syntroniks/zoneflow/firmware/zoneflow-fw/README.md

# ZoneFlow firmware (ESP-IDF)

Standalone firmware for the ZoneFlow irrigation controller, system spec
section 4.1. Target: ESP32-S3-WROOM-1-N16R8 (16 MB flash, 8 MB octal PSRAM),
ESP-IDF v5.5.6.

> **Status: written for the rev A board, never run on hardware.** No board
> exists yet. What has been checked is listed under "What is verified" below.
> The pin numbers are those of the rev A design (`hardware/pinmap.yaml`); the
> limits and timings that only a board can give are provisional.

Design and interfaces: [`docs/design/firmware-architecture.md`](../../docs/design/firmware-architecture.md).
Network security: [`docs/design/firmware-security.md`](../../docs/design/firmware-security.md).
REST API: [`docs/firmware/api.md`](../../docs/firmware/api.md) and
[`docs/firmware/openapi.json`](../../docs/firmware/openapi.json).
The display: [`docs/design/display-ui.md`](../../docs/design/display-ui.md).

## Build the firmware

Install ESP-IDF v5.5.6 ([Espressif guide](https://docs.espressif.com/projects/esp-idf/en/v5.5.6/esp32s3/get-started/)), then:

```sh
. ~/esp/esp-idf-v5.5.6/export.sh   # wherever you installed it
cd firmware/zoneflow-fw
idf.py set-target esp32s3          # first time only
idf.py build
idf.py -p /dev/ttyACM0 flash monitor
```

`sdkconfig` is generated from `sdkconfig.defaults` and is not committed.
Board options (keep-alive period, heartbeat timeout, control period) are in
`idf.py menuconfig` under "ZoneFlow board". The first build downloads three
components from the ESP-IDF component registry into `managed_components/`
(not committed): `lvgl/lvgl` 9.6.0, `espressif/mdns` 1.14.1 and
`joltwallet/littlefs` 1.22.3.

There is one build, for the rev A board, display included. Its pin numbers
come from `hardware/pinmap.yaml`: every build (firmware, host tests,
simulator) runs `tools/gen_board_header.py`, which checks the map and writes
`zf_board/pinmap_generated.hpp` into the build directory. The firmware build
uses ESP-IDF's Python, which has PyYAML; the host builds use
`uv run --script` (or a `python3` with PyYAML). The hand-written
`components/zf_board/include/zf_board/zoneflow_rev_a.hpp` names the signals
and checks the pin rules at compile time.

## Release builds

Releases are built by `.github/workflows/release.yml` from a `vX.Y.Z` tag. The firmware's
version is the tag without the `v`: the workflow writes it to `version.txt` here (ignored by Git)
before `idf.py build`, and ESP-IDF stores it in the application description. Without
`version.txt`, ESP-IDF uses `git describe`. To try the packaging on your own build, see
[`tools/zfrelease`](../../tools/zfrelease/README.md) and
[Releases and updating](../../docs/firmware/releases.md).

## Run the display on a desktop

```sh
firmware/zoneflow-fw/sim/run.sh                      # window, needs SDL2
firmware/zoneflow-fw/sim/run.sh --screenshots out/   # headless, a PNG of every screen
```

The simulator runs the firmware's display code on the real controller core
with fake hardware. Keys and details: [`sim/README.md`](sim/README.md).

Web UI files placed in `www/` (with an `index.html`) are packed into
`build/www.bin` and flashed to the `www` partition; see
[`docs/firmware/web-ui-contract.md`](../../docs/firmware/web-ui-contract.md).
The web UI lives in [`web/`](web/README.md); build it into `www/` with
Node 22.18 or newer before `idf.py build`:

```sh
cd firmware/zoneflow-fw/web && npm ci && npm run build
```

Without Node (no `www/index.html`) the firmware still builds and the device
serves its built-in page.

## Run the host tests

No ESP-IDF needed. Needs CMake 3.24 or newer, a C++20 compiler and network
access on the first run (GoogleTest 1.17.0 and cJSON 1.7.19 are fetched; a
system GoogleTest is used if found). Besides `zf_core`, the suite builds the
pure-logic files of `zf_net`, `zf_web` and `zf_ota` and checks the route
table against `docs/firmware/openapi.json`.

```sh
firmware/zoneflow-fw/test/host/run.sh
```

The script builds with AddressSanitizer and UndefinedBehaviorSanitizer and
runs every test through CTest. Extra arguments go to `ctest`. The suites
cover the core and the display logic (`ui_*_test.cpp`); the display tests
need no LVGL.

## Run the system soak simulation

`test/soak/` runs the controller core, output stage, persistence, history,
REST API and MQTT command path for simulated weeks against the simulated
rev A board and a model of the world (faults, restarts, clock trouble,
users), and checks safety and schedule invariants on every simulated tick.
A second rig runs the ESPHome supervisor glue. Deterministic from a seed.

```sh
firmware/zoneflow-fw/test/soak/run.sh --ci          # the subset CI runs, ASan and UBSan
firmware/zoneflow-fw/test/soak/run_long.sh          # the long run, about two hours on 16 cores
firmware/zoneflow-fw/test/soak/run.sh --mode chaos --seed 17 --days 30 --shrink
```

[`test/soak/README.md`](test/soak/README.md) lists the world model, the
invariants and the run sizes; firmware architecture section 22 what the
runs found.

## Format

```sh
cd firmware/zoneflow-fw
git ls-files '*.cpp' '*.hpp' | xargs uvx --from clang-format==23.1.4 clang-format -i
```

CI checks formatting with the same clang-format version.

## Layout

| Path | Contents |
|---|---|
| `components/zf_core/` | Pure C++ logic, no ESP-IDF headers: zone driver, scheduler, time zones, config, events, diagnostics, controller. Builds for the device and for host tests. |
| `components/zf_board/` | Board header. The only place GPIO numbers and board constants appear. |
| `components/zf_platform/` | ESP-IDF code behind the core interfaces: GPIO outputs, OE keep-alive timer interrupt, persist writer task, zero-cross input, sensors (GPIO, PCNT, ADC), NVS, I2C, PCF8563 RTC, SNTP, panic/brownout/restart hooks, event logger. |
| `components/zf_net/` | WiFi station with backoff, BLE (Security 2) and SoftAP provisioning, hostname, mDNS, captive DNS, re-provision and factory reset. |
| `components/zf_web/` | HTTP(S) server, REST API under `/api/v1`, Server-Sent Events stream, admin authentication, static files from LittleFS, built-in fallback and setup pages. |
| `components/zf_ota/` | Firmware upload and HTTPS pull, web UI image upload, post-boot self-test and rollback. |
| `components/zf_display/` | The local interface. `src/ui`: display logic, no LVGL, host-tested. `src/view`: LVGL drawing. `src/port`: ST7789 over SPI, backlight, encoder, buttons, the UI task. |
| `components/zf_mqtt/` | MQTT client (esp-mqtt), topic tree, commands, Home Assistant discovery. Logic in `mqtt_logic.cpp` (host-tested). |
| `sim/` | Desktop simulator of the display and the screenshot generator. `sim/web/` is the browser demo: the same code as WebAssembly. |
| `main/app_main.cpp` | Wires everything together and starts the tasks. |
| `test/host/` | GoogleTest suites and fakes for the core and the display logic. |
| `test/soak/` | System soak simulation of both firmwares on the simulated board (`zf_soak`). |
| `test/vectors/` | Schedule cases shared by the C++ scheduler test and the web UI's preview. |
| `web/` | Browser UI (Preact, TypeScript), mock controller and its tests. |
| `test/broker/` | Optional broker test: the MQTT logic and the core against a local Mosquitto (`run.sh`; not in CI). |
| `partitions.csv` | 16 MB layout: NVS, two 4 MB OTA slots, 7.75 MB LittleFS `www` for web and display assets, 128 KB core dump. |

## What is verified

- Host tests: `test/host/run.sh`, all suites pass under ASan and UBSan.
- System soak simulation: `test/soak/run.sh --ci` in CI. What the long run
  covered and found is in firmware architecture section 22. It is a
  simulation on a model of the board, not a bench check.
- Display simulator: `sim/run.sh --screenshots <dir>` draws all 75 scenes.
  The pictures in `docs/design/display-ui/` are its output.
- `idf.py build` with ESP-IDF v5.5.6 for esp32s3 completes with no warnings
  in ZoneFlow code.
  Image sizes are in the firmware architecture document.
- Web UI (`web/`): unit tests (vitest) and Playwright end-to-end tests on a
  phone, a 320 px and a desktop viewport, all against the mock controller in
  `web/mock/`, not against firmware. The schedule preview and the C++
  scheduler agree on the shared vectors in `test/vectors/`. The firmware's
  GET answers (`web_openapi_schema_test.cpp`) and the mock's
  (`web/tests/unit/mock-contract.test.ts`) are both checked against the
  response schemas in `docs/firmware/openapi.json`.
- Broker test: `test/broker/run.sh` builds Mosquitto 2.1.2 and runs the
  MQTT logic with the real core against it; all checks pass. It does not
  run the ESP-IDF MQTT glue. See
  [`docs/firmware/mqtt.md`](../../docs/firmware/mqtt.md#what-has-been-tested).
- Nothing has run on an ESP32-S3. Pin assignments, the output-enable
  timing, the current-sense scaling and the PCF8563 driver are untested
  against hardware. So are WiFi, provisioning with a phone, mDNS, the HTTP
  server, HTTPS, the event stream, OTA and the MQTT client: only their logic is unit-tested,
  the ESP-IDF glue is compiled but has never executed. The same holds for
  every part of the display that touches hardware: panel, backlight,
  encoder, buttons, PSRAM.
