syntroniks/zoneflow/docs/design/index.md

# Design documents

This section is the engineering record: requirements, analysis, reviews and
decisions, written for people who build, review or change ZoneFlow. The
user manual (Getting started, the user guide, the hardware reference,
troubleshooting) is written from these documents for people who install and
use the controller. Where the two disagree, the design document is right and
the manual has a bug.

Design documents are the source of truth for the project. If your work needs
one to change, change it in the same pull request. See
[contributing](../contributing.md). Each document records its own history,
so earlier decisions it describes as replaced are kept on purpose.

- [System specification](system-spec.md): hardware, firmware, enclosure, documentation, licences and verification limits.
- [Prior-art survey](prior-art.md): existing open irrigation controllers, their circuits, known field failures, and what ZoneFlow takes from them.
- [Firmware architecture](firmware-architecture.md): standalone firmware modules, threading, safety design, interfaces for later modules, scheduler and missed-start policy, open questions for hardware.
- [Display interface](display-ui.md): the local interface on the 320x240 panel: controls, screen map, every screen as drawn by the desktop simulator, visual language, wording, what is verified and what is still weak.
- [Hardware toolchain](hardware-toolchain.md): how a board goes from text to a KiCad 10 project and fabrication files with no GUI, what was checked, and the known limits.
- [Hardware design](hardware-design.md): the rev A circuit, block by block, with part numbers, calculations, the net list, the risk register and the bring-up plan. A paper design. Nothing in it is measured.
- [Mechanical design](mechanical.md): the board outline, every mechanically fixed part position, the component height limits and the antenna rule, for the PCB layout engineer. Explains `hardware/mechanical.yaml`. A paper design. Nothing has been printed.
- [Hardware review A1](hardware-review-a1.md): the independent review of the rev A circuit before schematic capture. Findings by severity, the verdict on each departure from the specification, the keep-alive contract with the firmware, what was verified from data sheets and what was not.
- [Hardware review A2](hardware-review-a2.md): the second review, of the fail-safe circuits only. A single-fault table rebuilt from the netlist by fault injection, tolerance corners of both keep-alive detectors, the regulator over-voltage protection, and the output stage after the change of triac.
- [Hardware answers A2](hardware-answers-a2.md): the hardware answers to the nine questions the firmware raised on the self-test of review A2, the decision on a shorted 3.3 V regulator with the detector it added, and the list of what the firmware must change.
- [Fail-safe reduction study](failsafe-reduction-study.md): a paper study of the owner's proposal to tie the expander's reset to the processor's reset and rely on the chip's watchdogs. What each reset of the ESP32-S3 does to the pins, what a watchdog part would have to do, four variants with their parts, cost and uncovered faults, a simulation of the recommended one, and where the study is weak. It changes nothing.
- [Fail-safe reduction review](failsafe-reduction-review.md): an independent review of that study. Each claim checked against the makers' documents, a fault injection on the reduced variants V1 and V2, what V1 gives up in an installer's terms with the cheapest part that puts each thing back, the specification sentences V1 breaks, and a finding on the reset supervisor U12 that concerns the board as it is. It changes nothing.
- [Hardware layout](hardware-layout.md): the rev A board: stack-up, floor plan, what is routed by hand and why, the current calculations, the layout rules of the fail-safe analysis, what the autorouter did, and what its author thinks is weak.
- [Hardware layout review](hardware-layout-review.md): the independent review of the rev A layout. Findings by severity, what was fixed, the placement files against the assembler's library, what was verified and how, and the checklist a person must go through before an order.
- [Review records](reviews/index.md): the records of the reviews a person made with the pre-order review walkthrough. None has been made yet.
- [Firmware security](firmware-security.md): the network surface of the standalone firmware: provisioning, the REST API and its sessions, updates, MQTT, what a review of it found and which risks remain.
- [Web UI contract](../firmware/web-ui-contract.md): what the standalone firmware's web interface may rely on from the REST API and event stream.
- [Repository audit](repository-audit.md): a fresh reading of the whole repository on 2026-11-12: where it disagreed with itself, what was corrected, what is left, and which checks no workflow runs.

The independent design review before fabrication is tracked in
[issue #11](https://github.com/syntroniks/zoneflow/issues/11). The reviews of
the circuit and of the layout are written. What is open is the part a person
does: the [pre-order review walkthrough](../hardware/review/index.md).

New design documents go in `docs/design/`. Add each one to the `nav` section
of `mkdocs.yml` and to this list.
