syntroniks/zoneflow/docs/design/hardware-design.md

# ZoneFlow hardware design, revision A

Status: **paper design, 2026-11-12, after
[hardware review A1](hardware-review-a1.md), the decisions taken on its
findings, [hardware review A2](hardware-review-a2.md) of the fail-safe
circuits, the [answers to the firmware's questions](hardware-answers-a2.md)
on section 19, and the owner's decision to debounce the push contacts in
firmware (section 28)**. No board exists. Nothing in
this document has been measured. Every number is a datasheet figure, a calculation from
datasheet figures, or a simulation result, and the text says which. Section 20
lists what only a bench can confirm. Section 22 lists what I could not confirm
at all.

This document is the circuit design that schematic capture translates. I
wrote it against [system specification](system-spec.md) v0.3. It departs from
that version in the places listed in section 2, and the pull request that adds
this document raises the specification to v0.5 with those changes. Three files hold the same design as data:

- **`hardware/netlist.yaml`**: every component, its value, package, LCSC number and the net on every pin. It is the source. The component tables in this document are written from it.
- **`hardware/pinmap.yaml`**: every ESP32-S3 GPIO, I2C address and expander bit. Firmware generates its board header from it.
- **`hardware/bom-preliminary.csv`**: one line per part number with stock, price and source, checked on 2026-11-10.

`tools/designsync/designsync.py` keeps the four in step. `make -C hardware
design-check` fails if a table here, the BOM or the pin map disagrees with the
netlist, and CI runs it on every change to them. `make -C hardware
design-sync` rewrites the tables, which sit between `designsync` comment
lines. Do not edit a table by hand.

Simulation netlists are in `hardware/sim/`, with a README that states what each
run showed.

Section 24 lists what changed after review A1 and where I did something
other than what the reviewer proposed. Section 25 lists what review A2
changed. Section 26 lists what the answers to the firmware's questions
changed: one part of the circuit and most of section 19. Section 27 lists
the five part numbers that the BOM consolidation replaced. Section 28 lists
the five parts that left when the debounce of the encoder switch and the two
buttons moved into firmware.

## 1. The design in brief

| Block | Choice | Main reason |
|---|---|---|
| Logic supply | A fuse in each transformer leg, 1500 W TVS, half-wave rectifier, 470 uF, LM5164 100 V buck to 5.3 V with its own 0.5 A fuse and a clamp on its output, Schottky OR with USB, LDL1117 to 3.3 V | The TVS clamps at 77.4 V. A 100 V regulator survives that with no further argument. A 5 V bus makes USB and 24 VAC equal sources and gives the LDO room to reject ripple. The fuse and the clamp keep a failed regulator from putting 45 V on the logic. |
| Output switch | T810-600B-TR 8 A three-quadrant triac in DPAK, fired by a MOC3023 opto-triac from its own T2 | The triacs JLCPCB stocks with real surge ratings are three-quadrant parts. Positive-only gate drive from logic cannot fire them on the negative half-cycle. The 8 A part carries the short-circuit current of a 75 VA transformer until the PTC trips. Section 6 has the analysis. |
| Output control | TCA9539 I2C expander sinks the opto LEDs | The TFT took six GPIOs. Nine valve pins no longer fit. The expander is held in reset by the fail-safe circuit, so no valve bit survives a crash. |
| Fail-safe | Two independent detectors on the keep-alive pin. One, a diode pump with a comparator, switches the LED supply and the expander reset. The other, a diode pump straight into a transistor gate, holds the relay. | Gate drive needs an edge at least every 20 ms. It is gone 0.21 to 0.83 s after the edges stop, and with it the valve current. The relay transistor alone lets go within 1.45 s. No single component fault leaves a valve on after the edges stop. Sections 7 and 8, with the corners of review A2. |
| Over-current | Window comparator on the shunt amplifier, NAND latch, same switch as the fail-safe | Removes drive about 70 us after a short begins and releases K1 at once. The triac and the PTC are rated to carry the short until one of them or the relay interrupts it. |
| Over-voltage on the logic rail | A voltage detector on `3V3` that holds the set input of the over-current latch low above 4.0 V | A shorted 3.3 V regulator puts 5 V on the processor, and nothing can be said about a processor there. The detector removes drive without it. It does not protect the processor. Section 9.5. |
| Valve common | Relay in the COM feed. Its coil current passes through two transistors: one follows an expander bit, the other its own keep-alive detector. | A shorted triac or TVS otherwise leaves a valve on with no way to stop it. This is an addition to the specification. |
| Current measurement | 0.1 ohm shunt, two difference amplifiers biased at 0.8 V, sampled by ADC1 | True RMS in firmware. No precision rectifier, which would add millivolts of error to a 5 mV signal. |
| Display | HS20HS072RX 2.0 inch 240x320 IPS panel on a 12-way FPC connector, plugged in at final assembly | The only bare ST7789 panels with stock and a drawing that I found at LCSC. |
| RTC | PCF8563T with a 32.768 kHz crystal, CR2032 in a holder | JLCPCB stocks no supercapacitor. The coin cell lasts longer than its own shelf life. |

## 2. Where this design departs from the specification

The specification stays the source of truth. This pull request changes it for
each item below, and the reasons are in the sections named.

1. **Gate drive goes through opto-triacs, not straight from logic.** Specification 3.1 says gate drive comes from ESP32 GPIO through the fail-safe gate. The triac still sits in the OpenSprinkler topology, with one AC leg as ground and a shared shunt. Only the gate coupling changes. Section 6.2.
2. **Valve outputs are on an I2C expander.** Specification 3.1 says the module has enough GPIO without an expander. With the SPI display, two I2C buses, five control inputs and the fail-safe signals, 25 usable pins are not enough for nine direct outputs. Section 12.2.
3. **A relay in the valve common.** Not in the specification. It gives hardware a way to remove power from every valve when an output device has failed short. I propose a new safety rule 6. Section 7.
4. **A fuse in each transformer leg.** The specification said "fuse on AC input" and did not say which leg. The first draft put one fuse in the ground leg, because only that fuse sits in the fault loops that run through a USB cable. The review showed the loops that a ground-leg fuse leaves open, and the specification now asks for both. Section 5.3.
5. **No rectifier in the current-sense front end.** Specification 3.1 asks for a rectifying, averaging front end. This design amplifies the AC waveform around a 0.8 V bias and lets firmware compute RMS. Section 10.
6. **5 V bus with an LDO.** Specification 3.1 says "buck converter, 3.3 V rail". The buck makes 5.3 V and an LDO makes 3.3 V. Section 4.6.
7. **The relay has its own keep-alive detector.** Safety rule 3 described one output-enable. The review found single faults that hold it on. Rule 3 now asks for two independent detectors, one for gate drive and one for the relay. Sections 7.3 and 8.5.

## 3. Conventions

### 3.1 Supply rails and ground

| Net | What it is |
|---|---|
| `AC_L_IN` | 24 VAC terminal 1, before fuse F4. |
| `AC_L` | Terminal 1 after F4. Feeds the rectifier, the zero-cross detector and, through relay K1, the valve common. |
| `AC_N` | 24 VAC terminal 2. Connects to `GND` through fuse F1. |
| `GND` | Circuit ground. One transformer leg, the USB ground and the sensor ground are all this net. |
| `COM` | Valve common terminals. `AC_L` after relay K1. |
| `VIN_DC` | Rectified, unregulated supply. 26 to 31 V at 24 VAC, 44 V at 32 VAC with no load. |
| `VIN_U1` | `VIN_DC` behind fuse F5: the input pin of U1 with C2 and C3. |
| `V_BUCK` | Buck output, 5.28 V nominal. Present only with 24 VAC. Also feeds the coil of K1 and the sensor supply. |
| `V5` | 5 V bus after the OR diodes. About 4.95 V from 24 VAC, 4.1 to 4.9 V from USB. |
| `3V3` | Logic rail, 3.3 V, 3 % over temperature. |
| `V_DRV` | 3.3 V supply of the opto LEDs. On only while the fail-safe circuit allows drive. |
| `ISNS` | Common T1 node of all triacs. The shunt R37 connects it to `GND`. |

### 3.2 Reference designators

Components that exist once use numbers below 100. The three resistor arrays
are RN1 to RN3. Output channel components
use three digits. The first digit is the channel and the last two are the same
in every channel.

| Channel | Terminal | Designators |
|---|---|---|
| 1 to 8 | Z1 to Z8 | 101 to 105, 201 to 205, and so on to 801 to 805 |
| 9 | MV | 901 to 905 |

So R301 is the opto LED resistor of zone 3 and Q901 is the master valve triac.

Two single resistors do not fit the rule, because the resistor numbers below
100 ran out. R13 was free since review A1 removed the relay hold network. It
is in use again as the upper leg of the over-voltage divider of section 9.5.
The lower leg is R100. No channel uses a number that ends in 00.

### 3.3 Operating envelope I designed to

| Item | Value | Source |
|---|---|---|
| Ambient outside the enclosure | -20 to +50 °C, indoor or garage, non-condensing | Specification section 1, from v0.5 |
| Air inside the enclosure | up to 70 °C | 50 °C plus the rise the mechanical design estimates. Revision 1 of the contract said 16 K at 3 W with vents, and 70 °C was set from that. Revision 2 says 14 K at 3.5 W (mechanical design, section 11), which leaves about 6 K in hand. The first draft assumed 10 K. Bench test in section 20. |
| Supply | 21.6 to 26.4 VAC at load, up to 32 VAC unloaded, 50 or 60 Hz | Specification section 1 |
| Load | 0.5 A rms per output, 1.5 A rms inrush for 100 ms, two zones plus master | Specification section 1 |
| Smallest load | 50 mA rms pump-start relay coil | Brief |
| Transformer | Class 2, 20 to 75 VA. Short-circuit current at the terminals 7 to 21 A rms. | Section 6.6 calculates it. The output PTC is rated for 40 A. |

## 4. 24 VAC input and logic supply

### 4.1 Circuit

Each transformer leg has a fuse. Terminal 2, `AC_N`, goes through F1 to `GND`.
Terminal 1, `AC_L_IN`, goes through F4 to `AC_L`. `AC_L` feeds three things: the TVS D1 to
`GND`, the half-wave rectifier D2, and the valve common through relay K1.
D2 charges the bulk capacitor C1 through R1. Fuse F5 takes `VIN_DC` to the
input of the LM5164 buck U1, which makes `V_BUCK`, 5.28 V. D25 clamps
`V_BUCK` if U1 fails; section 4.8 has F5 and D25. Schottky D3 passes
`V_BUCK` to the 5 V bus.

<!-- designsync:begin table block="A power" -->

| Ref | Part | Package | LCSC | Connections | Note |
|---|---|---|---|---|---|
| J1 | Header 2-way 3.81 mm pluggable, right angle | THT | C441182 | `AC_L_IN` to `AC_N` | 24 VAC input |
| F1 | Fuse 3 A time-lag in SMD holder | SMD 9.7x5 mm | C206913 | `AC_N` to `GND` | Fuse in the leg that becomes circuit ground |
| F4 | Fuse 3 A time-lag in SMD holder | SMD 9.7x5 mm | C206913 | `AC_L_IN` to `AC_L` | Fuse in the other leg |
| D1 | TVS 48 V bidirectional 1500 W | SMC | C151287 | `AC_L` to `GND` | Input surge clamp |
| D2 | Rectifier 1 A 1000 V | SMA | C95872 | A `AC_L`, K `VRECT` | Half-wave rectifier |
| R1 | 3R 5% 1 W, surge series | 2512 | C2936639 | `VRECT` to `VIN_DC` | Limits charging and surge current. Pulse rating in section 4.4 |
| C1 | 470 uF 63 V aluminium electrolytic | THT 12.5x20 mm | C2940725 | + `VIN_DC`, - `GND` | Bulk capacitor. Through-hole, on the bottom side, lying down |
| F5 | Fuse 0.5 A very fast-acting, 125 V | 2410 | C142836 | `VIN_DC` to `VIN_U1` | Opens when D25 clamps a failed U1. Section 4.8 |
| C2 | 2.2 uF 100 V X7R | 1210 | C55151 | `VIN_U1` to `GND` | At U1 pins |
| C3 | 2.2 uF 100 V X7R | 1210 | C55151 | `VIN_U1` to `GND` | At U1 pins |
| U1 | LM5164DDAR 100 V 1 A synchronous buck | SO-8 PowerPAD | C477928 | 1 GND `GND`, 2 VIN `VIN_U1`, 3 EN/UVLO `UVLO`, 4 RON `RON`, 5 FB `FB`, 6 PGOOD `PGOOD`, 7 BST `BST`, 8 SW `SW`, EP `GND` |  |
| C4 | 2.2 nF 50 V X7R | 0603 | C1604 | `BST` to `SW` | Bootstrap, value fixed by the datasheet |
| L1 | 47 uH, Isat 2.0 A, 0.2R | 6x6x4.5 mm | C5151734 | `SW` to `V_BUCK` |  |
| C5 | 22 uF 25 V X5R | 1206 | C12891 | `V_BUCK` to `GND` |  |
| C6 | 22 uF 25 V X5R | 1206 | C12891 | `V_BUCK` to `GND` |  |
| R2 | 47k 1% | 0603 | C25819 | `RON` to `GND` | On-time, 281 kHz |
| R3 | 330k 1% | 0603 | C23137 | `V_BUCK` to `FB_MID` | Feedback top, with R4 = 340k |
| R4 | 10k 1% | 0603 | C25804 | `FB_MID` to `FB` |  |
| R5 | 100k 1% | 0603 | C25803 | `FB` to `GND` | Feedback bottom |
| R6 | 200k 1% | 0603 | C25811 | `SW` to `RIP` | Ripple injection RA |
| C7 | 3.3 nF 50 V X7R | 0603 | C1613 | `RIP` to `V_BUCK` | Ripple injection CA |
| C8 | 100 pF 50 V C0G | 0603 | C14858 | `RIP` to `FB` | Ripple injection CB |
| R7 | 1M 1% | 0603 | C22935 | `VIN_DC` to `UVLO` | UVLO on 9.0 V, off 8.4 V |
| R8 | 200k 1% | 0603 | C25811 | `UVLO` to `GND` |  |
| R9 | 300k 1% | 0603 | C23024 | `VIN_DC` to `VIN_MON` | Supply monitor divider, 1/31 |
| R10 | 10k 1% | 0603 | C25804 | `VIN_MON` to `GND` |  |
| C9 | 100 nF 50 V X7R | 0603 | C14663 | `VIN_MON` to `GND` |  |
| D3 | SS34 Schottky 3 A 40 V | SMA | C8678 | A `V_BUCK`, K `V5` | OR-ing, buck side |
| D25 | TVS 6 V unidirectional 600 W | SMB | C83270 | A `GND`, K `V_BUCK` | Over-voltage clamp on the buck output. Section 4.8 |

<!-- designsync:end -->

### 4.2 Rail budget

Currents on `3V3`. "Typical" is WiFi connected and idle, two zones and the
master valve on, backlight on. "Peak" is every consumer at its limit together.

| Consumer | Typical mA | Peak mA | Basis |
|---|---|---|---|
| ESP32-S3 module | 100 | 340 | Datasheet v2.2 tables 5-7 and 5-9. Peak is 802.11b transmit at 21 dBm. Typical is my estimate between modem-sleep (33 to 108 mA) and receive (88 to 91 mA). |
| TFT logic | 10 | 15 | Assumption. The panel datasheet says "TBD". |
| Opto LEDs, three on | 38 | 45 | Section 6.4 |
| Indicator, status and fault LEDs | 9 | 10 | 1.6 mA per zone LED, 2 mA status |
| Expander, logic, op-amp, pull-ups | 5 | 8 | Datasheet supply currents plus switch pull-ups |
| Qwiic connector | 0 | 80 | Budget. PTC F2 holds 0.125 A at 20 °C and 0.08 A at 60 °C, and has up to 6 ohm, so 80 mA is what the connector is good for. Section 16.2. |
| **Total `3V3`** | **162** | **498** | |

Currents on `V5` and `V_BUCK`.

| Consumer | Typical mA | Peak mA | Basis |
|---|---|---|---|
| LDO input, equal to the `3V3` load | 162 | 498 | |
| Backlight | 58 | 74 | Section 15.2 |
| Comparator U6, sensor pull-ups | 2 | 3 | |
| **Total `V5`** | **222** | **575** | |
| Relay K1 coil, from `V_BUCK` | 42 | 42 | 5.28 V across 125 ohm |
| Sensor supply terminal, from `V_BUCK` | 20 | 158 | Highest limit of U11, section 13.5 |
| **Total `V_BUCK`** | **284** | **775** | U1 is rated 1 A |

Power drawn from `VIN_DC`, with the buck efficiency taken as 85 %. That figure
is an assumption. I did not read an efficiency curve for a 5 V output.

- **Typical**: 5.28 V x 0.284 A / 0.85 = 1.76 W. The simulations use 1.75 W.
- **Peak**: 5.28 V x 0.775 A / 0.85 = 4.8 W. The simulations use 5.0 W.

### 4.3 Fuses F1 and F4

F1 and F4 are the same part, one in each transformer leg. Every current the
board draws passes through both. Section 5.3 says why one is not enough.

Each is a Littelfuse 0154003.DRT: a 154-series holder supplied with a 3 A
time-lag fuse of the 454 series fitted. The 452 series is the same fuse
without the silver-plated caps and is the replacement part. The user can
replace it without soldering. The 452/454 datasheet gives 125 V, 50 A
interrupting rating, 0.034 ohm and a melting I²t of 20.16 A²s. Opening times
are 1 to 60 s at 200 %, 0.2 to 3 s at 300 % and 20 to 100 ms at 800 %.

| Check | Calculation | Result |
|---|---|---|
| Steady load | 1.5 A valves and 0.35 A rectifier current, added as rms | 1.54 A, 51 % of rating |
| Valve inrush | 2.5 A for 100 ms gives 0.63 A²s | 3 % of melting I²t |
| Plug-in at the 32 VAC peak | 45.3 V / (3.0 + 2.1 ohm) = 8.9 A, decaying with 2.4 ms | 0.09 A²s, under 1 % |
| Zone short, one half-cycle at 21 A rms, the 75 VA figure of section 6.6 | 21² x 10 ms | 4.4 A²s, 22 % of melting I²t |
| Voltage lost in both fuses at 1.54 A | 2 x 0.034 ohm x 1.54 A | 0.10 V |

Two fuses in series do not coordinate: on a fault that passes through both,
either may open, and the user has to check both. Both holders are on the top
side next to J1.

The zone-short row is why the fuses are time-lag. A very fast 3 A fuse of the 451
series has a melting I²t of 0.459 A²s. It would open on every shorted valve
wire before the electronic cut-off of section 9 had finished, and a shorted wire
would become a service call.

### 4.4 Surge clamp D1 and rectifier D2

D1 is a Littelfuse SMCJ48CA. Its stand-off voltage of 48 V is above the 45.3 V
peak of 32 VAC, so it does not conduct in normal use. Breakdown is 53.3 to
58.9 V. It clamps at 77.4 V at its rated 19.4 A, 10/1000 us pulse. A 43 V part,
as OpenSprinkler uses, would sit past its stand-off voltage at 32 VAC.

D2 is an M7, 1 A and 1000 V. The worst reverse voltage is the clamp voltage on
the negative half-cycle plus `VIN_DC`, about 77 + 60 = 137 V. The simulation
gives a peak forward current of 1.5 A at the peak load. The surge rating is
30 A.

R1 is 3 ohm. It does two jobs. It limits the plug-in current into C1, and it
limits how far a surge can pump C1 up. With D1 clamping at 77.4 V for a full
rated 10/1000 us pulse, C1 charges from 45 V toward the clamp voltage through
R1 with a time constant of 3.2 ohm x 470 uF = 1.5 ms. The pulse has a decay
constant of 1.44 ms. That gives a rise of about 14 V, to 59 V. C1 is rated
63 V and U1 100 V. The simulation puts the loss in R1 at 0.09 W typical and
0.85 W at low line with every consumer at its limit. R1 is rated 1 W up to
70 °C.

**R1 is a pulse-rated part.** The first draft used a general-purpose
thick-film resistor with no pulse curve, and review A1 objected. R1 is now a
Yageo SR2512JK-073RL: 3 ohm, 5 %, 1 W, 2512, from Yageo's surge series, LCSC
C2936639, 3972 in stock at JLCPCB on 2026-11-10. The review found no stocked
anti-surge part; this one is.

The pulse it has to take is the charging of an empty C1 when the board is
plugged in at the peak of 32 VAC, 45.3 V:

| | 40 VA transformer | 75 VA transformer |
|---|---|---|
| Transformer series resistance, assumed | 2.1 ohm | 1.0 ohm |
| Peak current, 45.3 V / (3 ohm + transformer) | 8.9 A | 11.3 A |
| Peak power in R1, I² x 3 ohm | 237 W | 385 W |
| Energy in R1, 0.5 x 470 uF x 45.3² x 3 / (3 + transformer) | 0.28 J | 0.36 J |
| Rectangular pulse of the same peak and energy | 1.2 ms | 0.94 ms |
| Yageo limit for a single pulse of that length, 2512, 5 % | about 700 W | about 750 W |
| Margin in power | 3.0 | 1.9 |

The limit is read from figure 7-2 of the Yageo SR data sheet, V.14 of
2025-02-14, which covers the 5, 10 and 20 % tolerance parts: about 750 W at
1 ms falling to about 200 W at 10 ms for size 2512. The figures are read off
a log-log graph and are good to perhaps 15 %. The 1 % parts of the same
series follow figure 7-1 and take only about 200 W at 1 ms, so the tolerance
letter matters: **SR2512JK, not SR2512FK.** The 5 % tolerance costs nothing
here. R1 only limits current.

A real power-up is milder than the table. The sine wave falls away from its
peak during the 2 ms the pulse lasts, and the calculation ignores the leakage
inductance of the transformer. A surge clamped by D1 at 77.4 V puts about
(77.4 - 45) / 3 = 11 A through R1 for 1.4 ms, the same size of pulse. A Vishay
MELF (MMB0207, 3.3 ohm) was the other candidate; its data sheet allows about
70 W for a single 1 ms pulse below 10 ohm, which is not enough.

### 4.5 Bulk capacitor C1

The rectifier is half-wave, so C1 supplies the load for most of a 20 ms cycle
at 50 Hz. `hardware/sim/supply.cir` models the transformer as a source with
2.1 ohm in series, which is my assumption for a 40 VA unit.

| Supply | Load | `VIN_DC` valley to peak | Capacitor ripple |
|---|---|---|---|
| 24 VAC, 50 Hz | 1.75 W | 28.7 to 30.9 V | 0.16 A rms |
| 24 VAC, 60 Hz | 1.75 W | 28.9 to 30.7 V | 0.16 A rms |
| 21.6 VAC, 50 Hz | 1.75 W | 25.0 to 27.4 V | 0.17 A rms |
| 21.6 VAC, 50 Hz | 5.0 W | 17.3 to 25.0 V | 0.48 A rms |
| 16 VAC, 50 Hz | 1.75 W | 15.8 to 19.3 V | 0.23 A rms |
| 16 VAC, 50 Hz | 3.0 W | 11.5 to 18.1 V | 0.40 A rms |
| 18 VAC, 50 Hz | 5.0 W | 8.1 to 19.2 V | 0.66 A rms |
| 32 VAC, 50 Hz | 0.05 W | 44.3 V | under 0.01 A rms |

U1 regulates down to its under-voltage lockout, which R7 and R8 set to 9.0 V
rising and 8.4 V falling. So the logic supply holds through a sag to 16 VAC at
the typical load and at 3 W. That is the brownout margin for a small
transformer during valve inrush. Only the last-but-one row fails: an 18 VAC sag
with every consumer at its limit. With no input at all, C1 holds the typical
load from 29 V down to 9 V for 0.5 x 470 uF x (29² - 9²) / 1.75 W = 100 ms,
five cycles.

C1 is a Rubycon 63ZLJ470M12.5X20: 470 uF, 63 V, a through-hole can of
12.5 x 20 mm, LCSC C2940725, 3180 in stock at JLCPCB on 2026-11-10. Its
steady voltage is at most 44.3 V, 70 % of rating.

**Why the part changed.** The first draft used a surface-mount Lelon VZH can,
16.5 mm tall. The enclosure allows 9 mm above the board and 17 mm below it,
and revision 2 of the mechanical contract allows no surface-mount part on
the bottom side, because one capacitor would need a second assembly side
(mechanical design, section 6). So C1 is a through-hole part on the bottom,
lying on its side. The contract named the Rubycon PX part that the BOM
carried as the alternative. I read the three data sheets before switching:

| | Lelon VZH471M1JTR-1616, first draft | Rubycon 63PX470MEFC12.5X20, named by the contract | Rubycon 63ZLJ470M12.5X20, fitted |
|---|---|---|---|
| Case | Surface-mount, 16 x 16.5 mm | Through-hole, 12.5 x 20 mm, 5.0 mm lead pitch, 0.6 mm leads | The same case, pitch and leads |
| Largest size | 17.0 mm tall | 13.0 mm diameter, 21.5 mm long | 13.0 mm diameter, 22.0 mm long |
| Endurance at 105 °C, rated voltage and rated ripple | 5000 h | 2000 h | 10,000 h |
| Rated ripple at 105 °C | 900 mA at 100 kHz | 700 mA at 120 Hz | 2400 mA at 100 kHz, 1320 mA at 120 Hz |
| The same at 50 and 60 Hz | 540 mA, multiplier 0.6 | 560 mA, multiplier 0.8 | Not given. About 1.05 A if the PX multiplier of 0.8 holds for it |
| Dissipation factor at 120 Hz | not read | 0.10 | 0.09 |
| The 0.48 A of the peak corner against the rating | 89 % | 86 % | 36 % of the 120 Hz figure |
| Stock at JLCPCB on 2026-11-10 | 968 | 14,076 | 3180 |
| Price at 100 pieces | 0.59 USD | 0.27 USD | 0.25 USD |

All three cover the 0.16 A typical and 0.48 A peak ripple. The PX part has
about the margin of the Lelon part and less than half its endurance, so I
did not take it.
The ZLJ part is from the same maker in the same case. Its sheet gives ripple
multipliers from 120 Hz upward only, 0.55 at 120 Hz for 330 to 680 uF, and
nothing for 50 or 60 Hz. The 1.05 A in the table borrows the PX sheet's
ratio and is an estimate. Even against half that figure the peak corner is
inside the rating.

**Life.** C1 has voltage and ripple on it for as long as the controller is
plugged in. The usual rule is that an aluminium electrolytic capacitor lasts
twice as long for every 10 K below its rated temperature. That is general
practice, not a Rubycon formula that I read, and it ignores the extra life
that comes from running below the rated ripple.

| Air around C1 | Factor on the 105 °C endurance | PX, 2000 h | Lelon VZH, 5000 h | ZLJ, 10,000 h |
|---|---|---|---|---|
| 70 °C, the design limit of section 3.3 | 2^3.5 = 11 | 2.6 years | 6.5 years | 13 years |
| 55 °C | 2^5 = 32 | 7.3 years | 18 years | 37 years |
| 40 °C, a 25 °C room | 2^6.5 = 91 | 21 years | 52 years | about 100 years |

The figures are continuous operation at that temperature. Past about 15
years other wear takes over and the arithmetic stops meaning anything. The
point is the first row: a controller in a hot garage would wear out a
2000 h part in a few summers.

**Second sources.** The PX part, C88758, fits the same holes. Fit it only
knowing its life. AISHI ERS1JM471K20OT, C106675, is listed with 10,000 h in
a 13 x 20 mm case and had 85,615 in stock; LCSC has no data sheet link for
it and I did not read one.

**Placement and fitting.** The mechanical contract fixes C1 on the bottom
side: can centred at (21, 30), axis along x, leads towards +x and bent
through 90 degrees into pads at (36.0, 27.5) and (36.0, 32.5). It is soldered
by hand after the surface-mount parts, in the same step as K1 and the
terminal headers, and JLCPCB does not machine-fit it. Two ribs in the
enclosure base carry its weight once the board is in. The contract was drawn
for the PX can, 21.5 mm long at most. The ZLJ can may be 22.0 mm, and zone
B_C1 has 0.75 mm beyond the can at the far end, so it fits; the enclosure
owner should take the 0.5 mm into `hardware/mechanical.yaml`. Bend the leads
no closer than 2 mm to the seal. That figure is common practice. I did not
read Rubycon's handling notes.

### 4.6 Buck converter U1

**Why 5 V and an LDO.** Three reasons.

- **USB**: USB arrives at 5 V. With a 5 V bus the two sources OR through one Schottky each, and one regulator makes `3V3` whichever is present. A direct 3.3 V buck needs a second regulator for USB and an ideal-diode multiplexer at 3.3 V.
- **Ripple**: the LDL1117 rejects 87 dB at 120 Hz and 65 dB at 100 kHz. The buck's 281 kHz ripple and the 50 Hz ripple on `VIN_DC` stay out of the ADC and the radio supply.
- **Other loads**: the backlight, relay, comparators and sensor supply need more than 3.3 V.

The cost is heat. The LDO drops 1.65 V, which is 0.27 W at the typical load.
Section 20 lists it as a thermal risk.

**Why the LM5164.** The specification asks for at least 60 V. D1 can let 77.4 V
through. The LM5164 has an absolute maximum of 100 V on VIN and is in stock at
JLCPCB. It is synchronous, so there is no catch diode. The 60 V and 65 V parts
I looked at, LMR16010 and LMR51610, would rely on C1 absorbing the surge.

Design values, using the equations of datasheet SNVSAU4D.

| Item | Equation | Value |
|---|---|---|
| Output voltage | 1.2 V x (1 + (R3 + R4) / R5) | 1.2 x (1 + 340k / 100k) = 5.28 V |
| Tolerance | Reference 1.181 to 1.218 V, 1 % resistors | 5.16 to 5.40 V |
| Switching frequency, eq. 1 | VOUT x 2500 / RRON(kohm) | 5.28 x 2500 / 47 = 281 kHz |
| On-time at 45 V, eq. 11 | RRON / (VIN x 2.5) | 47 / 112.5 = 0.42 us. Minimum allowed is 50 ns. |
| Inductor ripple at 34 V, eq. 18 | VOUT / (FSW x L) x (1 - VOUT / VIN) | 5.28 / (281k x 47u) x 0.845 = 0.34 A |
| Peak inductor current, eq. 19 | IOUT + ripple / 2 | 0.82 + 0.17 = 0.99 A. Current limit is 1.25 A minimum. |
| Output capacitor, eq. 21 | ripple / (8 x FSW x 0.5 % of VOUT) | 5.7 uF minimum. Fitted 2 x 22 uF, 25 V. |
| Ripple capacitor CA, eq. 24 | 10 / (FSW x (RFB1 parallel RFB2)) | 10 / (281k x 77.3k) = 460 pF minimum. Fitted 3.3 nF. |
| Ripple resistor RA, eq. 25 | tON x (VIN - VOUT) / (20 mV x CA) | At 34 V: 0.553 us x 28.7 V / (20 mV x 3.3 nF) = 240k maximum. Fitted 200k. |
| Ripple at FB | tON x (VIN - VOUT) / (RA x CA) | 24 mV at 34 V, 16 mV at 12 V, 13 mV at 10 V. The datasheet asks for 12 mV at minimum input. |
| Coupling capacitor CB, eq. 26 | settling time / (3 x RFB1) | 100 pF gives 100 us |
| UVLO, eq. 13 and 14 | 1.5 V and 1.4 V x (1 + R7 / R8) | On at 9.0 V, off at 8.4 V |

L1 is a Bourns SRN6045TA-470M, 47 uH, 0.2 ohm, saturation 2.0 A. The datasheet
asks for a saturation current above the current limit, which is 1.75 A at most.
C4 is 2.2 nF as the datasheet requires. A larger value damages the part.

**Light load.** Below about 0.17 A the converter enters diode emulation and
skips pulses. With all outputs off and the backlight off the load is near
0.1 A, so it will spend much of its life in that mode. The type 3 ripple network
keeps it stable there by design. Output ripple in that mode is a bench item.

### 4.7 LDO U3

The LDL1117S33R takes 2.6 to 18 V in and drops 0.6 V at most at 1.2 A. From
USB, `V5` can fall to 4.1 V, which still leaves 0.8 V of headroom. Output
accuracy is 3 % over temperature, so `3V3` is 3.20 to 3.40 V. The module needs
3.0 to 3.6 V. The panel's recommended maximum is 3.3 V and its absolute maximum
is 4.6 V, so the top 0.1 V of the LDO range is above the panel recommendation.
I accept that and list it in section 22.

If U3 fails with its input joined to its output, `3V3` goes to `V5`. The
processor and the panel are then outside their ratings and nothing protects
them. Section 9.5 has the detector that keeps the valves off in that fault.

### 4.8 Over-voltage on `V_BUCK`: clamp D25 and fuse F5

Added by [review A2](hardware-review-a2.md), section 6, on the owner's
decision that a failed regulator must fail safe and must not destroy the
board silently.

**The fault.** The high-side switch inside U1 fails short, or stays on.
`VIN_DC`, 26 to 45 V, then reaches `V_BUCK` through L1. With nothing to stop
it, `hardware/sim/buck_overvoltage.cir` puts `V_BUCK` past 7 V after 11 to
14 us and at 43 to 65 V after the first ring of L1 with C5 and C6. Every
5 V and 3.3 V part is then beyond its rating, the processor included, and
the fail-safe analysis of section 8.5 has nothing to stand on.

**The protection.** Two parts.

- **D25**, a Littelfuse SMBJ6.0A, from `V_BUCK` to `GND`, cathode to
  `V_BUCK`. It stands off 6.0 V, breaks down between 6.67 and 7.37 V and
  clamps at 10.3 V at its rated 58.3 A.
- **F5**, a Littelfuse 0451.500MRL, 0.5 A very fast-acting, in series with
  the input of U1. It sits between `VIN_DC` and a new net, `VIN_U1`, which
  holds U1 pin 2 and the input capacitors C2 and C3.

When the switch shorts, D25 holds `V_BUCK` and the charge of C1 flows
through F5, the failed switch, L1 and D25. F5 opens. `V_BUCK` then falls to
zero and stays there.

**Why not a crowbar that opens the input fuses.** Every path from the
transformer to `V_BUCK` runs through D2 and R1, 3 ohm. With `V_BUCK` held
near zero the rectifier delivers half-wave pulses of 3.6 to 7.8 A peak,
1.6 to 3.7 A rms, for a 20 to 75 VA transformer (the "follow current" lines
of the simulation). F1 and F4 are 3 A time-lag fuses: at 1.6 to 3.7 A they
open after minutes or not at all. What would open is R1, at 9 to 42 W in a
1 W part, and D2. That is the board destroying itself in an uncontrolled
way. So the element that opens has to sit behind C1, where the capacitor
can deliver the current that the transformer cannot, and it has to be much
smaller than 3 A.

**Sizing F5.**

| Check | Calculation | Result |
|---|---|---|
| Normal load | 1.76 W typical at 29 V; 5.0 W at the 17.3 V valley of low line | 0.06 A typical, 0.29 A at the worst steady corner: 58 % of rating. Littelfuse asks for 75 % at most. |
| Voltage lost | 0.42 ohm x 0.29 A | 0.12 V on a 17 V input |
| Voltage rating | `VIN_DC` reaches 44.3 V, 59 V in a surge | 125 V |
| Fault current it must interrupt | (44.3 V - 6.67 V) over the resistance in the loop: C1 0.033 ohm at most (Rubycon ZLJ sheet, 100 kHz, 20 °C), F5 0.42 ohm, L1 0.2 ohm, D25 0.03 ohm, and a switch that has become 0.02 ohm | 53.5 A by this sum. The simulation gives 49 to 52 A with L1 saturated, because the fuse has opened before the current has fully risen. At a `VIN_DC` of 30 V it gives 25 to 30 A. The part interrupts 50 A at 125 V and 300 A at 32 V DC. |
| Melting | Nominal melting I²t 0.0824 A²s. C1 delivers I² x R x C / 2 into this loop: 0.18 A²s from 30 V, 0.47 A²s from 44.3 V, 0.04 A²s from 17 V | The charge of C1 alone opens it from about 22 V up. Below that the rectifier has to finish the job, see below. |

The fuse's own resistance does two jobs in that table. It is most of the
resistance in the loop, and it is what keeps the fault current near what the
fuse can interrupt. In the one worst case, the highest input with a welded
switch and a saturated inductor, the current reaches the 50 A that the data
sheet gives for 125 V, to within 3 %. The fuse then has to break it at 44 V.
Its rating at 32 V DC is 300 A, and the sheet has no figure in between. I
take the part as able to do it and cannot show that from the sheet. It is
the first thing risk 21 tests. **Do not fit a larger rating.** A 1 A part of
the same series has 0.153 ohm and seven times the melting I²t, and the
current would reach 86 A.

C1 matters here. The through-hole Rubycon part that replaced the Lelon part
has less than half its series resistance, 0.033 against 0.082 ohm, and that
raised the worst peak from 46 to 49 A. With a C1 three times better than
its limit, 0.010 ohm, the simulation gives 51 A.

**What the simulation shows.** `hardware/sim/buck_overvoltage.cir`, 36 cases
with a 20 VA transformer, 12 more up to 75 VA and 6 with other values for
C1: `VIN_DC` at 17, 30 and 44.3 V, the failed switch at 0.02, 0.725 and
5 ohm, L1 at 47 uH and saturated at 5 uH, F5 opening at its nominal melting
I²t and at three times that.

| | Range over the cases |
|---|---|
| Highest `V_BUCK`, D25 at its highest clamp | 7.5 to 9.8 V, 9.9 V with C1 at 0.010 ohm |
| Highest `V_BUCK`, D25 at its lowest clamp | 7.1 to 8.2 V |
| Peak current in F5 and D25 | 2.2 to 51.5 A. D25 is rated for 58.3 A. |
| F5 open after, welded switch, `VIN_DC` 30 V or more | 0.04 to 0.2 ms at nominal I²t; up to 18 ms at three times that on 30 V |
| F5 open after, every other case | 0.15 to 200 ms |
| Energy in D25 until F5 opens | 0.016 to 0.69 J. In the cases that end within 10 ms, where the pulse curve of the SMBJ data sheet applies (Fig. 2, 600 W at 1 ms), the curve allows 4.4 to 11 times what D25 takes. |
| Energy in R1 | 0.02 to 1.4 J |

The slow cases are a switch that has become several ohms, and a low
`VIN_DC`. The model opens the fuse on I²t alone, which is right for
milliseconds and optimistic for longer. The bound that does not rest on the
model: the follow current is 320 to 730 % of F5's rating, and the data
sheet gives 5 s at most at 200 %. For those seconds D25 takes 5.5 to 15 W
and R1 9 to 42 W. D25 is rated 5 W steady; if it overheats it fails short,
which is the normal failure of a TVS, the current rises and F5 opens. R1
may not survive the slow cases. `V_BUCK` stays under the clamp voltage in
all of them.

**What every other part sees while D25 clamps.**

| Part | Sees | Rating | Result |
|---|---|---|---|
| U3, and so `3V3` and everything on it | `V5` up to 9.5 V | 20 V absolute, 18 V operating | `3V3` stays regulated. The processor, the expander, U7, Q3 and `V_DRV` work as normal. |
| U6 | 9.5 V | 36 V | Normal |
| Coil of K1 | 9.8 V | 8.5 V continuous at 23 °C (170 %) | 0.77 W in the coil for at most seconds. No damage expected. |
| Read-back divider to GPIO7 | 9.8 V on R93 | (9.8 - 3.6) V / 110 kohm = 56 uA at most towards the pin's clamp | Harmless |
| Sensor pull-ups | 9.5 V on R74, R77, R80 | 0.3 mA each into the BAT54S clamps | Harmless |
| Backlight | (9.5 - 3.0) V / 33 ohm = 197 mA | 80 mA rated | For milliseconds in the fast cases. May age the LEDs in a slow one. |
| **U11** | 9.8 V on its input | **7 V absolute maximum** | The one part beyond its rating: 7.5 to 9.8 V for 0.04 ms to 0.2 s, seconds in the slow cases. It may be damaged. It switches the sensor terminal and nothing else. |

So the fail-safe circuits stay inside their ratings throughout, and section
8.5 applies unchanged: the fault is one fault, and both detectors are
healthy. While D25 clamps, the processor runs and the keep-alive is under
its control. When F5 has opened, `V_BUCK` is zero. The coil of K1 has no
supply and no valve can be on, whatever the keep-alive does, with or
without USB power.

**A feedback fault.** R3 or R4 open leaves U1 with no feedback and it runs
at full duty, but its current limit still works: 1.75 A at most. D25 then
takes 7.4 V x 1.75 A = 13 W and fails short within seconds. F5 does not
open, because the input current is under 0.5 A. U1 limits into the short.
The board is dead with `V_BUCK` at zero. That is fail-safe and it is
visible, and it costs D25.

**How the fault shows.** On 24 VAC alone the board is dark. With USB
attached, firmware sees mains on `AC_ZC` and a normal `VIN_MON`, and the
relay read-back on GPIO7 reads low at rest, which it does only when
`V_BUCK` is missing. Firmware rule 15 reports that combination as a
regulator fault. Repair is U1, F5 and, after a slow case, D25 and R1.

**What is not covered.**

- **D25 failing open before F5 has opened.** A TVS driven far past its
  rating can lose a bond wire. Here the fuse limits the energy to a
  fraction of the pulse rating, so I do not expect it. Bench item, risk 21.
- **U11 pushing its input voltage onto GPIO45.** If U11 is damaged in a way
  that joins its input to its enable pin, up to 9.8 V reaches a processor
  pin through no resistance. A 10 kohm resistor in `SENS_PWR_EN` would
  bound that current to 0.6 mA. Review A2 recommends it and did not apply
  it; it is one more part and one more net.
- **The same fault in U3.** If the LDO shorts input to output, `3V3` goes
  to 4.95 V. That is a different fault. Section 9.5 has it: the valves are
  held off by hardware and the processor is not protected.

## 5. USB-C and power OR-ing

### 5.1 Circuit

J5 is a 16-pin USB 2.0 Type-C receptacle. R15 and R16, 5.1 kohm from CC1 and
CC2 to `GND`, mark the board as a device so that a Type-C source turns VBUS on.
U2 clamps D+, D- and VBUS. D+ and D- reach GPIO20 and GPIO19 through R97 and
R98, 0 ohm, with footprints C52 and C53 to ground on the module side, not
fitted. Review A1 quotes Espressif's hardware design guidelines for this:
reserve a series resistor, 22 or 33 ohm to start with, and an unpopulated
capacitor on each line, close to the module. Place all four within a few
millimetres of the module pins. The values are for EMC work on the built
board.

<!-- designsync:begin table block="C USB and 3V3" -->

| Ref | Part | Package | LCSC | Connections | Note |
|---|---|---|---|---|---|
| J5 | USB-C receptacle 16-pin, USB 2.0 | SMD | C165948 | VBUS (A4 A9 B4 B9) `VBUS`, GND (A1 A12 B1 B12) `GND`, CC1 (A5) `CC1`, CC2 (B5) `CC2`, D+ (A6 B6) `USB_DP`, D- (A7 B7) `USB_DM`, SBU1 SBU2 NC, shell `USB_SHLD` |  |
| R15 | 5.1k 1% | 0603 | C23186 | `CC1` to `GND` |  |
| R16 | 5.1k 1% | 0603 | C23186 | `CC2` to `GND` |  |
| U2 | USBLC6-2SC6 ESD array | SOT-23-6 | C7519 | 1 I/O1 `USB_DM`, 2 GND `GND`, 3 I/O2 `USB_DP`, 4 I/O2 `USB_DP`, 5 VBUS `VBUS`, 6 I/O1 `USB_DM` | Place at J5 |
| R97 | 0R | 0603 | C21189 | `USB_DP` to `USB_DP_MCU` | Series footprint |
| R98 | 0R | 0603 | C21189 | `USB_DM` to `USB_DM_MCU` | Series footprint |
| C52 | Not fitted | 0603 | none | `USB_DP_MCU` to `GND` | Footprint only (not fitted) |
| C53 | Not fitted | 0603 | none | `USB_DM_MCU` to `GND` | Footprint only (not fitted) |
| C13 | 100 nF 50 V X7R | 0603 | C14663 | `VBUS` to `GND` |  |
| D4 | SS34 Schottky 3 A 40 V | SMA | C8678 | A `VBUS`, K `V5` | OR-ing, USB side |
| C10 | 4.7 uF 25 V X5R | 0805 | C1779 | `V5` to `GND` |  |
| U3 | LDL1117S33R 3.3 V 1.2 A LDO | SOT-223 | C435835 | 1 GND `GND`, 2 VOUT `3V3`, 3 VIN `V5`, tab `3V3` |  |
| C11 | 10 uF 25 V X5R | 0805 | C15850 | `3V3` to `GND` |  |
| C12 | 100 nF 50 V X7R | 0603 | C14663 | `3V3` to `GND` |  |
| R17 | 0R | 0603 | C21189 | `USB_SHLD` to `GND` |  |

<!-- designsync:end -->

### 5.2 How the two sources combine

`V5` has two feeds, each through an SS34 Schottky: D3 from `V_BUCK` and D4 from
`VBUS`. The higher one supplies the board. Neither can feed the other, because
each diode is reverse-biased by the bus.

| Situation | `V_BUCK` | `VBUS` | `V5` | What works |
|---|---|---|---|---|
| 24 VAC only | 5.28 V | 0 | about 4.95 V | Everything |
| USB only | 0 | 4.4 to 5.25 V | 4.1 to 4.9 V | Logic, display, radio. No valve power, no sensor supply. |
| Both | 5.28 V | 4.4 to 5.25 V | about 4.95 V | Everything. The buck carries the load unless VBUS is above 5.3 V. |

The buck runs at 5.28 V so that `V5` is about 5.0 V after D3. The SS34 is
specified at 0.55 V maximum at 3 A. At 0.3 A I expect 0.3 to 0.35 V, read from
the typical curve.

Reverse leakage of an SS34 is 0.5 mA at 25 °C and rated voltage. With 24 VAC
present and a USB host attached, up to that much leaks from `V5` back into
VBUS. A host does not notice 0.5 mA. With no host attached, VBUS floats up to a
few volts through the leakage. That is harmless. Do not treat VBUS as a "USB
present" signal for that reason.

`V5` carries 4.7 uF, C10, plus the 100 nF decouplers on it. I recall a USB 2.0
limit of 10 uF of bypass capacitance at attach and did not re-read it. The buck
output capacitors are behind D3 and do not charge from USB.

USB alone powers the logic, as the specification requires. On USB the relay
cannot close and the sensor supply is off, because the coil of K1 and U11 are
both fed from `V_BUCK`. The read-back of the relay detector on GPIO7 reads
low for the same reason, section 7.4.

### 5.3 The ground question

`GND` is one leg of the transformer. A USB cable connects `GND` to the
computer's ground, and a desktop computer's ground is protective earth. So
plugging in USB earths one leg of the 24 VAC secondary.

**Safe.**

- **Floating secondary**: a Class 2 sprinkler transformer whose secondary has no connection to earth. Nearly all plug-in and DIN-rail sprinkler transformers are built this way. USB earths the `AC_N` leg and nothing flows.
- **Battery laptop or USB isolator**: no earth path at all.

**Safe only while nothing on the board fails.**

- **Earthed on the `AC_N` side**: if the installation earths the leg wired to terminal 2, USB earths the same leg again. Nothing flows through the cable while the board is healthy. The USB ground is then a second path from board `GND` to that leg, in parallel with F1.

**Not safe.**

- **Secondary earthed on the other leg**: if the leg wired to terminal 1 is earthed and a USB cable from an earthed computer is plugged in, the transformer is short-circuited through the USB cable. The loop is transformer, earth, computer, USB ground wire, board `GND`, F1, terminal 2, transformer.
- **Two controllers on one transformer with the legs swapped**: controller A has leg 1 as ground, controller B has leg 2. Anything that joins their grounds completes a short across the transformer. That includes one computer on both USB ports, a shared sensor cable or a Qwiic cable. It also applies to a ZoneFlow sharing a transformer with any other half-wave-rectified device.
- **A valve wire or COM faulted to earth, with USB attached**: COM is the other transformer leg. Wet outdoor splices do leak to earth. With an earthed computer attached, that leak is a path across the transformer.

**Why there are two fuses.** No single fuse position is in every loop. The
table follows review A1, section 6, with the second fuse now fitted.

| Fault | Loop | F1, ground leg | F4, other leg |
|---|---|---|---|
| Valve wire shorted to COM | Leg 1, F4, K1, COM, short, PTC, triac, shunt, `GND`, F1, leg 2 | In the loop | In the loop |
| D1 shorted | Leg 1, F4, D1, `GND`, F1, leg 2 | In the loop | In the loop |
| C1 shorted | Leg 1, F4, D2, R1, C1, `GND`, F1, leg 2 | In the loop, but see below | In the loop, but see below |
| Leg 1 earthed, earthed computer on USB | Leg 1, earth, computer, USB ground, `GND`, F1, leg 2 | In the loop | Not in the loop |
| Two devices on one transformer with legs swapped, grounds joined | Leg 1, other device's ground, joined ground, `GND`, F1, leg 2 | In the loop | Not in the loop |
| COM or a valve wire leaking to earth, earthed computer on USB | Leg 1, F4, K1, COM, earth, computer, USB ground, `GND`, F1, leg 2 | In the loop | In the loop |
| Leg 2 earthed, earthed computer on USB, and a board fault from the first two rows | As those rows as far as `GND`, then F1 in parallel with USB ground, computer, earth, leg 2 | Bypassed | In the loop |
| A second device on the transformer with the same leg as ground, grounds joined, and a board fault | The same, with the other device's ground in place of earth | Bypassed | In the loop |

**A shorted C1 does not open a fuse.** Review A2 simulated the current the
rectifier delivers into a short behind R1 (`hardware/sim/buck_overvoltage.cir`,
the follow-current lines): 1.6 to 3.7 A rms for a 20 to 75 VA transformer,
because R1 is 3 ohm and the rectifier conducts on one half-cycle only. That
is 54 to 122 % of F1 and F4, which open after minutes at those currents or
not at all. R1 takes 9 to 42 W and burns open. The board is dead and no
valve runs, so the fault is safe, but it is R1 and not a fuse that ends it.
A short in C2, C3 or U1 is different since that review: those are behind
F5, section 4.8.

The first draft had F1 only, for the fourth and fifth rows: those loops do
not touch terminal 1, so a fuse there does not see them. The last two rows
are what F1 alone leaves open. A board fault then has two ways back to leg 2,
and when F1 opens all of the current takes the USB cable or the joined
ground, with nothing but the transformer to limit it. F4 is in those loops.
With both fitted, every loop that passes through the board's own circuit
between the two terminals goes through at least one fuse.

What neither fuse covers is a connection made outside the board between the
two transformer legs, for example the leg-1 wire touching a sensor ground
wire while leg 2 is earthed and a computer is attached. That current enters
at one connector and leaves at another through the ground copper, and no
position on the board is in series with it.

**How well a fuse protects a USB cable.** F1 and F4 are 3 A time-lag fuses.
Section 6.6 puts the short-circuit current of a 20 VA transformer at about
7 A rms and of a 75 VA one at about 21 A. At 8 A, 270 % of rating, the fuse
datasheet bounds the opening time between 0.2 s and 60 s. A USB cable's
ground conductor is thin. I estimate that 8 A heats 28 AWG copper at about
50 K per second with no cooling. So **the fuses protect the board traces and
limit the damage, but they do not make the unsafe cases safe for the cable or
the computer.** A fast fuse would clear sooner and would also open on every
shorted valve wire. I chose the time-lag fuse and the warning.

**What the documentation must say.** These warnings belong in the wiring page
and the safety page.

1. Use a transformer whose 24 V output is not connected to earth on either side. If you are not sure, measure for continuity between each output terminal and the earth pin with the transformer unplugged. If either terminal is earthed, never connect a mains-powered computer by USB while the 24 VAC plug is in, whichever way round the plug is wired.
2. Never connect a computer by USB while the controller shares its transformer with another device, unless you have checked that both devices have the same leg on the same terminal.
3. For firmware work on an installed controller, prefer a laptop on battery, or unplug the 24 VAC plug block J1 first. The board runs from USB alone.
4. Sensor grounds and the Qwiic ground are the same net as transformer terminal 2. Do not join them to any other equipment that has its own connection to the transformer.

## 6. Output stage

Nine identical channels: Z1 to Z8 and MV. The table shows channel 1. For
channel n replace the first digit of each designator with n, and the net
suffix `Z1` with `Z2` to `Z8` or `MV`.

### 6.1 Circuit

The valve sits between a `COM` terminal and its output terminal `OUT_Z1`. From
the terminal the current goes through PTC F101 to the triac's T2, through the
triac to `ISNS`, and through the shunt R37 to `GND`.

The gate is fired from T2. The opto-triac U101 connects T2 to the gate through
R103. When the expander pulls `ZD_Z1_N` low and `V_DRV` is on, the opto LED
conducts, the opto-triac conducts, and gate current flows from T2 until the
main triac turns on and collapses the voltage across itself.

<!-- designsync:begin table block="Z output channels" channel="1" -->

| Ref | Part | Package | LCSC | Connections | Note |
|---|---|---|---|---|---|
| F101 | PTC 1.1 A hold, 60 V, 40 A maximum | 2920 | C3020148 | `OUT_Z1` to `T2_Z1` | Fault limiter |
| D101 | TVS 48 V bidirectional 600 W | SMB | C151264 | `OUT_Z1` to `ISNS` | Across the triac, at the terminal |
| Q101 | T810-600B-TR triac 8 A 600 V, 3-quadrant | DPAK | C155588 | 1 T1 `ISNS`, 2 T2 (tab) `T2_Z1`, 3 G `G_Z1` |  |
| R105 | 47R 1% 150 V | 0805 | C17714 | `T2_Z1` to `SNB_Z1` | Snubber |
| C101 | 10 nF 100 V X7R | 0805 | C18741 | `SNB_Z1` to `ISNS` | Snubber, returned to the shunt so that a shorted capacitor shows as current |
| U101 | MOC3023SR2M random-phase opto-triac | SMD-6 | C40701 | 1 anode `OLA_Z1`, 2 cathode `ZD_Z1_N`, 3 NC NC, 4 MT `G_Z1`, 5 do not connect NC, 6 MT `OGT_Z1` |  |
| R101 | 150R 1% | 0603 | C22808 | `V_DRV` to `OLA_Z1` | Opto LED current |
| R103 | 100R 1% 150 V | 0805 | C17408 | `T2_Z1` to `OGT_Z1` | Gate series |
| R104 | 1k 1% | 0603 | C21190 | `G_Z1` to `ISNS` | Gate to T1 |
| R102 | 680R 1% | 0603 | C23228 | `V_DRV` to `LEDA_Z1` | Indicator current |
| D102 | LED yellow-green | 0603 | C125094 | A `LEDA_Z1`, K `ZD_Z1_N` | Output indicator |

<!-- designsync:end -->

### 6.2 Quadrant analysis and why the gate is opto-coupled

T1 of every triac is at `ISNS`, within 0.3 V of `GND`. Both logic rails are at
or above T1. Logic can therefore only push current into a gate, never pull it
out. Positive gate current fires a triac in quadrant I when T2 is positive and
in quadrant IV when T2 is negative.

Quadrant IV is the problem. Three-quadrant triacs do not trigger in it at all.
Four-quadrant parts do, with their highest trigger current and their lowest
immunity. On 2026-11-10 the JLCPCB parts library held these candidates:

| Part | Maker | Rating | Quadrants | Stock |
|---|---|---|---|---|
| T810-600B-TR | ST | 8 A, 80 A surge | I, II, III | 3384 |
| T410-600B-TR | ST | 4 A, 30 A surge | I, II, III | 1320 |
| BTA204S-600D | WeEn | 4 A, 25 A surge | I, II, III | 1620 |
| ACST410-8BTR | ST | 4 A, 32 A surge at 60 Hz | I, II, III | 1334 |
| Z0103MN, Z0109NN | ST | 1 A, 8 A surge | all four | 3385, 932 |
| BT136S-600D | WeEn | 4 A, 25 A surge | all four | 40 |
| BT136S-600E | Minos | 4 A | not checked | 10232 |

The Z01 parts have the 8 A surge rating of a MAC97, which the specification
rules out. The genuine BT136S is not stocked in useful quantity. The Minos part
is a second-source copy whose datasheet I did not evaluate. Every well-rated
part that is in stock is three-quadrant. So a direct logic-driven gate, as the
specification describes, cannot be built from stocked parts with good ratings.

I looked at three ways to give a three-quadrant triac the gate current it
needs.

- **Negative gate supply.** A charge pump makes a rail below ground and each gate sinks into it. Every channel then needs a two-transistor level shifter, because a 0 to 3.3 V logic signal cannot switch a transistor whose emitter is at -3 V.
- **Logic supply referenced the other way.** ST recommends tying the triac's T1 to the logic supply's positive rail so the controller sinks gate current. Here that makes sensor ground and USB ground a different net from both transformer legs. A sensor ground wire touching COM would then put 24 VAC across the 3.3 V rail. I rejected it for that reason.
- **Gate current taken from T2 through an opto-triac.** Gate current then has the polarity of T2: quadrant I on one half-cycle, quadrant III on the other. These are the two quadrants in which every triac triggers most easily. This is the standard solid-state-relay circuit.

I chose the third. It has three more advantages. No logic pin touches the power
stage, so a surge that kills a triac does not also reach the expander. Gate
power comes from the load circuit, not from `3V3`. And the main triac's gate
drive stops by itself once the triac is on.

It costs nine opto-triacs, 2 to 3 USD per 8-zone board. It also means the triac needs a few volts across it before it fires
each half-cycle. Section 6.4 puts numbers on that.

### 6.3 Triac Q101: T810-600B-TR

Figures from the ST datasheet for the BTA08, BTB08, T810, T835 and T850,
DocID7472 rev 12, read as LCSC's copy for C155588.

| Parameter | Value |
|---|---|
| On-state current | 8 A rms at 110 °C case |
| Surge, one cycle, junction at 25 °C before it | 80 A at 50 Hz, 84 A at 60 Hz |
| I²t, 10 ms | 36 A²s |
| Gate trigger current, quadrants I, II, III | 10 mA maximum at 25 °C |
| Gate trigger voltage | 1.2 V maximum |
| Holding current | 15 mA maximum |
| Latching current | 25 mA maximum in I and III, 30 mA in II |
| dV/dt, gate open, 125 °C | 40 V/us minimum at 67 % of 600 V |
| Commutation (dI/dt)c, 125 °C | 5.4 A/ms minimum at 0.1 V/us re-applied, 2.8 A/ms at 10 V/us |
| On-state model, 125 °C maximum | 0.85 V + 0.05 ohm |
| Thermal resistance to ambient, DPAK | 70 K/W with 1 cm² of copper under the tab |

Figure 8 of the datasheet gives the change with temperature. At -20 °C the
trigger current is about 1.8 times its 25 °C value, and holding and latching
current about 1.45 times.

**Why not the 4 A part of the first draft.** The first draft used the
T410-600B-TR from the same maker. Its gate, holding and latching figures are
the same as the T810's, so nothing in section 6.4 changes. What differs is
the silicon area:

| | T410-600B-TR, first draft | T810-600B-TR, now |
|---|---|---|
| Surge, one cycle | 30 A | 80 A |
| I²t, 10 ms | 5.1 A²s | 36 A²s |
| (dI/dt)c at 0.1 V/us, 125 °C | 2.7 A/ms | 5.4 A/ms |
| On-state model | 0.89 V + 0.12 ohm | 0.85 V + 0.05 ohm |
| LCSC, stock at JLCPCB on 2026-11-10 | C2970064, 1320 | C155588, 3384 |
| Price at 100 pieces | 0.43 USD | 0.46 USD |

Review A1 showed that the T410 was not certain to stop conducting at the
first current zero of a dead short, and that it would then survive only one
or two cycles. Section 6.6 shows that the T810 carries the short until the
PTC ends it, whether it stops or not. Nine of them add about 0.25 USD to a
board at the 100-piece price. The T810-800B-TR, C2935379, is the same part at 800 V and fits if the
600 V one runs out.

**Other options I looked at for finding M1.**

- **A snubberless 8 A part, T835-600B-TR.** Same footprint and surge rating. Its gate needs 35 mA and it latches at 50 mA, so the firing delay of section 6.4 triples and a small pump-start coil no longer latches. Its commutation figure, 4.5 A/ms with no snubber, is no better for a resistive short than the T810's 5.4 A/ms. Rejected.
- **A faster or smaller series element.** A fast fuse clears in milliseconds, and then every shorted wire costs a fuse. A PTC with a lower hold current trips sooner, but a 0.75 A part holds only about 0.44 A at 70 °C, below the load. A series resistor large enough to keep a 75 VA short inside the T410's commutation limit is about 3.5 ohm, which costs 0.9 W per running valve. Rejected.
- **Keep the T410 and rely on K1.** K1 would then have to break up to 31 A peak on every dead short, against a contact rated to switch 5 A, with the triac past its two-cycle surge figure if the relay is slow. Rejected.

The WeEn BTA204S-600D fits the same footprint and has a 5 mA gate and 6 mA
holding current, with 25 A surge and 3.1 A²s. It is the part to fit at Q901
if the master output must hold a relay coil under 100 mA, section 6.4. It
does not meet the short-circuit calculation of section 6.6.

All three parts have the same pin order: pin 1 T1, pin 2 and tab T2, pin 3
gate. The ST order is from the package drawings of DocID7699 (T410) and
DocID7472 (T810), which show the DPAK with A1 on the left lead, A2 on the tab
and G on the right lead. ST names the main terminals A1 and A2 where this
document says T1 and T2. The WeEn order is from table 2 of its data sheet.

### 6.4 Drive margins

**Opto LED current.** U101 is an onsemi MOC3023, a random-phase opto-triac.
Its datasheet guarantees triggering at 5 mA of LED current at 25 °C, and
figure 4 puts the requirement at 1.12 times that at -20 °C. The LED forward
voltage is 1.15 V typical and 1.5 V maximum at 10 mA. The TCA9539 guarantees
8 mA of sink current at 0.5 V and 10 mA at 0.7 V, which I treat as a worst
output resistance of 70 ohm.

| Case | `V_DRV` | LED drop | Expander pin | LED current | Requirement |
|---|---|---|---|---|---|
| Worst, -20 °C | 3.19 V | 1.56 V | 70 ohm, 0.57 V | 7.1 mA | 5.6 mA |
| Worst, 25 °C | 3.19 V | 1.50 V | 70 ohm, 0.57 V | 7.5 mA | 5.0 mA |
| Typical | 3.30 V | 1.18 V | about 0.28 V | 12.3 mA | |
| Highest | 3.40 V | 1.00 V | about 0.15 V | 15.0 mA | 60 mA absolute maximum |

Each row solves (`V_DRV` - LED drop - pin voltage) / 150 ohm, with the 1.2 to
1.9 mA of the indicator LED branch added to the pin current. The typical and
highest pin voltages are my estimates. The datasheet gives no typical value.
The worst-case margin is 1.27. That corner needs the LDO at its low limit, the
LED at its maximum drop, the expander at its guaranteed minimum drive and
-20 °C together.

The highest pin current is 15.0 + 1.9 = 16.9 mA. The TCA9539 recommends at
most 18 mA per pin at 85 °C junction, and 100 mA per 8-bit port. Port 0 carries
Z1 to Z4 and MV, which is 85 mA with all five on. Port 1 carries Z5 to Z8,
68 mA. Both limits hold even if firmware turns everything on.

**Firing voltage.** The triac fires each half-cycle when T2 has risen far
enough to push the trigger current through the opto-triac, R103 and the gate.

| Case | Opto-triac | Gate | R103 and R104 | Firing voltage | Angle |
|---|---|---|---|---|---|
| Worst, -20 °C, 21.6 VAC | 3.0 V | 1.5 V | (18 + 1.5 mA) x 100 ohm | 6.5 V | 12° |
| Typical, 24 VAC | 1.2 V | 0.8 V | (5 + 0.8 mA) x 100 ohm | 2.6 V | 4° |

The 3.0 V is the opto-triac's maximum on-state voltage, specified at 100 mA.
The 1.5 V gate voltage at -20 °C is my estimate from the 1.3 V limit at 25 °C.
R104 takes the gate voltage divided by 1 kohm. Losing the first 12° of each
half-cycle lowers the power in the valve by 0.2 %. With an inductive
load the triac re-fires at the current zero, when the line voltage is already
tens of volts, so the delay is shorter still.

R103 also limits the opto-triac's current if it turns on at the line peak:
45 V / 100 ohm = 0.45 A. The MOC3023 allows 1 A peak.

**Small loads.** At -20 °C the triac needs 36 mA to latch and drops out below
22 mA. A valve drawing 150 mA rms peaks at 212 mA, so the triac is out of
conduction for about 10° after each current zero and 6° before it. A 50 mA rms
relay coil peaks at 71 mA, and those angles become 30° and 18°. In those
intervals the triac conducts only while gate current flows, at a few volts of
drop. I expect a 50 mA coil to hold, with some loss of rms current. I cannot
show it from the datasheet. If the master output must drive a coil under
100 mA, fit a BTA204S-600D at Q901. It latches at 9 mA at -20 °C.

### 6.5 dV/dt, commutation and the snubber

**Commutation.** The rate of fall of current at turn-off is the peak current
times 2 pi f. At 60 Hz that is 0.27 A/ms for 0.5 A rms, and 0.80 A/ms if the
output turns off during a 1.5 A rms inrush. The T810 guarantees 2.8 A/ms at a
re-applied dV/dt of 10 V/us. The margin is 3.5 without relying
on the snubber.

**Re-applied dV/dt.** When the triac stops, the valve's inductance and the
snubber capacitor ring. I estimate a solenoid at 0.13 to 0.25 H from typical
catalogue currents of 0.4 A inrush and 0.25 A holding at 24 V, 60 Hz, with
35 ohm of winding resistance. Those are assumed values, not measurements. With
C101 = 10 nF the ring frequency is 1 / (2 pi sqrt(0.13 x 10 nF)) = 4.4 kHz and
the fastest slope is 34 V x 27.7 krad/s = 0.94 V/us.

**Static dV/dt.** The T810 withstands 40 V/us to 400 V. Nothing on this board
can step more than the 77 V of the TVS clamp. A surge edge faster than 40 V/us
could still turn a triac on. It would conduct for at most one half-cycle and
then stop, because the gate is not driven. I assume a valve does not open in
10 ms. The onsemi MOC3023 withstands 1000 V/us; that figure belongs to this
maker's part.

**Snubber values.** R105 = 47 ohm and C101 = 10 nF are the values that every
published design in the prior-art survey uses. With the triac off, the snubber
passes 24 V x 2 pi x 60 Hz x 10 nF = 90 uA through the valve. It returns to
`ISNS`, like the TVS. The first draft returned it to `GND`. Review A1 pointed
out that a shorted C101 then feeds its valve through R105, about 0.3 A into a
35 ohm coil, by a path the shunt cannot see. Through `ISNS` that current is
measured, and the check for current with every output off finds it. The
snubber current of nine healthy channels is 0.8 mA, which is 0.5 mV at
`ISENSE_HI` and below what the measurement resolves. R105 dissipates
about C x V² x 2f = 1.4 mW in normal use and 4 W with C101 shorted, so it
will not last long in that fault; K1 is what removes the valve current.
C101 is rated 100 V.

### 6.6 Surge, short circuit and the fault limiter

**Inrush.** 1.5 A rms for 100 ms is inside the 8 A continuous rating.

**Dead short on a valve wire.** The specification says a shorted valve or
wire must not destroy the output. Three things act on a short, at different
speeds, and the output has to survive whichever of them ends it.

| What acts | When | What it needs |
|---|---|---|
| The comparator of section 9 removes gate drive | 70 us after the current passes 4.0 to 5.4 A | The triac must then stop at a current zero |
| K1 opens | Within 10 ms of the trip, section 7.2 | The contact must break the fault current |
| PTC F101 trips | Tens of milliseconds to about one second | Nothing. It is passive. |

**The fault current.** Inputs: 27.5 V rms open circuit, 38.9 V peak. A
transformer with 12 % regulation has an output impedance of about
0.12 x 24² / VA = 69 / VA ohm, which I treat as resistance. That is my
estimate, not a transformer data sheet. The board adds at least 0.31 ohm:
0.065 ohm of PTC at its lowest, 0.1 ohm of shunt, 0.05 ohm of triac, 0.068 ohm
for the two fuses and 0.03 ohm for the relay contact and copper. The triac
also drops 0.85 V.

| Transformer | Its impedance | Short at the terminals | Short behind 30 m of 18 AWG pair, 1.26 ohm |
|---|---|---|---|
| 20 VA | 3.45 ohm | 10.1 A peak, 7.2 A rms | 7.6 A peak, 5.4 A rms |
| 40 VA | 1.73 ohm | 18.7 A peak, 13.2 A rms | 11.5 A peak, 8.2 A rms |
| 75 VA | 0.92 ohm | 30.9 A peak, 21.9 A rms | 15.3 A peak, 10.8 A rms |

Peak current is (38.9 - 0.85) V over the sum of the resistances.

**Does the triac stop at the first current zero?** Only if the current falls
through zero slowly enough. A sine of peak Ip falls through zero at
2 pi f Ip. The T810 guarantees 5.4 A/ms at 125 °C when the voltage comes back
slowly, which it does across a short: the transformer's own sine rises at
0.015 V/us.

| Transformer | Fall at the zero, terminals, 50 and 60 Hz | Behind the cable, 50 and 60 Hz | Guaranteed at 125 °C |
|---|---|---|---|
| 20 VA | 3.2 and 3.8 A/ms | 2.4 and 2.9 A/ms | 5.4 A/ms |
| 40 VA | 5.9 and 7.0 A/ms | 3.6 and 4.3 A/ms | 5.4 A/ms |
| 75 VA | 9.7 and 11.6 A/ms | 4.8 and 5.8 A/ms | 5.4 A/ms |

Figure 11 of the data sheet shows the limit rising as the junction cools,
typically 1.6 times at 100 °C and 2.6 times at 75 °C. So the triac certainly
stops on a 20 VA transformer and on a 40 VA one behind a cable. On a 75 VA
transformer shorted at the terminals it is likely to conduct on, because the
half-cycle of fault current itself heats the junction. **I do not rely on
the triac stopping.**

**Does the triac survive if it does not stop, and K1 does not break the
current either?** Then the PTC ends the fault. Its data sheet gives one
point, a trip within 0.5 s at 8 A. I scale the time with the inverse square
of the current, which assumes the PTC heats with no loss during the trip.
That is an estimate and a bench item. Figure 6 of the triac data sheet gives
the surge the T810 survives against the number of cycles, read off the graph:
80 A for one cycle, 67 A for two, 60 A for three, 52 A for five, 47 A for
ten, 33 A for thirty and 27 A for a hundred.

| Transformer, short at the terminals | Fault current | PTC trips after about | Triac limit for that time | Margin in current |
|---|---|---|---|---|
| 20 VA | 10.1 A peak | 0.6 s, 37 cycles at 60 Hz | 31 A peak | 3.1 |
| 40 VA | 18.7 A peak | 0.18 s, 11 cycles | 46 A peak | 2.5 |
| 75 VA | 30.9 A peak | 0.07 s, 4 cycles | 55 A peak | 1.8 |

**By calculation the T810 carries a dead short on a transformer of 20 to
75 VA until the PTC trips, with no help from the comparator, the triac's own
turn-off or the relay.** Two things weaken the claim and both are in the
bench list. Figure 6 is for a junction that starts at 25 °C, and a triac
that was running a valve starts at 70 to 100 °C. And the PTC trip times
above 8 A are scaled, not specified. A short behind a cable is milder in
every row.

What the PTC-only case costs is a fuse. The 3 A time-lag fuses melt at
20 A²s. A 75 VA short that lasts 0.07 s is 21.9² x 0.07 = 34 A²s, and a 40 VA
one that lasts 0.18 s is 31 A²s. When the triac or K1 ends the fault within
two half-cycles, the worst figure is 21.9² x 0.02 = 9.6 A²s and the fuses
hold.

**K1 and the fault.** K1 releases at once on an over-current trip (section
7.2). If the triac has not stopped, its contact breaks up to 31 A peak at up
to 39 V. The contact is rated to switch 5 A. One such break may weld or
erode it. The firmware weld check of section 7.4 finds a welded contact
before the next run, and the surge clamp D23 on `COM` takes the inductive
kick. **K1's behaviour when it breaks a fault current is a bench item.** The
calculation above does not depend on it.

**The series element.** The specification allows a PTC, a fuse or a resistor.

| Element | In a dead short | In normal use | After the fault |
|---|---|---|---|
| Fuse, 1 A fast | Clears in milliseconds. I did not size one. | No loss | Someone must replace it. Every shorted wire is a service call. |
| Resistor, 2.2 ohm | Limits the peak. Carries the fault until something else acts, at tens of watts. | 0.55 W at 0.5 A, all the time | Nothing to reset, if it survived |
| PTC, 1.1 A hold | Trips in 0.07 to 0.6 s, by the estimate above | 0.02 to 0.1 W | Resets when power is removed |

F101 is a BHFUSE BSMD2920-100-60V, LCSC C3020148, 23,608 in stock at JLCPCB
on 2026-11-10. From its data sheet: 60 V, 1.10 A hold and 2.20 A trip at
25 °C, **40 A maximum fault current**, 0.5 s to trip at 8 A, 0.065 ohm at
its lowest and 0.41 ohm at most one hour after a trip. The first draft used
the Littelfuse 2920L110/60, which has the same hold and trip currents and a
maximum fault current of 20 A. A 75 VA transformer exceeds that, as the
review pointed out, so the part changed. The Littelfuse part fits the same
pads.

The hold current falls with temperature: 0.83 A at 50 °C, 0.73 A at 60 °C and
0.64 A at 70 °C, still above the 0.5 A load. At 70 °C the trip current is
about 1.3 A, below the 1.5 A inrush. The inrush lasts 100 ms and a PTC just
above its trip current takes seconds, so I do not expect a trip. That is a
bench item.

**TVS D101.** A Littelfuse SMBJ48CA from the output terminal to `ISNS`. Its
48 V stand-off is above the 45.3 V peak that appears across an off triac at
32 VAC. It clamps at 77.4 V, far below the triac's 600 V. It returns to `ISNS`
and not to `GND` so that a TVS that has failed short puts the valve current
through the shunt, where firmware can see current with every output off. A TVS
normally fails short, and a shorted TVS energises its valve. Section 7 is the
answer to that.

### 6.7 Dissipation and junction temperature

Two zones and the master valve on, 0.5 A rms each, T810 maximum on-state
model at 125 °C.

- **Per triac**: 0.85 V x 0.45 A average + 0.05 ohm x (0.5 A)² = 0.40 W.
- **Rise**: 0.40 W x 70 K/W = 28 K with 1 cm² of copper on the tab, the only figure the data sheet gives for the DPAK.
- **Junction**: 70 °C air + 28 K + 5 K allowed for neighbours = 103 °C. The limit is 125 °C.

Each tab is its own net, `T2_Zn`. The layout must give every triac its own
copper island of 2 cm² or more, on both sides with vias if the top side lacks
room. That is twice the area the calculation assumes. The
other heat sources while watering are the shunt at 0.23 W, three PTCs at up to
0.10 W each, the LDO at 0.27 W, the relay coil at 0.22 W, the backlight at 0.3 W
and the module. The total is about 3.5 W in a closed box. The mechanical
design estimates the rise with vents: 16 K at 3 W in revision 1 of the
contract, from which the 70 °C air temperature of section 3.3 was set, and
14 K at 3.5 W in revision 2. The R8 module is rated to 65 °C
and to 85 °C only with PSRAM error correction enabled, so firmware must enable
it: section 19.1, rule 7. See section 20.

### 6.8 Zero-cross switching

I recommend random turn-on, with no zero-cross hardware and no firmware timing.

- **Inrush**: for an inductive load, closing at the voltage zero gives the largest flux offset, not the smallest current. A solenoid's inrush comes from its open air gap and lasts until the plunger seats, whenever it is switched.
- **Stress**: the worst step at random turn-on is 45 V into more than 0.1 H. The current rises at under 0.5 A/ms. The triac allows 50 A/us.
- **Zero-cross optos**: a MOC304x-type driver refuses to fire above its inhibit voltage. An inductive load needs re-firing at the current zero, when the line voltage is near its peak. The random-phase MOC3023 has no such limit.

Turn-off is always at a current zero, because that is how a triac stops.
Firmware does use `AC_ZC`, but for mains-frequency detection and for timing the
current measurement, not for switching.

### 6.9 Output LED

D102 is in parallel with the opto LED branch, between `V_DRV` and the same
expander pin. It lights only when the expander bit is low and the fail-safe
circuit has `V_DRV` on. That is the real drive state, not the commanded state.
It does not prove that the triac conducts. The current measurement does that.

## 7. Valve common relay

### 7.1 Why it is here

Removing LED drive stops a healthy output. It does nothing for these three
failures, each of which leaves one valve energised:

- **Triac shorted T2 to T1.** The usual way a triac dies after a surge or an overload. The prior-art survey lists it as the most common field failure.
- **TVS D101 shorted.** The usual way a TVS dies after a surge beyond its rating.
- **Opto-triac output shorted.** The main triac then fires every half-cycle.

A stuck-on sprinkler valve floods something. The specification's rule 1 says
every output is off when the controller is in reset or crashed. With a shorted
output device that is not true, and no firmware can make it true.

K1 is in the feed from `AC_L` to the `COM` terminals. With K1 open no valve
has power, whatever the output devices are doing.

Since review A1 the relay has a second job. Its coil current passes through a
transistor that has its own keep-alive detector, separate from the one that
gates the LED drive. If a fault holds the gate-drive detector on, the relay
still opens when the keep-alive stops. Section 8.5 has the combined fault
analysis.

### 7.2 Circuit

<!-- designsync:begin table block="B valve common relay" -->

| Ref | Part | Package | LCSC | Connections | Note |
|---|---|---|---|---|---|
| K1 | G5NB-1A-E DC5 relay SPST-NO 5 A, 5 V 125R coil | THT 20.4x7 mm | C48746 | coil+ `V_BUCK`, coil- `RLY_A`, contact 1 `AC_L`, contact 2 `COM` |  |
| D5 | 1N4148W | SOD-123 | C81598 | A `RLY_A`, K `V_BUCK` | Coil flyback |
| Q1 | AO3400A N-MOSFET 30 V | SOT-23 | C20917 | G `RLY_G1`, S `RLY_B`, D `RLY_A` | On when the expander bit RLY_ON is high. Off within 0.1 ms when DRV_EN resets the expander |
| R11 | 1k 1% | 0603 | C21190 | `RLY_ON` to `RLY_G1` |  |
| R12 | 100k 1% | 0603 | C25803 | `RLY_G1` to `GND` |  |
| Q2 | AO3400A N-MOSFET 30 V | SOT-23 | C20917 | G `RLY_G2`, S `GND`, D `RLY_B` | On while the relay detector sees keep-alive edges |
| R89 | 1k 1% | 0603 | C21190 | `KA` to `KB_N0` | Series resistor of the relay detector pump |
| C51 | 4.7 uF 25 V X5R | 0805 | C1779 | `KB_N0` to `KB_N1` | Pump capacitor. The gate of Q2 has no other path from the pin |
| D22 | BAT54S dual Schottky, series | SOT-23 | C7420333 | 1 A `GND`, 2 K `RLY_G2`, 3 common `KB_N1` | Its own package, not shared with D7 |
| R14 | 100k 1% | 0603 | C25803 | `RLY_G2` to `GND` | Bleed, with R90. Sets the relay hold-up |
| R90 | 100k 1% | 0603 | C25803 | `RLY_G2` to `GND` | Second bleed: one open resistor doubles the hold-up and no more |
| C50 | 10 uF 25 V X5R | 0805 | C15850 | `RLY_G2` to `GND` | Reservoir |
| R93 | 10k 1% | 0603 | C25804 | `V_BUCK` to `RLY_B` | Pulls the node between Q1 and Q2 up, so that firmware can see Q2 off |
| R94 | 100k 1% | 0603 | C25803 | `RLY_B` to `RLY_B_RB` | Read-back divider to GPIO7 |
| R95 | 150k 1% | 0603 | C22807 | `RLY_B_RB` to `GND` | 3.05 V at the pin when Q2 is off |
| D23 | TVS 48 V bidirectional 600 W | SMB | C151264 | `COM` to `GND` | Clamps the valve common while K1 is open and when it opens under load |
| JP1 | Solder jumper, open | PCB | none | `AC_L` to `COM` | Bridge only if K1 is not fitted |
| J2 | Header 7-way 3.81 mm pluggable, right angle | THT | C441187 | 1 `COM`, 2 `COM`, 3 `OUT_MV`, 4 `OUT_Z1`, 5 `OUT_Z2`, 6 `OUT_Z3`, 7 `OUT_Z4` | Valves A |
| J3 | Header 4-way 3.81 mm pluggable, right angle | THT | C441184 | 1 `OUT_Z5`, 2 `OUT_Z6`, 3 `OUT_Z7`, 4 `OUT_Z8` | Valves B (8-zone build only) |

<!-- designsync:end -->

The coil is between `V_BUCK` and two MOSFETs in series, Q1 above Q2.

- **Q1** conducts when the expander bit `RLY_ON` is high. The expander works only while `DRV_EN` is high, so Q1 needs firmware to ask for the relay and the gate-drive detector of section 8 to agree. When `DRV_EN` falls the expander resets, the pin floats and R12 discharges Q1's gate in 0.1 ms.
- **Q2** conducts while the relay detector of section 7.3 sees edges on the keep-alive pin. Nothing else can turn it on: its gate connects to a capacitor, two diodes and two resistors, and to no supply rail, logic output or GPIO.

K1 closes only when both conduct.

**Release is fast, on purpose.** The first draft had a network that was meant
to hold Q2 on for 30 to 50 ms after `DRV_EN` fell, so that the triacs would
stop before the contacts opened. Review A1 showed that it did nothing,
because Q1 let go first. The decision on finding M3 was to keep the fast
release and remove the hold parts, D21 and R13. The R13 of today is another
part, in section 9.5. So:

| Event | What K1 does |
|---|---|
| Over-current trip | `DRV_EN` falls within 70 us, Q1 turns off 0.1 ms later, the contacts part within the 10 ms release time. K1 may break fault current. Section 6.6. |
| Keep-alive stops, both detectors healthy | The gate-drive detector removes LED drive after 0.21 to 0.83 s and releases Q1. The relay detector releases Q2 after 0.10 to 1.45 s. Whichever is first opens K1. If the relay detector is first, K1 breaks the valve current, at most 1.5 A, inside its rating. |
| Keep-alive stops, gate-drive detector stuck on | Q2 opens K1 within 1.45 s, or 2.19 s if the pin stopped high. The triacs are still driven, and it does not matter. |
| Keep-alive stops, relay detector stuck on | `DRV_EN` falls within 0.83 s, or 1.25 s if the pin stopped high, and Q1 opens K1. |
| Firmware ends a run | Firmware turns the outputs off, waits 40 ms and clears `RLY_ON`. The contacts break no current. |

K1 is an Omron G5NB-1A-E with a 5 V coil of 125 ohm, 40 mA. From the English
Omron data sheet: the high-capacity contact is rated 5 A at 250 VAC and 3 A at
30 VDC, resistive, with 5 A maximum switching current. Operate and release
times are 10 ms maximum each. The must-operate voltage is 75 % of rated,
3.75 V, at a coil temperature of 23 °C. LCSC's copy of the sheet gives the
must-release voltage as 10 % of rated or more, 0.5 V, and the coil resistance
tolerance as 10 %.

**Pull-in margin.** Copper gains 0.39 % per kelvin, so a coil at 85 °C needs
3.75 V x 1.24 = 4.65 V. The coil is now fed from `V_BUCK`, as review finding
m4 recommended, not from `V5` behind the OR diode. The lowest `V_BUCK` is
5.16 V. Q1 and Q2 drop under 10 mV between them at 42 mA. The margin at the
hot corner is 5.15 / 4.65 = 1.11. From `V5` it was 1.03. The relay has
nothing to switch on USB power, so it loses nothing by having no supply
there.

**Surge clamp on COM.** D23, an SMBJ48CA from `COM` to `GND`, is new. While
K1 is open, which is most of the time, the `COM` terminals and the longest
wire of the installation were clamped only by the 750 VAC withstand of the
open contact. D23 clamps them at 77.4 V like every other field terminal. It
also takes the inductive kick when K1 opens with valve current flowing. A
valve at 0.5 A with 0.25 H stores 0.5 x 0.25 x 0.71² = 63 mJ at the current
peak; the TVS is rated 600 W for 1 ms, which is 0.6 J. With K1 closed D23 is
in parallel with D1 across the supply and does nothing.

**D5** returns the coil current to `V_BUCK` when Q1 or Q2 turns off.

**Why K1 is still a through-hole part.** The specification allows
through-hole parts only where no surface-mount one exists. I searched the
JLCPCB assembly library on 2026-11-10 for a surface-mount relay. What it
stocks are signal relays: Omron G6K (1 A) and G6S-2F (2 A), Panasonic TQ2SA,
TX2SA and AGQ (2 A), Hongfa HFD3 and HFD4 (2 A). Their contacts are rated to
carry 1 to 2 A and to switch 0.3 to 0.5 A at 125 VAC. This design needs 1.5 A
continuous and 2.5 A of inrush, must break 1.5 A of inductive current when
the keep-alive stops, and must carry tens of amps for the cycles a dead short
lasts. None of the stocked surface-mount relays meets that, and I found no
surface-mount power relay in stock. K1 stays through-hole, with the terminal
blocks.

JP1 is an open solder jumper across the contacts. If the project decides
against the relay, leave out K1, Q1, Q2, D5, D22, D23, R11, R12, R14, R89,
R90, R93 to R95, C50 and C51, and bridge JP1. The fault analysis of section
8.5 then no longer holds.

### 7.3 The relay keep-alive detector

R89, C51, D22, C50, R14 and R90 make a second diode pump on the keep-alive
pin. It is the same kind of circuit as the pump of section 8, and it ends at
a transistor gate where that one ends at a comparator.

Each rising edge of `KA` pushes charge through C51 and the upper diode of D22
into C50. Each falling edge refills C51 through the lower diode. R14 and R90
in parallel, 50 kohm, drain C50 all the time. While the pin toggles, the gate
of Q2 sits near 3.3 V less two Schottky drops. When it stops, at either
level, C51 passes no more charge and the gate decays with 50 kohm x 10 uF =
0.5 s until Q2 turns off.

The gate has no DC path from anything. That is the point of the circuit. A
pin stuck high, a logic output stuck high or a supply rail at the wrong
voltage cannot hold Q2 on.

**Values, and where they differ from the review's proposal.** Review A1,
section 3.4, proposed 1 kohm, 1 uF, a BAT54S, a 1 uF reservoir and two
1 Mohm bleed resistors, and said the proposal needed review. Its own
simulation showed the hold-up falling from 0.71 s at 27 °C to 0.36 s at
60 °C. The cause is leakage. At 2.7 V, 500 kohm draws 5 uA, and at the
turn-off threshold 1.3 uA. The Schottky model in that simulation leaks about
3 uA at 60 °C, back through the upper diode into C51. So when warm, the diode
discharges the reservoir as fast as the resistors do, and the timing depends
on a leakage that the diode's data sheet does not limit above 25 °C.

I kept the topology and changed three values: R14 and R90 are 100 kohm each,
C50 is 10 uF and C51 is 4.7 uF. The bleed current is ten times larger, 54 uA
at 2.7 V and 13 uA at the lowest threshold, so the same leakage moves the
timing by about 7 % instead of 50 %. C51 had to grow with it, because the
pump has to supply the bleed current: its output resistance is 1 / (f x C51),
2.1 kohm at the firmware's 100 Hz and 8.5 kohm at the slowest allowed rate.
Both capacitors are values that the gate-drive detector already uses, so the
change adds no BOM line.

**Timing.** From `hardware/sim/relay_detector.cir`. The AO3400A's gate
threshold is 0.65 to 1.45 V at 25 °C. Above the highest threshold every part
conducts, and below the lowest none does. K1 holds on a few milliamps, so it
may release anywhere between those two moments. I shifted both thresholds by
-3 mV/K for other temperatures. That figure is my assumption; the data sheet
gives none.

| Case | Gate while toggling | On after the first edge | Earliest release | Certainly released |
|---|---|---|---|---|
| Nominal parts, 100 Hz, -20 °C | 2.54 V | 40 ms | 0.23 s | 0.58 s |
| Nominal parts, 100 Hz, 27 °C | 2.69 V | 30 ms | 0.31 s | 0.70 s |
| Nominal parts, 100 Hz, 70 °C | 2.81 V | 22 ms | 0.32 s | 0.65 s |
| Small capacitors, 3.2 V rail, 25 Hz, -20 °C | 2.09 V | 82 ms | 0.12 s | |
| Small capacitors, 3.2 V rail, 100 Hz, -20 °C | 2.42 V | | 0.15 s | |
| Large capacitors, 3.4 V rail, 27 °C | | | | 0.80 s |
| The same, pin stops high | | | | 1.21 s |
| Large capacitors, 27 °C diodes read at the 70 °C threshold | | | | 0.93 s |
| The same, pin stops high | | | | 1.41 s |
| R14 or R90 open, nominal parts, 27 °C | | | | 1.45 s |
| R14 or R90 open, the worst case above | | | | 1.91 s, 2.86 s if the pin stops high |

"Small capacitors" is C50 at 7.0 uF and C51 at 3.3 uF, "large" is 11 uF and
5.2 uF: tolerance, temperature and DC bias taken together. Those ranges are
my allowance for a generic X5R part, not read from a curve. The row with
27 °C diodes and the 70 °C threshold is not a state any real part is in. It
is the upper limit that does not depend on the leakage model, because at
27 °C the model leaks 0.2 uA against 10 uA or more of bleed current.

**So the relay detector releases Q2 between 0.12 and 0.95 s after the last
edge, and within 1.4 s if the pin stops high.** With one bleed resistor open
the limits are 1.9 s and 2.9 s. The pin-high case is longer because C51 then
discharges through the diode into the reservoir as well.

**Review A2 widened this window.** Its corner runs, review section 4, take
the threshold drift between -1.5 and -4.5 mV/K where the table above takes
-3 mV/K, `3V3` from 3.0 to 3.6 V, diodes at both ends of their data and a
pin of 16 to 70 ohm. With the firmware's 5 ms edges Q2 lets go between 0.10
and 1.45 s after the last edge, and within 2.19 s if the pin stops high. The
long end is a Q2 with a 0.65 V threshold at 70 °C. Section 19.4 and the
limits of section 19.7 use these figures. Which end a real part sits at is a
bench item, risk 28.

The window is wide, a factor of eight. Most of it is the transistor's
threshold spread, which a comparator would remove. I kept the bare
transistor, because every part added between the pin and the gate is another
part that can stick. The gate-drive detector is the one with the comparator
and the tighter window, 0.45 to 0.9 s here and 0.21 to 0.83 s over the
corners of review A2. Nothing requires the relay to open
after the triacs stop: if it opens first it breaks at most 1.5 A, inside the
contact rating, into the clamp D23. The earliest release, 0.12 s, is six
times the 20 ms the keep-alive contract allows between edges.

**Gate drive margin.** At the worst corner, -20 °C, a 3.2 V rail, the
smallest capacitors and the slowest allowed keep-alive of one edge per 20 ms,
the gate sits at 2.09 V. The highest threshold there is 1.59 V. The margin is
0.50 V. At the firmware's own 100 Hz it is 0.83 V. Review A2 took a harsher
corner: a threshold of 1.66 V at -20 °C, diodes at their highest forward
voltage, a pin of 70 ohm and the pull-down R33 at 2.2 kohm. There the margin
is 0.22 V with edges 20 ms apart and 0.55 V at the firmware's 5 ms, and
0.08 and 0.38 V with `3V3` at 3.0 V. It also found that a keep-alive with
one phase of 1 ms does not hold Q2 at that corner, because R89 and the pin
charge C51 with a time constant of about 3 ms. Section 19.4 now forbids a
phase shorter than 2.5 ms. The AO3400A data sheet
(AOS, rev 3) guarantees 48 mohm at a gate voltage of 2.5 V and gives a
transconductance of 33 S at 5.7 A. Its on-resistance is not specified below
2.5 V. A transistor with 33 S that is 0.5 V above its threshold passes amps,
and the coil needs 0.042 A, so I expect millivolts of drop, and I cannot
quote a guaranteed figure. The level-1 model in the simulation is not
evidence for it. Measuring the drain voltage of Q2 at -20 °C is in the
bench list.

**Single faults inside the detector**, from the same simulation:

| Fault | Effect | Safe? |
|---|---|---|
| R89 open, C51 open, D22 either diode open, D22 lower diode short, C50 short, R14 or R90 short | Gate stays below 0.3 V. K1 never closes. | Yes. Found at the first run: no relay, no valve current. |
| R89 short | No change in timing, 0.74 s. The pin's own resistance limits the edge current. | Yes |
| R14 or R90 open | Release takes twice as long: 1.45 s typical, 1.9 s at worst, 2.9 s if the pin stops high. | Yes, slower. The timing test of section 7.4 finds it. |
| D22 upper diode short | Gate swings to 0.85 V at most. K1 does not pull in reliably. Off within 0.07 s of the last edge. | Yes |
| C50 open | Gate follows the pin through C51. Coil current swings between 0 and 40 mA at 100 Hz and K1 may chatter. Off within 10 ms if the pin stops low and 0.36 s if it stops high. | Yes |
| **C51 short** | Normal while the pin toggles. **If the pin stops high, Q2 stays on.** | No, alone. The gate-drive detector still releases Q1. The pin-high step of the self-test finds it. |
| **Q2 shorted drain to source, or gate to drain** | Q2 conducts whatever the detector does. | No, alone. The gate-drive detector still releases Q1. The read-back finds it before the next run. |

### 7.4 Read-back, self-test and weld check

GPIO7 reads the node between Q1 and Q2, `RLY_B`, through the divider R94 and
R95. R93 pulls that node up to `V_BUCK`.

| State | `RLY_B` | At GPIO7 |
|---|---|---|
| Q2 off | 5.08 V through R93 | 3.05 V, high. 2.94 to 3.15 V over the tolerance of `V_BUCK`. |
| Q2 on | 0 V | 0 V, low |
| Q2 shorted gate to drain | Its own threshold, 0.65 to 1.6 V | 0.4 to 0.95 V. Low as a logic level for most parts. GPIO7 is ADC1 channel 6, and a reading between 0.3 and 1.5 V is this fault. |
| No 24 VAC, USB only | 0 V, because `V_BUCK` is off | 0 V |

The read-back connects only to the drain of Q2, through 100 kohm. Driving
GPIO7 by mistake cannot turn Q2 on or energise the coil. It must never be
connected to the gate: a pin on the gate would be a DC path that the detector
exists to avoid.

**What the read-backs make testable.** GPIO42 reads `V_DRV`, the LED supply
behind Q3, section 8.6.
With both, firmware can prove before every run that both detectors are off
when the keep-alive is stopped, and after every run how long each takes to
let go. A fault that sticks one detector on is then found at the next run,
while the other detector is still good. The full sequence is in section
19.7.

**Weld check.** A welded K1 contact and a shorted Q1 look the same: `COM` is
live although `RLY_ON` is low. Neither defeats the gate-drive detector, but
either removes the back-up that this section exists for. Firmware finds both
before every run, after the detector tests:

1. Keep-alive running, `RLY_ON` low, every valve bit off. K1 should be open.
2. Turn on the output that is about to run, with `RLY_ON` still low, for one measurement window of 100 ms.
3. Measure the current over that window. With K1 open it must be under the idle threshold of section 19.2.
4. If current flows, the contact is welded or Q1 is shorted. Turn the output off, stop the keep-alive, raise a fault and refuse to run until a person has acknowledged it.

A valve given 100 ms of current may click and does not pass water. The check needs a connected
valve on that output; on an output with nothing connected it proves nothing,
which is why it uses the output that is about to run. After an over-current
trip, where K1 may have broken a fault current, firmware runs the check on
the next run like any other.

### 7.5 What firmware does with it in normal use

1. Close K1 at least 20 ms before the first output turns on, and open it at least 40 ms after the last one turns off. The contacts then never make or break current.
2. With K1 closed and every output off, measure the current. More than the idle threshold means a shorted triac, TVS, opto-triac or snubber capacitor. Open K1, raise a fault and do not close it again until a person has acknowledged the fault.
3. With K1 open the current must read zero. That is a free check of the amplifier offset.

## 8. Fail-safe gate

### 8.1 Circuit

<!-- designsync:begin table block="F keep-alive detector" -->

| Ref | Part | Package | LCSC | Connections | Note |
|---|---|---|---|---|---|
| R33 | 2.2k 1% | 0603 | C4190 | `KA` to `GND` | Pull-down. Low enough that a net behind a 10 kohm pull-up cannot run the detectors through a bridge |
| R29 | 220R 1% | 0603 | C22962 | `KA` to `KA_N0` |  |
| C22 | 4.7 uF 25 V X5R | 0805 | C1779 | `KA_N0` to `KA_N1` | Pump capacitor |
| D7 | BAT54S dual Schottky, series | SOT-23 | C7420333 | 1 A `GND`, 2 K `KA_N2`, 3 common `KA_N1` |  |
| C23 | 10 uF 25 V X5R | 0805 | C15850 | `KA_N2` to `GND` | Reservoir |
| R30 | 110k 1% | 0603 | C25805 | `KA_N2` to `GND` | Bleed, with R91. Sets the hold-up time |
| R91 | 110k 1% | 0603 | C25805 | `KA_N2` to `GND` | Second bleed: one open resistor doubles the hold-up and no more |
| R31 | 100k 1% | 0603 | C25803 | `KA_N2` to `KA_INP` |  |
| R32 | 510k 1% | 0603 | C23192 | `KA_INP` to `KA_OK` | Hysteresis |
| C24 | 10 nF 50 V X7R | 0603 | C57112 | `KA_INP` to `GND` |  |
| R34 | 15k 1% | 0603 | C22809 | `3V3` to `KA_REF` |  |
| R35 | 10k 1% | 0603 | C25804 | `KA_REF` to `GND` |  |
| R36 | 10k 1% | 0603 | C25804 | `3V3` to `KA_OK` | Pull-up |

<!-- designsync:end -->

<!-- designsync:begin table block="E expander and drive enable" -->

| Ref | Part | Package | LCSC | Connections | Note |
|---|---|---|---|---|---|
| U5 | TCA9539PWR 16-bit I2C expander with reset | TSSOP-24 | C131972 | 1 INT `EXP_INT_N`, 2 A1 `GND`, 3 RESET `DRV_EN`, 4 P00 `ZD_Z1_N`, 5 P01 `ZD_Z2_N`, 6 P02 `ZD_Z3_N`, 7 P03 `ZD_Z4_N`, 8 P04 `ZD_MV_N`, 9 P05 `RLY_ON`, 10 P06 `P06`, 11 P07 `P07`, 12 GND `GND`, 13 P10 `ZD_Z5_N`, 14 P11 `ZD_Z6_N`, 15 P12 `ZD_Z7_N`, 16 P13 `ZD_Z8_N`, 17 P14 `VARIANT_N`, 18 P15 `SENS_FLT_N`, 19 P16 `P16`, 20 P17 `P17`, 21 A0 `GND`, 22 SCL `I2C0_SCL`, 23 SDA `I2C0_SDA`, 24 VCC `3V3` | Address 0x74 |
| C18 | 100 nF 50 V X7R | 0603 | C14663 | `3V3` to `GND` | At U5 |
| RN1 | 100k x4 5% resistor array | 0603x4 | C1996 | 1 `ZD_Z1_N`, 8 `V_DRV`, 2 `ZD_Z2_N`, 7 `V_DRV`, 3 `ZD_Z3_N`, 6 `V_DRV`, 4 `ZD_Z4_N`, 5 `V_DRV` | Holds the valve pins at the LED supply while the expander is in reset |
| RN2 | 100k x4 5% resistor array | 0603x4 | C1996 | 1 `ZD_Z5_N`, 8 `V_DRV`, 2 `ZD_Z6_N`, 7 `V_DRV`, 3 `ZD_Z7_N`, 6 `V_DRV`, 4 `ZD_Z8_N`, 5 `V_DRV` | As RN1. Fitted on both builds, so that P10 to P13 never float |
| RN3 | 100k x4 5% resistor array | 0603x4 | C1996 | 1 `P06`, 8 `GND`, 2 `P07`, 7 `GND`, 3 `P16`, 6 `GND`, 4 `P17`, 5 `GND` | Spare pins held low |
| R96 | 100k 1% | 0603 | C25803 | `ZD_MV_N` to `V_DRV` | As RN1, for the master valve pin |
| R27 | 10k 1% | 0603 | C25804 | `3V3` to `VARIANT_N` |  |
| R28 | 1k 1% | 0603 | C21190 | `VARIANT_N` to `GND` | Variant strap (8-zone build only) |
| U6 | LM2901DR quad comparator | SOIC-14 | C7932 | 1 1OUT `KA_OK`, 2 2OUT `OC_TRIP_N`, 3 VCC `V5`, 4 2IN- `OC_CMP`, 5 2IN+ `VH`, 6 1IN- `KA_REF`, 7 1IN+ `KA_INP`, 8 3IN- `VL`, 9 3IN+ `OC_CMP`, 10 4IN- `VL`, 11 4IN+ `ZC_DIV`, 12 GND `GND`, 13 4OUT `AC_ZC`, 14 3OUT `OC_TRIP_N` |  |
| C19 | 100 nF 50 V X7R | 0603 | C14663 | `V5` to `GND` | At U6 |
| U7 | 74HC132D quad NAND, Schmitt-trigger inputs | SOIC-14 | C5601 | 1 1A `OC_TRIP_N`, 2 1B `FAULT_N`, 3 1Y `FAULT`, 4 2A `KA_OK`, 5 2B `FAULT`, 6 2Y `FAULT_N`, 7 GND `GND`, 8 3Y `DRV_EN_N`, 9 3A `KA_OK`, 10 3B `FAULT_N`, 11 4Y `DRV_EN`, 12 4A `DRV_EN_N`, 13 4B `DRV_EN_N`, 14 VCC `3V3` |  |
| C20 | 100 nF 50 V X7R | 0603 | C14663 | `3V3` to `GND` | At U7 |
| Q3 | AO3401A P-MOSFET 30 V | SOT-23 | C15127 | G `DRV_EN_N`, S `3V3`, D `V_DRV` | Switches the opto LED supply |
| R25 | 100k 1% | 0603 | C25803 | `3V3` to `DRV_EN_N` | Keeps Q3 off while 3V3 ramps |
| R26 | 10k 1% | 0603 | C25804 | `V_DRV` to `GND` | Bleed |
| C21 | 100 nF 50 V X7R | 0603 | C14663 | `V_DRV` to `GND` |  |
| R92 | 4.7k 1% | 0603 | C23162 | `V_DRV` to `V_DRV_RB` | Read-back of the LED supply to GPIO42. Taken behind Q3, so that a shorted Q3 shows |

<!-- designsync:end -->

### 8.2 How it works

Firmware toggles `KA`, GPIO17. Each rising edge pushes charge through C22 and
D7 into the reservoir C23. R30 and R91 in parallel, 55 kohm, drain C23 all the time. They are two resistors so that one of them failing open doubles the hold-up and does not remove the bleed. Comparator U6A compares
the reservoir voltage with a reference and drives `KA_OK` high when the
reservoir is charged.

`KA_OK` goes to U7, a 74HC132. It is the 74HC00 of the first draft with
Schmitt-trigger inputs, in the same pinout: two of its inputs rise through
10 kohm pull-ups from open-collector comparators, more slowly than the
74HC00 data sheet allows. Two gates form the over-current latch of
section 9. The third makes `DRV_EN_N` = NAND(`KA_OK`, `FAULT_N`). The fourth
inverts it to `DRV_EN`. So drive is enabled when the keep-alive is running and
the latch is clear.

`DRV_EN` does three things, and any one of them alone turns the valves off.

| Path | Mechanism | Effect when `DRV_EN` is low |
|---|---|---|
| LED supply | `DRV_EN_N` high turns off Q3 | `V_DRV` falls. No opto LED can conduct, whatever the expander pins do. |
| Expander reset | `DRV_EN` is the TCA9539 RESET pin | Every expander pin becomes an input. The stored output bits are lost, so nothing comes back on when drive returns. Resistors hold every pin at a defined level meanwhile. |
| Relay, first transistor | The reset expander releases `RLY_ON`, the gate of Q1 | K1 opens within its 10 ms release time. |

All three hang on one signal. The relay's second transistor, Q2, does not:
it has the detector of section 7.3. Section 8.5 shows why that matters.

No ESP32 pin other than `KA` and the I2C bus can influence a valve. Turning one
on takes a running keep-alive and two valid I2C writes to address 0x74.

**Defined levels on the expander pins.** While the TCA9539 is in reset, which
is whenever no valve runs, every pin is an input. Review finding m10: the
data sheet specifies the supply current only for inputs at a rail. RN1, RN2
and R96 pull the nine valve pins up to `V_DRV`, 100 kohm each. They go to
`V_DRV` and not to `3V3` so that an off opto LED never sees a reverse
voltage: its limit is 3 V. With `V_DRV` off, R26 holds the pins at ground.
RN3 pulls the four spare pins down. `RLY_ON` already had R12, and the two
inputs their pull-ups. RN2 is fitted on the 4-zone build as well, where P10
to P13 have nothing else on them.

### 8.3 Thresholds

The reference is 3.3 V x R35 / (R34 + R35) = 1.32 V. R31 and R32 add
hysteresis. The reservoir voltage `KA_N2` at which U6A switches is:

- **Turning on**, output low at 0.15 V: (1.32 - 0.15 x 100 / 610) x 610 / 510 = 1.55 V.
- **Turning off**, output high at 3.3 V through R36: (1.32 - 3.3 x 100 / 620) x 620 / 520 = 0.94 V.

U6 is an LM2901 on `V5`. Its input bias current, up to 500 nA, flows out of the
inputs. Through R31 in parallel with R32 that is a 42 mV error. C24 keeps the
comparator input below the reference while `3V3` ramps up, so `KA_OK` cannot
pulse at power-on. The simulation includes the ramp and the bias current.

### 8.4 Timing, from `hardware/sim/keepalive.cir` and `keepalive_faults.cir`

| Keep-alive signal | Result |
|---|---|
| 10 Hz square wave | Enabled 104 ms after the first edge. Disabled 0.59 s after the last. |
| 20 Hz | Enabled after 53 ms. Disabled after 0.65 s. |
| 100 Hz, the firmware's 5 ms toggle | Enabled after 14 ms. Disabled after 0.73 s. |
| 1 kHz | Enabled after 8 ms. Disabled after 0.74 s. |
| 100 Hz, then stuck high instead of low | Disabled after 1.09 s |
| 100 Hz, C23 30 % low | Disabled after 0.51 s |
| 1 kHz, C23 20 % high | Disabled after 0.88 s |
| 2 Hz for 2.4 s | Never enabled. Reservoir peaks at 1.41 V against the 1.55 V threshold. |
| One rising edge, then stuck high | Never enabled. Reservoir peaks at 1.00 V. |
| Stuck high from power-up | Never enabled |
| Stuck low from power-up | Never enabled |

The hold-up is longer when the pin stops high, because C22 then stays in
circuit and discharges with C23.

Review A1 added `hardware/sim/keepalive_faults.cir`. It runs more toggle
rates, tolerance and temperature corners, and every single component fault.
The fault results are in section 8.5. The rest:

| Question | Result |
|---|---|
| Slowest rate that enables | 1 Hz never did. 2 Hz does not with nominal parts but does with C23 30 % low, C22 20 % high and -15 mV of comparator offset. 3 Hz and faster always did. |
| Fastest rate that enables | No limit found. 50 kHz enables after 9 ms and 1 MHz after 28 ms. |
| Duty cycle | 2 % and 98 % at 100 Hz both enable, after about 0.1 s. |
| Hold-up, pin stops low, -20 to 60 °C with tolerances | 0.46 to 0.78 s |
| Hold-up, pin stops high, longest | 1.17 s |
| Hold-up at 85 °C | 0.43 s with nominal parts, 0.30 s at the short corner. Schottky leakage adds to the bleed. The leakage model is generic. |
| Hold-up with R30 or R91 open | 1.74 s at 27 °C, 1.35 s at 60 °C |
| Time to enable at 100 Hz | 14 ms nominal, 41 ms at the slow corner |
| Time to enable at 25 Hz | 43 ms nominal, 0.16 s at the slow corner |
| Time to enable at 10 Hz | 0.10 s nominal, 0.50 s at the slow corner, where the reservoir clears the threshold by 11 % only |
| `3V3` ramps over 0.1 s or 1 s | `KA_OK` stays low with the pin low. With the pin tied to the rail it follows the rail to 0.95 V and falls again, below the voltage at which U7 or the expander work. |

All figures are for the bleed of two 110 kohm resistors, 55 kohm, that
replaced the single 56 kohm of the first draft. They moved by 2 % or less.
Both tables are from the two files as merged, with the pull-down R33 at
10 kohm. With 2.2 kohm most figures move by about 1 %; `hardware/sim/README.md`
has the comparison.

**Review A2, corner runs.** `hardware/sim/failsafe/` runs both detectors
together over tolerance, -20 to 70 °C, `3V3` from 3.0 to 3.6 V and five
keep-alive waveforms: review section 4. For this detector, with the
firmware's 5 ms edges:

| Question | Result over every corner |
|---|---|
| `V_DRV` on after the first edge | 13 to 22 ms |
| Gate drive removed after the last edge, pin low or high-impedance | 0.21 to 0.83 s |
| The same, pin stops high | 1.25 s at most |
| Reservoir while toggling, any waveform | 1.82 V at least, against 0.94 V to release |
| A steady level, one edge, one pulse | Never enables. One edge charges the reservoir to 1.64 V at most, at a corner where the turn-on threshold is about 1.7 V. |
| Slow toggling | 1 Hz enables in 2 of 24 corners, 2 Hz in 9, 3 Hz in 12, 5 Hz in 13. The row "slowest rate that enables" above is too firm in both directions. |

The short corner is C23 at 7 uF, C22 at 3.3 uF, the bleed 1 % low, `3V3` at 3.2 V
and +15 mV of comparator offset. The slow corner is C23 at 12 uF, C22 at
3.3 uF, a high level of 2.9 V on the pin, +15 mV of offset and -20 °C.

**Specification for firmware.**

- **Accepted**: an edge at least every 20 ms, and no phase shorter than 2.5 ms. The firmware's 5 ms is the design point. 10 Hz works with nominal parts and has too little margin at the slow corner to rely on. The lower limit on a phase is for the relay detector, section 7.3.
- **No upper limit**: the detector is a rectifier, not a window. A square wave at 50 kHz or 1 MHz enables drive as well as 100 Hz does. An earlier version of this section gave 5 kHz as a limit. That was an estimate and it was wrong.
- **Hold-up**: drive is removed 0.21 to 0.83 s after the last edge if the pin stops low, and at most 1.25 s if it stops high. These are the corners of review A2. The first version of this line had 0.45 to 0.9 s and 1.2 s.
- **Not accepted**: a steady level, high or low. Slow toggling is not reliably rejected. From 1 Hz up the result depends on part tolerances. Treat only a steady level as guaranteed off.
- **Source**: code that decides every edge from evidence that the control loop is running. Never an output that a peripheral generates by itself: LEDC, RMT, MCPWM or a timer with a pin output keep toggling when the firmware hangs, and the circuit cannot tell the difference. Section 19.4 has the contract agreed with the firmware.

The firmware team asked about the flash sector-erase time, during which both
cores stall. Espressif does not name the flash part. The module data sheet
v1.8 says only that the flash runs at 80 MHz and does not support
auto-suspend. The Winbond W25Q128JV, one 16 MB part of the kind fitted, gives
45 ms typical and 400 ms maximum for a 4 kB sector erase, and 150 ms typical
and 2 s maximum for a 64 kB block erase. Section 19.4 says what that means for
the firmware's heartbeat timeout.
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
