syntroniks/zoneflow/docs/design/hardware-layout.md

# ZoneFlow revision A: PCB layout

!!! warning "No board has been made"
    This layout exists as files. Nothing in it has been fabricated, soldered,
    powered or measured. Where this page says a rule "holds" or a check
    "passes", a program compared numbers in a file, and section 1 names the
    program. Section 13 lists what I think is weak, and section 14 what a
    person must look at before anyone orders a board.

!!! note "Changed by the layout review"
    The [independent review](hardware-layout-review.md) changed this board
    and routed it again. This page describes the board after the review.
    The reviewer rewrote sections 1, 2, 6, 7.14 to 7.16, 8, 10, 12 and 15 and
    corrected numbers elsewhere. Sections 13 and 14 are the author's lists as
    written before the review; a note on each item says what became of it.

The board is `hardware/zoneflow-a/`. It is generated from text: the placement,
every hand-routed track and every zone are written by
`design/layout.py` into `design/board.toml`, and
[the toolchain](hardware-toolchain.md) builds the KiCad board from that. Run
`make` in the board directory to rebuild everything on this page.

Coordinates on this page are those of the
[mechanical contract](mechanical.md), `hardware/mechanical.yaml`: origin at the
bottom-left corner of the board seen from the component side, x along the
terminal edge, y up towards the antenna. Lengths are in millimetres.

Top side render

Top copper and silkscreen:
[front](../hardware/zoneflow-a/zoneflow-a-front.svg),
[back](../hardware/zoneflow-a/zoneflow-a-back.svg),
[In1.Cu](../hardware/zoneflow-a/zoneflow-a-In1.Cu.svg),
[In2.Cu](../hardware/zoneflow-a/zoneflow-a-In2.Cu.svg),
[all layers as a PDF](../hardware/zoneflow-a/zoneflow-a-board.pdf),
[bottom render](../hardware/zoneflow-a/zoneflow-a-bottom.png),
[interactive BOM](../hardware/zoneflow-a/zoneflow-a-ibom.html).

## 1. What was checked, and the result

`make` runs these in order and stops at the first that fails.

| Check | Program | Result |
|---|---|---|
| Schematic against the design netlist, pin for pin | `hwflow sch` | 348 components and 198 nets match pin for pin; the fitted parts of both builds match |
| Electrical rules of the schematic | `kicad-cli sch erc` | No error, no warning |
| Design rules of the board, with the zones filled again, errors and warnings | `kicad-cli pcb drc` | No error, no warning |
| Board against schematic: every footprint, every pad's net | `kicad-cli pcb drc --schematic-parity` | No difference |
| Connections not routed | the same DRC run | None |
| Mechanical contract, revision 3 | `hwflow mech` | Agrees: outline, 4 holes, 26 placed parts, height zones for 289 parts, keep-outs, bottom side, edge, soldering access |
| Layout rules of the fail-safe analysis | `hwflow.layoutrules` | Hold: 276 keep-away distances, one spacing, one angle, one pad ban |
| Placement files against JLCPCB's library footprints, on demand | `make cpl-check` | 307 and 262 placements, none misfits |

Two settings shape the DRC result, and a reviewer should know them:

- **One check is switched off: `lib_footprint_mismatch`.** The builder takes
  59 strokes off footprint silkscreen outlines where they lay over
  a neighbour's pad (section 11). KiCad then reports each such footprint as
  different from its library copy. Nothing else in a footprint can differ: the
  board is built from the libraries on every run. This is the only check
  switched off, and no single violation is excluded.
- **Four rules are added** in `design/rules.kicad_dru`: no track of another
  net within 1 mm of a keep-alive track; the pads of the high-impedance nodes
  keep the usual pad clearance while their tracks keep 0.6 mm; the two pads
  of the solder jumper JP1 may be 0.3 mm apart, which is how a jumper is
  made; and the fab limits of `hardware/rules/jlcpcb.kicad_dru`, with no
  hole under 0.3 mm among them.
- **A clearance that KiCad's footprint for U1 carried is removed.** It was
  0.2 mm and outranked the 0.4 mm of the net class. The builder prints the
  footprint when it does that.

DRC is run on the board as `pcbbuild finish` leaves it: the stored autorouter
session, then three changes that section 10 describes (tracks widened to their
class width, four pieces of autorouted copper taken out, seventeen connections
closed by a second, small router and by hand). The autorouter's own numbers
are there too.

The reports of this build are in `hardware/zoneflow-a/output/reports/`:
`drc.rpt`, `erc.rpt`, `layout-rules.md`, `routing.md`, `placement-check.md`.

## 2. Stack-up and what the fab must be told

Four copper layers, 1.6 mm, JLCPCB's standard FR-4 build with 1 oz outer and
0.5 oz inner copper. **No special option is needed.** The fab limits used as
DRC minimums are in `hardware/rules/jlcpcb.toml`, with the page they were read
from.

| Layer | Use |
|---|---|
| F.Cu | Every part except C1 and K1. Signals. The 24 VAC entry. Ground pour in what is left |
| In1.Cu | Ground, one plane. No track is on it, and the build fails if one is |
| In2.Cu | 3.3 V, one plane over the logic area. The autorouter may not use the layer, and the build fails if an autorouted track is on it. Eleven patched connections pass under an obstacle there, 114 mm in all (section 10). Under the triacs: the shunt return plane. A copy of the valve fan-out. The nine opto-output lines, by hand |
| B.Cu | The valve fan-out. Nine heat islands under the triacs. The valve-common run. The pairs and buses of section 7. The USB supply. Autorouted signals. Ground pour in what is left. C1 and K1 |

An earlier state of this layout had the valve fan-out on In2.Cu only and
needed 1 oz inner copper to survive a shorted output with the over-current
latch failed. That is gone: the fan-out is on B.Cu now (section 7.3), and the
calculation in section 6 holds with the default stack-up.

The smallest hole is 0.3 mm. KiCad's stock module footprint has twelve
0.2 mm vias in its ground pad; `design/footprints.py` drills them 0.3 mm in
0.7 mm lands, because JLCPCB charges for a smaller hole
([review](hardware-layout-review.md), finding L9). DRC fails on any hole
under 0.3 mm. The narrowest track is 0.10 mm, for 0.4 mm of `ZD_Z5_N` where
the autorouter left a pin; three more pieces of 0.2 mm each are 0.12, 0.15
and 0.19 mm wide (section 10). The rules file records 0.10 mm as the fab's
limit.

## 3. Floor plan

| Region | What is there | Why there |
|---|---|---|
| y 0 to 7.5 | USB-C, the four terminal headers, Qwiic | Fixed by the contract |
| y 7.6 to 8.9 | Nothing but the terminal labels | Kept free of pads so that every terminal has its name behind it |
| x 8 to 34, y 7.5 to 18 | The two fuse holders | Fixed. Nothing else is allowed in the fuse well |
| x 9 to 33, y 18 to 40 | Surge clamp, rectifier, surge resistor, fuse F5, buck converter, clamp D25 | Between the fuses and the pads of C1 |
| x 33 to 39, y 9 to 39 | Valve-common TVS, shunt, input monitor divider | Beside the first triac column, between the fuse in the return leg and the shunt plane |
| x 39 to 103, y 9 to 40 | Nine output columns, 7.1 mm apart | Above the output terminals. Each column, from the terminal up: TVS and snubber, PTC, triac, gate resistors |
| x 103 to 113, y 5 to 57 | Qwiic ESD and PTC, sensor TVS and series resistors, the flow input clamp | The field side of the sensor inputs stays at the board edge |
| y 39.3 to 44.7 | The LED row, with the two resistors of each LED | Fixed. Only parts under 1 mm are allowed under the light pipes |
| x 21 to 107, y 45 to 57 | Nine opto-triacs, each above its LED | The contract's LED pitch, 9.5 mm, is also the smallest pitch the opto-triac body allows |
| x 1 to 21, y 45 to 57 | 5 V OR-ing diodes, 3.3 V regulator | Next to the buck output and the USB supply |
| x 28 to 42, y 57 to 68 | Current-sense amplifier and the ADC series resistors | Between the two buttons, away from the buck |
| x 55 to 79, y 57 to 67 | Sensor supply switch and its protection | |
| x 1 to 57, y 68 to 110, under the display | Expander, fail-safe gate, relay driver and keep-alive detector B, display support, reset and boot buttons | All under 5 mm. Half of this area is empty and carries the board name |
| x 58 to 79, y 68 to 77 | Real-time clock | Next to the positive contact of the cell holder |
| x 79 to 113, y 57 to 74 | Coin cell holder | The only place that is not under the display carrier and takes a 32 x 16 mm part |
| x 93 to 113, y 74 to 90 | Keep-alive detector A, the comparators, the ADC filter capacitors | Under the module. The keep-alive enters at the corner next to module pin 10 |
| x 79 to 93, y 102 to 109 | Module support: 3.3 V decoupling, reset network, supervisor, encoder switch pull-up | The only free ground beside the module |
| Bottom, x 1 to 9, y 17 to 38 | K1 | See section 4 |
| Bottom, x 10 to 37, y 23 to 37 | C1 | Fixed |

The triac columns and the opto-triacs are on different pitches, 7.1 and
9.5 mm. A column cannot be 9.5 mm wide: nine of them would not fit between the
C1 pads and the right edge. An opto-triac cannot be on 7.1 mm: its body is up
to 8.89 mm long. So each gate line and opto-output line steps sideways between
its column and its opto-triac, by up to 17 mm, in the strip under the LED row.

## 4. Changes to the mechanical contract

The layout changed four things, and the contract is at revision 3 with them.
The enclosure was rebuilt against revision 3 and its interference check
passes: 59 of 59 pairs of solids are clear of each other.

| Part | Revision 2 | Revision 3 | Why |
|---|---|---|---|
| K1 | Suggested at (50, 22), bottom side | (4.8, 27.85), bottom side, long axis along y | At (50, 22) its four pins come up between the output triacs, where the top side has no room for them |
| C1 | Can 21.5 long | Rubycon 63ZLJ470M12.5X20, can 22.0 long at most. Pads unchanged | The hardware design changed the part (section 4.5) |
| BT1 | (95.0, 64.0) | (95.0, 65.3), positive contact at the left | 1.3 mm up, to clear the opto-triac row |
| J6 | y = 1.625 | y = 2.63 | Its two mounting lands were 0.7 mm beyond the board edge |

## 5. Net classes

`design/circuit.py` assigns nets to classes by voltage domain;
`design/board.toml` gives each class its numbers.

| Class | Nets | Track | Clearance | Via |
|---|---|---|---|---|
| AC24 | 24 VAC in, both legs; the valve common; the nine outputs; the nine triac tabs; the rectifier output | 1.0 | 0.5 | 1.0 / 0.5 |
| AC24S | Gates, opto outputs, snubber mid-points: at 24 VAC potential, milliamps | 0.3 | 0.5 | 0.6 / 0.3 |
| Shunt | `ISNS`, the common return of the triacs, within 3 V of ground | 1.0 | 0.25 | 1.0 / 0.5 |
| HVDC | Rectified input before and behind F5 (up to 45 V), buck switch and bootstrap nodes | 0.5 | 0.4 | 0.8 / 0.4 |
| Field | Sensor terminals, sensor supply output | 0.4 | 0.5 | 0.8 / 0.4 |
| Power | Supply rails, relay coil | 0.4 | 0.2 | 0.8 / 0.4 |
| USB | D+ and D- | 0.25 | 0.2 | 0.6 / 0.3 |
| HiZ | The nodes where a leak holds a keep-alive detector on: `KA_N1`, `KA_N2`, `KA_INP`, `RLY_G2`, `KB_N1` | 0.25 | 0.6 | 0.6 / 0.3 |
| Default | Everything else | 0.2 | 0.2 | 0.6 / 0.3 |

The 0.5 mm around the 24 VAC and field nets is a design choice, not a number
from a standard. The supply is a Class 2 transformer, 45 V peak at most, and
the surge parts clamp at 77 V. I did not look up a creepage table.

## 6. Current and the width of the tracks that carry it

**Steady current.** The formula is the IPC-2221 chart fit as it is usually
quoted, I = k x dT^0.44 x A^0.725, with I in amperes, dT the rise in kelvin, A
the cross-section in square mils, k = 0.048 for an outer layer and 0.024 for an
inner one. I did not re-read the standard; the formula is from memory and is
conservative for a board with planes. 1 oz copper is 35 um, 1.378 mil.

| Track | Where | Cross-section | Current for 10 K | At the working current |
|---|---|---|---|---|
| 2.0 mm, outer | 24 VAC entry, valve common, return to the fuse | 108.5 mil² | 3.95 A | 3 A, the fuse rating: 5.3 K. 1.5 A, two zones and the master valve: 1.1 K |
| 1.0 mm, outer | Rectifier feed, `VIN_DC` | 54.3 mil² | 2.39 A | Below 0.5 A average |
| 1.2 mm, outer | Fan-out vias to the PTC | 65.1 mil² | 2.73 A | 0.5 A: 0.2 K |
| 0.9 mm, outer | One valve output on B.Cu, without its copy on In2.Cu | 48.8 mil² | 2.22 A | 0.5 A, one valve: 0.3 K. 1.1 A, the PTC hold current: 2.0 K |

Working: 2.0 mm is 78.74 mil, times 1.378 is 108.5 mil²; 108.5^0.725 = 29.9;
0.048 x 10^0.44 x 29.9 = 0.048 x 2.754 x 29.9 = 3.95 A. For another current
the rise is 10 x (I / I10)^(1 / 0.44).

**A short circuit.** The hardware design, section 6.6, gives the energy the
output path must pass: 9.6 A²s when the triac or the relay ends the fault
within two half-cycles, and up to 34 A²s if neither does and the PTC has to.
The rise of a conductor with no time to lose heat is
dT = I²t x rho / (A² x c), with rho = 1.72e-8 ohm m and c = 3.45e6 J/(m³ K)
for copper.

| Conductor | Cross-section | 9.6 A²s | 34 A²s |
|---|---|---|---|
| 2.0 mm outer track | 0.070 mm² | 10 K | 35 K |
| 1.2 mm outer link, vias to PTC and TVS to PTC | 0.042 mm² | 27 K | 96 K |
| 0.9 mm fan-out lane on B.Cu, 35 um, alone | 0.0315 mm² | 48 K | 171 K |
| The same with its copy on In2.Cu, 17.5 um | 0.0473 mm² | 21 K | 76 K |
| Four output vias, 0.3 mm drill, 18 um plating | 4 x 0.0180 mm² | 9 K | 33 K |
| Two such vias, as the layout had before its review | 2 x 0.0180 mm² | 37 K | 131 K |
| Three A1 vias, one 0.3 mm and two 0.4 mm drill, 18 um | 0.065 mm² | 11 K | 40 K |

Working for the lane with its copy: 0.9 mm x (0.035 + 0.0175) mm = 4.725e-8 m²;
34 x 1.72e-8 / ((4.725e-8)² x 3.45e6) = 5.85e-7 / 7.70e-9 = 76 K.
A via barrel is pi x (hole + plating) x plating: pi x 0.318 x 0.018 =
0.0180 mm² for a 0.3 mm hole. The 18 um is the "Average Hole Plating
Thickness" of JLCPCB's capabilities page, read 2026-11-11. It is an average
and not a promised minimum.

What this says:

- **The worst case no longer depends on the inner copper.** A short with the
  over-current latch failed takes a fan-out lane from 70 °C to about 146 °C
  with both layers carrying, and to about 241 °C if the copy on In2.Cu carried
  nothing. Both are for a fraction of a second and below soldering
  temperature. The copy is margin, not a requirement.
- **The vias are no longer the weakest part of the path.** The layout had
  two 0.3 mm vias per output, and with 18 um of plating they heated by 131 K
  in the worst case. The review made them four, in a row 0.8 mm apart at the
  end of the lane, and added a third via at each A1 lead. The lane is the
  hottest piece again.
- Two conductors in parallel share a current by their cross-sections only if
  they are equally long. The lane and its copy are the same shape, joined at
  the terminal pin and at the two vias.

**The supply rails.** The review routed these by hand on the outer layers
(section 7.14). The currents are the peak column of the rail budget, hardware
design section 4.2.

| Path | Copper | Peak current | Rise | Drop |
|---|---|---|---|---|
| `V_BUCK`, clamp D25 to the OR-ing diode D3: the whole board except the relay coil | F.Cu, 9.1 mm at 0.8 mm and 6.5 mm at 0.55 mm | 0.73 A | 1.8 K in the narrow piece | 11 milliohm, 8 mV |
| `V5`, D3 to the regulator U3: the whole 3.3 V load | F.Cu, 6.8 mm at 0.8 mm and 9.9 mm at 0.7 mm | 0.50 A | 0.5 K | 11 milliohm, 6 mV |
| `VBUS`, USB connector to the OR-ing diode D4 | B.Cu, 42 mm at 0.7 mm, two vias at each end | 0.58 A if the board runs from USB alone with every consumer at its limit; 0.22 A typical | 0.7 K at the peak | 30 milliohm, 17 mV |
| `V_BUCK` to the sensor supply switch U11 | B.Cu, 61 mm at 0.5 mm | 0.16 A, the highest limit of U11 | 0.2 K | 68 milliohm, 11 mV |

Working for the narrow piece of the first row: 0.55 mm is 21.65 mil, times
1.378 is 29.8 mil²; 29.8^0.725 = 11.7; 0.048 x 2.754 x 11.7 = 1.55 A for
10 K; at 0.733 A, 10 x (0.733 / 1.55)^(1 / 0.44) = 1.8 K. The 0.55 mm is
where `V_BUCK` and `V5` pass side by side through the 2.1 mm between the
anode pad of D4 and the pins of U3.

## 7. What is routed by hand

Everything in this section is written out in `design/layout.py` as tracks,
vias and zones, laid before the autorouter runs and locked. These nets are
taken out of the autorouter's netlist (`[route] exclude`), so it can neither
add to them nor move them. They are 104 of the 198 nets.

### 7.1 24 VAC entry

| From | To | Layer | Width |
|---|---|---|---|
| J1 pin 1 | F4 | F.Cu | 2.0 |
| J1 pin 2 | F1 | F.Cu | 2.0 |
| F4 (`AC_L`) | Surge clamp D1 | F.Cu | 2.0 |
| F4 | Rectifier D2 | F.Cu | 1.0 |
| D1 | Relay contact, K1 pin 13 | F.Cu | 2.0 |
| K1 pin 14 (`COM`) | J2 pins 1 and 2 | B.Cu, under the fuse well | 2.0 |
| J2 pin 2 | Valve-common TVS D23 | F.Cu | 1.5 |
| F1 (ground side) | D23 and the shunt R37 | F.Cu | 2.0 |

The stubs to the solder jumper JP1 are 0.5 mm wide, because its two pads are
0.3 mm apart and a wider track would come closer to the other net than the
pads are. JP1 is bridged only on a board built without K1.

### 7.2 One output column

Nine identical columns, written once as a group. From the terminal upward:

- **Output net.** From the four vias at the end of the fan-out lane (7.3),
  0.3 mm drill in a row 0.8 mm apart, a 1.2 mm track on F.Cu into the lower
  PTC pad. A second 1.2 mm link joins the TVS and the
  PTC.
- **T2.** A 5 mm wide link from the upper PTC pad to the triac tab. Two vias,
  0.5 mm drill, beside the PTC pad and four, 0.3 mm drill, in the tab land
  take it to the island on B.Cu. **The four vias are in the land and are not
  plugged**; some solder will run into them. A 0.3 mm track on F.Cu, in the
  gap between this PTC and the next, takes T2 down to the snubber resistor.
- **Island.** One zone per triac on B.Cu, 6.6 x 23.1 mm, 1.52 cm². With the
  tab land, the PTC land and the link on F.Cu, 0.52 cm², each tab has
  2.04 cm². The hardware design, section 6.7, asks for 2 cm² or more. The
  islands were 2.0 cm² on the bottom alone before the fan-out moved to B.Cu
  and took the strip below them.
- **A1.** Three vias beside the A1 lead, one 0.3 mm and two 0.4 mm drill,
  into the shunt plane on In2.Cu. A 0.6 mm track to the gate resistor.
- **Gate.** 0.3 mm, from the gate lead under the two resistors to its via.

### 7.3 Valve fan-out

The nine output pins are within 32 mm of each other; the nine columns span
64 mm. Each output therefore runs sideways by 6 to 31 mm before it reaches
its column.

- On **B.Cu**, between the terminal row and the heat islands: 0.9 mm tracks,
  0.5 mm apart, the full 24 VAC clearance. An output enters on the lowest free
  lane and steps up one lane whenever an earlier output has turned up to its
  column, so no two cross. `layout.py` computes the lanes and checks that no
  two centre lines come closer than 1.4 mm; DRC checks the result again.
- The **same tracks again on In2.Cu**. The through-hole terminal pin and the
  four vias under the column join the two.
- Five lanes carry eight of the nine. The last output, zone 8, starts on a
  sixth lane level with the terminal pins, for the 5 mm right of its own pin
  where no other pin is, and steps up before the next terminal block begins.
  `layout.py` fails if that lane is used anywhere else.

### 7.4 Shunt return

`ISNS` is a plane on In2.Cu under all nine triacs, 68.7 x 21.5 mm. The valve
current goes from each A1 lead down three vias, through the plane, and up two
vias, 0.5 mm drill, at the shunt R37. A plane this wide does not depend on
its copper weight. A separate strip on F.Cu, 1.0 mm, joins the ground-side
pads of every TVS and snubber capacitor and reaches R37 by a 0.5 mm track; it
carries surge and snubber current only. The `ISNS` test pad is at the far end
of that strip.

### 7.5 Kelvin sense of the shunt

The hardware design, section 10.2, wants the amplifier to sense R37 at its
pads, with a ground sense that is its own trace and not the plane.

- Each sense track starts at its own via at the left end of a pad of R37.
- Both run on B.Cu, 0.6 mm apart: left under C1, up at x = 18.4 and 19.0, right
  at y = 58 to the amplifier. About 105 mm each. They take this way round
  because the direct way crosses the gate lines.
- A rule area keeps the ground pour on B.Cu away from both tracks along their
  whole length, and one on F.Cu does the same at the amplifier.
- The ground sense via at the amplifier end passes through the ground plane on
  In1.Cu. A rule area there keeps the plane off it. So the ground sense meets
  ground at one place only, the via at the shunt pad.
- R40 and R44, the two resistors on the ground sense, get no plane via.
- **The pair passes under the buck converter**: on B.Cu, between the board
  and the can of C1, with the pins of U1 and the switch node 1.6 mm above on
  F.Cu and the ground plane between them. It is a pair into a difference
  amplifier, and I did not estimate what couples into it. The review did:
  about 0.2 mV at the switching frequency before two filters
  ([review](hardware-layout-review.md), section 8).
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
