syntroniks/zoneflow/docs/design/hardware-toolchain.md

# Hardware toolchain

Status: **proven on a 40-part test board, 2026-11-10**, and used for the
schematic and the layout of the revision A board (sections 12 and 13). That
board had 346 components when it was captured, 348 after hardware review A2,
353 after the hardware answers A2, and has 348 since the debounce of its
push contacts moved into firmware.
Nothing here has been built as hardware. Every result below names the command
that produced it.

This document describes how ZoneFlow hardware goes from text to a KiCad 10
project and fabrication files with no GUI, and how to design the real board
with it. The test board is in `hardware/toolchain-test/`. It is not the
ZoneFlow design and its part choices must not be reused.

## 1. Summary

- **Source of truth.** Two text files per board. `design/circuit.py` holds the
  circuit as Python. `design/board.toml` holds the outline, placement, net
  classes, pours and pre-routed tracks. On the revision A board a program,
  `design/layout.py`, writes `board.toml` (section 13.1).
- **Generator.** `tools/hwflow`, a Python package in this repository. Its one
  third-party runtime dependency is PyYAML, to read the design netlist. It
  writes `.kicad_sch` files directly.
- **Everything after that is KiCad.** `kicad-cli` extracts the netlist, runs
  ERC and DRC, fills zones and exports the outputs. KiCad's `pcbnew` Python
  module builds the board. Freerouting 2.5.0 routes it.
- **One command.** `make` in the board directory. It stops with a non-zero
  exit code on any ERC or DRC error or warning.
- **Result on the test board.** ERC 0 violations. DRC 0 violations, 0
  unconnected items, 0 schematic parity issues. Freerouting routed 43 of 43
  connections in 11.5 s.
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
