syntroniks/zoneflow/docs/assets/enclosure/render-board.png

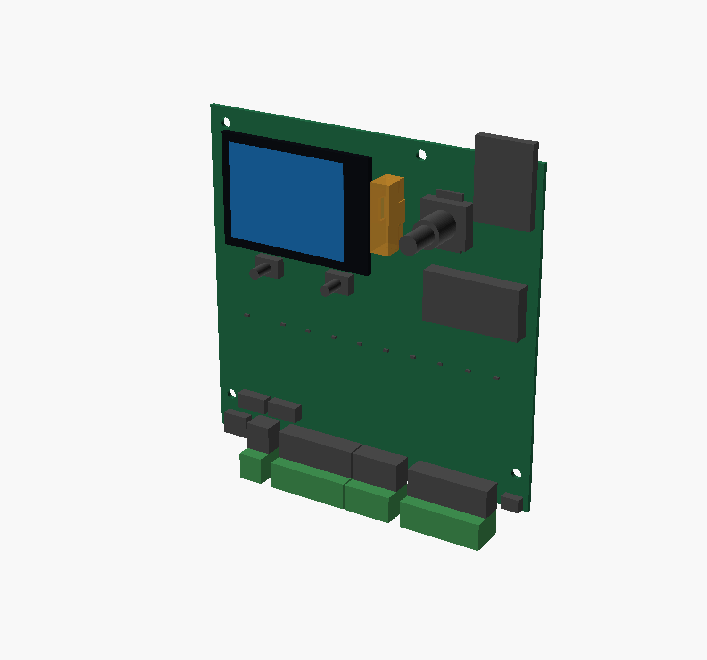
docs/assets/enclosure/render-board.png
