syntroniks/zoneflow/docs/assets/enclosure/render-rear-top.png

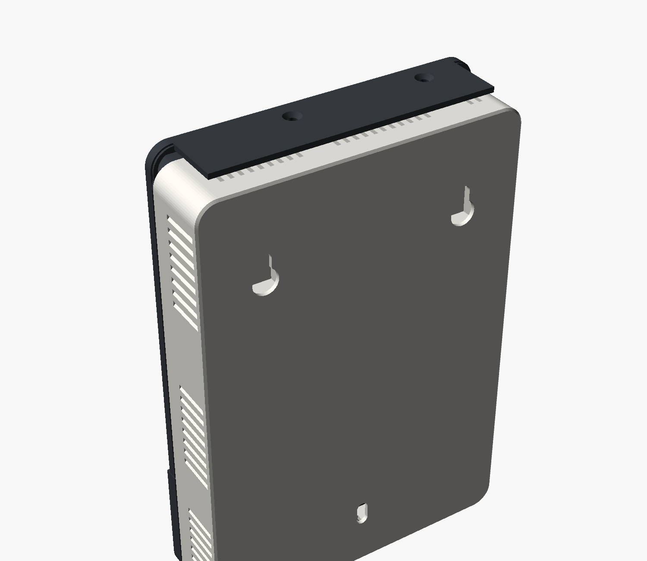
docs/assets/enclosure/render-rear-top.png
