syntroniks/zoneflow/docs/assets/enclosure/render-section-side.png

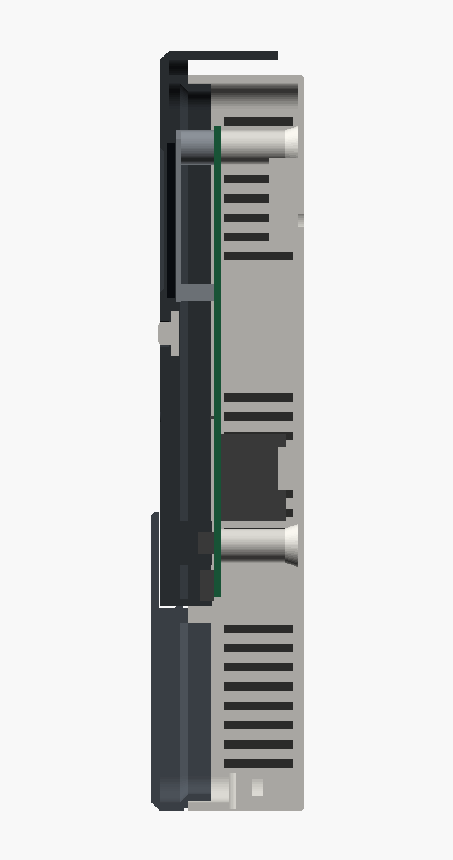
docs/assets/enclosure/render-section-side.png
