syntroniks/zoneflow/docs/assets/enclosure/render-three-quarter.png

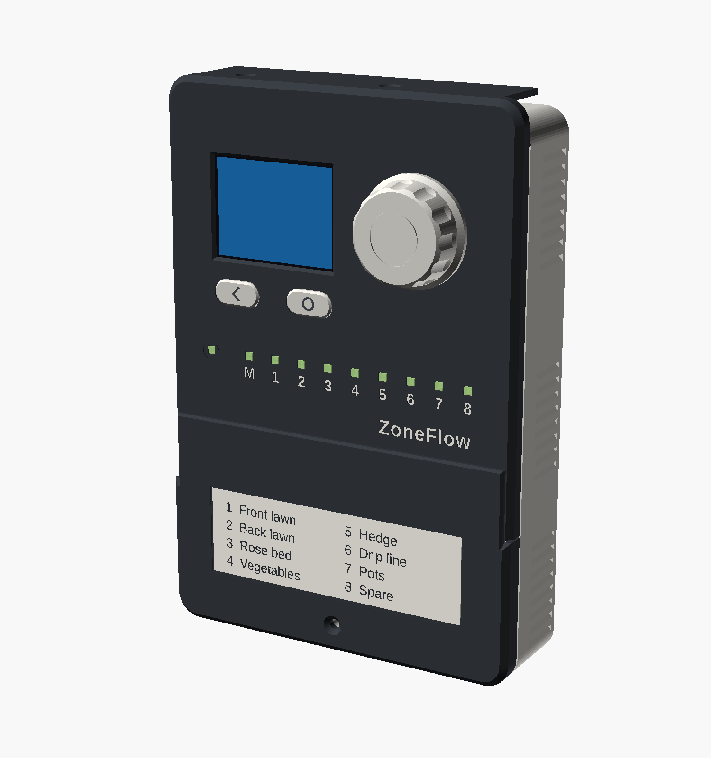
docs/assets/enclosure/render-three-quarter.png
