syntroniks/zoneflow/docs/design/display-ui/about.png

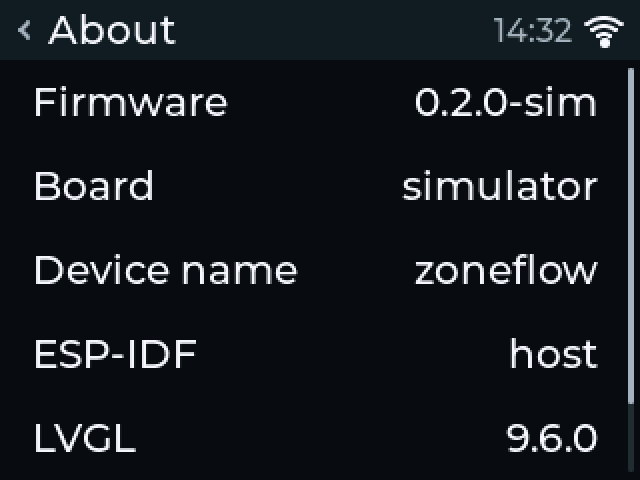
docs/design/display-ui/about.png
