syntroniks/zoneflow/docs/design/display-ui/faults-none.png

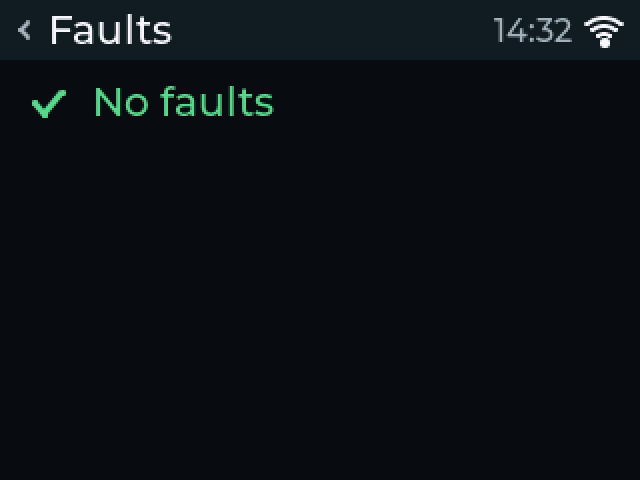
docs/design/display-ui/faults-none.png
