syntroniks/zoneflow/docs/design/display-ui/home-stopped-toast.png

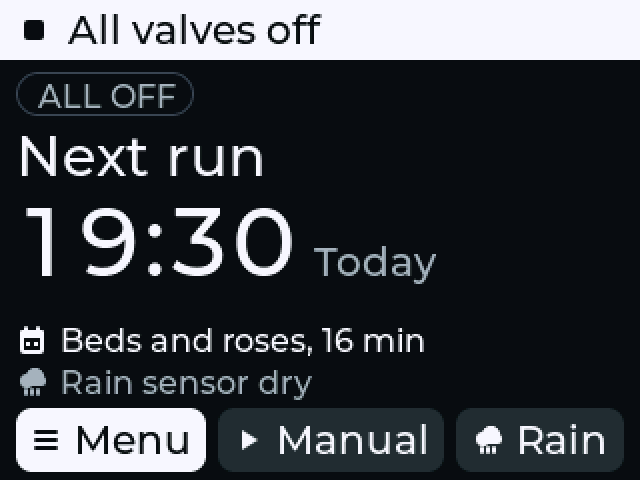
docs/design/display-ui/home-stopped-toast.png
