syntroniks/zoneflow/docs/design/display-ui/menu-end.png

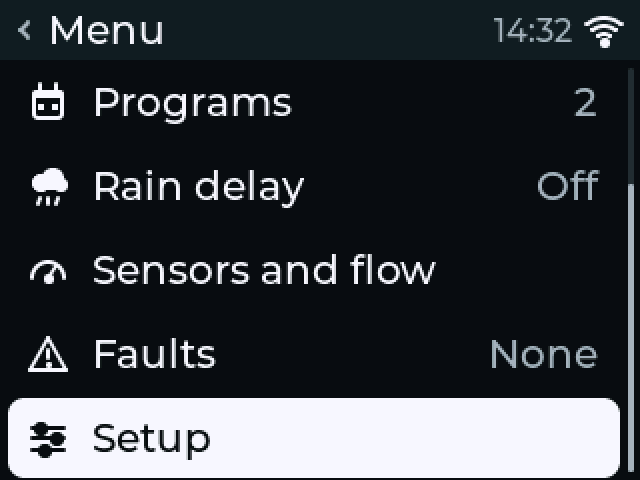
docs/design/display-ui/menu-end.png
