syntroniks/zoneflow/docs/design/display-ui/menu.png

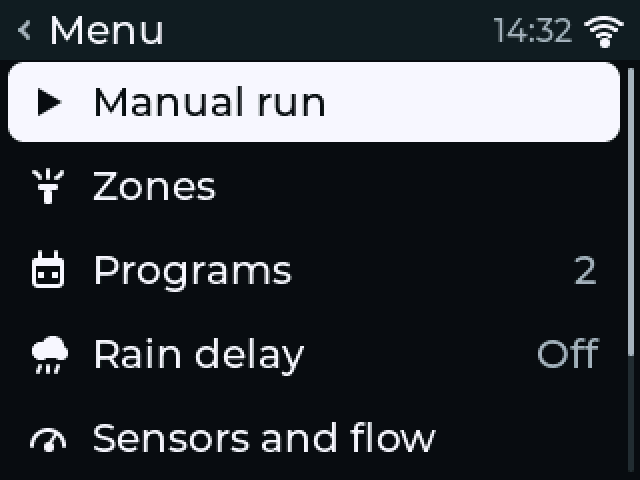
docs/design/display-ui/menu.png
