syntroniks/zoneflow/docs/design/display-ui/network-not-set-up.png

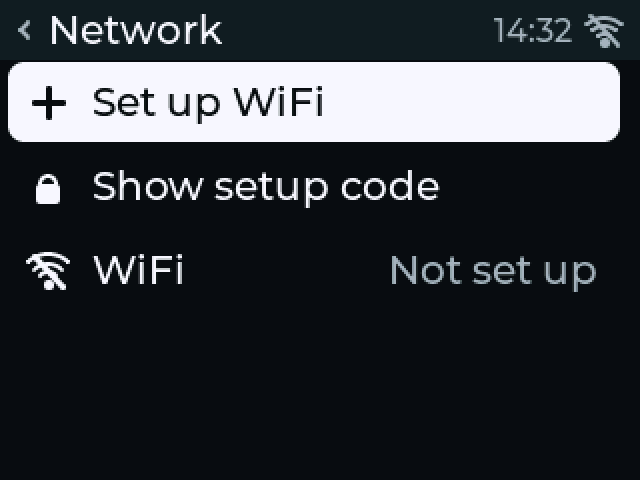
docs/design/display-ui/network-not-set-up.png
