syntroniks/zoneflow/docs/design/display-ui/picker-brightness.png

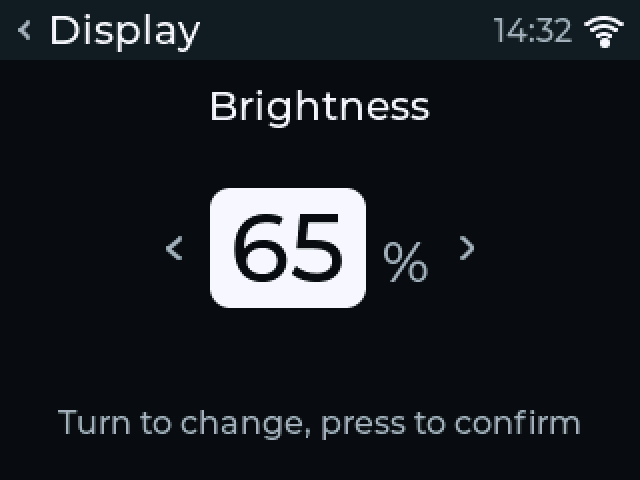
docs/design/display-ui/picker-brightness.png
