syntroniks/zoneflow/docs/design/display-ui/picker-date.png

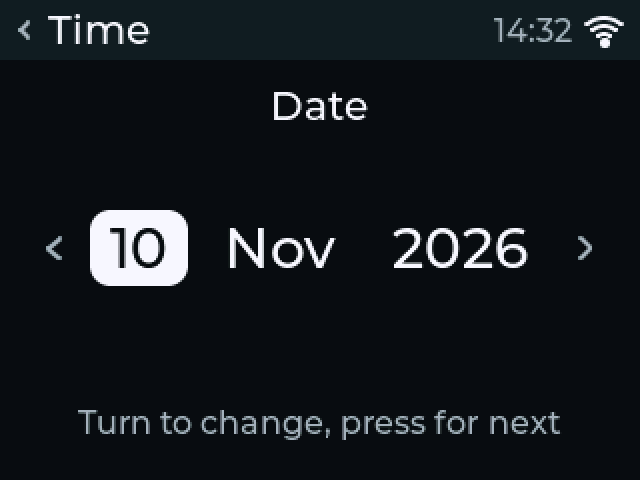
docs/design/display-ui/picker-date.png
