syntroniks/zoneflow/docs/design/display-ui/program-edit-days.png

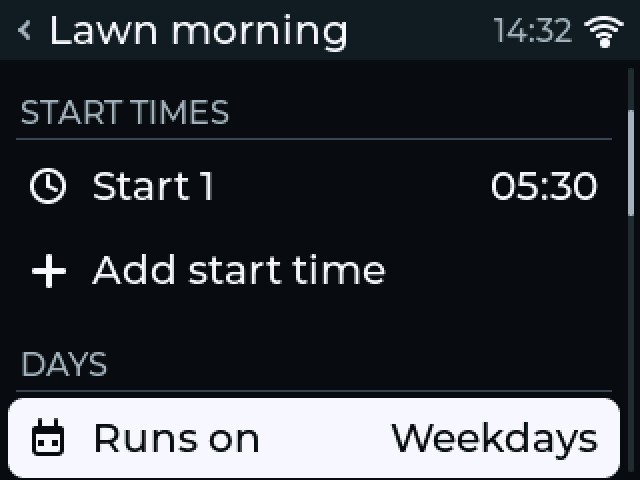
docs/design/display-ui/program-edit-days.png
