syntroniks/zoneflow/docs/design/display-ui/program-edit-options.png

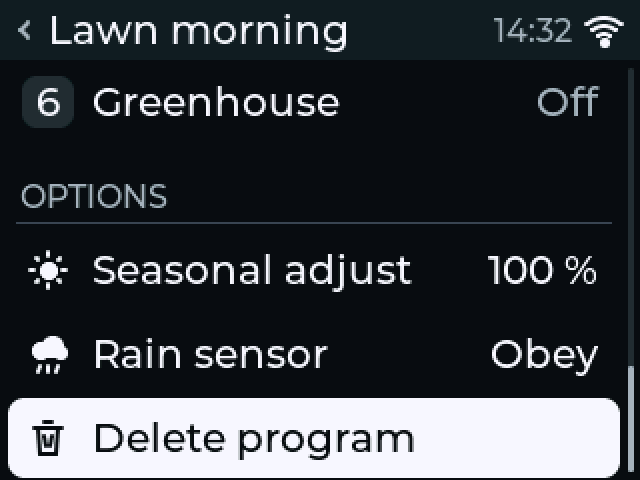
docs/design/display-ui/program-edit-options.png
