syntroniks/zoneflow/docs/design/display-ui/programs-saved.png

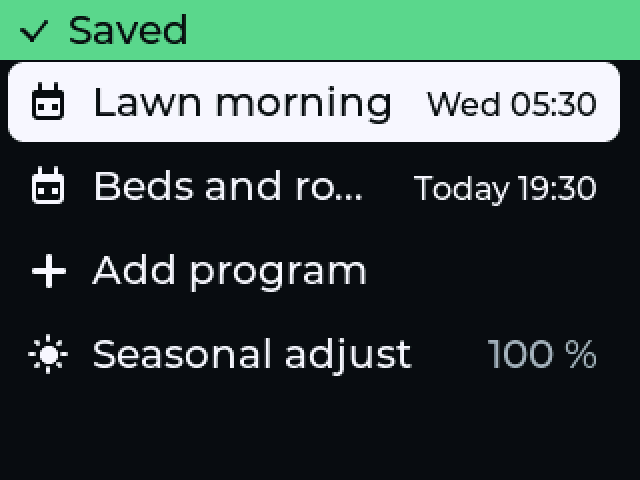
docs/design/display-ui/programs-saved.png
