syntroniks/zoneflow/docs/design/display-ui/sensors-end.png

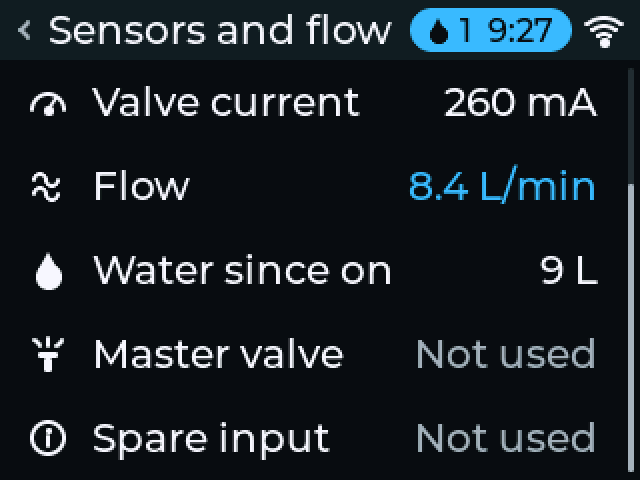
docs/design/display-ui/sensors-end.png
