syntroniks/zoneflow/docs/design/display-ui/zone-detail-running.png

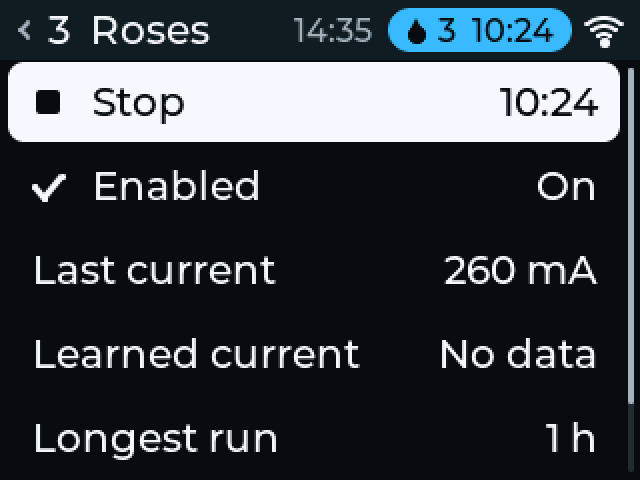
docs/design/display-ui/zone-detail-running.png
