syntroniks/zoneflow/docs/design/display-ui/zones-fault.png

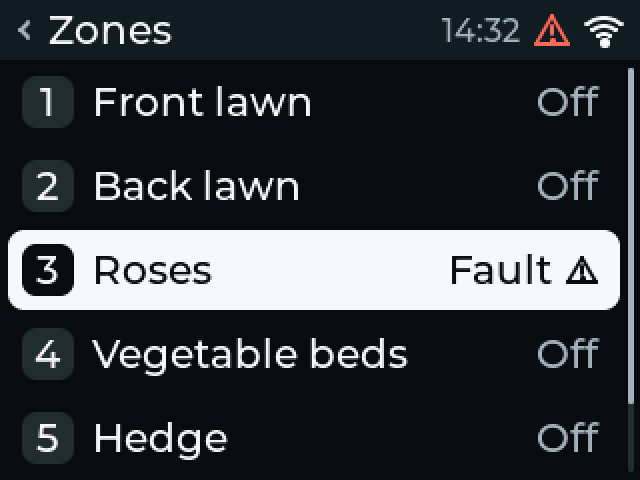
docs/design/display-ui/zones-fault.png
