syntroniks/zoneflow/docs/design/hardware-layout-review/in2.png

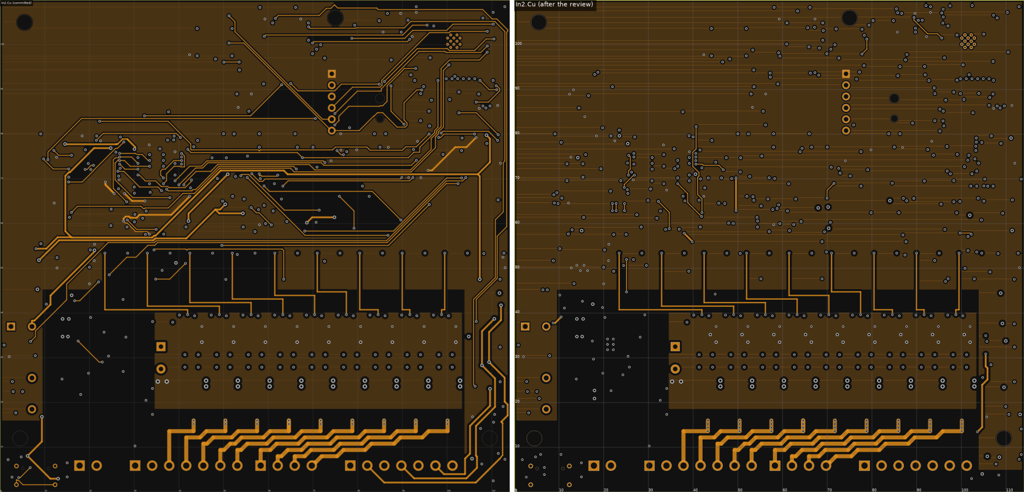
docs/design/hardware-layout-review/in2.png
