syntroniks/zoneflow/docs/design/hardware-layout-review/outvias.png

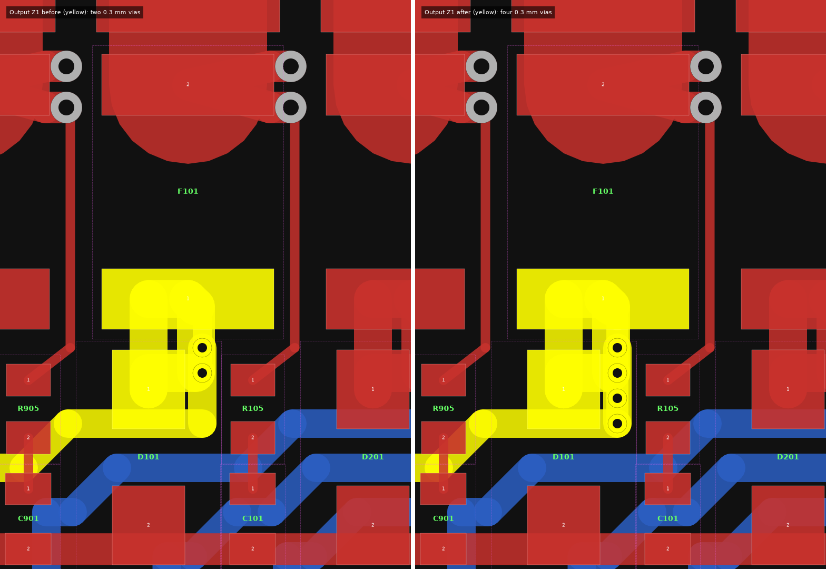
docs/design/hardware-layout-review/outvias.png
