syntroniks/zoneflow/docs/design/hardware-layout-review/placement.png

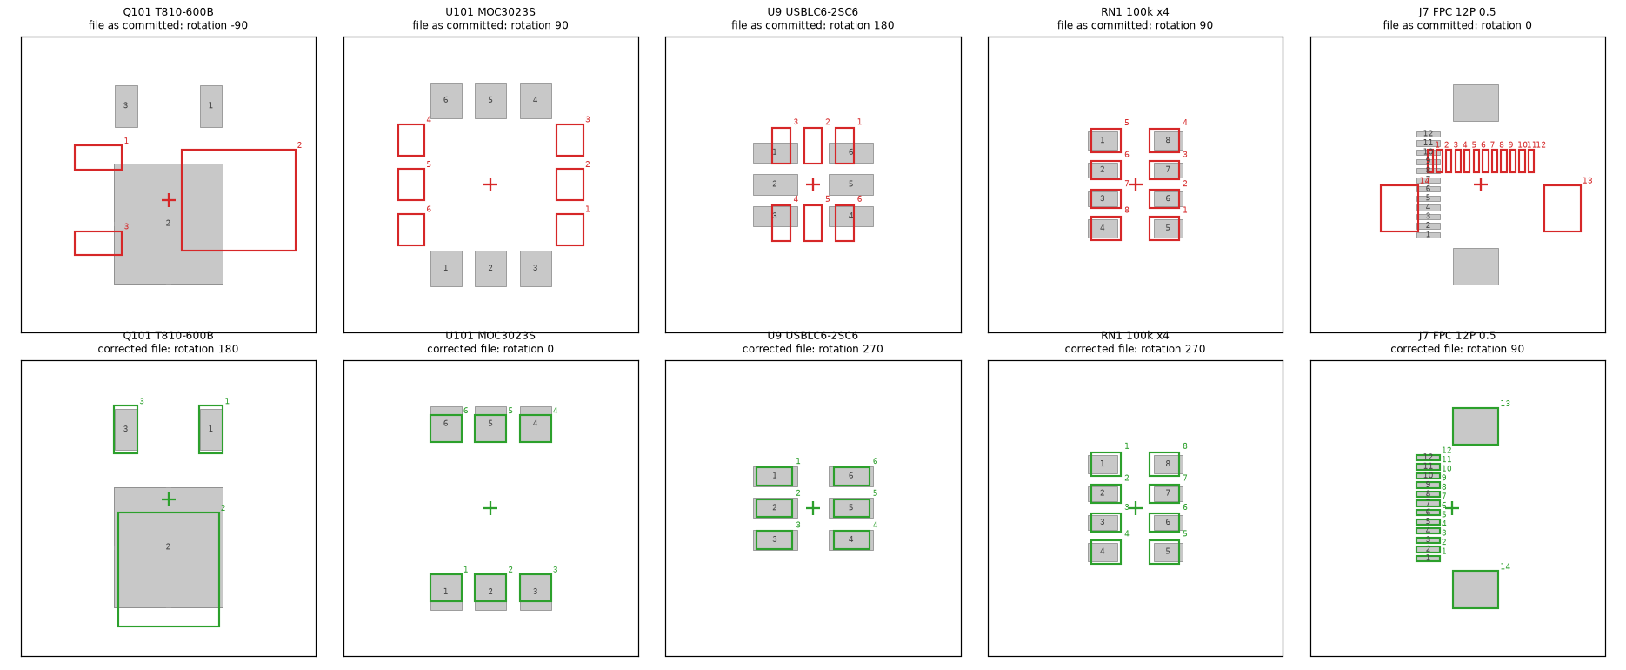
docs/design/hardware-layout-review/placement.png
