syntroniks/zoneflow/docs/design/hardware-layout-review/screw-after.png

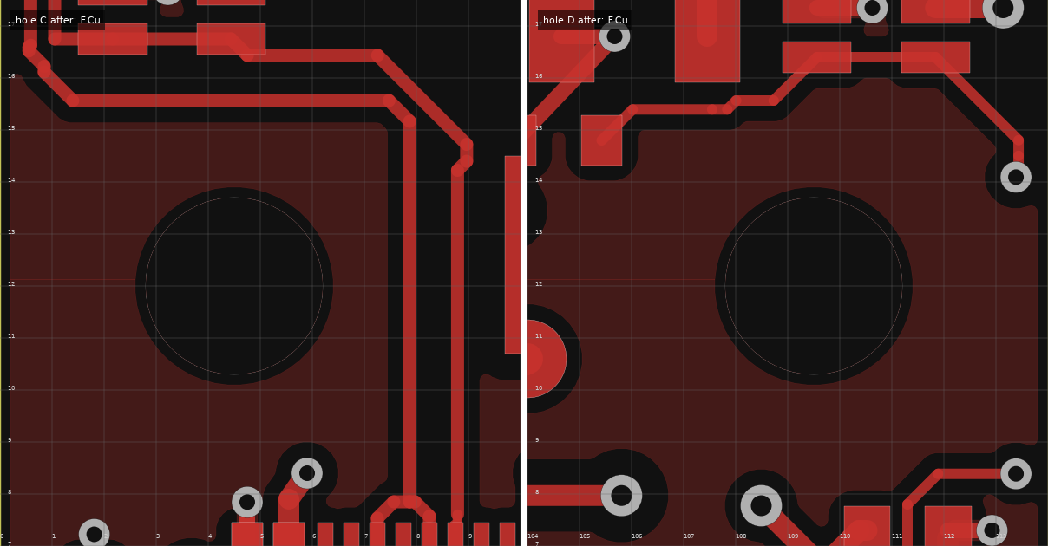
docs/design/hardware-layout-review/screw-after.png
