syntroniks/zoneflow/docs/design/hardware-layout-review/screw-before.png

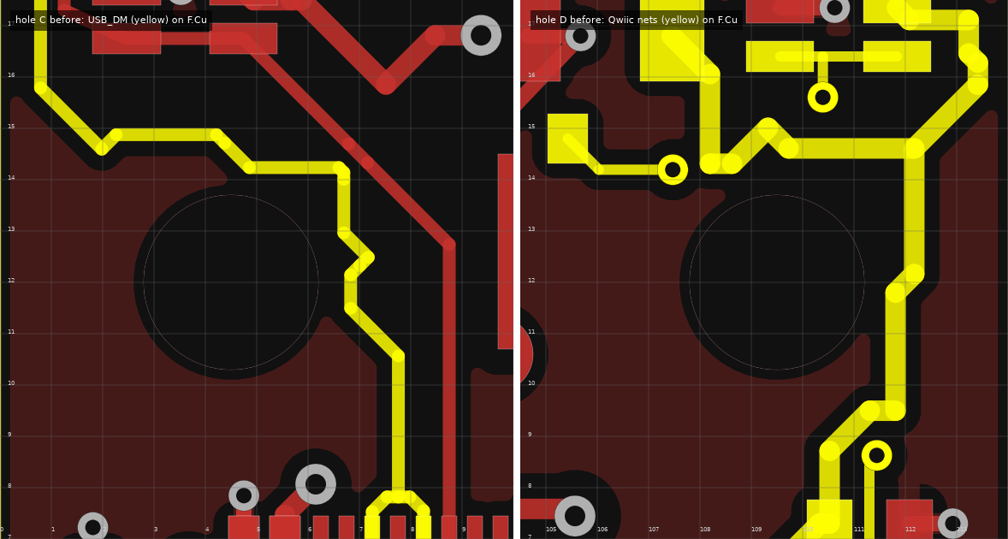
docs/design/hardware-layout-review/screw-before.png
