syntroniks/zoneflow/docs/design/hardware-layout-review/silk-after.png

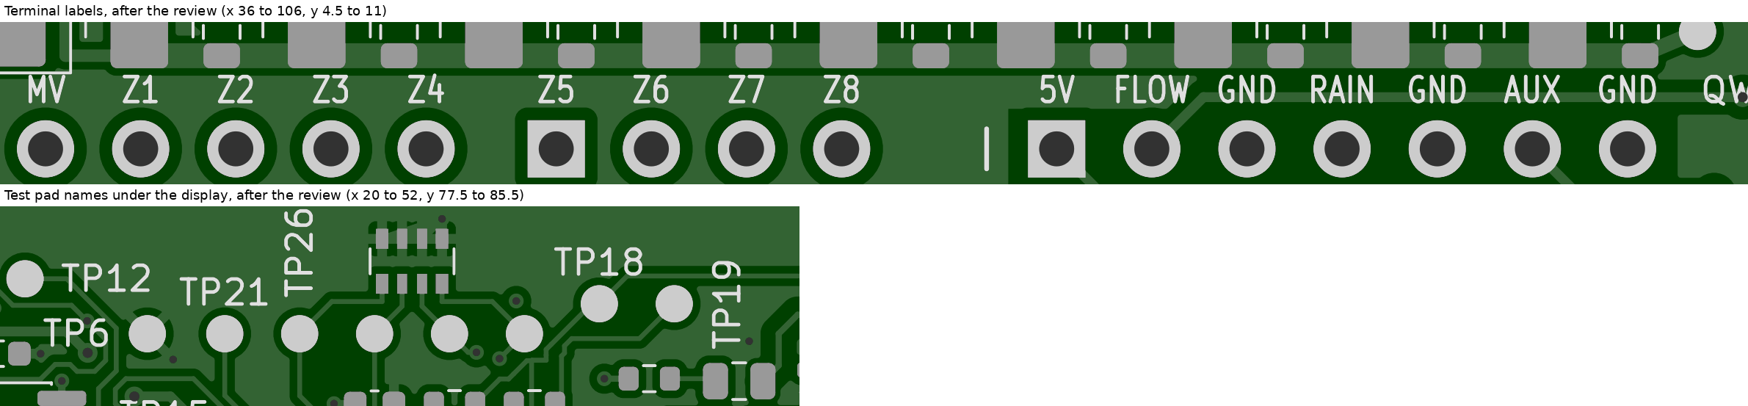
docs/design/hardware-layout-review/silk-after.png
