syntroniks/zoneflow/docs/design/hardware-layout-review/silk-back.png

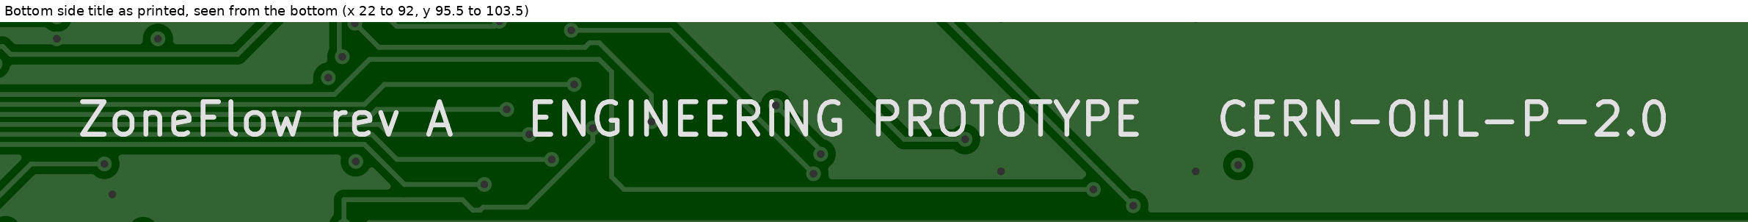
docs/design/hardware-layout-review/silk-back.png
