syntroniks/zoneflow/docs/design/hardware-layout-review/u1.png

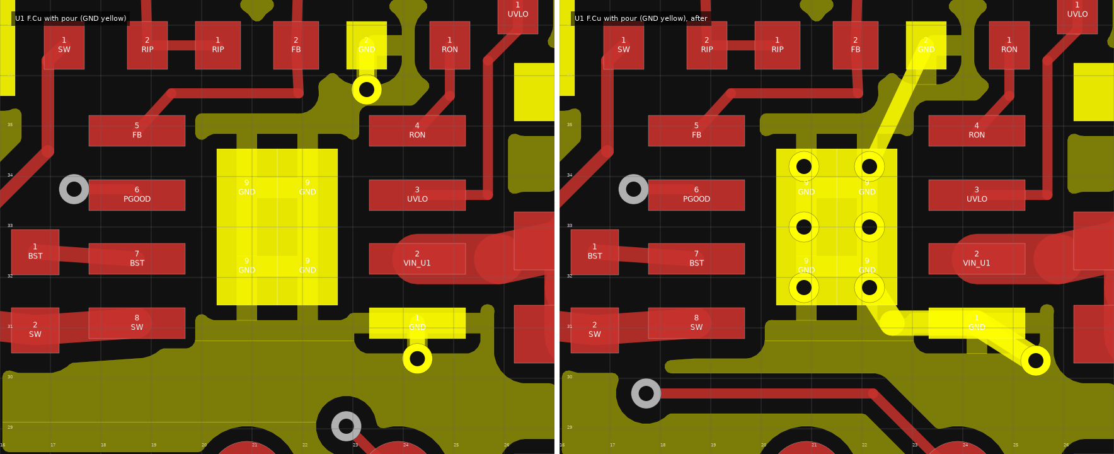
docs/design/hardware-layout-review/u1.png
