syntroniks/zoneflow/docs/design/hardware-layout-review/v5.png

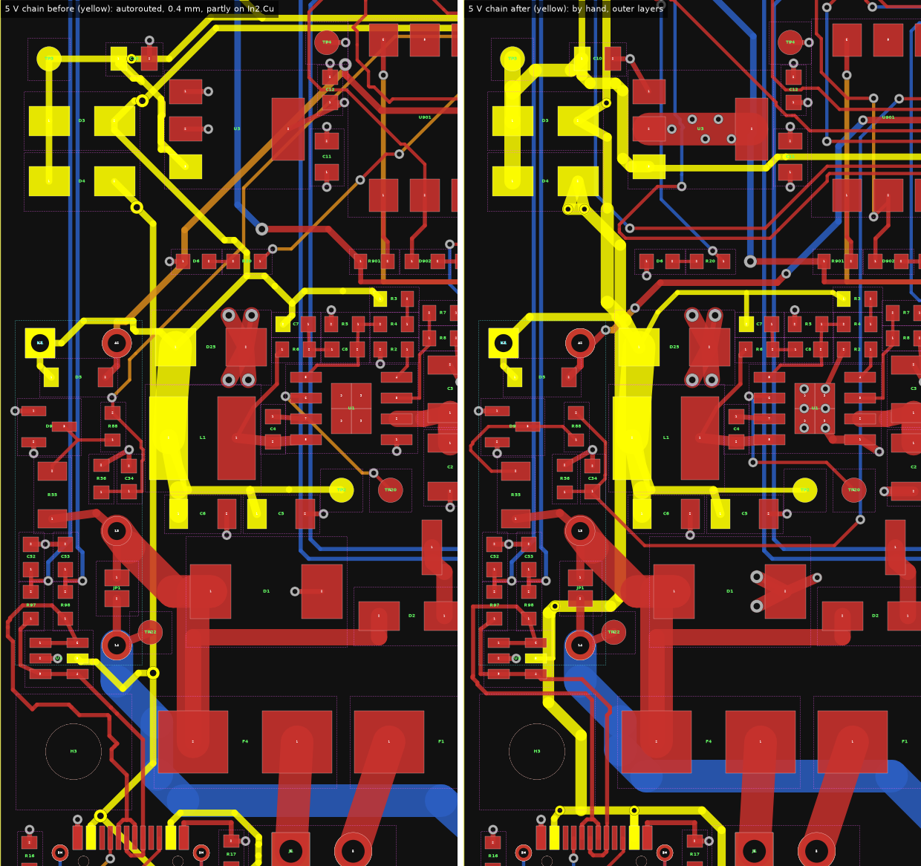
docs/design/hardware-layout-review/v5.png
