syntroniks/zoneflow/docs/design/hardware-layout-review/vinmon.png

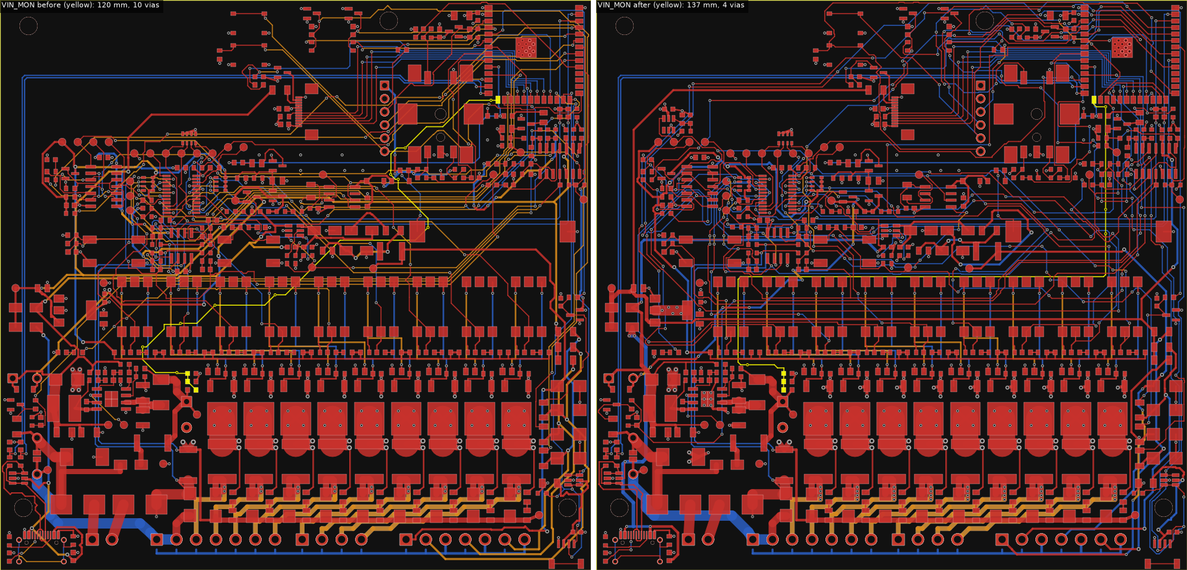
docs/design/hardware-layout-review/vinmon.png
