syntroniks/zoneflow/docs/design/hardware-layout/debounce-btn-back-after.png

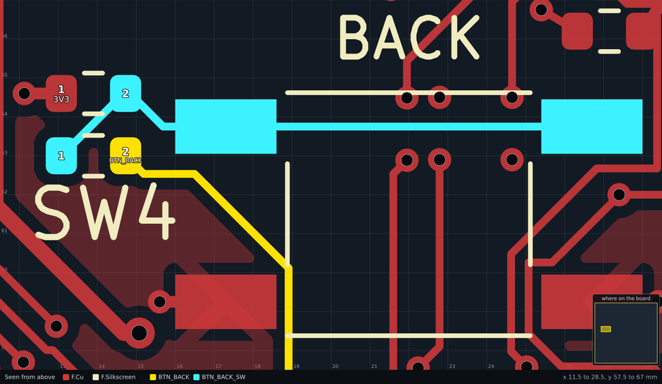
docs/design/hardware-layout/debounce-btn-back-after.png
