syntroniks/zoneflow/docs/design/hardware-layout/debounce-btn-home-after.png

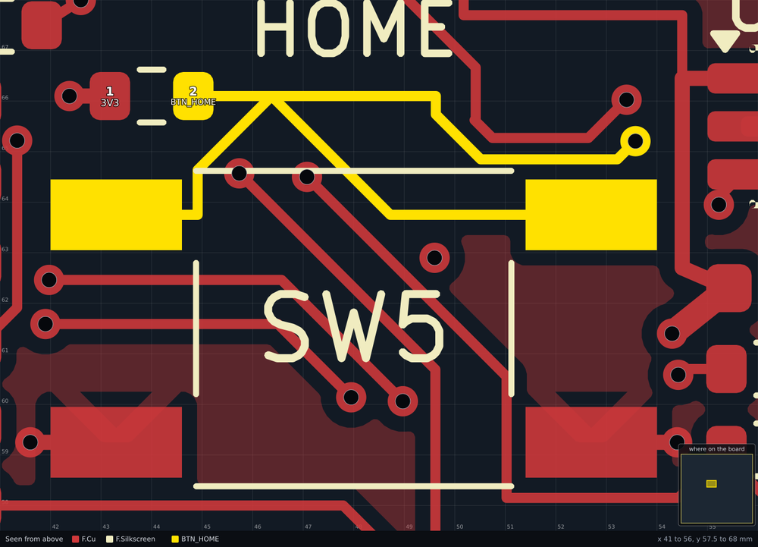
docs/design/hardware-layout/debounce-btn-home-after.png
