syntroniks/zoneflow/docs/design/hardware-layout/debounce-enc-sw-after.png

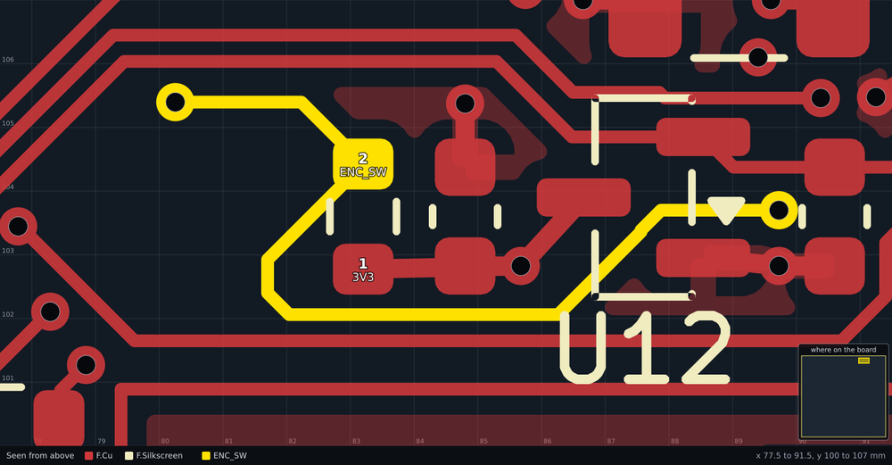
docs/design/hardware-layout/debounce-enc-sw-after.png
