syntroniks/zoneflow/docs/design/hardware-layout/debounce-enc-sw-before.png

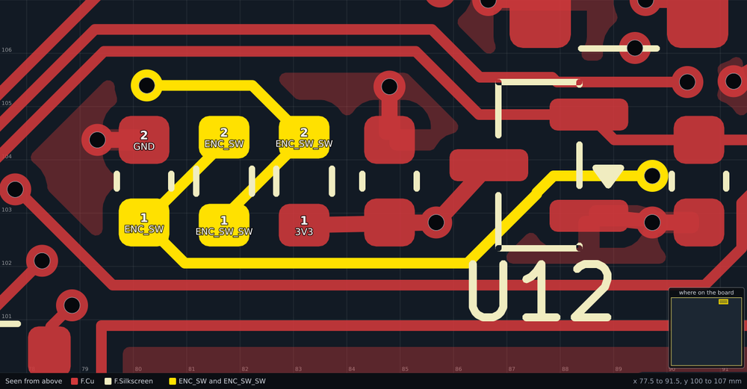
docs/design/hardware-layout/debounce-enc-sw-before.png
