syntroniks/zoneflow/docs/design/hardware-layout/debounce-schematic-after.png

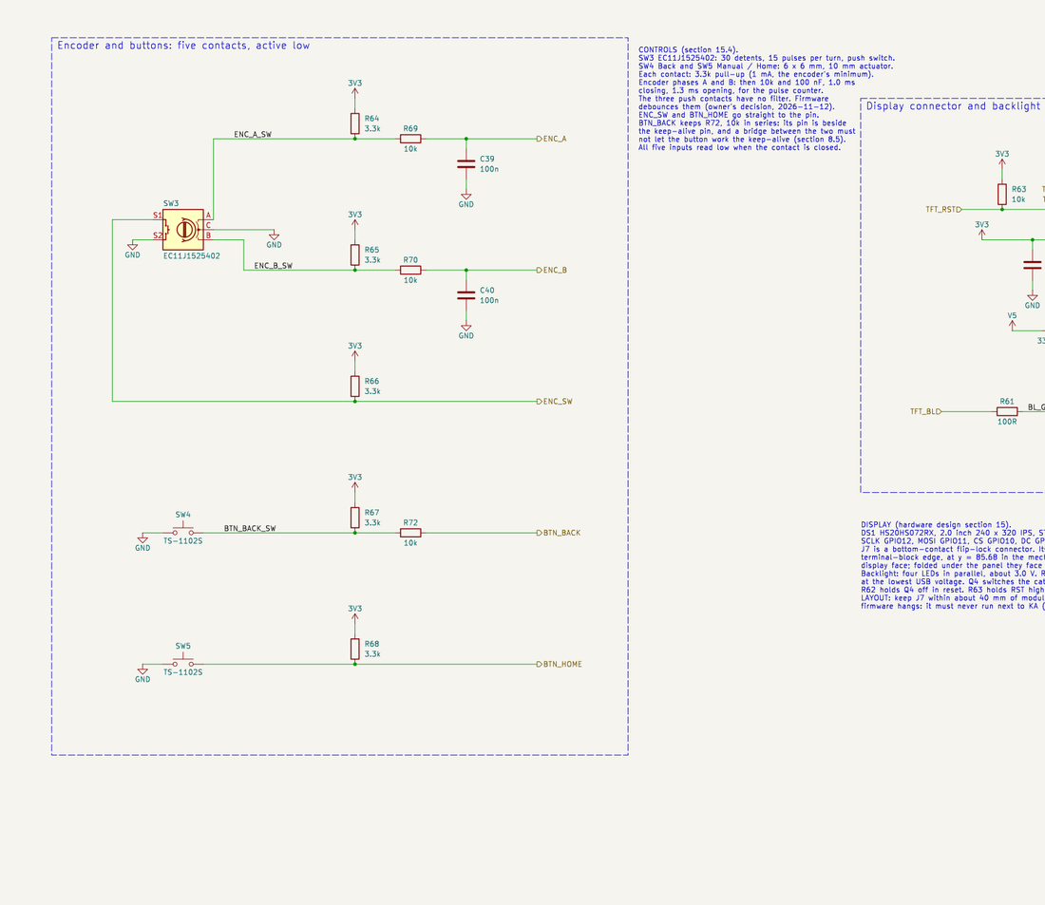
docs/design/hardware-layout/debounce-schematic-after.png
