syntroniks/zoneflow/docs/design/hardware-layout/debounce-schematic-before.png

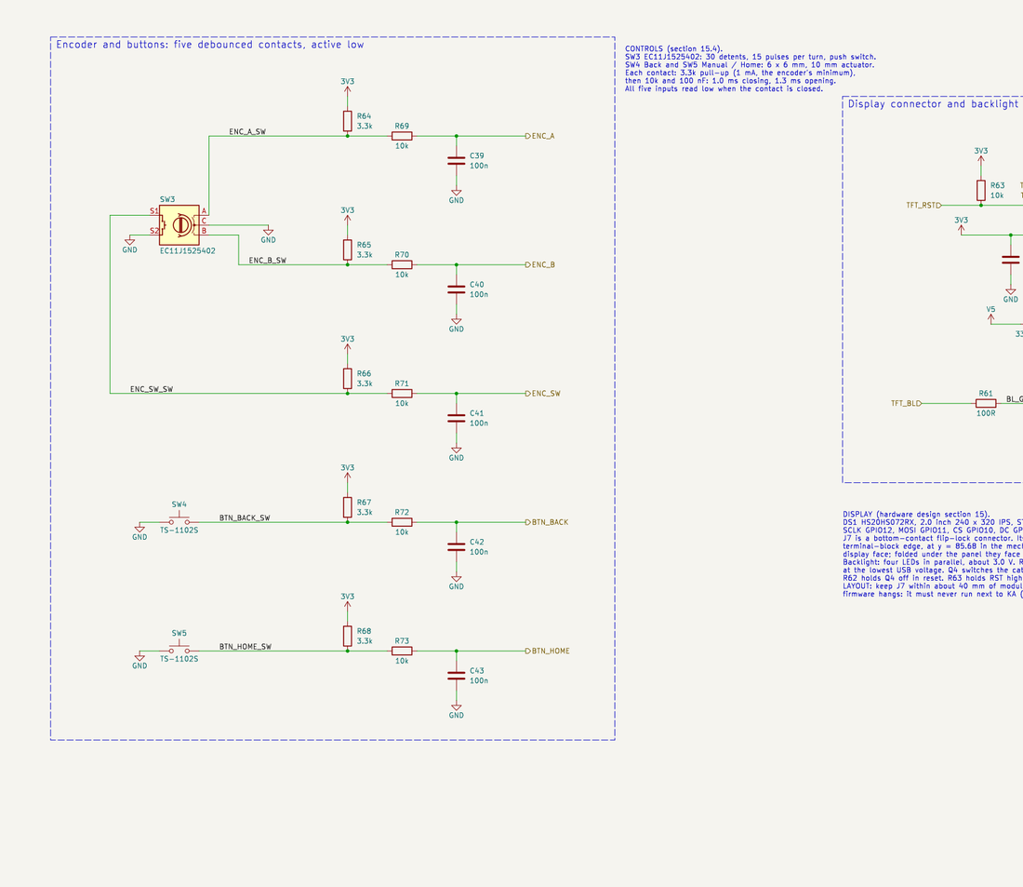
docs/design/hardware-layout/debounce-schematic-before.png
