syntroniks/zoneflow/docs/design/hardware-toolchain/board-bottom.png

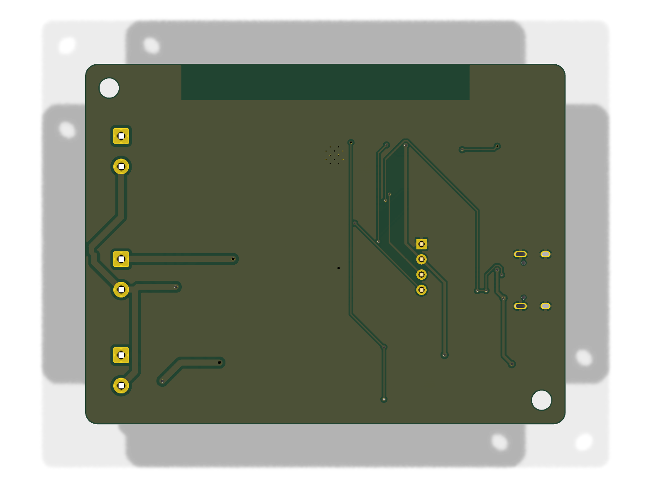
docs/design/hardware-toolchain/board-bottom.png
