syntroniks/zoneflow/docs/design/hardware-toolchain/board-top.png

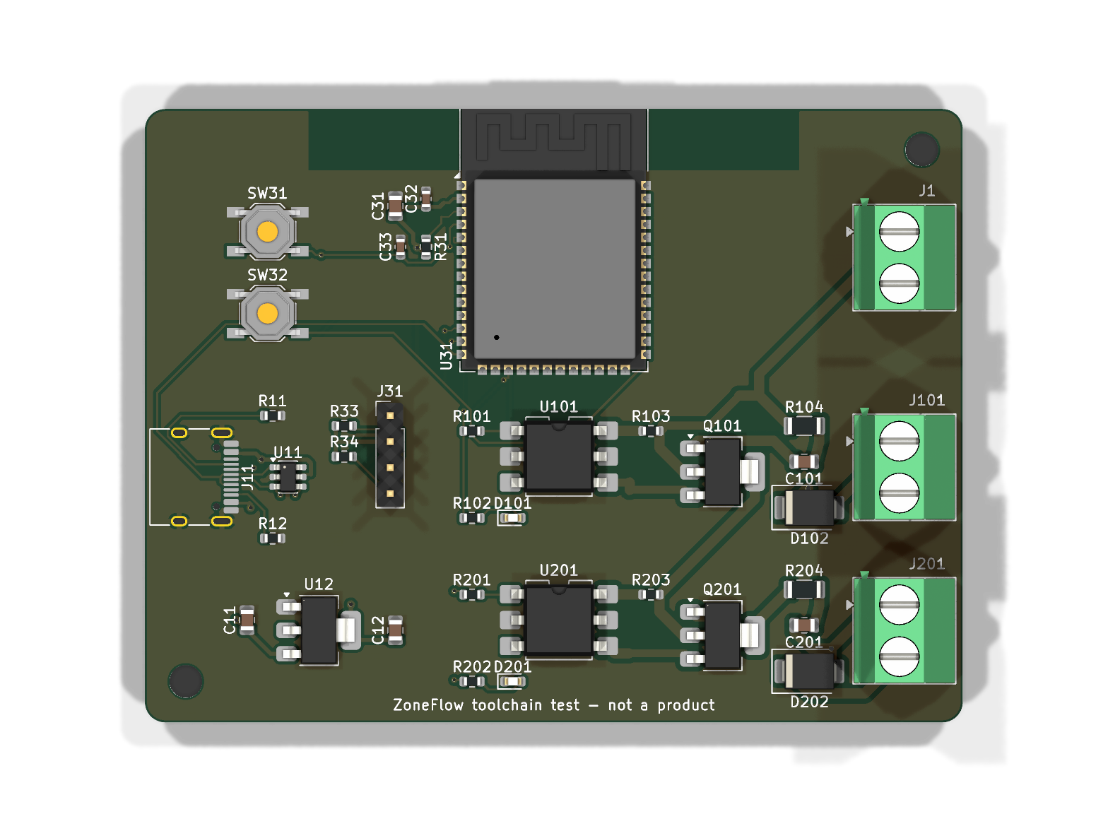
docs/design/hardware-toolchain/board-top.png
