syntroniks/zoneflow/docs/firmware/img/webui/dark-desktop-about.png

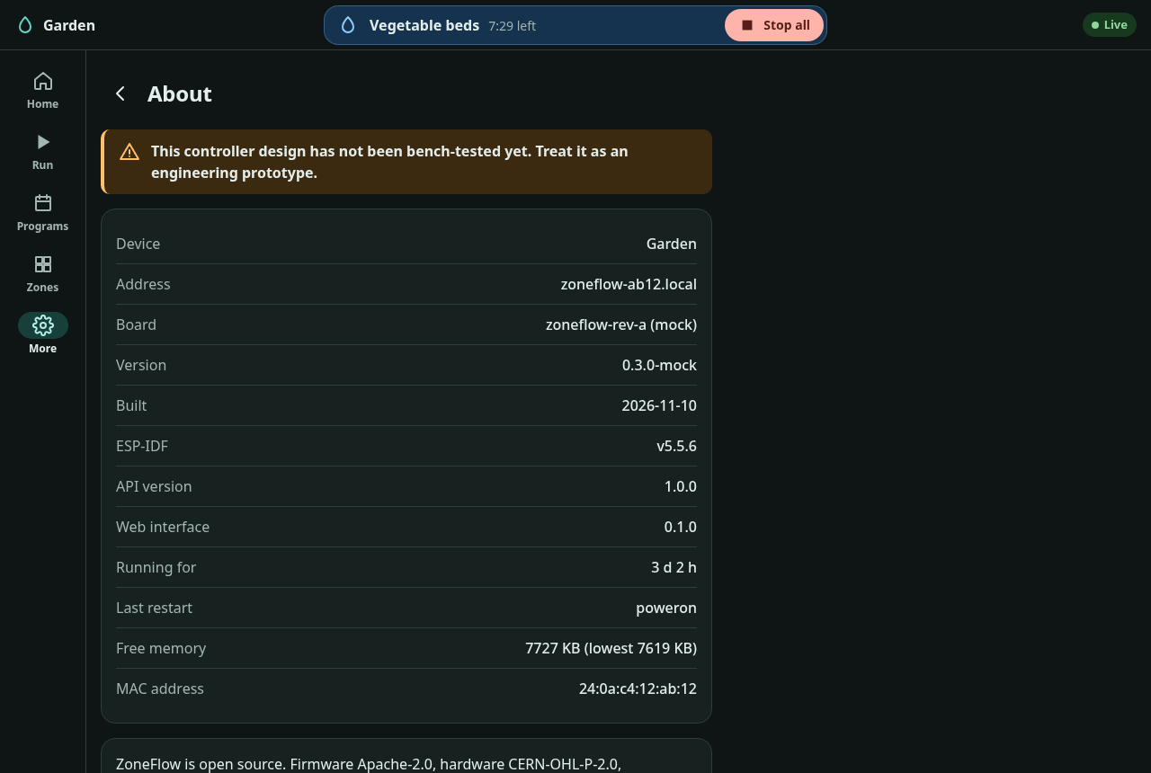
docs/firmware/img/webui/dark-desktop-about.png
