syntroniks/zoneflow/docs/firmware/img/webui/dark-desktop-confirm-reset.png

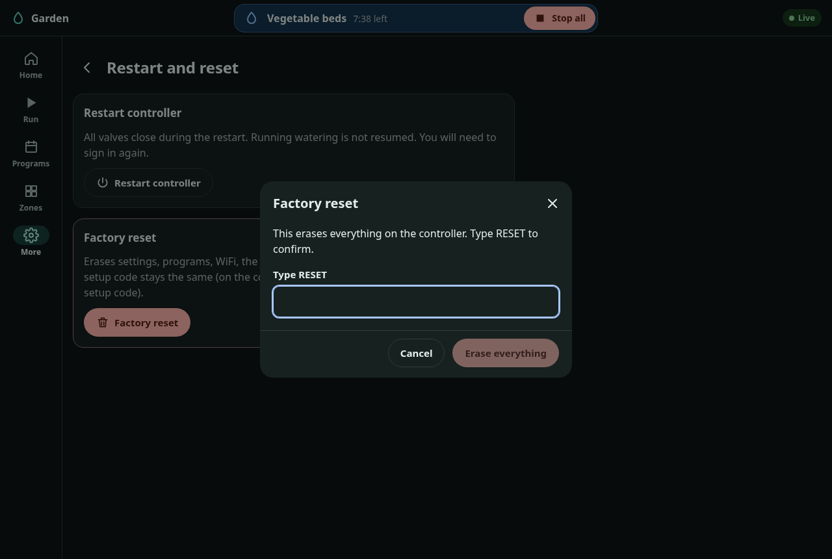
docs/firmware/img/webui/dark-desktop-confirm-reset.png
