syntroniks/zoneflow/docs/firmware/img/webui/dark-desktop-connection-lost.png

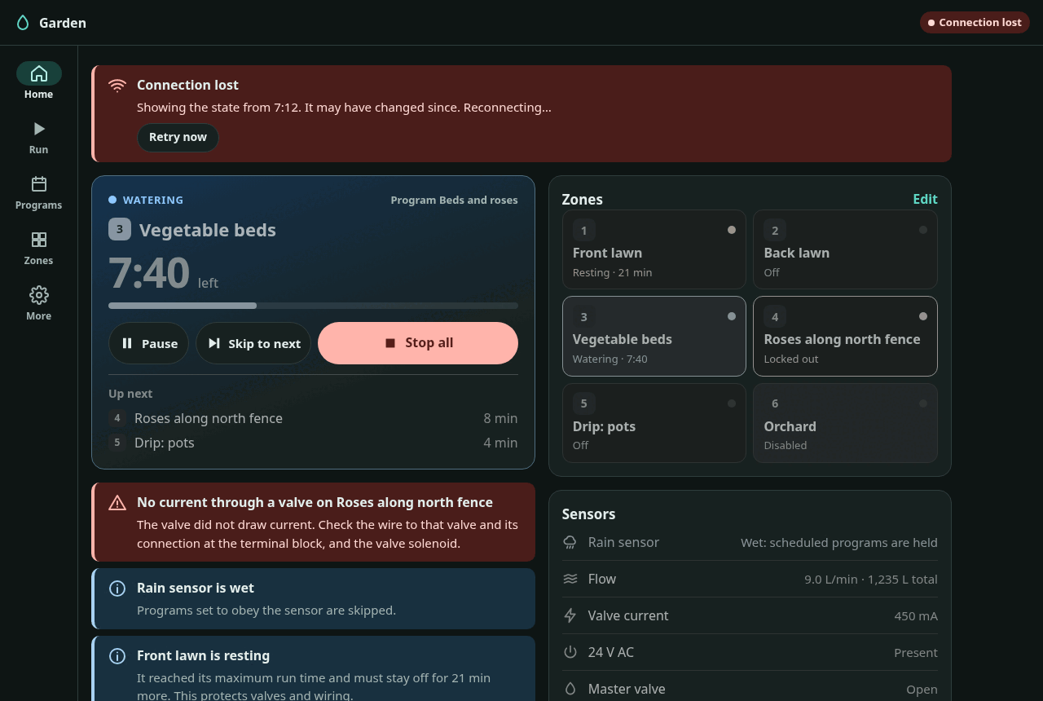
docs/firmware/img/webui/dark-desktop-connection-lost.png
