syntroniks/zoneflow/docs/firmware/img/webui/dark-desktop-home-faults.png

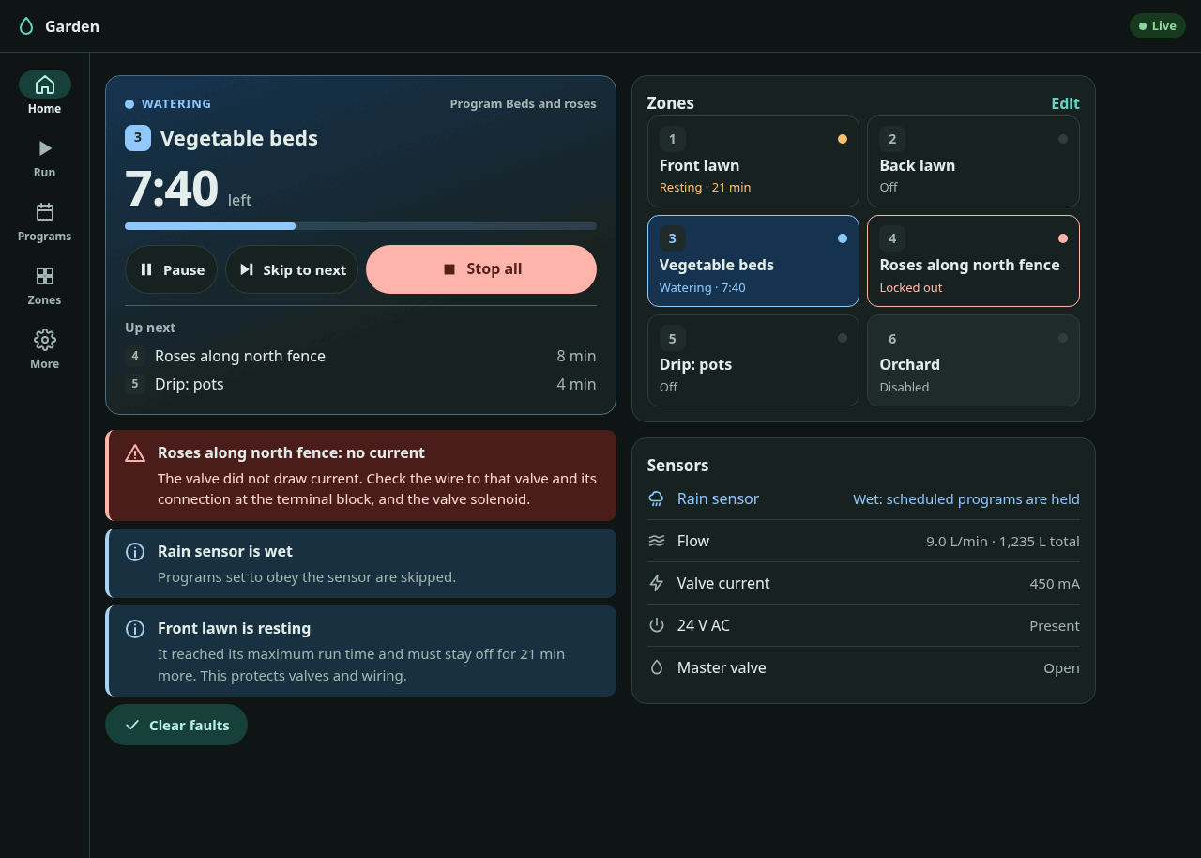
docs/firmware/img/webui/dark-desktop-home-faults.png
