syntroniks/zoneflow/docs/firmware/img/webui/dark-desktop-home-idle.png

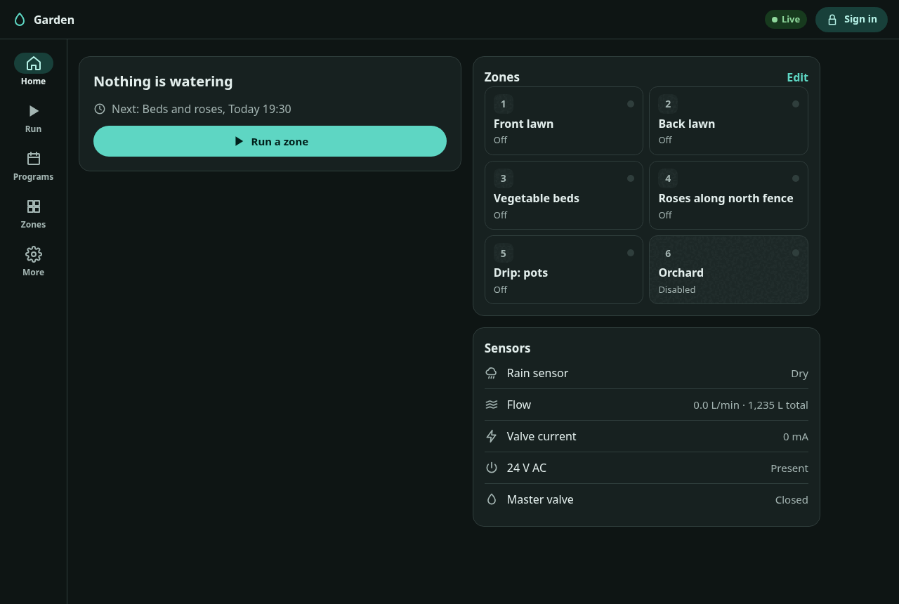
docs/firmware/img/webui/dark-desktop-home-idle.png
