syntroniks/zoneflow/docs/firmware/img/webui/dark-desktop-home-running.png

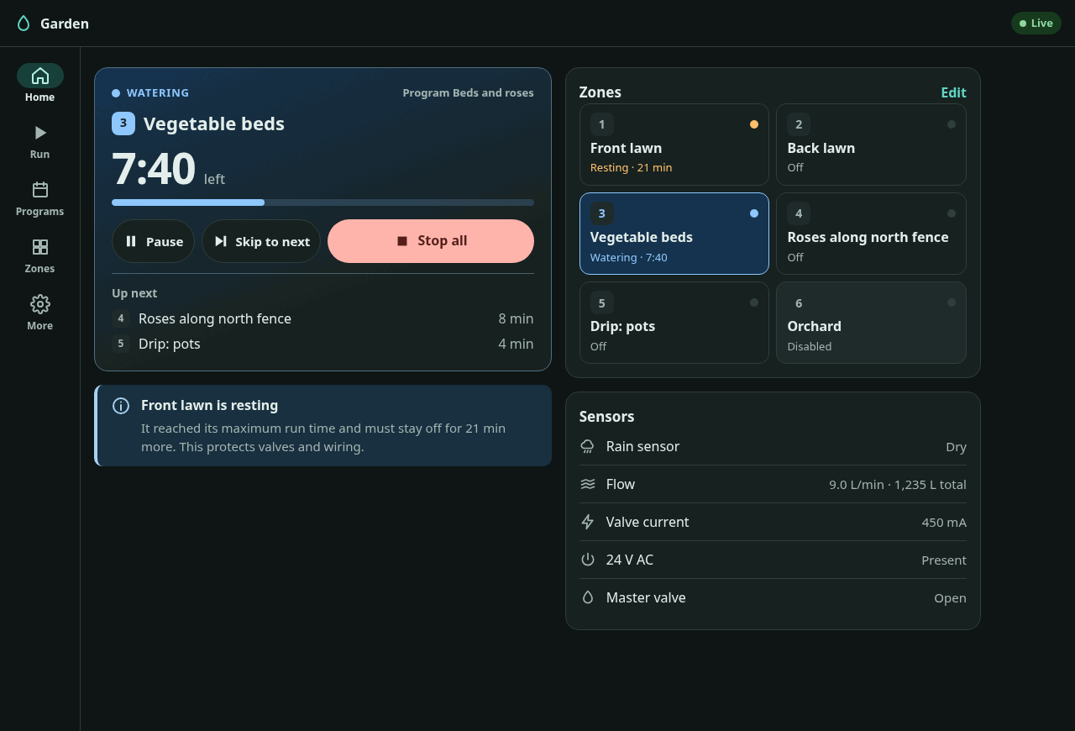
docs/firmware/img/webui/dark-desktop-home-running.png
