syntroniks/zoneflow/docs/firmware/img/webui/dark-desktop-more.png

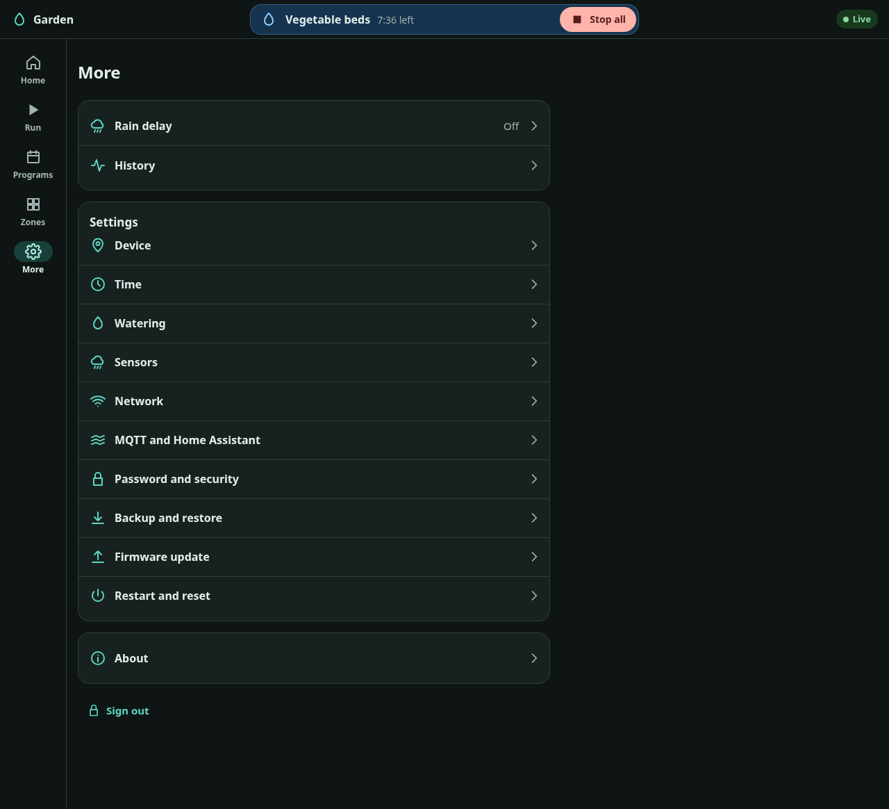
docs/firmware/img/webui/dark-desktop-more.png
