syntroniks/zoneflow/docs/firmware/img/webui/dark-desktop-program-edit.png

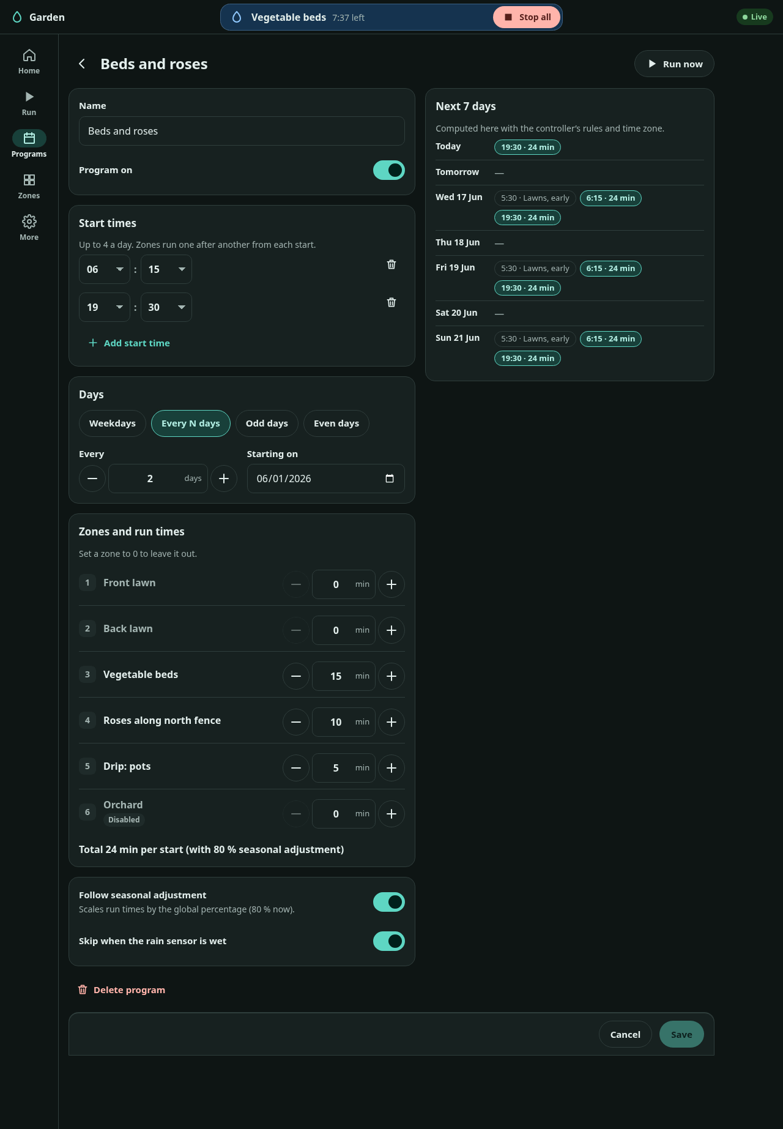
docs/firmware/img/webui/dark-desktop-program-edit.png
