syntroniks/zoneflow/docs/firmware/img/webui/dark-desktop-programs.png

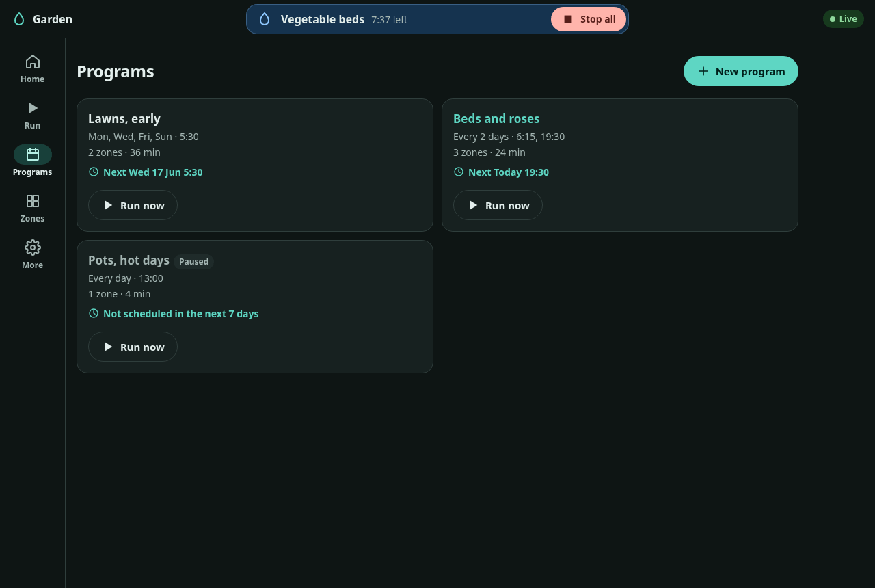
docs/firmware/img/webui/dark-desktop-programs.png
