syntroniks/zoneflow/docs/firmware/img/webui/dark-desktop-quick-run.png

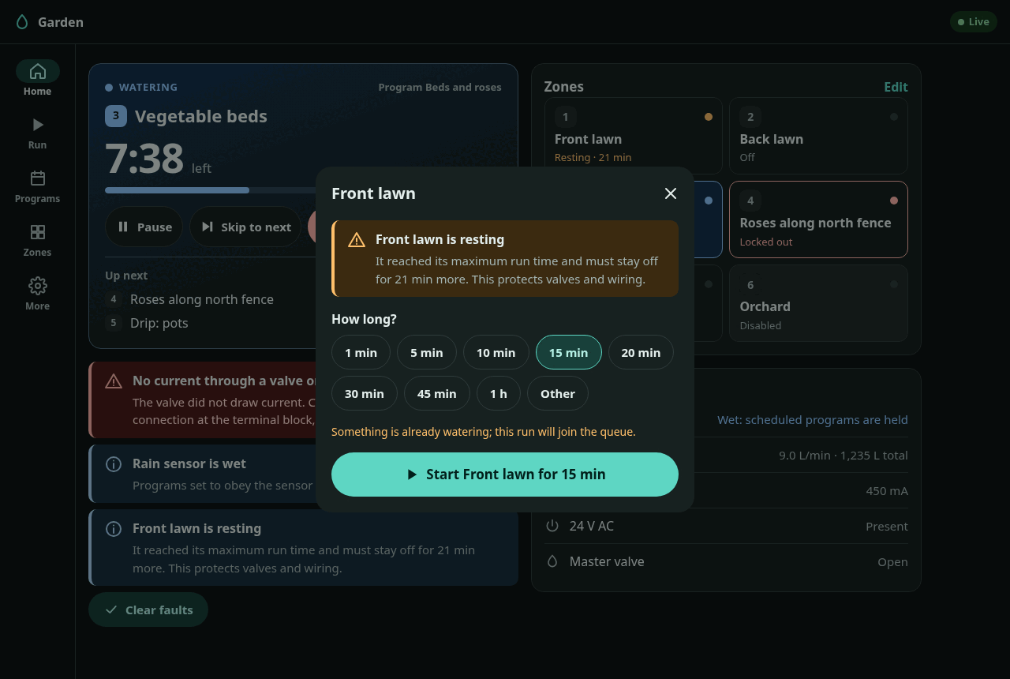
docs/firmware/img/webui/dark-desktop-quick-run.png
