syntroniks/zoneflow/docs/firmware/img/webui/dark-desktop-rain-delay.png

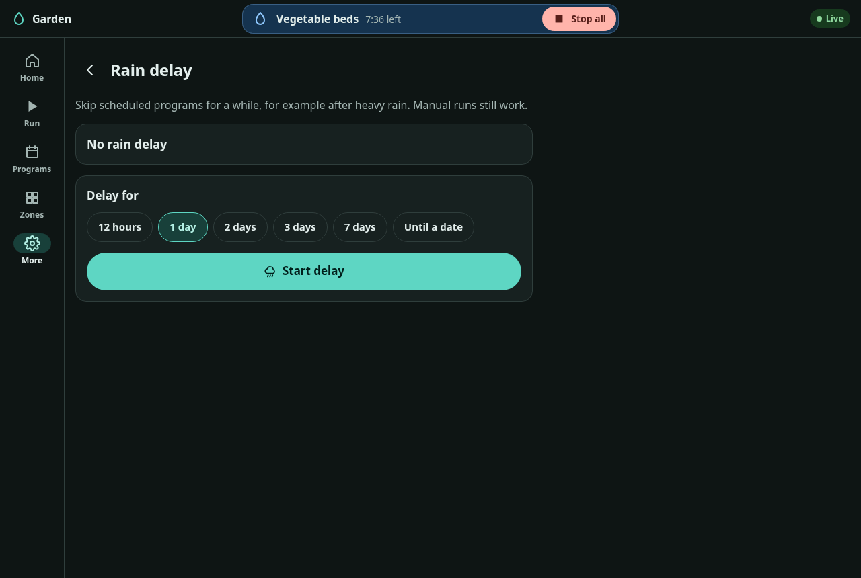
docs/firmware/img/webui/dark-desktop-rain-delay.png
