syntroniks/zoneflow/docs/firmware/img/webui/dark-desktop-run.png

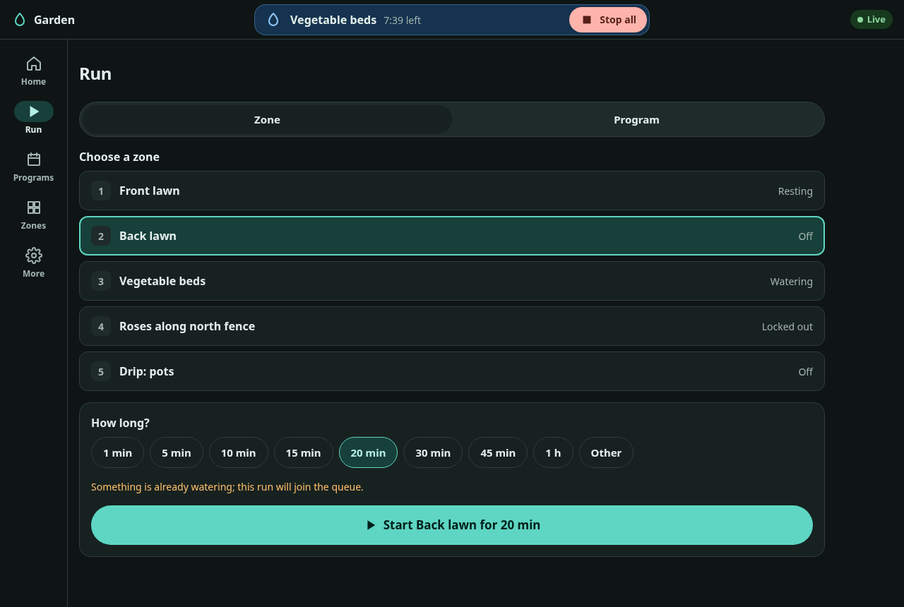
docs/firmware/img/webui/dark-desktop-run.png
