syntroniks/zoneflow/docs/firmware/img/webui/dark-desktop-settings-backup.png

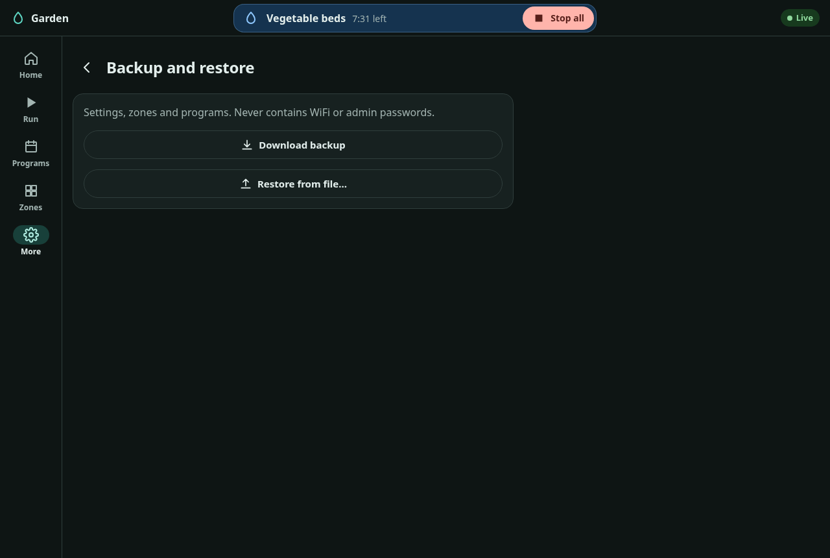
docs/firmware/img/webui/dark-desktop-settings-backup.png
