syntroniks/zoneflow/docs/firmware/img/webui/dark-desktop-settings-device.png

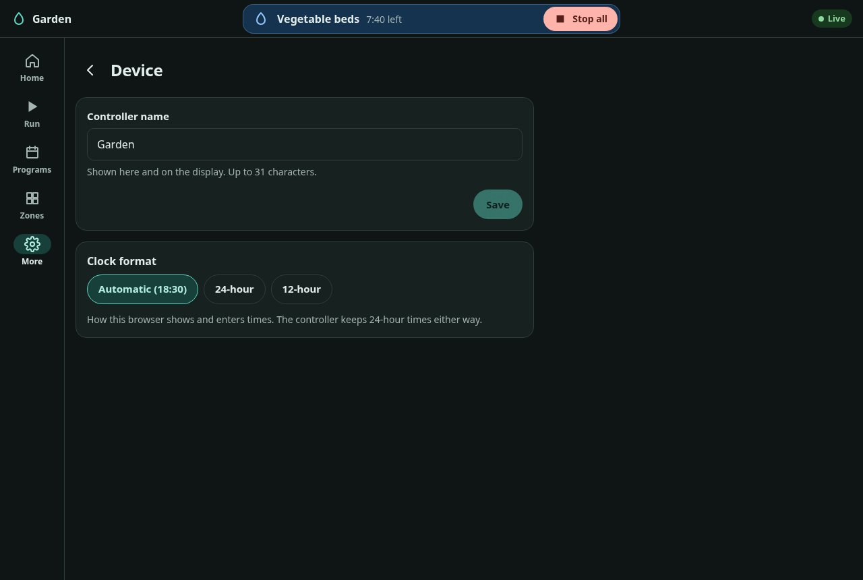
docs/firmware/img/webui/dark-desktop-settings-device.png
