syntroniks/zoneflow/docs/firmware/img/webui/dark-desktop-settings-firmware.png

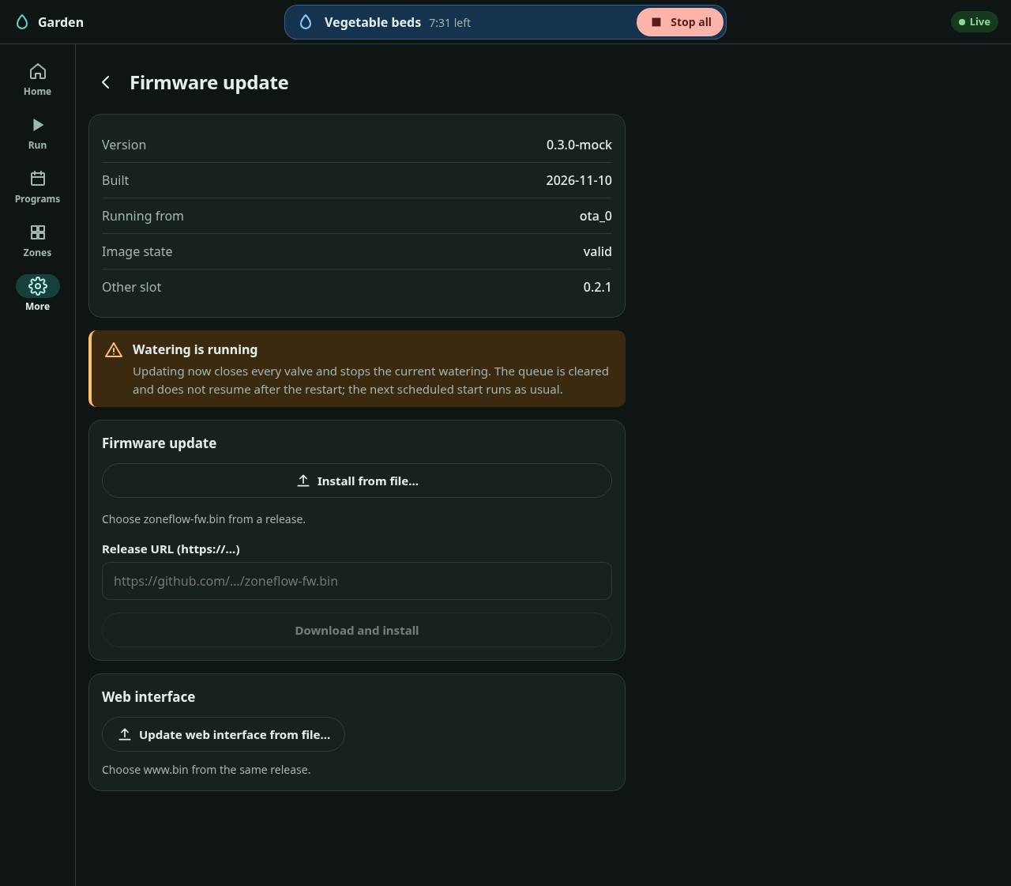
docs/firmware/img/webui/dark-desktop-settings-firmware.png
