syntroniks/zoneflow/docs/firmware/img/webui/dark-desktop-settings-mqtt.png

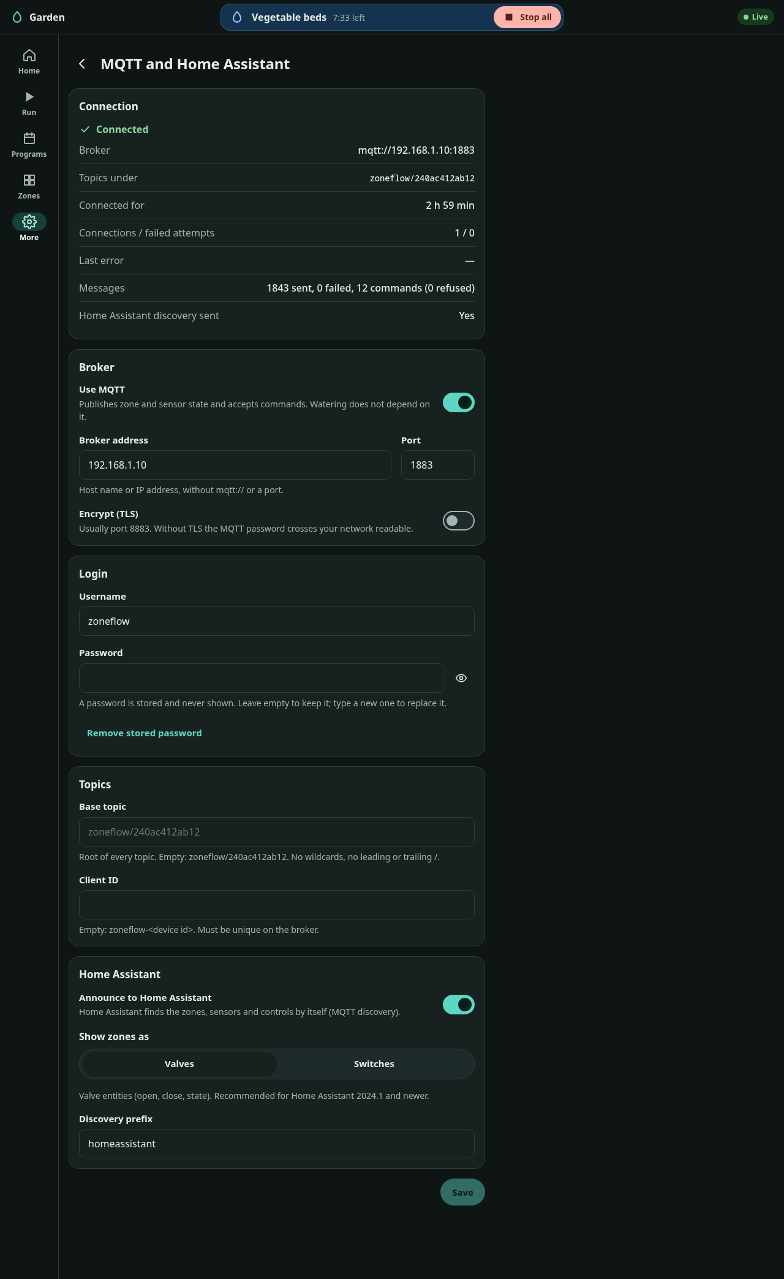
docs/firmware/img/webui/dark-desktop-settings-mqtt.png
