syntroniks/zoneflow/docs/firmware/img/webui/dark-desktop-settings-network.png

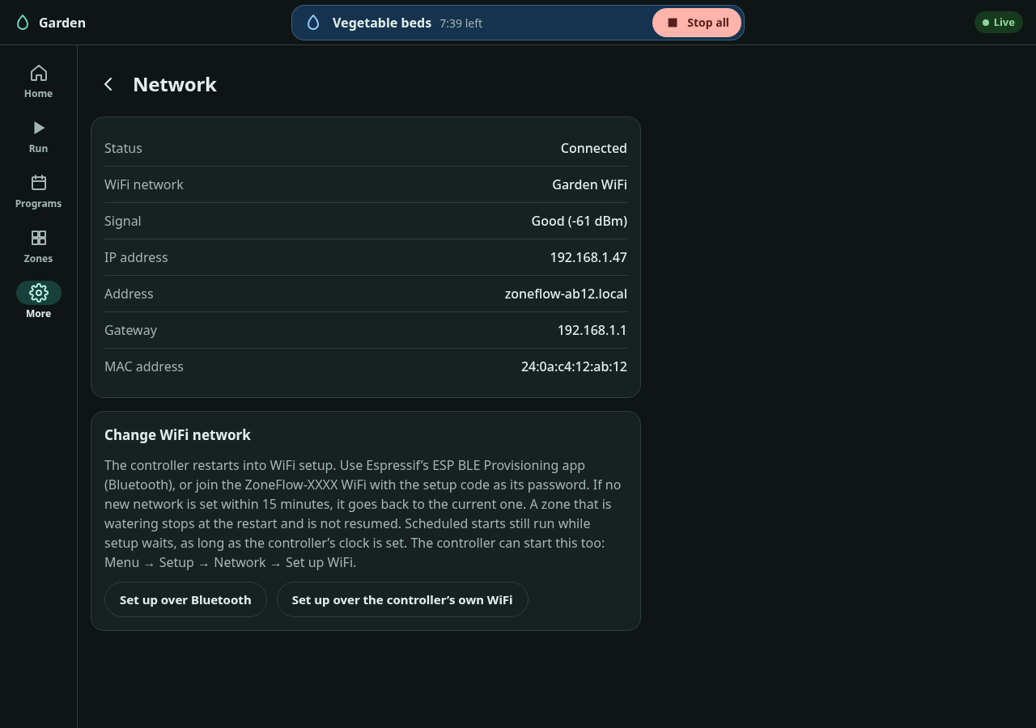
docs/firmware/img/webui/dark-desktop-settings-network.png
