syntroniks/zoneflow/docs/firmware/img/webui/dark-desktop-settings-security.png

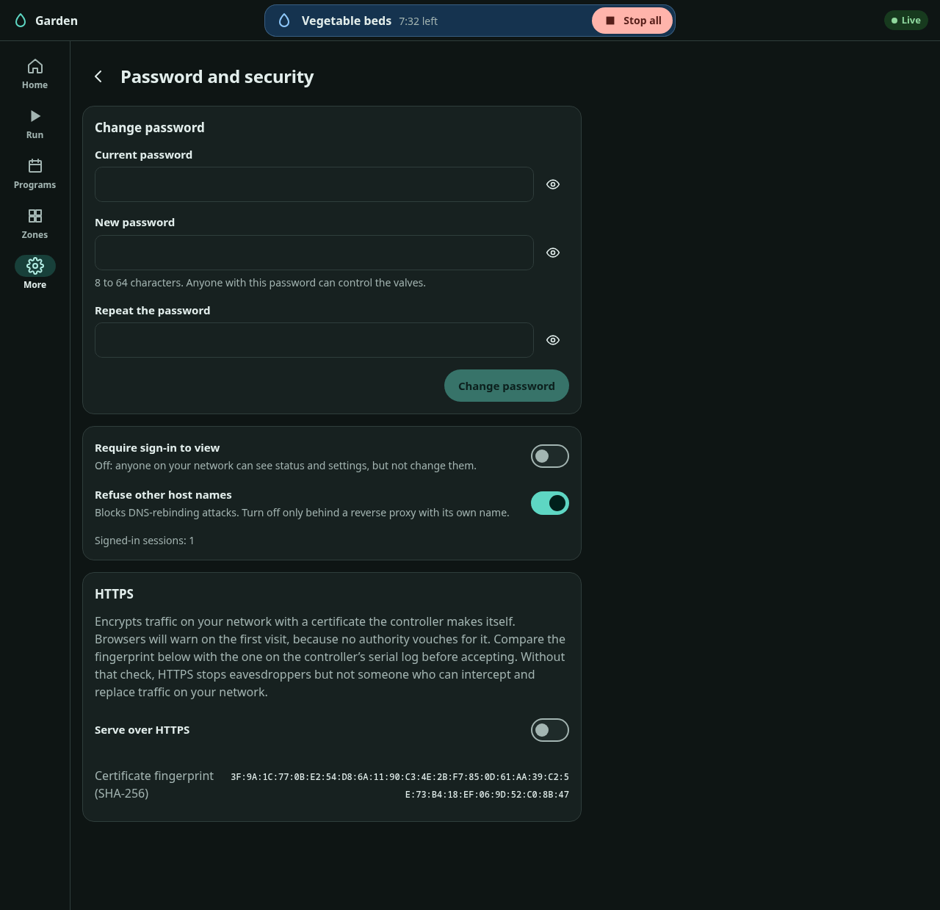
docs/firmware/img/webui/dark-desktop-settings-security.png
