syntroniks/zoneflow/docs/firmware/img/webui/dark-desktop-settings-sensors.png

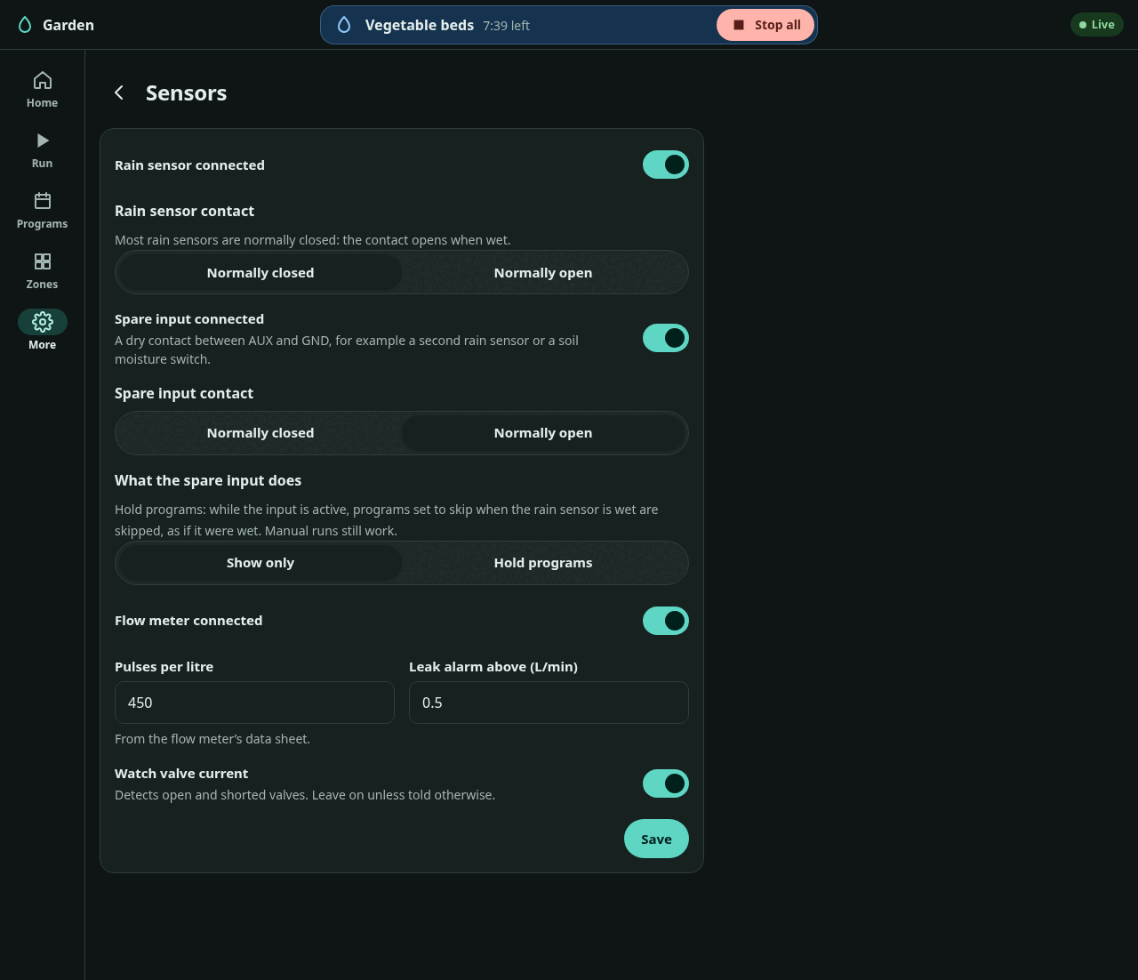
docs/firmware/img/webui/dark-desktop-settings-sensors.png
