syntroniks/zoneflow/docs/firmware/img/webui/dark-desktop-settings-time.png

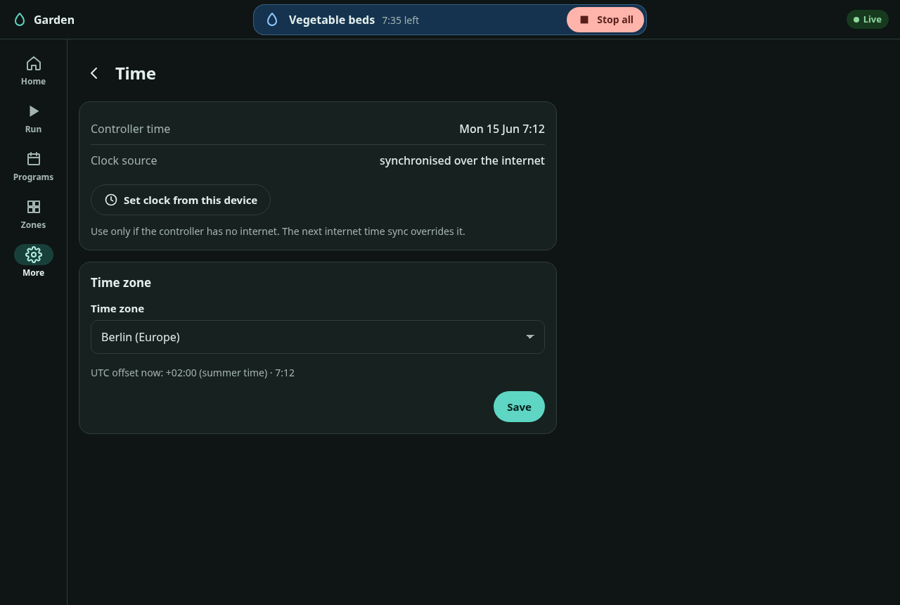
docs/firmware/img/webui/dark-desktop-settings-time.png
