syntroniks/zoneflow/docs/firmware/img/webui/dark-desktop-settings-watering.png

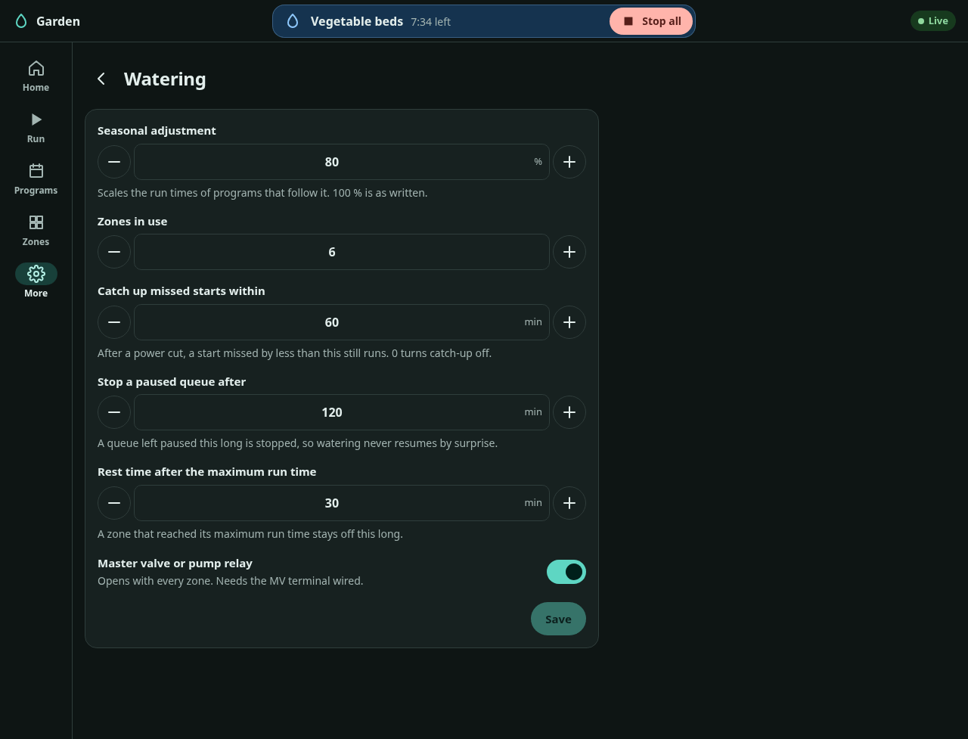
docs/firmware/img/webui/dark-desktop-settings-watering.png
