syntroniks/zoneflow/docs/firmware/img/webui/dark-desktop-zone-detail.png

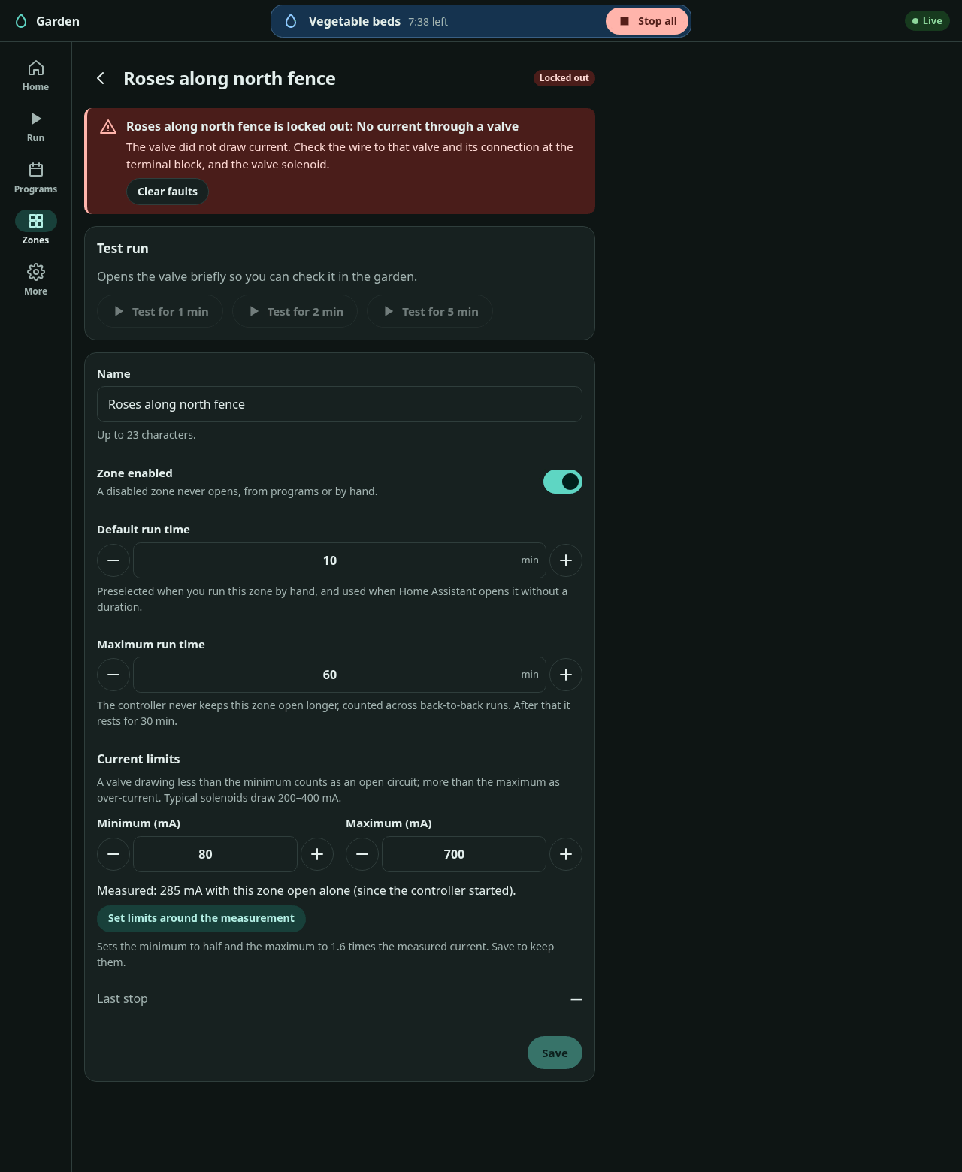
docs/firmware/img/webui/dark-desktop-zone-detail.png
