syntroniks/zoneflow/docs/firmware/img/webui/dark-desktop-zones.png

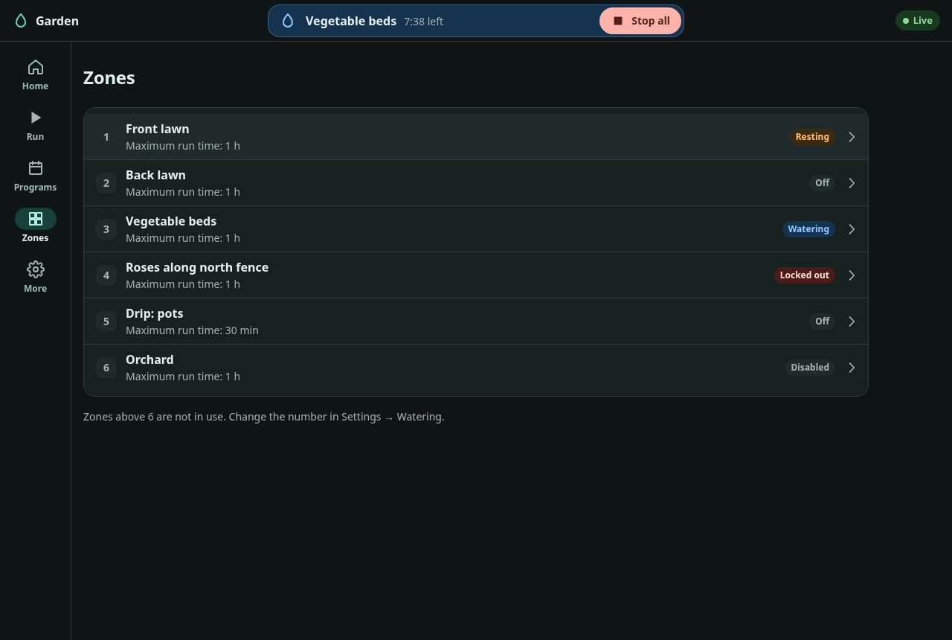
docs/firmware/img/webui/dark-desktop-zones.png
