syntroniks/zoneflow/docs/firmware/img/webui/dark-phone-about.png

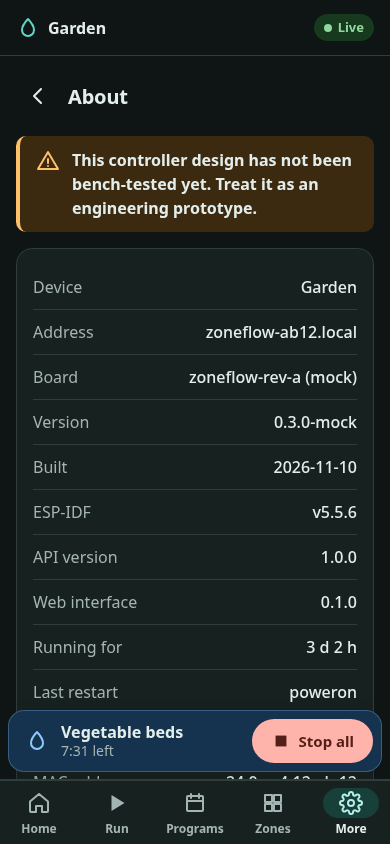
docs/firmware/img/webui/dark-phone-about.png
