syntroniks/zoneflow/docs/firmware/img/webui/dark-phone-confirm-reset.png

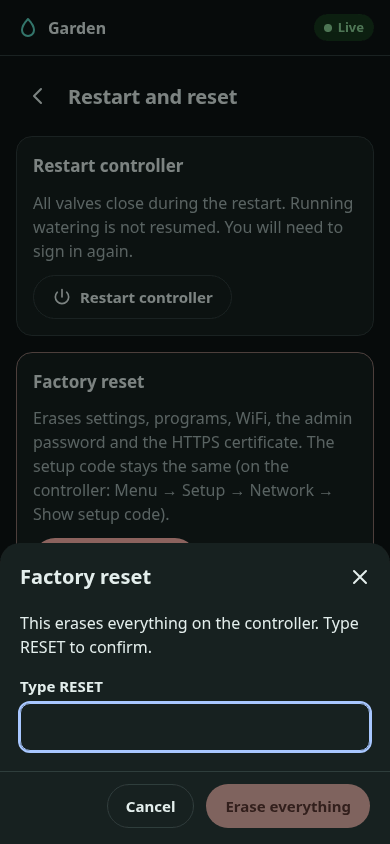
docs/firmware/img/webui/dark-phone-confirm-reset.png
