syntroniks/zoneflow/docs/firmware/img/webui/dark-phone-connection-lost.png

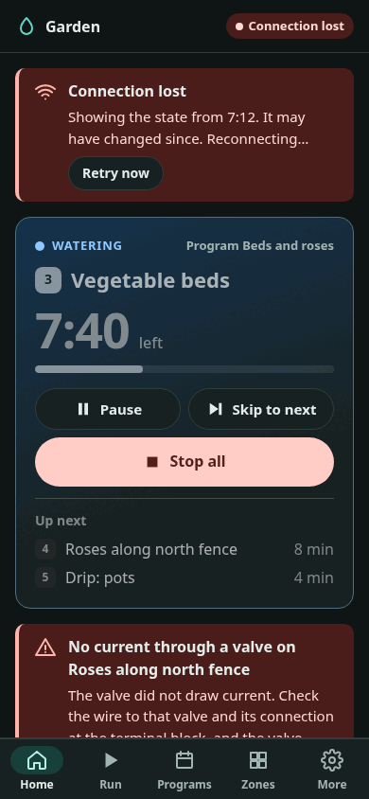
docs/firmware/img/webui/dark-phone-connection-lost.png
