syntroniks/zoneflow/docs/firmware/img/webui/dark-phone-home-faults.png

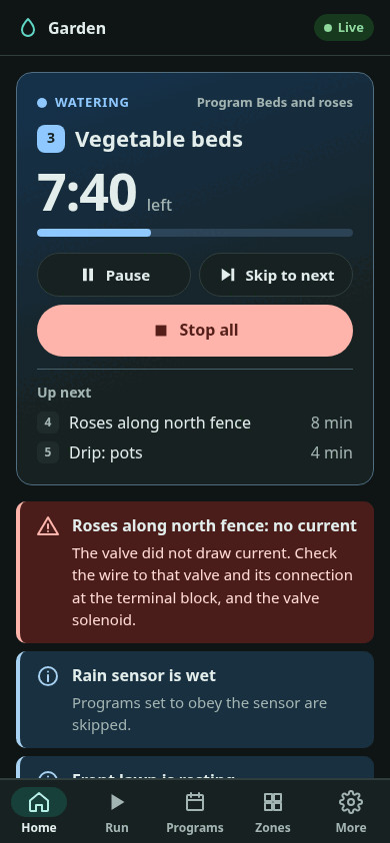
docs/firmware/img/webui/dark-phone-home-faults.png
