syntroniks/zoneflow/docs/firmware/img/webui/dark-phone-home-idle.png

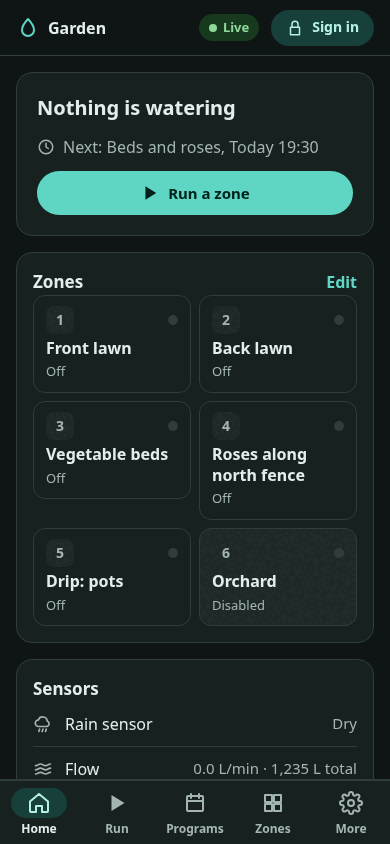
docs/firmware/img/webui/dark-phone-home-idle.png
