syntroniks/zoneflow/docs/firmware/img/webui/dark-phone-home-running.png

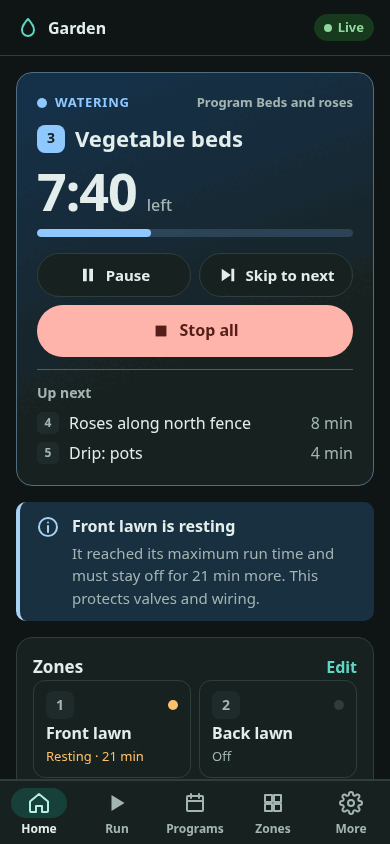
docs/firmware/img/webui/dark-phone-home-running.png
