syntroniks/zoneflow/docs/firmware/img/webui/dark-phone-more.png

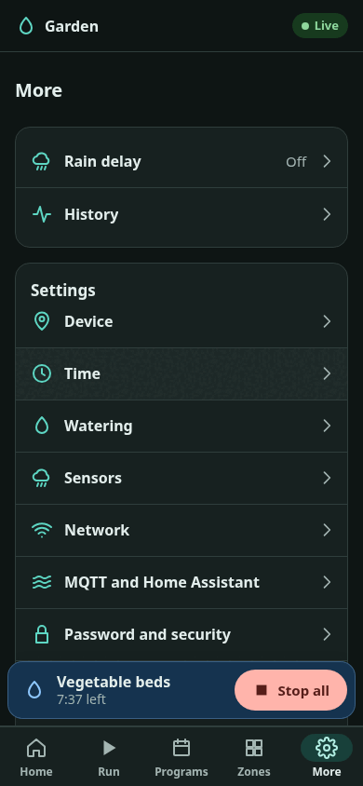
docs/firmware/img/webui/dark-phone-more.png
