syntroniks/zoneflow/docs/firmware/img/webui/dark-phone-program-edit.png

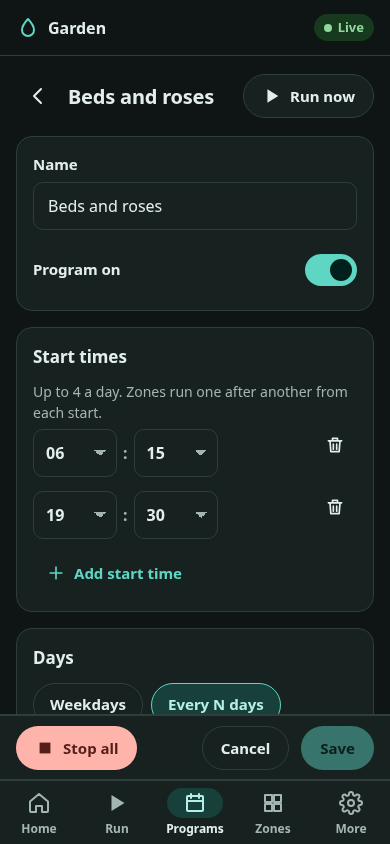
docs/firmware/img/webui/dark-phone-program-edit.png
