syntroniks/zoneflow/docs/firmware/img/webui/dark-phone-programs.png

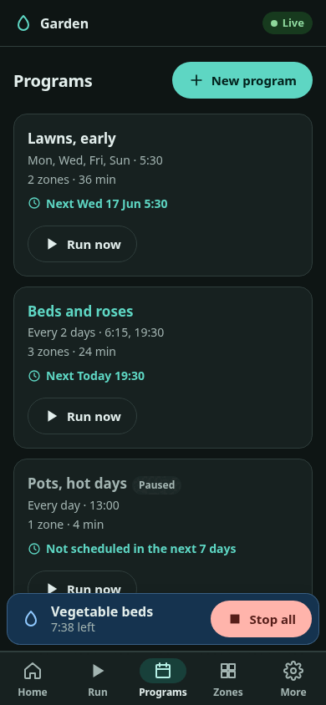
docs/firmware/img/webui/dark-phone-programs.png
