syntroniks/zoneflow/docs/firmware/img/webui/dark-phone-quick-run.png

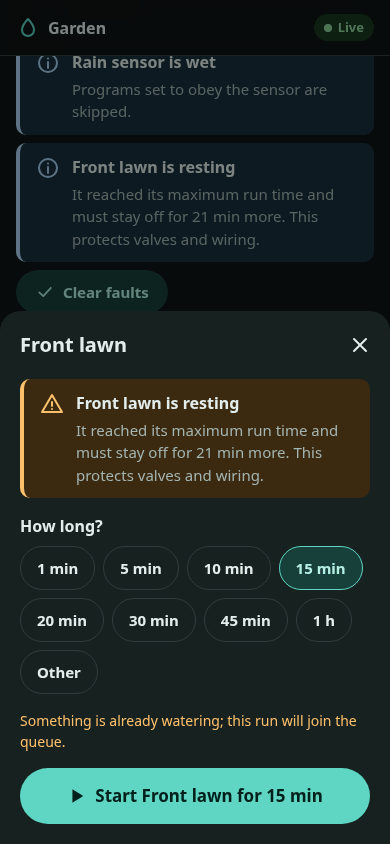
docs/firmware/img/webui/dark-phone-quick-run.png
