syntroniks/zoneflow/docs/firmware/img/webui/dark-phone-rain-delay.png

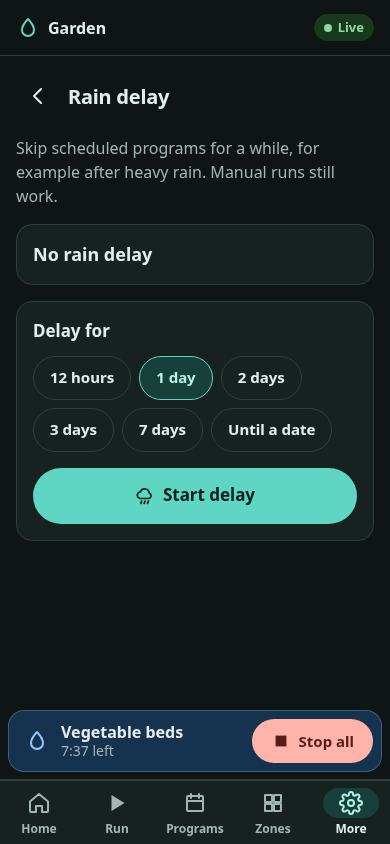
docs/firmware/img/webui/dark-phone-rain-delay.png
