syntroniks/zoneflow/docs/firmware/img/webui/dark-phone-run.png

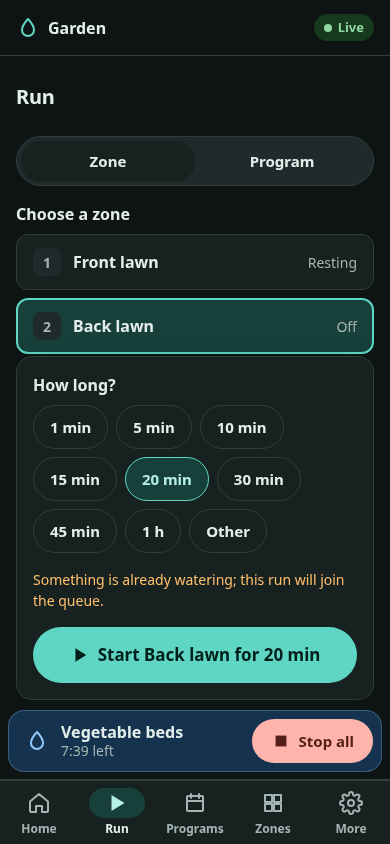
docs/firmware/img/webui/dark-phone-run.png
