syntroniks/zoneflow/docs/firmware/img/webui/dark-phone-settings-backup.png

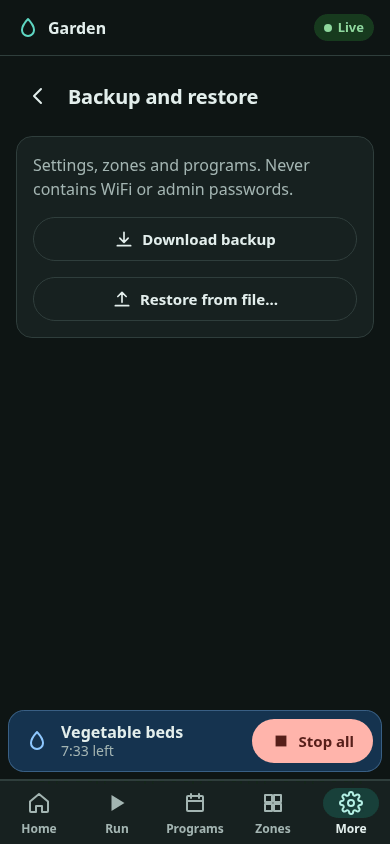
docs/firmware/img/webui/dark-phone-settings-backup.png
