syntroniks/zoneflow/docs/firmware/img/webui/dark-phone-settings-device.png

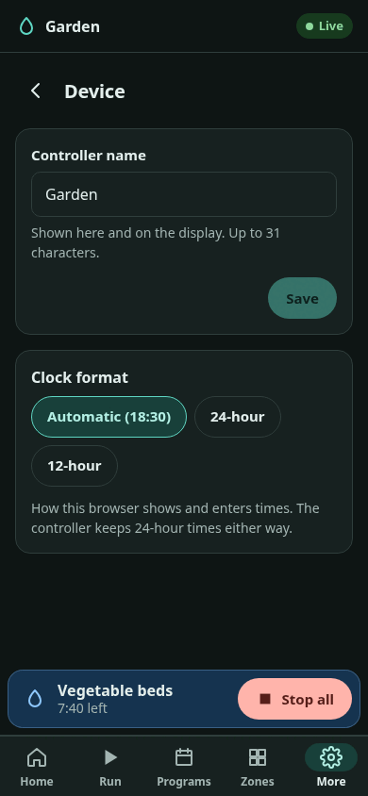
docs/firmware/img/webui/dark-phone-settings-device.png
