syntroniks/zoneflow/docs/firmware/img/webui/dark-phone-settings-firmware.png

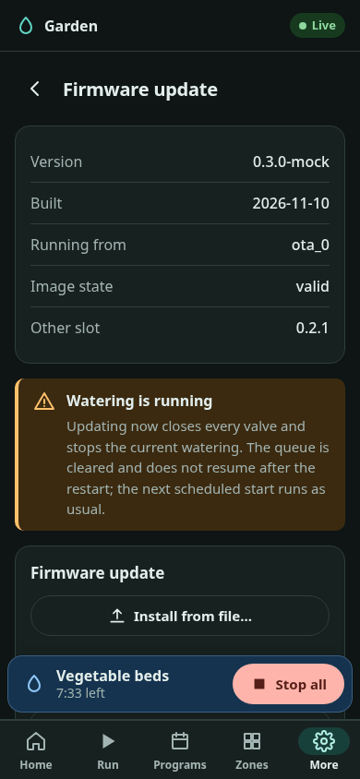
docs/firmware/img/webui/dark-phone-settings-firmware.png
