syntroniks/zoneflow/docs/firmware/img/webui/dark-phone-settings-mqtt.png

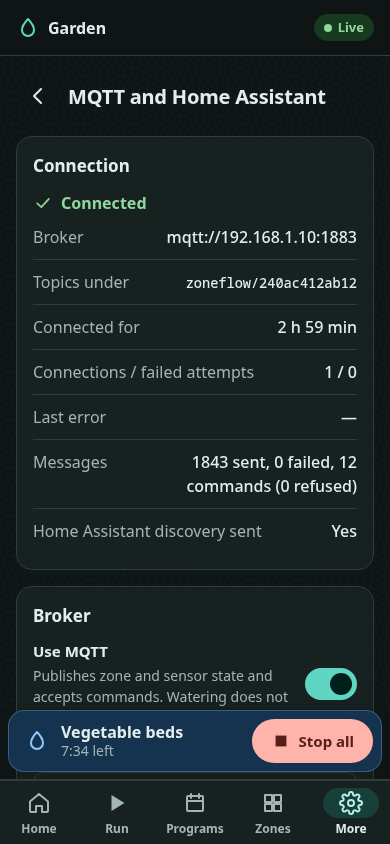
docs/firmware/img/webui/dark-phone-settings-mqtt.png
