syntroniks/zoneflow/docs/firmware/img/webui/dark-phone-settings-network.png

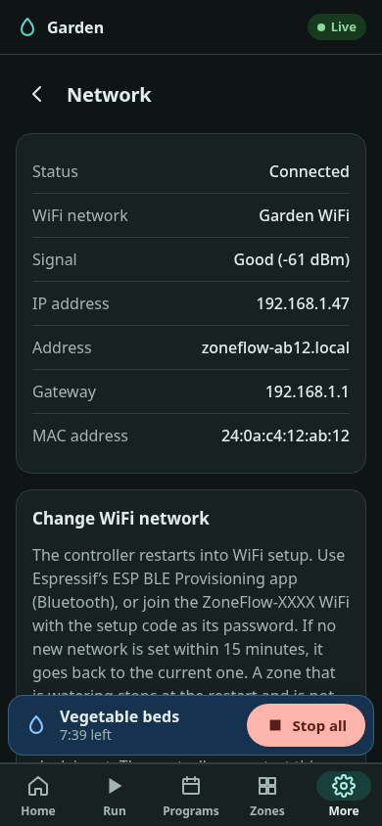
docs/firmware/img/webui/dark-phone-settings-network.png
