syntroniks/zoneflow/docs/firmware/img/webui/dark-phone-settings-security.png

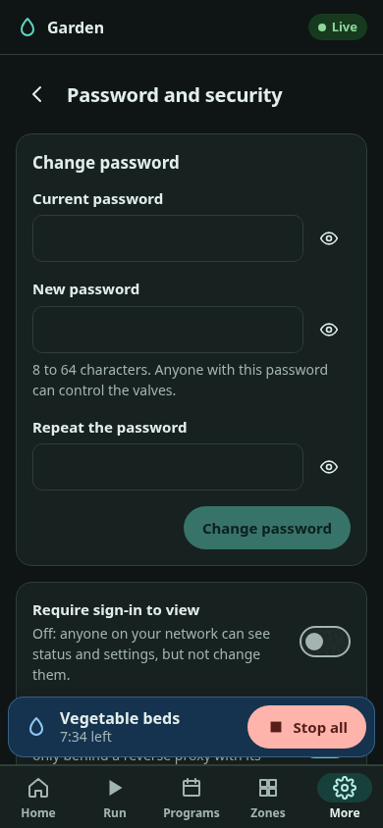
docs/firmware/img/webui/dark-phone-settings-security.png
