syntroniks/zoneflow/docs/firmware/img/webui/dark-phone-settings-sensors.png

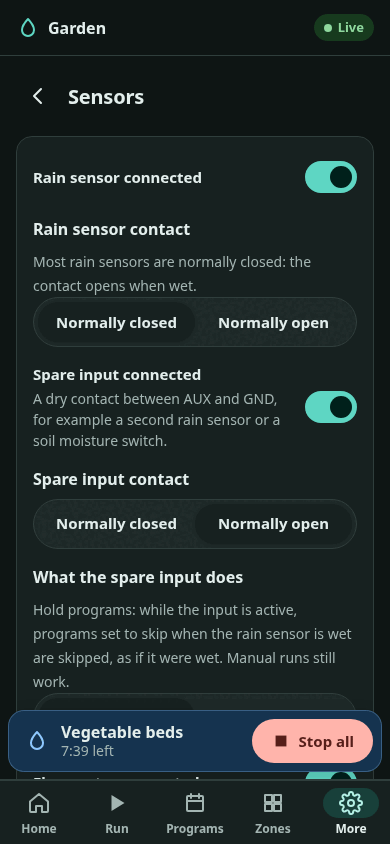
docs/firmware/img/webui/dark-phone-settings-sensors.png
