syntroniks/zoneflow/docs/firmware/img/webui/dark-phone-settings-system.png

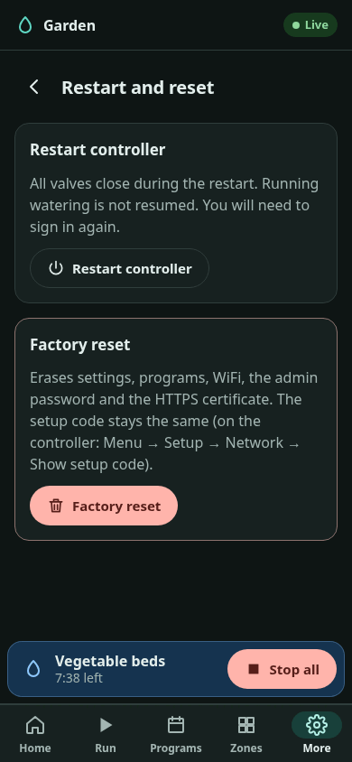
docs/firmware/img/webui/dark-phone-settings-system.png
