syntroniks/zoneflow/docs/firmware/img/webui/dark-phone-settings-time.png

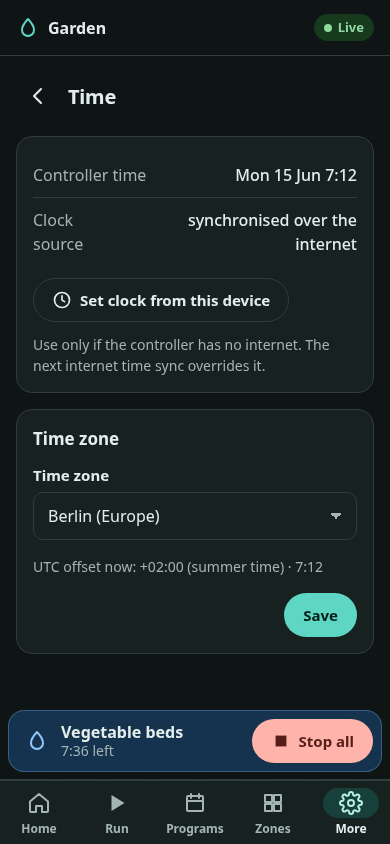
docs/firmware/img/webui/dark-phone-settings-time.png
