syntroniks/zoneflow/docs/firmware/img/webui/dark-phone-settings-watering.png

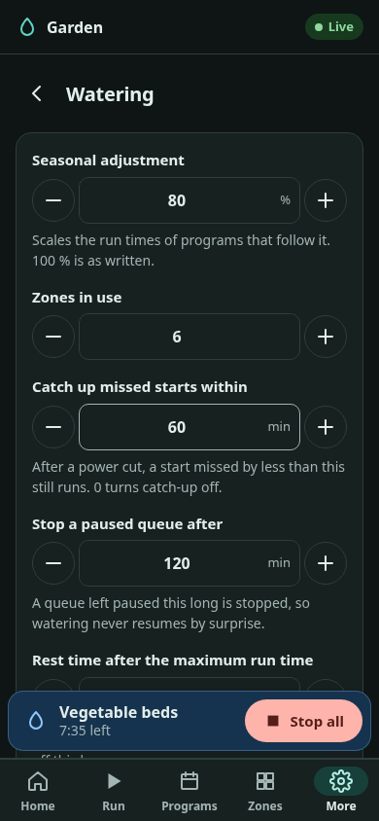
docs/firmware/img/webui/dark-phone-settings-watering.png
