syntroniks/zoneflow/docs/firmware/img/webui/dark-phone-zone-detail.png

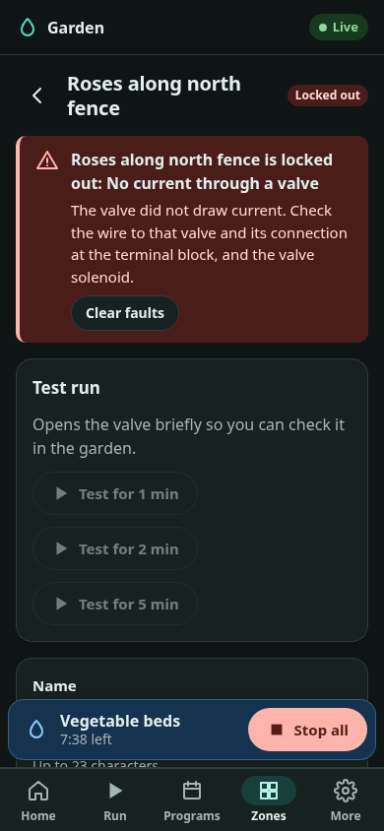
docs/firmware/img/webui/dark-phone-zone-detail.png
