syntroniks/zoneflow/docs/firmware/img/webui/dark-phone-zones.png

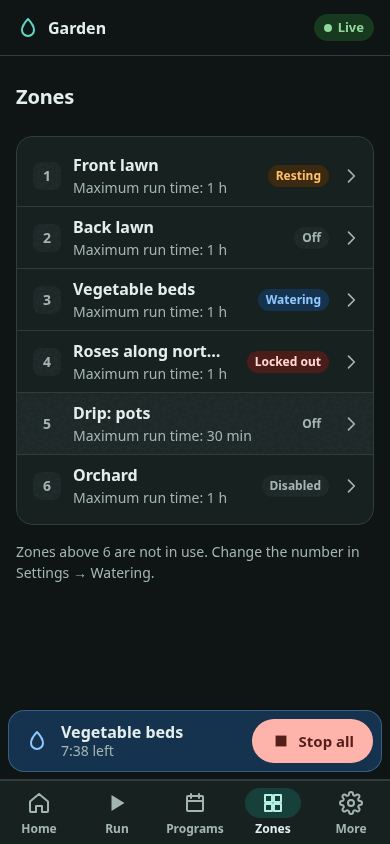
docs/firmware/img/webui/dark-phone-zones.png
