syntroniks/zoneflow/docs/firmware/img/webui/light-desktop-about.png

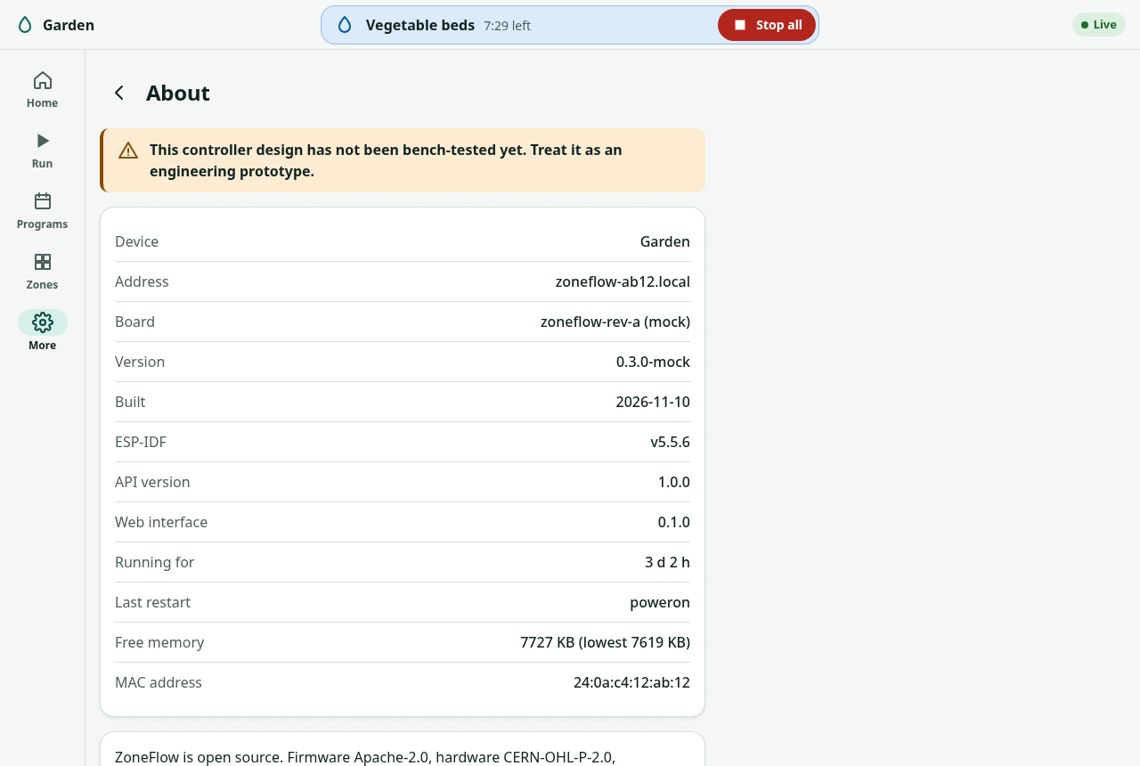
docs/firmware/img/webui/light-desktop-about.png
