syntroniks/zoneflow/docs/firmware/img/webui/light-desktop-confirm-reset.png

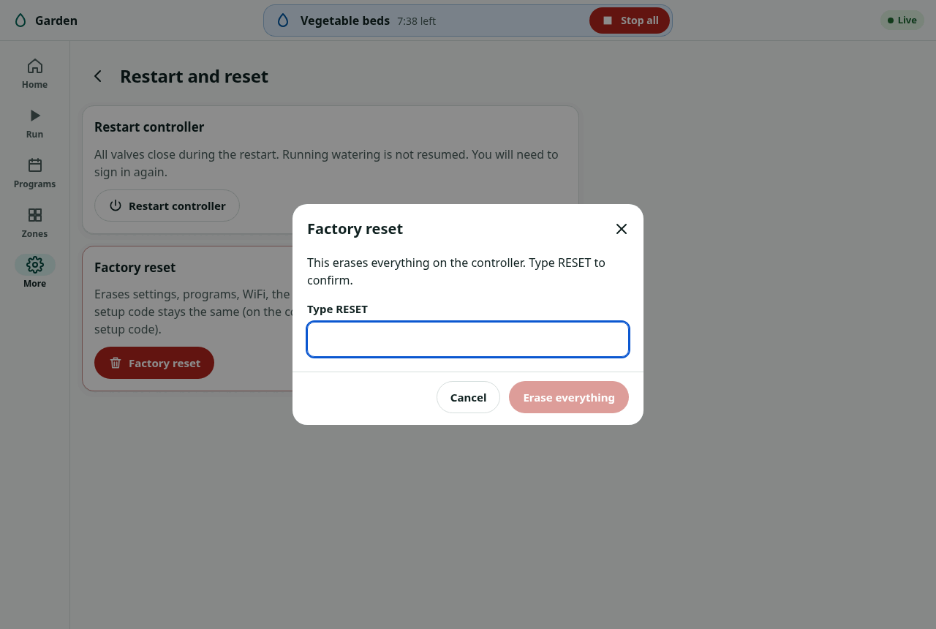
docs/firmware/img/webui/light-desktop-confirm-reset.png
