syntroniks/zoneflow/docs/firmware/img/webui/light-desktop-connection-lost.png

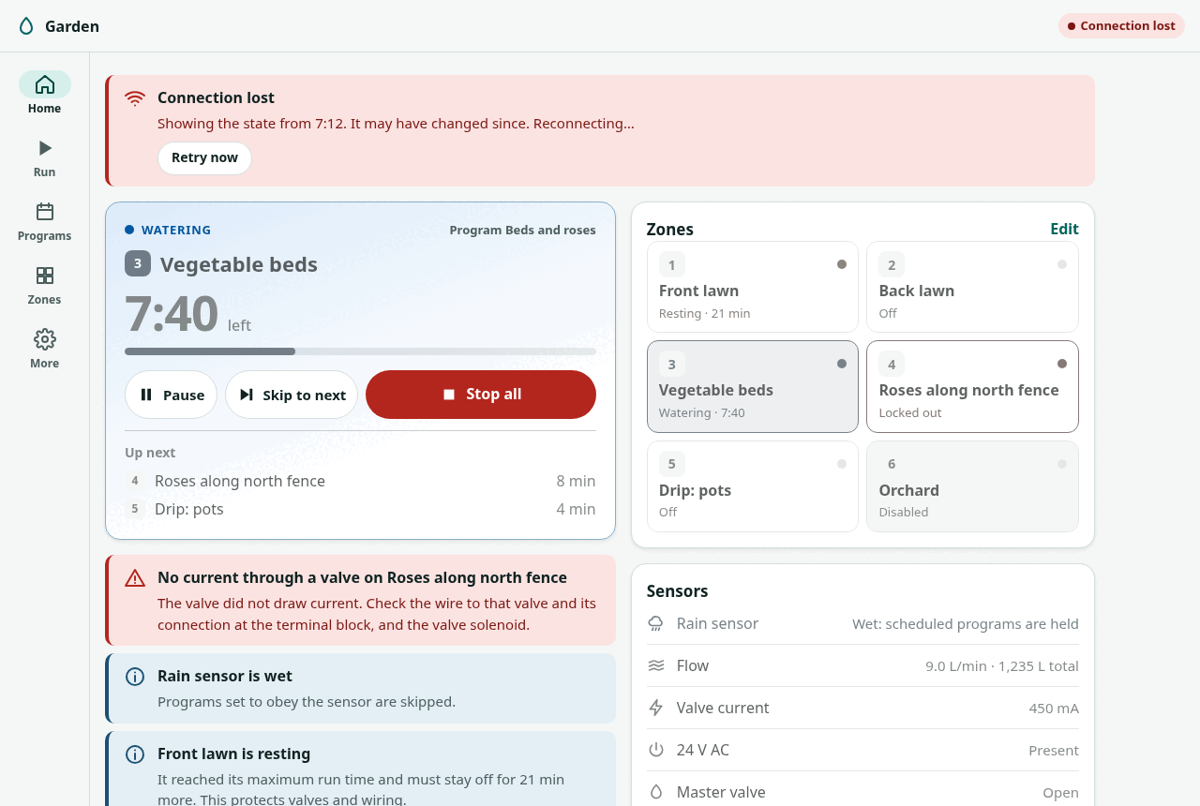
docs/firmware/img/webui/light-desktop-connection-lost.png
