syntroniks/zoneflow/docs/firmware/img/webui/light-desktop-home-faults.png

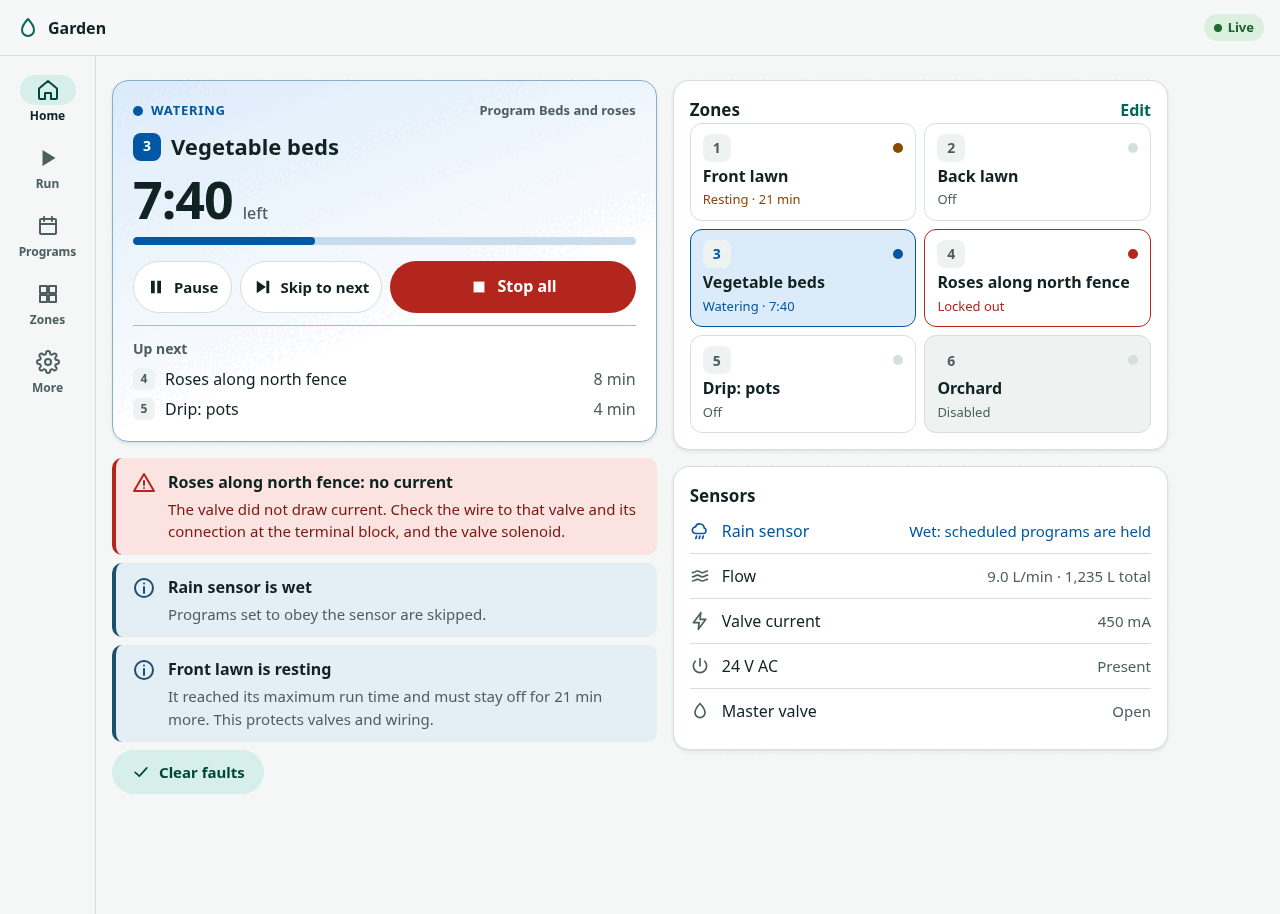
docs/firmware/img/webui/light-desktop-home-faults.png
