syntroniks/zoneflow/docs/firmware/img/webui/light-desktop-home-idle.png

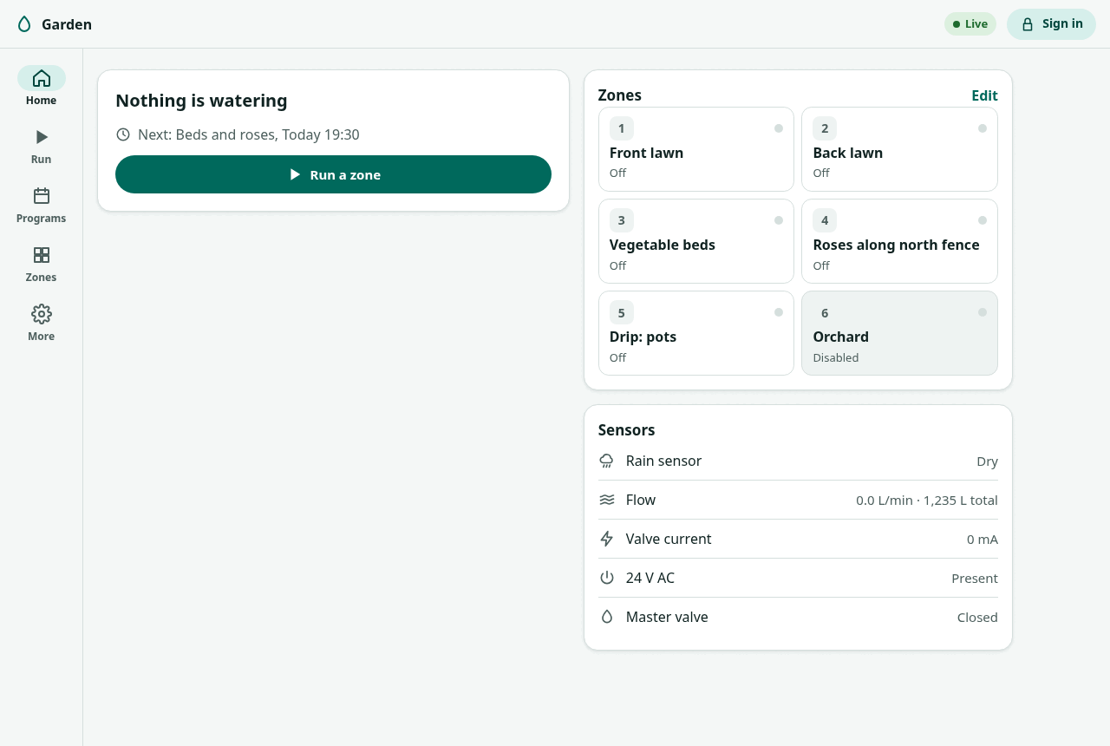
docs/firmware/img/webui/light-desktop-home-idle.png
