syntroniks/zoneflow/docs/firmware/img/webui/light-desktop-home-running.png

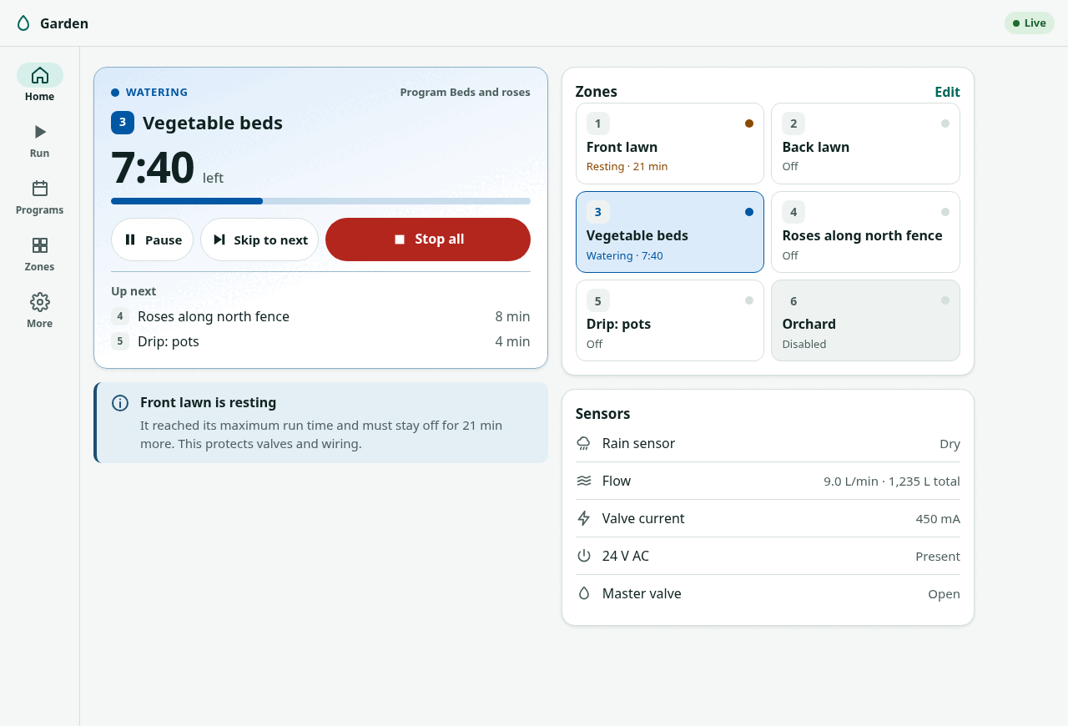
docs/firmware/img/webui/light-desktop-home-running.png
