syntroniks/zoneflow/docs/firmware/img/webui/light-desktop-more.png

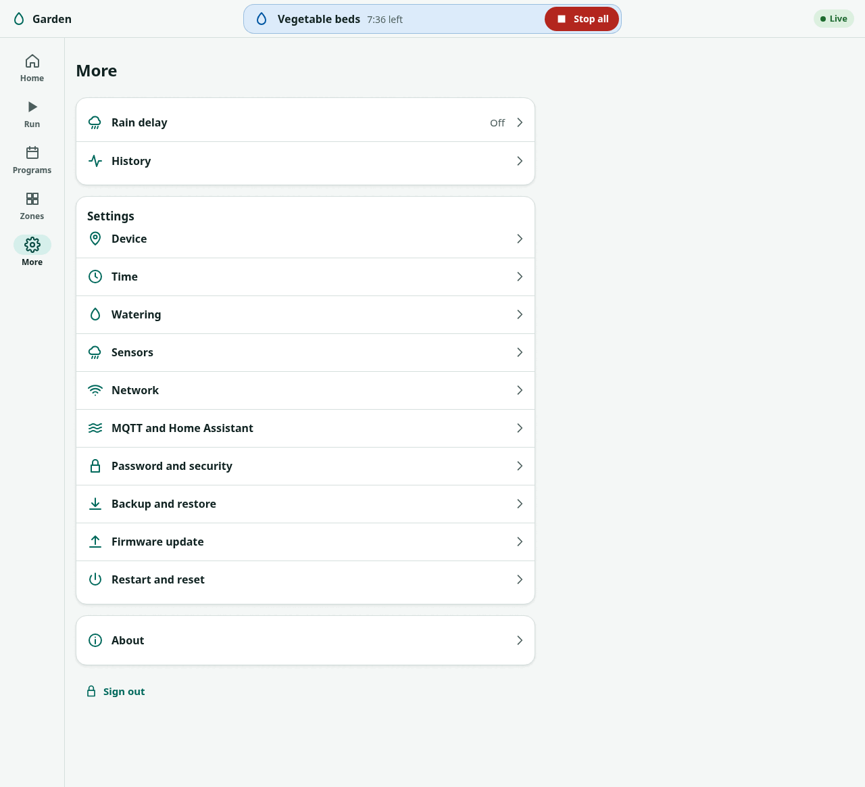
docs/firmware/img/webui/light-desktop-more.png
