syntroniks/zoneflow/docs/firmware/img/webui/light-desktop-programs.png

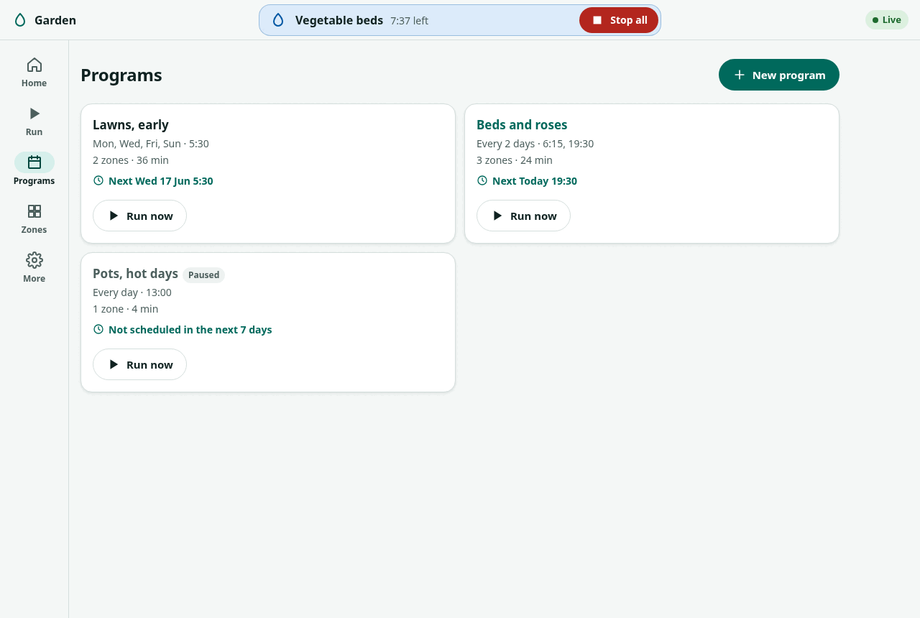
docs/firmware/img/webui/light-desktop-programs.png
