syntroniks/zoneflow/docs/firmware/img/webui/light-desktop-quick-run.png

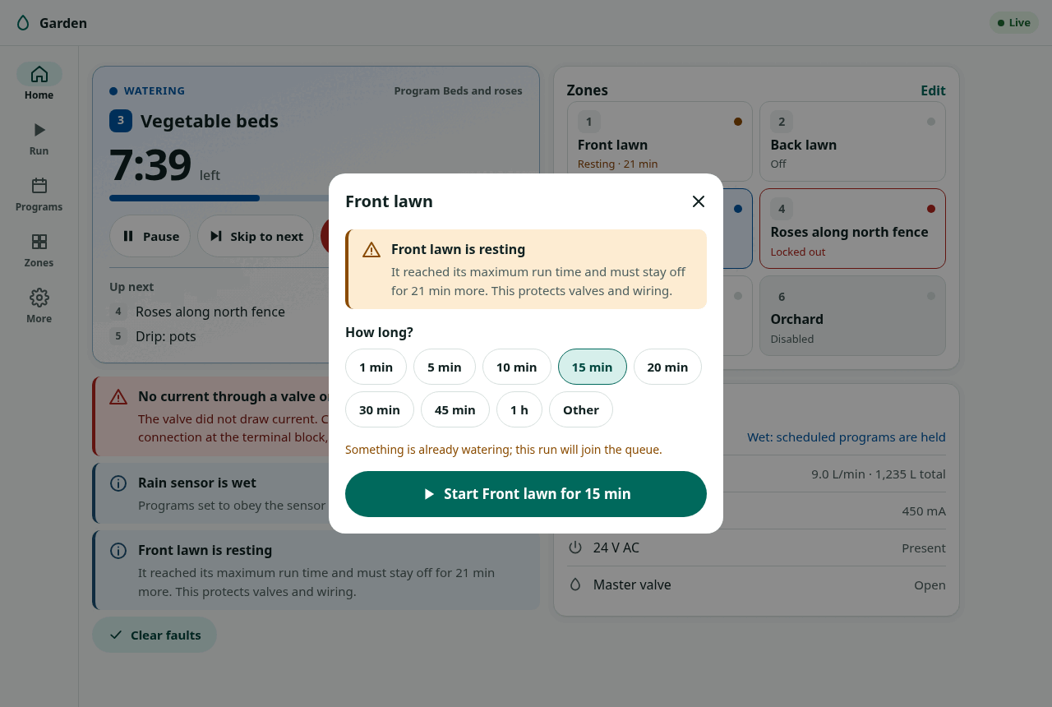
docs/firmware/img/webui/light-desktop-quick-run.png
