syntroniks/zoneflow/docs/firmware/img/webui/light-desktop-rain-delay.png

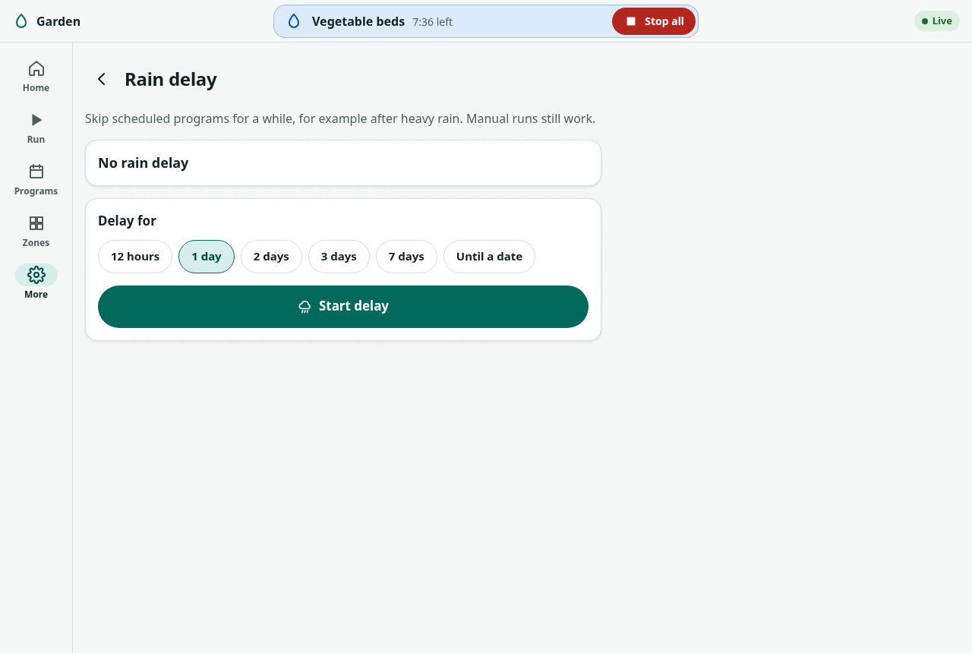
docs/firmware/img/webui/light-desktop-rain-delay.png
