syntroniks/zoneflow/docs/firmware/img/webui/light-desktop-run.png

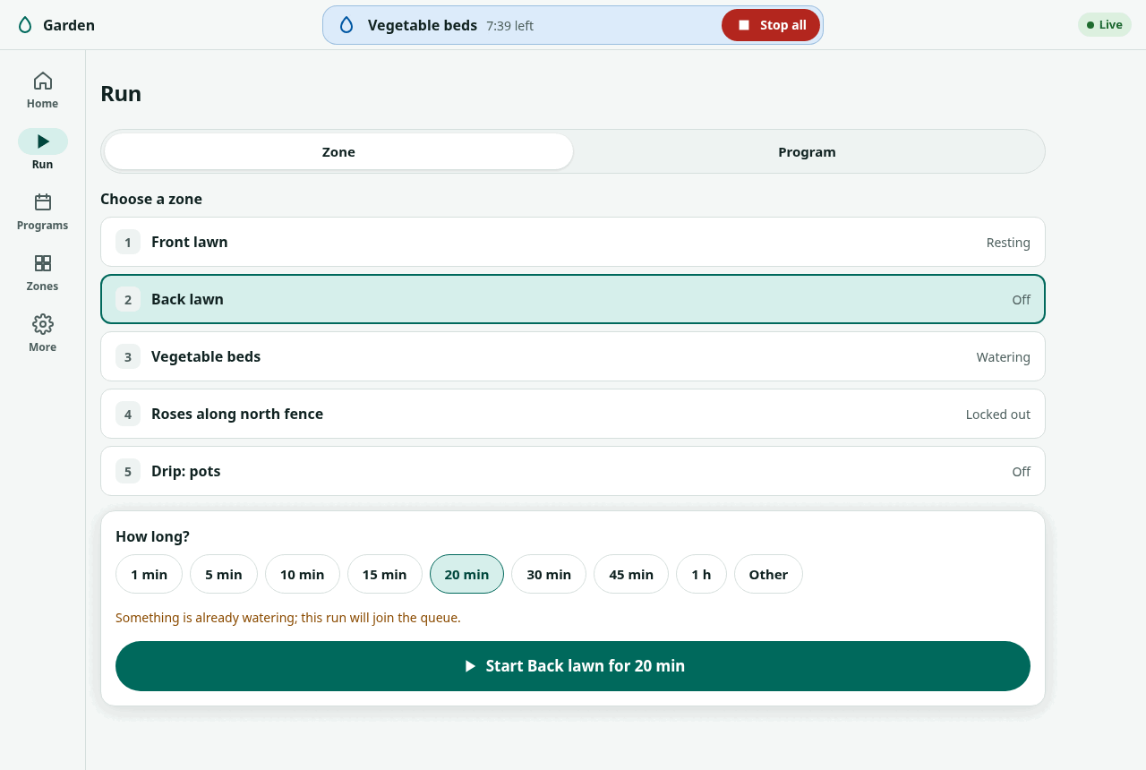
docs/firmware/img/webui/light-desktop-run.png
