syntroniks/zoneflow/docs/firmware/img/webui/light-desktop-settings-backup.png

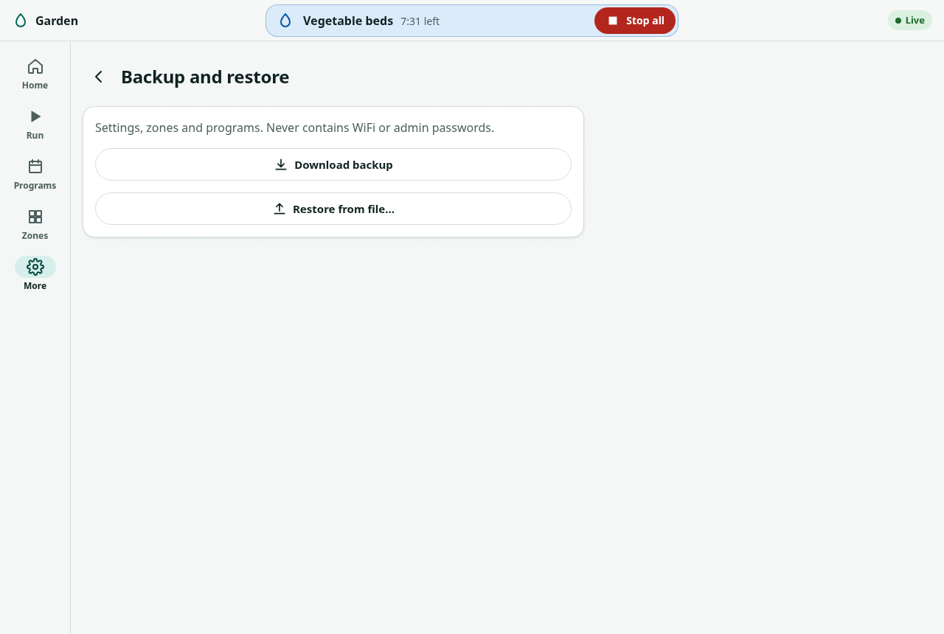
docs/firmware/img/webui/light-desktop-settings-backup.png
