syntroniks/zoneflow/docs/firmware/img/webui/light-desktop-settings-device.png

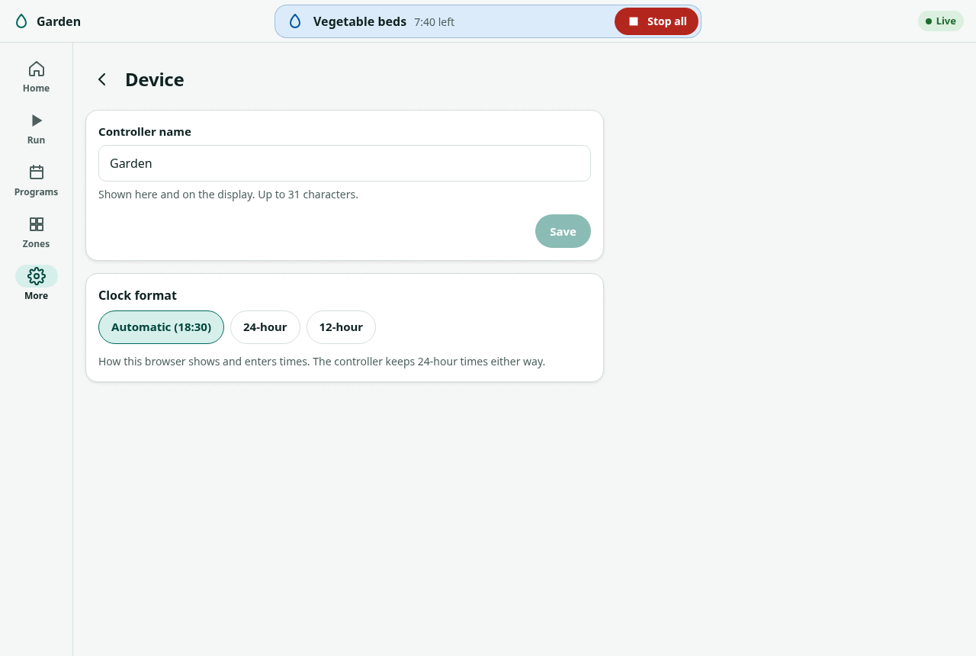
docs/firmware/img/webui/light-desktop-settings-device.png
