syntroniks/zoneflow/docs/firmware/img/webui/light-desktop-settings-firmware.png

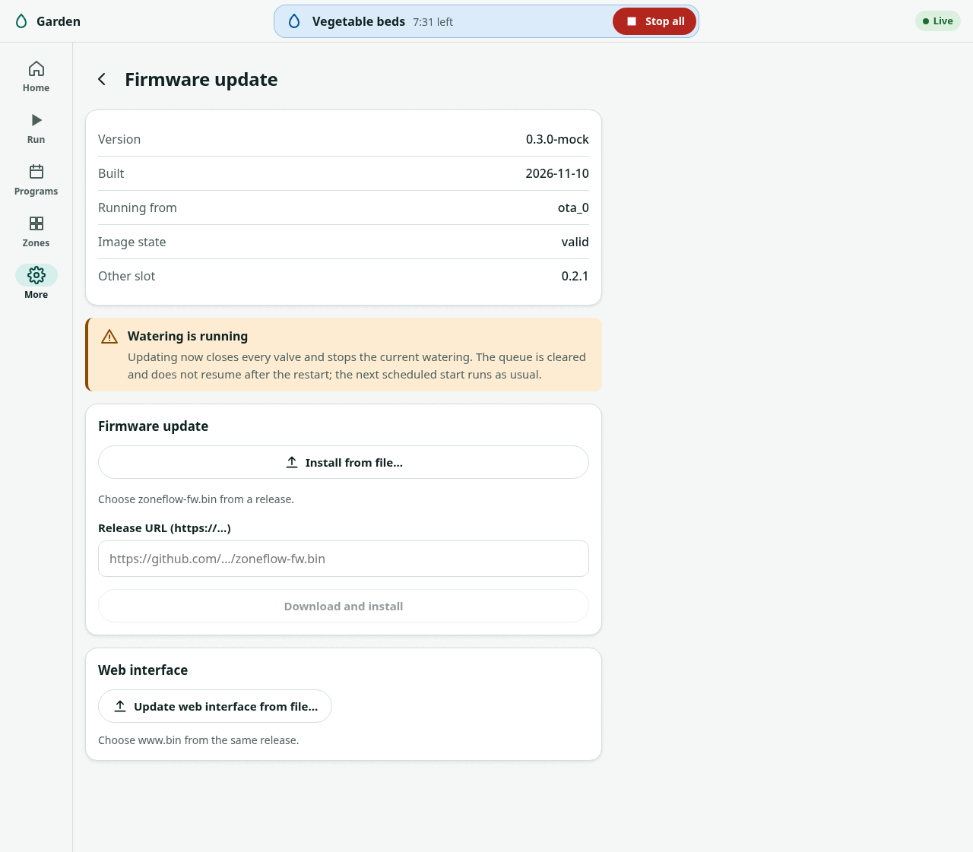
docs/firmware/img/webui/light-desktop-settings-firmware.png
