syntroniks/zoneflow/docs/firmware/img/webui/light-desktop-settings-mqtt.png

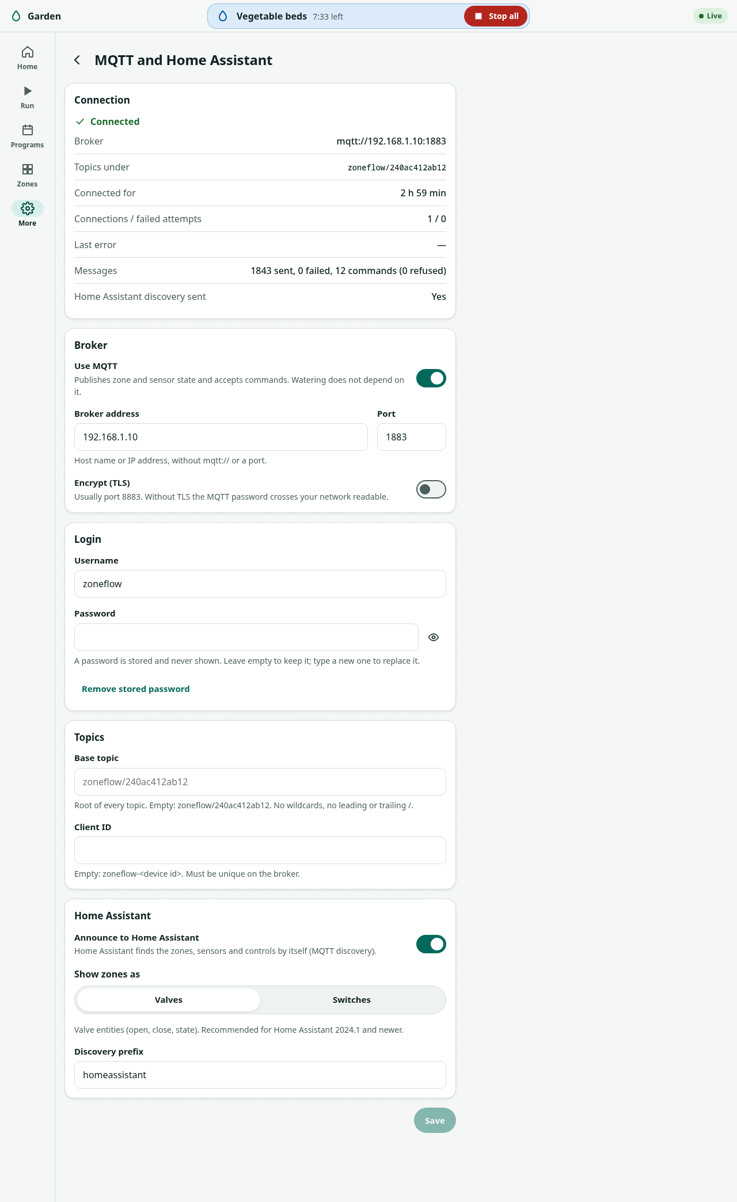
docs/firmware/img/webui/light-desktop-settings-mqtt.png
