syntroniks/zoneflow/docs/firmware/img/webui/light-desktop-settings-network.png

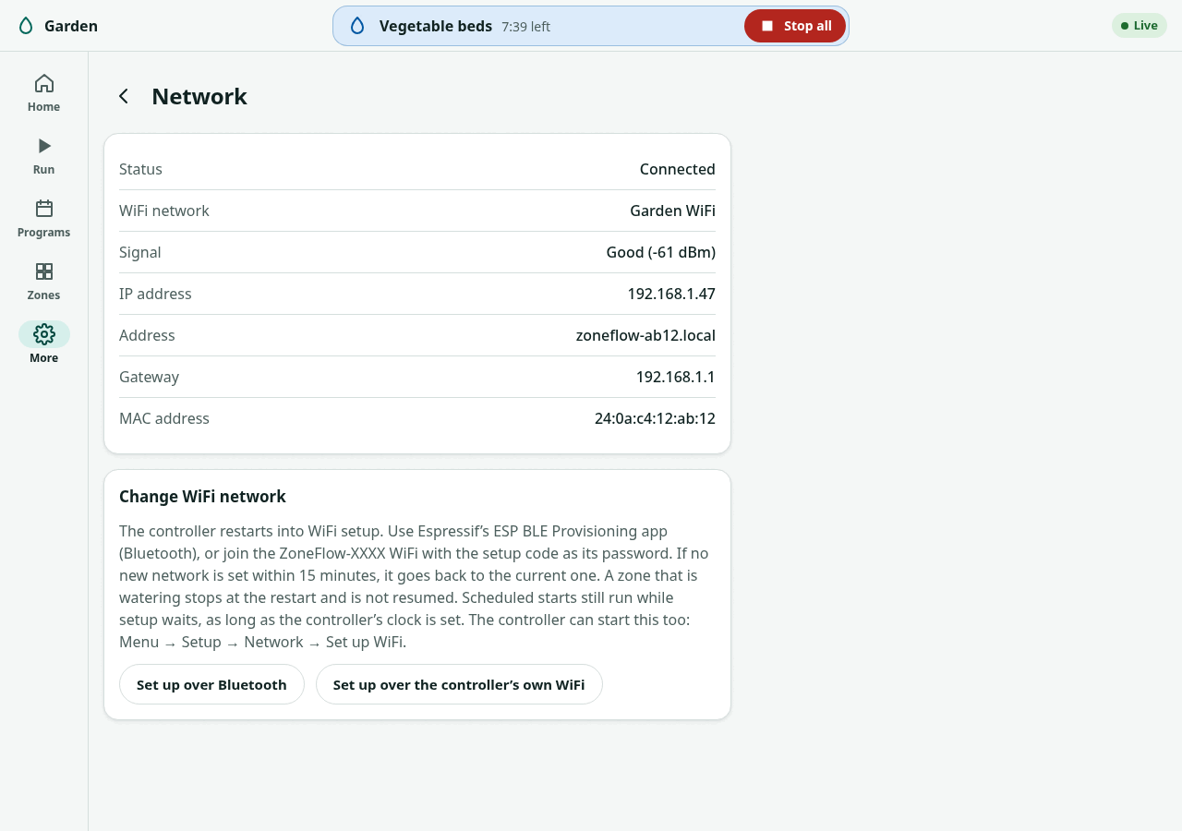
docs/firmware/img/webui/light-desktop-settings-network.png
