syntroniks/zoneflow/docs/firmware/img/webui/light-desktop-settings-security.png

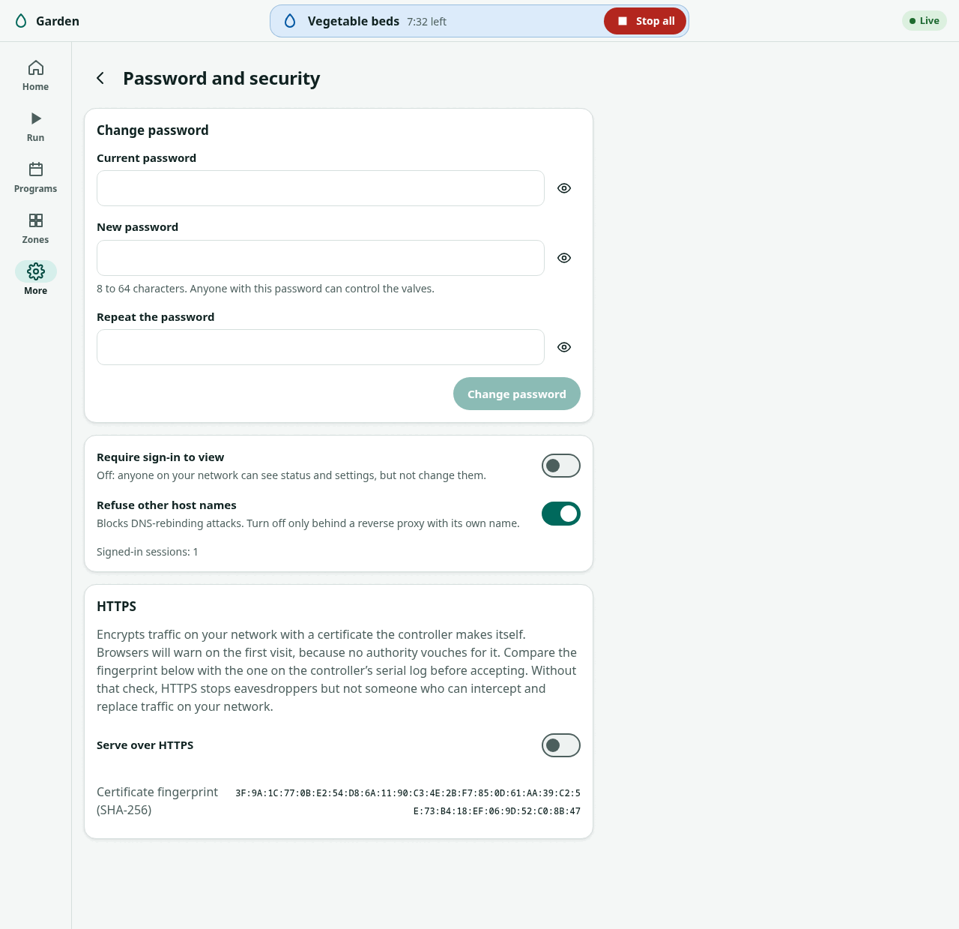
docs/firmware/img/webui/light-desktop-settings-security.png
