syntroniks/zoneflow/docs/firmware/img/webui/light-desktop-settings-sensors.png

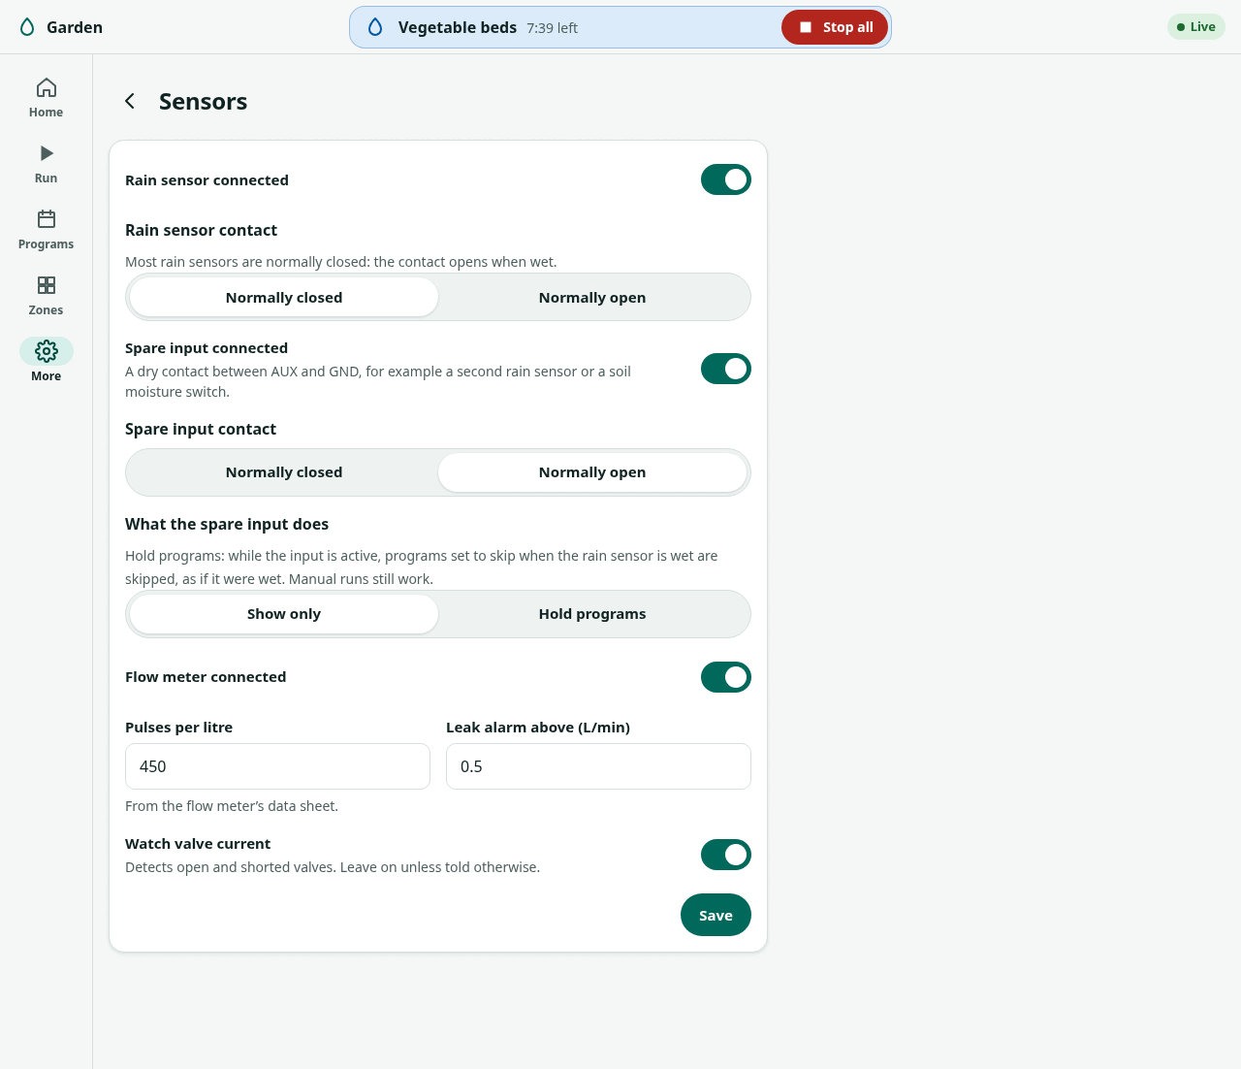
docs/firmware/img/webui/light-desktop-settings-sensors.png
