syntroniks/zoneflow/docs/firmware/img/webui/light-desktop-settings-system.png

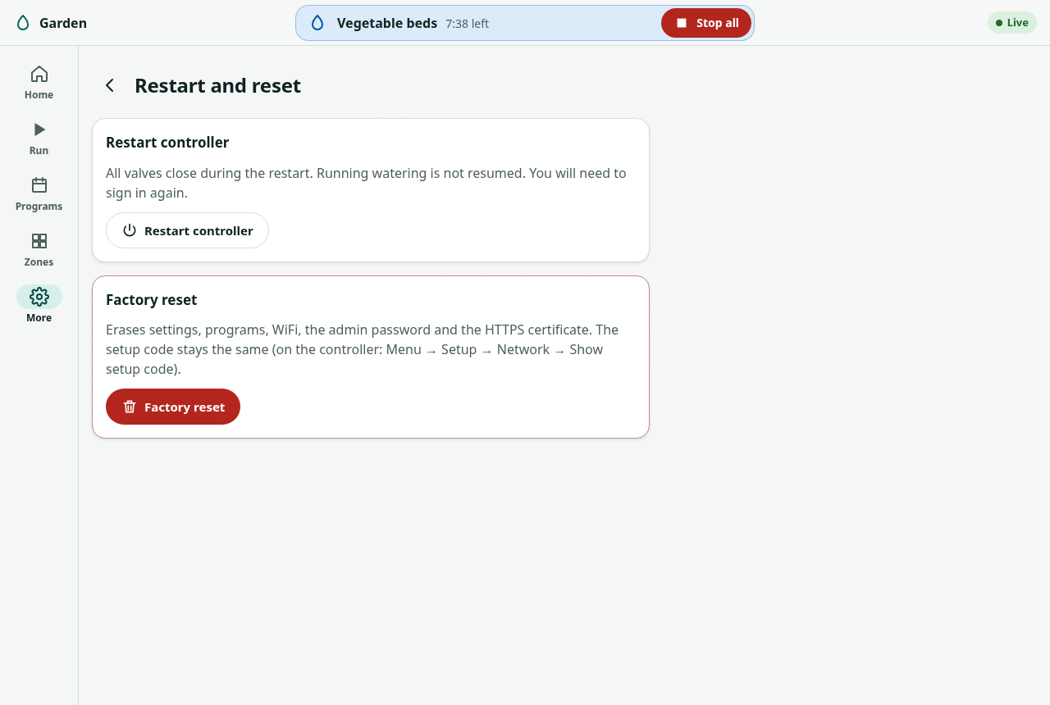
docs/firmware/img/webui/light-desktop-settings-system.png
