syntroniks/zoneflow/docs/firmware/img/webui/light-desktop-settings-time.png

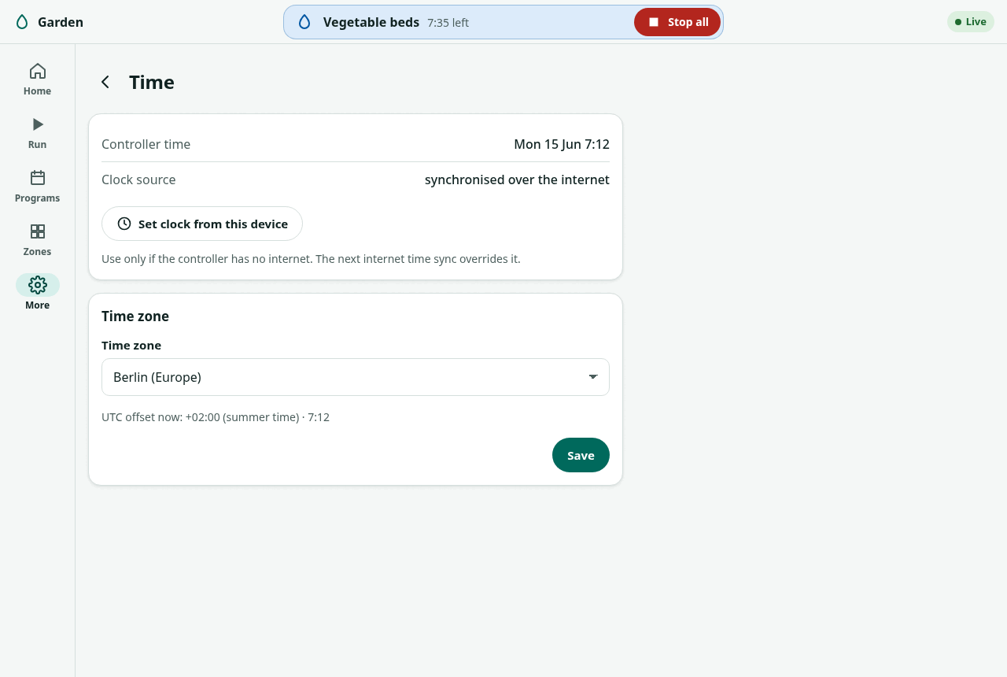
docs/firmware/img/webui/light-desktop-settings-time.png
