syntroniks/zoneflow/docs/firmware/img/webui/light-desktop-settings-watering.png

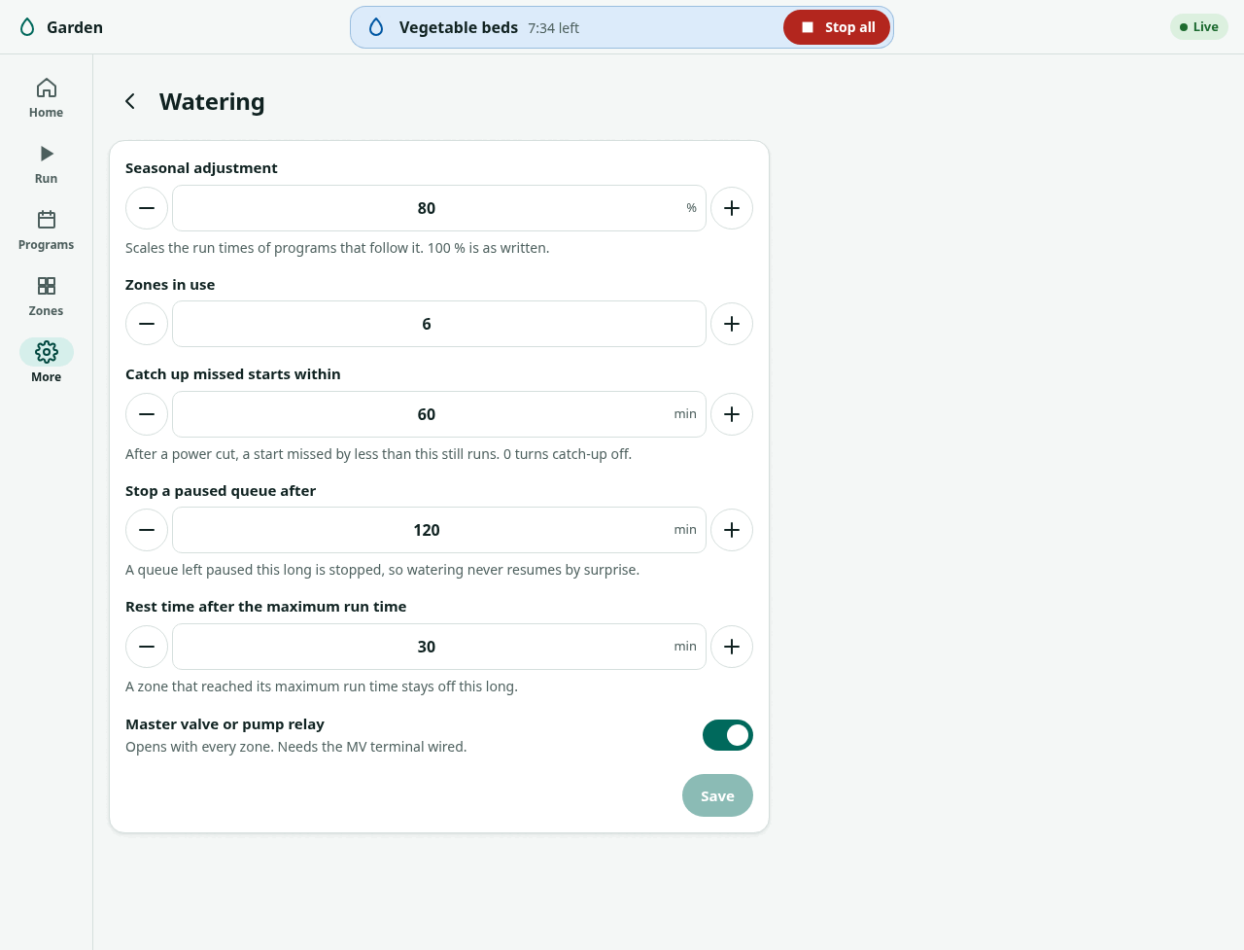
docs/firmware/img/webui/light-desktop-settings-watering.png
