syntroniks/zoneflow/docs/firmware/img/webui/light-desktop-zone-detail.png

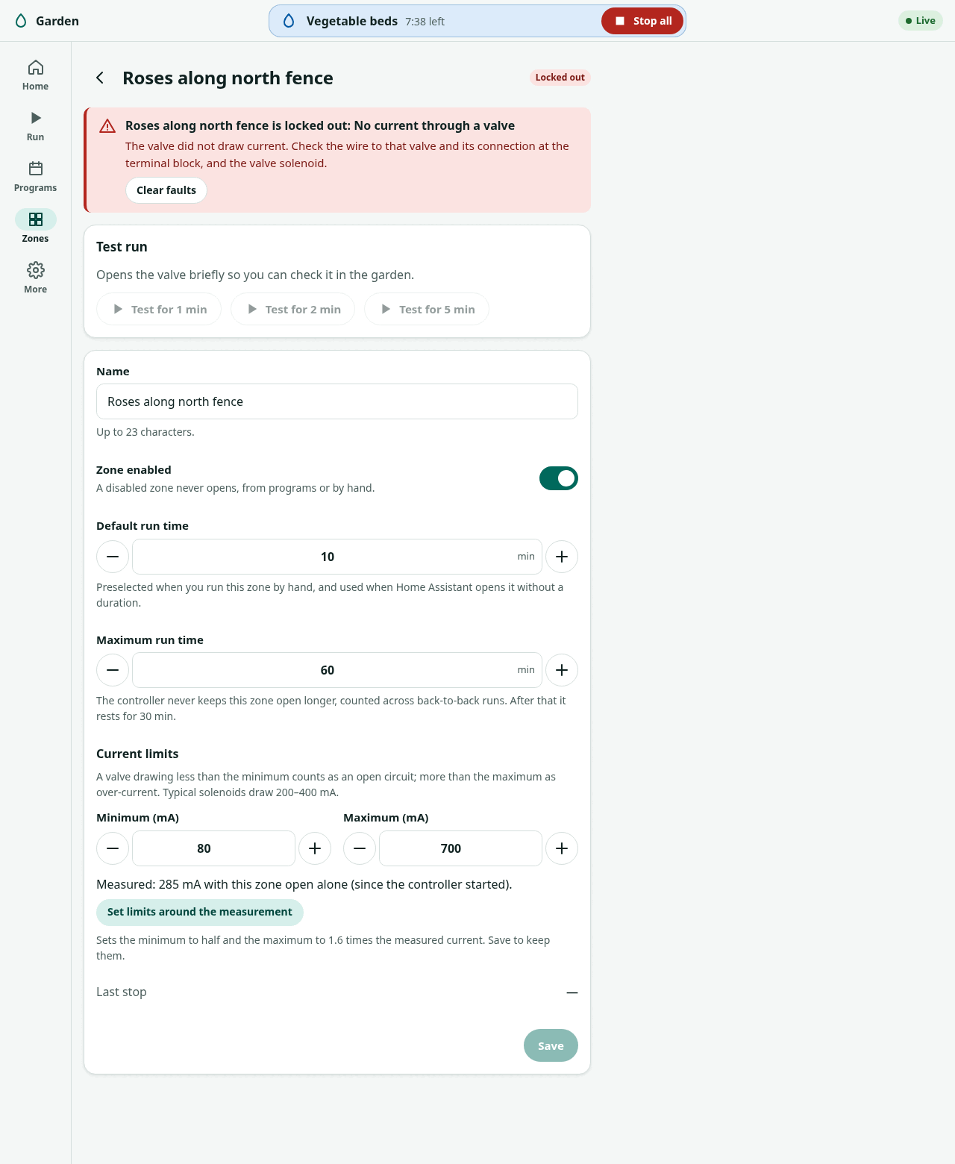
docs/firmware/img/webui/light-desktop-zone-detail.png
