syntroniks/zoneflow/docs/firmware/img/webui/light-desktop-zones.png

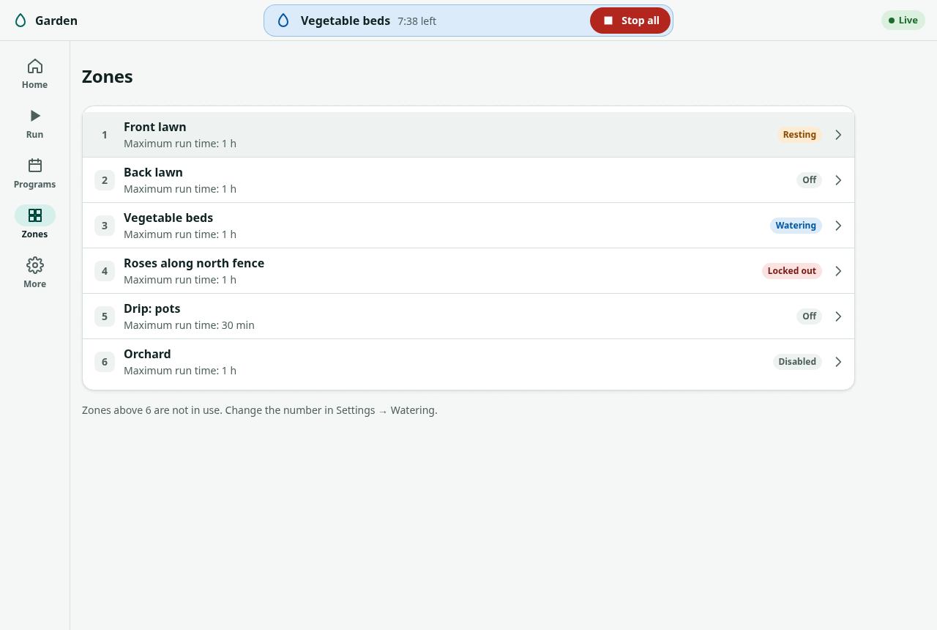
docs/firmware/img/webui/light-desktop-zones.png
