syntroniks/zoneflow/docs/firmware/img/webui/light-phone-about.png

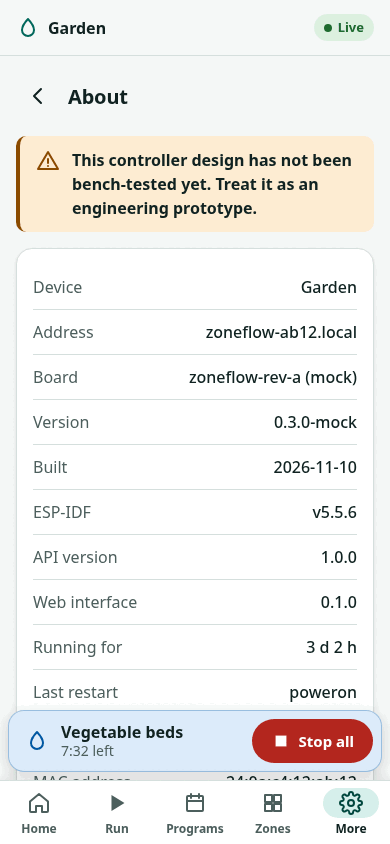
docs/firmware/img/webui/light-phone-about.png
