syntroniks/zoneflow/docs/firmware/img/webui/light-phone-connection-lost.png

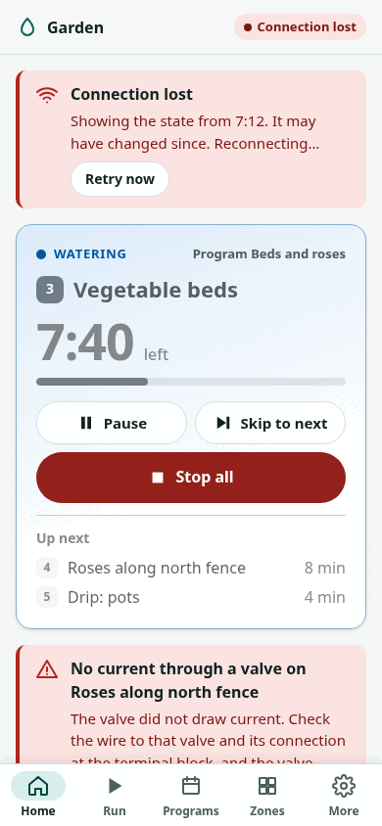
docs/firmware/img/webui/light-phone-connection-lost.png
