syntroniks/zoneflow/docs/firmware/img/webui/light-phone-home-faults.png

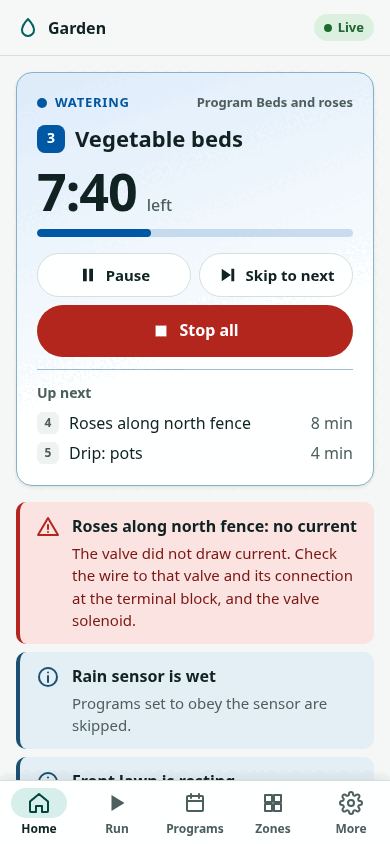
docs/firmware/img/webui/light-phone-home-faults.png
