syntroniks/zoneflow/docs/firmware/img/webui/light-phone-home-idle.png

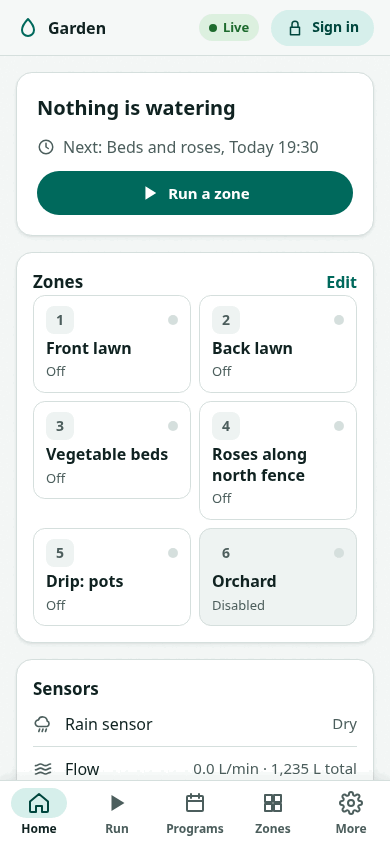
docs/firmware/img/webui/light-phone-home-idle.png
