syntroniks/zoneflow/docs/firmware/img/webui/light-phone-home-running.png

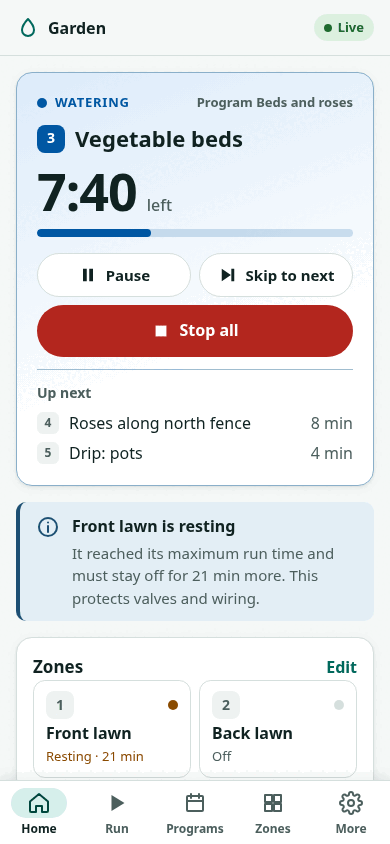
docs/firmware/img/webui/light-phone-home-running.png
