syntroniks/zoneflow/docs/firmware/img/webui/light-phone-more.png

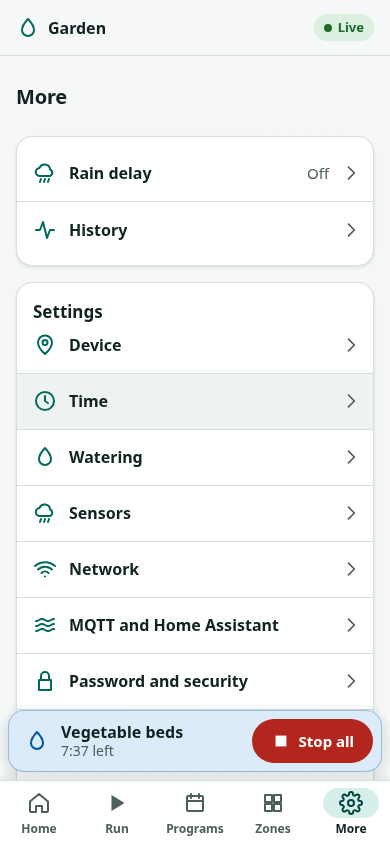
docs/firmware/img/webui/light-phone-more.png
