syntroniks/zoneflow/docs/firmware/img/webui/light-phone-program-edit.png

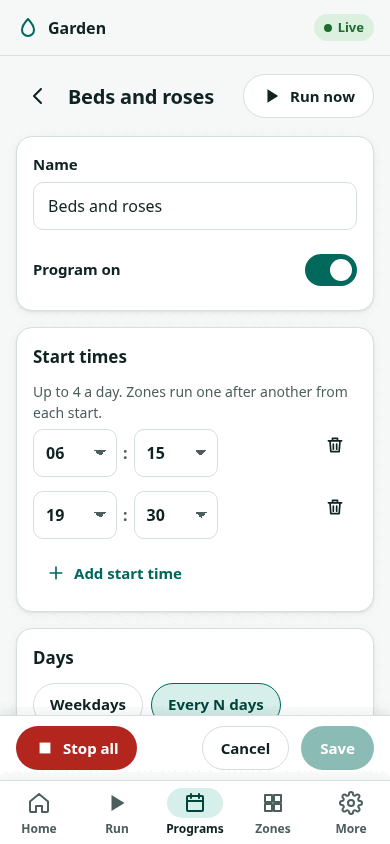
docs/firmware/img/webui/light-phone-program-edit.png
