syntroniks/zoneflow/docs/firmware/img/webui/light-phone-programs.png

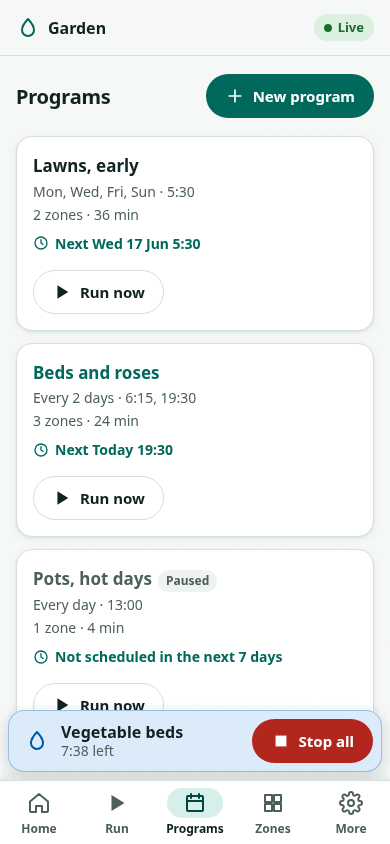
docs/firmware/img/webui/light-phone-programs.png
