syntroniks/zoneflow/docs/firmware/img/webui/light-phone-quick-run.png

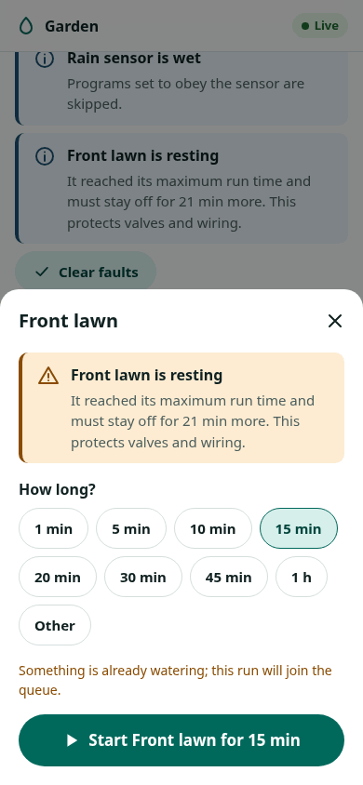
docs/firmware/img/webui/light-phone-quick-run.png
