syntroniks/zoneflow/docs/firmware/img/webui/light-phone-rain-delay.png

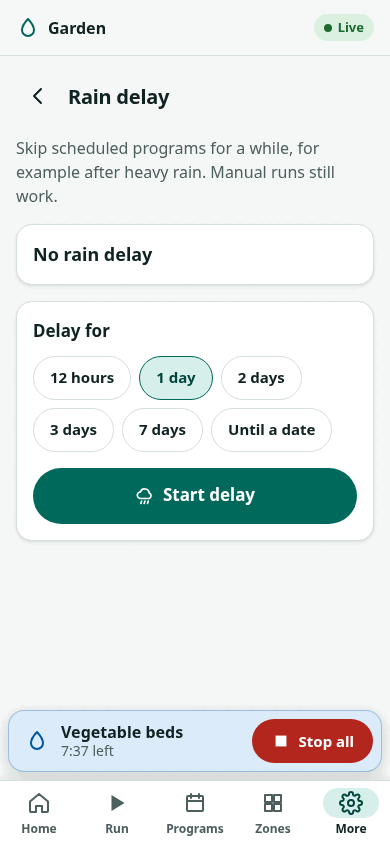
docs/firmware/img/webui/light-phone-rain-delay.png
