syntroniks/zoneflow/docs/firmware/img/webui/light-phone-run.png

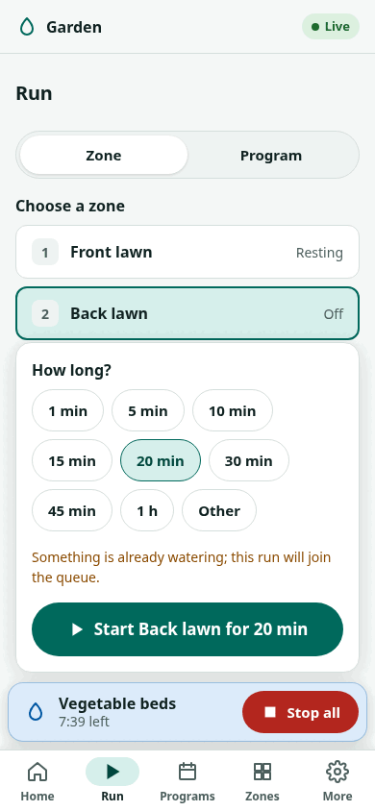
docs/firmware/img/webui/light-phone-run.png
