syntroniks/zoneflow/docs/firmware/img/webui/light-phone-settings-device.png

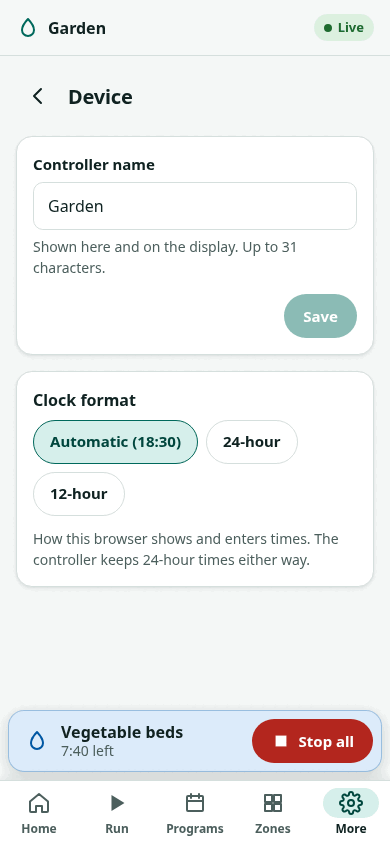
docs/firmware/img/webui/light-phone-settings-device.png
