syntroniks/zoneflow/docs/firmware/img/webui/light-phone-settings-firmware.png

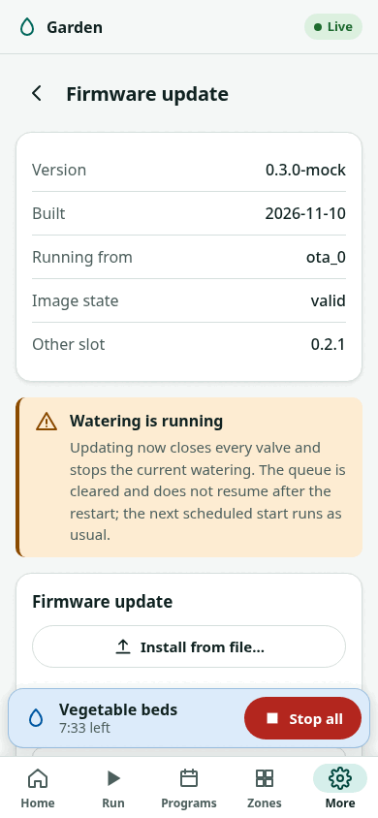
docs/firmware/img/webui/light-phone-settings-firmware.png
