syntroniks/zoneflow/docs/firmware/img/webui/light-phone-settings-mqtt.png

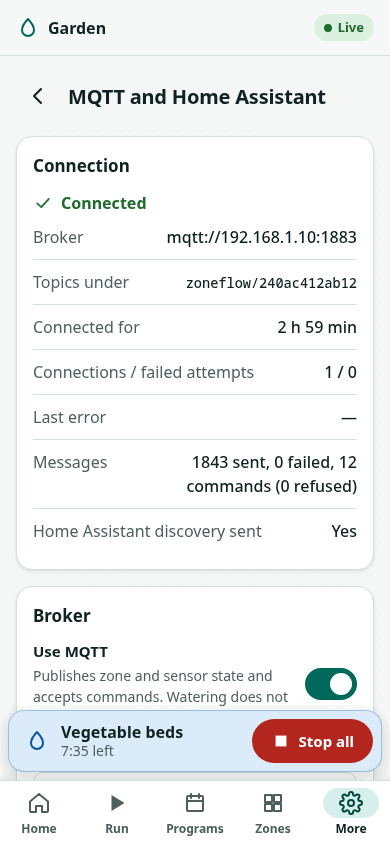
docs/firmware/img/webui/light-phone-settings-mqtt.png
