syntroniks/zoneflow/docs/firmware/img/webui/light-phone-settings-network.png

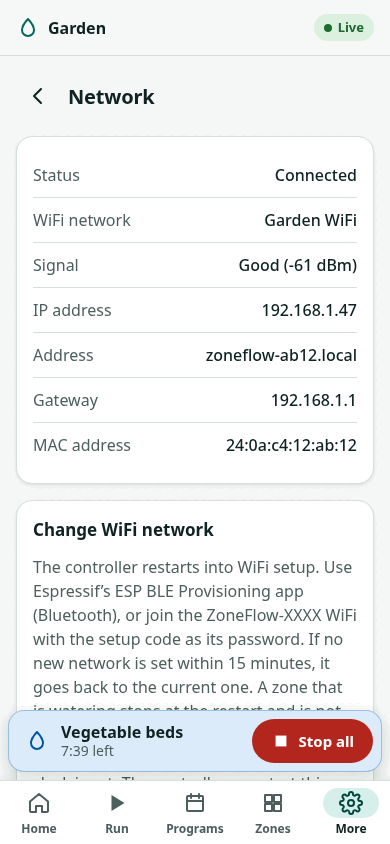
docs/firmware/img/webui/light-phone-settings-network.png
