syntroniks/zoneflow/docs/firmware/img/webui/light-phone-settings-security.png

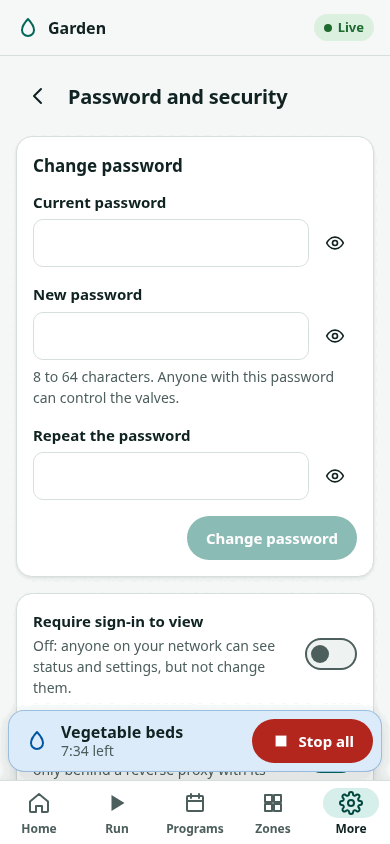
docs/firmware/img/webui/light-phone-settings-security.png
