syntroniks/zoneflow/docs/firmware/img/webui/light-phone-settings-sensors.png

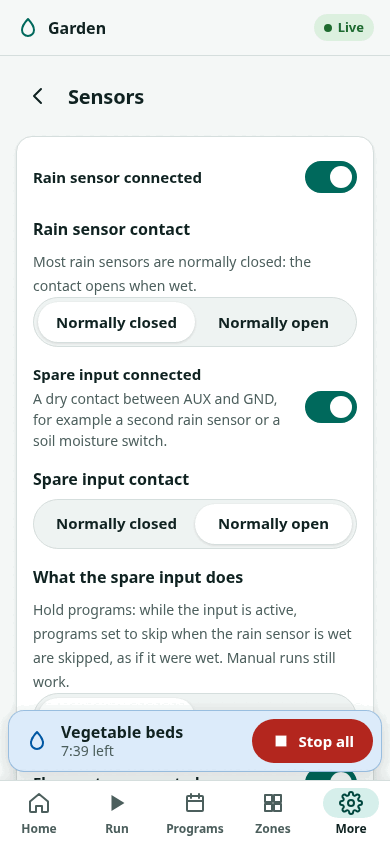
docs/firmware/img/webui/light-phone-settings-sensors.png
