syntroniks/zoneflow/docs/firmware/img/webui/light-phone-settings-system.png

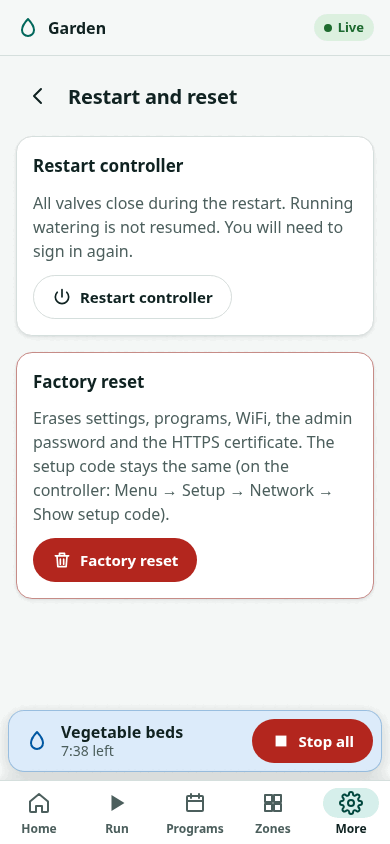
docs/firmware/img/webui/light-phone-settings-system.png
