syntroniks/zoneflow/docs/firmware/img/webui/light-phone-settings-time.png

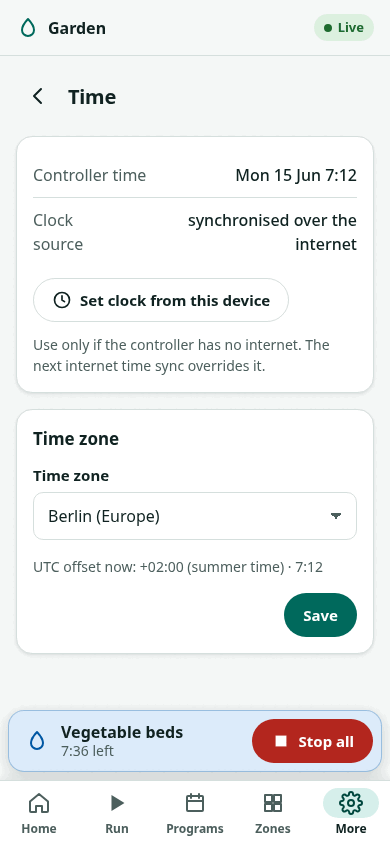
docs/firmware/img/webui/light-phone-settings-time.png
