syntroniks/zoneflow/docs/firmware/img/webui/light-phone-settings-watering.png

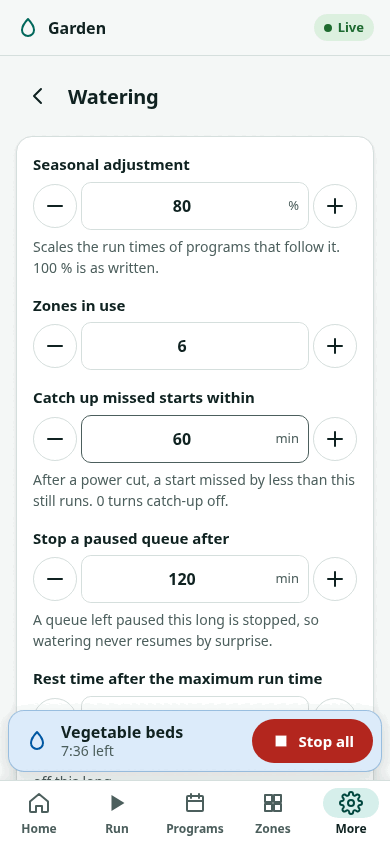
docs/firmware/img/webui/light-phone-settings-watering.png
