syntroniks/zoneflow/docs/firmware/img/webui/light-phone-zones.png

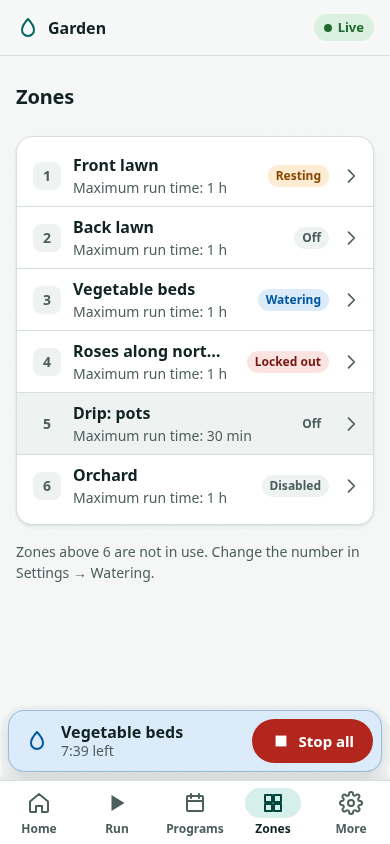
docs/firmware/img/webui/light-phone-zones.png
