syntroniks/zoneflow/hardware/zoneflow-a/output/zoneflow-a-bottom.png

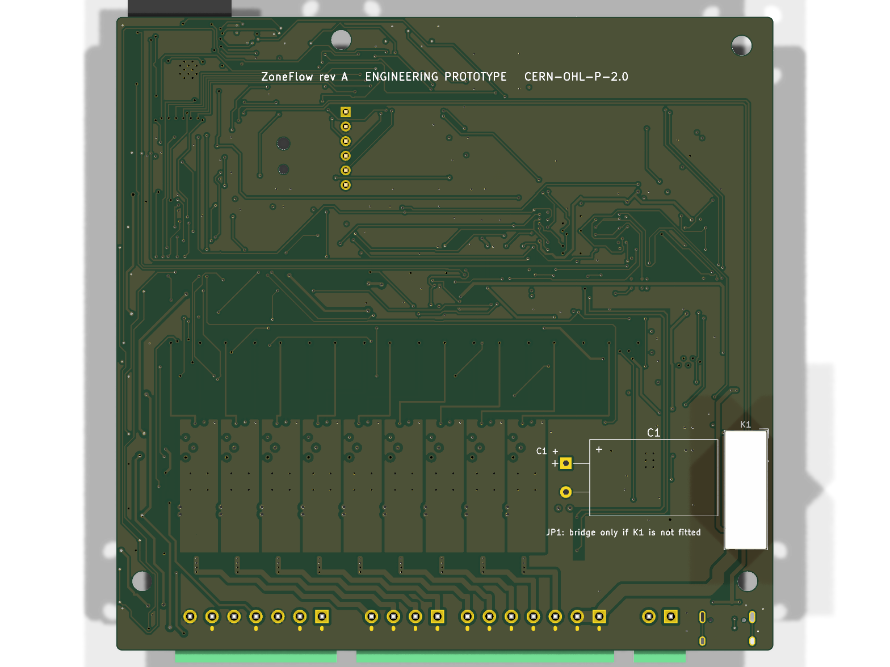
hardware/zoneflow-a/output/zoneflow-a-bottom.png
