syntroniks/zoneflow/hardware/zoneflow-a/output/zoneflow-a-top.png

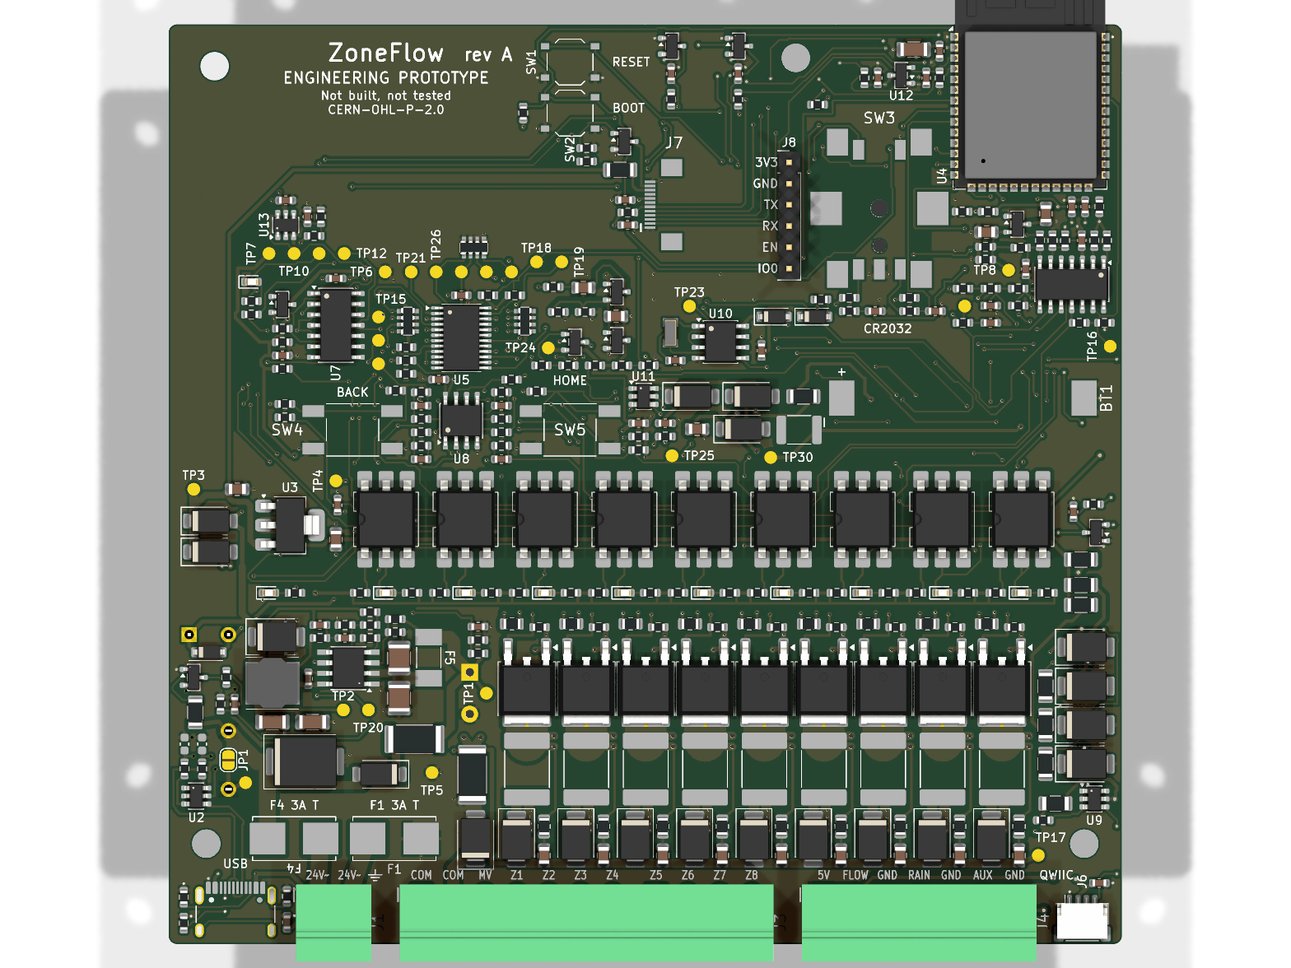
hardware/zoneflow-a/output/zoneflow-a-top.png
