syntroniks/zoneflow/docs/hardware/ordering.md

# Ordering boards

!!! danger "Do not order boards yet"
    The fabrication files exist and pass their checks, and the layout has had
    an [independent review](../design/hardware-layout-review.md). Nobody has
    yet gone through the checklist that review leaves for a person, and the
    design has never been built. A board ordered after the checklist is a
    first prototype: it may not work, and it may be unsafe to connect.

    **The [pre-order review walkthrough](review/index.md) leads you through
    that checklist one step at a time**, with a picture of each place on the
    board, and writes a report at the end.

## What is still missing

| Missing | Why it matters | Tracked in |
|---|---|---|
| The pre-order checklist | The circuit was reviewed twice (reviews A1 and A2) and the layout once, all from files. The layout review ends with [seven things a person must look at](../design/hardware-layout-review.md#17-human-pre-order-checklist) on JLCPCB's order pages, on a 1:1 print and on the screen. The [review walkthrough](review/index.md) turns them, and what else the review could not verify, into 47 steps with pictures. | [Issue #11](https://github.com/syntroniks/zoneflow/issues/11) |
| A prototype and bench tests | Revision A is an engineering prototype until it has been bench-tested. Thermal, short-circuit, surge and fail-safe behaviour are unmeasured. See [status](../status.md#what-only-a-prototype-can-answer). | [Progress log, issue #1](https://github.com/syntroniks/zoneflow/issues/1) |
| An answer on hand-soldered parts | The relay K1 and the bulk capacitor C1 are through-hole parts on the bottom side. Whether JLCPCB will solder them, or the builder does, has not been asked. | [Mechanical design section 12](../design/mechanical.md) |
| A look at the assembler's placement preview | `make cpl-check` compares every placement with the footprint JLCPCB's library holds for the part, and all fit. That proves the files agree with the library. Nobody has seen JLCPCB's own preview of an order. | [Layout review, section 5](../design/hardware-layout-review.md#5-the-placement-file-against-jlcpcbs-library) |
| A quote | Nobody has uploaded these files to a fab. The options below are read from JLCPCB's published limits. | |

## The files

All are in `hardware/zoneflow-a/output/` in the repository, generated by
`make` and committed. See the [PCB layout](layout.md) page for pictures, and
the [cost estimate](cost.md), which is from JLCPCB's published prices and its
online board quote of 2026-11-11 and is not a quote for assembly.

| For | File | 8-zone | 4-zone |
|---|---|---|---|
| The bare board | Gerber and drill files | `gerbers/` | the same board |
| Assembly, parts list | JLCPCB BOM | [`zoneflow-a-bom-jlcpcb.csv`](zoneflow-a/zoneflow-a-bom-jlcpcb.csv) | [`zoneflow-a-bom-jlcpcb-4-zone.csv`](zoneflow-a/zoneflow-a-bom-jlcpcb-4-zone.csv) |
| Assembly, positions | JLCPCB placement file | [`zoneflow-a-cpl-jlcpcb.csv`](zoneflow-a/zoneflow-a-cpl-jlcpcb.csv) | [`zoneflow-a-cpl-jlcpcb-4-zone.csv`](zoneflow-a/zoneflow-a-cpl-jlcpcb-4-zone.csv) |
| Checking the assembler's preview | Where pin 1 of each polarised part is | [`zoneflow-a-pin1.csv`](zoneflow-a/zoneflow-a-pin1.csv) | the same |
| Hand assembly and inspection | Assembly drawings | [top](zoneflow-a/zoneflow-a-assembly-top.pdf), [bottom](zoneflow-a/zoneflow-a-assembly-bottom.pdf) | the same |

## Board options

These are what the layout was drawn for. They are JLCPCB's standard options;
none costs extra according to the limits in `hardware/rules/jlcpcb.toml`,
which were read from JLCPCB's capabilities page and its help article on
extra charges on 2026-11-10 and 2026-11-11.

| Option | Value | Why |
|---|---|---|
| Layers | 4 | |
| Size | 114 x 110 mm | |
| Thickness | 1.6 mm | The mechanical contract |
| Outer copper | 1 oz (35 um) | The valve paths are calculated for it |
| Inner copper | 0.5 oz, the default | Nothing depends on thicker inner copper |
| Smallest hole | 0.3 mm | JLCPCB charges for a smaller hole and then also selects a costlier material and test. The design rules fail on a hole under 0.3 mm |
| Smallest track and gap | 0.10 mm and 0.2 mm | One piece of track 0.4 mm long is 0.10 mm wide, where the autorouter left a pin; three more of 0.2 mm each are 0.12 to 0.19 mm. Everything else is 0.2 mm or wider. The limit in the rules file is 0.10 mm |
| Smallest text | 1.0 mm high, 0.15 mm line | |
| Surface finish | ENIG, recommended by the layout review | The display connector J7 has 0.3 mm lands at 0.5 mm pitch, the USB-C receptacle 0.3 mm lands and the module forty castellations. JLCPCB's quote page gave the same board price for ENIG and HASL on 2026-11-11 |
| Via covering | Tented | The vias in the triac tab lands are in pads and stay open; see the [layout document](../design/hardware-layout.md#72-one-output-column) |

## Assembly

1. Top side only. Every surface-mount part is on the top.
2. The placement files already leave out what the assembler does not place:
   the terminal headers J1 to J4 (through-hole), the bulk capacitor C1 and the
   relay K1 (through-hole, bottom side), and the debug pads J8, which carry no
   part. The BOM still lists C1, K1, J1 to J4 and the display DS1: take those
   lines out in JLCPCB's BOM step.
3. Fit by hand, or ask the assembler: C1 and K1 from the bottom side,
   soldered from the top; J1 to J4 from the top.
4. Run `make cpl-check` in the board directory; it must end with "0 do not
   fit". Then compare the assembler's placement preview with
   `zoneflow-a-pin1.csv` for every polarised part before you confirm. Nobody
   has checked the placement files against a real order. For the six BAT54S
   (D7, D9, D15, D16, D17, D22) go by the pads: JLCPCB's library symbol for
   this part number names the pins as a common-anode pair, which the maker's
   data sheet does not draw; the footprint numbers the pads as every SOT-23
   does ([cost page](cost.md#fewer-extended-part-types)).
5. The board has no fiducial marks and the module overhangs the top edge:
   ask for process edges with fiducials on the two 110 mm sides.
6. Check any part the assembler proposes to substitute against the
   [BOM](bom.md). The display panel has no confirmed second source.
7. The display panel DS1 plugs into J7 at final assembly, and the CR2032 cell
   goes into its holder.

## Stock

Stock was checked again on 2026-11-11 for the [cost estimate](cost.md#components).
No line was short of 100 eight-zone boards. The thinnest were the triac
(3,384 for 900 needed), the 48 V TVS diode (5,782 for 1,402) and the display
panel (413 for 100). Check stock again before you order.
