syntroniks/zoneflow/hardware/bom-preliminary.csv

refs | qty_8zone | qty_4zone | value | package | manufacturer | mpn | lcsc | jlcpcb_library | jlcpcb_stock | usd_each_at_10 | usd_each_at_100 | usd_each_at_1000 | source_url | datasheet_url | datasheet | date_checked | note
J1 | 1 | 1 | Header 2-way 3.81 mm pluggable, right angle | THT | Cixi Kefa Elec | KF2EDGR-3.81-2P | C441182 | extended | 45747 | 0.0537 | 0.0436 | 0.03 | https://www.lcsc.com/product-detail/pluggable-system-terminal-block_cixi-kefa-elec-kf2edgr-3-81-2p_C441182.html | https://www.lcsc.com/datasheet/lcsc_datasheet_2303311930_Cixi-Kefa-Elec-KF2EDGR-3-81-2P_C441182.pdf | listing only | 2026-11-10 | Mates with plug KF2EDGK-3.81-2P
F1 F4 | 2 | 2 | Fuse 3 A time-lag in SMD holder | SMD 9.7x5 mm | Littelfuse | 0154003.DRT | C206913 | extended | 2514 | 1.5283 | 1.1879 | 1.111 | https://www.lcsc.com/product-detail/disposable-fuses_littelfuse-0154003-drt_C206913.html | https://www.lcsc.com/datasheet/lcsc_datasheet_2401301225_Littelfuse-0154003-DRT_C206913.pdf | read | 2026-11-10 | Replacement fuse 0452003.MRL (C99550)
D1 | 1 | 1 | TVS 48 V bidirectional 1500 W | SMC | Littelfuse | SMCJ48CA | C151287 | extended | 4645 | 0.2481 | 0.1974 | 0.1485 | https://www.lcsc.com/product-detail/esd-and-surge-protection-tvs-esd_littelfuse-smcj48ca_C151287.html | https://www.lcsc.com/datasheet/lcsc_datasheet_2304140030_Littelfuse-SMCJ48CA_C151287.pdf | read | 2026-11-10
D2 | 1 | 1 | Rectifier 1 A 1000 V | SMA | MDD(Microdiode Semiconductor) | M7 | C95872 | basic | 5405522 | 0.0103 | 0.0103 | 0.0085 | https://www.lcsc.com/product-detail/diodes-general-purpose_mdd-microdiode-semiconductor-m7_C95872.html | https://www.lcsc.com/datasheet/lcsc_datasheet_2407101107_MDD-Microdiode-Semiconductor-M7_C95872.pdf | read | 2026-11-10
R1 | 1 | 1 | 3R 5% 1 W, surge series | 2512 | YAGEO | SR2512JK-073RL | C2936639 | extended | 3972 | 0.1926 | 0.1504 | 0.1097 | https://www.lcsc.com/product-detail/chip-resistor-surface-mount_yageo-sr2512jk-073rl_C2936639.html | https://www.lcsc.com/datasheet/C2936639.pdf | read | 2026-11-10 | Yageo SR series data sheet V.14, figure 7-2: about 750 W for 1 ms and 200 W for 10 ms single pulse in 2512 at 5 % tolerance. The 1 % SR2512FK parts follow figure 7-1 and take about 200 W at 1 ms, which is not enough
C1 | 1 | 1 | 470 uF 63 V aluminium electrolytic | THT 12.5x20 mm | Rubycon | 63ZLJ470M12.5X20 | C2940725 | extended | 3180 | 0.3453 | 0.2537 | 0.2177 | https://www.lcsc.com/product-detail/aluminum-electrolytic-capacitors-leaded_rubycon-63zlj470m12-5x20_C2940725.html | https://www.lcsc.com/datasheet/C2940725.pdf | read | 2026-11-10 | Through-hole, soldered by hand from the bottom side, lying down; not machine-fitted. Rubycon ZLJ sheet: 10000 h at 105 C, 2400 mA at 100 kHz, 1320 mA at 120 Hz. Same holes: Rubycon 63PX470MEFC12.5X20 (C88758, 2000 h, read) and AISHI ERS1JM471K20OT (C106675, listing only)
F5 | 1 | 1 | Fuse 0.5 A very fast-acting, 125 V | 2410 | Littelfuse | 0451.500MRL | C142836 | extended | 11512 | 0.2339 | 0.1908 | 0.1321 | https://www.lcsc.com/product-detail/disposable-fuses_littelfuse-0451-500mrl_C142836.html | https://www.lcsc.com/datasheet/lcsc_datasheet_1810280911_Littelfuse-0451-500MRL_C142836.pdf | read | 2026-11-10 | Littelfuse 451/453 series: 0.42 ohm cold, nominal melting I2t 0.0824 A2s, interrupting 50 A at 125 V and 300 A at 32 V DC. Soldered: it opens only when U1 has failed. Do not fit a larger rating: the 0.42 ohm also limits the fault current to the interrupting rating
C2 C3 | 2 | 2 | 2.2 uF 100 V X7R | 1210 | Samsung Electro-Mechanics | CL32B225KCJSNNE | C55151 | extended | 22064 | 0.2062 | 0.1658 | 0.1575 | https://www.lcsc.com/product-detail/multilayer-ceramic-capacitors-mlcc-smd-smt_samsung-electro-mechanics-cl32b225kcjsnne_C55151.html | https://www.lcsc.com/datasheet/lcsc_datasheet_2304140030_Samsung-Electro-Mechanics-CL32B225KCJSNNE_C55151.pdf | listing only | 2026-11-10
U1 | 1 | 1 | LM5164DDAR 100 V 1 A synchronous buck | SO-8 PowerPAD | Texas Instruments | LM5164DDAR | C477928 | extended | 1840 | 2.1697 | 1.6739 | 1.5119 | https://www.lcsc.com/product-detail/dc-dc-converters_texas-instruments-lm5164ddar_C477928.html | https://www.ti.com/lit/ds/symlink/lm5164.pdf | read | 2026-11-10
C4 | 1 | 1 | 2.2 nF 50 V X7R | 0603 | FH (Guangdong Fenghua Advanced Tech) | 0603B222K500NT | C1604 | basic | 543476 | 0.0109 | 0.0109 | 0.0086 | https://www.lcsc.com/product-detail/multilayer-ceramic-capacitors-mlcc-smd-smt_fh-guangdong-fenghua-advanced-tech-0603b222k500nt_C1604.html | https://www.lcsc.com/datasheet/lcsc_datasheet_2304140030_FH--Guangdong-Fenghua-Advanced-Tech-0603B222K500NT_C1604.pdf | read | 2026-11-11 | Fenghua general MLCC specification (the LCSC sheet for this number): X7R, +/-10 % (K), 50 V, -55 to 125 C, insulation resistance 10 Gohm minimum up to 25 nF. Replaces Samsung CL10B222KB8NNNC (C16033, extended) since the BOM consolidation; same value, dielectric, tolerance, voltage and package
L1 | 1 | 1 | 47 uH, Isat 2.0 A, 0.2R | 6x6x4.5 mm | BOURNS | SRN6045TA-470M | C5151734 | extended | 4123 | 0.3608 | 0.2859 | 0.2047 | https://www.lcsc.com/product-detail/power-inductors_bourns-srn6045ta-470m_C5151734.html | https://wmsc.lcsc.com/wmsc/upload/file/pdf/v2/lcsc/2208251800_BOURNS-SRN6045TA-470M_C5151734.pdf | read | 2026-11-10
C5 C6 C14 | 3 | 3 | 22 uF 25 V X5R | 1206 | Samsung Electro-Mechanics | CL31A226KAHNNNE | C12891 | basic | 1976907 | 0.1028 | 0.1028 | 0.0724 | https://www.lcsc.com/product-detail/multilayer-ceramic-capacitors-mlcc-smd-smt_samsung-electro-mechanics-cl31a226kahnnne_C12891.html | https://www.lcsc.com/datasheet/lcsc_datasheet_2304140030_Samsung-Electro-Mechanics-CL31A226KAHNNNE_C12891.pdf | listing only | 2026-11-10
R2 | 1 | 1 | 47k 1% | 0603 | UNI-ROYAL(Uniroyal Elec) | 0603WAF4702T5E | C25819 | basic | 3006958 | 0.0016 | 0.0016 | 0.0012 | https://www.lcsc.com/product-detail/chip-resistor-surface-mount_uni-royal-uniroyal-elec-0603waf4702t5e_C25819.html | https://www.lcsc.com/datasheet/lcsc_datasheet_2206010045_UNI-ROYAL-Uniroyal-Elec-0603WAF4702T5E_C25819.pdf | listing only | 2026-11-10
R3 | 1 | 1 | 330k 1% | 0603 | UNI-ROYAL(Uniroyal Elec) | 0603WAF3303T5E | C23137 | basic | 678476 | 0.0016 | 0.0016 | 0.0012 | https://www.lcsc.com/product-detail/chip-resistor-surface-mount_uni-royal-uniroyal-elec-0603waf3303t5e_C23137.html | https://www.lcsc.com/datasheet/lcsc_datasheet_2206010116_UNI-ROYAL-Uniroyal-Elec-0603WAF3303T5E_C23137.pdf | listing only | 2026-11-10
R4 R10 R18 R19 R26 R27 R35 R36 R39 R41 R52 R53 R56 R58 R63 R69 R70 R72 R85 R87 R88 R93 | 22 | 22 | 10k 1% | 0603 | UNI-ROYAL(Uniroyal Elec) | 0603WAF1002T5E | C25804 | basic | 45615451 | 0.0022 | 0.0022 | 0.0018 | https://www.lcsc.com/product-detail/chip-resistor-surface-mount_uni-royal-uniroyal-elec-0603waf1002t5e_C25804.html | https://www.lcsc.com/datasheet/lcsc_datasheet_2206010045_UNI-ROYAL-Uniroyal-Elec-0603WAF1002T5E_C25804.pdf | listing only | 2026-11-10
R5 R12 R14 R25 R31 R62 R86 R90 R94 R96 | 10 | 10 | 100k 1% | 0603 | UNI-ROYAL(Uniroyal Elec) | 0603WAF1003T5E | C25803 | basic | 15636901 | 0.0029 | 0.0029 | 0.0023 | https://www.lcsc.com/product-detail/chip-resistor-surface-mount_uni-royal-uniroyal-elec-0603waf1003t5e_C25803.html | https://www.lcsc.com/datasheet/lcsc_datasheet_2206010045_UNI-ROYAL-Uniroyal-Elec-0603WAF1003T5E_C25803.pdf | listing only | 2026-11-10
R30 R91 R100 | 3 | 3 | 110k 1% | 0603 | UNI-ROYAL(Uniroyal Elec) | 0603WAF1103T5E | C25805 | extended (preferred) | 180061 | 0.0028 | 0.0028 | 0.0021 | https://www.lcsc.com/product-detail/chip-resistor-surface-mount_uni-royal-uniroyal-elec-0603waf1103t5e_C25805.html | https://www.lcsc.com/datasheet/C25805.pdf | listing only | 2026-11-10
R95 | 1 | 1 | 150k 1% | 0603 | UNI-ROYAL(Uniroyal Elec) | 0603WAF1503T5E | C22807 | basic | 701846 | 0.0017 | 0.0017 | 0.0013 | https://www.lcsc.com/product-detail/chip-resistor-surface-mount_uni-royal-uniroyal-elec-0603waf1503t5e_C22807.html | https://www.lcsc.com/datasheet/C22807.pdf | listing only | 2026-11-10
RN1 RN2 RN3 | 3 | 3 | 100k x4 5% resistor array | 0603x4 | UNI-ROYAL(Uniroyal Elec) | 4D03WGJ0104T5E | C1996 | extended | 7320 | 0.0103 | 0.0103 | 0.0083 | https://www.lcsc.com/product-detail/resistor-networks-arrays_uni-royal-uniroyal-elec-4d03wgj0104t5e_C1996.html | https://www.lcsc.com/datasheet/C1996.pdf | read | 2026-11-10 | Four isolated resistors, convex 4D03. Pin pairs 1-8, 2-7, 3-6, 4-5 assumed from the usual numbering; the data sheet shows the circuit as a picture. Confirm at capture
R6 R8 R83 | 3 | 3 | 200k 1% | 0603 | UNI-ROYAL(Uniroyal Elec) | 0603WAF2003T5E | C25811 | basic | 1820047 | 0.0021 | 0.0021 | 0.0016 | https://www.lcsc.com/product-detail/chip-resistor-surface-mount_uni-royal-uniroyal-elec-0603waf2003t5e_C25811.html | https://www.lcsc.com/datasheet/lcsc_datasheet_2206010045_UNI-ROYAL-Uniroyal-Elec-0603WAF2003T5E_C25811.pdf | listing only | 2026-11-10
C7 | 1 | 1 | 3.3 nF 50 V X7R | 0603 | Samsung Electro-Mechanics | CL10B332KB8NNNC | C1613 | basic | 364454 | 0.0088 | 0.0088 | 0.0063 | https://www.lcsc.com/product-detail/multilayer-ceramic-capacitors-mlcc-smd-smt_samsung-electro-mechanics-cl10b332kb8nnnc_C1613.html | https://www.lcsc.com/datasheet/lcsc_datasheet_2304140030_Samsung-Electro-Mechanics-CL10B332KB8NNNC_C1613.pdf | listing only | 2026-11-10
C8 | 1 | 1 | 100 pF 50 V C0G | 0603 | Samsung Electro-Mechanics | CL10C101JB8NNNC | C14858 | basic | 3768735 | 0.0082 | 0.0082 | 0.0062 | https://www.lcsc.com/product-detail/multilayer-ceramic-capacitors-mlcc-smd-smt_samsung-electro-mechanics-cl10c101jb8nnnc_C14858.html | https://www.lcsc.com/datasheet/lcsc_datasheet_2304140030_Samsung-Electro-Mechanics-CL10C101JB8NNNC_C14858.pdf | listing only | 2026-11-10
R7 R13 R57 | 3 | 3 | 1M 1% | 0603 | UNI-ROYAL(Uniroyal Elec) | 0603WAF1004T5E | C22935 | basic | 4167811 | 0.0018 | 0.0018 | 0.0014 | https://www.lcsc.com/product-detail/chip-resistor-surface-mount_uni-royal-uniroyal-elec-0603waf1004t5e_C22935.html | https://www.lcsc.com/datasheet/lcsc_datasheet_2206010130_UNI-ROYAL-Uniroyal-Elec-0603WAF1004T5E_C22935.pdf | listing only | 2026-11-10
R9 | 1 | 1 | 300k 1% | 0603 | UNI-ROYAL(Uniroyal Elec) | 0603WAF3003T5E | C23024 | basic | 454953 | 0.0038 | 0.0038 | 0.0029 | https://www.lcsc.com/product-detail/chip-resistor-surface-mount_uni-royal-uniroyal-elec-0603waf3003t5e_C23024.html | https://www.lcsc.com/datasheet/lcsc_datasheet_2206010116_UNI-ROYAL-Uniroyal-Elec-0603WAF3003T5E_C23024.pdf | listing only | 2026-11-10
C9 C12 C13 C15 C17 C18 C19 C20 C21 C25 C30 C31 C35 C38 C39 C40 C54 C56 | 18 | 18 | 100 nF 50 V X7R | 0603 | YAGEO | CC0603KRX7R9BB104 | C14663 | basic | 36615031 | 0.0069 | 0.0069 | 0.0053 | https://www.lcsc.com/product-detail/multilayer-ceramic-capacitors-mlcc-smd-smt_yageo-cc0603krx7r9bb104_C14663.html | https://www.lcsc.com/datasheet/lcsc_datasheet_2211101700_YAGEO-CC0603KRX7R9BB104_C14663.pdf | listing only | 2026-11-10
D3 D4 D24 | 3 | 3 | SS34 Schottky 3 A 40 V | SMA | MDD(Microdiode Semiconductor) | SS34 | C8678 | basic | 2925039 | 0.0351 | 0.0351 | 0.0251 | https://www.lcsc.com/product-detail/schottky-diodes_mdd-microdiode-semiconductor-ss34_C8678.html | https://www.lcsc.com/datasheet/lcsc_datasheet_2407101107_MDD-Microdiode-Semiconductor-SS34_C8678.pdf | read | 2026-11-10
D25 | 1 | 1 | TVS 6 V unidirectional 600 W | SMB | Littelfuse | SMBJ6.0A | C83270 | extended | 6788 | 0.1867 | 0.1458 | 0.11 | https://www.lcsc.com/product-detail/esd-and-surge-protection-tvs-esd_littelfuse-smbj6-0a_C83270.html | https://www.lcsc.com/datasheet/lcsc_datasheet_2304140030_Littelfuse-SMBJ6-0A_C83270.pdf | read | 2026-11-10 | Littelfuse SMBJ series, same sheet as SMBJ48CA: VBR 6.67 to 7.37 V at 10 mA, VC 10.3 V at 58.3 A, 800 uA at 6.0 V. Unidirectional: cathode to V_BUCK. Not the CA type
K1 | 1 | 1 | G5NB-1A-E DC5 relay SPST-NO 5 A, 5 V 125R coil | THT 20.4x7 mm | Omron Electronics | G5NB-1A-E-DC5V | C48746 | extended | 140114 | 0.4746 | 0.3682 | 0.3437 | https://www.lcsc.com/product-detail/power-relays_omron-electronics-g5nb-1a-e-dc5v_C48746.html | https://www.lcsc.com/datasheet/C48746.pdf | read | 2026-11-10
D5 D10 D11 | 3 | 3 | 1N4148W | SOD-123 | ST(Semtech) | 1N4148W | C81598 | basic | 3473878 | 0.0124 | 0.0124 | 0.0097 | https://www.lcsc.com/product-detail/switching-diodes_st-semtech-1n4148w_C81598.html | https://www.lcsc.com/datasheet/lcsc_datasheet_1811061725_ST-Semtech-1N4148W_C81598.pdf | listing only | 2026-11-10
Q1 Q2 Q4 | 3 | 3 | AO3400A N-MOSFET 30 V | SOT-23 | Alpha & Omega Semicon | AO3400A | C20917 | basic | 994501 | 0.0889 | 0.0717 | 0.0555 | https://www.lcsc.com/product-detail/mosfets_alpha-omega-semicon-ao3400a_C20917.html | https://www.lcsc.com/datasheet/lcsc_datasheet_1811081213_Alpha---Omega-Semicon-AO3400A_C20917.pdf | listing only | 2026-11-10
R11 R28 R46 R47 R48 R54 R59 R76 R79 R82 R89 R104 R204 R304 R404 R504 R604 R704 R804 R904 | 20 | 15 | 1k 1% | 0603 | UNI-ROYAL(Uniroyal Elec) | 0603WAF1001T5E | C21190 | basic | 25468001 | 0.0017 | 0.0017 | 0.0014 | https://www.lcsc.com/product-detail/chip-resistor-surface-mount_uni-royal-uniroyal-elec-0603waf1001t5e_C21190.html | https://www.lcsc.com/datasheet/lcsc_datasheet_2206010130_UNI-ROYAL-Uniroyal-Elec-0603WAF1001T5E_C21190.pdf | listing only | 2026-11-10
C16 C32 C37 C47 C49 | 5 | 5 | 1 uF 50 V X5R | 0603 | Samsung Electro-Mechanics | CL10A105KB8NNNC | C15849 | basic | 12468778 | 0.0111 | 0.0111 | 0.0086 | https://www.lcsc.com/product-detail/multilayer-ceramic-capacitors-mlcc-smd-smt_samsung-electro-mechanics-cl10a105kb8nnnc_C15849.html | https://www.lcsc.com/datasheet/lcsc_datasheet_2304140030_Samsung-Electro-Mechanics-CL10A105KB8NNNC_C15849.pdf | listing only | 2026-11-10
J2 J4 | 2 | 2 | Header 7-way 3.81 mm pluggable, right angle | THT | Cixi Kefa Elec | KF2EDGR-3.81-7P | C441187 | extended | 1806 | 0.1762 | 0.1393 | 0.1015 | https://www.lcsc.com/product-detail/pluggable-system-terminal-block_cixi-kefa-elec-kf2edgr-3-81-7p_C441187.html | https://www.lcsc.com/datasheet/lcsc_datasheet_2303311930_Cixi-Kefa-Elec-KF2EDGR-3-81-7P_C441187.pdf | listing only | 2026-11-10 | Mates with plug KF2EDGK-3.81-7P
J3 | 1 | 0 | Header 4-way 3.81 mm pluggable, right angle | THT | Cixi Kefa Elec | KF2EDGR-3.81-4P | C441184 | extended | 25390 | 0.1044 | 0.0843 | 0.0642 | https://www.lcsc.com/product-detail/pluggable-system-terminal-block_cixi-kefa-elec-kf2edgr-3-81-4p_C441184.html | https://www.lcsc.com/datasheet/lcsc_datasheet_2303311930_Cixi-Kefa-Elec-KF2EDGR-3-81-4P_C441184.pdf | listing only | 2026-11-10 | Mates with plug KF2EDGK-3.81-4P
J5 | 1 | 1 | USB-C receptacle 16-pin, USB 2.0 | SMD | Korean Hroparts Elec | TYPE-C-31-M-12 | C165948 | extended | 290822 | 0.1869 | 0.1476 | 0.1041 | https://www.lcsc.com/product-detail/usb-connectors_korean-hroparts-elec-type-c-31-m-12_C165948.html | https://www.lcsc.com/datasheet/lcsc_datasheet_2205251630_Korean-Hroparts-Elec-TYPE-C-31-M-12_C165948.pdf | listing only | 2026-11-10
R15 R16 | 2 | 2 | 5.1k 1% | 0603 | UNI-ROYAL(Uniroyal Elec) | 0603WAF5101T5E | C23186 | basic | 19986131 | 0.0015 | 0.0015 | 0.0012 | https://www.lcsc.com/product-detail/chip-resistor-surface-mount_uni-royal-uniroyal-elec-0603waf5101t5e_C23186.html | https://www.lcsc.com/datasheet/lcsc_datasheet_2206010116_UNI-ROYAL-Uniroyal-Elec-0603WAF5101T5E_C23186.pdf | listing only | 2026-11-10
U2 U9 | 2 | 2 | USBLC6-2SC6 ESD array | SOT-23-6 | STMicroelectronics | USBLC6-2SC6 | C7519 | extended | 29590 | 0.1624 | 0.1242 | 0.0889 | https://www.lcsc.com/product-detail/esd-and-surge-protection-tvs-esd_stmicroelectronics-usblc6-2sc6_C7519.html | https://www.lcsc.com/datasheet/lcsc_datasheet_2410121836_STMicroelectronics-USBLC6-2SC6_C7519.pdf | read | 2026-11-10
C10 C22 C51 | 3 | 3 | 4.7 uF 25 V X5R | 0805 | Samsung Electro-Mechanics | CL21A475KAQNNNE | C1779 | basic | 1878798 | 0.0342 | 0.0342 | 0.0226 | https://www.lcsc.com/product-detail/multilayer-ceramic-capacitors-mlcc-smd-smt_samsung-electro-mechanics-cl21a475kaqnnne_C1779.html | https://www.lcsc.com/datasheet/lcsc_datasheet_2304140030_Samsung-Electro-Mechanics-CL21A475KAQNNNE_C1779.pdf | listing only | 2026-11-10
U3 | 1 | 1 | LDL1117S33R 3.3 V 1.2 A LDO | SOT-223 | STMicroelectronics | LDL1117S33R | C435835 | extended | 60538 | 0.3862 | 0.2848 | 0.2635 | https://www.lcsc.com/product-detail/voltage-regulators-linear-low-drop-out-ldo-regulators_stmicroelectronics-ldl1117s33r_C435835.html | https://www.lcsc.com/datasheet/lcsc_datasheet_1912111437_STMicroelectronics-LDL1117S33R_C435835.pdf | read | 2026-11-10
C11 C23 C50 | 3 | 3 | 10 uF 25 V X5R | 0805 | Samsung Electro-Mechanics | CL21A106KAYNNNE | C15850 | basic | 8517620 | 0.0315 | 0.0315 | 0.0202 | https://www.lcsc.com/product-detail/multilayer-ceramic-capacitors-mlcc-smd-smt_samsung-electro-mechanics-cl21a106kaynnne_C15850.html | https://www.lcsc.com/datasheet/lcsc_datasheet_2304140030_Samsung-Electro-Mechanics-CL21A106KAYNNNE_C15850.pdf | listing only | 2026-11-10
R17 R97 R98 R99 | 4 | 4 | 0R | 0603 | UNI-ROYAL(Uniroyal Elec) | 0603WAF0000T5E | C21189 | basic | 18499775 | 0.0022 | 0.0022 | 0.0017 | https://www.lcsc.com/product-detail/chip-resistor-surface-mount_uni-royal-uniroyal-elec-0603waf0000t5e_C21189.html | https://www.lcsc.com/datasheet/lcsc_datasheet_2411221126_UNI-ROYAL-Uniroyal-Elec-0603WAF0000T5E_C21189.pdf | listing only | 2026-11-10
U4 | 1 | 1 | ESP32-S3-WROOM-1-N16R8 | module 18x25.5 mm | Espressif Systems | ESP32-S3-WROOM-1-N16R8 | C2913202 | extended | 24221 | 4.6993 | 3.7486 | 3.5883 | https://www.lcsc.com/product-detail/wifi-modules_espressif-systems-esp32-s3-wroom-1-n16r8_C2913202.html | https://www.espressif.com/sites/default/files/documentation/esp32-s3-wroom-1_wroom-1u_datasheet_en.pdf | read | 2026-11-10
SW1 SW2 | 2 | 2 | Tactile switch 5.1x5.1 mm, 1.5 mm high | SMD | XKB Connection | TS-1187A-B-A-B | C318884 | basic | 851117 | 0.0215 | 0.0215 | 0.0147 | https://www.lcsc.com/product-detail/tactile-switches_xkb-connection-ts-1187a-b-a-b_C318884.html | https://www.lcsc.com/datasheet/lcsc_datasheet_2304140030_XKB-Connection-TS-1187A-B-A-B_C318884.pdf | listing only | 2026-11-10
R20 R102 R202 R302 R402 R502 R602 R702 R802 R902 | 10 | 6 | 680R 1% | 0603 | UNI-ROYAL(Uniroyal Elec) | 0603WAF6800T5E | C23228 | basic | 1617802 | 0.0021 | 0.0021 | 0.0017 | https://www.lcsc.com/product-detail/chip-resistor-surface-mount_uni-royal-uniroyal-elec-0603waf6800t5e_C23228.html | https://www.lcsc.com/datasheet/lcsc_datasheet_2206010100_UNI-ROYAL-Uniroyal-Elec-0603WAF6800T5E_C23228.pdf | listing only | 2026-11-10
D6 D102 D202 D302 D402 D502 D602 D702 D802 D902 | 10 | 6 | LED yellow-green | 0603 | Lite-On | LTST-C190KGKT | C125094 | extended | 492779 | 0.0194 | 0.0194 | 0.0127 | https://www.lcsc.com/product-detail/led-indication-discrete_lite-on-ltst-c190kgkt_C125094.html | https://www.lcsc.com/datasheet/lcsc_datasheet_1810231512_Lite-On-LTST-C190KGKT_C125094.pdf | listing only | 2026-11-10
R21 R22 R33 | 3 | 3 | 2.2k 1% | 0603 | UNI-ROYAL(Uniroyal Elec) | 0603WAF2201T5E | C4190 | basic | 4893831 | 0.0018 | 0.0018 | 0.0014 | https://www.lcsc.com/product-detail/chip-resistor-surface-mount_uni-royal-uniroyal-elec-0603waf2201t5e_C4190.html | https://www.lcsc.com/datasheet/lcsc_datasheet_2206010230_UNI-ROYAL-Uniroyal-Elec-0603WAF2201T5E_C4190.pdf | listing only | 2026-11-10
J6 | 1 | 1 | JST SH 4-way 1.0 mm, side entry | SMD | JST | SM04B-SRSS-TB(LF)(SN) | C160404 | extended | 79730 | 0.2147 | 0.1737 | 0.1359 | https://www.lcsc.com/product-detail/wire-to-board-connector_jst-sm04b-srss-tb-lf-sn_C160404.html | https://www.lcsc.com/datasheet/lcsc_datasheet_2304140030_JST-SM04B-SRSS-TB-LF-SN_C160404.pdf | listing only | 2026-11-10
F2 | 1 | 1 | PTC 0.125 A hold, 30 V | 1206 | Littelfuse | 1206L012WR | C151160 | extended | 19543 | 0.0526 | 0.041 | 0.0352 | https://www.lcsc.com/product-detail/resettable-fuses_littelfuse-1206l012wr_C151160.html | https://www.lcsc.com/datasheet/lcsc_datasheet_2304140030_Littelfuse-1206L012WR_C151160.pdf | listing only | 2026-11-10
R23 R24 R92 | 3 | 3 | 4.7k 1% | 0603 | UNI-ROYAL(Uniroyal Elec) | 0603WAF4701T5E | C23162 | basic | 15300024 | 0.0028 | 0.0028 | 0.0022 | https://www.lcsc.com/product-detail/chip-resistor-surface-mount_uni-royal-uniroyal-elec-0603waf4701t5e_C23162.html | https://www.lcsc.com/datasheet/lcsc_datasheet_2206010116_UNI-ROYAL-Uniroyal-Elec-0603WAF4701T5E_C23162.pdf | listing only | 2026-11-10
U5 | 1 | 1 | TCA9539PWR 16-bit I2C expander with reset | TSSOP-24 | Texas Instruments | TCA9539PWR | C131972 | extended | 4931 | 1.0243 | 0.7953 | 0.7167 | https://www.lcsc.com/product-detail/i-o-expanders_texas-instruments-tca9539pwr_C131972.html | https://www.lcsc.com/datasheet/lcsc_datasheet_2304140030_Texas-Instruments-TCA9539PWR_C131972.pdf | read | 2026-11-10 | Second source NXP PCA9539PW (C129516), datasheet not read
U6 | 1 | 1 | LM2901DR quad comparator | SOIC-14 | Texas Instruments | LM2901DR | C7932 | extended | 63434 | 0.1982 | 0.1522 | 0.112 | https://www.lcsc.com/product-detail/comparators_texas-instruments-lm2901dr_C7932.html | https://www.lcsc.com/datasheet/lcsc_datasheet_2304140030_Texas-Instruments-LM2901DR_C7932.pdf | read | 2026-11-10
U12 | 1 | 1 | TLV803EA30DBZR supervisor 3.0 V, open drain, 200 ms | SOT-23 | Texas Instruments | TLV803EA30DBZR | C5218924 | extended | 7160 | 0.3158 | 0.2373 | 0.2209 | https://jlcpcb.com/partdetail/C5218924 | https://www.lcsc.com/datasheet/C5218924.pdf | read | 2026-11-10 | TI SNVSB81 family sheet (LCSC copy ZHCSJX8J): threshold 3.0 V +/-2 % falling, 1.2 % hysteresis, pin 1 GND, 2 RESET, 3 VDD
U13 | 1 | 1 | TPS3701DDCR window voltage detector, 0.4 V thresholds, open-drain outputs | SOT-23-6 thin | Texas Instruments | TPS3701DDCR | C132788 | extended | 24964 | 0.5297 | 0.3907 | 0.3286 | https://www.lcsc.com/product-detail/comparators_texas-instruments-tps3701ddcr_C132788.html | https://www.ti.com/lit/ds/symlink/tps3701.pdf | read | 2026-11-10 | TI SBVS240C: INB threshold 400 mV +/-0.75 %, hysteresis 5.2 mV, input current 25 nA at most, pin 1 OUTA, 2 GND, 3 INA, 4 INB, 5 VDD, 6 OUTB; package DDC, JLCPCB lists it as SOT-23-Thin-6
U7 | 1 | 1 | 74HC132D quad NAND, Schmitt-trigger inputs | SOIC-14 | Nexperia | 74HC132D,653 | C5601 | extended | 19757 | 0.2623 | 0.2047 | 0.1491 | https://www.lcsc.com/product-detail/logic-gates_nexperia-74hc132d-653_C5601.html | https://www.lcsc.com/datasheet/C5601.pdf | read | 2026-11-10 | Same pinout as the 74HC00D it replaces. Schmitt inputs for the slow edges from the open-collector comparators
Q3 | 1 | 1 | AO3401A P-MOSFET 30 V | SOT-23 | Alpha & Omega Semicon | AO3401A | C15127 | basic | 1641204 | 0.0828 | 0.0655 | 0.0495 | https://www.lcsc.com/product-detail/mosfets_alpha-omega-semicon-ao3401a_C15127.html | https://www.lcsc.com/datasheet/lcsc_datasheet_2412061733_Alpha---Omega-Semicon-AO3401A_C15127.pdf | read | 2026-11-10
R29 | 1 | 1 | 220R 1% | 0603 | UNI-ROYAL(Uniroyal Elec) | 0603WAF2200T5E | C22962 | basic | 2698744 | 0.0019 | 0.0019 | 0.0015 | https://www.lcsc.com/product-detail/chip-resistor-surface-mount_uni-royal-uniroyal-elec-0603waf2200t5e_C22962.html | https://www.lcsc.com/datasheet/lcsc_datasheet_2206010130_UNI-ROYAL-Uniroyal-Elec-0603WAF2200T5E_C22962.pdf | listing only | 2026-11-10
D7 D9 D15 D16 D17 D22 | 6 | 6 | BAT54S dual Schottky, series | SOT-23 | hongjiacheng | BAT54S | C7420333 | extended (preferred) | 514643 | 0.0129 | 0.0129 | 0.0103 | https://www.lcsc.com/product-detail/schottky-diodes_hongjiacheng-bat54s_C7420333.html | https://wmsc.lcsc.com/wmsc/upload/file/pdf/v2/lcsc/2310171613_hongjiacheng-BAT54S_C7420333.pdf | read | 2026-11-11 | Hongjiacheng BAT54 to BAT54S sheet rev 2.0: VF 240, 320, 400 and 500 mV maximum at 0.1, 1, 10 and 30 mA, IR 2 uA maximum at 25 V, 10 pF, 5 ns, pin 1 anode, 2 cathode, 3 common: equal to the Nexperia BAT54S,215 (C47546, extended) that it replaces. Differences: 1.0 V at 100 mA against 0.8 V, junction 125 C against 150 C. Preferred extended at JLCPCB: no feeder fee on Economic assembly while that flag stands
R32 | 1 | 1 | 510k 1% | 0603 | UNI-ROYAL(Uniroyal Elec) | 0603WAF5103T5E | C23192 | basic | 803448 | 0.002 | 0.002 | 0.0016 | https://www.lcsc.com/product-detail/chip-resistor-surface-mount_uni-royal-uniroyal-elec-0603waf5103t5e_C23192.html | https://www.lcsc.com/datasheet/lcsc_datasheet_2206010116_UNI-ROYAL-Uniroyal-Elec-0603WAF5103T5E_C23192.pdf | listing only | 2026-11-10
C24 C34 C55 | 3 | 3 | 10 nF 50 V X7R | 0603 | FH (Guangdong Fenghua Advanced Tech) | 0603B103K500NT | C57112 | basic | 5459902 | 0.0103 | 0.0103 | 0.008 | https://www.lcsc.com/product-detail/multilayer-ceramic-capacitors-mlcc-smd-smt_fh-guangdong-fenghua-advanced-tech-0603b103k500nt_C57112.html | https://www.lcsc.com/datasheet/lcsc_datasheet_2304140030_FH--Guangdong-Fenghua-Advanced-Tech-0603B103K500NT_C57112.pdf | read | 2026-11-11 | Fenghua general MLCC specification: X7R, +/-10 %, 50 V, -55 to 125 C, insulation resistance 10 Gohm minimum. Replaces Samsung CL10B103KB8NNNC (C1589, extended); same value, dielectric, tolerance, voltage and package
R34 | 1 | 1 | 15k 1% | 0603 | UNI-ROYAL(Uniroyal Elec) | 0603WAF1502T5E | C22809 | basic | 3289534 | 0.0029 | 0.0029 | 0.0022 | https://www.lcsc.com/product-detail/chip-resistor-surface-mount_uni-royal-uniroyal-elec-0603waf1502t5e_C22809.html | https://www.lcsc.com/datasheet/lcsc_datasheet_2206010130_UNI-ROYAL-Uniroyal-Elec-0603WAF1502T5E_C22809.pdf | listing only | 2026-11-10
R37 | 1 | 1 | 0.1R 1% 2 W metal strip | 2512 | TA-I Tech | RLP25FEER100 | C160587 | extended | 67549 | 0.057 | 0.0462 | 0.0367 | https://www.lcsc.com/product-detail/current-sense-resistors-shunt-resistors_ta-i-tech-rlp25feer100_C160587.html | https://www.lcsc.com/datasheet/lcsc_datasheet_2304140030_TA-I-Tech-RLP25FEER100_C160587.pdf | read | 2026-11-10
U8 | 1 | 1 | MCP6002T-I/SN dual op-amp | SOIC-8 | Microchip Tech | MCP6002T-I/SN | C7377 | extended (preferred) | 74114 | 0.3088 | 0.2417 | 0.1797 | https://www.lcsc.com/product-detail/operational-amplifier_microchip-tech-mcp6002t-i-sn_C7377.html | https://www.lcsc.com/datasheet/lcsc_datasheet_2304140030_Microchip-Tech-MCP6002T-I-SN_C7377.pdf | read | 2026-11-10
R38 R40 R42 R44 | 4 | 4 | 7.5k 1% | 0603 | UNI-ROYAL(Uniroyal Elec) | 0603WAF7501T5E | C23234 | basic | 932718 | 0.0018 | 0.0018 | 0.0014 | https://www.lcsc.com/product-detail/chip-resistor-surface-mount_uni-royal-uniroyal-elec-0603waf7501t5e_C23234.html | https://www.lcsc.com/datasheet/lcsc_datasheet_2206010100_UNI-ROYAL-Uniroyal-Elec-0603WAF7501T5E_C23234.pdf | listing only | 2026-11-10
C26 C27 | 2 | 2 | 1 nF 50 V X7R | 0603 | Samsung Electro-Mechanics | CL10B102KB8NNNC | C1588 | basic | 5711807 | 0.0082 | 0.0082 | 0.0066 | https://www.lcsc.com/product-detail/multilayer-ceramic-capacitors-mlcc-smd-smt_samsung-electro-mechanics-cl10b102kb8nnnc_C1588.html | https://www.lcsc.com/datasheet/lcsc_datasheet_2304140030_Samsung-Electro-Mechanics-CL10B102KB8NNNC_C1588.pdf | listing only | 2026-11-10
R43 R45 | 2 | 2 | 49.9k 1% | 0603 | UNI-ROYAL(Uniroyal Elec) | 0603WAF4992T5E | C23184 | basic | 1404510 | 0.0029 | 0.0029 | 0.0021 | https://www.lcsc.com/product-detail/chip-resistor-surface-mount_uni-royal-uniroyal-elec-0603waf4992t5e_C23184.html | https://www.lcsc.com/datasheet/lcsc_datasheet_2206010116_UNI-ROYAL-Uniroyal-Elec-0603WAF4992T5E_C23184.pdf | listing only | 2026-11-10
C28 C29 | 2 | 2 | 330 pF 50 V C0G | 0603 | Samsung Electro-Mechanics | CL10C331JB8NNNC | C1664 | basic | 627149 | 0.018 | 0.018 | 0.0143 | https://www.lcsc.com/product-detail/multilayer-ceramic-capacitors-mlcc-smd-smt_samsung-electro-mechanics-cl10c331jb8nnnc_C1664.html | https://www.lcsc.com/datasheet/lcsc_datasheet_2304140030_Samsung-Electro-Mechanics-CL10C331JB8NNNC_C1664.pdf | listing only | 2026-11-11 | Replaces 220 pF C0G CL10C221JB8NNNC (C27675, extended): same maker, series, dielectric, tolerance and voltage, one E6 step up. No basic 220 pF C0G exists in 0603. The corner of the high-gain amplifier moves from 14.5 to 9.7 kHz, ahead of the 1.6 kHz filter at the ADC pin: design section 10.3
R49 R50 | 2 | 2 | 330R 1% | 0603 | UNI-ROYAL(Uniroyal Elec) | 0603WAF3300T5E | C23138 | basic | 2621043 | 0.002 | 0.002 | 0.0016 | https://www.lcsc.com/product-detail/chip-resistor-surface-mount_uni-royal-uniroyal-elec-0603waf3300t5e_C23138.html | https://www.lcsc.com/datasheet/lcsc_datasheet_2206010116_UNI-ROYAL-Uniroyal-Elec-0603WAF3300T5E_C23138.pdf | listing only | 2026-11-10
R51 R61 | 2 | 2 | 100R 1% | 0603 | UNI-ROYAL(Uniroyal Elec) | 0603WAF1000T5E | C22775 | basic | 8870134 | 0.0021 | 0.0021 | 0.0017 | https://www.lcsc.com/product-detail/chip-resistor-surface-mount_uni-royal-uniroyal-elec-0603waf1000t5e_C22775.html | https://www.lcsc.com/datasheet/lcsc_datasheet_2411221126_UNI-ROYAL-Uniroyal-Elec-0603WAF1000T5E_C22775.pdf | listing only | 2026-11-10
C33 | 1 | 1 | 4.7 nF 50 V X7R | 0603 | FH (Guangdong Fenghua Advanced Tech) | 0603B472K500NT | C53987 | basic | 818247 | 0.0052 | 0.0052 | 0.004 | https://www.lcsc.com/product-detail/multilayer-ceramic-capacitors-mlcc-smd-smt_fh-guangdong-fenghua-advanced-tech-0603b472k500nt_C53987.html | https://www.lcsc.com/datasheet/lcsc_datasheet_2304140030_FH--Guangdong-Fenghua-Advanced-Tech-0603B472K500NT_C53987.pdf | read | 2026-11-11 | Fenghua general MLCC specification: X7R, +/-10 %, 50 V, -55 to 125 C, insulation resistance 10 Gohm minimum. Replaces Samsung CL10B472KB8NNNC (C1621, extended); same value, dielectric, tolerance, voltage and package
D8 | 1 | 1 | LED red | 0603 | Hubei KENTO Elec | KT-0603R | C2286 | basic | 6273513 | 0.0077 | 0.0077 | 0.0059 | https://www.lcsc.com/product-detail/led-indication-discrete_hubei-kento-elec-kt-0603r_C2286.html | https://www.lcsc.com/datasheet/lcsc_datasheet_1810231112_Hubei-KENTO-Elec-KT-0603R_C2286.pdf | listing only | 2026-11-10
R55 | 1 | 1 | 100k 1% 200 V 0.25 W | 1206 | UNI-ROYAL(Uniroyal Elec) | 1206W4F1003T5E | C17900 | basic | 1048989 | 0.0096 | 0.0096 | 0.0076 | https://www.lcsc.com/product-detail/chip-resistor-surface-mount_uni-royal-uniroyal-elec-1206w4f1003t5e_C17900.html | https://www.lcsc.com/datasheet/lcsc_datasheet_2206010145_UNI-ROYAL-Uniroyal-Elec-1206W4F1003T5E_C17900.pdf | listing only | 2026-11-10
U10 | 1 | 1 | PCF8563T/5 real-time clock | SO-8 | NXP Semicon | PCF8563T/5,518 | C7440 | extended (preferred) | 26275 | 0.504 | 0.3698 | 0.3387 | https://www.lcsc.com/product-detail/real-time-clocks_nxp-semicon-pcf8563t-5-518_C7440.html | https://www.nxp.com/docs/en/data-sheet/PCF8563.pdf | read | 2026-11-10
Y1 | 1 | 1 | Crystal 32.768 kHz, 12.5 pF, 20 ppm | 3215 | Seiko Epson | Q13FC13500004 | C32346 | basic | 403890 | 0.1677 | 0.1314 | 0.0979 | https://www.lcsc.com/product-detail/crystals_seiko-epson-q13fc13500004_C32346.html | https://www.lcsc.com/datasheet/lcsc_datasheet_2404180925_Seiko-Epson-Q13FC13500004_C32346.pdf | listing only | 2026-11-10
C36 | 1 | 1 | 18 pF 50 V C0G | 0603 | Samsung Electro-Mechanics | CL10C180JB8NNNC | C1647 | basic | 398033 | 0.0137 | 0.0137 | 0.0114 | https://www.lcsc.com/product-detail/multilayer-ceramic-capacitors-mlcc-smd-smt_samsung-electro-mechanics-cl10c180jb8nnnc_C1647.html | https://www.lcsc.com/datasheet/lcsc_datasheet_2304140030_Samsung-Electro-Mechanics-CL10C180JB8NNNC_C1647.pdf | listing only | 2026-11-10
BT1 | 1 | 1 | CR2032 holder | SMD | Q&J | CR2032-BS-6-1 | C70377 | extended | 54362 | 0.1419 | 0.1336 | 0.111 | https://www.lcsc.com/product-detail/button-and-strip-battery-connector_q-j-cr2032-bs-6-1_C70377.html | https://www.lcsc.com/datasheet/lcsc_datasheet_1811061923_Q-J-CR2032-BS-6-1_C70377.pdf | listing only | 2026-11-10 | Cell fitted at final assembly
cell | 1 | 1 | CR2032 lithium coin cell, 3 V | 20 x 3.2 mm | any | CR2032 (IEC 60086-2) |  | not fitted by JLCPCB |  |  |  |  |  |  | none | 2026-11-10 | Not machine-fitted. The JLCPCB parts search on 2026-11-10 lists holders and contacts under CR2032 and no cell, so this line has no LCSC number and no price. Buy locally and fit by hand at final assembly. No cell data sheet was read; the battery-life figure in section 14 uses a nominal 220 mAh
J7 | 1 | 1 | FPC connector 12-way 0.5 mm, bottom contact, flip lock, 2.0 mm high | SMD | XUNPU | FPC-05F-12PH20 | C2856799 | extended | 51374 | 0.1131 | 0.0909 | 0.0712 | https://www.lcsc.com/product-detail/ffc-fpc-flat-flexible-connector-assemblies_xunpu-fpc-05f-12ph20_C2856799.html | https://wmsc.lcsc.com/wmsc/upload/file/pdf/v2/lcsc/2109221030_XUNPU-FPC-05F-12PH20_C2856799.pdf | read | 2026-11-10 | Contact side to be confirmed against a panel sample
DS1 | 1 | 1 | HS20HS072RX 2.0 inch 240x320 IPS TFT, ST7789, 12-way FPC | panel | HS | HS20HS072RX | C5329582 | extended | 460 | 3.0467 | 2.4086 | 2.1926 | https://www.lcsc.com/product-detail/lcd-screen_hs-hs20hs072rx_C5329582.html | https://wmsc.lcsc.com/wmsc/upload/file/pdf/v2/lcsc/2212150930_HS-HS20HS072RX_C5329582.pdf | read | 2026-11-10 | Plugged in at final assembly
R60 | 1 | 1 | 33R 1% 0.25 W | 1206 | UNI-ROYAL(Uniroyal Elec) | 1206W4F330JT5E | C18005 | extended | 176914 | 0.0059 | 0.0059 | 0.0048 | https://www.lcsc.com/product-detail/chip-resistor-surface-mount_uni-royal-uniroyal-elec-1206w4f330jt5e_C18005.html | https://www.lcsc.com/datasheet/lcsc_datasheet_2206010145_UNI-ROYAL-Uniroyal-Elec-1206W4F330JT5E_C18005.pdf | listing only | 2026-11-10
SW3 | 1 | 1 | EC11J1525402 encoder, 30 detents, 15 pulses, push switch | SMD | ALPSALPINE | EC11J1525402 | C209762 | extended | 1486 | 2.5984 | 1.8015 | 1.669 | https://www.lcsc.com/product-detail/rotary-encoders_alpsalpine-ec11j1525402_C209762.html | https://www.lcsc.com/datasheet/lcsc_datasheet_1809041627_ALPSALPINE-EC11J1525402_C209762.pdf | read | 2026-11-10
SW4 SW5 | 2 | 2 | Tactile switch 6x6 mm, 10 mm high | SMD | XKB Connection | TS-1102S-C-M-B | C381050 | extended | 6832 | 0.0701 | 0.056 | 0.0436 | https://www.lcsc.com/product-detail/tactile-switches_xkb-connection-ts-1102s-c-m-b_C381050.html | https://www.lcsc.com/datasheet/lcsc_datasheet_2110151630_XKB-Connection-TS-1102S-C-M-B_C381050.pdf | listing only | 2026-11-10 | Actuator height to be fixed with the enclosure
R64 R65 R66 R67 R68 | 5 | 5 | 3.3k 1% | 0603 | UNI-ROYAL(Uniroyal Elec) | 0603WAF3301T5E | C22978 | basic | 4623283 | 0.0022 | 0.0022 | 0.0017 | https://www.lcsc.com/product-detail/chip-resistor-surface-mount_uni-royal-uniroyal-elec-0603waf3301t5e_C22978.html | https://www.lcsc.com/datasheet/lcsc_datasheet_2206010116_UNI-ROYAL-Uniroyal-Elec-0603WAF3301T5E_C22978.pdf | listing only | 2026-11-10
D12 D13 D14 D18 D23 D101 D201 D301 D401 D501 D601 D701 D801 D901 | 14 | 10 | TVS 48 V bidirectional 600 W | SMB | Littelfuse | SMBJ48CA | C151264 | extended | 5665 | 0.1504 | 0.1269 | 0.1062 | https://www.lcsc.com/product-detail/esd-and-surge-protection-tvs-esd_littelfuse-smbj48ca_C151264.html | https://www.lcsc.com/datasheet/lcsc_datasheet_2304140030_Littelfuse-SMBJ48CA_C151264.pdf | read | 2026-11-10
R74 R75 R77 R78 R80 R81 | 6 | 6 | 10k 1% 200 V 0.25 W | 1206 | UNI-ROYAL(Uniroyal Elec) | 1206W4F1002T5E | C17902 | basic | 2010882 | 0.0078 | 0.0078 | 0.0063 | https://www.lcsc.com/product-detail/chip-resistor-surface-mount_uni-royal-uniroyal-elec-1206w4f1002t5e_C17902.html | https://www.lcsc.com/datasheet/lcsc_datasheet_2206010145_UNI-ROYAL-Uniroyal-Elec-1206W4F1002T5E_C17902.pdf | listing only | 2026-11-10
C44 C45 C46 | 3 | 3 | 22 nF 50 V X7R | 0603 | Samsung Electro-Mechanics | CL10B223KB8NNNC | C21122 | basic | 1032197 | 0.0056 | 0.0056 | 0.0043 | https://www.lcsc.com/product-detail/multilayer-ceramic-capacitors-mlcc-smd-smt_samsung-electro-mechanics-cl10b223kb8nnnc_C21122.html | https://www.lcsc.com/datasheet/lcsc_datasheet_2304140030_Samsung-Electro-Mechanics-CL10B223KB8NNNC_C21122.pdf | listing only | 2026-11-10
U11 | 1 | 1 | TPS2553DBVR current-limited switch | SOT-23-6 | Texas Instruments | TPS2553DBVR | C55266 | extended | 56907 | 0.4582 | 0.3355 | 0.3077 | https://www.lcsc.com/product-detail/power-distribution-switches_texas-instruments-tps2553dbvr_C55266.html | https://www.lcsc.com/datasheet/lcsc_datasheet_1810221710_Texas-Instruments-TPS2553DBVR_C55266.pdf | read | 2026-11-10
D19 D20 | 2 | 2 | SS210 Schottky 2 A 100 V | SMA | MDD(Microdiode Semiconductor) | SS210 | C14996 | basic | 1058030 | 0.0324 | 0.0324 | 0.0259 | https://www.lcsc.com/product-detail/schottky-diodes_mdd-microdiode-semiconductor-ss210_C14996.html | https://www.lcsc.com/datasheet/lcsc_datasheet_2407101107_MDD-Microdiode-Semiconductor-SS210_C14996.pdf | read | 2026-11-10
R84 | 1 | 1 | 4.7R 1% 0.25 W | 1206 | UNI-ROYAL(Uniroyal Elec) | 1206W4F470KT5E | C17937 | extended | 37580 | 0.009 | 0.009 | 0.0071 | https://www.lcsc.com/product-detail/chip-resistor-surface-mount_uni-royal-uniroyal-elec-1206w4f470kt5e_C17937.html | https://www.lcsc.com/datasheet/lcsc_datasheet_2206010145_UNI-ROYAL-Uniroyal-Elec-1206W4F470KT5E_C17937.pdf | listing only | 2026-11-10
C48 C101 C201 C301 C401 C501 C601 C701 C801 C901 | 10 | 6 | 10 nF 100 V X7R | 0805 | Samsung Electro-Mechanics | CL21B103KCANNNC | C18741 | extended | 124879 | 0.0149 | 0.0149 | 0.0126 | https://www.lcsc.com/product-detail/multilayer-ceramic-capacitors-mlcc-smd-smt_samsung-electro-mechanics-cl21b103kcannnc_C18741.html | https://www.lcsc.com/datasheet/lcsc_datasheet_2304140030_Samsung-Electro-Mechanics-CL21B103KCANNNC_C18741.pdf | listing only | 2026-11-10
F3 | 1 | 1 | PTC 0.2 A hold, 60 V | 1812 | Littelfuse | 1812L020/60DR | C315900 | extended | 1650 | 0.3864 | 0.3075 | 0.2736 | https://www.lcsc.com/product-detail/resettable-fuses_littelfuse-1812l020-60dr_C315900.html | https://www.lcsc.com/datasheet/lcsc_datasheet_2304140030_Littelfuse-1812L020-60DR_C315900.pdf | read | 2026-11-10
F101 F201 F301 F401 F501 F601 F701 F801 F901 | 9 | 5 | PTC 1.1 A hold, 60 V, 40 A maximum | 2920 | BHFUSE | BSMD2920-100-60V | C3020148 | extended | 23608 | 0.2429 | 0.1867 | 0.1327 | https://www.lcsc.com/product-detail/resettable-fuses_bhfuse-bsmd2920-100-60v_C3020148.html | https://www.lcsc.com/datasheet/C3020148.pdf | read | 2026-11-10 | BHFUSE BSMD2920 series. Trip 2.2 A, 0.5 s at 8 A, Rmin 0.065 ohm, R1max 0.41 ohm. Replaces Littelfuse 2920L110/60MR (C315903), whose 20 A maximum a 75 VA transformer exceeds; that part fits the same pads if the 20 A limit is accepted
Q101 Q201 Q301 Q401 Q501 Q601 Q701 Q801 Q901 | 9 | 5 | T810-600B-TR triac 8 A 600 V, 3-quadrant | DPAK | STMicroelectronics | T810-600B-TR | C155588 | extended | 3384 | 0.5907 | 0.4566 | 0.396 | https://www.lcsc.com/product-detail/thyristors-scr-modules_stmicroelectronics-t810-600b-tr_C155588.html | https://www.lcsc.com/datasheet/C155588.pdf | read | 2026-11-10 | ST DocID7472 rev 12. ITSM 80 A, I2t 36 A2s, IGT 10 mA in quadrants I to III. Same footprint, pinout and gate figures as the T410-600B-TR (C2970064) it replaces; T810-800B-TR (C2935379) is the 800 V version
R105 R205 R305 R405 R505 R605 R705 R805 R905 | 9 | 5 | 47R 1% 150 V | 0805 | UNI-ROYAL(Uniroyal Elec) | 0805W8F470JT5E | C17714 | basic | 595412 | 0.0028 | 0.0028 | 0.0022 | https://www.lcsc.com/product-detail/chip-resistor-surface-mount_uni-royal-uniroyal-elec-0805w8f470jt5e_C17714.html | https://www.lcsc.com/datasheet/lcsc_datasheet_2206010200_UNI-ROYAL-Uniroyal-Elec-0805W8F470JT5E_C17714.pdf | listing only | 2026-11-10
U101 U201 U301 U401 U501 U601 U701 U801 U901 | 9 | 5 | MOC3023SR2M random-phase opto-triac | SMD-6 | onsemi | MOC3023SR2M | C40701 | extended | 15015 | 0.4696 | 0.3535 | 0.2193 | https://www.lcsc.com/product-detail/triac-scr-output-optoisolators_onsemi-moc3023sr2m_C40701.html | https://www.onsemi.com/download/data-sheet/pdf/moc3023m-d.pdf | read | 2026-11-10
R101 R201 R301 R401 R501 R601 R701 R801 R901 | 9 | 5 | 150R 1% | 0603 | UNI-ROYAL(Uniroyal Elec) | 0603WAF1500T5E | C22808 | basic | 1281948 | 0.0015 | 0.0015 | 0.0011 | https://www.lcsc.com/product-detail/chip-resistor-surface-mount_uni-royal-uniroyal-elec-0603waf1500t5e_C22808.html | https://www.lcsc.com/datasheet/lcsc_datasheet_2206010130_UNI-ROYAL-Uniroyal-Elec-0603WAF1500T5E_C22808.pdf | listing only | 2026-11-10
R103 R203 R303 R403 R503 R603 R703 R803 R903 | 9 | 5 | 100R 1% 150 V | 0805 | UNI-ROYAL(Uniroyal Elec) | 0805W8F1000T5E | C17408 | basic | 7071457 | 0.0042 | 0.0042 | 0.0033 | https://www.lcsc.com/product-detail/chip-resistor-surface-mount_uni-royal-uniroyal-elec-0805w8f1000t5e_C17408.html | https://www.lcsc.com/datasheet/lcsc_datasheet_2411221126_UNI-ROYAL-Uniroyal-Elec-0805W8F1000T5E_C17408.pdf | listing only | 2026-11-10
J1 plug | 1 | 1 | Plug 2-way 3.81 mm screw | loose | Cixi Kefa Elec | KF2EDGK-3.81-2P | C440858 | extended | 49588 | 0.1521 | 0.1267 | 0.0909 | https://www.lcsc.com/product-detail/pluggable-system-terminal-block_cixi-kefa-elec-kf2edgk-3-81-2p_C440858.html | https://wmsc.lcsc.com/wmsc/upload/file/pdf/v2/lcsc/2303312030_Cixi-Kefa-Elec-KF2EDGK-3-81-2P_C440858.pdf | listing only | 2026-11-10 | Supplied loose, not soldered
J2 plug J4 plug | 2 | 2 | Plug 7-way 3.81 mm screw | loose | Cixi Kefa Elec | KF2EDGK-3.81-7P | C440863 | extended | 1827 | 0.3731 | 0.2766 | 0.2357 | https://www.lcsc.com/product-detail/pluggable-system-terminal-block_cixi-kefa-elec-kf2edgk-3-81-7p_C440863.html | https://wmsc.lcsc.com/wmsc/upload/file/pdf/v2/lcsc/2303312000_Cixi-Kefa-Elec-KF2EDGK-3-81-7P_C440863.pdf | listing only | 2026-11-10 | Supplied loose, not soldered
J3 plug | 1 | 0 | Plug 4-way 3.81 mm screw | loose | Cixi Kefa Elec | KF2EDGK-3.81-4P | C440860 | extended | 24158 | 0.2713 | 0.2105 | 0.1641 | https://www.lcsc.com/product-detail/pluggable-system-terminal-block_cixi-kefa-elec-kf2edgk-3-81-4p_C440860.html | https://wmsc.lcsc.com/wmsc/upload/file/pdf/v2/lcsc/2303312000_Cixi-Kefa-Elec-KF2EDGK-3-81-4P_C440860.pdf | listing only | 2026-11-10 | Supplied loose, not soldered
