syntroniks/zoneflow/hardware/toolchain-test/output/toolchain_test-bom-jlcpcb.csv

Comment | Designator | Footprint | LCSC Part # | Quantity
10u | C11,C31 | C_0805_2012Metric | C15850 | 2
22u | C12 | C_0805_2012Metric | C45783 | 1
100n | C32 | C_0603_1608Metric | C14663 | 1
1u | C33 | C_0603_1608Metric | C15849 | 1
10n | C101,C201 | C_0805_2012Metric | C1710 | 2
GREEN | D101,D201 | LED_0603_1608Metric | C72043 | 2
SMBJ33CA | D102,D202 | D_SMB | C78420 | 2
24VAC / VALVE | J1,J101,J201 | TerminalBlock_Phoenix_MKDS-1,5-2-5.08_1x02_P5.08mm_Horizontal | C474952 | 3
USB-C 16P | J11 | USB_C_Receptacle_HRO_TYPE-C-31-M-12 | C165948 | 1
I2C | J31 | PinHeader_1x04_P2.54mm_Vertical | C2905435 | 1
Z0103MN | Q101,Q201 | SOT-223 | C163595 | 2
5k1 | R11,R12 | R_0603_1608Metric | C23186 | 2
10k | R31 | R_0603_1608Metric | C25804 | 1
4k7 | R33,R34 | R_0603_1608Metric | C23162 | 2
220R | R101,R201 | R_0603_1608Metric | C22962 | 2
1k | R102,R202 | R_0603_1608Metric | C21190 | 2
180R | R103,R203 | R_0603_1608Metric | C22828 | 2
100R | R104,R204 | R_1206_3216Metric | C17901 | 2
RESET / BOOT | SW31,SW32 | SW_SPST_TL3342 | C2886898 | 2
USBLC6-2SC6 | U11 | SOT-23-6 | C7519 | 1
AMS1117-3.3 | U12 | SOT-223-3_TabPin2 | C6186 | 1
ESP32-S3-WROOM-1-N8 | U31 | ESP32-S3-WROOM-1 | C2913198 | 1
MOC3023 | U101,U201 | SMDIP-6_W9.53mm | C115469 | 2
