syntroniks/zoneflow/enclosure/output/plates/zoneflow-plate-250-b-test-fit-kit.3mf

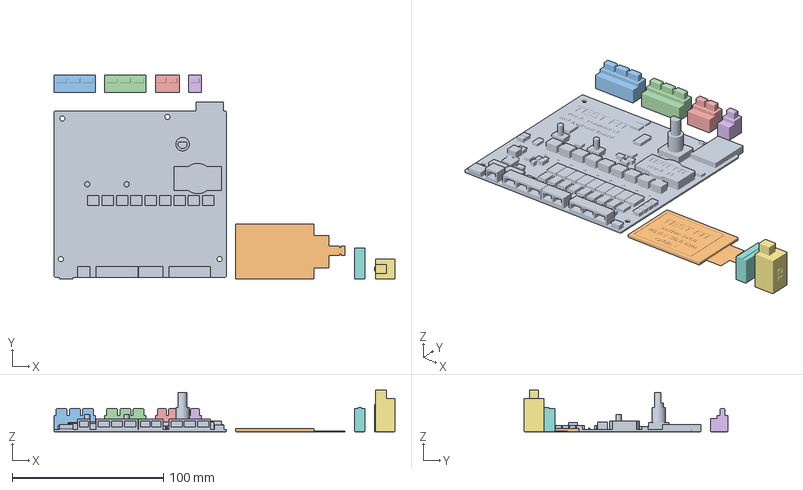
[picture p185: CAD file, 2026-11-12]
enclosure/output/plates/zoneflow-plate-250-b-test-fit-kit.3mf
225.4 x 134.6 x 27.5 mm
zoneflow-testfit-board
zoneflow-testfit-panel
zoneflow-testfit-plug-7p (1)
zoneflow-testfit-plug-7p (2)
zoneflow-testfit-plug-4p
zoneflow-testfit-plug-2p
zoneflow-testfit-c1
zoneflow-testfit-k1
