syntroniks/zoneflow/enclosure/output/test-fit/view-only/zoneflow-a-board-detailed-view-only.3mf

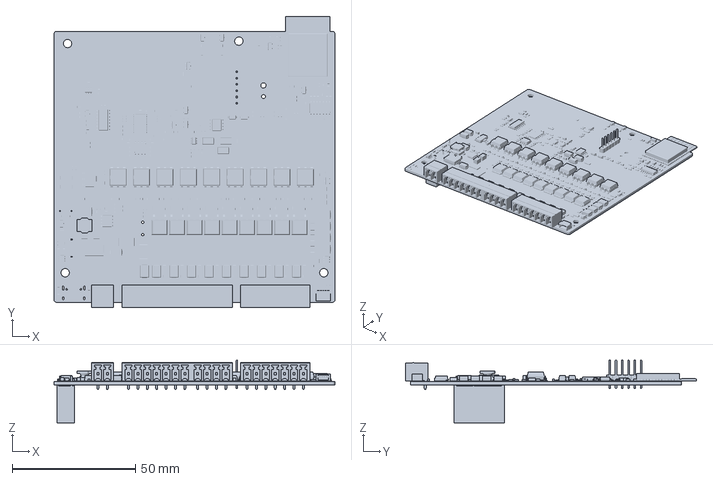
[picture p186: CAD file, 2026-11-12]
enclosure/output/test-fit/view-only/zoneflow-a-board-detailed-view-only.3mf
114.0 x 118.1 x 25.5 mm
