syntroniks/zoneflow/enclosure/output/test-fit/zoneflow-testfit-c1.3mf

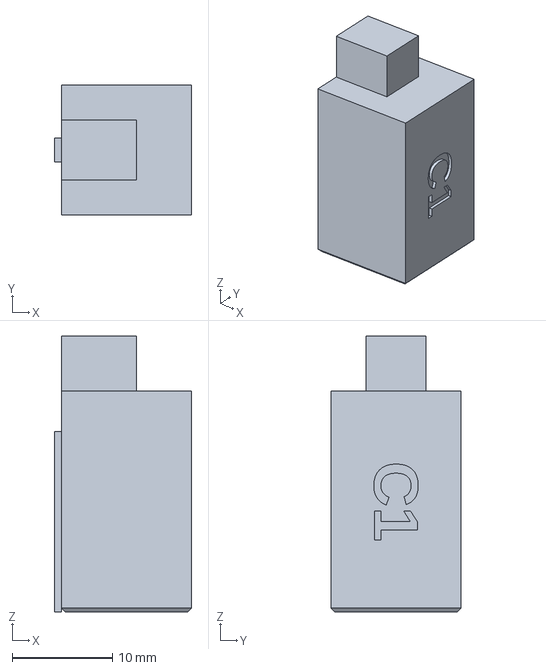
[picture p187: CAD file, 2026-11-12]
enclosure/output/test-fit/zoneflow-testfit-c1.3mf
13.7 x 13.0 x 27.5 mm
