syntroniks/zoneflow/enclosure/output/zoneflow-lightpipe.3mf

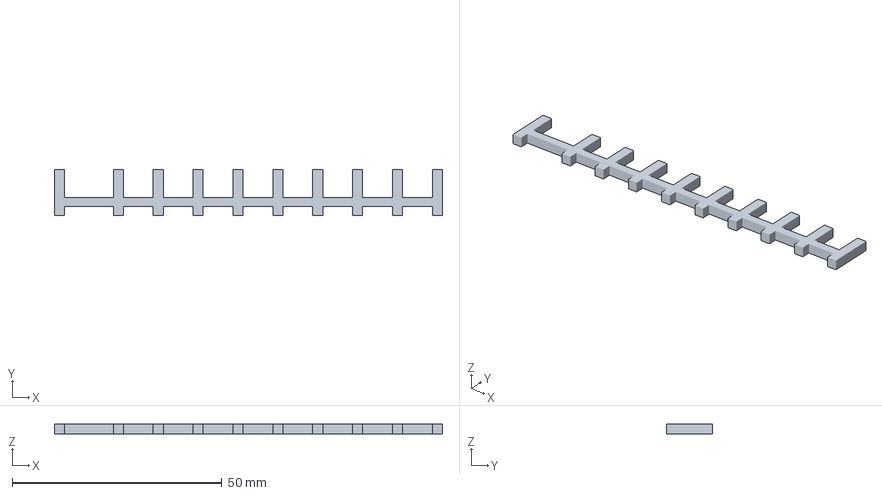
[picture p188: CAD file, 2026-11-12]
enclosure/output/zoneflow-lightpipe.3mf
92.4 x 11.0 x 2.40 mm
