syntroniks/zoneflow/hardware/toolchain-test/output/toolchain_test.step

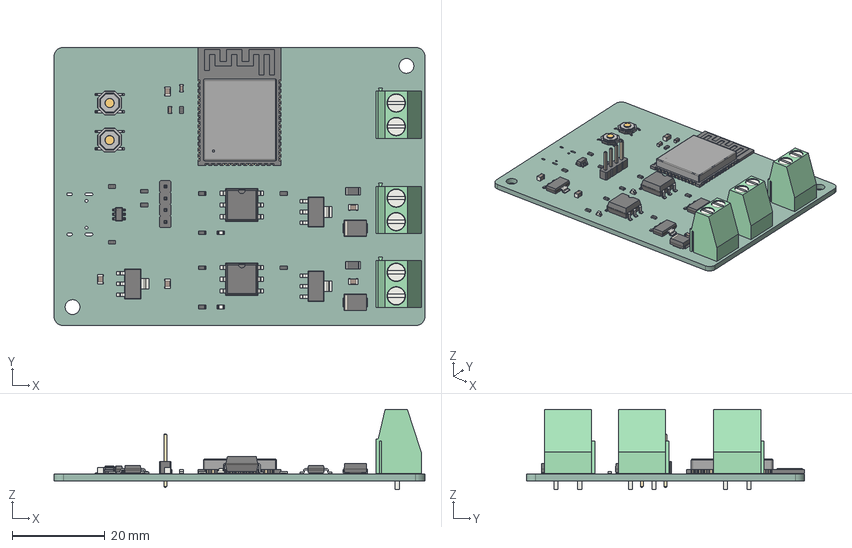
[picture p189: CAD file, 2026-11-10]
hardware/toolchain-test/output/toolchain_test.step
80.0 x 60.0 x 17.3 mm
ESP32-S3-WROOM-1
C_0805_2012Metric x 5
SOT-23-6
R_1206_3216Metric x 2
SW_SPST_TL3342 x 2
C_0603_1608Metric x 2
R_0603_1608Metric x 11
PinHeader_1x04_P254mm_Vertical
D_SMB x 2
TerminalBlock_Phoenix_MKDS-1,5-2-5.08_1x02_P5.08mm_Horizontal x 3
SMDIP_6_W953mm x 2
SOT-223 x 3
LED_0603_1608Metric x 2
toolchain_test_PCB
