syntroniks/zoneflow/enclosure/output/plates/zoneflow-plate-250-a1-base-and-small-parts.3mf

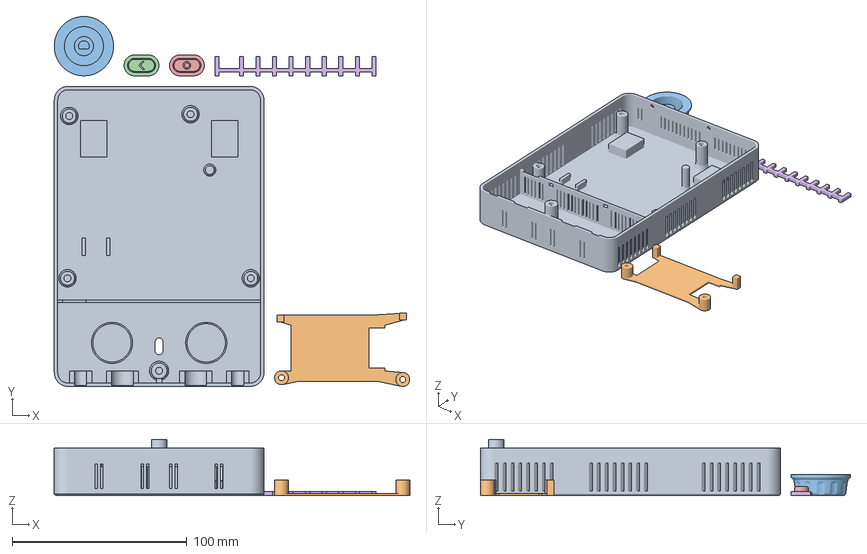
[picture p190: CAD file, 2026-11-12]
enclosure/output/plates/zoneflow-plate-250-a1-base-and-small-parts.3mf
203.7 x 212.0 x 32.2 mm
zoneflow-base
zoneflow-bridge
zoneflow-knob
zoneflow-button-back
zoneflow-button-home
zoneflow-lightpipe
