syntroniks/zoneflow/enclosure/output/test-fit/zoneflow-testfit-panel.3mf

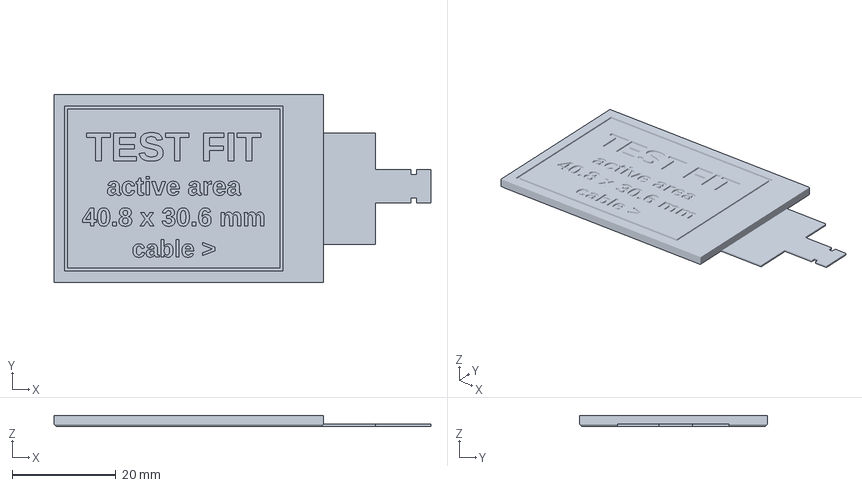
[picture p191: CAD file, 2026-11-12]
enclosure/output/test-fit/zoneflow-testfit-panel.3mf
72.5 x 36.2 x 2.05 mm
