syntroniks/zoneflow/enclosure/output/zoneflow-base.3mf

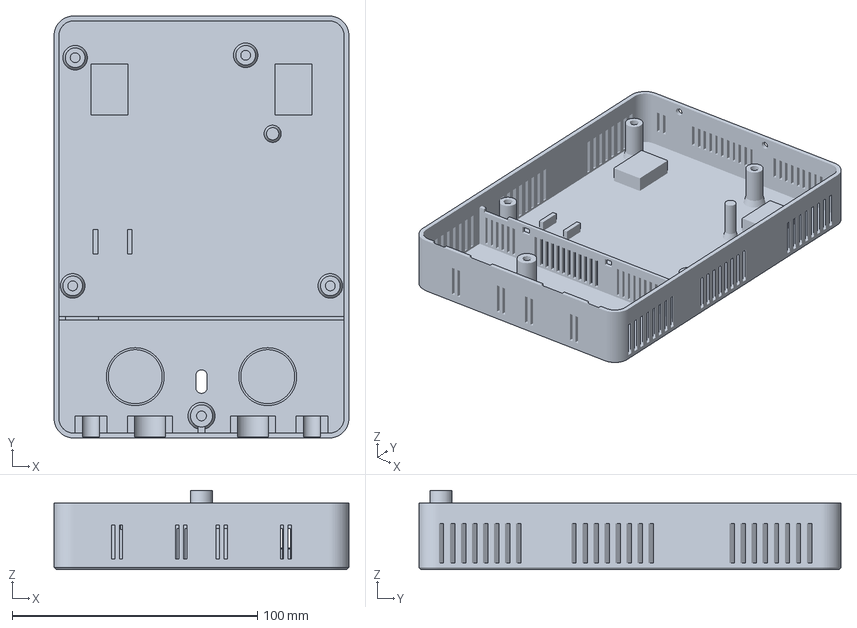
[picture p192: CAD file, 2026-11-12]
enclosure/output/zoneflow-base.3mf
120.2 x 172.0 x 32.2 mm
