syntroniks/zoneflow/enclosure/output/test-fit/zoneflow-testfit-board.3mf

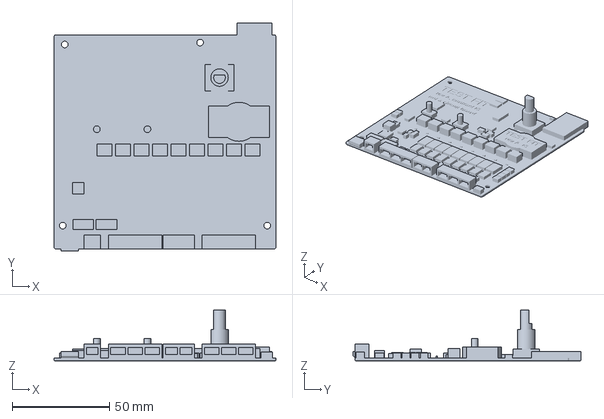
[picture p193: CAD file, 2026-11-12]
enclosure/output/test-fit/zoneflow-testfit-board.3mf
114.0 x 117.0 x 26.1 mm
