syntroniks/zoneflow/enclosure/output/zoneflow-bridge.3mf

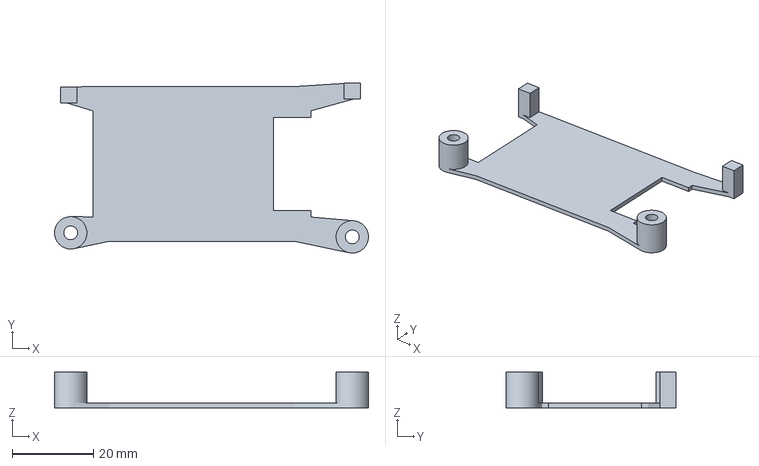
[picture p194: CAD file, 2026-11-12]
enclosure/output/zoneflow-bridge.3mf
77.5 x 42.0 x 8.85 mm
