syntroniks/zoneflow/enclosure/output/plates/zoneflow-plate-1-test-fit-kit.3mf

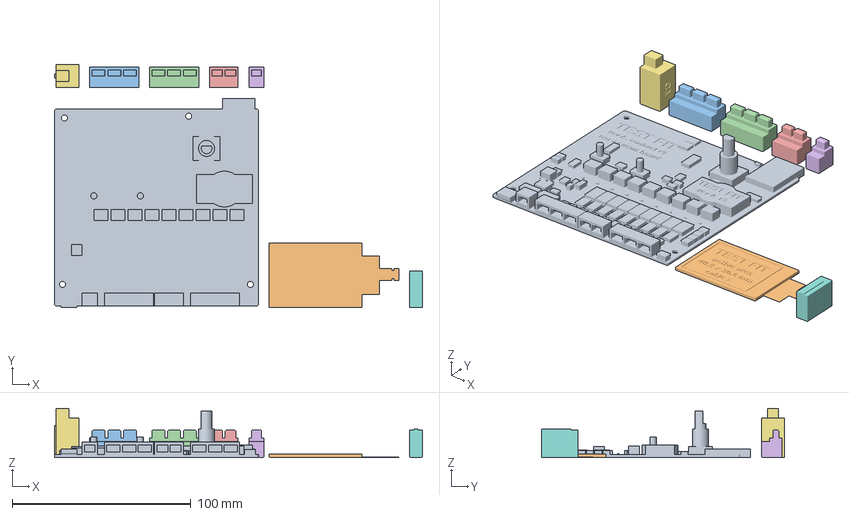
[picture p195: CAD file, 2026-11-12]
enclosure/output/plates/zoneflow-plate-1-test-fit-kit.3mf
205.7 x 136.0 x 27.5 mm
zoneflow-testfit-board
zoneflow-testfit-panel
zoneflow-testfit-plug-7p (1)
zoneflow-testfit-plug-7p (2)
zoneflow-testfit-plug-4p
zoneflow-testfit-plug-2p
zoneflow-testfit-c1
zoneflow-testfit-k1
