syntroniks/zoneflow/enclosure/output/test-fit/zoneflow-testfit-k1.3mf

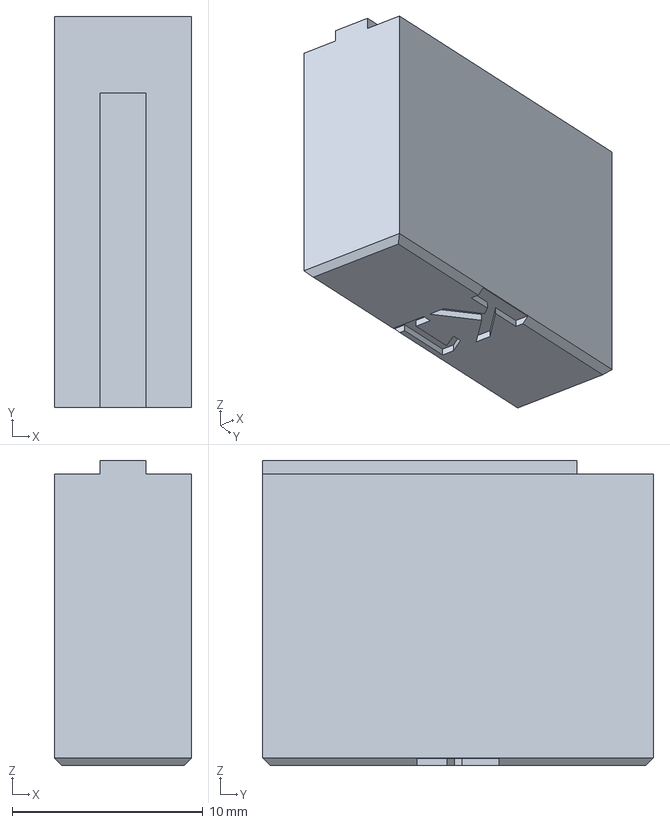
[picture p196: CAD file, 2026-11-12]
enclosure/output/test-fit/zoneflow-testfit-k1.3mf
7.20 x 20.5 x 16.0 mm
