syntroniks/zoneflow/enclosure/output/zoneflow-cover.3mf

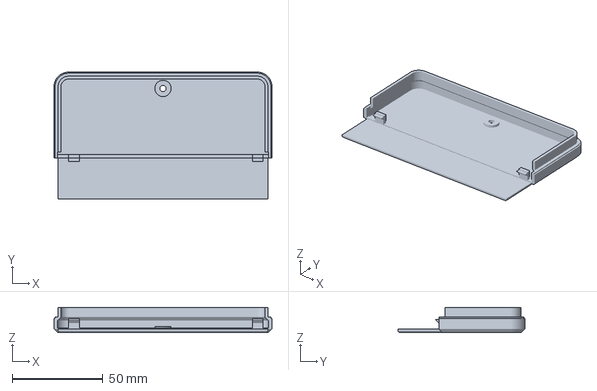
[picture p197: CAD file, 2026-11-12]
enclosure/output/zoneflow-cover.3mf
120.2 x 69.9 x 13.9 mm
