syntroniks/zoneflow/enclosure/output/plates/zoneflow-plate-2-body.3mf

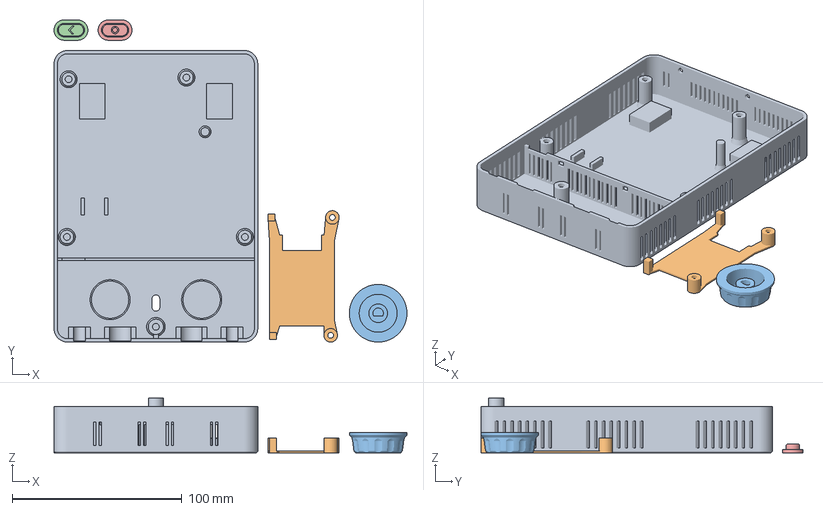
[picture p198: CAD file, 2026-11-12]
enclosure/output/plates/zoneflow-plate-2-body.3mf
208.2 x 190.0 x 32.2 mm
zoneflow-base
zoneflow-bridge
zoneflow-knob
zoneflow-button-back
zoneflow-button-home
