syntroniks/zoneflow/enclosure/output/test-fit/zoneflow-testfit-plug-4p.3mf

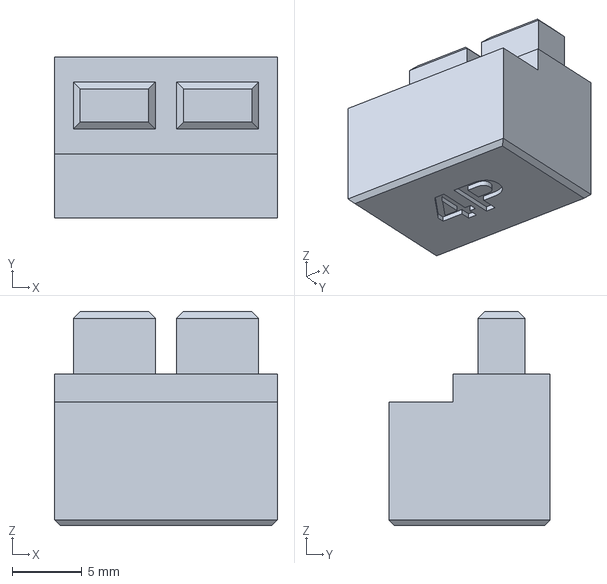
[picture p199: CAD file, 2026-11-12]
enclosure/output/test-fit/zoneflow-testfit-plug-4p.3mf
16.0 x 11.6 x 15.4 mm
