syntroniks/zoneflow/enclosure/output/zoneflow-button-back.3mf

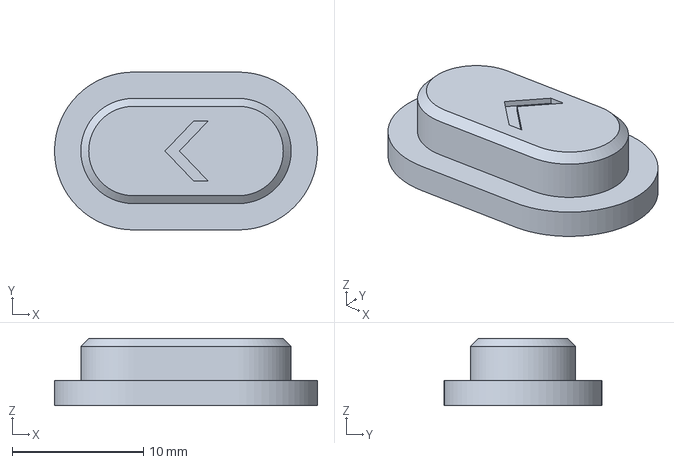
[picture p200: CAD file, 2026-11-12]
enclosure/output/zoneflow-button-back.3mf
20.0 x 12.0 x 5.10 mm
