syntroniks/zoneflow/enclosure/output/plates/zoneflow-plate-3-front.3mf

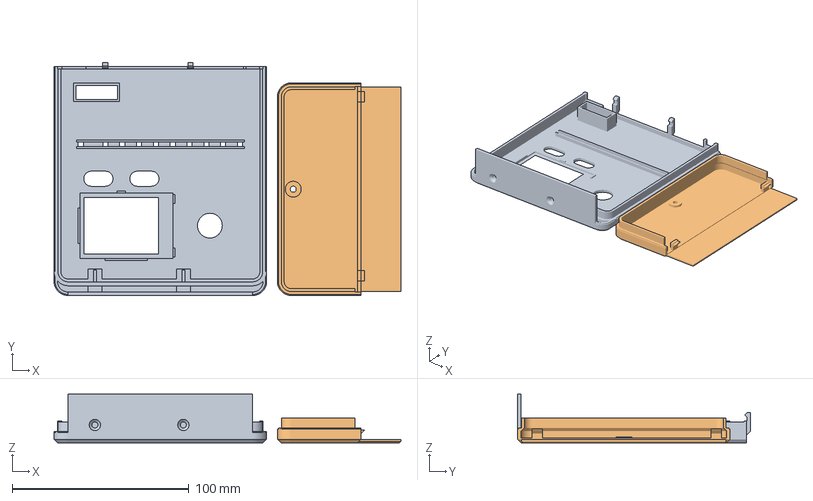
[picture p201: CAD file, 2026-11-12]
enclosure/output/plates/zoneflow-plate-3-front.3mf
196.1 x 131.7 x 27.5 mm
zoneflow-fascia
zoneflow-cover
