syntroniks/zoneflow/enclosure/output/test-fit/zoneflow-testfit-plug-2p.3mf

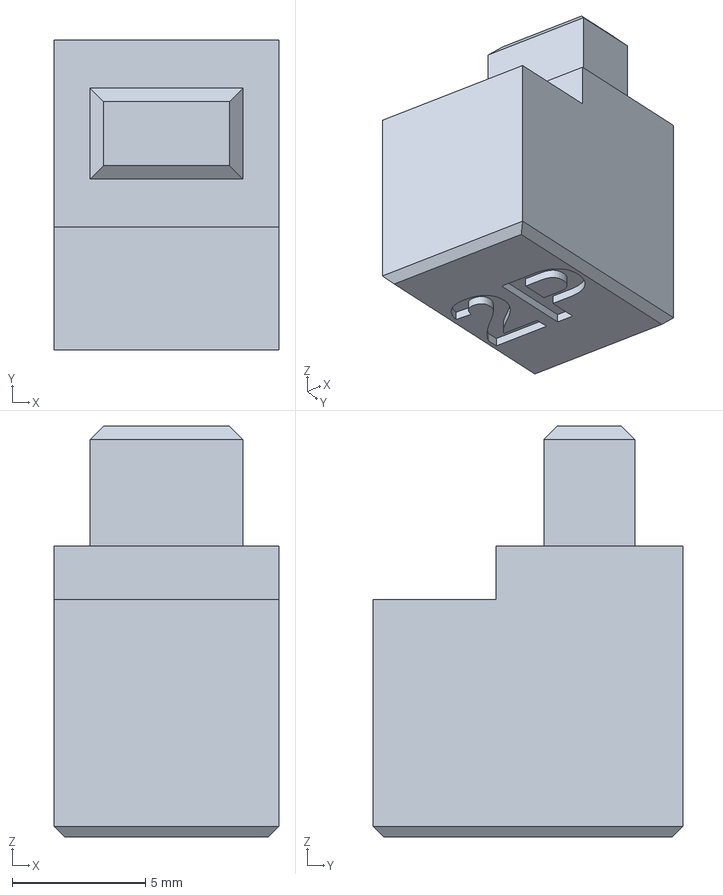
[picture p202: CAD file, 2026-11-12]
enclosure/output/test-fit/zoneflow-testfit-plug-2p.3mf
8.42 x 11.6 x 15.4 mm
