syntroniks/zoneflow/enclosure/output/zoneflow-knob.3mf

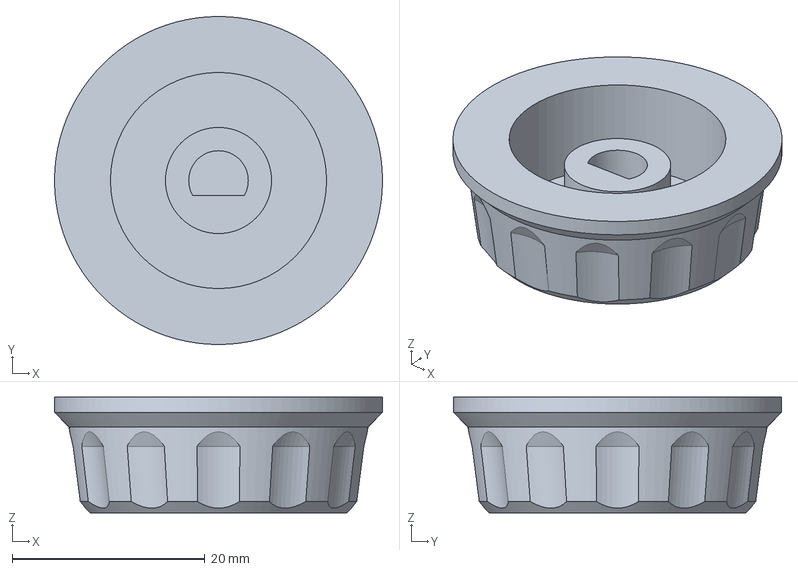
[picture p203: CAD file, 2026-11-12]
enclosure/output/zoneflow-knob.3mf
34.0 x 34.0 x 12.0 mm
