syntroniks/zoneflow/enclosure/output/plates/zoneflow-plate-250-a2-fascia-and-cover.3mf

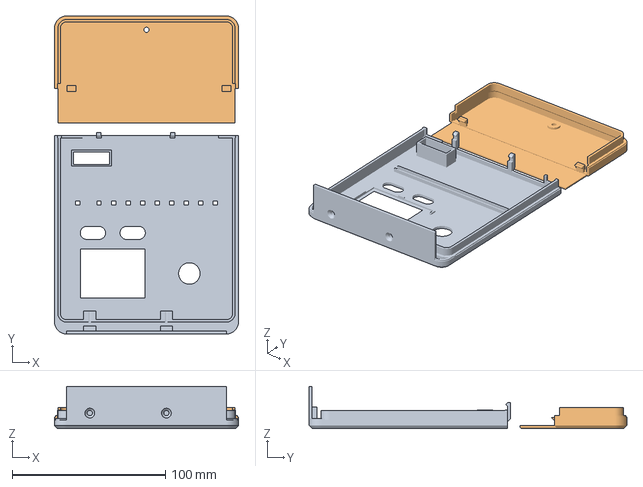
[picture p204: CAD file, 2026-11-12]
enclosure/output/plates/zoneflow-plate-250-a2-fascia-and-cover.3mf
120.2 x 207.6 x 27.5 mm
zoneflow-fascia
zoneflow-cover
