syntroniks/zoneflow/enclosure/output/test-fit/zoneflow-testfit-plug-7p.3mf

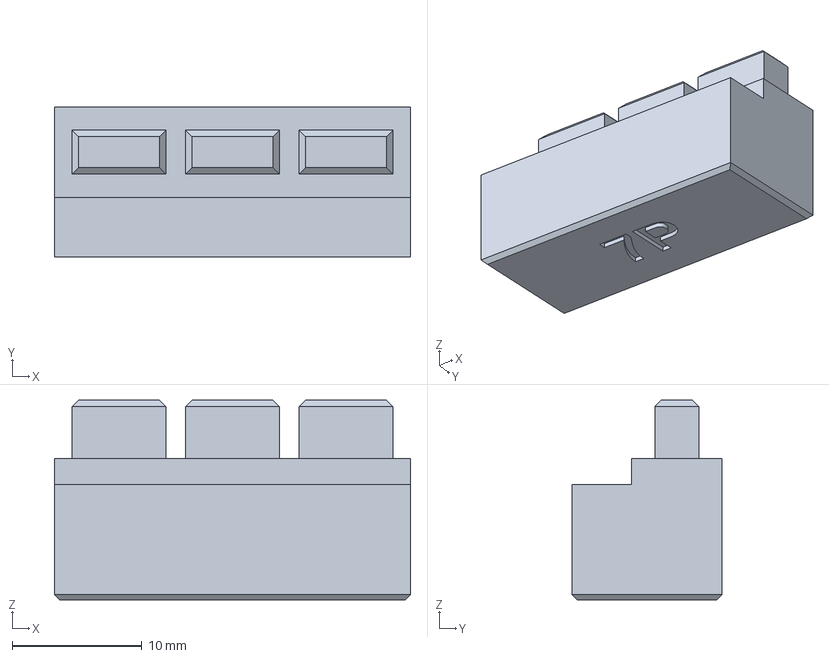
[picture p205: CAD file, 2026-11-12]
enclosure/output/test-fit/zoneflow-testfit-plug-7p.3mf
27.5 x 11.6 x 15.4 mm
