syntroniks/zoneflow/enclosure/output/zoneflow-fascia.3mf

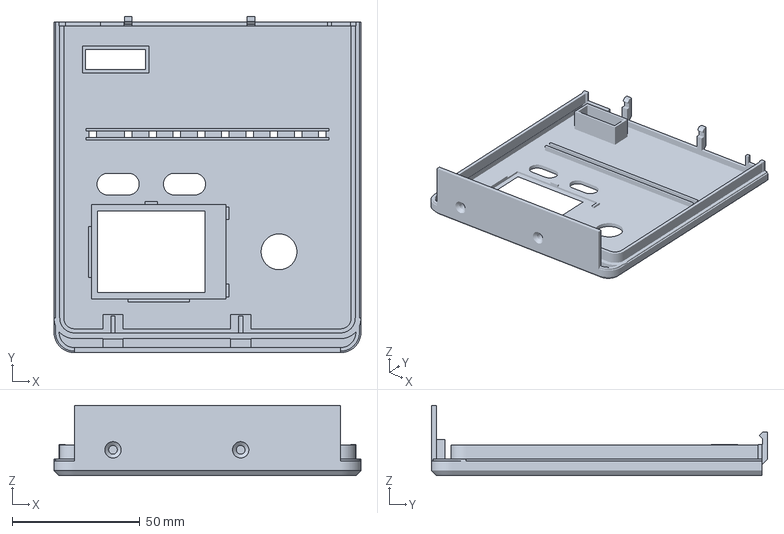
[picture p206: CAD file, 2026-11-12]
enclosure/output/zoneflow-fascia.3mf
120.2 x 131.7 x 27.5 mm
