syntroniks/zoneflow/enclosure/testfit_params.scad

// GENERATED by enclosure/tools/gen_testfit.py from enclosure/board_layout.json
// (the board file), hardware/mechanical.yaml and design/heights.toml.
// Do not edit. Run `make` in enclosure/.

tf_board_rev = "A";
tf_board_date = "2026-11-10";
tf_contract_rev = 3;
tf_thickness = 1.6;
tf_min_height = 1.5;
tf_tail_len = 2.5;
// Board outline, counter-clockwise, corner arcs as polygons.
tf_outline = [
    [1, 0],
    [113, 0],
    [113.195, 0.0192],
    [113.383, 0.0761],
    [113.556, 0.1685],
    [113.707, 0.2929],
    [113.832, 0.4444],
    [113.924, 0.6173],
    [113.981, 0.8049],
    [114, 1],
    [114, 109],
    [113.981, 109.195],
    [113.924, 109.383],
    [113.832, 109.556],
    [113.707, 109.707],
    [113.556, 109.832],
    [113.383, 109.924],
    [113.195, 109.981],
    [113, 110],
    [1, 110],
    [0.8049, 109.981],
    [0.6173, 109.924],
    [0.4444, 109.832],
    [0.2929, 109.707],
    [0.1685, 109.556],
    [0.0761, 109.383],
    [0.0192, 109.195],
    [0, 109],
    [0, 1],
    [0.0192, 0.8049],
    [0.0761, 0.6173],
    [0.1685, 0.4444],
    [0.2929, 0.2929],
    [0.4444, 0.1685],
    [0.6173, 0.0761],
    [0.8049, 0.0192],
];
// Unplated mounting holes: ref, x, y, diameter.
tf_holes = [
    ["H1", 5.5, 105, 3.4],
    ["H2", 75, 106, 3.4],
    ["H3", 4.5, 12, 3.4],
    ["H4", 109.5, 12, 3.4],
];
// Stand-ins: ref, group, kind, centre x, y, then size x, y (box) or diameter, 0 (cyl), z0, z1.
// z is the height above the surface the part is on. group "top" is on the main piece;
// any other group is a bottom-side part, printed on its own.
tf_prims = [
    ["BT1", "top", "box", 95, 65.3, 31.3, 16, 0, 5.5],
    ["BT1", "top", "cyl", 95, 65.3, 20, 0, 0, 5.5],
    ["C14", "top", "box", 89.1, 107, 3.2, 1.6, 0, 1.8],
    ["C2", "top", "box", 27.55, 29.4, 2.5, 3.2, 0, 2.7],
    ["C3", "top", "box", 27.55, 34.2, 2.5, 3.2, 0, 2.7],
    ["C5", "top", "box", 17.2, 26.55, 3.2, 1.6, 0, 1.8],
    ["C6", "top", "box", 12.4, 26.55, 3.2, 1.6, 0, 1.8],
    ["D1", "top", "box", 16.3, 21.8, 7.1, 6.2, 0, 2.65],
    ["D101", "top", "box", 48.7, 12.53, 4, 4.6, 0, 2.45],
    ["D102", "top", "box", 35.5, 42, 1.6, 0.8, 0, 0.8],
    ["D12", "top", "box", 109.71, 26.2, 4.6, 4, 0, 2.45],
    ["D13", "top", "box", 109.71, 30.85, 4.6, 4, 0, 2.45],
    ["D14", "top", "box", 109.71, 21.55, 4.6, 4, 0, 2.45],
    ["D18", "top", "box", 109.71, 35.5, 4.6, 4, 0, 2.45],
    ["D19", "top", "box", 69.8, 65.5, 4.6, 3, 0, 2.45],
    ["D2", "top", "box", 25.2, 20.3, 4.6, 3, 0, 2.45],
    ["D20", "top", "box", 68.7, 61.6, 4.6, 3, 0, 2.45],
    ["D201", "top", "box", 55.8, 12.53, 4, 4.6, 0, 2.45],
    ["D202", "top", "box", 45, 42, 1.6, 0.8, 0, 0.8],
    ["D23", "top", "box", 36.7, 12.6, 4, 4.6, 0, 2.45],
    ["D24", "top", "box", 62.6, 65.5, 4.6, 3, 0, 2.45],
    ["D25", "top", "box", 12.9, 36.75, 4.6, 4, 0, 2.45],
    ["D3", "top", "box", 5, 50.6, 4.6, 3, 0, 2.45],
    ["D301", "top", "box", 62.9, 12.53, 4, 4.6, 0, 2.45],
    ["D302", "top", "box", 54.5, 42, 1.6, 0.8, 0, 0.8],
    ["D4", "top", "box", 5, 46.9, 4.6, 3, 0, 2.45],
    ["D401", "top", "box", 70, 12.53, 4, 4.6, 0, 2.45],
    ["D402", "top", "box", 64, 42, 1.6, 0.8, 0, 0.8],
    ["D501", "top", "box", 77.1, 12.53, 4, 4.6, 0, 2.45],
    ["D502", "top", "box", 73.5, 42, 1.6, 0.8, 0, 0.8],
    ["D6", "top", "box", 12, 42, 1.6, 0.8, 0, 0.8],
    ["D601", "top", "box", 84.2, 12.53, 4, 4.6, 0, 2.45],
    ["D602", "top", "box", 83, 42, 1.6, 0.8, 0, 0.8],
    ["D701", "top", "box", 91.3, 12.53, 4, 4.6, 0, 2.45],
    ["D702", "top", "box", 92.5, 42, 1.6, 0.8, 0, 0.8],
    ["D801", "top", "box", 98.4, 12.53, 4, 4.6, 0, 2.45],
    ["D802", "top", "box", 102, 42, 1.6, 0.8, 0, 0.8],
    ["D901", "top", "box", 41.6, 12.53, 4, 4.6, 0, 2.45],
    ["D902", "top", "box", 26, 42, 1.6, 0.8, 0, 0.8],
    ["F1", "top", "box", 27, 12.6, 10.62, 5.03, 0, 3.81],
    ["F101", "top", "box", 49.95, 20.93, 5.12, 7.355, 0, 2.1],
    ["F201", "top", "box", 57.05, 20.93, 5.12, 7.355, 0, 2.1],
    ["F301", "top", "box", 64.15, 20.93, 5.12, 7.355, 0, 2.1],
    ["F4", "top", "box", 15, 12.6, 10.62, 5.03, 0, 3.81],
    ["F401", "top", "box", 71.25, 20.93, 5.12, 7.355, 0, 2.1],
    ["F5", "top", "box", 31.1, 34.255, 2.69, 6.1, 0, 2.69],
    ["F501", "top", "box", 78.35, 20.93, 5.12, 7.355, 0, 2.1],
    ["F601", "top", "box", 85.45, 20.93, 5.12, 7.355, 0, 2.1],
    ["F701", "top", "box", 92.55, 20.93, 5.12, 7.355, 0, 2.1],
    ["F801", "top", "box", 99.65, 20.93, 5.12, 7.355, 0, 2.1],
    ["F901", "top", "box", 42.85, 20.93, 5.12, 7.355, 0, 2.1],
    ["J1", "top", "box", 19.71, 2.6, 8.42, 9.2, 0, 7],
    ["J2", "top", "box", 41.655, 2.6, 27.47, 9.2, 0, 7],
    ["J3", "top", "box", 64.01, 2.6, 16.04, 9.2, 0, 7],
    ["J4", "top", "box", 89.765, 2.6, 27.47, 9.2, 0, 7],
    ["J5", "top", "box", 8, 2.675, 8.94, 7.35, 0, 3.26],
    ["J6", "top", "box", 109.25, 2.63, 6, 4.25, 0, 2.95],
    ["J7", "top", "box", 60.44, 88.43, 5.12, 10.4, 0, 2],
    ["L1", "top", "box", 12.4, 31.2, 6, 6, 0, 4.5],
    ["Q101", "top", "box", 49.95, 31.29, 6.5, 9.92, 0, 2.4],
    ["Q201", "top", "box", 57.05, 31.29, 6.5, 9.92, 0, 2.4],
    ["Q301", "top", "box", 64.15, 31.29, 6.5, 9.92, 0, 2.4],
    ["Q401", "top", "box", 71.25, 31.29, 6.5, 9.92, 0, 2.4],
    ["Q501", "top", "box", 78.35, 31.29, 6.5, 9.92, 0, 2.4],
    ["Q601", "top", "box", 85.45, 31.29, 6.5, 9.92, 0, 2.4],
    ["Q701", "top", "box", 92.55, 31.29, 6.5, 9.92, 0, 2.4],
    ["Q801", "top", "box", 99.65, 31.29, 6.5, 9.92, 0, 2.4],
    ["Q901", "top", "box", 42.85, 31.29, 6.5, 9.92, 0, 2.4],
    ["SW1", "top", "box", 48, 105.5, 6.5, 5.1, 0, 1.5],
    ["SW2", "top", "box", 48, 99.4, 6.5, 5.1, 0, 1.5],
    ["SW3", "top", "box", 85, 88, 15, 13.5, 0, 4.5],
    ["SW3", "top", "box", 85, 88, 8.5, 18, 0, 1.2],
    ["SW3", "top", "cyl", 85, 88, 8.975, 0, 4.5, 14.5],
    ["SW3", "top", "cyl", 85, 88, 5.975, 0, 14.5, 24.5],
    ["SW4", "top", "box", 22, 61.5, 8.6, 6, 0, 3.3],
    ["SW4", "top", "cyl", 22, 61.5, 3.5, 0, 3.3, 10],
    ["SW5", "top", "box", 48, 61.5, 8.6, 6, 0, 3.3],
    ["SW5", "top", "cyl", 48, 61.5, 3.5, 0, 3.3, 10],
    ["U1", "top", "box", 21.5, 33, 3.95, 4.95, 0, 1.7],
    ["U10", "top", "box", 66, 72, 3.9, 4.9, 0, 1.75],
    ["U101", "top", "box", 35.5, 50.8, 7.62, 6.35, 0, 4.8],
    ["U201", "top", "box", 45, 50.8, 7.62, 6.35, 0, 4.8],
    ["U3", "top", "box", 14.5, 50.1, 3.7, 6.7, 0, 1.8],
    ["U301", "top", "box", 54.5, 50.8, 7.62, 6.35, 0, 4.8],
    ["U4", "top", "box", 103, 103.25, 18, 25.5, 0, 3.25],
    ["U401", "top", "box", 64, 50.8, 7.62, 6.35, 0, 4.8],
    ["U501", "top", "box", 73.5, 50.8, 7.62, 6.35, 0, 4.8],
    ["U6", "top", "box", 108, 78.9, 8.65, 3.9, 0, 1.75],
    ["U601", "top", "box", 83, 50.8, 7.62, 6.35, 0, 4.8],
    ["U7", "top", "box", 20, 74, 3.9, 8.65, 0, 1.75],
    ["U701", "top", "box", 92.5, 50.8, 7.62, 6.35, 0, 4.8],
    ["U8", "top", "box", 35, 62.6, 4.9, 3.9, 0, 1.75],
    ["U801", "top", "box", 102, 50.8, 7.62, 6.35, 0, 4.8],
    ["U901", "top", "box", 26, 50.8, 7.62, 6.35, 0, 4.8],
    ["C1", "C1", "box", 20.75, 30, 22, 13, 0, 13],
    ["C1", "C1", "box", 34.5, 30, 5.5, 6, 0, 7.5],
    ["K1", "K1", "box", 4.8, 27.85, 7.2, 20.5, 0, 15.3],
];
// Terminal headers: ref, x0, x1, y of the mating face, y of the back, height, poles.
tf_headers = [
    ["J1", 15.5, 23.92, -2, 7.2, 7, 2],
    ["J2", 27.92, 55.39, -2, 7.2, 7, 7],
    ["J3", 55.99, 72.03, -2, 7.2, 7, 4],
    ["J4", 76.03, 103.5, -2, 7.2, 7, 7],
];
// Mated plugs: ref, x0, x1, y0, y1, z0, z1.
tf_plugs = [
    ["J1-plug", 15.5, 23.92, -10.9, -2, 0, 11.6],
    ["J2-plug", 27.92, 55.39, -10.9, -2, 0, 11.6],
    ["J3-plug", 55.99, 72.03, -10.9, -2, 0, 11.6],
    ["J4-plug", 76.03, 103.5, -10.9, -2, 0, 11.6],
];
// Soldered lead ends: ref, x, y, hole diameter, side they stick out of.
tf_tails = [
    ["C1", 36, 32.5, 1, "top"],
    ["C1", 36, 27.5, 1, "top"],
    ["J1", 17.805, 5.9, 1.4, "bottom"],
    ["J1", 21.615, 5.9, 1.4, "bottom"],
    ["J2", 30.225, 5.9, 1.4, "bottom"],
    ["J2", 34.035, 5.9, 1.4, "bottom"],
    ["J2", 37.845, 5.9, 1.4, "bottom"],
    ["J2", 41.655, 5.9, 1.4, "bottom"],
    ["J2", 45.465, 5.9, 1.4, "bottom"],
    ["J2", 49.275, 5.9, 1.4, "bottom"],
    ["J2", 53.085, 5.9, 1.4, "bottom"],
    ["J3", 58.295, 5.9, 1.4, "bottom"],
    ["J3", 62.105, 5.9, 1.4, "bottom"],
    ["J3", 65.915, 5.9, 1.4, "bottom"],
    ["J3", 69.725, 5.9, 1.4, "bottom"],
    ["J4", 78.335, 5.9, 1.4, "bottom"],
    ["J4", 82.145, 5.9, 1.4, "bottom"],
    ["J4", 85.955, 5.9, 1.4, "bottom"],
    ["J4", 89.765, 5.9, 1.4, "bottom"],
    ["J4", 93.575, 5.9, 1.4, "bottom"],
    ["J4", 97.385, 5.9, 1.4, "bottom"],
    ["J4", 101.195, 5.9, 1.4, "bottom"],
    ["J5", 3.68, 5.805, 0.6, "bottom"],
    ["J5", 3.68, 1.625, 0.6, "bottom"],
    ["J5", 12.32, 5.805, 0.6, "bottom"],
    ["J5", 12.32, 1.625, 0.6, "bottom"],
    ["K1", 7.15, 25.5, 1.1, "top"],
    ["K1", 7.15, 18.5, 1.1, "top"],
    ["K1", 2.45, 37, 1.1, "top"],
    ["K1", 7.15, 37, 1.1, "top"],
];
tf_usb = [3.53, 12.47, -1, 6.35, 3.26];   // x0, x1, y of the mouth, y of the back, height
tf_module = [94, 112, 90.5, 116, 3.25];   // x0, x1, y0, y1, height
tf_shaft_flat = [4.45, 7];   // across the flat, its length from the top
tf_panel_tail = [20.7, 6.5, 88.43];   // FPC tail beyond the outline: length, width, centre y
tf_panel_root_y = [77.2, 98.65];   // wide part of the FPC at the panel edge
tf_panel_exit = 1.3;   // the tail leaves this far below the glass
