syntroniks/zoneflow/(list of files, cad)

Other CAD files:
hardware/zoneflow-a/output/zoneflow-a.step
enclosure/output/plates/zoneflow-plate-4-clear.3mf
enclosure/output/zoneflow-button-home.3mf
enclosure/output/test-fit/view-only/zoneflow-a-board-detailed-view-only.stl
enclosure/output/test-fit/zoneflow-testfit-board.stl
enclosure/output/test-fit/zoneflow-testfit-c1.stl
enclosure/output/test-fit/zoneflow-testfit-k1.stl
enclosure/output/test-fit/zoneflow-testfit-panel.stl
enclosure/output/test-fit/zoneflow-testfit-plug-2p.stl
enclosure/output/test-fit/zoneflow-testfit-plug-4p.stl
enclosure/output/test-fit/zoneflow-testfit-plug-7p.stl
enclosure/output/zoneflow-base.stl
enclosure/output/zoneflow-bridge.stl
enclosure/output/zoneflow-button-back.stl
enclosure/output/zoneflow-button-home.stl
enclosure/output/zoneflow-cover.stl
enclosure/output/zoneflow-fascia.stl
enclosure/output/zoneflow-knob.stl
enclosure/output/zoneflow-lightpipe.stl
