syntroniks/zoneflow/docs/design/display-ui/manual-program-confirm.png

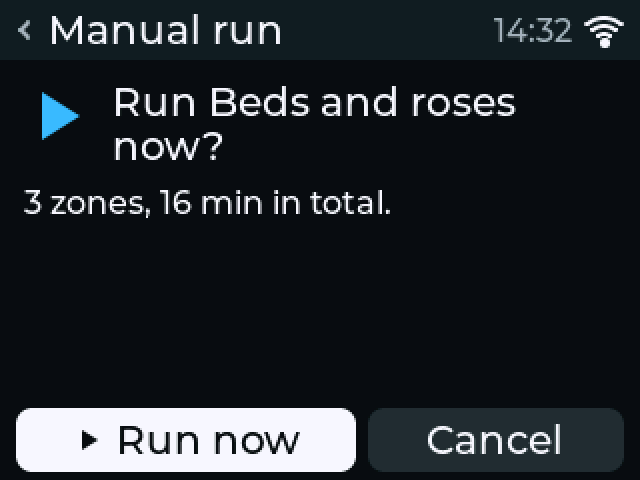
docs/design/display-ui/manual-program-confirm.png
