syntroniks/zoneflow/docs/design/display-ui/manual-programs.png

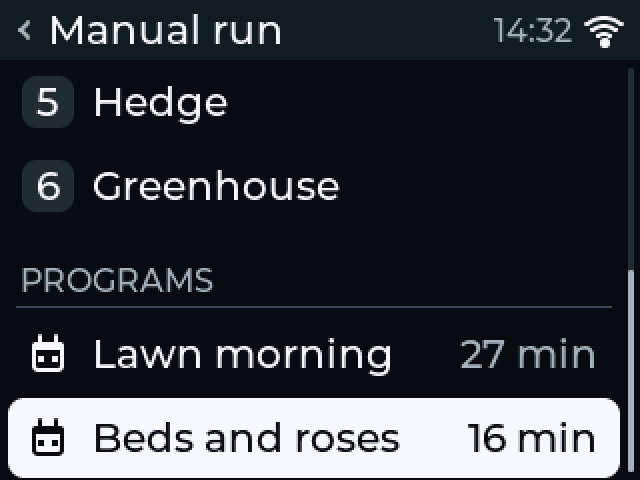
docs/design/display-ui/manual-programs.png
