syntroniks/zoneflow/docs/design/display-ui/setup-end.png

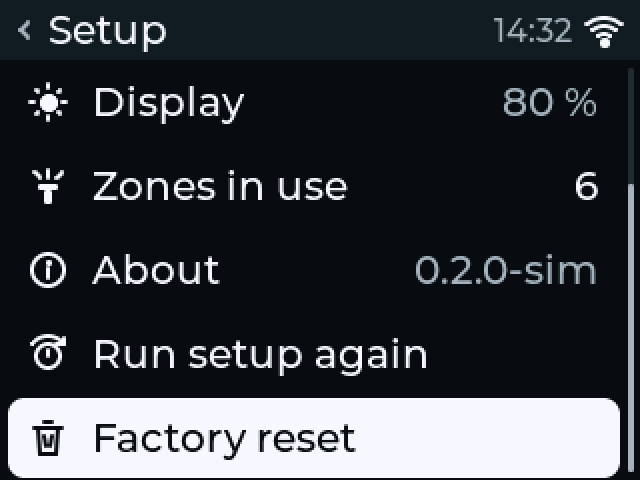
docs/design/display-ui/setup-end.png
