syntroniks/zoneflow/docs/firmware/img/webui/dark-desktop-setup.png

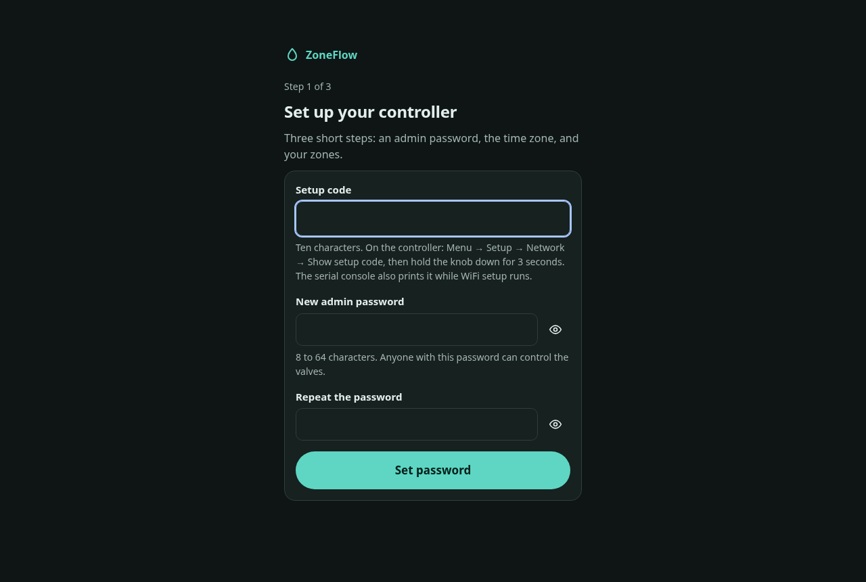
docs/firmware/img/webui/dark-desktop-setup.png
