syntroniks/zoneflow/docs/firmware/img/webui/dark-phone-setup.png

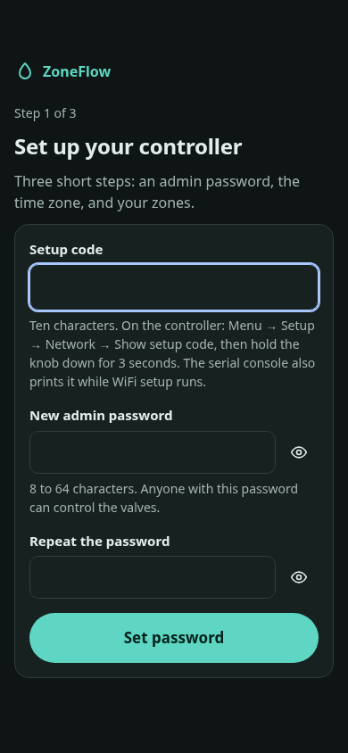
docs/firmware/img/webui/dark-phone-setup.png
