syntroniks/zoneflow/docs/firmware/img/webui/light-desktop-setup.png

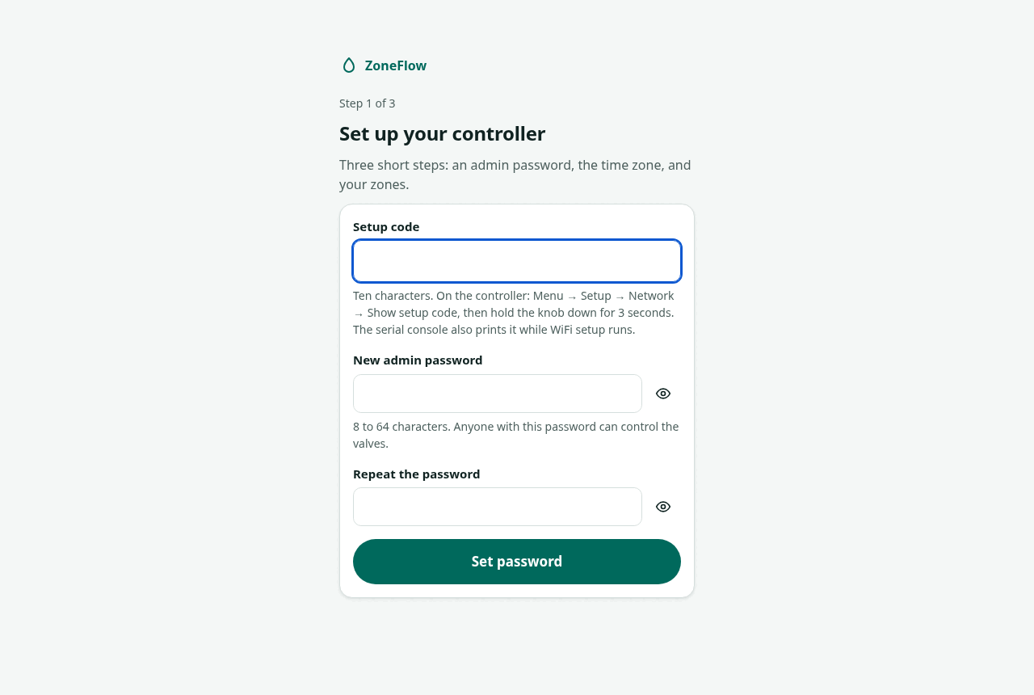
docs/firmware/img/webui/light-desktop-setup.png
