syntroniks/zoneflow/docs/firmware/img/webui/light-phone-setup.png

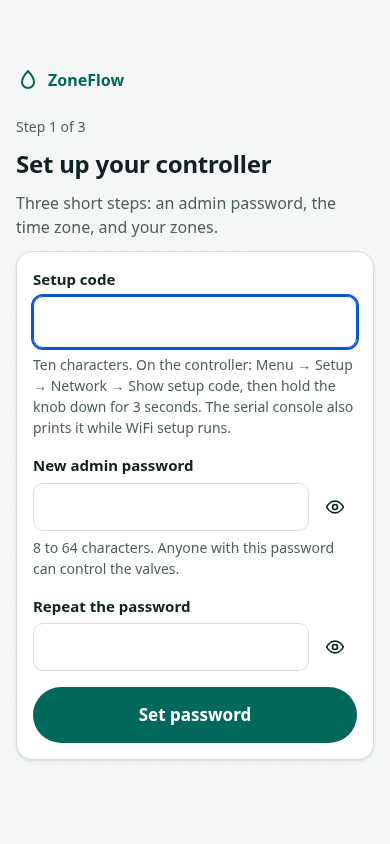
docs/firmware/img/webui/light-phone-setup.png
