syntroniks/zoneflow/enclosure/output/test-fit/stand-ins.md

# Test-fit board: the stand-ins and where their numbers come from

Generated by `enclosure/tools/gen_testfit.py`. Do not edit.

Board file: `hardware/zoneflow-a/zoneflow-a.kicad_pcb`, revision A, dated 2026-11-10.
Mechanical contract: `hardware/mechanical.yaml`, revision 3.

- **26 parts the contract models.** Each stands where the board file puts it. The
  board and the contract agree on every one within 0.05 mm, or this file would not exist.
  Their bodies are the contract's boxes and cylinders, which name their datasheets.
- **64 other parts at least 1.5 mm tall.** Each is a box: the outline the footprint
  draws on the fabrication layer, as high as `hardware/zoneflow-a/design/heights.toml` says.
- **223 parts lower than 1.5 mm are left out**, and so are the test pads and the
  unfitted debug header J8. No printed part comes within 1.5 mm of the board except at
  places the contract models: the fuse well, the board edges and the light pipes.
- **30 soldered lead ends** are in the interference check and are not printed. Each is a
  cylinder as wide as its hole and 2.5 mm long, on the side the lead comes out of. 2.5 mm is an
  assumption: no drawing gives the trimmed length.

Positions are in board coordinates, millimetres: origin at the bottom-left corner seen
from the component side. Heights are above the side the part is on.

| Ref | Part | Side | Position on the board | Stand-in, mm | Top, mm | Source |
|---|---|---|---|---|---|---|
| J7 | FPC connector 12-way 0.5 mm, bottom contact, flip lock, FPC-05F-12PH20 | top | 60.440, 88.430 (body centre) | 5.12 x 10.4 x 2 | 2 | Body: `hardware/mechanical.yaml`, part entry. Position: board file. |
| SW3 | EC11J1525402 encoder with push switch | top | 85.000, 88.000 (body centre) | 15 x 13.5 x 4.5; 8.5 x 18 x 1.2; dia 8.975 x 10; dia 5.975 x 10 | 24.5 | Body: `hardware/mechanical.yaml`, part entry. Position: board file. |
| SW4 | Back button, TS-1102S-C-M-B, 10 mm actuator | top | 22.000, 61.500 (body centre) | 8.6 x 6 x 3.3; dia 3.5 x 6.7 | 10 | Body: `hardware/mechanical.yaml`, part entry. Position: board file. |
| SW5 | Home / Manual button, TS-1102S-C-M-B, 10 mm actuator | top | 48.000, 61.500 (body centre) | 8.6 x 6 x 3.3; dia 3.5 x 6.7 | 10 | Body: `hardware/mechanical.yaml`, part entry. Position: board file. |
| D6 | Status LED | top | 12.000, 42.000 (body centre) | 1.6 x 0.8 x 0.8 | 0.8 | Body: `hardware/mechanical.yaml`, part entry. Position: board file. |
| D902 | Master valve LED | top | 26.000, 42.000 (body centre) | 1.6 x 0.8 x 0.8 | 0.8 | Body: `hardware/mechanical.yaml`, part entry. Position: board file. |
| D102 | Zone 1 LED | top | 35.500, 42.000 (body centre) | 1.6 x 0.8 x 0.8 | 0.8 | Body: `hardware/mechanical.yaml`, part entry. Position: board file. |
| D202 | Zone 2 LED | top | 45.000, 42.000 (body centre) | 1.6 x 0.8 x 0.8 | 0.8 | Body: `hardware/mechanical.yaml`, part entry. Position: board file. |
| D302 | Zone 3 LED | top | 54.500, 42.000 (body centre) | 1.6 x 0.8 x 0.8 | 0.8 | Body: `hardware/mechanical.yaml`, part entry. Position: board file. |
| D402 | Zone 4 LED | top | 64.000, 42.000 (body centre) | 1.6 x 0.8 x 0.8 | 0.8 | Body: `hardware/mechanical.yaml`, part entry. Position: board file. |
| D502 | Zone 5 LED | top | 73.500, 42.000 (body centre) | 1.6 x 0.8 x 0.8 | 0.8 | Body: `hardware/mechanical.yaml`, part entry. Position: board file. |
| D602 | Zone 6 LED | top | 83.000, 42.000 (body centre) | 1.6 x 0.8 x 0.8 | 0.8 | Body: `hardware/mechanical.yaml`, part entry. Position: board file. |
| D702 | Zone 7 LED | top | 92.500, 42.000 (body centre) | 1.6 x 0.8 x 0.8 | 0.8 | Body: `hardware/mechanical.yaml`, part entry. Position: board file. |
| D802 | Zone 8 LED | top | 102.000, 42.000 (body centre) | 1.6 x 0.8 x 0.8 | 0.8 | Body: `hardware/mechanical.yaml`, part entry. Position: board file. |
| J5 | USB-C receptacle TYPE-C-31-M-12 | top | 8.000, 2.675 (body centre) | 8.94 x 7.35 x 3.26 | 3.26 | Body: `hardware/mechanical.yaml`, part entry. Position: board file. |
| J1 | KF2EDGR-3.81-2P header, 24 VAC | top | 17.805, 5.900 (pin 1) | 8.42 x 9.2 x 7 | 7 | Body: `hardware/mechanical.yaml`, part entry. Position: board file. |
| J2 | KF2EDGR-3.81-7P header, COM COM MV 1 2 3 4 | top | 30.225, 5.900 (pin 1) | 27.47 x 9.2 x 7 | 7 | Body: `hardware/mechanical.yaml`, part entry. Position: board file. |
| J3 | KF2EDGR-3.81-4P header, zones 5 to 8 | top | 58.295, 5.900 (pin 1) | 16.04 x 9.2 x 7 | 7 | Body: `hardware/mechanical.yaml`, part entry. Position: board file. |
| J4 | KF2EDGR-3.81-7P header, 5V FLOW GND RAIN GND AUX GND | top | 78.335, 5.900 (pin 1) | 27.47 x 9.2 x 7 | 7 | Body: `hardware/mechanical.yaml`, part entry. Position: board file. |
| J6 | JST SH 4-way side entry, Qwiic | top | 109.250, 2.630 (body centre) | 6 x 4.25 x 2.95 | 2.95 | Body: `hardware/mechanical.yaml`, part entry. Position: board file. |
| F4 | Littelfuse 0154003.DRT fuse holder, AC_L leg | top | 15.000, 12.600 (body centre) | 10.62 x 5.03 x 3.81 | 3.81 | Body: `hardware/mechanical.yaml`, part entry. Position: board file. |
| F1 | Littelfuse 0154003.DRT fuse holder, AC_N leg | top | 27.000, 12.600 (body centre) | 10.62 x 5.03 x 3.81 | 3.81 | Body: `hardware/mechanical.yaml`, part entry. Position: board file. |
| U4 | ESP32-S3-WROOM-1-N16R8 | top | 103.000, 103.250 (body centre) | 18 x 25.5 x 3.25 | 3.25 | Body: `hardware/mechanical.yaml`, part entry. Position: board file. |
| BT1 | CR2032 holder BS-6 | top | 95.000, 65.300 (body centre) | 31.3 x 16 x 5.5 | 5.5 | Body: `hardware/mechanical.yaml`, part entry. Position: board file. |
| C1 | Rubycon 63ZLJ470M12.5X20, lying on its side | bottom | 36.000, 30.000 (pads) | 22 x 13 x 13; 5.5 x 6 x 7.5 | 13 | Body: `hardware/mechanical.yaml`, part entry. Position: board file. |
| K1 | Omron G5NB-1A-E relay | bottom | 4.800, 27.850 (body centre) | 7.2 x 20.5 x 15.3 | 15.3 | Body: `hardware/mechanical.yaml`, part entry. Position: board file. |
| BT1 | CR2032 cell in the holder | top | 95.000, 65.300 (body centre) | dia 20 x 5.5 | 5.5 | Diameter: the 20 mm circle on the footprint's fabrication layer (a CR2032 is 20 mm by its IEC size code). Drawn to the holder's height. |
| C2 | C_1210_3225Metric | top | 27.550, 29.400 (anchor) | 2.50 x 3.20 x 2.7 | 2.7 | Outline: fabrication layer of the footprint. Height: `heights.toml`, src "package". |
| C3 | C_1210_3225Metric | top | 27.550, 34.200 (anchor) | 2.50 x 3.20 x 2.7 | 2.7 | Outline: fabrication layer of the footprint. Height: `heights.toml`, src "package". |
| C5 | C_1206_3216Metric | top | 17.200, 26.550 (anchor) | 3.20 x 1.60 x 1.8 | 1.8 | Outline: fabrication layer of the footprint. Height: `heights.toml`, src "package". |
| C6 | C_1206_3216Metric | top | 12.400, 26.550 (anchor) | 3.20 x 1.60 x 1.8 | 1.8 | Outline: fabrication layer of the footprint. Height: `heights.toml`, src "package". |
| C14 | C_1206_3216Metric | top | 89.100, 107.000 (anchor) | 3.20 x 1.60 x 1.8 | 1.8 | Outline: fabrication layer of the footprint. Height: `heights.toml`, src "package". |
| D1 | D_SMC | top | 16.300, 21.800 (anchor) | 7.10 x 6.20 x 2.65 | 2.65 | Outline: fabrication layer of the footprint. Height: `heights.toml`, src "package". |
| D2 | D_SMA | top | 25.200, 20.300 (anchor) | 4.60 x 3.00 x 2.45 | 2.45 | Outline: fabrication layer of the footprint. Height: `heights.toml`, src "package". |
| D3 | D_SMA | top | 5.000, 50.600 (anchor) | 4.60 x 3.00 x 2.45 | 2.45 | Outline: fabrication layer of the footprint. Height: `heights.toml`, src "package". |
| D4 | D_SMA | top | 5.000, 46.900 (anchor) | 4.60 x 3.00 x 2.45 | 2.45 | Outline: fabrication layer of the footprint. Height: `heights.toml`, src "package". |
| D12 | D_SMB | top | 109.710, 26.200 (anchor) | 4.60 x 4.00 x 2.45 | 2.45 | Outline: fabrication layer of the footprint. Height: `heights.toml`, src "package". |
| D13 | D_SMB | top | 109.710, 30.850 (anchor) | 4.60 x 4.00 x 2.45 | 2.45 | Outline: fabrication layer of the footprint. Height: `heights.toml`, src "package". |
| D14 | D_SMB | top | 109.710, 21.550 (anchor) | 4.60 x 4.00 x 2.45 | 2.45 | Outline: fabrication layer of the footprint. Height: `heights.toml`, src "package". |
| D18 | D_SMB | top | 109.710, 35.500 (anchor) | 4.60 x 4.00 x 2.45 | 2.45 | Outline: fabrication layer of the footprint. Height: `heights.toml`, src "package". |
| D19 | D_SMA | top | 69.800, 65.500 (anchor) | 4.60 x 3.00 x 2.45 | 2.45 | Outline: fabrication layer of the footprint. Height: `heights.toml`, src "package". |
| D20 | D_SMA | top | 68.700, 61.600 (anchor) | 4.60 x 3.00 x 2.45 | 2.45 | Outline: fabrication layer of the footprint. Height: `heights.toml`, src "package". |
| D23 | D_SMB | top | 36.700, 12.600 (anchor) | 4.00 x 4.60 x 2.45 | 2.45 | Outline: fabrication layer of the footprint. Height: `heights.toml`, src "package". |
| D24 | D_SMA | top | 62.600, 65.500 (anchor) | 4.60 x 3.00 x 2.45 | 2.45 | Outline: fabrication layer of the footprint. Height: `heights.toml`, src "package". |
| D25 | D_SMB | top | 12.900, 36.750 (anchor) | 4.60 x 4.00 x 2.45 | 2.45 | Outline: fabrication layer of the footprint. Height: `heights.toml`, src "package". |
| D101 | D_SMB | top | 48.700, 12.530 (anchor) | 4.00 x 4.60 x 2.45 | 2.45 | Outline: fabrication layer of the footprint. Height: `heights.toml`, src "package". |
| D201 | D_SMB | top | 55.800, 12.530 (anchor) | 4.00 x 4.60 x 2.45 | 2.45 | Outline: fabrication layer of the footprint. Height: `heights.toml`, src "package". |
| D301 | D_SMB | top | 62.900, 12.530 (anchor) | 4.00 x 4.60 x 2.45 | 2.45 | Outline: fabrication layer of the footprint. Height: `heights.toml`, src "package". |
| D401 | D_SMB | top | 70.000, 12.530 (anchor) | 4.00 x 4.60 x 2.45 | 2.45 | Outline: fabrication layer of the footprint. Height: `heights.toml`, src "package". |
| D501 | D_SMB | top | 77.100, 12.530 (anchor) | 4.00 x 4.60 x 2.45 | 2.45 | Outline: fabrication layer of the footprint. Height: `heights.toml`, src "package". |
| D601 | D_SMB | top | 84.200, 12.530 (anchor) | 4.00 x 4.60 x 2.45 | 2.45 | Outline: fabrication layer of the footprint. Height: `heights.toml`, src "package". |
| D701 | D_SMB | top | 91.300, 12.530 (anchor) | 4.00 x 4.60 x 2.45 | 2.45 | Outline: fabrication layer of the footprint. Height: `heights.toml`, src "package". |
| D801 | D_SMB | top | 98.400, 12.530 (anchor) | 4.00 x 4.60 x 2.45 | 2.45 | Outline: fabrication layer of the footprint. Height: `heights.toml`, src "package". |
| D901 | D_SMB | top | 41.600, 12.530 (anchor) | 4.00 x 4.60 x 2.45 | 2.45 | Outline: fabrication layer of the footprint. Height: `heights.toml`, src "package". |
| F5 | Fuse_Littelfuse-NANO2-451_453 | top | 31.100, 34.255 (anchor) | 2.69 x 6.10 x 2.69 | 2.69 | Outline: fabrication layer of the footprint. Height: `heights.toml`, src "sheet". |
| F101 | Fuse_2920_7451Metric | top | 49.950, 20.930 (anchor) | 5.12 x 7.35 x 2.1 | 2.1 | Outline: fabrication layer of the footprint. Height: `heights.toml`, src "sheet". |
| F201 | Fuse_2920_7451Metric | top | 57.050, 20.930 (anchor) | 5.12 x 7.35 x 2.1 | 2.1 | Outline: fabrication layer of the footprint. Height: `heights.toml`, src "sheet". |
| F301 | Fuse_2920_7451Metric | top | 64.150, 20.930 (anchor) | 5.12 x 7.35 x 2.1 | 2.1 | Outline: fabrication layer of the footprint. Height: `heights.toml`, src "sheet". |
| F401 | Fuse_2920_7451Metric | top | 71.250, 20.930 (anchor) | 5.12 x 7.35 x 2.1 | 2.1 | Outline: fabrication layer of the footprint. Height: `heights.toml`, src "sheet". |
| F501 | Fuse_2920_7451Metric | top | 78.350, 20.930 (anchor) | 5.12 x 7.35 x 2.1 | 2.1 | Outline: fabrication layer of the footprint. Height: `heights.toml`, src "sheet". |
| F601 | Fuse_2920_7451Metric | top | 85.450, 20.930 (anchor) | 5.12 x 7.35 x 2.1 | 2.1 | Outline: fabrication layer of the footprint. Height: `heights.toml`, src "sheet". |
| F701 | Fuse_2920_7451Metric | top | 92.550, 20.930 (anchor) | 5.12 x 7.35 x 2.1 | 2.1 | Outline: fabrication layer of the footprint. Height: `heights.toml`, src "sheet". |
| F801 | Fuse_2920_7451Metric | top | 99.650, 20.930 (anchor) | 5.12 x 7.35 x 2.1 | 2.1 | Outline: fabrication layer of the footprint. Height: `heights.toml`, src "sheet". |
| F901 | Fuse_2920_7451Metric | top | 42.850, 20.930 (anchor) | 5.12 x 7.35 x 2.1 | 2.1 | Outline: fabrication layer of the footprint. Height: `heights.toml`, src "sheet". |
| L1 | L_Bourns_SRN6045TA | top | 12.400, 31.200 (anchor) | 6.00 x 6.00 x 4.5 | 4.5 | Outline: fabrication layer of the footprint. Height: `heights.toml`, src "sheet". |
| Q101 | TO-252-2 | top | 49.950, 30.440 (anchor) | 6.50 x 9.92 x 2.4 | 2.4 | Outline: fabrication layer of the footprint. Height: `heights.toml`, src "contract". |
| Q201 | TO-252-2 | top | 57.050, 30.440 (anchor) | 6.50 x 9.92 x 2.4 | 2.4 | Outline: fabrication layer of the footprint. Height: `heights.toml`, src "contract". |
| Q301 | TO-252-2 | top | 64.150, 30.440 (anchor) | 6.50 x 9.92 x 2.4 | 2.4 | Outline: fabrication layer of the footprint. Height: `heights.toml`, src "contract". |
| Q401 | TO-252-2 | top | 71.250, 30.440 (anchor) | 6.50 x 9.92 x 2.4 | 2.4 | Outline: fabrication layer of the footprint. Height: `heights.toml`, src "contract". |
| Q501 | TO-252-2 | top | 78.350, 30.440 (anchor) | 6.50 x 9.92 x 2.4 | 2.4 | Outline: fabrication layer of the footprint. Height: `heights.toml`, src "contract". |
| Q601 | TO-252-2 | top | 85.450, 30.440 (anchor) | 6.50 x 9.92 x 2.4 | 2.4 | Outline: fabrication layer of the footprint. Height: `heights.toml`, src "contract". |
| Q701 | TO-252-2 | top | 92.550, 30.440 (anchor) | 6.50 x 9.92 x 2.4 | 2.4 | Outline: fabrication layer of the footprint. Height: `heights.toml`, src "contract". |
| Q801 | TO-252-2 | top | 99.650, 30.440 (anchor) | 6.50 x 9.92 x 2.4 | 2.4 | Outline: fabrication layer of the footprint. Height: `heights.toml`, src "contract". |
| Q901 | TO-252-2 | top | 42.850, 30.440 (anchor) | 6.50 x 9.92 x 2.4 | 2.4 | Outline: fabrication layer of the footprint. Height: `heights.toml`, src "contract". |
| SW1 | SW_Push_1P1T_XKB_TS-1187A | top | 48.000, 105.500 (anchor) | 6.50 x 5.10 x 1.5 | 1.5 | Outline: fabrication layer of the footprint. Height: `heights.toml`, src "sheet". |
| SW2 | SW_Push_1P1T_XKB_TS-1187A | top | 48.000, 99.400 (anchor) | 6.50 x 5.10 x 1.5 | 1.5 | Outline: fabrication layer of the footprint. Height: `heights.toml`, src "sheet". |
| U1 | TI_SO-PowerPAD-8 | top | 21.500, 33.000 (anchor) | 3.95 x 4.95 x 1.7 | 1.7 | Outline: fabrication layer of the footprint. Height: `heights.toml`, src "sheet". |
| U3 | SOT-223-3_TabPin2 | top | 14.500, 50.100 (anchor) | 3.70 x 6.70 x 1.8 | 1.8 | Outline: fabrication layer of the footprint. Height: `heights.toml`, src "package". |
| U6 | SOIC-14_3.9x8.7mm_P1.27mm | top | 108.000, 78.900 (anchor) | 8.65 x 3.90 x 1.75 | 1.75 | Outline: fabrication layer of the footprint. Height: `heights.toml`, src "package". |
| U7 | SOIC-14_3.9x8.7mm_P1.27mm | top | 20.000, 74.000 (anchor) | 3.90 x 8.65 x 1.75 | 1.75 | Outline: fabrication layer of the footprint. Height: `heights.toml`, src "package". |
| U8 | SOIC-8_3.9x4.9mm_P1.27mm | top | 35.000, 62.600 (anchor) | 4.90 x 3.90 x 1.75 | 1.75 | Outline: fabrication layer of the footprint. Height: `heights.toml`, src "package". |
| U10 | SOIC-8_3.9x4.9mm_P1.27mm | top | 66.000, 72.000 (anchor) | 3.90 x 4.90 x 1.75 | 1.75 | Outline: fabrication layer of the footprint. Height: `heights.toml`, src "package". |
| U101 | SMDIP-6_onsemi_646BY | top | 35.500, 50.800 (anchor) | 7.62 x 6.35 x 4.8 | 4.8 | Outline: fabrication layer of the footprint. Height: `heights.toml`, src "sheet". |
| U201 | SMDIP-6_onsemi_646BY | top | 45.000, 50.800 (anchor) | 7.62 x 6.35 x 4.8 | 4.8 | Outline: fabrication layer of the footprint. Height: `heights.toml`, src "sheet". |
| U301 | SMDIP-6_onsemi_646BY | top | 54.500, 50.800 (anchor) | 7.62 x 6.35 x 4.8 | 4.8 | Outline: fabrication layer of the footprint. Height: `heights.toml`, src "sheet". |
| U401 | SMDIP-6_onsemi_646BY | top | 64.000, 50.800 (anchor) | 7.62 x 6.35 x 4.8 | 4.8 | Outline: fabrication layer of the footprint. Height: `heights.toml`, src "sheet". |
| U501 | SMDIP-6_onsemi_646BY | top | 73.500, 50.800 (anchor) | 7.62 x 6.35 x 4.8 | 4.8 | Outline: fabrication layer of the footprint. Height: `heights.toml`, src "sheet". |
| U601 | SMDIP-6_onsemi_646BY | top | 83.000, 50.800 (anchor) | 7.62 x 6.35 x 4.8 | 4.8 | Outline: fabrication layer of the footprint. Height: `heights.toml`, src "sheet". |
| U701 | SMDIP-6_onsemi_646BY | top | 92.500, 50.800 (anchor) | 7.62 x 6.35 x 4.8 | 4.8 | Outline: fabrication layer of the footprint. Height: `heights.toml`, src "sheet". |
| U801 | SMDIP-6_onsemi_646BY | top | 102.000, 50.800 (anchor) | 7.62 x 6.35 x 4.8 | 4.8 | Outline: fabrication layer of the footprint. Height: `heights.toml`, src "sheet". |
| U901 | SMDIP-6_onsemi_646BY | top | 26.000, 50.800 (anchor) | 7.62 x 6.35 x 4.8 | 4.8 | Outline: fabrication layer of the footprint. Height: `heights.toml`, src "sheet". |
