syntroniks/zoneflow/hardware/sim/study-failsafe-reduction/results/release.md

# Release after the keep-alive stops

Study, not the product. Written by `study.py`; do not edit.

The keep-alive toggles at 5 ms per phase from 50 ms, the firmware writes one valve bit and `RLY_ON` at 350 ms,
and the keep-alive stops at 1.0 s: driven low, driven high, or the pin goes high-impedance (a reset of the
digital core, `EN` low, or download mode). Times are counted from the last edge the pin made.
The triac conducts to the end of its half-cycle after the LED goes dark: add up to 10 ms at 50 Hz.
K1 parts its contacts within 10 ms (Omron) of the coil current falling; the column is the coil current only.

| stop | corner | Q1 and inverter VGS(th), V | Q3 VGS(th), V | K1 inductance, H | tW by formula, ms | V_DRV on after the first edge, ms | DRV_EN low after the last edge, ms | expander bits gone, ms | LED current under 0.5 mA, ms | K1 coil under 3.6 mA, ms | LED current while running, mA | coil current while running, mA |
|---|---|---|---|---|---|---|---|---|---|---|---|---|
| stop-low | short, 3.2 V | 1.05 | 0.9 | 0.2 | 147 | 0.05 | 139 | 139 | 139 | 142 | 11.3 | 42.2 |
| stop-low | short, 3.2 V | 0.65 | 1.3 | 0.4 | 147 | 0.05 | 139 | 139 | 139 | 145 | 11.3 | 42.2 |
| stop-low | short, 3.2 V | 1.45 | 0.5 | 0.1 | 147 | 0.05 | 139 | 139 | 139 | 141 | 11.3 | 42.2 |
| stop-low | short, 3.3 V | 1.05 | 0.9 | 0.2 | 147 | 0.05 | 139 | 139 | 139 | 142 | 11.8 | 42.2 |
| stop-low | short, 3.3 V | 0.65 | 1.3 | 0.4 | 147 | 0.05 | 139 | 139 | 139 | 145 | 11.8 | 42.2 |
| stop-low | short, 3.3 V | 1.45 | 0.5 | 0.1 | 147 | 0.05 | 139 | 139 | 139 | 141 | 11.8 | 42.2 |
| stop-low | short, 3.6 V | 1.05 | 0.9 | 0.2 | 147 | 0.05 | 139 | 139 | 139 | 142 | 13.4 | 42.2 |
| stop-low | short, 3.6 V | 0.65 | 1.3 | 0.4 | 147 | 0.05 | 139 | 139 | 139 | 145 | 13.4 | 42.2 |
| stop-low | short, 3.6 V | 1.45 | 0.5 | 0.1 | 147 | 0.05 | 139 | 139 | 139 | 141 | 13.4 | 42.2 |
| stop-low | nominal, 3.2 V | 1.05 | 0.9 | 0.2 | 235 | 0.05 | 227 | 227 | 227 | 230 | 11.3 | 42.2 |
| stop-low | nominal, 3.2 V | 0.65 | 1.3 | 0.4 | 235 | 0.05 | 227 | 227 | 227 | 233 | 11.3 | 42.2 |
| stop-low | nominal, 3.2 V | 1.45 | 0.5 | 0.1 | 235 | 0.05 | 227 | 227 | 227 | 229 | 11.3 | 42.2 |
| stop-low | nominal, 3.3 V | 1.05 | 0.9 | 0.2 | 235 | 0.05 | 227 | 227 | 227 | 230 | 11.8 | 42.2 |
| stop-low | nominal, 3.3 V | 0.65 | 1.3 | 0.4 | 235 | 0.05 | 227 | 227 | 227 | 233 | 11.8 | 42.2 |
| stop-low | nominal, 3.3 V | 1.45 | 0.5 | 0.1 | 235 | 0.05 | 227 | 227 | 227 | 229 | 11.8 | 42.2 |
| stop-low | nominal, 3.6 V | 1.05 | 0.9 | 0.2 | 235 | 0.05 | 227 | 227 | 227 | 230 | 13.4 | 42.2 |
| stop-low | nominal, 3.6 V | 0.65 | 1.3 | 0.4 | 235 | 0.05 | 227 | 227 | 227 | 233 | 13.4 | 42.2 |
| stop-low | nominal, 3.6 V | 1.45 | 0.5 | 0.1 | 235 | 0.05 | 227 | 227 | 227 | 229 | 13.4 | 42.2 |
| stop-low | long, 3.2 V | 1.05 | 0.9 | 0.2 | 289 | 0.05 | 281 | 281 | 281 | 284 | 11.3 | 42.2 |
| stop-low | long, 3.2 V | 0.65 | 1.3 | 0.4 | 289 | 0.05 | 281 | 281 | 281 | 287 | 11.3 | 42.2 |
| stop-low | long, 3.2 V | 1.45 | 0.5 | 0.1 | 289 | 0.05 | 281 | 281 | 281 | 283 | 11.3 | 42.2 |
| stop-low | long, 3.3 V | 1.05 | 0.9 | 0.2 | 289 | 0.05 | 281 | 281 | 281 | 284 | 11.8 | 42.2 |
| stop-low | long, 3.3 V | 0.65 | 1.3 | 0.4 | 289 | 0.05 | 281 | 281 | 281 | 287 | 11.8 | 42.2 |
| stop-low | long, 3.3 V | 1.45 | 0.5 | 0.1 | 289 | 0.05 | 281 | 281 | 281 | 283 | 11.8 | 42.2 |
| stop-low | long, 3.6 V | 1.05 | 0.9 | 0.2 | 289 | 0.05 | 281 | 281 | 281 | 284 | 13.4 | 42.2 |
| stop-low | long, 3.6 V | 0.65 | 1.3 | 0.4 | 289 | 0.05 | 281 | 281 | 281 | 287 | 13.4 | 42.2 |
| stop-low | long, 3.6 V | 1.45 | 0.5 | 0.1 | 289 | 0.05 | 281 | 281 | 281 | 283 | 13.4 | 42.2 |
| stop-high | short, 3.2 V | 1.05 | 0.9 | 0.2 | 147 | 0.00 | 149 | 149 | 149 | 152 | 11.3 | 42.2 |
| stop-high | short, 3.2 V | 0.65 | 1.3 | 0.4 | 147 | 0.00 | 149 | 149 | 149 | 155 | 11.3 | 42.2 |
| stop-high | short, 3.2 V | 1.45 | 0.5 | 0.1 | 147 | 0.00 | 149 | 149 | 149 | 151 | 11.3 | 42.2 |
| stop-high | short, 3.3 V | 1.05 | 0.9 | 0.2 | 147 | 0.00 | 149 | 149 | 149 | 152 | 11.8 | 42.2 |
| stop-high | short, 3.3 V | 0.65 | 1.3 | 0.4 | 147 | 0.00 | 149 | 149 | 149 | 155 | 11.8 | 42.2 |
| stop-high | short, 3.3 V | 1.45 | 0.5 | 0.1 | 147 | 0.00 | 149 | 149 | 149 | 151 | 11.8 | 42.2 |
| stop-high | short, 3.6 V | 1.05 | 0.9 | 0.2 | 147 | 0.00 | 149 | 149 | 149 | 152 | 13.4 | 42.2 |
| stop-high | short, 3.6 V | 0.65 | 1.3 | 0.4 | 147 | 0.00 | 149 | 149 | 149 | 155 | 13.4 | 42.2 |
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
| stop-hiz | long, 3.3 V | 1.45 | 0.5 | 0.1 | 289 | 0.05 | 281 | 281 | 281 | 283 | 11.8 | 42.2 |
| stop-hiz | long, 3.6 V | 1.05 | 0.9 | 0.2 | 289 | 0.05 | 281 | 281 | 281 | 284 | 13.4 | 42.2 |
| stop-hiz | long, 3.6 V | 0.65 | 1.3 | 0.4 | 289 | 0.05 | 281 | 281 | 281 | 287 | 13.4 | 42.2 |
| stop-hiz | long, 3.6 V | 1.45 | 0.5 | 0.1 | 289 | 0.05 | 281 | 281 | 281 | 283 | 13.4 | 42.2 |
