syntroniks/zoneflow/firmware/zoneflow-fw/test/host/data/bounce/click-chatter-14ms.csv

# A worn switch: 14 ms of chatter at each end of a 200 ms press. The decoder's
# margin ends at 17 ms.
# Made up by make_waveforms.py to the limits above. Not a recording.
time_us | pin
0 | 1
100000 | 0
100698 | 1
101206 | 0
101969 | 1
102165 | 0
102726 | 1
102892 | 0
103640 | 1
103762 | 0
103861 | 1
104437 | 0
105147 | 1
105315 | 0
105359 | 1
105633 | 0
105999 | 1
106794 | 0
107130 | 1
107612 | 0
107993 | 1
108159 | 0
108609 | 1
108662 | 0
109189 | 1
109438 | 0
109696 | 1
110567 | 0
111126 | 1
111802 | 0
112688 | 1
112752 | 0
112902 | 1
113491 | 0
113597 | 1
114000 | 0
314000 | 1
314370 | 0
314820 | 1
315291 | 0
315897 | 1
316229 | 0
316600 | 1
317165 | 0
317850 | 1
318452 | 0
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
