syntroniks/zoneflow/docs/firmware/img/webui/dark-desktop-history.png

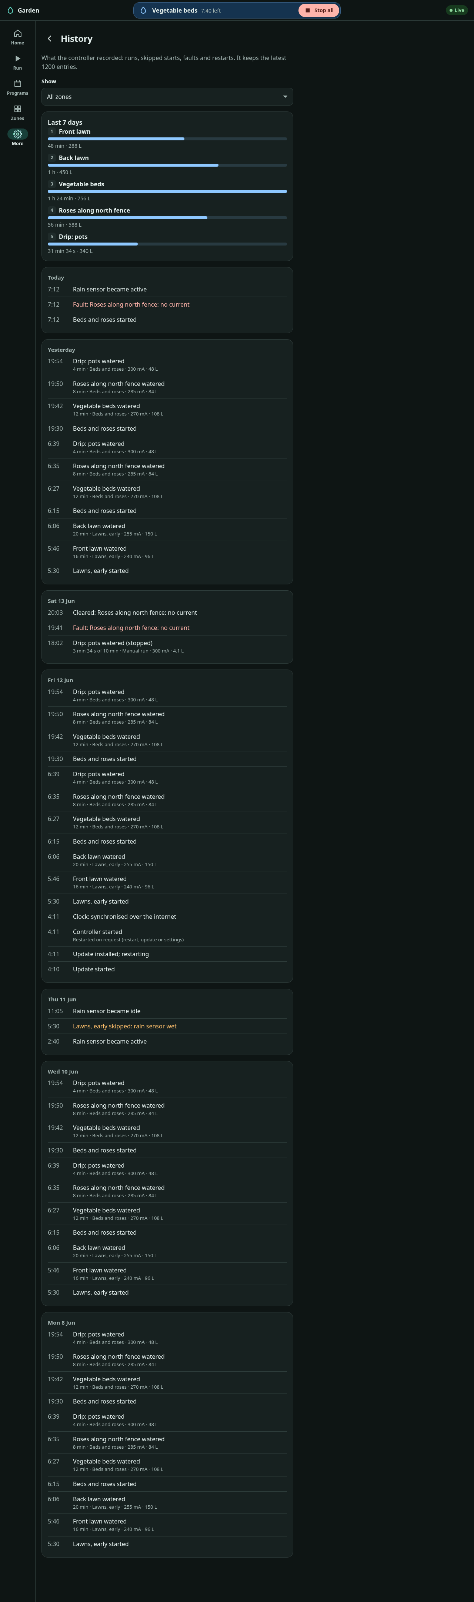
docs/firmware/img/webui/dark-desktop-history.png
