syntroniks/zoneflow/docs/firmware/img/webui/dark-phone-history.png

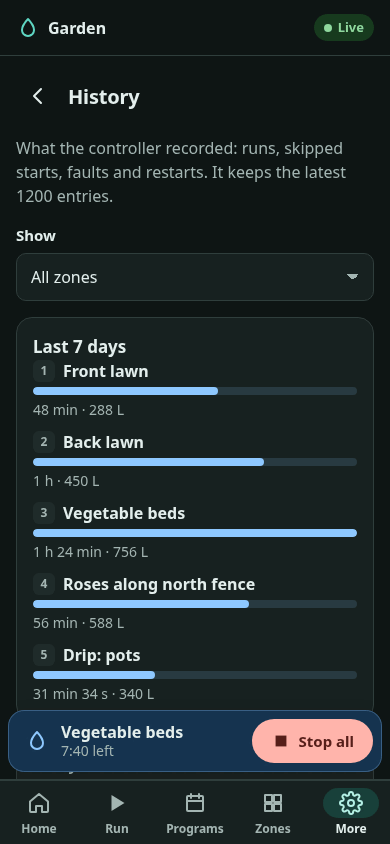
docs/firmware/img/webui/dark-phone-history.png
