syntroniks/zoneflow/docs/firmware/img/webui/light-desktop-history.png

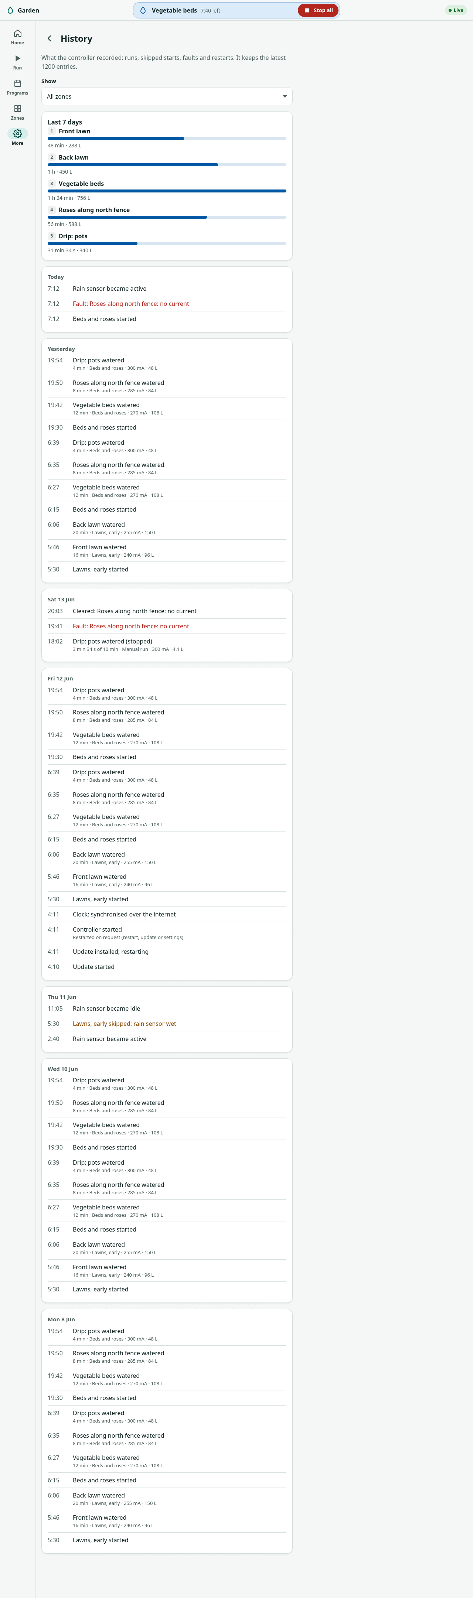
docs/firmware/img/webui/light-desktop-history.png
