syntroniks/zoneflow/docs/firmware/img/webui/light-phone-history.png

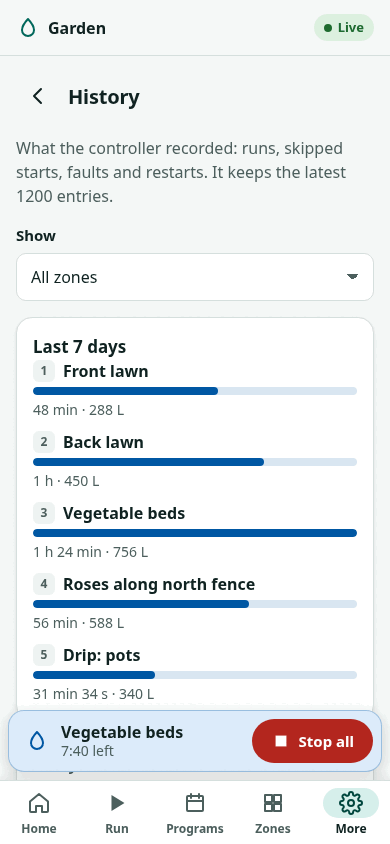
docs/firmware/img/webui/light-phone-history.png
