syntroniks/zoneflow/hardware/zoneflow-a/output/zoneflow-a-board.pdf

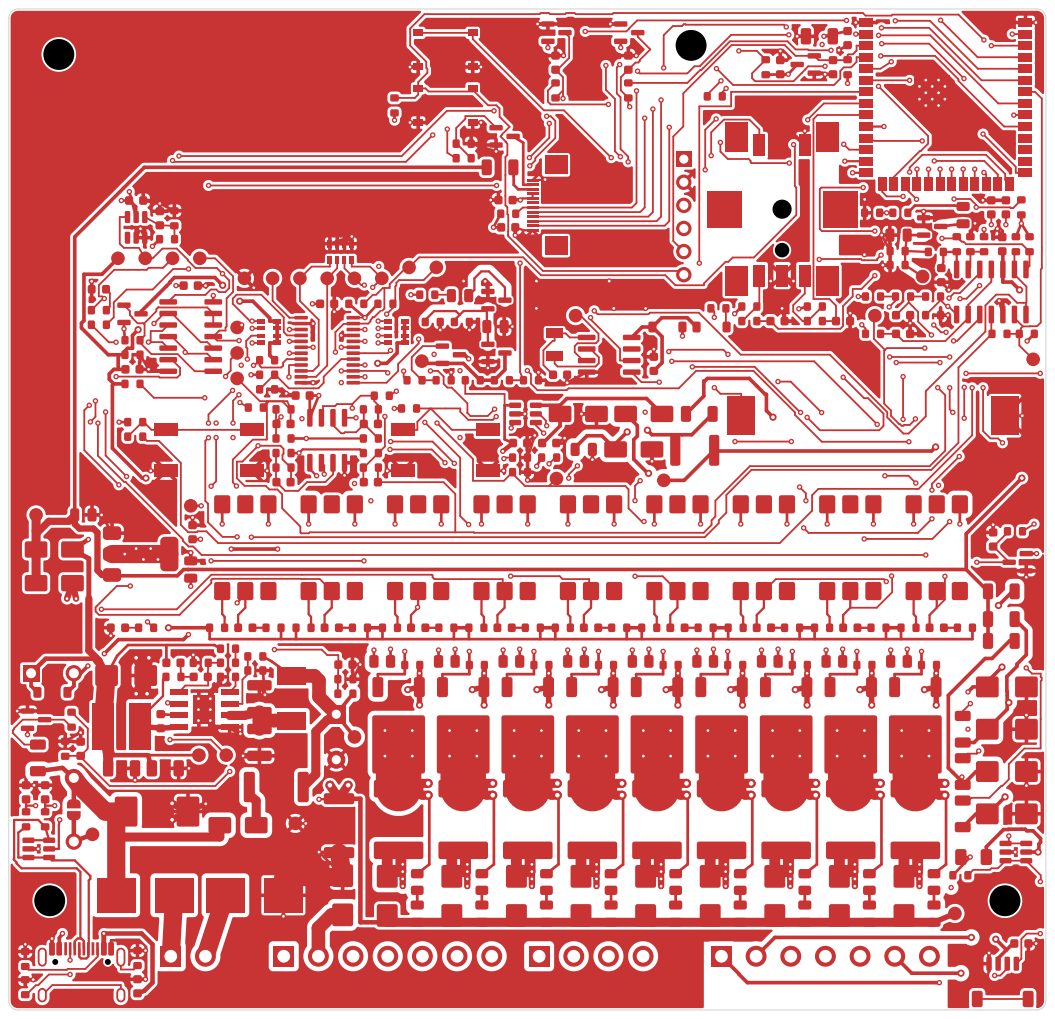
[picture p248: page 1]

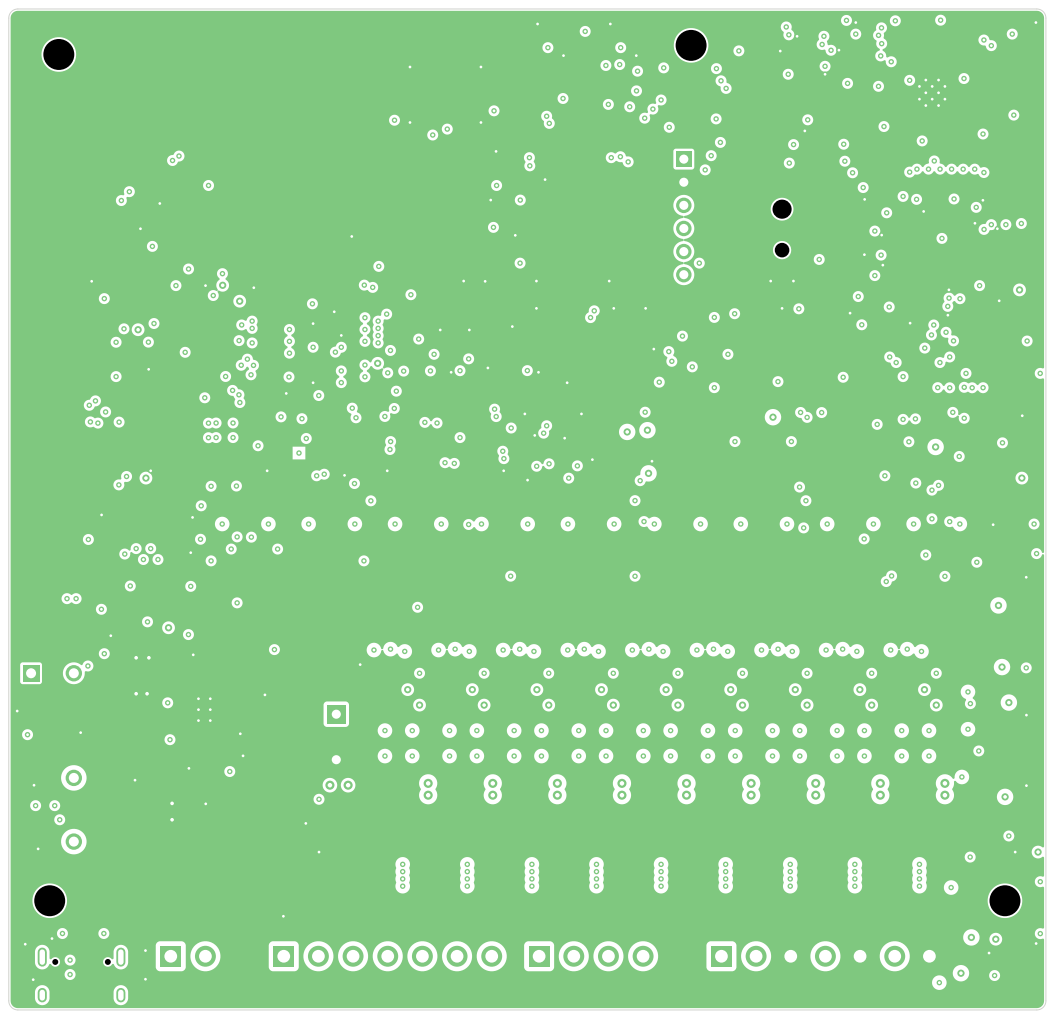
[picture p249: page 2]

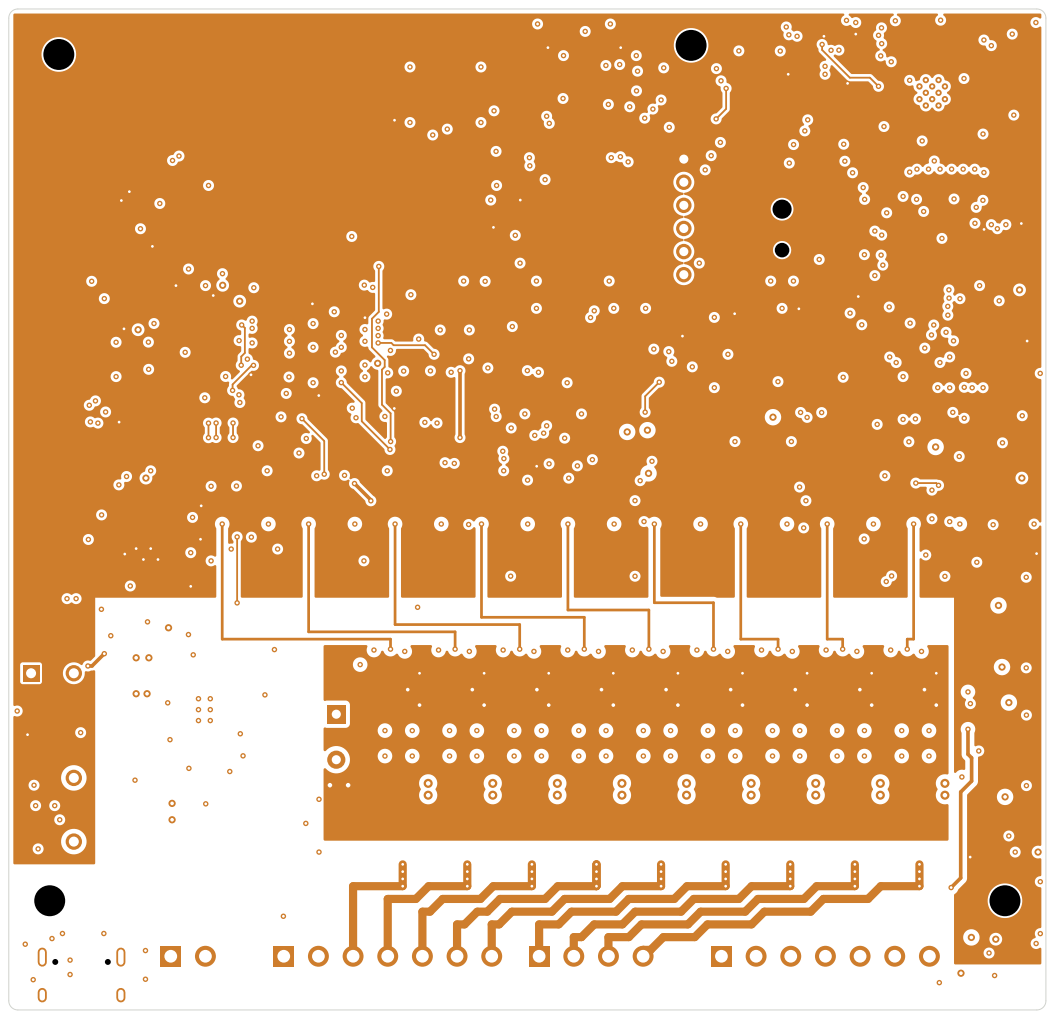
[picture p250: page 3]

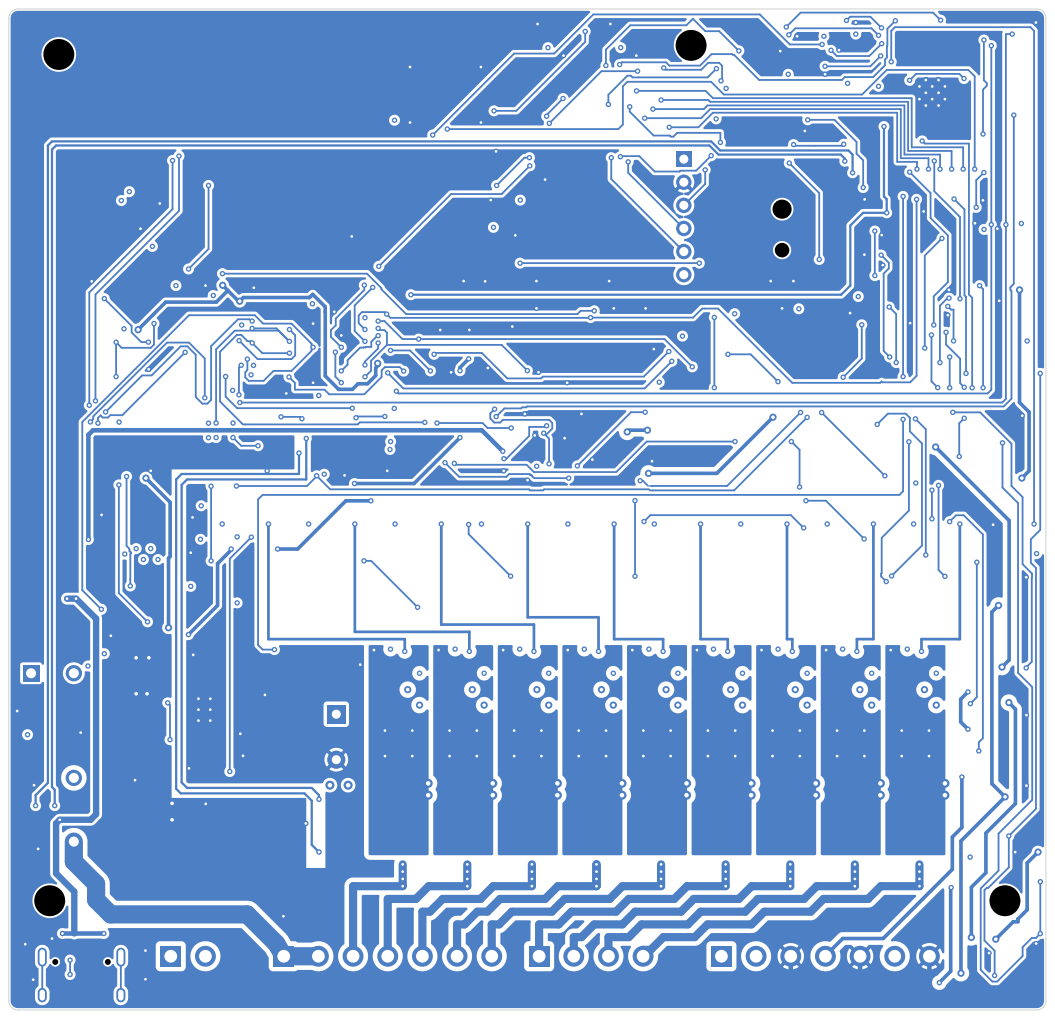
[picture p251: page 4]

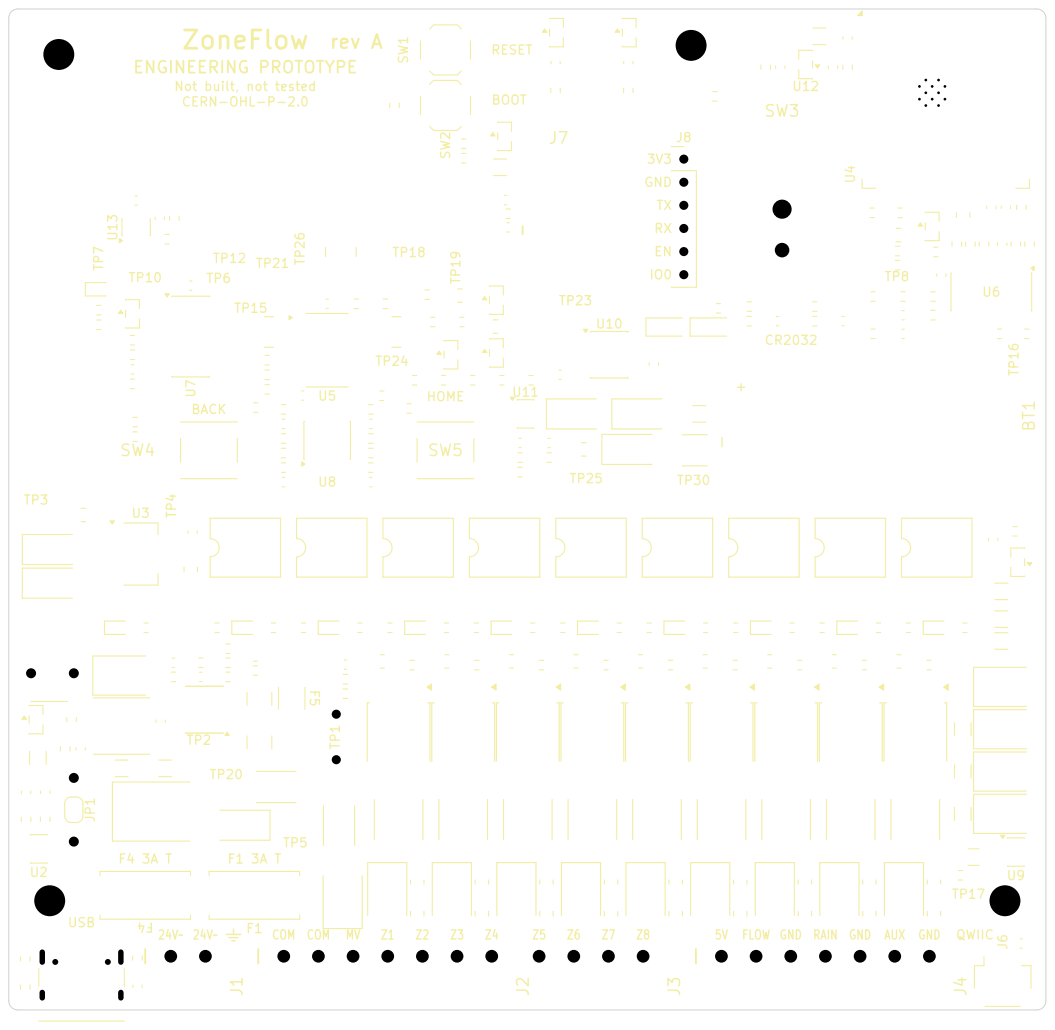
[picture p252: page 5]

IO0 ENGINEERING PROTOTYPE ZoneFlow rev A

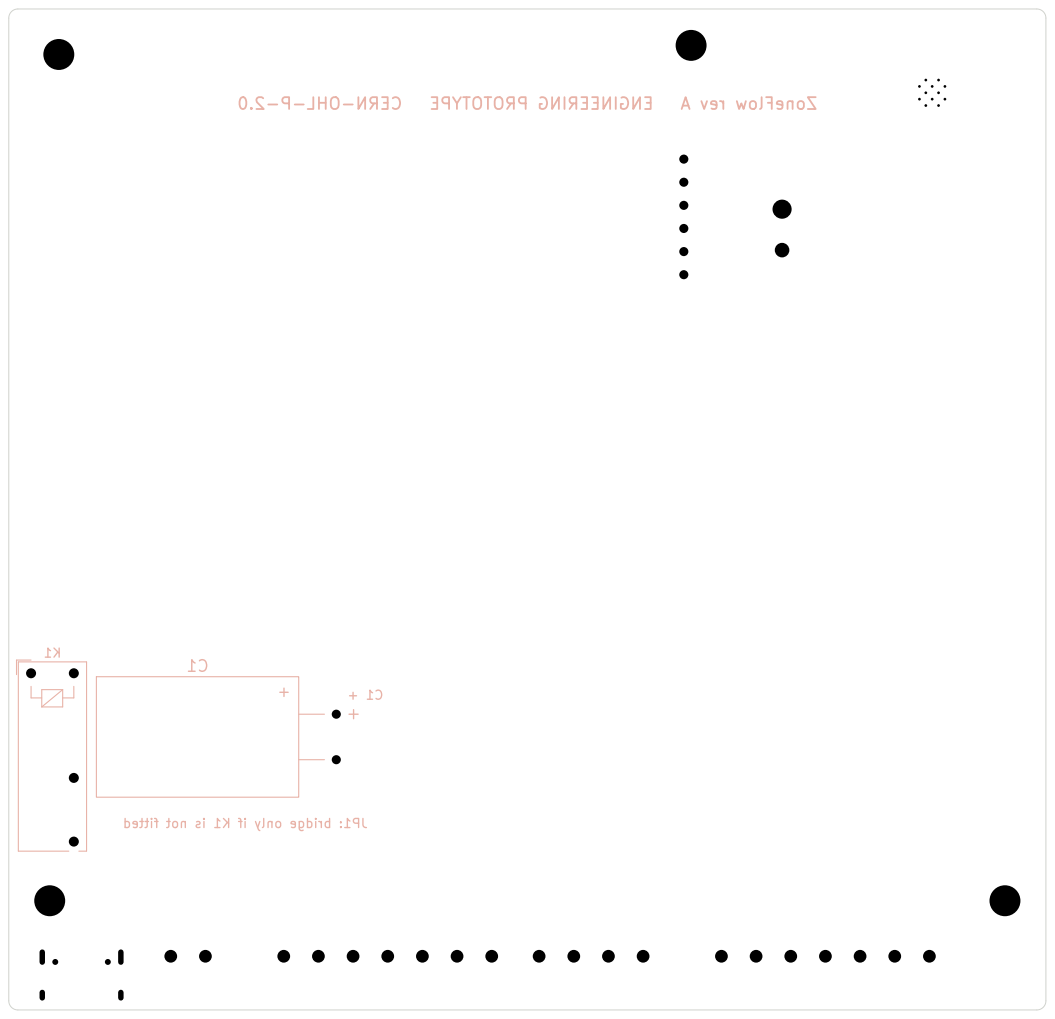
[picture p253: page 6]

fitted not is K1 if only bridge JP1: + C1 CERN-OHL-P-2.0 PROTOTYPE ENGINEERING A rev ZoneFlow C1 +

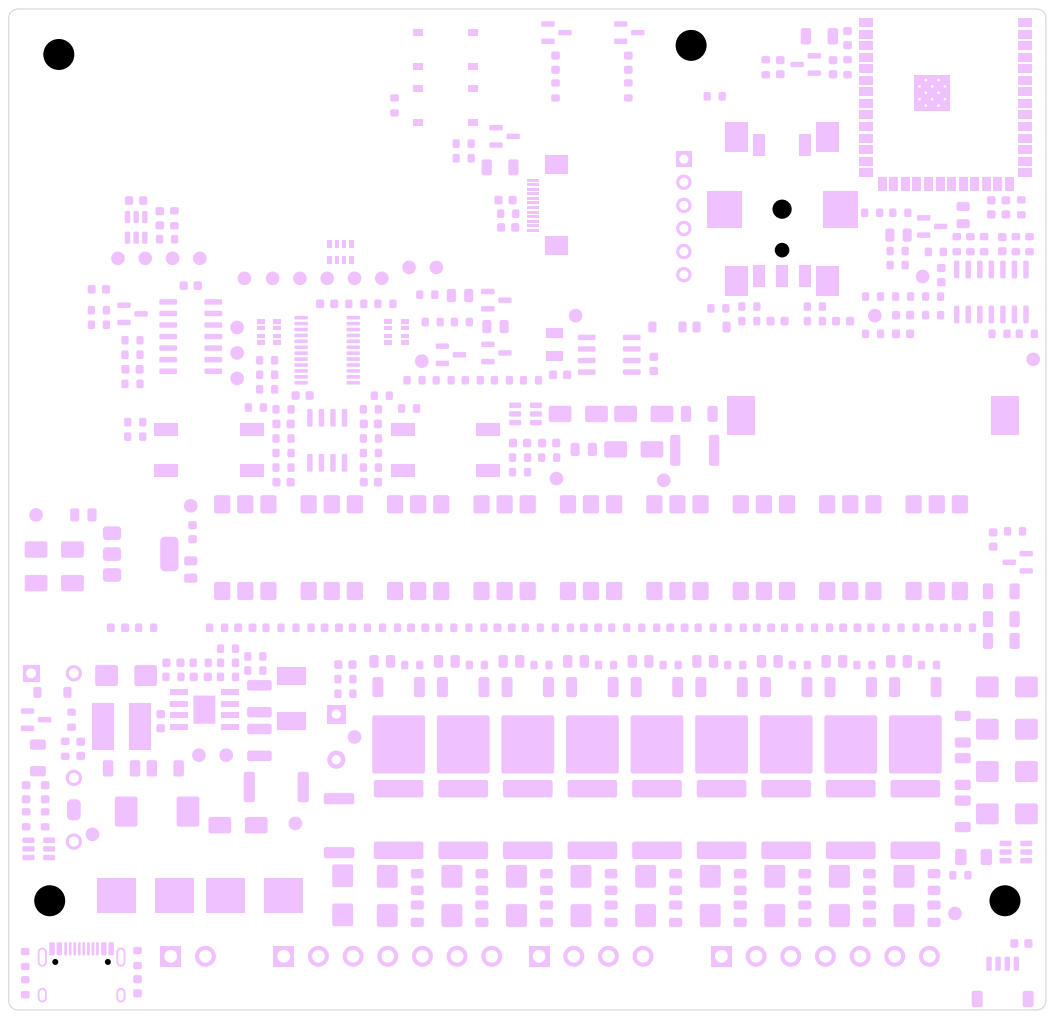
[picture p254: page 7]

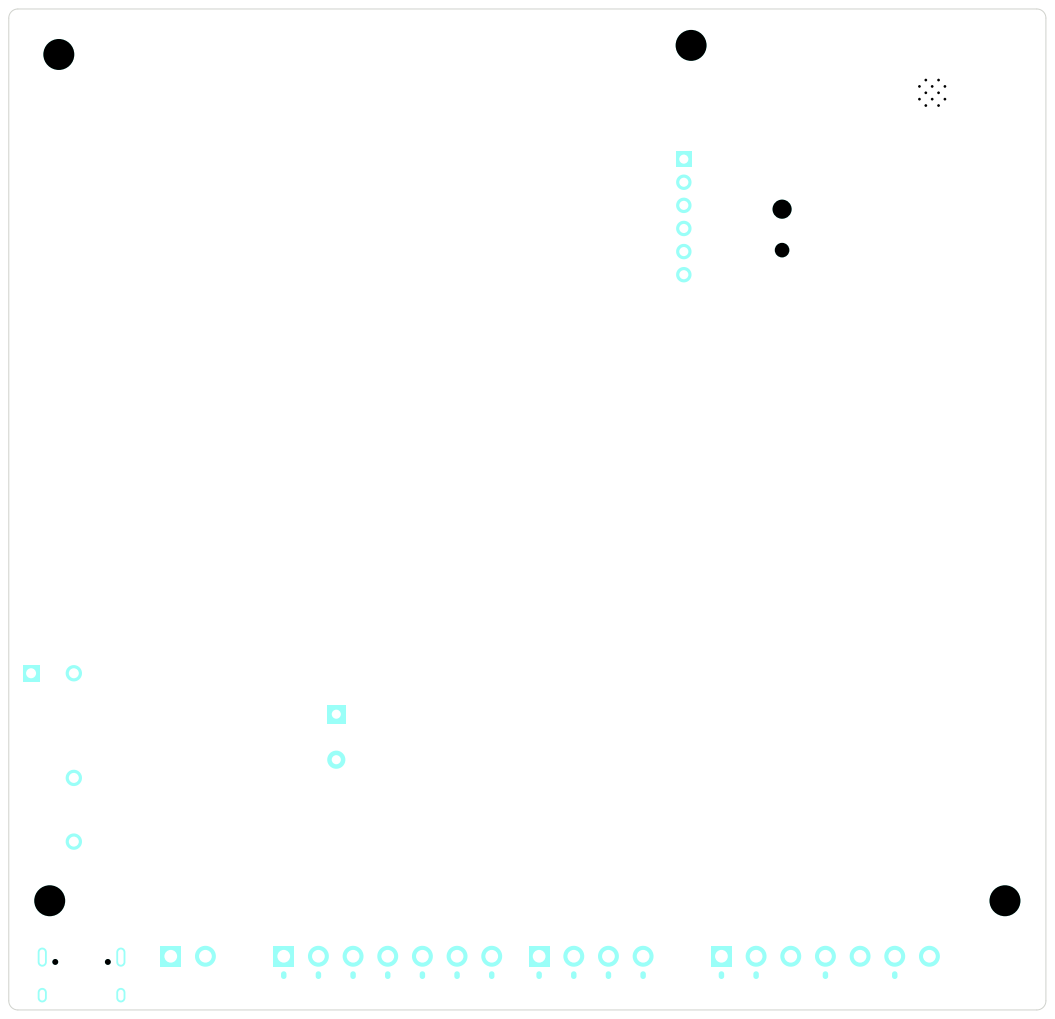
[picture p255: page 8]

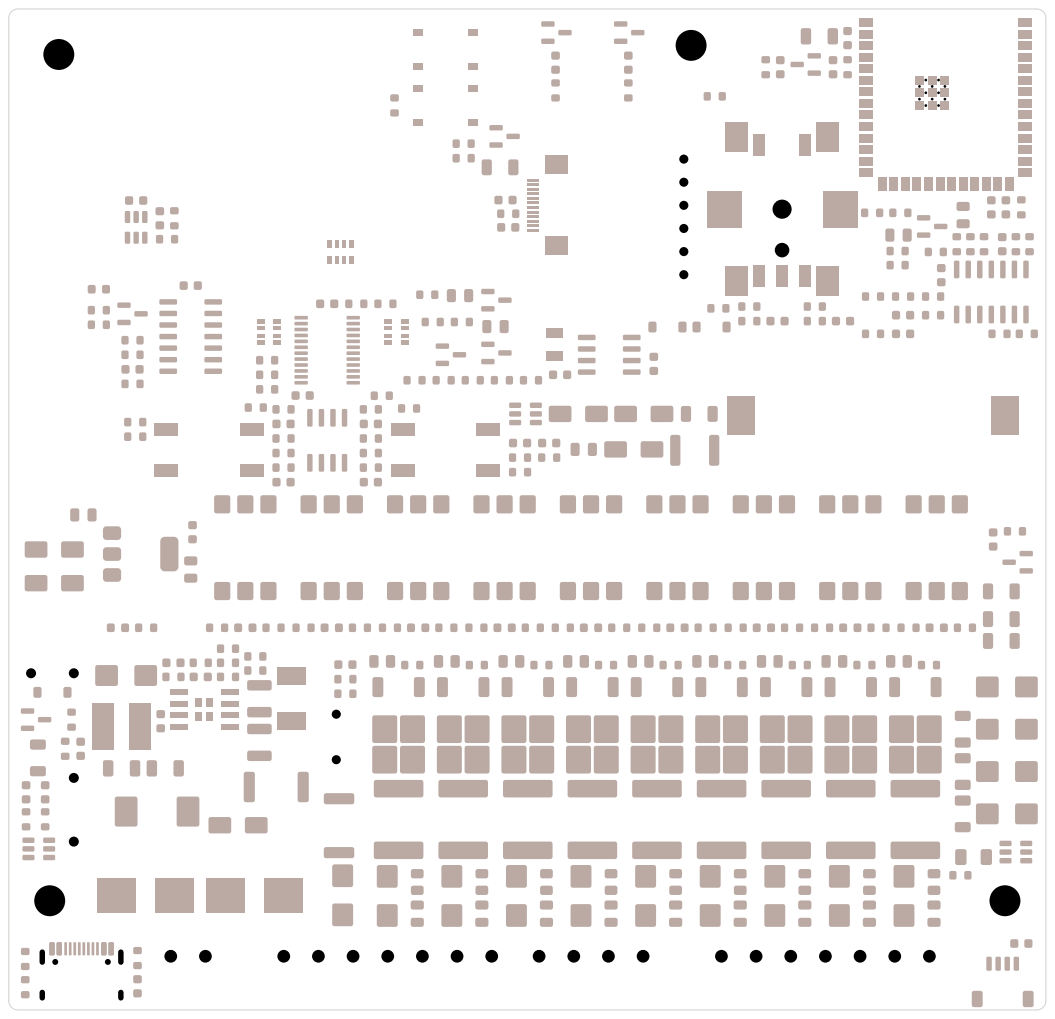
[picture p256: page 9]
