syntroniks/zoneflow/hardware/zoneflow-a/output/zoneflow-a-schematic.pdf

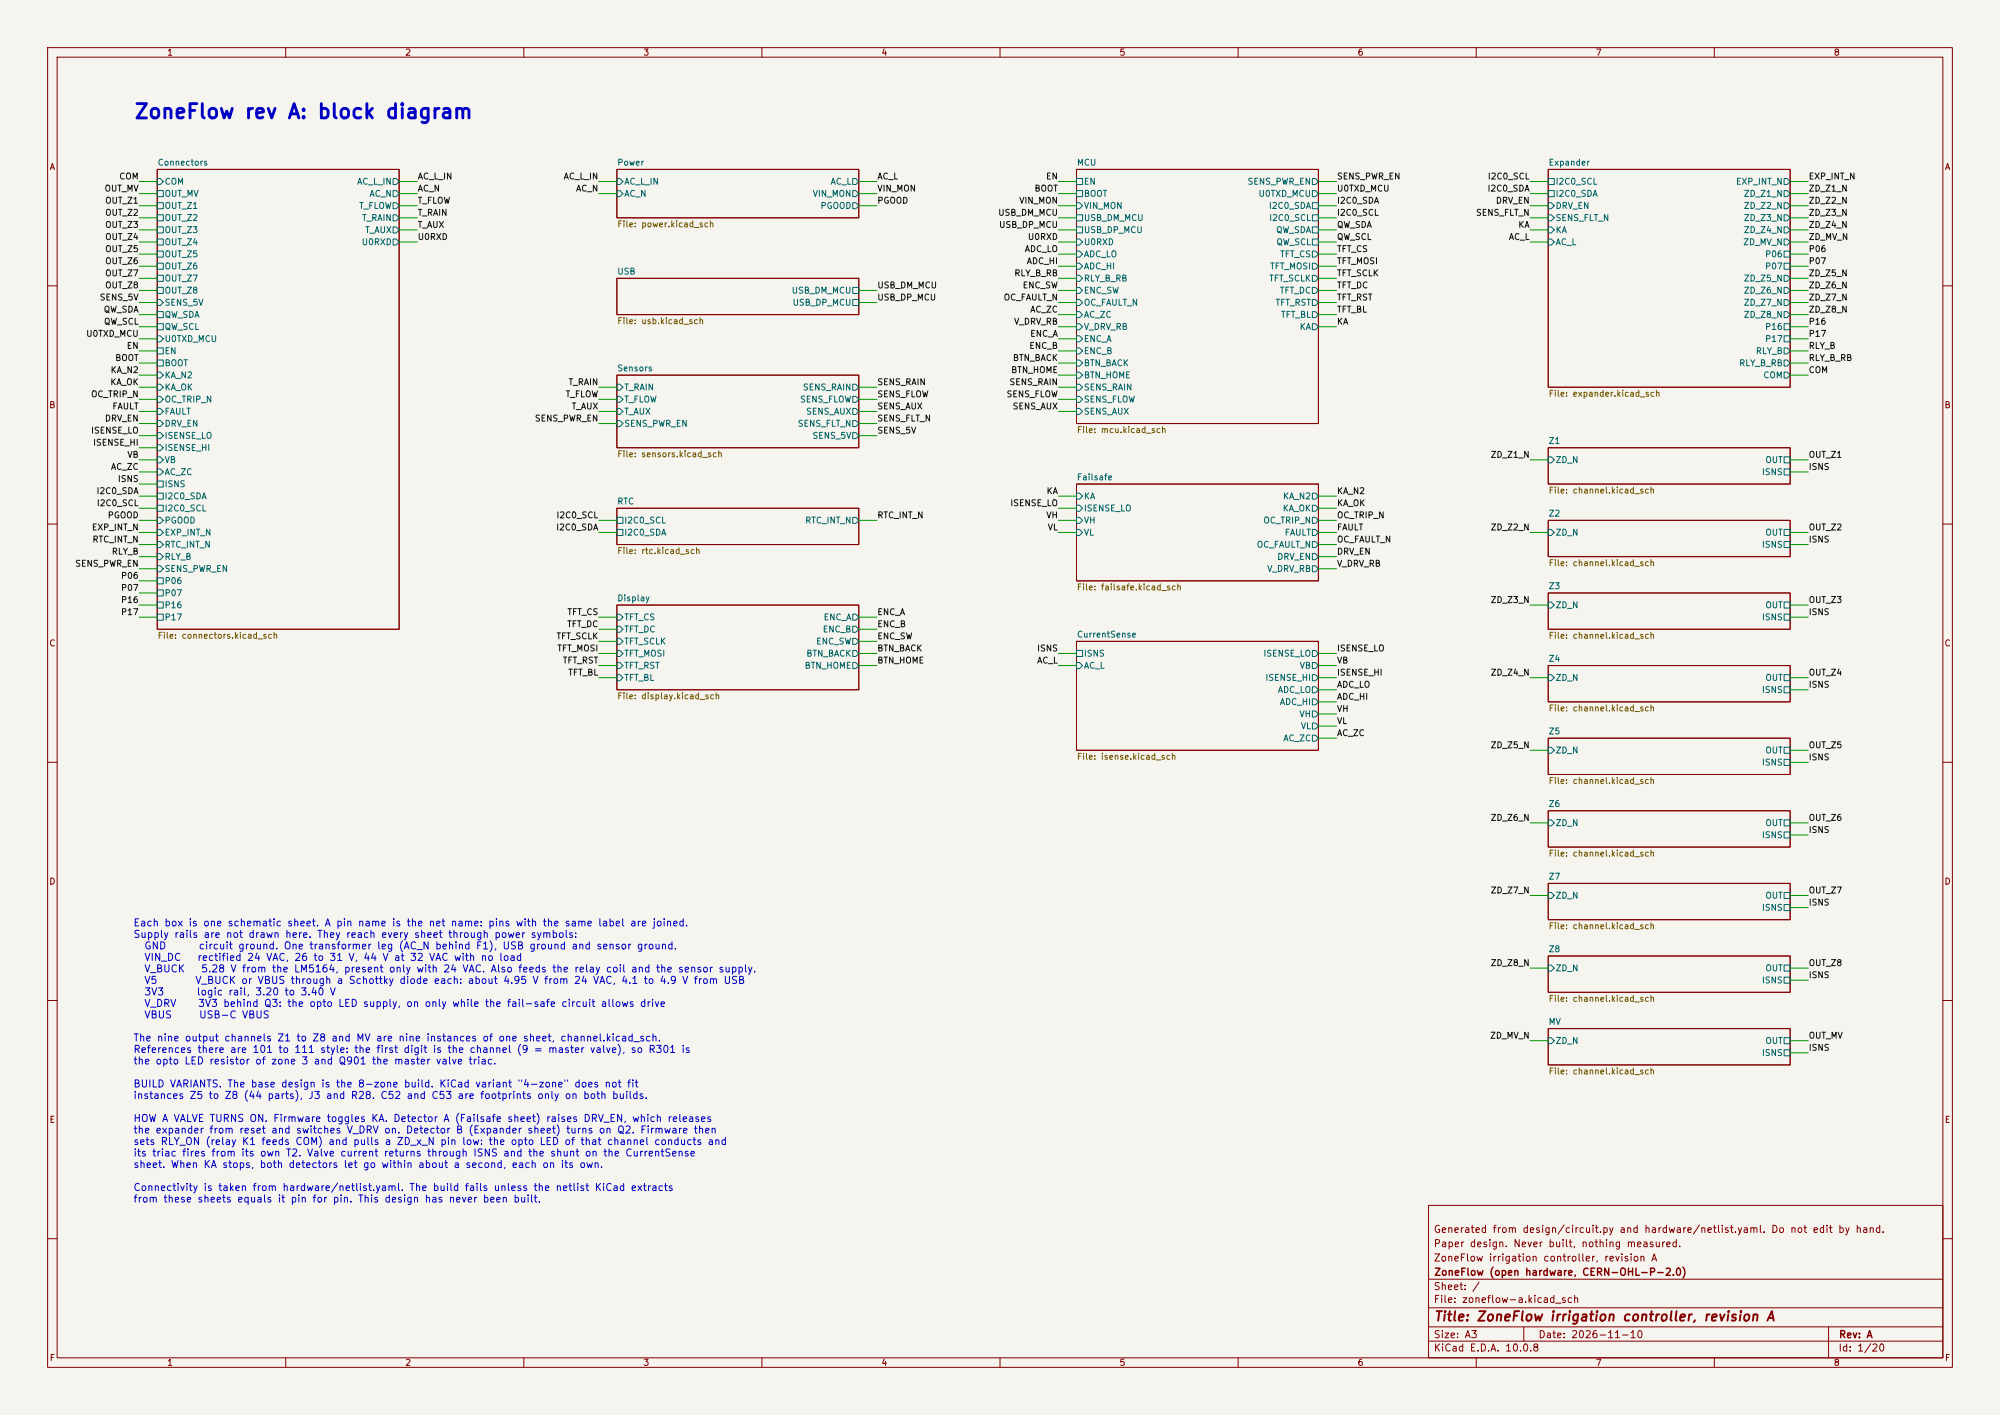
[picture p257: page 1]

Each box is one schematic sheet. A pin name is the net name: pins with the same label are joined.
Supply rails are not drawn here. They reach every sheet through power symbols:

The nine output channels Z1 to Z8 and MV are nine instances of one sheet, channel.kicad_sch.
References there are 101 to 111 style: the first digit is the channel (9 = master valve), so R301 is
the opto LED resistor of zone 3 and Q901 the master valve triac.

BUILD VARIANTS. The base design is the 8-zone build. KiCad variant "4-zone" does not fit
instances Z5 to Z8 (44 parts), J3 and R28. C52 and C53 are footprints only on both builds.

HOW A VALVE TURNS ON. Firmware toggles KA. Detector A (Failsafe sheet) raises DRV_EN, which releases
the expander from reset and switches V_DRV on. Detector B (Expander sheet) turns on Q2. Firmware then
sets RLY_ON (relay K1 feeds COM) and pulls a ZD_x_N pin low: the opto LED of that channel conducts and
its triac fires from its own T2. Valve current returns through ISNS and the shunt on the CurrentSense
sheet. When KA stops, both detectors let go within about a second, each on its own. Connectivity is taken from hardware/netlist.yaml. The build fails unless the netlist KiCad extracts

from these sheets equals it pin for pin. This design has never been built.

Paper design. Never built, nothing measured.
ZoneFlow irrigation controller, revision A
ZoneFlow (open hardware, CERN-OHL-P-2.0)
Sheet: /
File: zoneflow-a.kicad_sch
Title: ZoneFlow irrigation controller, revision A

Size: A3 | Rev: A | F Date: 2026-11-10
KiCad E.D.A. 10.0.8 | Id: 1/20

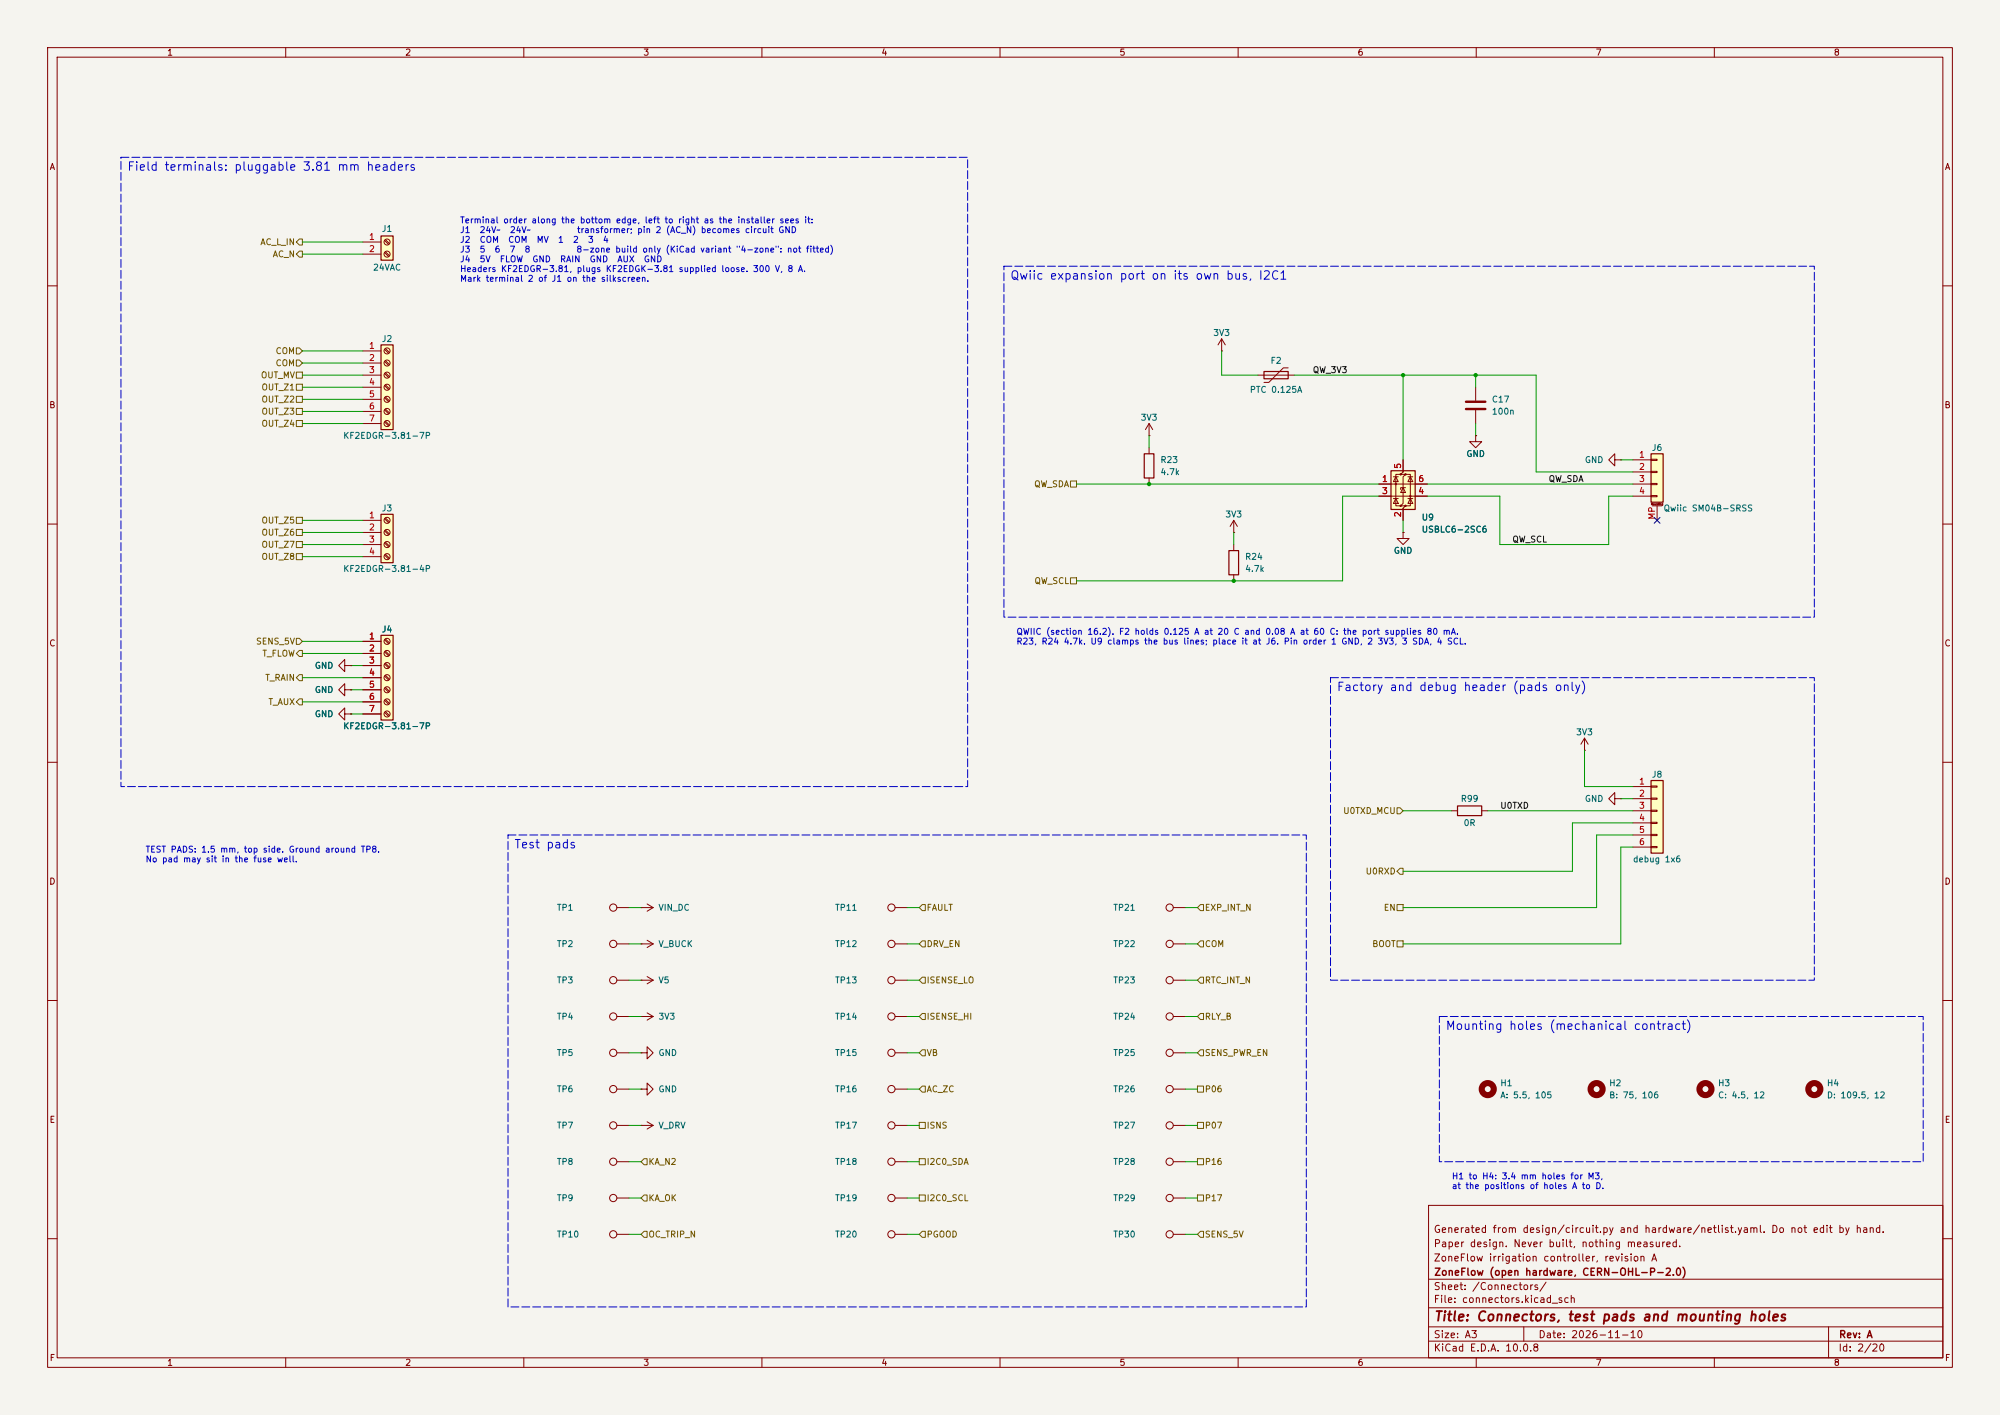
[picture p258: page 2]

Field terminals: pluggable 3.81 mm headers

H1 to H4: 3.4 mm holes for M3, at the positions of holes A to D. Mounting holes (mechanical contract) QWIIC (section 16.2). F2 holds 0.125 A at 20 C and 0.08 A at 60 C: the port supplies 80 mA. R23, R24 4.7k. U9 clamps the bus lines; place it at J6. Pin order 1 GND, 2 3V3, 3 SDA, 4 SCL. Qwiic expansion port on its own bus, I2C1

Generated from design/circuit.py and hardware/netlist.yaml. Do not edit by hand. TP22

Paper design. Never built, nothing measured.
ZoneFlow irrigation controller, revision A
ZoneFlow (open hardware, CERN-OHL-P-2.0)
Sheet: /Connectors/
File: connectors.kicad_sch
Title: Connectors, test pads and mounting holes

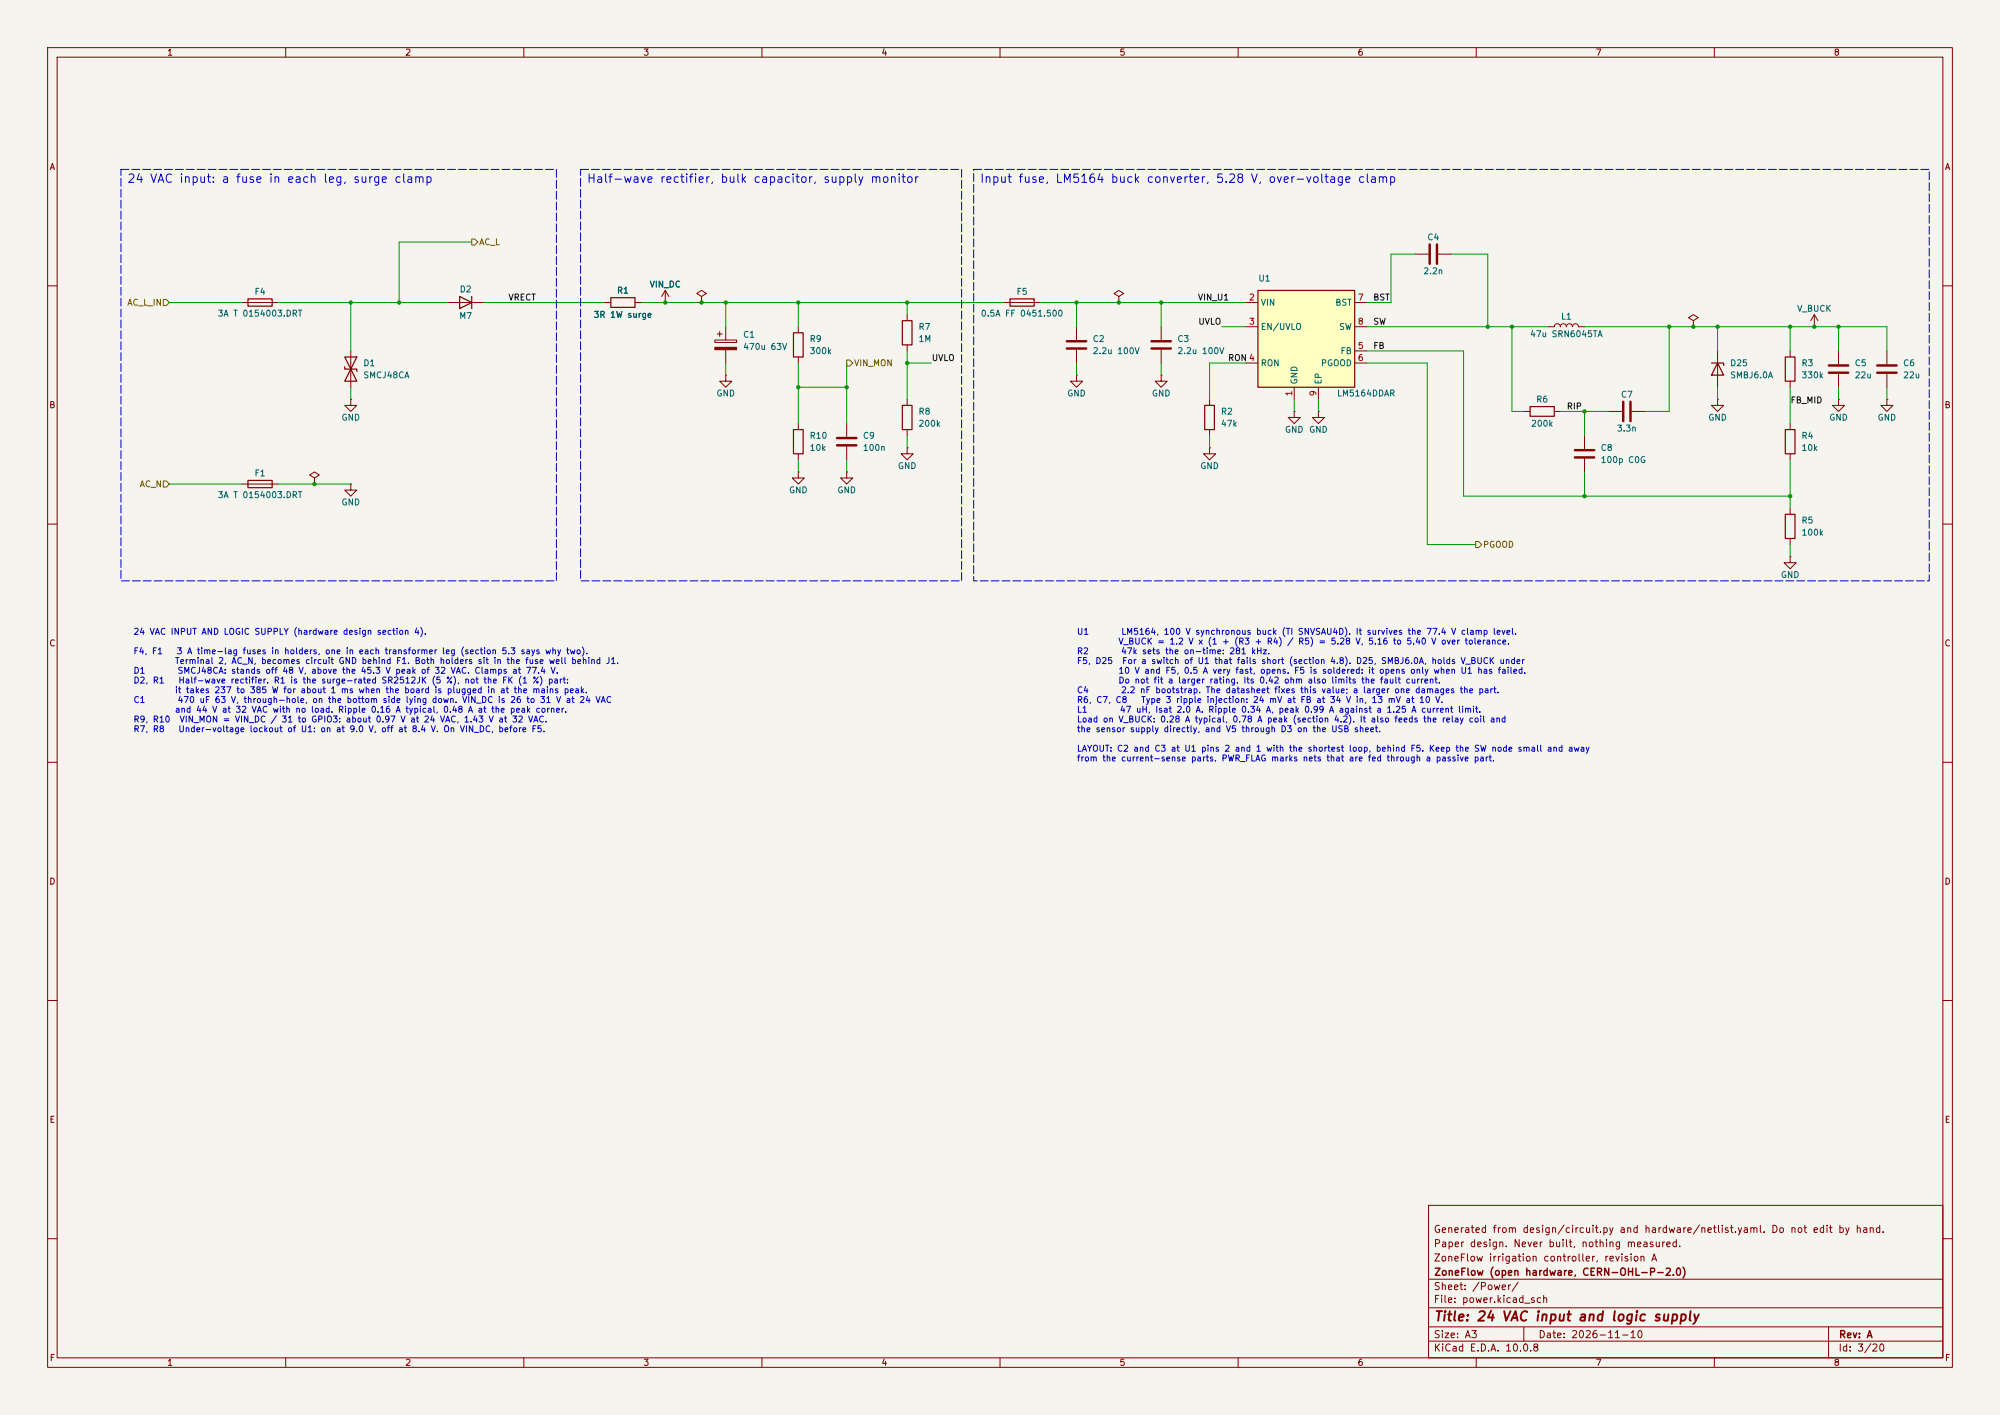
[picture p259: page 3]

from the current-sense parts. PWR_FLAG marks nets that are fed through a passive part. 24 VAC INPUT AND LOGIC SUPPLY (hardware design section 4).

the sensor supply directly, and V5 through D3 on the USB sheet. LAYOUT: C2 and C3 at U1 pins 2 and 1 with the shortest loop, behind F5. Keep the SW node small and away

Generated from design/circuit.py and hardware/netlist.yaml. Do not edit by hand.
Paper design. Never built, nothing measured.
ZoneFlow irrigation controller, revision A
ZoneFlow (open hardware, CERN-OHL-P-2.0)
Sheet: /Power/
File: power.kicad_sch
Title: 24 VAC input and logic supply

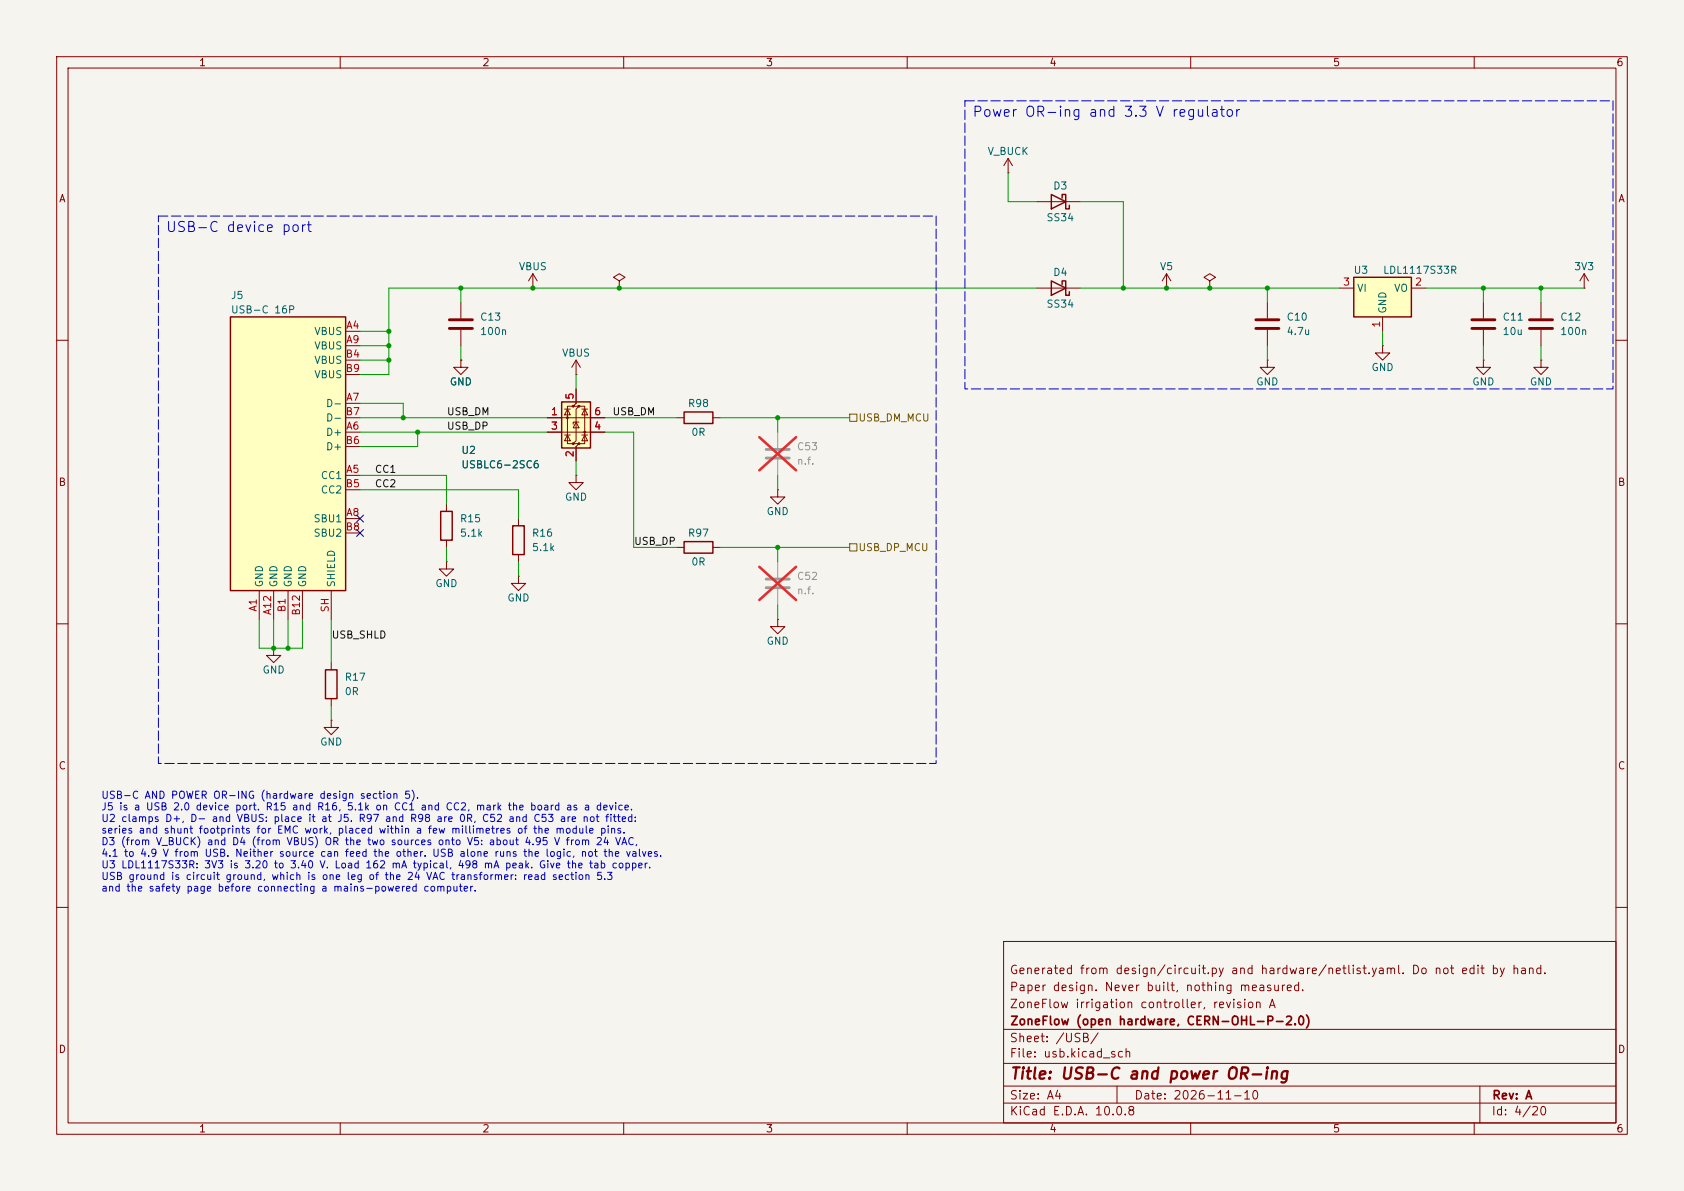
[picture p260: page 4]

Power OR-ing and 3.3 V regulator U2USBLC6-2SC6

Generated from design/circuit.py and hardware/netlist.yaml. Do not edit by hand. GND

and the safety page before connecting a mains-powered computer.

Paper design. Never built, nothing measured.
ZoneFlow irrigation controller, revision A
ZoneFlow (open hardware, CERN-OHL-P-2.0)
Sheet: /USB/
File: usb.kicad_sch
Title: USB-C and power OR-ing

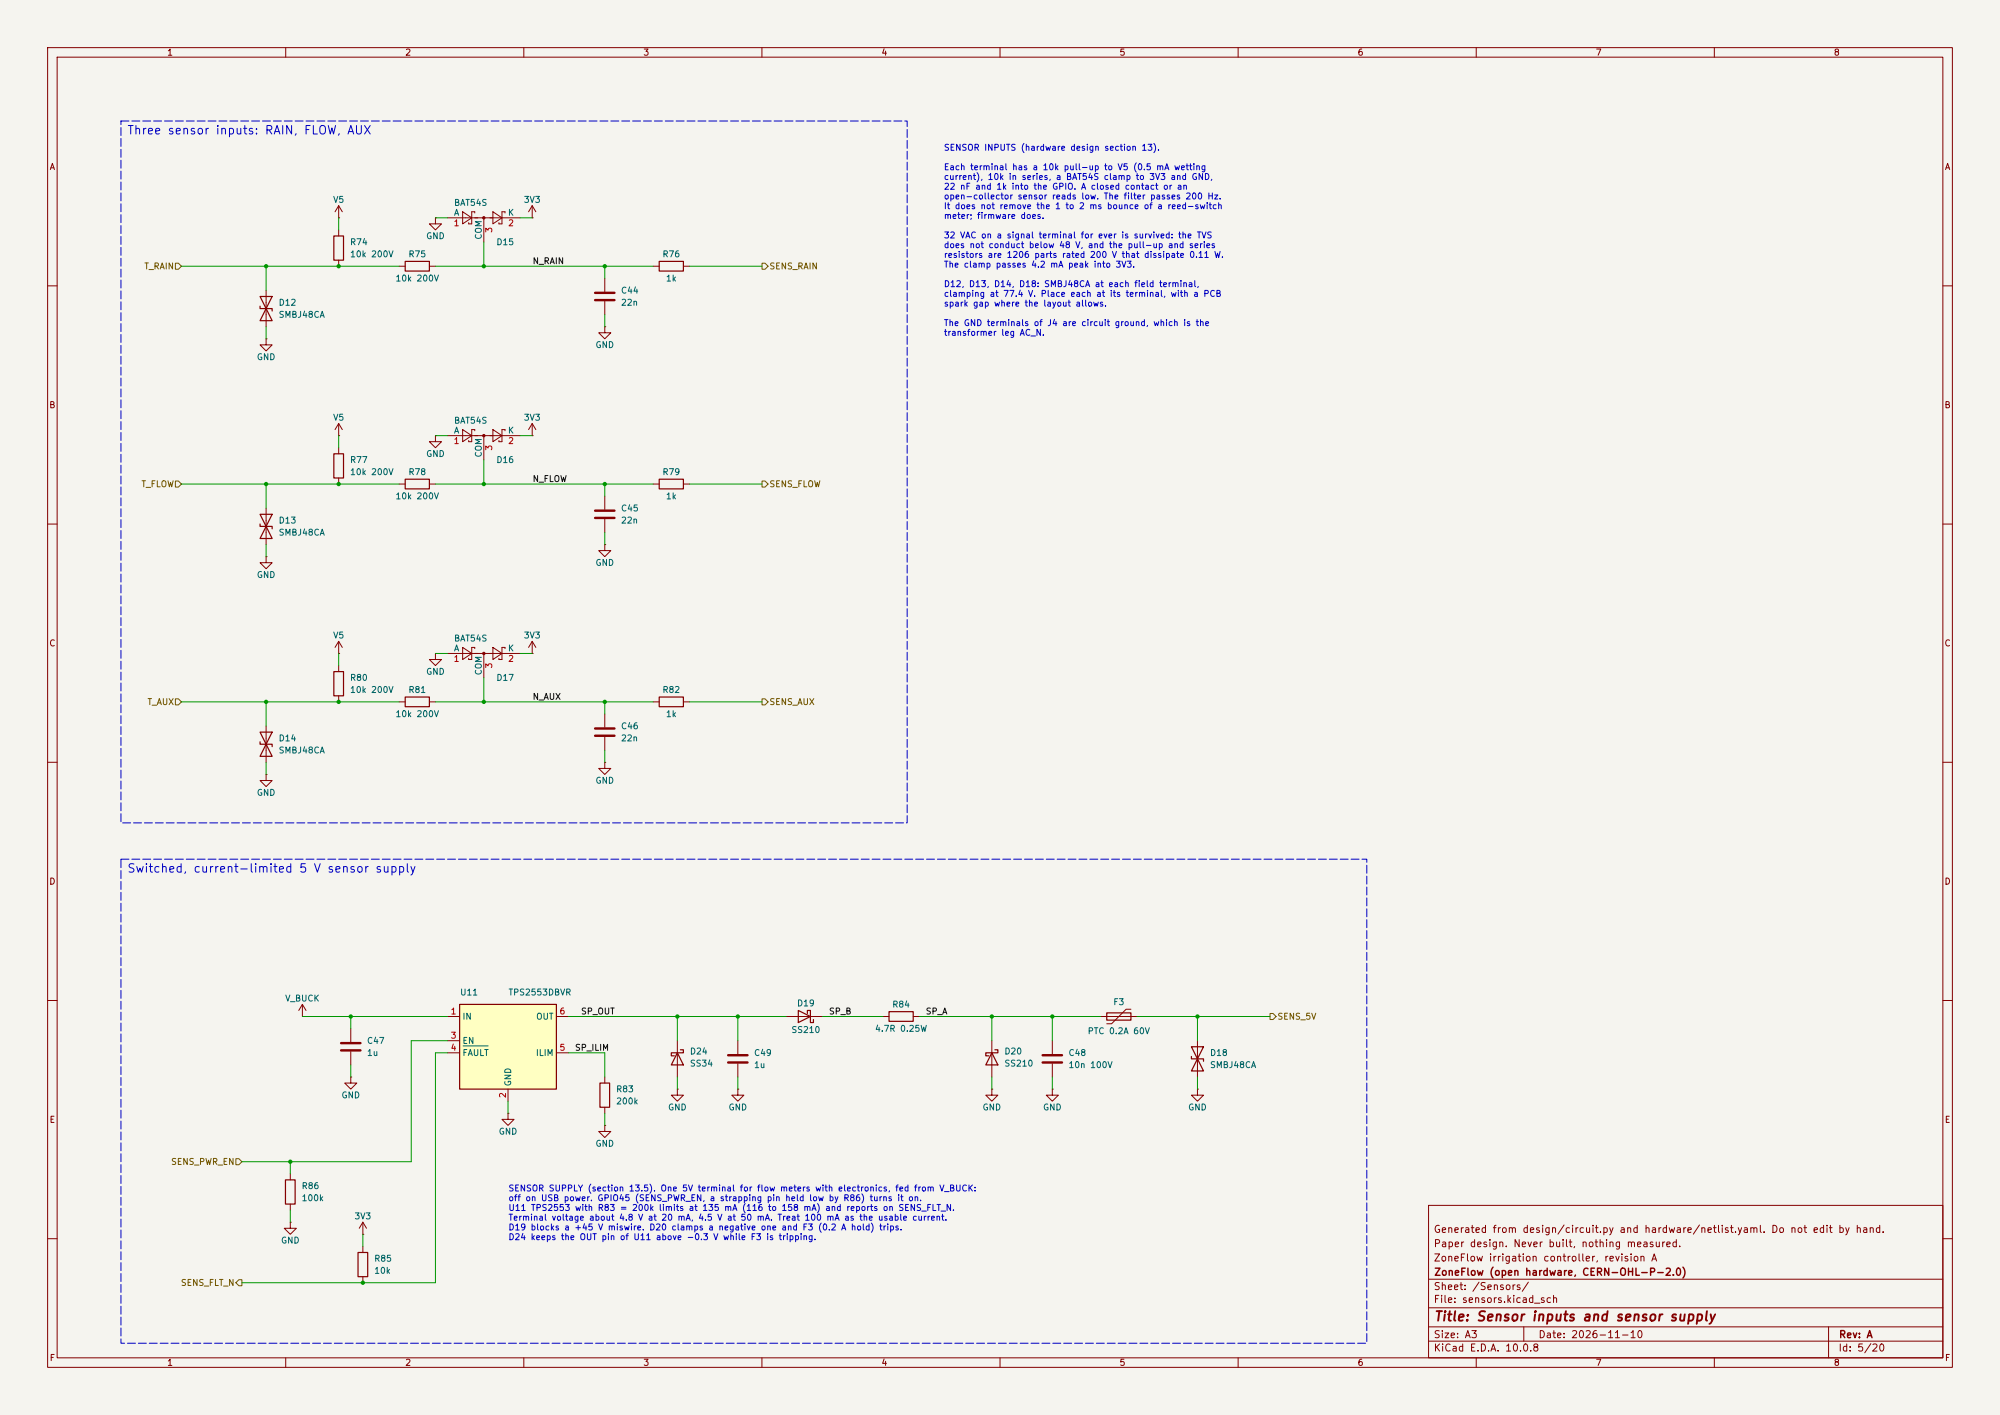
[picture p261: page 5]

Three sensor inputs: RAIN, FLOW, AUX

SENSOR INPUTS (hardware design section 13). Each terminal has a 10k pull-up to V5 (0.5 mA wetting

current), 10k in series, a BAT54S clamp to 3V3 and GND, 22 nF and 1k into the GPIO. A closed contact or an

open-collector sensor reads low. The filter passes 200 Hz.
It does not remove the 1 to 2 ms bounce of a reed-switch meter; firmware does. 32 VAC on a signal terminal for ever is survived: the TVS

does not conduct below 48 V, and the pull-up and series
resistors are 1206 parts rated 200 V that dissipate 0.11 W. The clamp passes 4.2 mA peak into 3V3. D12, D13, D14, D18: SMBJ48CA at each field terminal,

clamping at 77.4 V. Place each at its terminal, with a PCB
spark gap where the layout allows. The GND terminals of J4 are circuit ground, which is the

transformer leg AC_N. Switched, current-limited 5 V sensor supply

Generated from design/circuit.py and hardware/netlist.yaml. Do not edit by hand. GND

SENSOR SUPPLY (section 13.5). One 5V terminal for flow meters with electronics, fed from V_BUCK: off on USB power. GPIO45 (SENS_PWR_EN, a strapping pin held low by R86) turns it on. U11 TPS2553 with R83 = 200k limits at 135 mA (116 to 158 mA) and reports on SENS_FLT_N. Terminal voltage about 4.8 V at 20 mA, 4.5 V at 50 mA. Treat 100 mA as the usable current. D19 blocks a +45 V miswire. D20 clamps a negative one and F3 (0.2 A hold) trips. D24 keeps the OUT pin of U11 above -0.3 V while F3 is tripping.

Paper design. Never built, nothing measured.
ZoneFlow irrigation controller, revision A
ZoneFlow (open hardware, CERN-OHL-P-2.0)
Sheet: /Sensors/
File: sensors.kicad_sch
Title: Sensor inputs and sensor supply

AB

C

D

AB

C

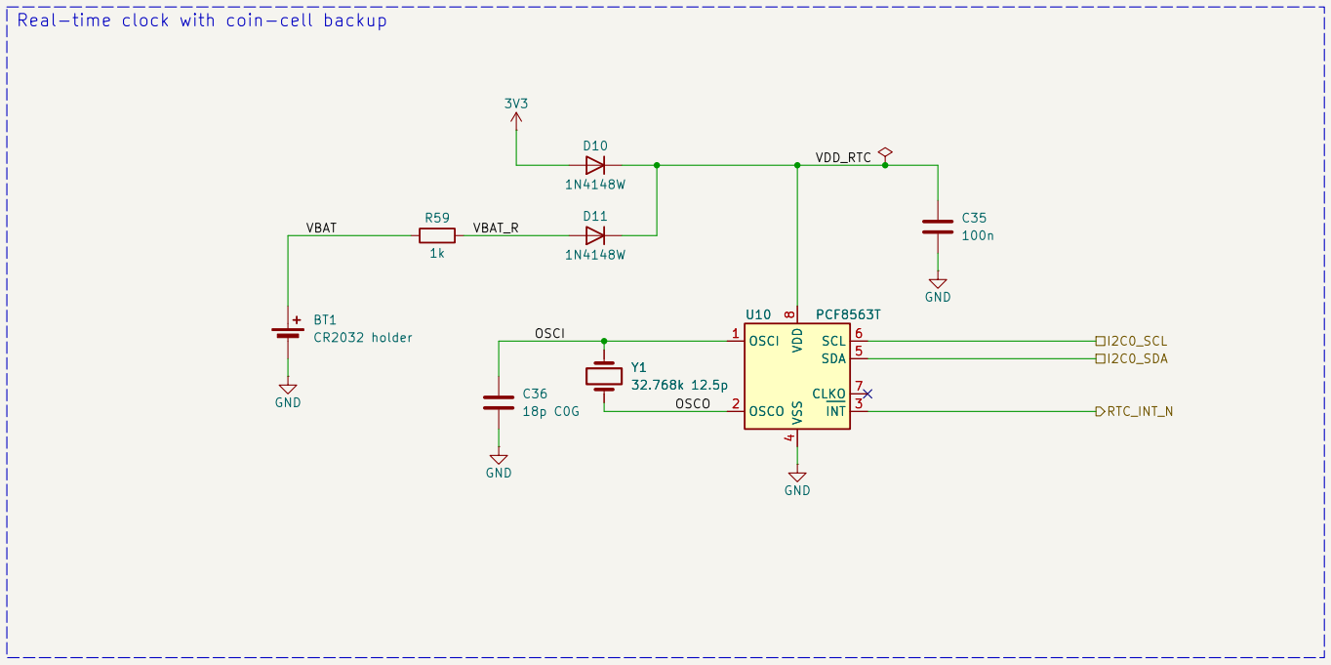
[picture p262: figure]
GND; 1k BT1 CR2032 holder; GND OSCI 1; OSCO 2; INT; 3 VSS; SDA; SCL; 6 CLKO; 7 VDD U10 8; PCF8563T D10; RTC_INT_N; I2C0_SCL I2C0_SDA; VBAT; OSCI VBAT_R; OSCO; 7 VDD

### D Date: 2026-11-10

## Title: Real-time clock

### File: rtc.kicad_sch

### Sheet: /RTC/

## ZoneFlow (open hardware, CERN-OHL-P-2.0)

ZoneFlow irrigation controller, revision A

Paper design. Never built, nothing measured.

Generated from design/circuit.py and hardware/netlist.yaml. Do not edit by hand.

## VDD_RTC Real-time clock with coin-cell backup

REAL-TIME CLOCK (hardware design section 14). U10 PCF8563T at I2C address 0x51 on I2C0. It keeps time down to 1.0 V. D10 and D11 are silicon diodes, not Schottky: a Schottky leaks as much as the RTC draws. VDD_RTC is about 2.7 V from 3V3 and 2.6 V from the cell. R59 limits the current into the

cell to under 1 mA if D11 fails short. Y1 32.768 kHz, 12.5 pF. C36 18 pF with the 25 pF inside OSCO gives an 11.7 pF load. CLKO is not used: firmware writes 0x00 to register 0x0D to turn the 32 kHz output off. BT1 holds a CR2032, fitted at final assembly. Back-up current 0.25 uA typical: about ten years. | U10 | PCF8563T OSCI 1 | OSCO 2

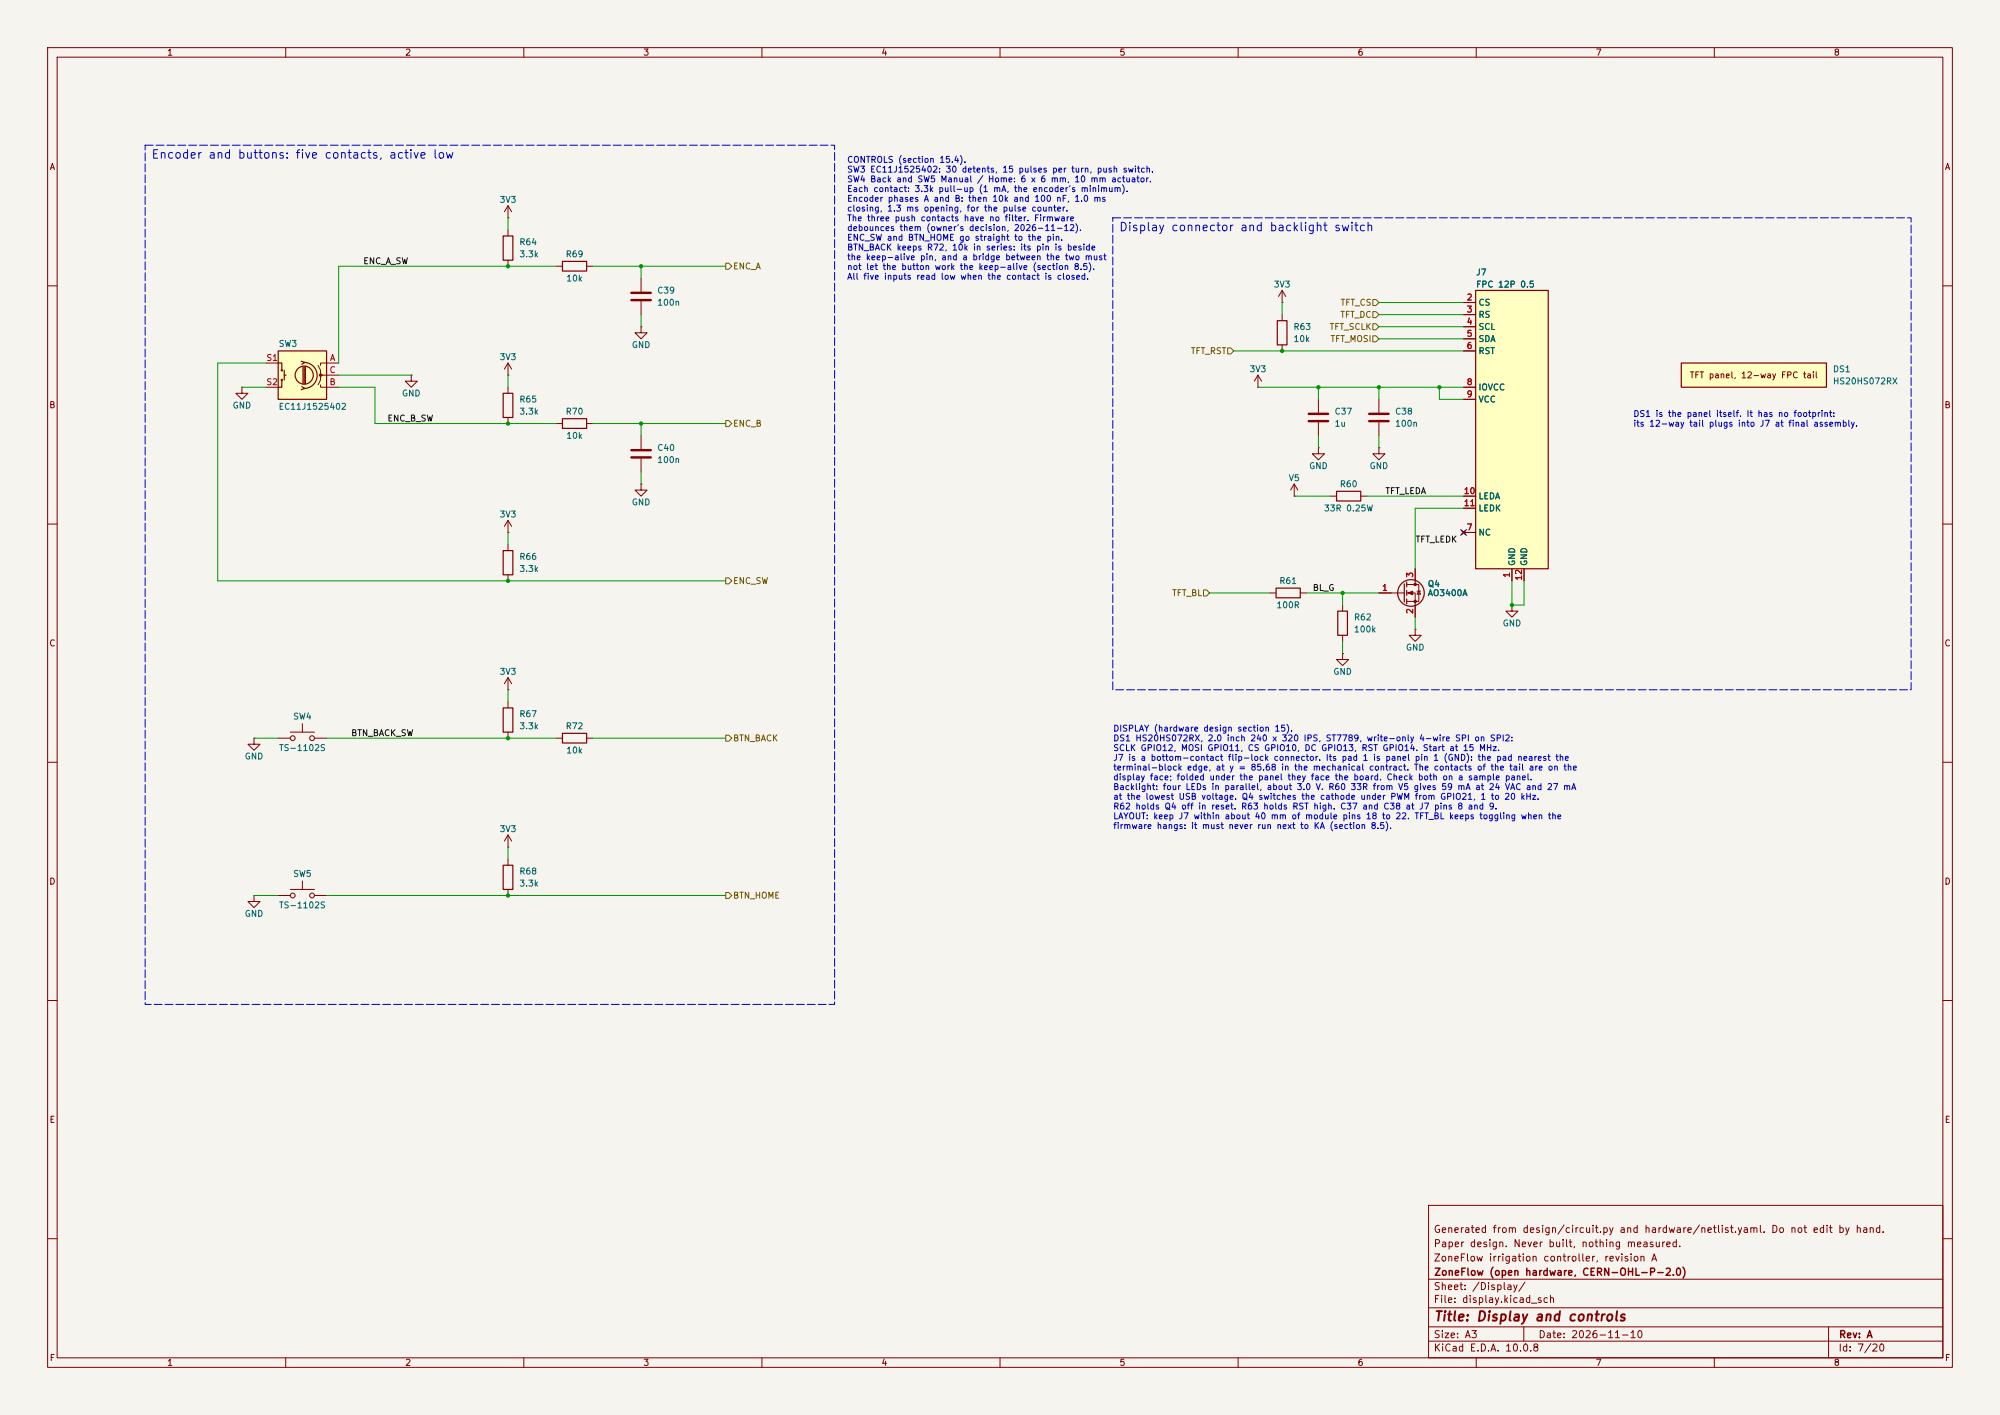
[picture p263: page 7]

Encoder and buttons: five contacts, active low

CONTROLS (section 15.4). SW3 EC11J1525402: 30 detents, 15 pulses per turn, push switch. SW4 Back and SW5 Manual / Home: 6 x 6 mm, 10 mm actuator. Each contact: 3.3k pull-up (1 mA, the encoder's minimum). Encoder phases A and B: then 10k and 100 nF, 1.0 ms closing, 1.3 ms opening, for the pulse counter. The three push contacts have no filter. Firmware debounces them (owner's decision, 2026-11-12). ENC_SW and BTN_HOME go straight to the pin. BTN_BACK keeps R72, 10k in series: its pin is beside

Display connector and backlight switch

its 12-way tail plugs into J7 at final assembly.

DISPLAY (hardware design section 15). DS1 HS20HS072RX, 2.0 inch 240 x 320 IPS, ST7789, write-only 4-wire SPI on SPI2: SCLK GPIO12, MOSI GPIO11, CS GPIO10, DC GPIO13, RST GPIO14. Start at 15 MHz. J7 is a bottom-contact flip-lock connector. Its pad 1 is panel pin 1 (GND): the pad nearest the

terminal-block edge, at y = 85.68 in the mechanical contract. The contacts of the tail are on the display face; folded under the panel they face the board. Check both on a sample panel.

Backlight: four LEDs in parallel, about 3.0 V. R60 33R from V5 gives 59 mA at 24 VAC and 27 mA at the lowest USB voltage. Q4 switches the cathode under PWM from GPIO21, 1 to 20 kHz. R62 holds Q4 off in reset. R63 holds RST high. C37 and C38 at J7 pins 8 and 9. LAYOUT: keep J7 within about 40 mm of module pins 18 to 22. TFT_BL keeps toggling when the

Generated from design/circuit.py and hardware/netlist.yaml. Do not edit by hand.
Paper design. Never built, nothing measured.
ZoneFlow irrigation controller, revision A
ZoneFlow (open hardware, CERN-OHL-P-2.0)
Sheet: /Display/
File: display.kicad_sch
Title: Display and controls

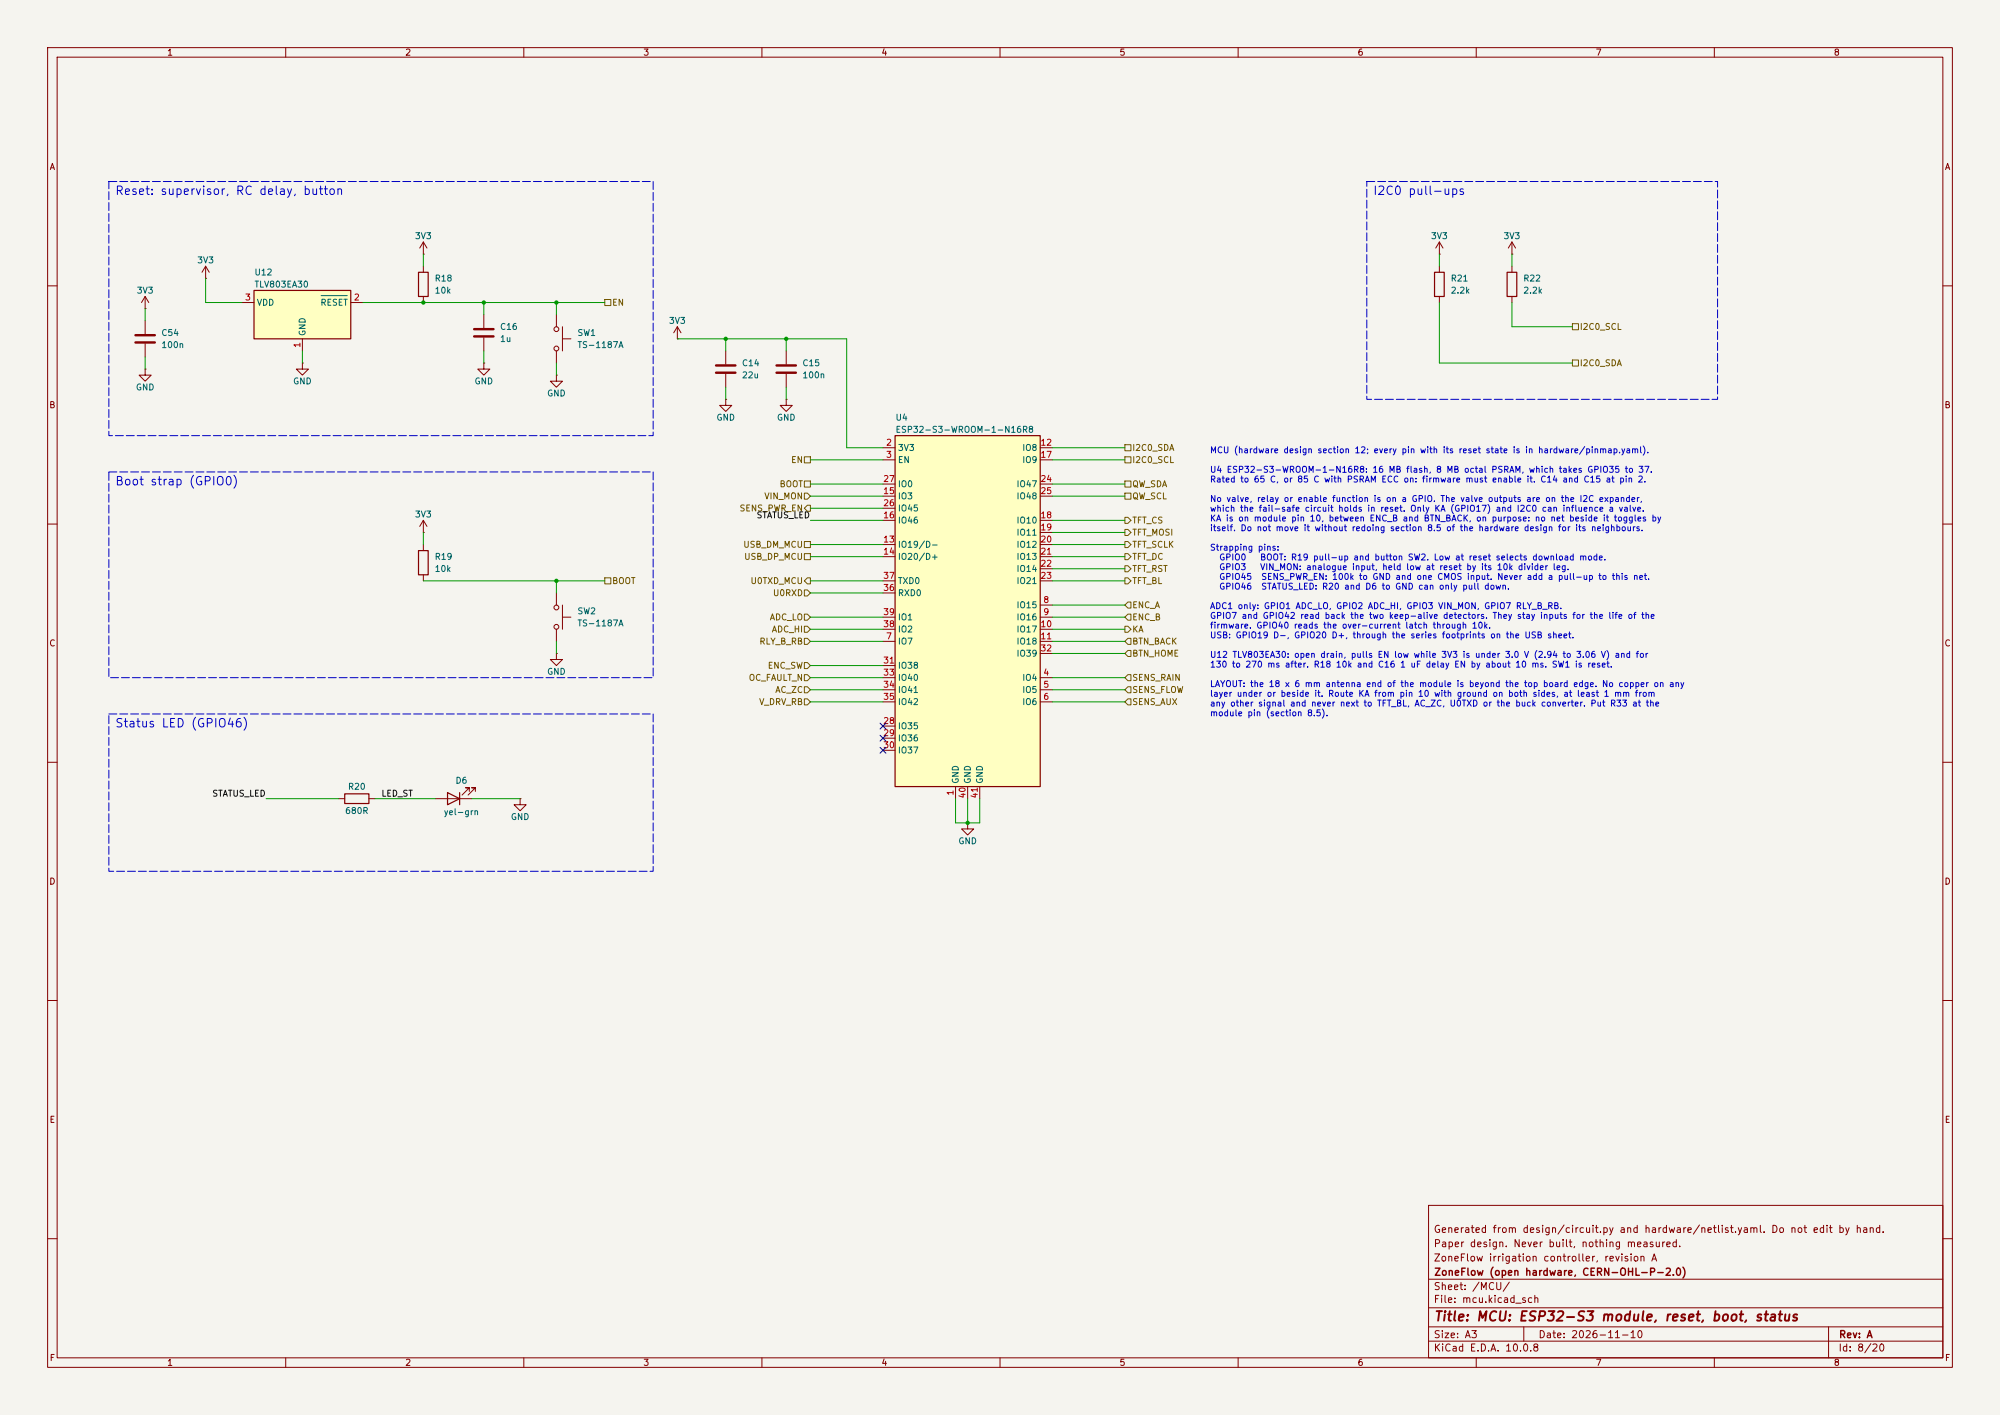
[picture p264: page 8]

Reset: supervisor, RC delay, button

itself. Do not move it without redoing section 8.5 of the hardware design for its neighbours.

firmware. GPIO40 reads the over-current latch through 10k. USB: GPIO19 D-, GPIO20 D+, through the series footprints on the USB sheet. U12 TLV803EA30: open drain, pulls EN low while 3V3 is under 3.0 V (2.94 to 3.06 V) and for 130 to 270 ms after. R18 10k and C16 1 uF delay EN by about 10 ms. SW1 is reset. LAYOUT: the 18 x 6 mm antenna end of the module is beyond the top board edge. No copper on any

layer under or beside it. Route KA from pin 10 with ground on both sides, at least 1 mm from
any other signal and never next to TFT_BL, AC_ZC, U0TXD or the buck converter. Put R33 at the module pin (section 8.5).

Generated from design/circuit.py and hardware/netlist.yaml. Do not edit by hand.
Paper design. Never built, nothing measured.
ZoneFlow irrigation controller, revision A
ZoneFlow (open hardware, CERN-OHL-P-2.0)
Sheet: /MCU/
File: mcu.kicad_sch
Title: MCU: ESP32-S3 module, reset, boot, status

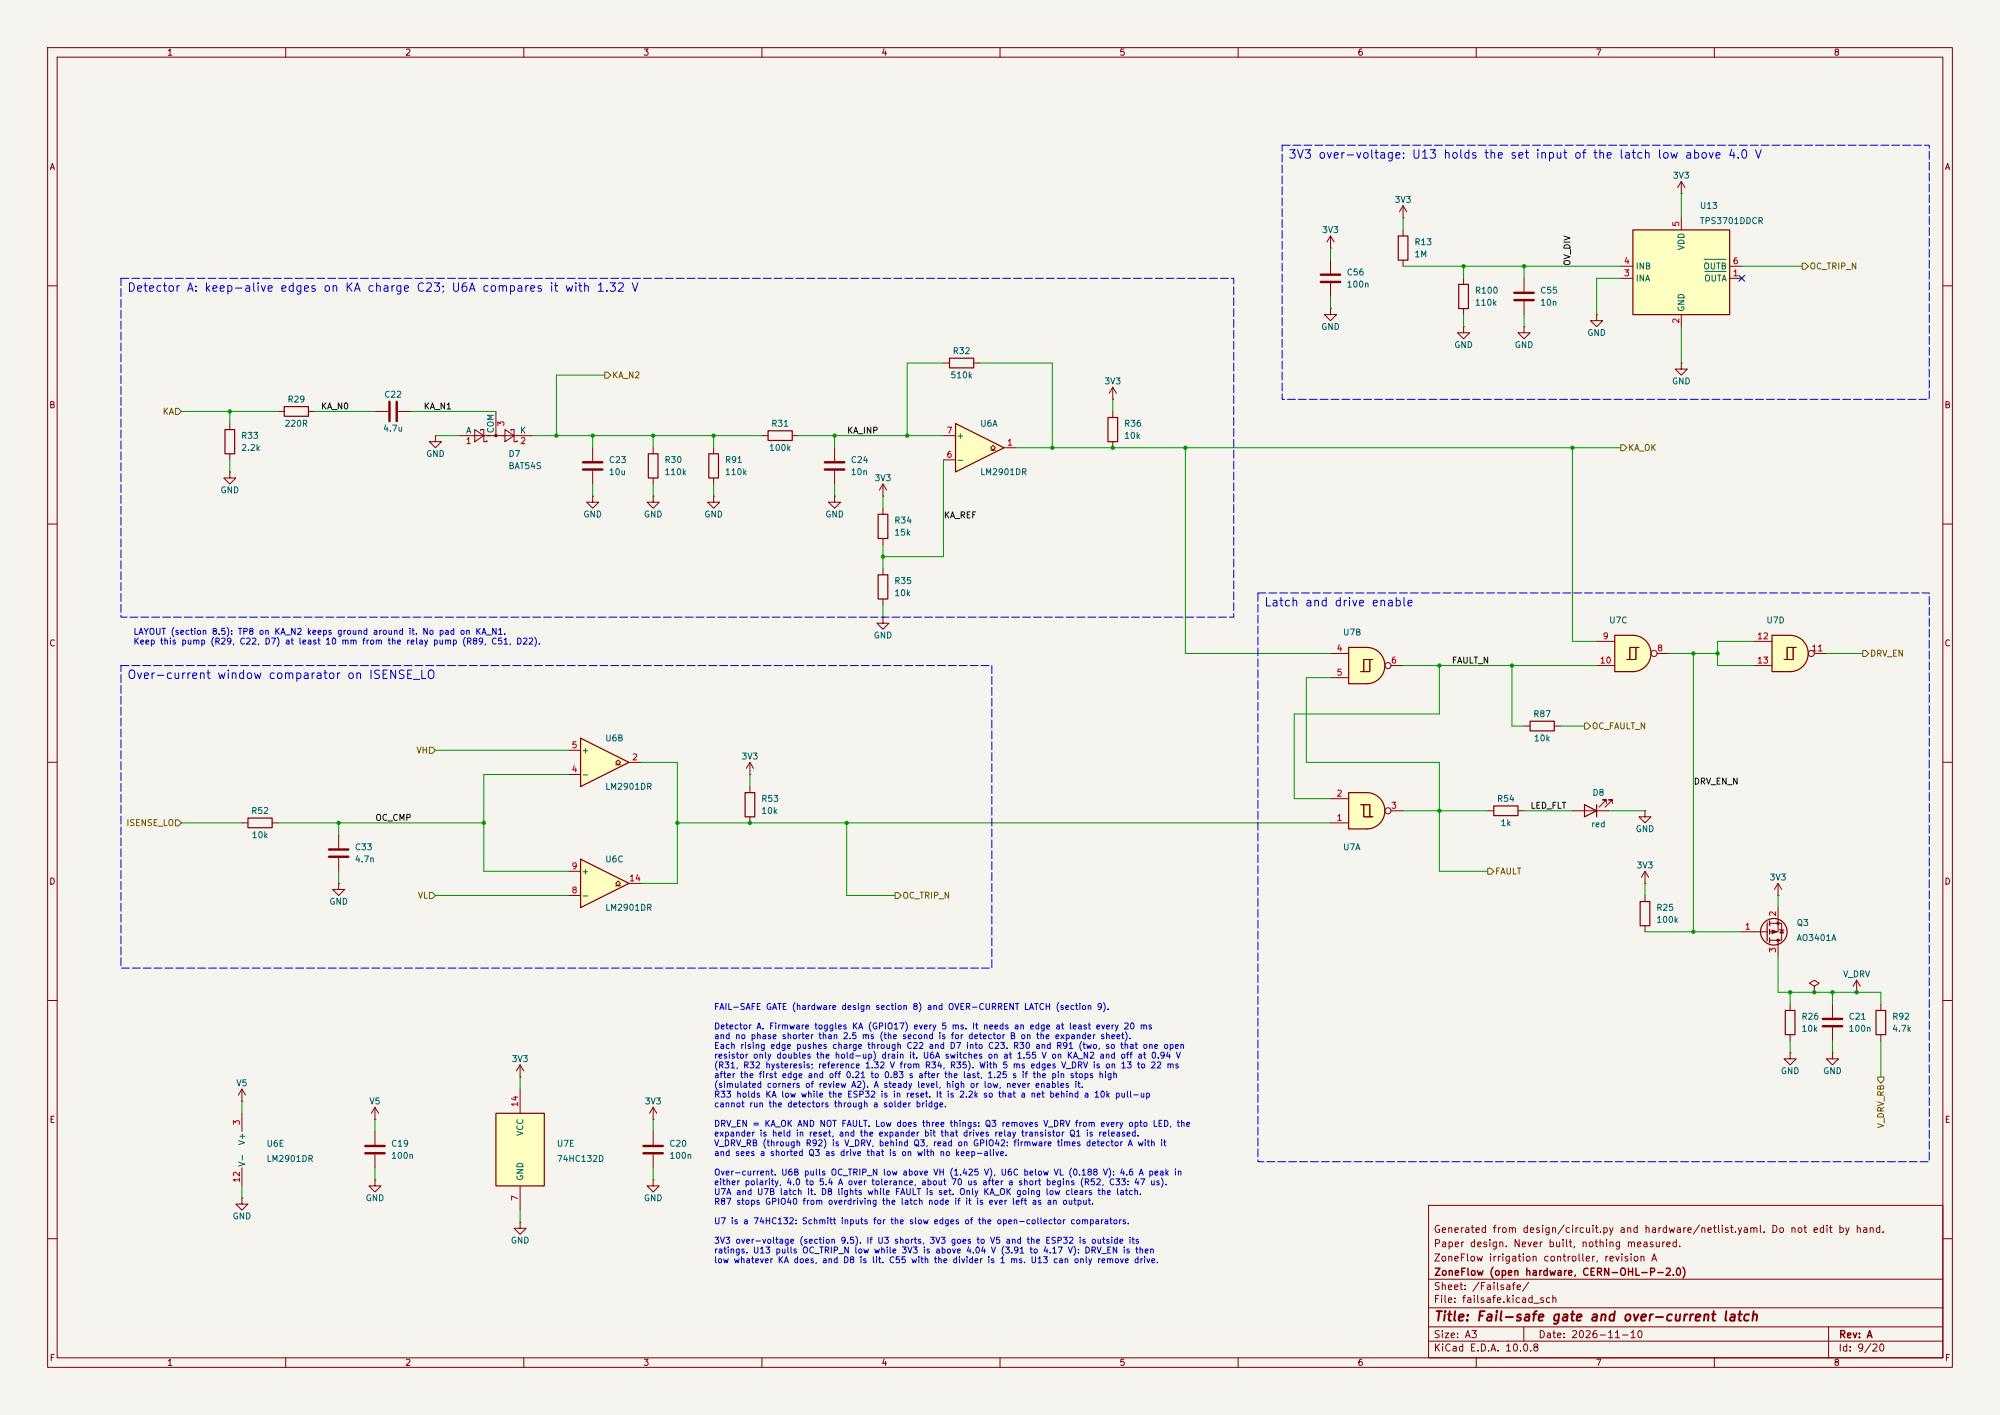
[picture p265: page 9]

3V3 over-voltage: U13 holds the set input of the latch low above 4.0 V

INA 3

Latch and drive enable

LAYOUT (section 8.5): TP8 on KA_N2 keeps ground around it. No pad on KA_N1. Keep this pump (R29, C22, D7) at least 10 mm from the relay pump (R89, C51, D22).

low whatever KA does, and D8 is lit. C55 with the divider is 1 ms. U13 can only remove drive. Over-current window comparator on ISENSE_LO

FAIL-SAFE GATE (hardware design section 8) and OVER-CURRENT LATCH (section 9). Detector A. Firmware toggles KA (GPIO17) every 5 ms. It needs an edge at least every 20 ms and no phase shorter than 2.5 ms (the second is for detector B on the expander sheet). Each rising edge pushes charge through C22 and D7 into C23. R30 and R91 (two, so that one open

resistor only doubles the hold-up) drain it. U6A switches on at 1.55 V on KA_N2 and off at 0.94 V
(R31, R32 hysteresis; reference 1.32 V from R34, R35). With 5 ms edges V_DRV is on 13 to 22 ms after the first edge and off 0.21 to 0.83 s after the last, 1.25 s if the pin stops high

(simulated corners of review A2). A steady level, high or low, never enables it. R33 holds KA low while the ESP32 is in reset. It is 2.2k so that a net behind a 10k pull-up

cannot run the detectors through a solder bridge. DRV_EN = KA_OK AND NOT FAULT. Low does three things: Q3 removes V_DRV from every opto LED, the

expander is held in reset, and the expander bit that drives relay transistor Q1 is released. V_DRV_RB (through R92) is V_DRV, behind Q3, read on GPIO42: firmware times detector A with it and sees a shorted Q3 as drive that is on with no keep-alive. Over-current. U6B pulls OC_TRIP_N low above VH (1.425 V), U6C below VL (0.188 V): 4.6 A peak in

either polarity, 4.0 to 5.4 A over tolerance, about 70 us after a short begins (R52, C33: 47 us). U7A and U7B latch it. D8 lights while FAULT is set. Only KA_OK going low clears the latch. R87 stops GPIO40 from overdriving the latch node if it is ever left as an output. U7 is a 74HC132: Schmitt inputs for the slow edges of the open-collector comparators. 3V3 over-voltage (section 9.5). If U3 shorts, 3V3 goes to V5 and the ESP32 is outside its

Generated from design/circuit.py and hardware/netlist.yaml. Do not edit by hand. GND

Paper design. Never built, nothing measured.
ZoneFlow irrigation controller, revision A
ZoneFlow (open hardware, CERN-OHL-P-2.0)
Sheet: /Failsafe/
File: failsafe.kicad_sch
Title: Fail-safe gate and over-current latch

ratings. U13 pulls OC_TRIP_N low while 3V3 is above 4.04 V (3.91 to 4.17 V): DRV_EN is then

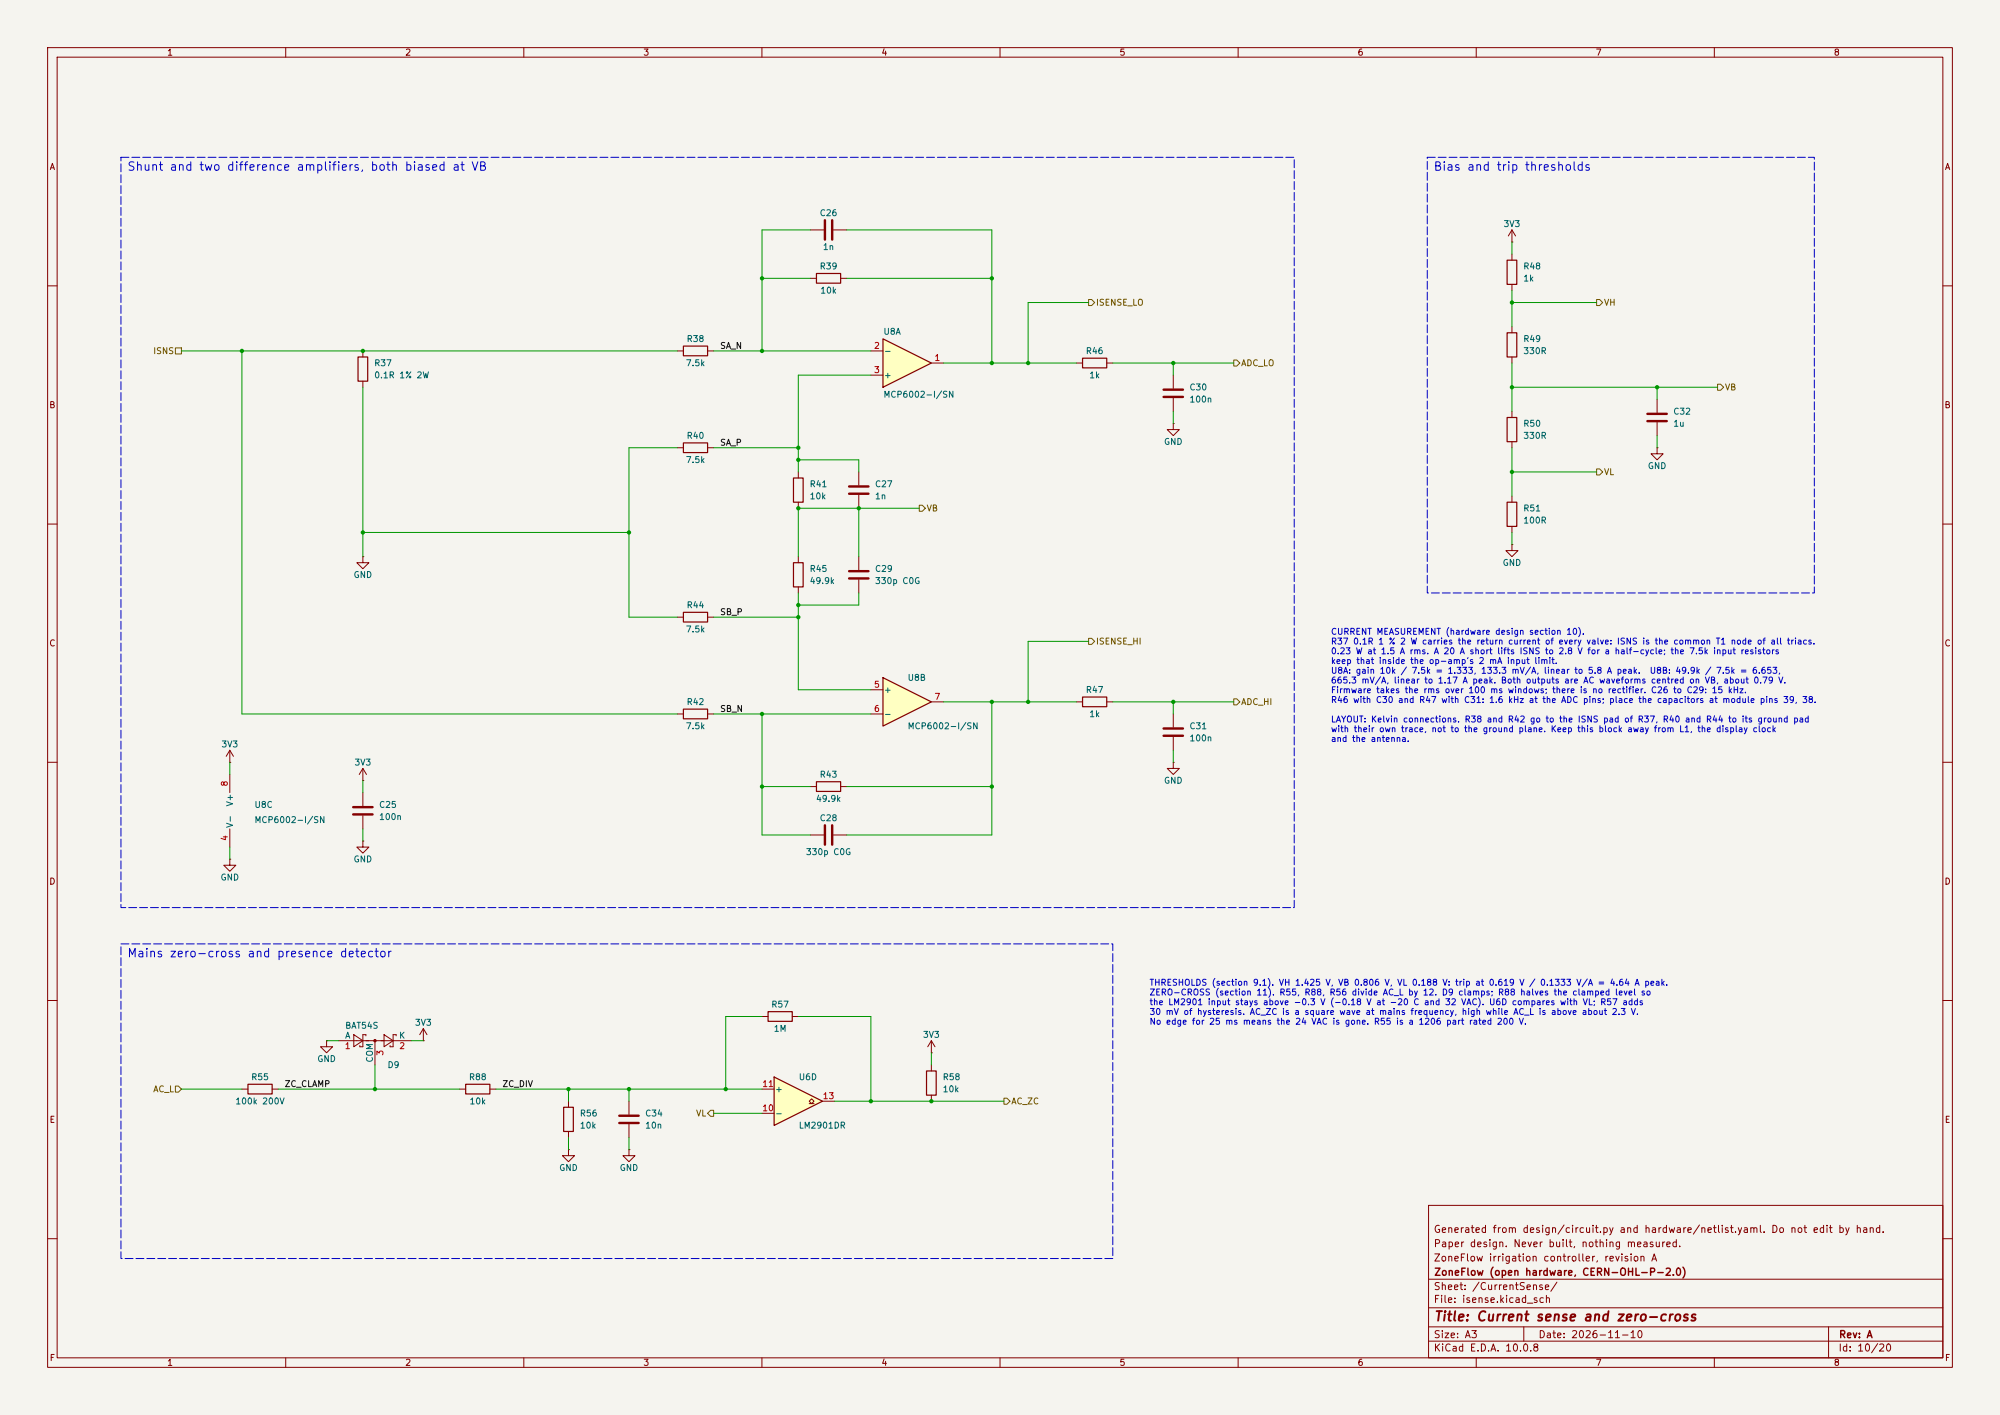
[picture p266: page 10]

Shunt and two difference amplifiers, both biased at VB

Bias and trip thresholds

CURRENT MEASUREMENT (hardware design section 10). R37 0.1R 1 % 2 W carries the return current of every valve: ISNS is the common T1 node of all triacs. 0.23 W at 1.5 A rms. A 20 A short lifts ISNS to 2.8 V for a half-cycle; the 7.5k input resistors

the LM2901 input stays above -0.3 V (-0.18 V at -20 C and 32 VAC). U6D compares with VL; R57 adds 30 mV of hysteresis. AC_ZC is a square wave at mains frequency, high while AC_L is above about 2.3 V. No edge for 25 ms means the 24 VAC is gone. R55 is a 1206 part rated 200 V. Mains zero-cross and presence detector

Generated from design/circuit.py and hardware/netlist.yaml. Do not edit by hand.
Paper design. Never built, nothing measured.
ZoneFlow irrigation controller, revision A
ZoneFlow (open hardware, CERN-OHL-P-2.0)
Sheet: /CurrentSense/
File: isense.kicad_sch
Title: Current sense and zero-cross

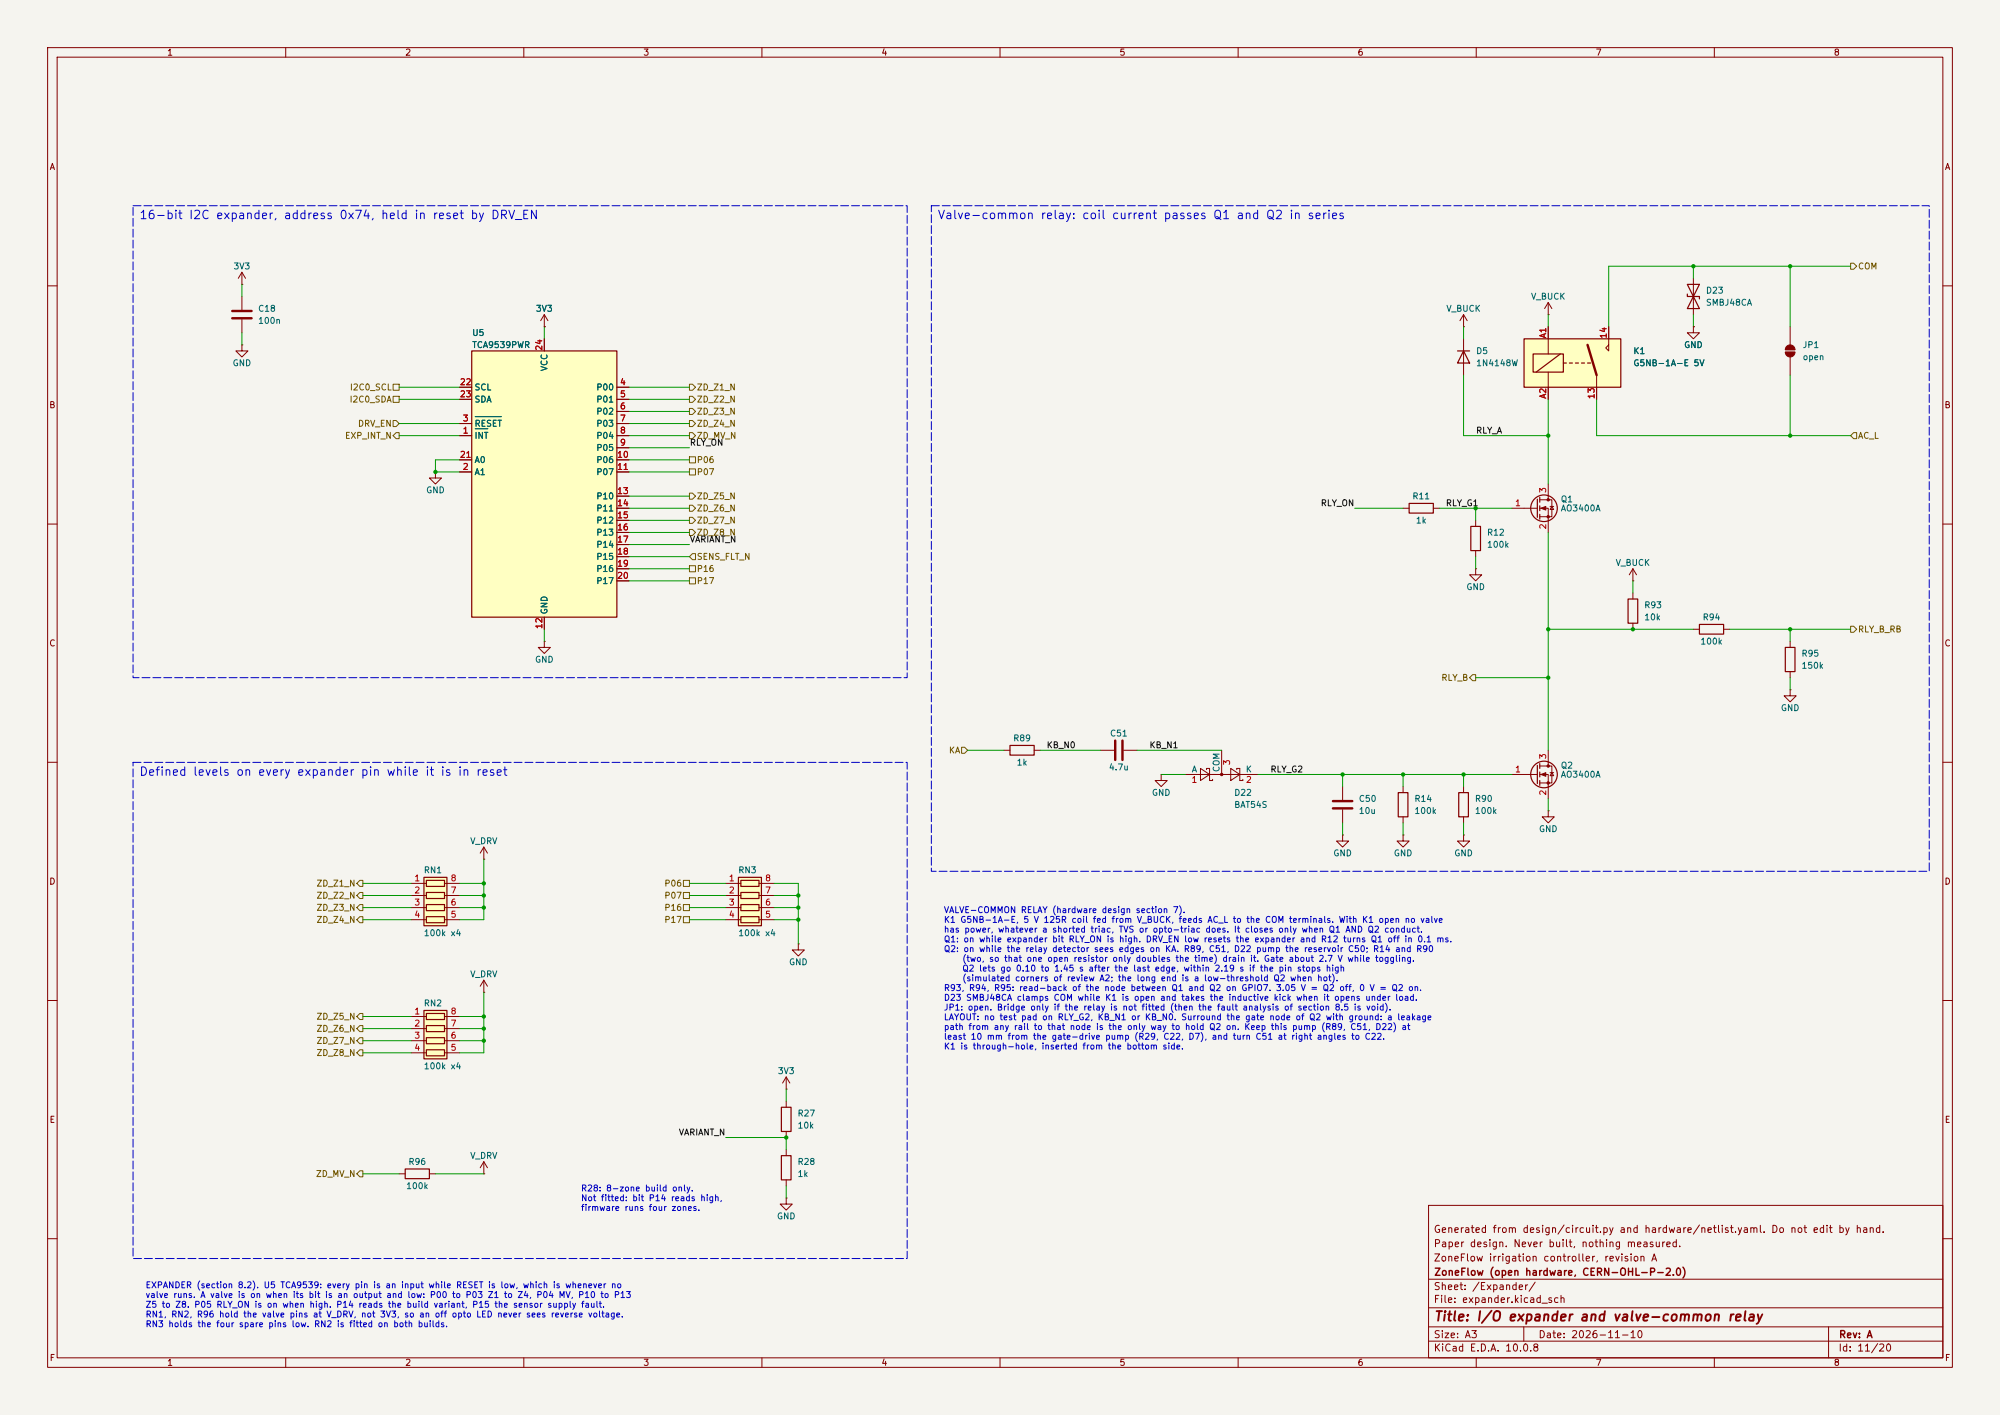
[picture p267: page 11]

(two, so that one open resistor only doubles the time) drain it. Gate about 2.7 V while toggling. Q2 lets go 0.10 to 1.45 s after the last edge, within 2.19 s if the pin stops high

(simulated corners of review A2; the long end is a low-threshold Q2 when hot).
R93, R94, R95: read-back of the node between Q1 and Q2 on GPIO7. 3.05 V = Q2 off, 0 V = Q2 on. D23 SMBJ48CA clamps COM while K1 is open and takes the inductive kick when it opens under load. JP1: open. Bridge only if the relay is not fitted (then the fault analysis of section 8.5 is void). LAYOUT: no test pad on RLY_G2, KB_N1 or KB_N0. Surround the gate node of Q2 with ground: a leakage

path from any rail to that node is the only way to hold Q2 on. Keep this pump (R89, C51, D22) at
least 10 mm from the gate-drive pump (R29, C22, D7), and turn C51 at right angles to C22. K1 is through-hole, inserted from the bottom side.

Generated from design/circuit.py and hardware/netlist.yaml. Do not edit by hand.
Paper design. Never built, nothing measured.
ZoneFlow irrigation controller, revision A
ZoneFlow (open hardware, CERN-OHL-P-2.0)
Sheet: /Expander/
File: expander.kicad_sch
Title: I/O expander and valve-common relay

EXPANDER (section 8.2). U5 TCA9539: every pin is an input while RESET is low, which is whenever no
valve runs. A valve is on when its bit is an output and low: P00 to P03 Z1 to Z4, P04 MV, P10 to P13

AB

C

D

AB

C

### D Date: 2026-11-10

## Title: 24 VAC output channel

File: channel.kicad_sch

### Sheet: /Z1/

## ZoneFlow (open hardware, CERN-OHL-P-2.0)

ZoneFlow irrigation controller, revision A

Paper design. Never built, nothing measured.

Generated from design/circuit.py and hardware/netlist.yaml. Do not edit by hand. R104

1k R101
150R
V_DRV | 1
2 | 4

6 U101 MOC3023S R102
680R

V_DRV D102

yel-grn | D101
SMBJ48CA C101
10n 100V A1 | 1 A2 | 2
G3 | Q101
T810-600B

F101 PTC 1.1A 60V R105

47R 150V R103

100R 150V ZD_N

ISNS OUT T2

LEDA | OGTG OLA | SNB Drive: opto LED and indicator | 4-ZONE BUILD: instances Z5 to Z8 are not fitted

(KiCad variant "4-zone"). Z1 to Z4 and MV always are. Power stage: triac in the return leg of the valve

OUTPUT CHANNEL (hardware design section 6). Nine instances: Z1 to Z8 and MV. The valve sits between a COM terminal and OUT. Current returns through PTC F1, the triac and the shared shunt (ISNS) to GND. The gate is fired from T2 through opto-triac U1 and R3, so gate current has the polarity of T2: quadrants I and III, which every triac supports. Q1 T810-600B-TR, 8 A, three-quadrant, DPAK. Pin 1 A1 (T1) to ISNS, pin 2 and tab A2 (T2), pin 3 gate. The tab is net T2: give it its own copper island of 2 cm2 or more (section 6.7). U1 MOC3023, random phase. LED current 7.1 mA worst case, 12 mA typical; it needs 5.6 mA at -20 C. R1 150R sets the opto LED current. R2 680R gives the indicator LED 1.6 mA. R3 100R limits the opto-triac to 0.45 A at the 45 V peak. R4 1k holds the gate at T1. R5 + C1 47R and 10 nF snubber. F1 PTC 1.1 A hold, 40 A maximum. D1 SMBJ48CA clamps at 77 V. D2 lights when the expander pin is low AND V_DRV is on: the real drive state. ZD_N is low to turn the output on. V_DRV is removed by the fail-safe circuit. | Q101
T810-600B A1 | 1 A2 | 2
G3 | C101
10n 100V

AB

C

D

AB

C

### D Date: 2026-11-10

## Title: 24 VAC output channel

File: channel.kicad_sch

### Sheet: /Z2/

## ZoneFlow (open hardware, CERN-OHL-P-2.0)

ZoneFlow irrigation controller, revision A

Paper design. Never built, nothing measured.

Generated from design/circuit.py and hardware/netlist.yaml. Do not edit by hand. R204

1k 1

2 | 4

6 U201 MOC3023S R201
150R

R202
680R
V_DRV | V_DRV D202
yel-grn | D201
SMBJ48CA A1 | 1 A2 | 2
G3 | Q201
T810-600B
C201

10n 100V R203

100R 150V

F201 PTC 1.1A 60V R205

47R 150V ZD_N

ISNS OUT T2

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

OUTPUT CHANNEL (hardware design section 6). Nine instances: Z1 to Z8 and MV. The valve sits between a COM terminal and OUT. Current returns through PTC F1, the triac and the shared shunt (ISNS) to GND. The gate is fired from T2 through opto-triac U1 and R3, so gate current has the polarity of T2: quadrants I and III, which every triac supports. Q1 T810-600B-TR, 8 A, three-quadrant, DPAK. Pin 1 A1 (T1) to ISNS, pin 2 and tab A2 (T2), pin 3 gate. The tab is net T2: give it its own copper island of 2 cm2 or more (section 6.7). U1 MOC3023, random phase. LED current 7.1 mA worst case, 12 mA typical; it needs 5.6 mA at -20 C. R1 150R sets the opto LED current. R2 680R gives the indicator LED 1.6 mA. R3 100R limits the opto-triac to 0.45 A at the 45 V peak. R4 1k holds the gate at T1. R5 + C1 47R and 10 nF snubber. F1 PTC 1.1 A hold, 40 A maximum. D1 SMBJ48CA clamps at 77 V. D2 lights when the expander pin is low AND V_DRV is on: the real drive state. ZD_N is low to turn the output on. V_DRV is removed by the fail-safe circuit. | C201

10n 100V Q201

T810-600B A1 | 1 A2 | 2

G3

AB

C

D

AB

C

### D Date: 2026-11-10

## Title: 24 VAC output channel

File: channel.kicad_sch

### Sheet: /Z3/

## ZoneFlow (open hardware, CERN-OHL-P-2.0)

ZoneFlow irrigation controller, revision A

Paper design. Never built, nothing measured.

Generated from design/circuit.py and hardware/netlist.yaml. Do not edit by hand. R304

1k V_DRV | V_DRV R302

680R

R301
150R

1

2 | 4

6 U301 MOC3023S D302

yel-grn | D301
SMBJ48CA C301
10n 100V A1 | 1 A2 | 2
G3 | Q301
T810-600B

F301 PTC 1.1A 60V R303

100R 150V | R305
47R 150V ZD_N
ISNS OUT T2 OGT LEDA | G OLA | SNB

4-ZONE BUILD: instances Z5 to Z8 are not fitted

(KiCad variant "4-zone"). Z1 to Z4 and MV always are. Drive: opto LED and indicator | Power stage: triac in the return leg of the valve
OUTPUT CHANNEL (hardware design section 6). Nine instances: Z1 to Z8 and MV. The valve sits between a COM terminal and OUT. Current returns through PTC F1, the triac and the shared shunt (ISNS) to GND. The gate is fired from T2 through opto-triac U1 and R3, so gate current has the polarity of T2: quadrants I and III, which every triac supports. Q1 T810-600B-TR, 8 A, three-quadrant, DPAK. Pin 1 A1 (T1) to ISNS, pin 2 and tab A2 (T2), pin 3 gate. The tab is net T2: give it its own copper island of 2 cm2 or more (section 6.7). U1 MOC3023, random phase. LED current 7.1 mA worst case, 12 mA typical; it needs 5.6 mA at -20 C. R1 150R sets the opto LED current. R2 680R gives the indicator LED 1.6 mA. R3 100R limits the opto-triac to 0.45 A at the 45 V peak. R4 1k holds the gate at T1. R5 + C1 47R and 10 nF snubber. F1 PTC 1.1 A hold, 40 A maximum. D1 SMBJ48CA clamps at 77 V. D2 lights when the expander pin is low AND V_DRV is on: the real drive state. ZD_N is low to turn the output on. V_DRV is removed by the fail-safe circuit. | Q301
T810-600B A1 | 1 A2 | 2
G3 | C301
10n 100V

AB

C

D

AB

C

### D Date: 2026-11-10

## Title: 24 VAC output channel

File: channel.kicad_sch

### Sheet: /Z4/

## ZoneFlow (open hardware, CERN-OHL-P-2.0)

ZoneFlow irrigation controller, revision A

Paper design. Never built, nothing measured.

Generated from design/circuit.py and hardware/netlist.yaml. Do not edit by hand. R404

1k R401
150R
V_DRV | 1
2 | 4

6 U401 MOC3023S R402
680R

V_DRV D402

yel-grn | D401
SMBJ48CA A1 | 1 A2 | 2
G3 | Q401
T810-600B
C401

10n 100V R403

100R 150V | R405 47R 150V

F401 PTC 1.1A 60V ZD_N
ISNS OUT T2
LEDA | OGTG OLA | SNB Drive: opto LED and indicator | 4-ZONE BUILD: instances Z5 to Z8 are not fitted

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

OUTPUT CHANNEL (hardware design section 6). Nine instances: Z1 to Z8 and MV. The valve sits between a COM terminal and OUT. Current returns through PTC F1, the triac and the shared shunt (ISNS) to GND. The gate is fired from T2 through opto-triac U1 and R3, so gate current has the polarity of T2: quadrants I and III, which every triac supports. Q1 T810-600B-TR, 8 A, three-quadrant, DPAK. Pin 1 A1 (T1) to ISNS, pin 2 and tab A2 (T2), pin 3 gate. The tab is net T2: give it its own copper island of 2 cm2 or more (section 6.7). U1 MOC3023, random phase. LED current 7.1 mA worst case, 12 mA typical; it needs 5.6 mA at -20 C. R1 150R sets the opto LED current. R2 680R gives the indicator LED 1.6 mA. R3 100R limits the opto-triac to 0.45 A at the 45 V peak. R4 1k holds the gate at T1. R5 + C1 47R and 10 nF snubber. F1 PTC 1.1 A hold, 40 A maximum. D1 SMBJ48CA clamps at 77 V. D2 lights when the expander pin is low AND V_DRV is on: the real drive state. ZD_N is low to turn the output on. V_DRV is removed by the fail-safe circuit. | C401

10n 100V Q401

T810-600B A1 | 1 A2 | 2

G3

AB

C

D

AB

C

### D Date: 2026-11-10

## Title: 24 VAC output channel

File: channel.kicad_sch

### Sheet: /Z5/

## ZoneFlow (open hardware, CERN-OHL-P-2.0)

ZoneFlow irrigation controller, revision A

Paper design. Never built, nothing measured.

Generated from design/circuit.py and hardware/netlist.yaml. Do not edit by hand. R504

1k 1

2 | 4

6 U501 MOC3023S R501
150R

R502
680R
V_DRV | V_DRV D502
yel-grn | D501
SMBJ48CA C501
10n 100V A1 | 1 A2 | 2
G3 | Q501
T810-600B

F501 PTC 1.1A 60V R503

100R 150V | R505
47R 150V ZD_N

ISNS OUT T2

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

OUTPUT CHANNEL (hardware design section 6). Nine instances: Z1 to Z8 and MV. The valve sits between a COM terminal and OUT. Current returns through PTC F1, the triac and the shared shunt (ISNS) to GND. The gate is fired from T2 through opto-triac U1 and R3, so gate current has the polarity of T2: quadrants I and III, which every triac supports. Q1 T810-600B-TR, 8 A, three-quadrant, DPAK. Pin 1 A1 (T1) to ISNS, pin 2 and tab A2 (T2), pin 3 gate. The tab is net T2: give it its own copper island of 2 cm2 or more (section 6.7). U1 MOC3023, random phase. LED current 7.1 mA worst case, 12 mA typical; it needs 5.6 mA at -20 C. R1 150R sets the opto LED current. R2 680R gives the indicator LED 1.6 mA. R3 100R limits the opto-triac to 0.45 A at the 45 V peak. R4 1k holds the gate at T1. R5 + C1 47R and 10 nF snubber. F1 PTC 1.1 A hold, 40 A maximum. D1 SMBJ48CA clamps at 77 V. D2 lights when the expander pin is low AND V_DRV is on: the real drive state. ZD_N is low to turn the output on. V_DRV is removed by the fail-safe circuit. | Q501
T810-600B A1 | 1 A2 | 2
G3 | C501
10n 100V

AB

C

D

AB

C

### D Date: 2026-11-10

## Title: 24 VAC output channel

File: channel.kicad_sch

### Sheet: /Z6/

## ZoneFlow (open hardware, CERN-OHL-P-2.0)

ZoneFlow irrigation controller, revision A

Paper design. Never built, nothing measured.

Generated from design/circuit.py and hardware/netlist.yaml. Do not edit by hand. R604

1k V_DRV | V_DRV R602

680R

R601
150R

1

2 | 4

6 U601 MOC3023S D602

yel-grn | D601
SMBJ48CA A1 | 1 A2 | 2
G3 | Q601
T810-600B
C601

10n 100V R603

100R 150V

F601 PTC 1.1A 60V R605

47R 150V ZD_N

ISNS OUT T2 OGT LEDA | G OLA | SNB

4-ZONE BUILD: instances Z5 to Z8 are not fitted

(KiCad variant "4-zone"). Z1 to Z4 and MV always are. Drive: opto LED and indicator | Power stage: triac in the return leg of the valve
OUTPUT CHANNEL (hardware design section 6). Nine instances: Z1 to Z8 and MV. The valve sits between a COM terminal and OUT. Current returns through PTC F1, the triac and the shared shunt (ISNS) to GND. The gate is fired from T2 through opto-triac U1 and R3, so gate current has the polarity of T2: quadrants I and III, which every triac supports. Q1 T810-600B-TR, 8 A, three-quadrant, DPAK. Pin 1 A1 (T1) to ISNS, pin 2 and tab A2 (T2), pin 3 gate. The tab is net T2: give it its own copper island of 2 cm2 or more (section 6.7). U1 MOC3023, random phase. LED current 7.1 mA worst case, 12 mA typical; it needs 5.6 mA at -20 C. R1 150R sets the opto LED current. R2 680R gives the indicator LED 1.6 mA. R3 100R limits the opto-triac to 0.45 A at the 45 V peak. R4 1k holds the gate at T1. R5 + C1 47R and 10 nF snubber. F1 PTC 1.1 A hold, 40 A maximum. D1 SMBJ48CA clamps at 77 V. D2 lights when the expander pin is low AND V_DRV is on: the real drive state. ZD_N is low to turn the output on. V_DRV is removed by the fail-safe circuit. | C601

10n 100V Q601

T810-600B A1 | 1 A2 | 2

G3

AB

C

D

AB

C

### D Date: 2026-11-10

## Title: 24 VAC output channel

File: channel.kicad_sch

### Sheet: /Z7/

## ZoneFlow (open hardware, CERN-OHL-P-2.0)

ZoneFlow irrigation controller, revision A

Paper design. Never built, nothing measured.

Generated from design/circuit.py and hardware/netlist.yaml. Do not edit by hand. R704

1k R701
150R
V_DRV | 1
2 | 4

6 U701 MOC3023S R702
680R

V_DRV D702

yel-grn | D701
SMBJ48CA C701
10n 100V A1 | 1 A2 | 2
G3 | Q701
T810-600B

F701 PTC 1.1A 60V R705

47R 150V R703

100R 150V ZD_N

ISNS OUT T2

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

OUTPUT CHANNEL (hardware design section 6). Nine instances: Z1 to Z8 and MV. The valve sits between a COM terminal and OUT. Current returns through PTC F1, the triac and the shared shunt (ISNS) to GND. The gate is fired from T2 through opto-triac U1 and R3, so gate current has the polarity of T2: quadrants I and III, which every triac supports. Q1 T810-600B-TR, 8 A, three-quadrant, DPAK. Pin 1 A1 (T1) to ISNS, pin 2 and tab A2 (T2), pin 3 gate. The tab is net T2: give it its own copper island of 2 cm2 or more (section 6.7). U1 MOC3023, random phase. LED current 7.1 mA worst case, 12 mA typical; it needs 5.6 mA at -20 C. R1 150R sets the opto LED current. R2 680R gives the indicator LED 1.6 mA. R3 100R limits the opto-triac to 0.45 A at the 45 V peak. R4 1k holds the gate at T1. R5 + C1 47R and 10 nF snubber. F1 PTC 1.1 A hold, 40 A maximum. D1 SMBJ48CA clamps at 77 V. D2 lights when the expander pin is low AND V_DRV is on: the real drive state. ZD_N is low to turn the output on. V_DRV is removed by the fail-safe circuit. | Q701
T810-600B A1 | 1 A2 | 2
G3 | C701
10n 100V

AB

C

D

AB

C

### D Date: 2026-11-10

## Title: 24 VAC output channel

File: channel.kicad_sch

### Sheet: /Z8/

## ZoneFlow (open hardware, CERN-OHL-P-2.0)

ZoneFlow irrigation controller, revision A

Paper design. Never built, nothing measured.

Generated from design/circuit.py and hardware/netlist.yaml. Do not edit by hand. R804

1k 1

2 | 4

6 U801 MOC3023S R801
150R

R802
680R
V_DRV | V_DRV D802
yel-grn | D801
SMBJ48CA A1 | 1 A2 | 2
G3 | Q801
T810-600B
C801

10n 100V R803

100R 150V

F801 PTC 1.1A 60V R805

47R 150V ZD_N

ISNS OUT T2

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

OUTPUT CHANNEL (hardware design section 6). Nine instances: Z1 to Z8 and MV. The valve sits between a COM terminal and OUT. Current returns through PTC F1, the triac and the shared shunt (ISNS) to GND. The gate is fired from T2 through opto-triac U1 and R3, so gate current has the polarity of T2: quadrants I and III, which every triac supports. Q1 T810-600B-TR, 8 A, three-quadrant, DPAK. Pin 1 A1 (T1) to ISNS, pin 2 and tab A2 (T2), pin 3 gate. The tab is net T2: give it its own copper island of 2 cm2 or more (section 6.7). U1 MOC3023, random phase. LED current 7.1 mA worst case, 12 mA typical; it needs 5.6 mA at -20 C. R1 150R sets the opto LED current. R2 680R gives the indicator LED 1.6 mA. R3 100R limits the opto-triac to 0.45 A at the 45 V peak. R4 1k holds the gate at T1. R5 + C1 47R and 10 nF snubber. F1 PTC 1.1 A hold, 40 A maximum. D1 SMBJ48CA clamps at 77 V. D2 lights when the expander pin is low AND V_DRV is on: the real drive state. ZD_N is low to turn the output on. V_DRV is removed by the fail-safe circuit. | C801

10n 100V Q801

T810-600B A1 | 1 A2 | 2

G3

AB

C

D

AB

C

### D Date: 2026-11-10

## Title: 24 VAC output channel

File: channel.kicad_sch

### Sheet: /MV/
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
