syntroniks/zoneflow/hardware/toolchain-test/output/toolchain_test-schematic.pdf

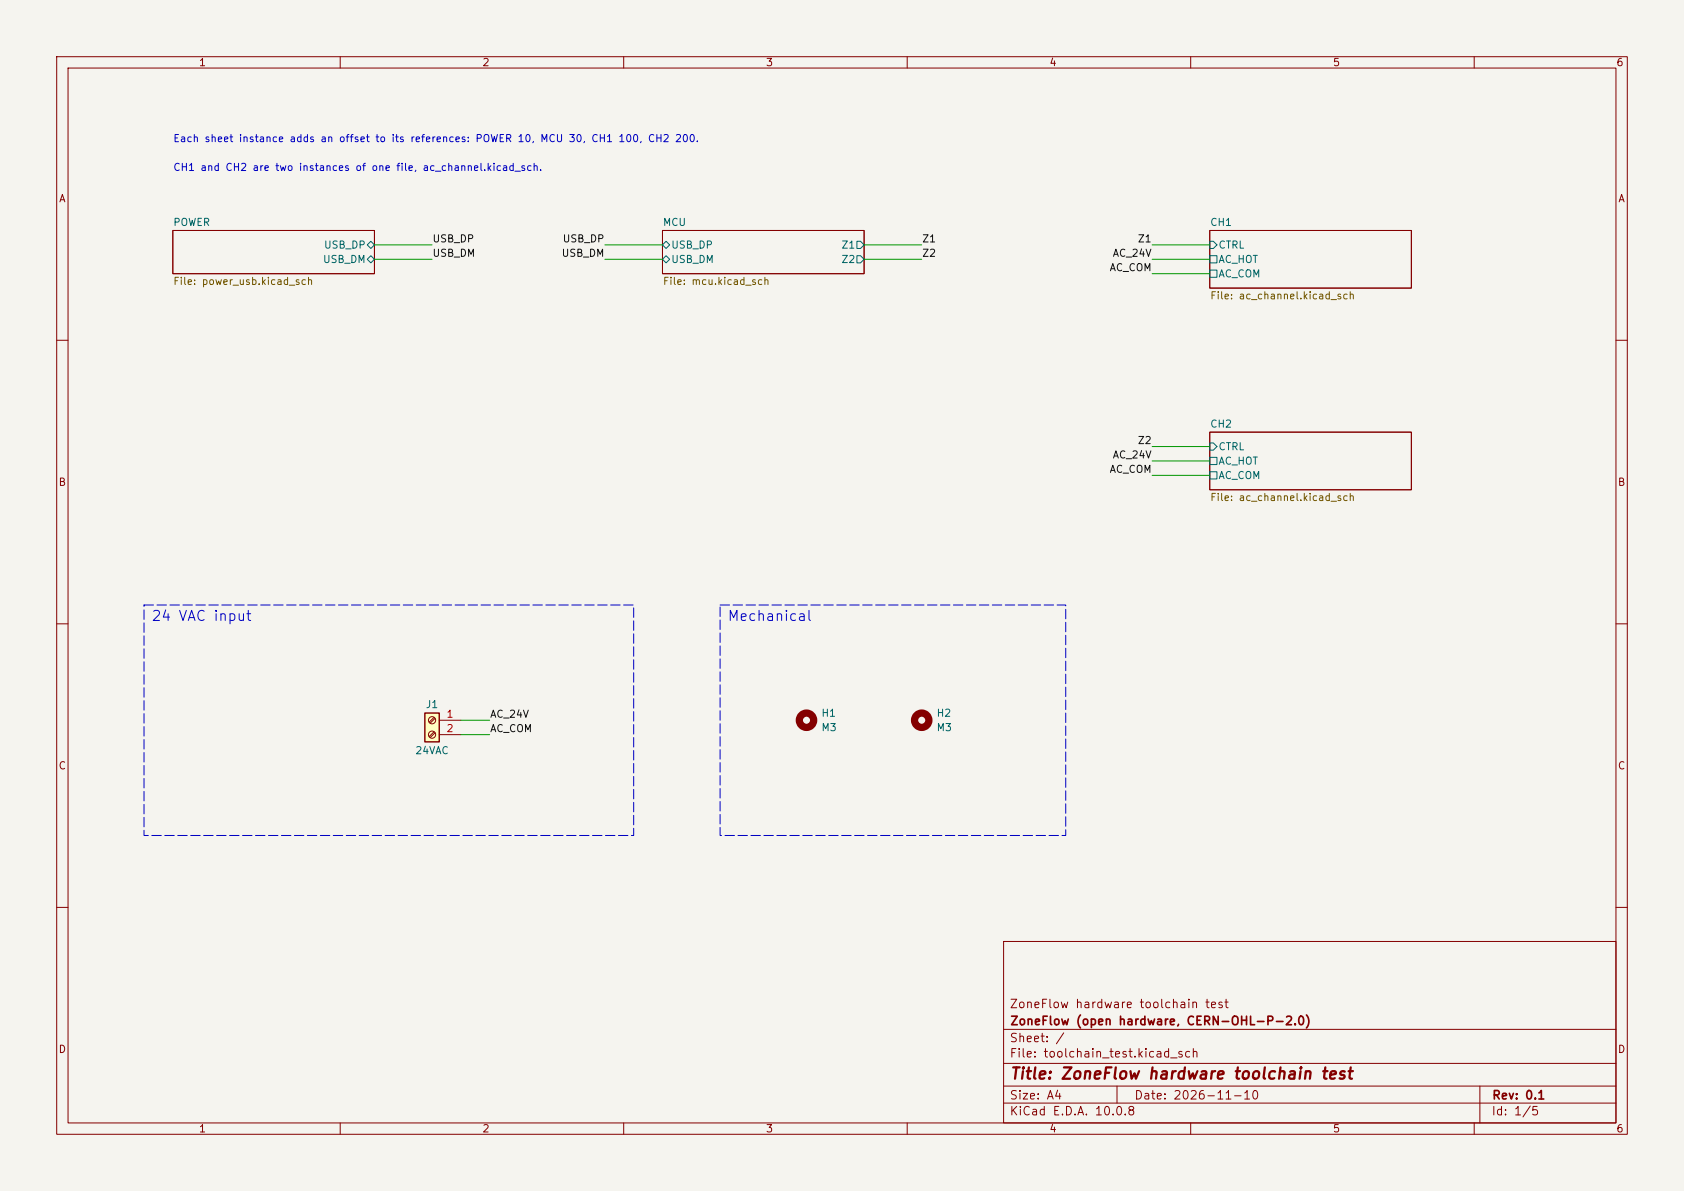
[picture p268: page 1]

Z2 Mechanical CH1 and CH2 are two instances of one file, ac_channel.kicad_sch. Each sheet instance adds an offset to its references: POWER 10, MCU 30, CH1 100, CH2 200. 24 VAC input

ZoneFlow hardware toolchain test
ZoneFlow (open hardware, CERN-OHL-P-2.0)
Sheet: /
File: toolchain_test.kicad_sch
Title: ZoneFlow hardware toolchain test

Size: A4 | Rev: 0.1
KiCad E.D.A. 10.0.8 | Id: 1/5

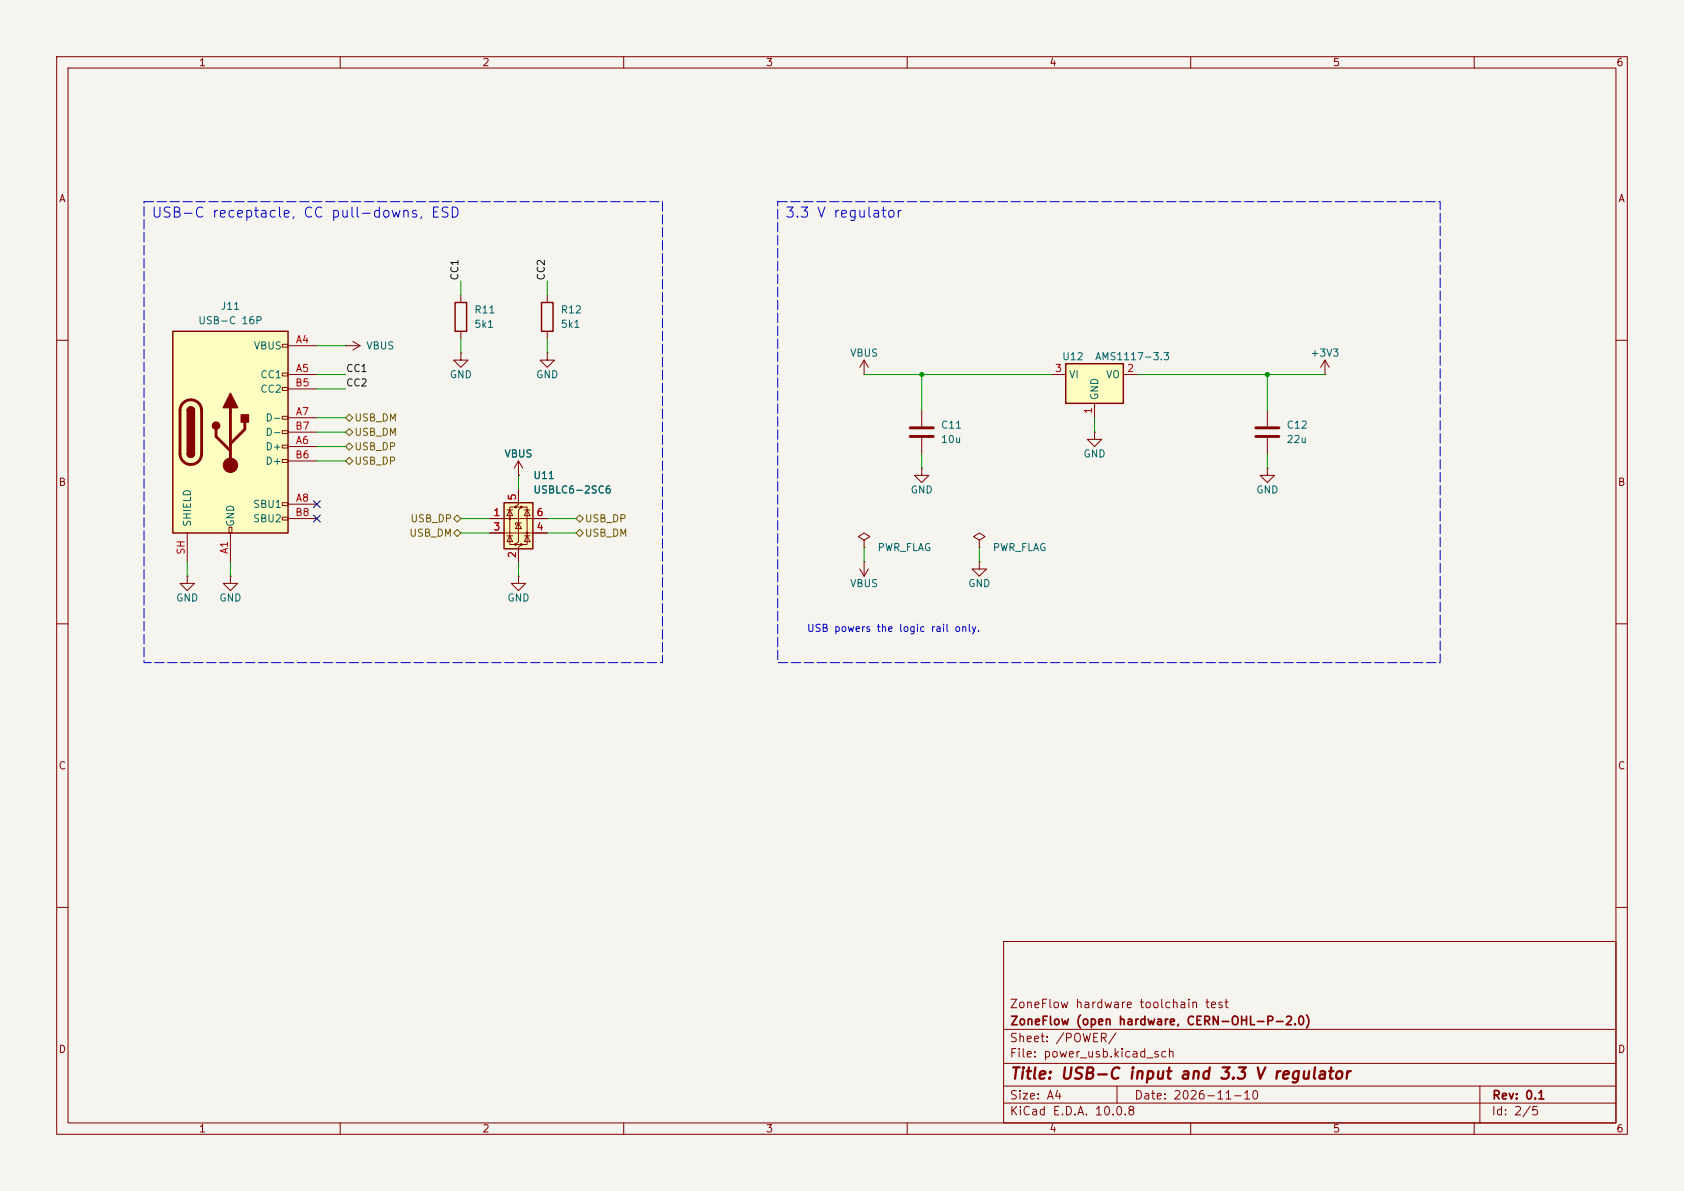
[picture p269: page 2]

ZoneFlow hardware toolchain test
ZoneFlow (open hardware, CERN-OHL-P-2.0)
Sheet: /POWER/
File: power_usb.kicad_sch
Title: USB-C input and 3.3 V regulator

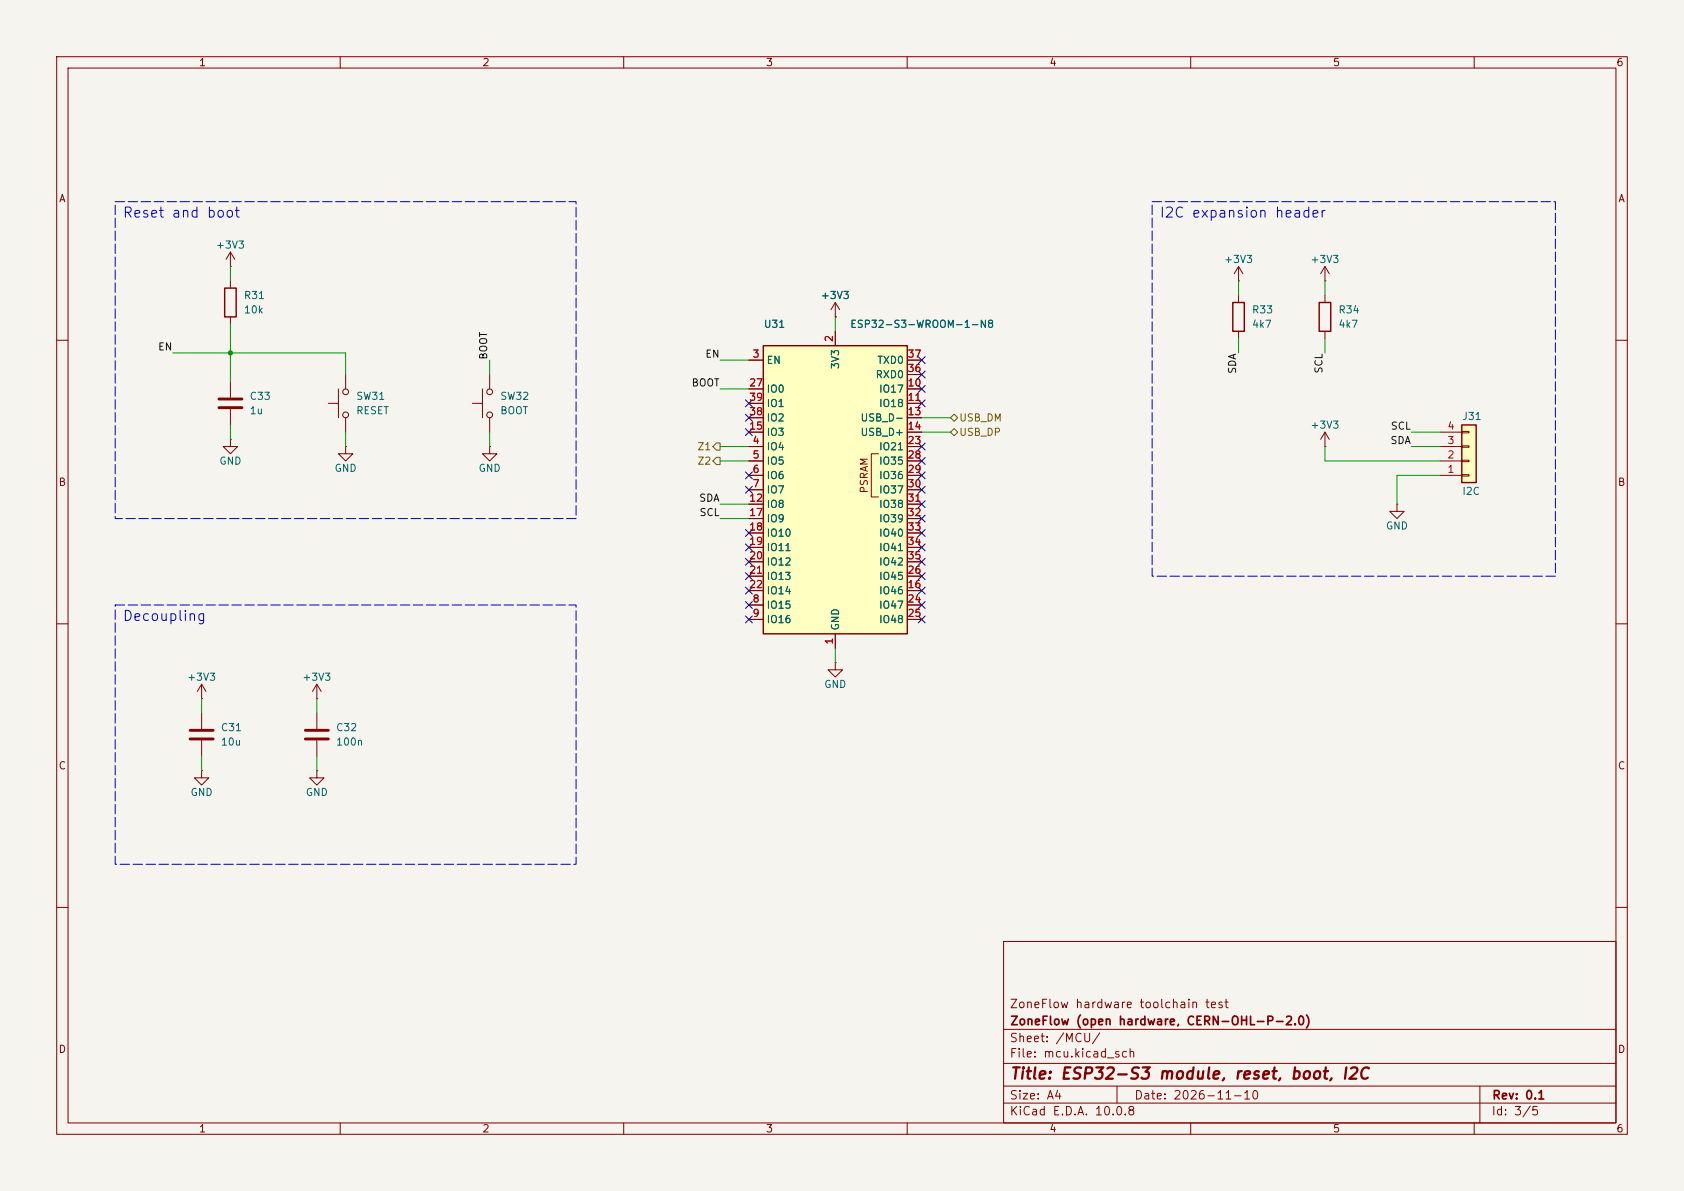
[picture p270: page 3]

ZoneFlow (open hardware, CERN-OHL-P-2.0)
Sheet: /MCU/
File: mcu.kicad_sch
Title: ESP32-S3 module, reset, boot, I2C

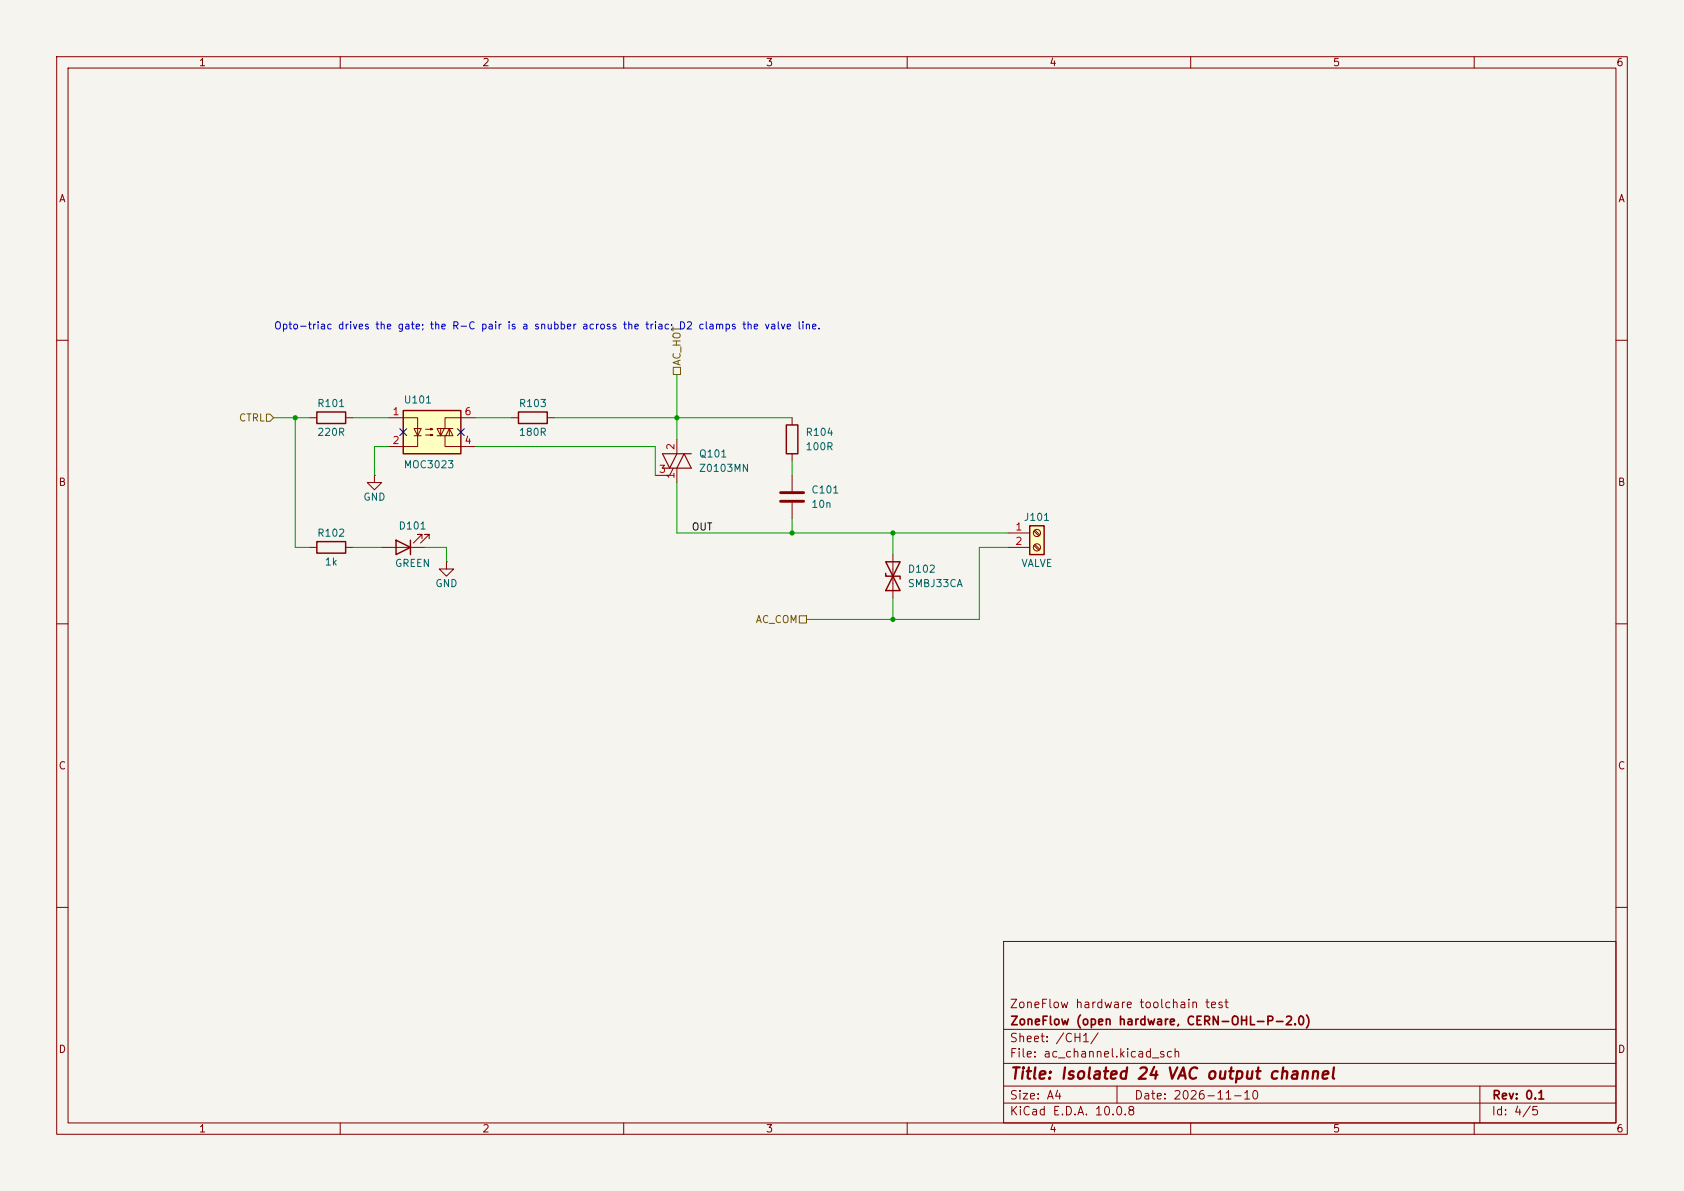
[picture p271: page 4]

ZoneFlow hardware toolchain test
ZoneFlow (open hardware, CERN-OHL-P-2.0)
Sheet: /CH1/
File: ac_channel.kicad_sch
Title: Isolated 24 VAC output channel

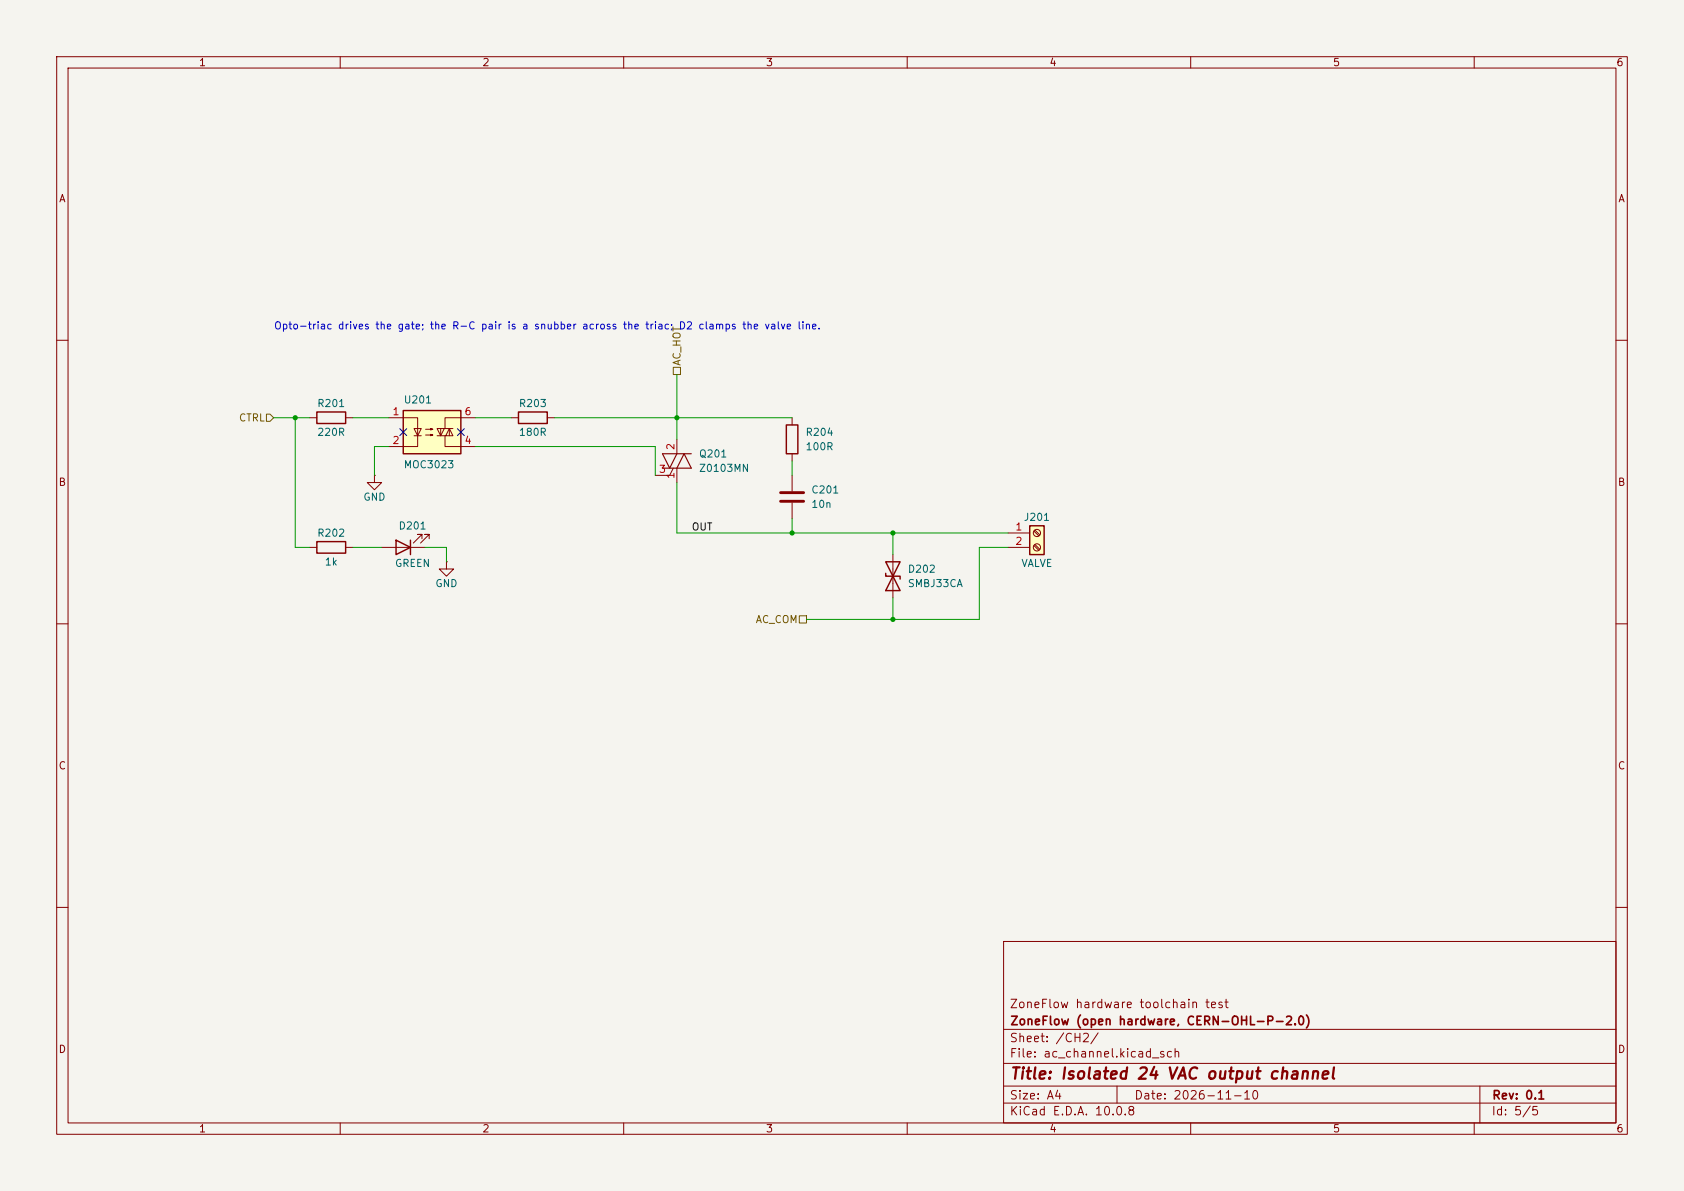
[picture p272: page 5]

ZoneFlow hardware toolchain test
ZoneFlow (open hardware, CERN-OHL-P-2.0)
Sheet: /CH2/
File: ac_channel.kicad_sch
Title: Isolated 24 VAC output channel
