syntroniks/zoneflow/hardware/zoneflow-a/output/zoneflow-a-assembly-top.pdf

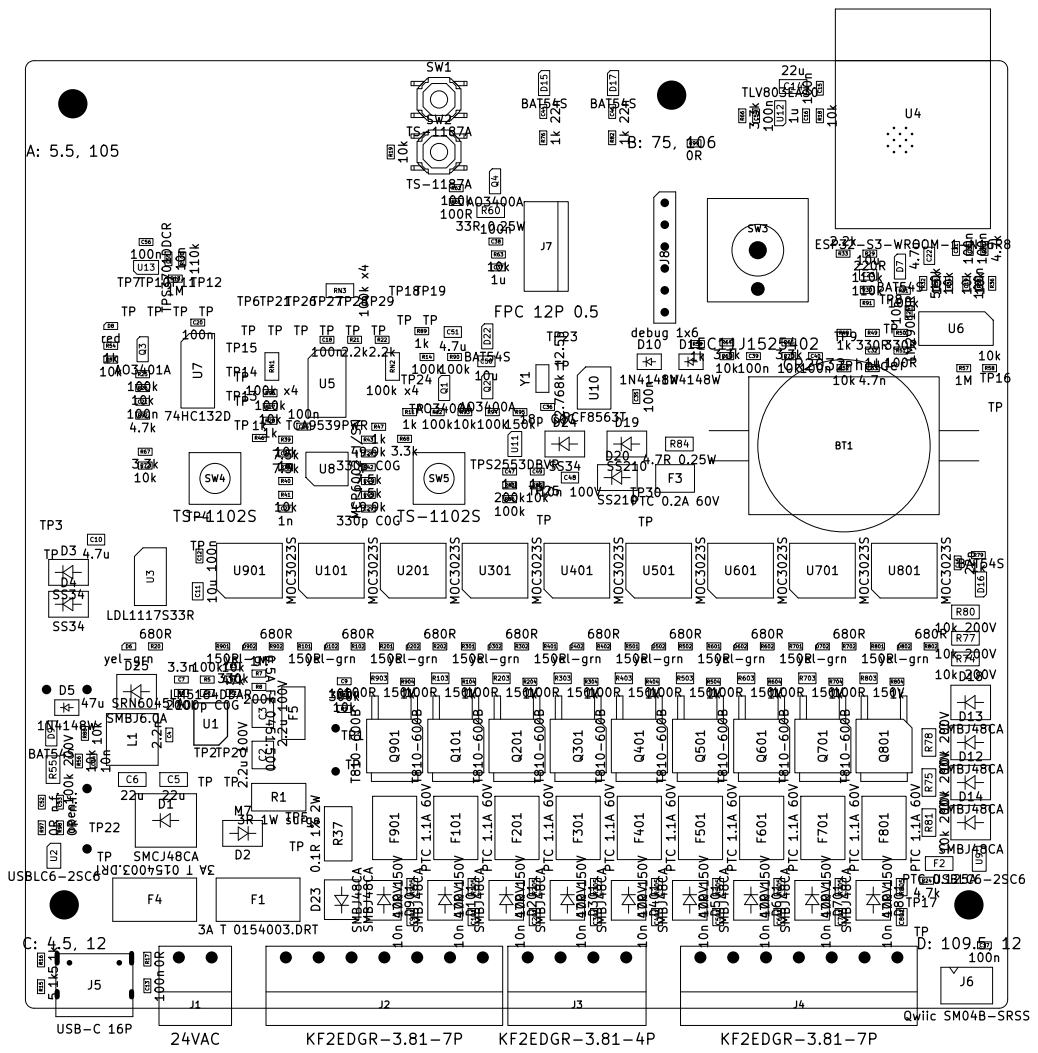
[picture p273: page 1]
