syntroniks/zoneflow/hardware/zoneflow-a/output/zoneflow-a-assembly-bottom.pdf

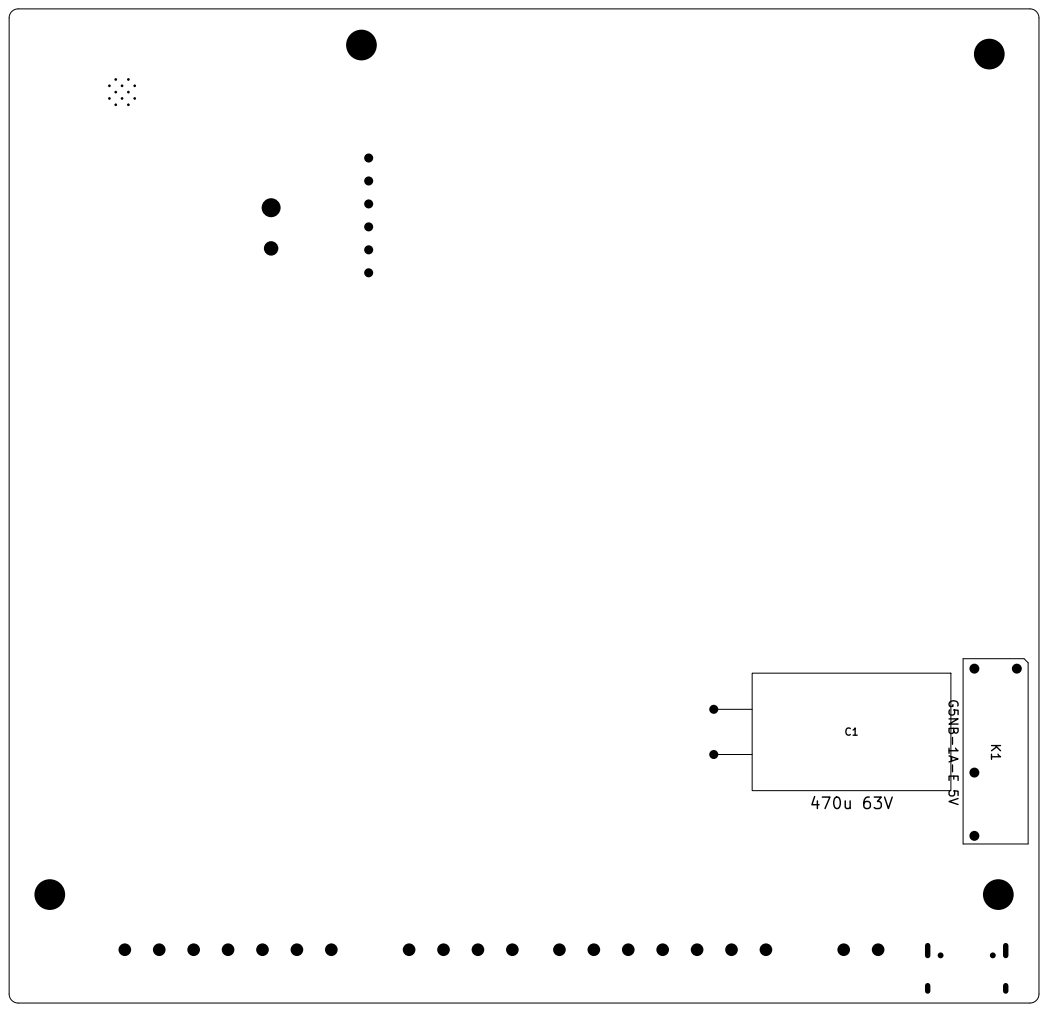
[picture p274: page 1]
