syntroniks/zoneflow/enclosure/output/drill-template.pdf

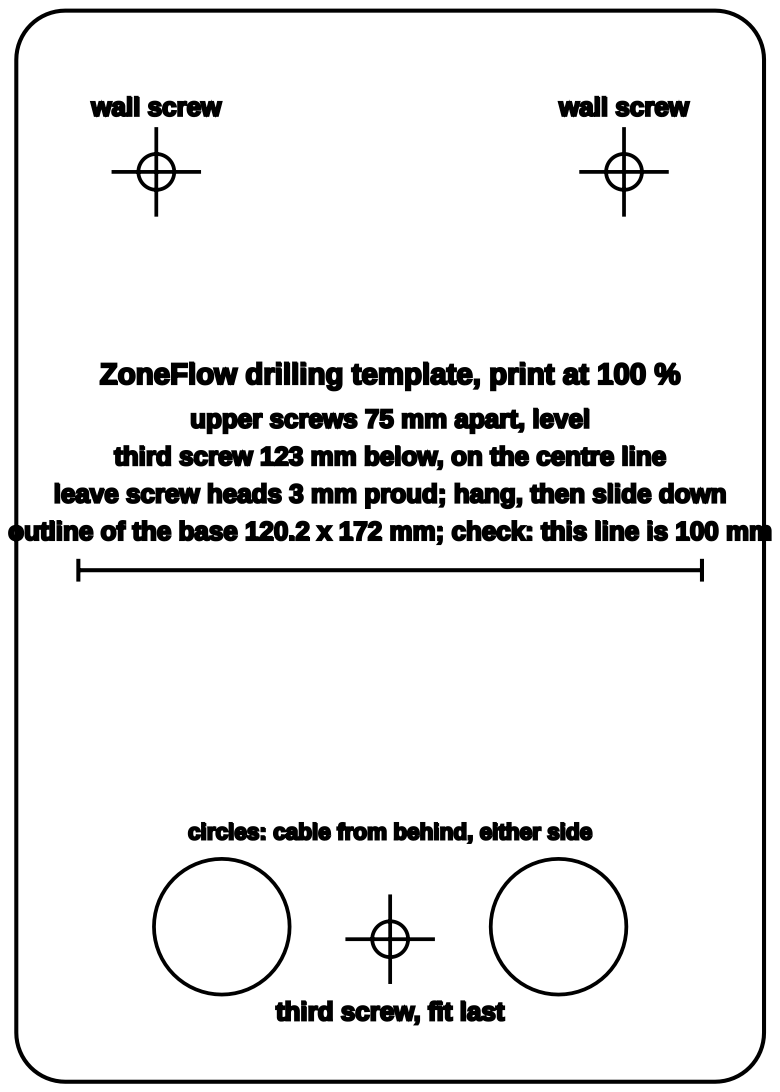
[picture p275: page 1]
