syntroniks/zoneflow/hardware/zoneflow-a/zoneflow-a.kicad_pcb

## KiCad design hardware/zoneflow-a/zoneflow-a.kicad_pcb (2026-11-12)

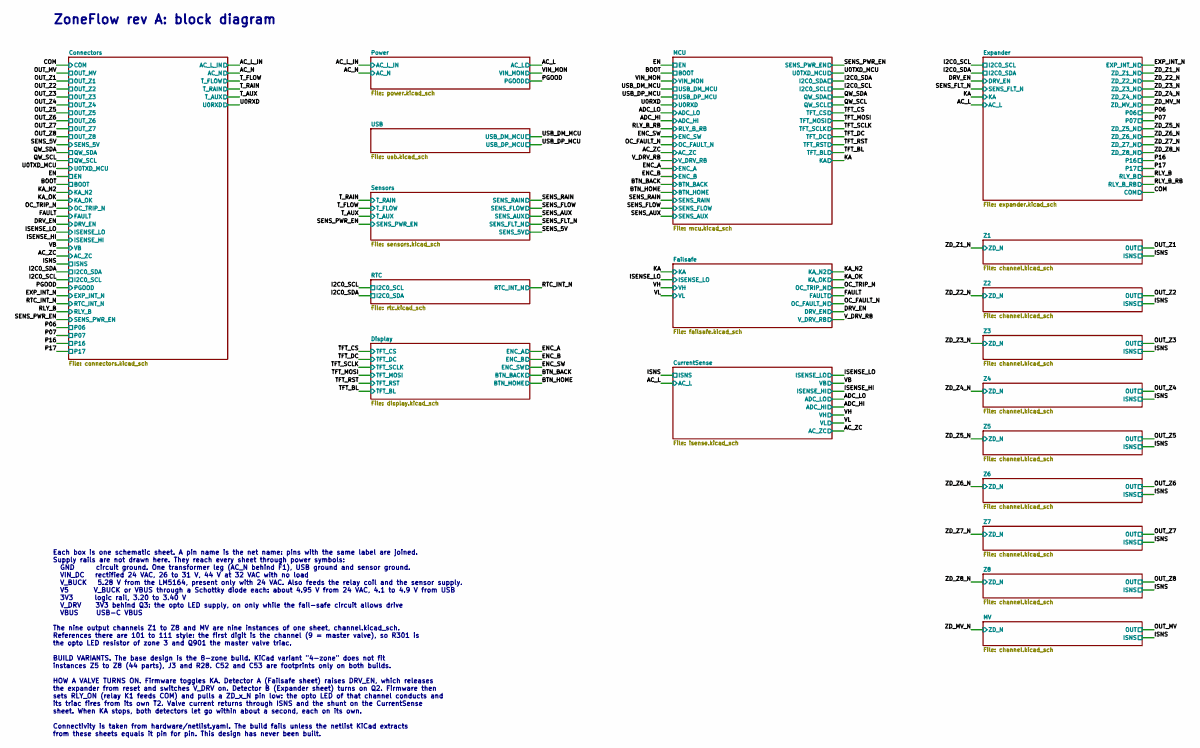
[picture p276: schematic zoneflow-a.kicad_sch, ZoneFlow irrigation controller, revision A]

Notes on the sheet:
ZoneFlow rev A: block diagram
Each box is one schematic sheet. A pin name is the net name: pins with the same label are joined. Supply rails are not drawn here. They reach every sheet through power symbols: GND circuit ground. One transformer leg (AC_N behind F1), USB ground and sensor ground. VIN_DC rectified 24 VAC, 26 to 31 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

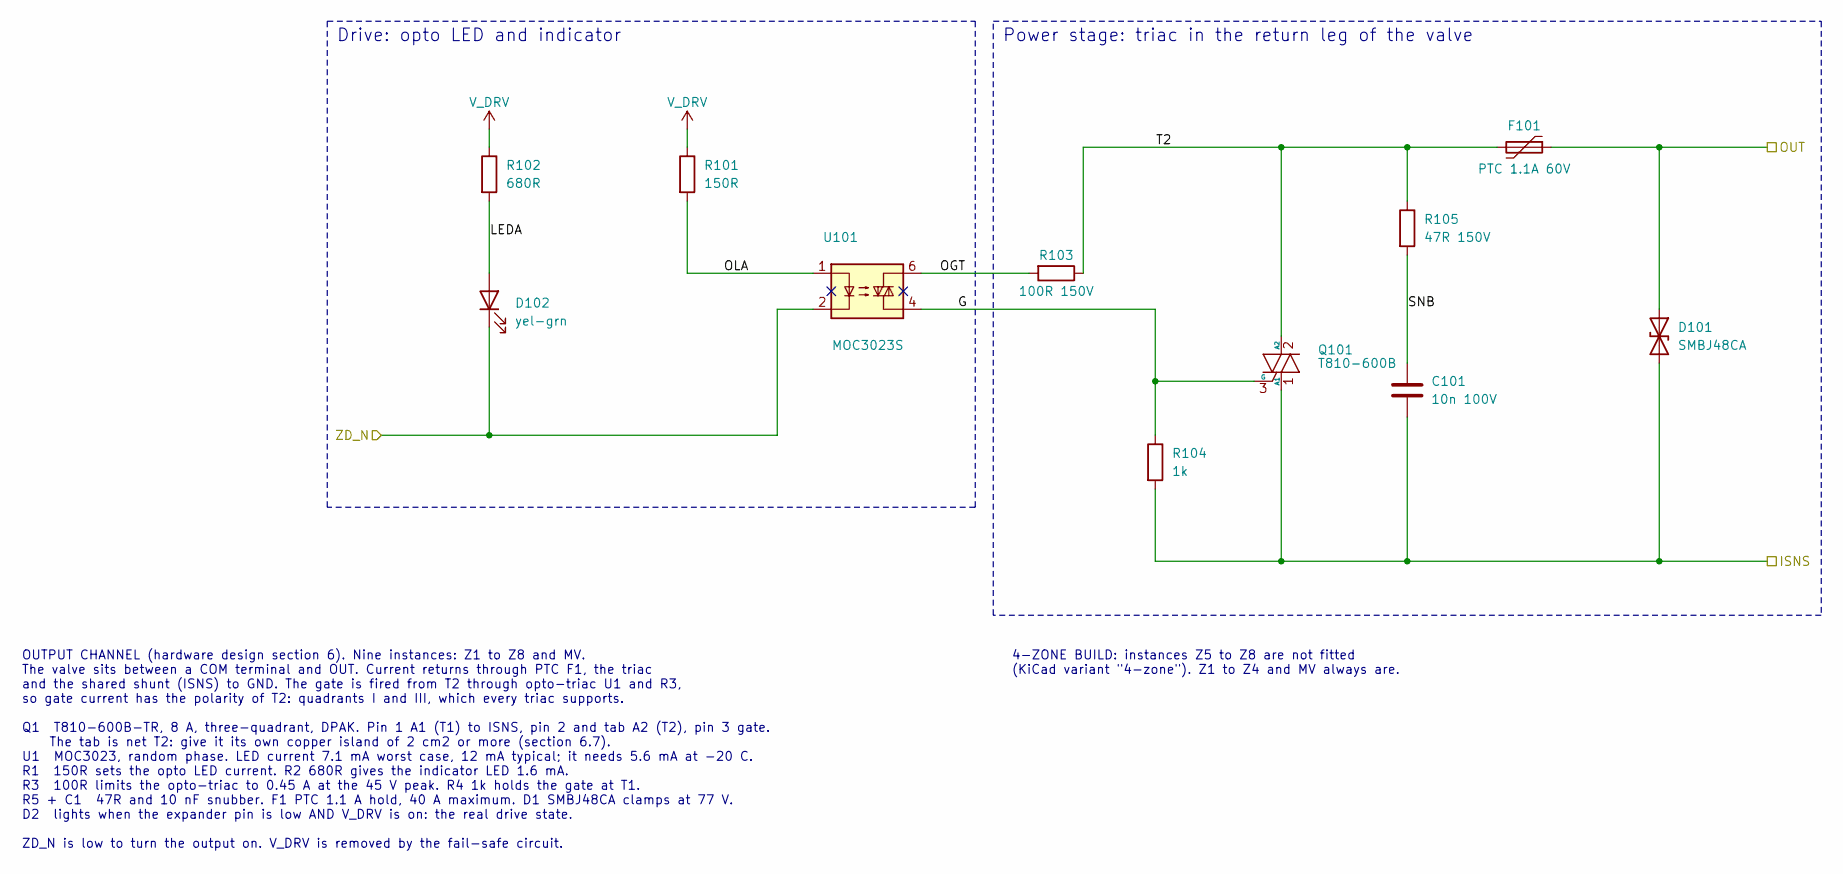
[picture p277: schematic channel.kicad_sch, 24 VAC output channel]

Parts:
C101: 10n 100V; C_0805_2012Metric; MPN CL21B103KCANNNC; LCSC C18741
D101: SMBJ48CA; D_SMB; MPN SMBJ48CA; LCSC C151264
D102: yel-grn; LED_0603_1608Metric; MPN LTST-C190KGKT; LCSC C125094
F101: PTC 1.1A 60V; Fuse_2920_7451Metric; MPN BSMD2920-100-60V; LCSC C3020148
Q101: T810-600B; TO-252-2; MPN T810-600B-TR; LCSC C155588
R101: 150R; R_0603_1608Metric; MPN 0603WAF1500T5E; LCSC C22808
R102: 680R; R_0603_1608Metric; MPN 0603WAF6800T5E; LCSC C23228
R103: 100R 150V; R_0805_2012Metric; MPN 0805W8F1000T5E; LCSC C17408
R104: 1k; R_0603_1608Metric; MPN 0603WAF1001T5E; LCSC C21190
R105: 47R 150V; R_0805_2012Metric; MPN 0805W8F470JT5E; LCSC C17714
U101: MOC3023S; SMDIP-6_onsemi_646BY; MPN MOC3023SR2M; LCSC C40701

Connections:
/ISNS: C101.2, D101.2 (A2), Q101.1 (A1), R104.2; also elsewhere on the board
/OUT_Z1: D101.1 (A1), F101.1; also elsewhere on the board
/Z1/G: Q101.3 (G), R104.1, U101.4
/Z1/LEDA: D102.2 (A), R102.2
/Z1/OGT: R103.2, U101.6
/Z1/OLA: R101.2, U101.1
/Z1/SNB: C101.1, R105.2
/Z1/T2: F101.2, Q101.2 (A2), R103.1, R105.1
/ZD_Z1_N: D102.1 (K), U101.2; also elsewhere on the board
V_DRV: R101.1, R102.1; also elsewhere on the board

Parts of its further copies:
C201, C301, C401, C501, C601, C701, C801, C901: 10n 100V; C_0805_2012Metric; MPN CL21B103KCANNNC; LCSC C18741
D201, D301, D401, D501, D601, D701, D801, D901: SMBJ48CA; D_SMB; MPN SMBJ48CA; LCSC C151264
D202, D302, D402, D502, D602, D702, D802, D902: yel-grn; LED_0603_1608Metric; MPN LTST-C190KGKT; LCSC C125094
F201, F301, F401, F501, F601, F701, F801, F901: PTC 1.1A 60V; Fuse_2920_7451Metric; MPN BSMD2920-100-60V; LCSC C3020148
Q201, Q301, Q401, Q501, Q601, Q701, Q801, Q901: T810-600B; TO-252-2; MPN T810-600B-TR; LCSC C155588
R201, R301, R401, R501, R601, R701, R801, R901: 150R; R_0603_1608Metric; MPN 0603WAF1500T5E; LCSC C22808
R202, R302, R402, R502, R602, R702, R802, R902: 680R; R_0603_1608Metric; MPN 0603WAF6800T5E; LCSC C23228
R203, R303, R403, R503, R603, R703, R803, R903: 100R 150V; R_0805_2012Metric; MPN 0805W8F1000T5E; LCSC C17408
R204, R304, R404, R504, R604, R704, R804, R904: 1k; R_0603_1608Metric; MPN 0603WAF1001T5E; LCSC C21190
R205, R305, R405, R505, R605, R705, R805, R905: 47R 150V; R_0805_2012Metric; MPN 0805W8F470JT5E; LCSC C17714
U201, U301, U401, U501, U601, U701, U801, U901: MOC3023S; SMDIP-6_onsemi_646BY; MPN MOC3023SR2M; LCSC C40701

Connections of its further copies:
/ISNS: C201.2, C301.2, C401.2, C501.2, C601.2, C701.2, C801.2, C901.2, D201.2 (A2), D301.2 (A2), D401.2 (A2), D501.2 (A2), D601.2 (A2), D701.2 (A2), D801.2 (A2), D901.2 (A2), Q201.1 (A1), Q301.1 (A1), Q401.1 (A1), Q501.1 (A1), Q601.1 (A1), Q701.1 (A1), Q801.1 (A1), Q901.1 (A1), R204.2, R304.2, R404.2, R504.2, R604.2, R704.2, R804.2, R904.2; also elsewhere on the board
/MV/G: Q901.3 (G), R904.1, U901.4
/MV/LEDA: D902.2 (A), R902.2
/MV/OGT: R903.2, U901.6
/MV/OLA: R901.2, U901.1
/MV/SNB: C901.1, R905.2
/MV/T2: F901.2, Q901.2 (A2), R903.1, R905.1
/OUT_MV: D901.1 (A1), F901.1; also elsewhere on the board
/OUT_Z2: D201.1 (A1), F201.1; also elsewhere on the board
/OUT_Z3: D301.1 (A1), F301.1; also elsewhere on the board
/OUT_Z4: D401.1 (A1), F401.1; also elsewhere on the board
/OUT_Z5: D501.1 (A1), F501.1; also elsewhere on the board
/OUT_Z6: D601.1 (A1), F601.1; also elsewhere on the board
/OUT_Z7: D701.1 (A1), F701.1; also elsewhere on the board
/OUT_Z8: D801.1 (A1), F801.1; also elsewhere on the board
/Z2/G: Q201.3 (G), R204.1, U201.4
/Z2/LEDA: D202.2 (A), R202.2
/Z2/OGT: R203.2, U201.6
/Z2/OLA: R201.2, U201.1
/Z2/SNB: C201.1, R205.2
/Z2/T2: F201.2, Q201.2 (A2), R203.1, R205.1
/Z3/G: Q301.3 (G), R304.1, U301.4
/Z3/LEDA: D302.2 (A), R302.2
/Z3/OGT: R303.2, U301.6
/Z3/OLA: R301.2, U301.1
/Z3/SNB: C301.1, R305.2
/Z3/T2: F301.2, Q301.2 (A2), R303.1, R305.1
/Z4/G: Q401.3 (G), R404.1, U401.4
/Z4/LEDA: D402.2 (A), R402.2
/Z4/OGT: R403.2, U401.6
/Z4/OLA: R401.2, U401.1
/Z4/SNB: C401.1, R405.2
/Z4/T2: F401.2, Q401.2 (A2), R403.1, R405.1
/Z5/G: Q501.3 (G), R504.1, U501.4
/Z5/LEDA: D502.2 (A), R502.2
/Z5/OGT: R503.2, U501.6
/Z5/OLA: R501.2, U501.1
/Z5/SNB: C501.1, R505.2
/Z5/T2: F501.2, Q501.2 (A2), R503.1, R505.1
/Z6/G: Q601.3 (G), R604.1, U601.4
/Z6/LEDA: D602.2 (A), R602.2
/Z6/OGT: R603.2, U601.6
/Z6/OLA: R601.2, U601.1
/Z6/SNB: C601.1, R605.2
/Z6/T2: F601.2, Q601.2 (A2), R603.1, R605.1
/Z7/G: Q701.3 (G), R704.1, U701.4
/Z7/LEDA: D702.2 (A), R702.2
/Z7/OGT: R703.2, U701.6
/Z7/OLA: R701.2, U701.1
/Z7/SNB: C701.1, R705.2
/Z7/T2: F701.2, Q701.2 (A2), R703.1, R705.1
/Z8/G: Q801.3 (G), R804.1, U801.4
/Z8/LEDA: D802.2 (A), R802.2
/Z8/OGT: R803.2, U801.6
/Z8/OLA: R801.2, U801.1
/Z8/SNB: C801.1, R805.2
/Z8/T2: F801.2, Q801.2 (A2), R803.1, R805.1
/ZD_MV_N: D902.1 (K), U901.2; also elsewhere on the board
/ZD_Z2_N: D202.1 (K), U201.2; also elsewhere on the board
/ZD_Z3_N: D302.1 (K), U301.2; also elsewhere on the board
/ZD_Z4_N: D402.1 (K), U401.2; also elsewhere on the board
/ZD_Z5_N: D502.1 (K), U501.2; also elsewhere on the board
/ZD_Z6_N: D602.1 (K), U601.2; also elsewhere on the board
/ZD_Z7_N: D702.1 (K), U701.2; also elsewhere on the board
/ZD_Z8_N: D802.1 (K), U801.2; also elsewhere on the board
V_DRV: R201.1, R202.1, R301.1, R302.1, R401.1, R402.1, R501.1, R502.1, R601.1, R602.1, R701.1, R702.1, R801.1, R802.1, R901.1, R902.1; also elsewhere on the board

Notes on the sheet:
OUTPUT CHANNEL (hardware design section 6). Nine instances: Z1 to Z8 and MV. The valve sits between a COM terminal and OUT. Current returns through PTC F1, the triac and the shared shunt (ISNS) to GND. The gate is fired from T2 through opto-triac U1 and R3, so gate current has the polarity of T2: q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
Drive: opto LED and indicator
4-ZONE BUILD: instances Z5 to Z8 are not fitted (KiCad variant "4-zone"). Z1 to Z4 and MV always are.
Power stage: triac in the return leg of the valve

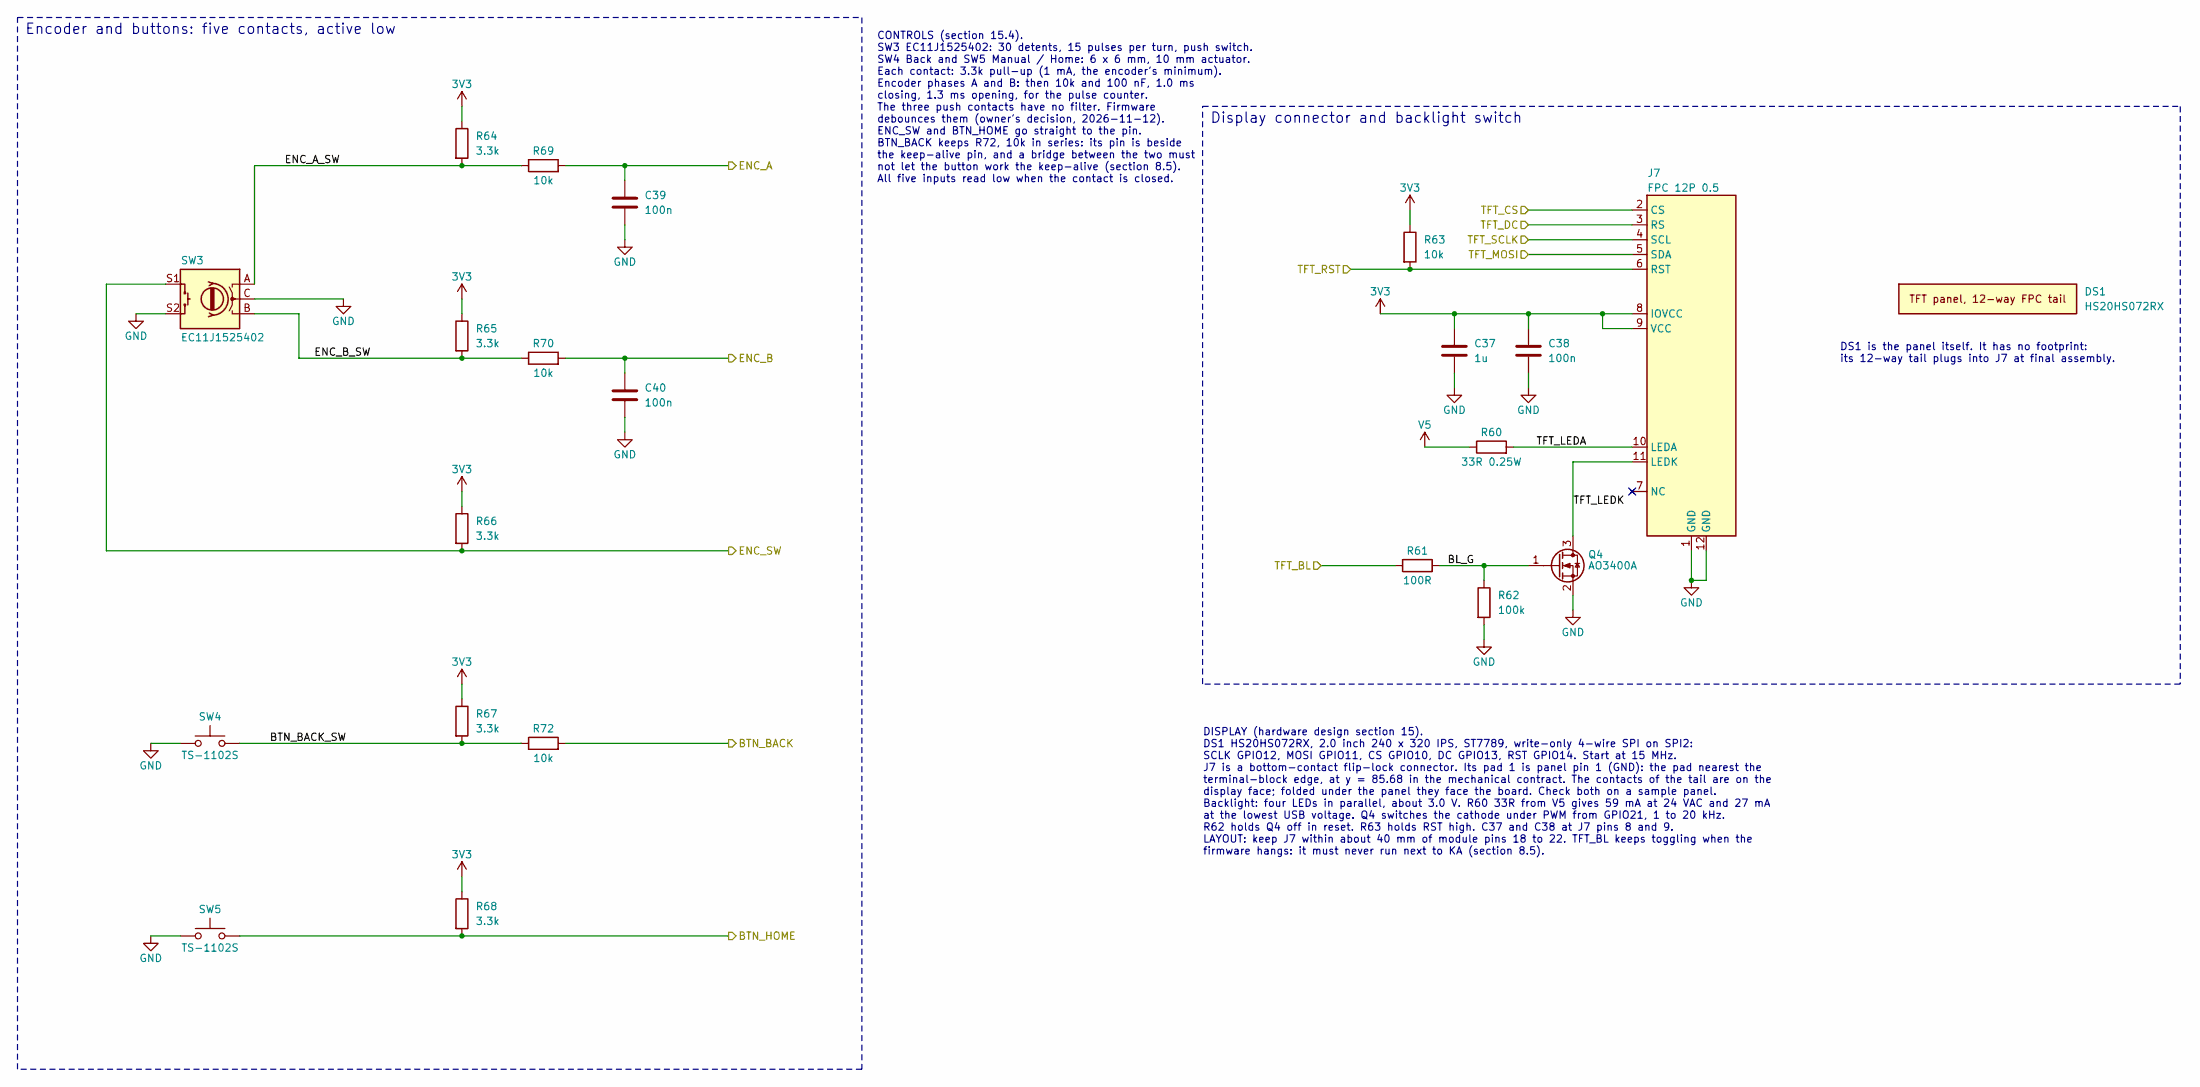
[picture p278: schematic display.kicad_sch, Display and controls]

Parts:
C37: 1u; C_0603_1608Metric; MPN CL10A105KB8NNNC; LCSC C15849
C38, C39, C40: 100n; C_0603_1608Metric; MPN CC0603KRX7R9BB104; LCSC C14663
DS1: HS20HS072RX; MPN HS20HS072RX; LCSC C5329582
J7: FPC 12P 0.5; FPC_XUNPU_FPC-05F-12PH20; MPN FPC-05F-12PH20; LCSC C2856799
Q4: AO3400A; SOT-23; MPN AO3400A; LCSC C20917
R60: 33R 0.25W; R_1206_3216Metric; MPN 1206W4F330JT5E; LCSC C18005
R61: 100R; R_0603_1608Metric; MPN 0603WAF1000T5E; LCSC C22775
R62: 100k; R_0603_1608Metric; MPN 0603WAF1003T5E; LCSC C25803
R63, R69, R70, R72: 10k; R_0603_1608Metric; MPN 0603WAF1002T5E; LCSC C25804
R64, R65, R66, R67, R68: 3.3k; R_0603_1608Metric; MPN 0603WAF3301T5E; LCSC C22978
SW3: EC11J1525402; RotaryEncoder_Alps_EC11J15; MPN EC11J1525402; LCSC C209762
SW4, SW5: TS-1102S; SW_Push_XKB_TS-1102S; MPN TS-1102S-C-M-B; LCSC C381050

Connections:
3V3: C37.1, C38.1, J7.8 (IOVCC), J7.9 (VCC), R63.1, R64.1, R65.1, R66.1, R67.1, R68.1; also elsewhere on the board
/BTN_BACK: R72.2; also elsewhere on the board
/BTN_HOME: R68.2, SW5.1; also elsewhere on the board
/Display/BL_G: Q4.1 (G), R61.2, R62.1
/Display/BTN_BACK_SW: R67.2, R72.1, SW4.1
/Display/ENC_A_SW: R64.2, R69.1, SW3.A
/Display/ENC_B_SW: R65.2, R70.1, SW3.B
/Display/TFT_LEDA: J7.10 (LEDA), R60.2
/Display/TFT_LEDK: J7.11 (LEDK), Q4.3 (D)
/ENC_A: C39.1, R69.2; also elsewhere on the board
/ENC_B: C40.1, R70.2; also elsewhere on the board
/ENC_SW: R66.2, SW3.S1; also elsewhere on the board
/TFT_BL: R61.1; also elsewhere on the board
/TFT_CS: J7.2 (CS); also elsewhere on the board
/TFT_DC: J7.3 (RS); also elsewhere on the board
/TFT_MOSI: J7.5 (SDA); also elsewhere on the board
/TFT_RST: J7.6 (RST), R63.2; also elsewhere on the board
/TFT_SCLK: J7.4 (SCL); also elsewhere on the board
GND: C37.2, C38.2, C39.2, C40.2, J7.1 (GND), J7.12 (GND), Q4.2 (S), R62.2, SW3.C, SW3.S2, SW4.2, SW5.2; also elsewhere on the board
V5: R60.1; also elsewhere on the board

Notes on the sheet:
Display connector and backlight switch
DISPLAY (hardware design section 15). DS1 HS20HS072RX, 2.0 inch 240 x 320 IPS, ST7789, write-only 4-wire SPI on SPI2: SCLK GPIO12, MOSI GPIO11, CS GPIO10, DC GPIO13, RST GPIO14. Start at 15 MHz. J7 is a bottom-contact flip-lock connector. Its pad 1 is panel pin 1 (GND): the pad nearest the terminal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
Encoder and buttons: five contacts, active low
CONTROLS (section 15.4). SW3 EC11J1525402: 30 detents, 15 pulses per turn, push switch. SW4 Back and SW5 Manual / Home: 6 x 6 mm, 10 mm actuator. Each contact: 3.3k pull-up (1 mA, the encoder's minimum). Encoder phases A and B: then 10k and 100 nF, 1.0 ms closing, 1.3 ms opening, for the pulse coun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
DS1 is the panel itself. It has no footprint: its 12-way tail plugs into J7 at final assembly.

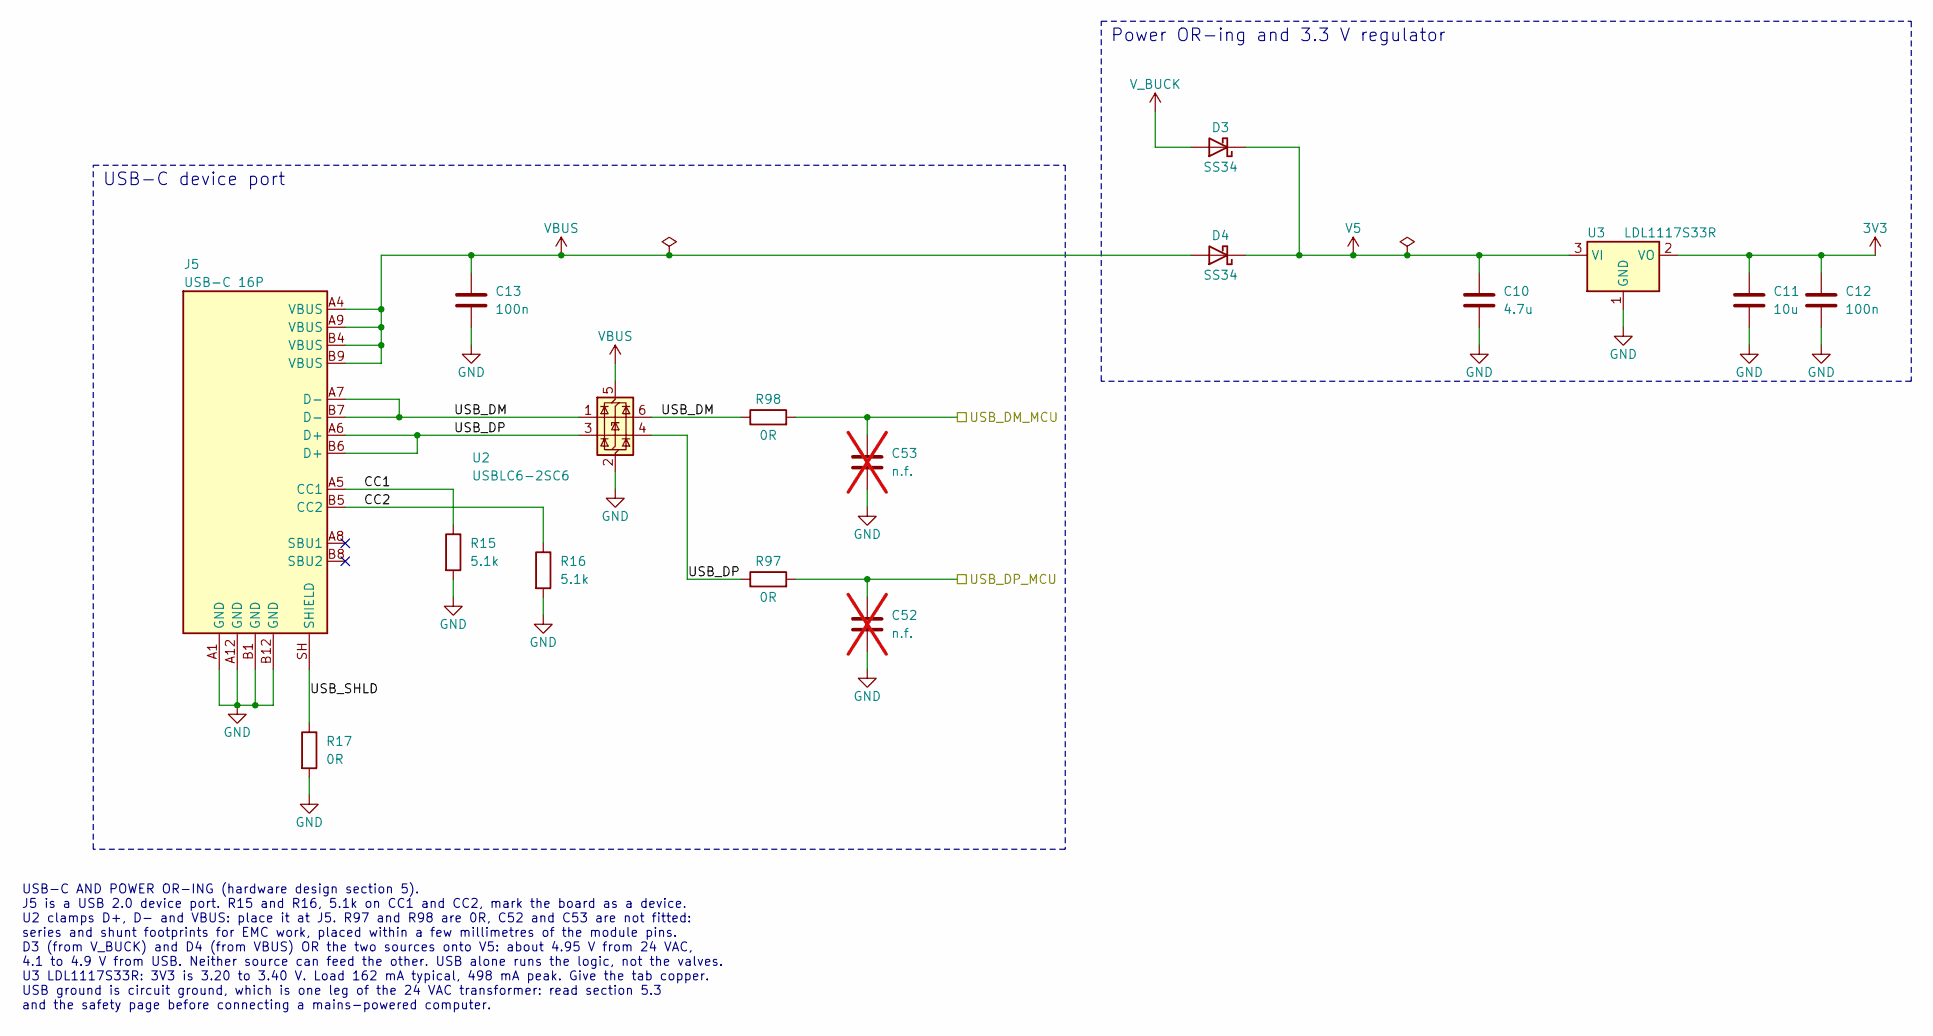
[picture p279: schematic usb.kicad_sch, USB-C and power OR-ing]

Parts:
C10: 4.7u; C_0805_2012Metric; MPN CL21A475KAQNNNE; LCSC C1779
C11: 10u; C_0805_2012Metric; MPN CL21A106KAYNNNE; LCSC C15850
C12, C13: 100n; C_0603_1608Metric; MPN CC0603KRX7R9BB104; LCSC C14663
C52, C53: n.f.; C_0603_1608Metric; not fitted
D3, D4: SS34; D_SMA; MPN SS34; LCSC C8678
J5: USB-C 16P; USB_C_Receptacle_HRO_TYPE-C-31-M-12; MPN TYPE-C-31-M-12; LCSC C165948
R15, R16: 5.1k; R_0603_1608Metric; MPN 0603WAF5101T5E; LCSC C23186
R17, R97, R98: 0R; R_0603_1608Metric; MPN 0603WAF0000T5E; LCSC C21189
U2: USBLC6-2SC6; SOT-23-6; MPN USBLC6-2SC6; LCSC C7519
U3: LDL1117S33R; SOT-223-3_TabPin2; MPN LDL1117S33R; LCSC C435835

Connections:
3V3: C11.1, C12.1, U3.2 (VO); also elsewhere on the board
/USB/CC1: J5.A5 (CC1), R15.1
/USB/CC2: J5.B5 (CC2), R16.1
/USB/USB_DM: J5.A7 (D-), J5.B7 (D-), R98.1, U2.1 (I/O1), U2.6 (I/O1)
/USB/USB_DP: J5.A6 (D+), J5.B6 (D+), R97.1, U2.3 (I/O2), U2.4 (I/O2)
/USB/USB_SHLD: J5.SH (SHIELD), R17.1
/USB_DM_MCU: C53.1, R98.2; also elsewhere on the board
/USB_DP_MCU: C52.1, R97.2; also elsewhere on the board
GND: C10.2, C11.2, C12.2, C13.2, C52.2, C53.2, J5.A1 (GND), J5.A12 (GND), J5.B1 (GND), J5.B12 (GND), R15.2, R16.2, R17.2, U2.2 (GND), U3.1 (GND); also elsewhere on the board
V5: C10.1, D3.1 (K), D4.1 (K), U3.3 (VI); also elsewhere on the board
VBUS: C13.1, D4.2 (A), J5.A4 (VBUS), J5.A9 (VBUS), J5.B4 (VBUS), J5.B9 (VBUS), U2.5 (VBUS)
V_BUCK: D3.2 (A); also elsewhere on the board

Notes on the sheet:
USB-C device port
Power OR-ing and 3.3 V regulator
USB-C AND POWER OR-ING (hardware design section 5). J5 is a USB 2.0 device port. R15 and R16, 5.1k on CC1 and CC2, mark the board as a device. U2 clamps D+, D- and VBUS: place it at J5. R97 and R98 are 0R, C52 and C53 are not fitted: series and shunt footprints for EMC work, placed within a few mil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

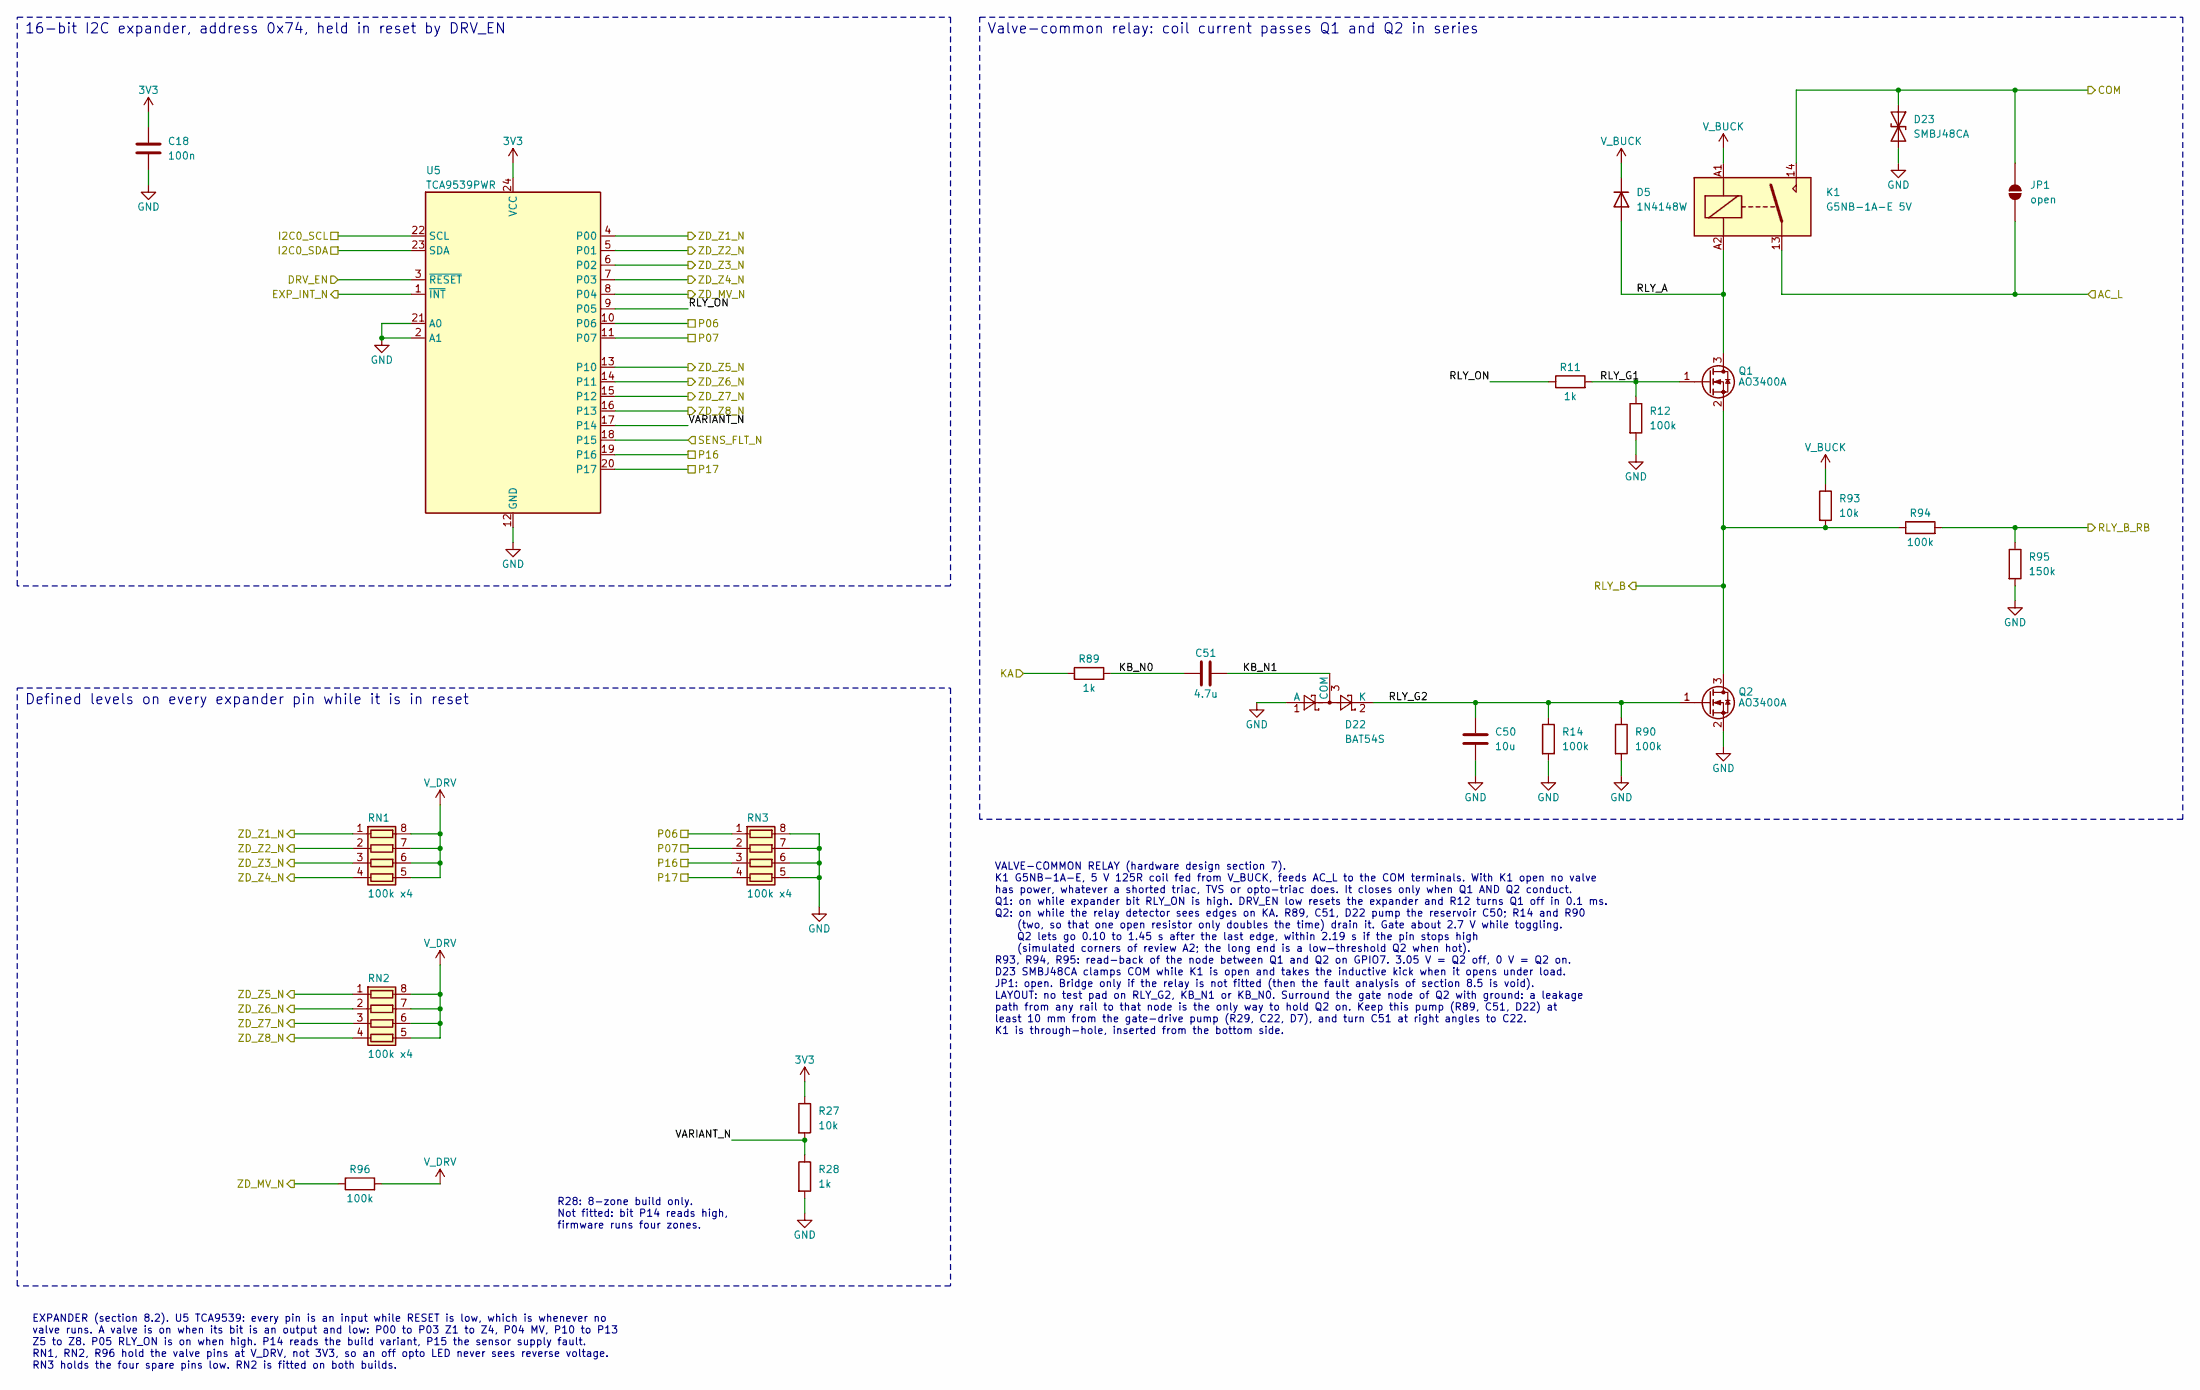
[picture p280: schematic expander.kicad_sch, I/O expander and valve-common relay]

Parts:
C18: 100n; C_0603_1608Metric; MPN CC0603KRX7R9BB104; LCSC C14663
C50: 10u; C_0805_2012Metric; MPN CL21A106KAYNNNE; LCSC C15850
C51: 4.7u; C_0805_2012Metric; MPN CL21A475KAQNNNE; LCSC C1779
D5: 1N4148W; D_SOD-123; MPN 1N4148W; LCSC C81598
D22: BAT54S; SOT-23; MPN BAT54S; LCSC C7420333
D23: SMBJ48CA; D_SMB; MPN SMBJ48CA; LCSC C151264
JP1: open; SolderJumper-2_P1.3mm_Open_RoundedPad1.0x1.5mm
K1: G5NB-1A-E 5V; Relay_SPST_Omron_G5NB; MPN G5NB-1A-E-DC5V; LCSC C48746
Q1, Q2: AO3400A; SOT-23; MPN AO3400A; LCSC C20917
R11, R28, R89: 1k; R_0603_1608Metric; MPN 0603WAF1001T5E; LCSC C21190
R12, R14, R90, R94, R96: 100k; R_0603_1608Metric; MPN 0603WAF1003T5E; LCSC C25803
R27, R93: 10k; R_0603_1608Metric; MPN 0603WAF1002T5E; LCSC C25804
R95: 150k; R_0603_1608Metric; MPN 0603WAF1503T5E; LCSC C22807
RN1, RN2, RN3: 100k x4; R_Array_Convex_4x0603; MPN 4D03WGJ0104T5E; LCSC C1996
U5: TCA9539PWR; TSSOP-24_4.4x7.8mm_P0.65mm; MPN TCA9539PWR; LCSC C131972

Connections:
3V3: C18.1, R27.1, U5.24 (VCC); also elsewhere on the board
/AC_L: JP1.1 (A), K1.13; also elsewhere on the board
/COM: D23.1 (A1), JP1.2 (B), K1.14; also elsewhere on the board
/DRV_EN: U5.3 (~RESET); also elsewhere on the board
/EXP_INT_N: U5.1 (~INT); also elsewhere on the board
/Expander/KB_N0: C51.1, R89.2
/Expander/KB_N1: C51.2, D22.3 (COM)
/Expander/RLY_A: D5.2 (A), K1.A2, Q1.3 (D)
/Expander/RLY_G1: Q1.1 (G), R11.2, R12.1
/Expander/RLY_G2: C50.1, D22.2 (K), Q2.1 (G), R14.1, R90.1
/Expander/RLY_ON: R11.1, U5.9 (P05)
/Expander/VARIANT_N: R27.2, R28.1, U5.17 (P14)
/I2C0_SCL: U5.22 (SCL); also elsewhere on the board
/I2C0_SDA: U5.23 (SDA); also elsewhere on the board
/KA: R89.1; also elsewhere on the board
/P06: RN3.1 (R1.1), U5.10 (P06); also elsewhere on the board
/P07: RN3.2 (R2.1), U5.11 (P07); also elsewhere on the board
/P16: RN3.3 (R3.1), U5.19 (P16); also elsewhere on the board
/P17: RN3.4 (R4.1), U5.20 (P17); also elsewhere on the board
/RLY_B: Q1.2 (S), Q2.3 (D), R93.2, R94.1; also elsewhere on the board
/RLY_B_RB: R94.2, R95.1; also elsewhere on the board
/SENS_FLT_N: U5.18 (P15); also elsewhere on the board
/ZD_MV_N: R96.1, U5.8 (P04); also elsewhere on the board
/ZD_Z1_N: RN1.1 (R1.1), U5.4 (P00); also elsewhere on the board
/ZD_Z2_N: RN1.2 (R2.1), U5.5 (P01); also elsewhere on the board
/ZD_Z3_N: RN1.3 (R3.1), U5.6 (P02); also elsewhere on the board
/ZD_Z4_N: RN1.4 (R4.1), U5.7 (P03); also elsewhere on the board
/ZD_Z5_N: RN2.1 (R1.1), U5.13 (P10); also elsewhere on the board
/ZD_Z6_N: RN2.2 (R2.1), U5.14 (P11); also elsewhere on the board
/ZD_Z7_N: RN2.3 (R3.1), U5.15 (P12); also elsewhere on the board
/ZD_Z8_N: RN2.4 (R4.1), U5.16 (P13); also elsewhere on the board
GND: C18.2, C50.2, D22.1 (A), D23.2 (A2), Q2.2 (S), R12.2, R14.2, R28.2, R90.2, R95.2, RN3.5 (R4.2), RN3.6 (R3.2), RN3.7 (R2.2), RN3.8 (R1.2), U5.2 (A1), U5.12 (GND), U5.21 (A0); also elsewhere on the board
V_BUCK: D5.1 (K), K1.A1, R93.1; also elsewhere on the board
V_DRV: R96.2, RN1.5 (R4.2), RN1.6 (R3.2), RN1.7 (R2.2), RN1.8 (R1.2), RN2.5 (R4.2), RN2.6 (R3.2), RN2.7 (R2.2), RN2.8 (R1.2); also elsewhere on the board

Notes on the sheet:
VALVE-COMMON RELAY (hardware design section 7). K1 G5NB-1A-E, 5 V 125R coil fed from V_BUCK, feeds AC_L to the COM terminals. With K1 open no valve has power, whatever a shorted triac, TVS or opto-triac does. It closes only when Q1 AND Q2 conduct. Q1: on while expander bit RLY_ON is high. DRV_EN lo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
R28: 8-zone build only. Not fitted: bit P14 reads high, firmware runs four zones.
Valve-common relay: coil current passes Q1 and Q2 in series
16-bit I2C expander, address 0x74, held in reset by DRV_EN
EXPANDER (section 8.2). U5 TCA9539: every pin is an input while RESET is low, which is whenever no valve runs. A valve is on when its bit is an output and low: P00 to P03 Z1 to Z4, P04 MV, P10 to P13 Z5 to Z8. P05 RLY_ON is on when high. P14 reads the build variant, P15 the sensor supply fault. RN1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
Defined levels on every expander pin while it is in reset
