syntroniks/zoneflow/hardware/zoneflow-a/zoneflow-a.kicad_pcb

## KiCad design hardware/zoneflow-a/zoneflow-a.kicad_pcb (continued)

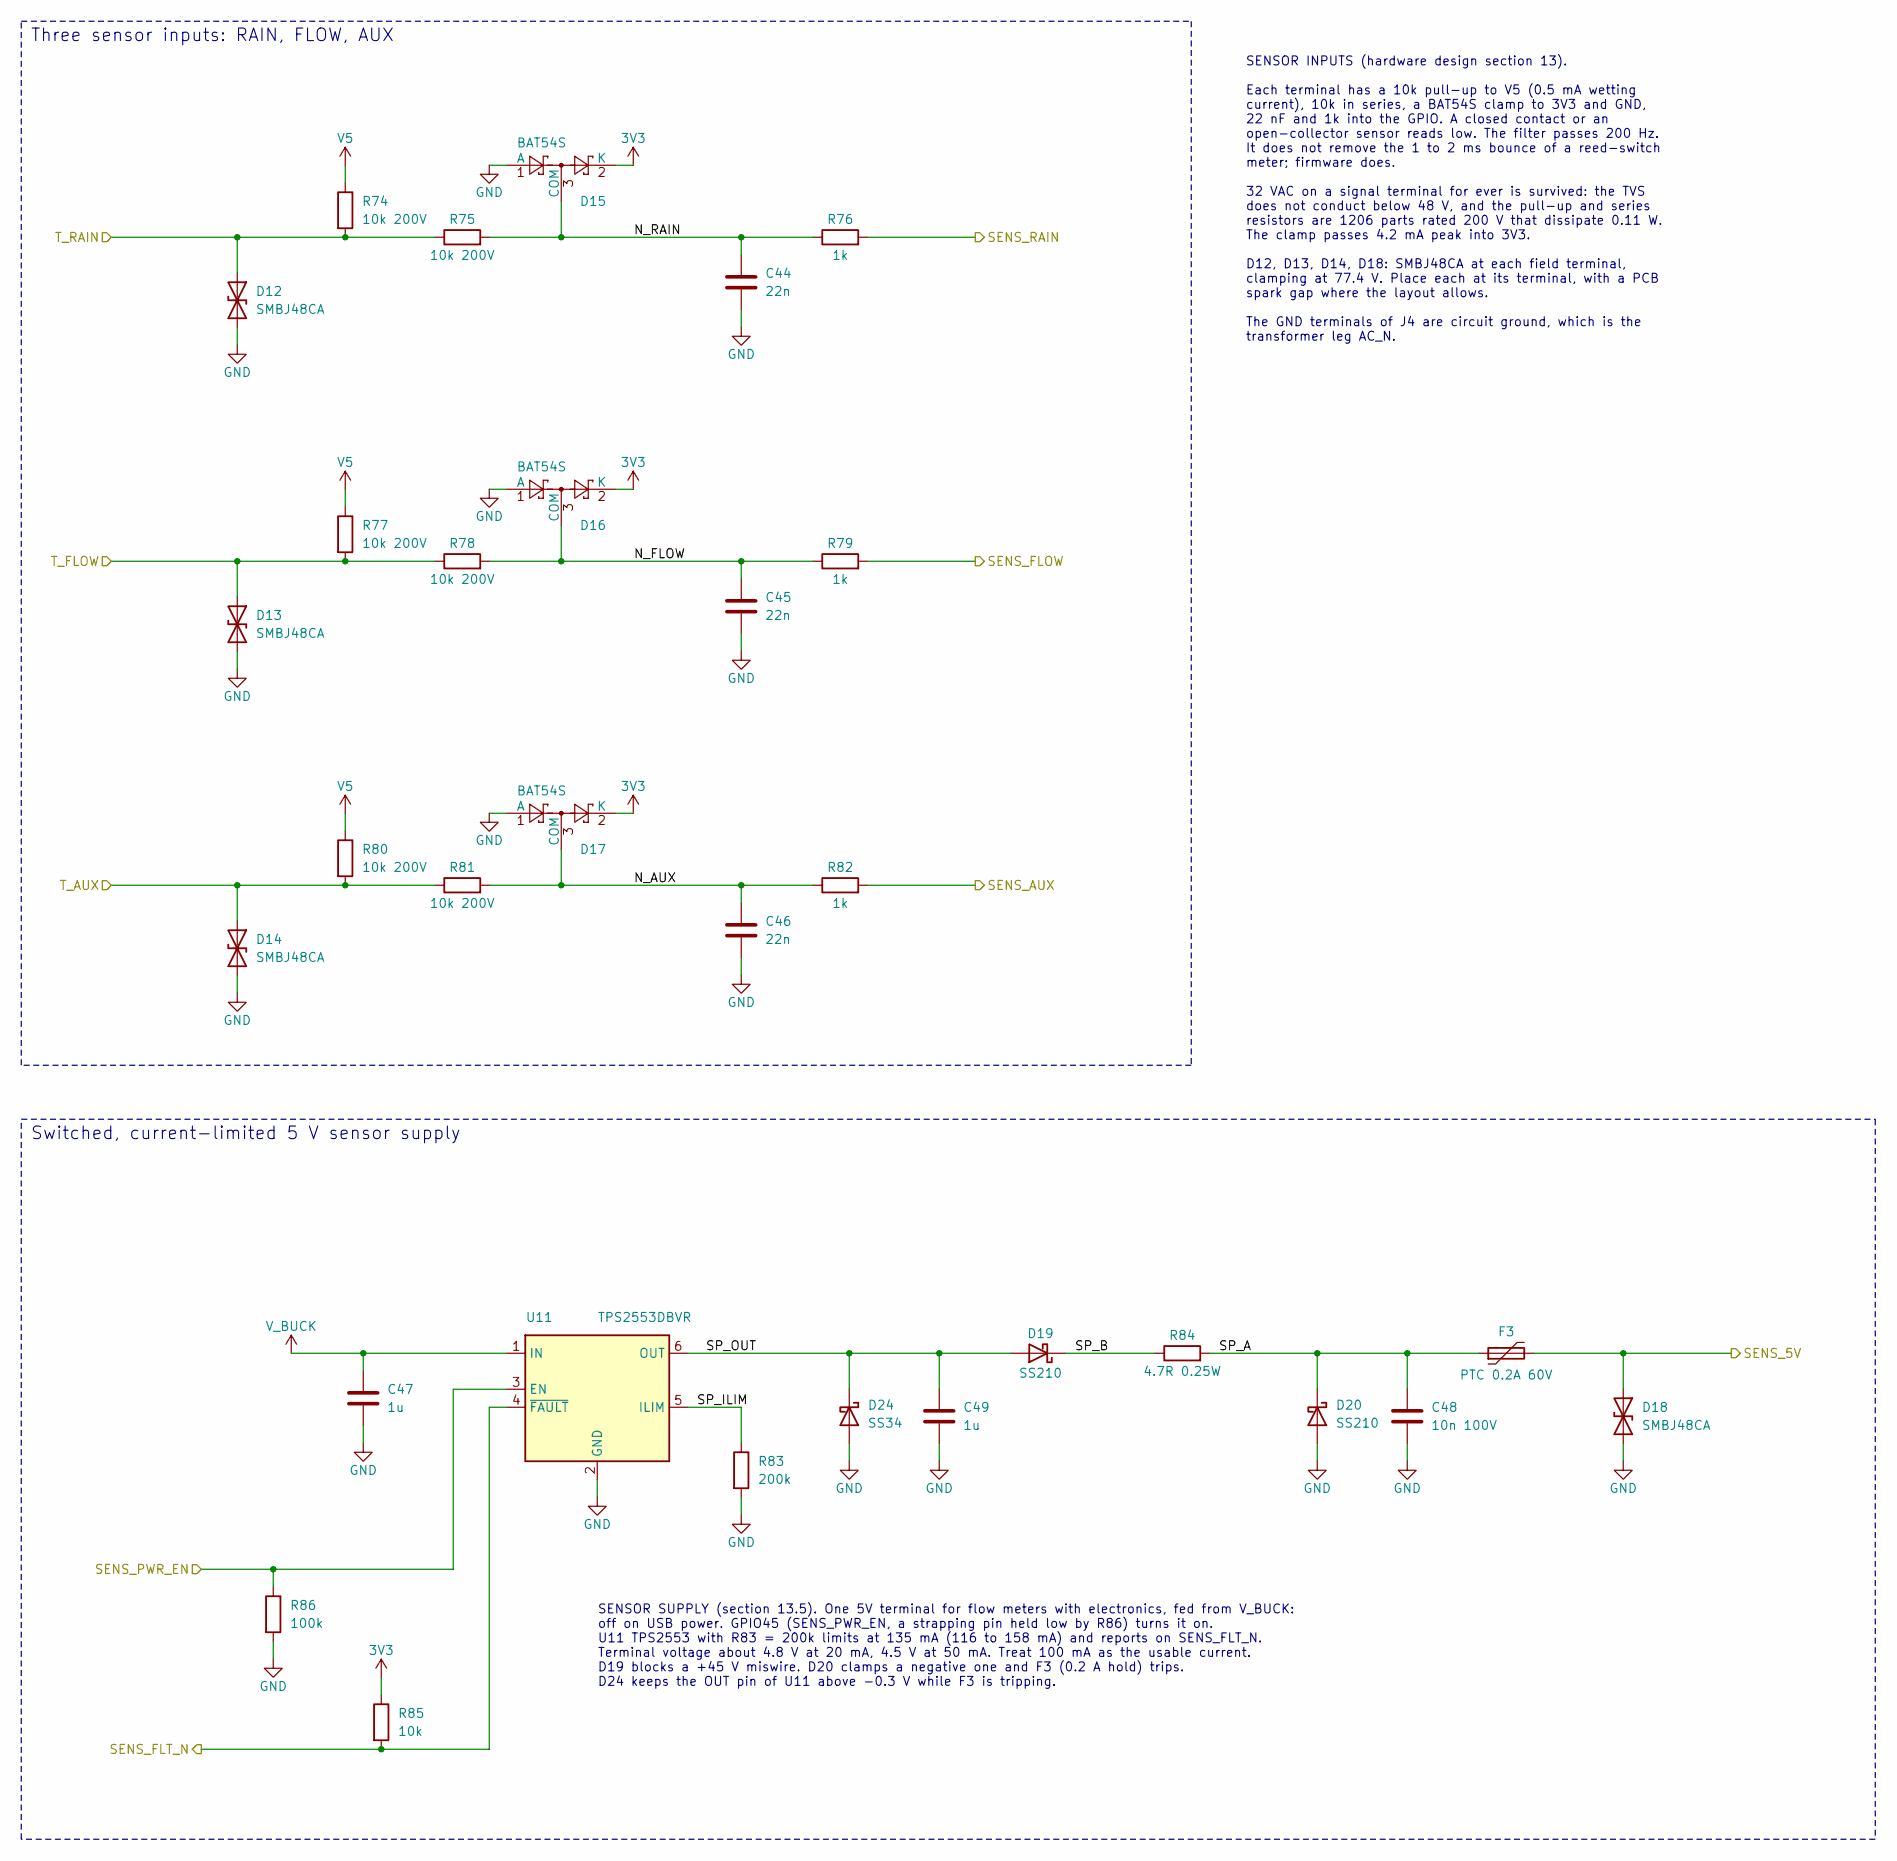
[picture p281: schematic sensors.kicad_sch, Sensor inputs and sensor supply]

Parts:
C44, C45, C46: 22n; C_0603_1608Metric; MPN CL10B223KB8NNNC; LCSC C21122
C47, C49: 1u; C_0603_1608Metric; MPN CL10A105KB8NNNC; LCSC C15849
C48: 10n 100V; C_0805_2012Metric; MPN CL21B103KCANNNC; LCSC C18741
D12, D13, D14, D18: SMBJ48CA; D_SMB; MPN SMBJ48CA; LCSC C151264
D15, D16, D17: BAT54S; SOT-23; MPN BAT54S; LCSC C7420333
D19, D20: SS210; D_SMA; MPN SS210; LCSC C14996
D24: SS34; D_SMA; MPN SS34; LCSC C8678
F3: PTC 0.2A 60V; Fuse_1812_4532Metric; MPN 1812L020/60DR; LCSC C315900
R74, R75, R77, R78, R80, R81: 10k 200V; R_1206_3216Metric; MPN 1206W4F1002T5E; LCSC C17902
R76, R79, R82: 1k; R_0603_1608Metric; MPN 0603WAF1001T5E; LCSC C21190
R83: 200k; R_0603_1608Metric; MPN 0603WAF2003T5E; LCSC C25811
R84: 4.7R 0.25W; R_1206_3216Metric; MPN 1206W4F470KT5E; LCSC C17937
R85: 10k; R_0603_1608Metric; MPN 0603WAF1002T5E; LCSC C25804
R86: 100k; R_0603_1608Metric; MPN 0603WAF1003T5E; LCSC C25803
U11: TPS2553DBVR; SOT-23-6; MPN TPS2553DBVR; LCSC C55266

Connections:
3V3: D15.2 (K), D16.2 (K), D17.2 (K), R85.1; also elsewhere on the board
/SENS_5V: D18.1 (A1), F3.2; also elsewhere on the board
/SENS_AUX: R82.2; also elsewhere on the board
/SENS_FLOW: R79.2; also elsewhere on the board
/SENS_FLT_N: R85.2, U11.4 (~FAULT); also elsewhere on the board
/SENS_PWR_EN: R86.1, U11.3 (EN); also elsewhere on the board
/SENS_RAIN: R76.2; also elsewhere on the board
/Sensors/N_AUX: C46.1, D17.3 (COM), R81.2, R82.1
/Sensors/N_FLOW: C45.1, D16.3 (COM), R78.2, R79.1
/Sensors/N_RAIN: C44.1, D15.3 (COM), R75.2, R76.1
/Sensors/SP_A: C48.1, D20.1 (K), F3.1, R84.2
/Sensors/SP_B: D19.1 (K), R84.1
/Sensors/SP_ILIM: R83.1, U11.5 (ILIM)
/Sensors/SP_OUT: C49.1, D19.2 (A), D24.1 (K), U11.6 (OUT)
/T_AUX: D14.1 (A1), R80.2, R81.1; also elsewhere on the board
/T_FLOW: D13.1 (A1), R77.2, R78.1; also elsewhere on the board
/T_RAIN: D12.1 (A1), R74.2, R75.1; also elsewhere on the board
GND: C44.2, C45.2, C46.2, C47.2, C48.2, C49.2, D12.2 (A2), D13.2 (A2), D14.2 (A2), D15.1 (A), D16.1 (A), D17.1 (A), D18.2 (A2), D20.2 (A), D24.2 (A), R83.2, R86.2, U11.2 (GND); also elsewhere on the board
V5: R74.1, R77.1, R80.1; also elsewhere on the board
V_BUCK: C47.1, U11.1 (IN); also elsewhere on the board

Notes on the sheet:
Three sensor inputs: RAIN, FLOW, AUX
Switched, current-limited 5 V sensor supply
SENSOR SUPPLY (section 13.5). One 5V terminal for flow meters with electronics, fed from V_BUCK: off on USB power. GPIO45 (SENS_PWR_EN, a strapping pin held low by R86) turns it on. U11 TPS2553 with R83 = 200k limits at 135 mA (116 to 158 mA) and reports on SENS_FLT_N. Terminal voltage about 4.8 V 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
SENSOR INPUTS (hardware design section 13). Each terminal has a 10k pull-up to V5 (0.5 mA wetting current), 10k in series, a BAT54S clamp to 3V3 and GND, 22 nF and 1k into the GPIO. A closed contact or an open-collector sensor reads low. The filter passes 200 Hz. It does not remove the 1 to 2 ms bo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

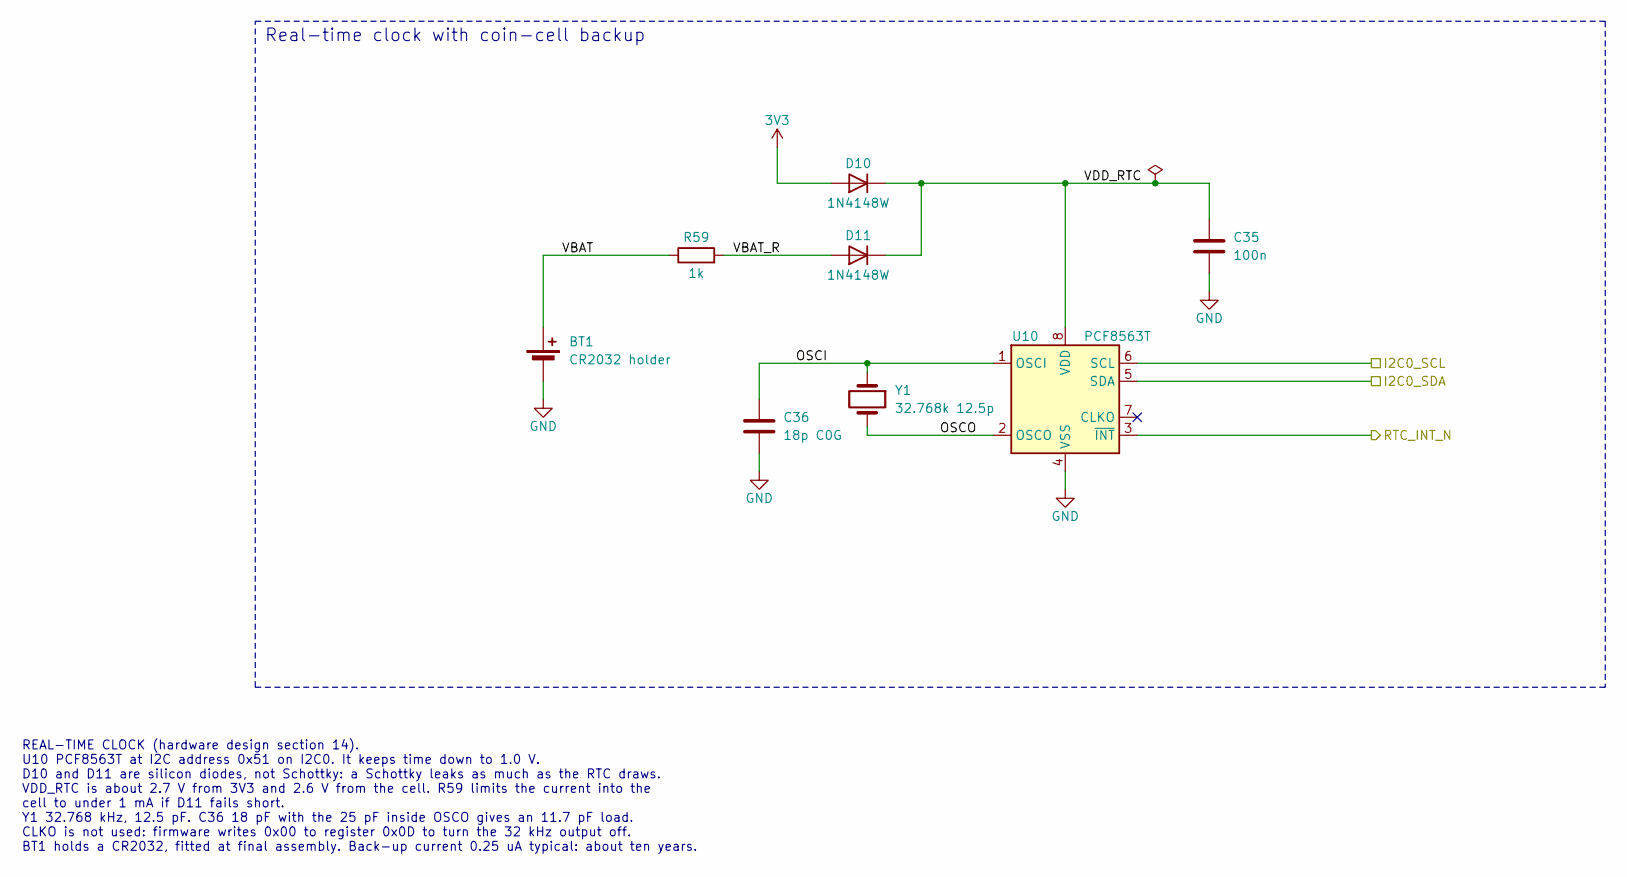
[picture p282: schematic rtc.kicad_sch, Real-time clock]

Parts:
BT1: CR2032 holder; BatteryHolder_QJ_CR2032-BS-6-1; MPN CR2032-BS-6-1; LCSC C70377
C35: 100n; C_0603_1608Metric; MPN CC0603KRX7R9BB104; LCSC C14663
C36: 18p C0G; C_0603_1608Metric; MPN CL10C180JB8NNNC; LCSC C1647
D10, D11: 1N4148W; D_SOD-123; MPN 1N4148W; LCSC C81598
R59: 1k; R_0603_1608Metric; MPN 0603WAF1001T5E; LCSC C21190
U10: PCF8563T; SOIC-8_3.9x4.9mm_P1.27mm; MPN PCF8563T/5,518; LCSC C7440
Y1: 32.768k 12.5p; Crystal_SMD_3215-2Pin_3.2x1.5mm; MPN Q13FC13500004; LCSC C32346

Connections:
3V3: D10.2 (A); also elsewhere on the board
/I2C0_SCL: U10.6 (SCL); also elsewhere on the board
/I2C0_SDA: U10.5 (SDA); also elsewhere on the board
/RTC/OSCI: C36.1, U10.1 (OSCI), Y1.1
/RTC/OSCO: U10.2 (OSCO), Y1.2
/RTC/VBAT: BT1.1 (+), R59.1
/RTC/VBAT_R: D11.2 (A), R59.2
/RTC/VDD_RTC: C35.1, D10.1 (K), D11.1 (K), U10.8 (VDD)
/RTC_INT_N: U10.3 (~INT); also elsewhere on the board
GND: BT1.2 (-), C35.2, C36.2, U10.4 (VSS); also elsewhere on the board

Notes on the sheet:
REAL-TIME CLOCK (hardware design section 14). U10 PCF8563T at I2C address 0x51 on I2C0. It keeps time down to 1.0 V. D10 and D11 are silicon diodes, not Schottky: a Schottky leaks as much as the RTC draws. VDD_RTC is about 2.7 V from 3V3 and 2.6 V from the cell. R59 limits the current into the cell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
Real-time clock with coin-cell backup

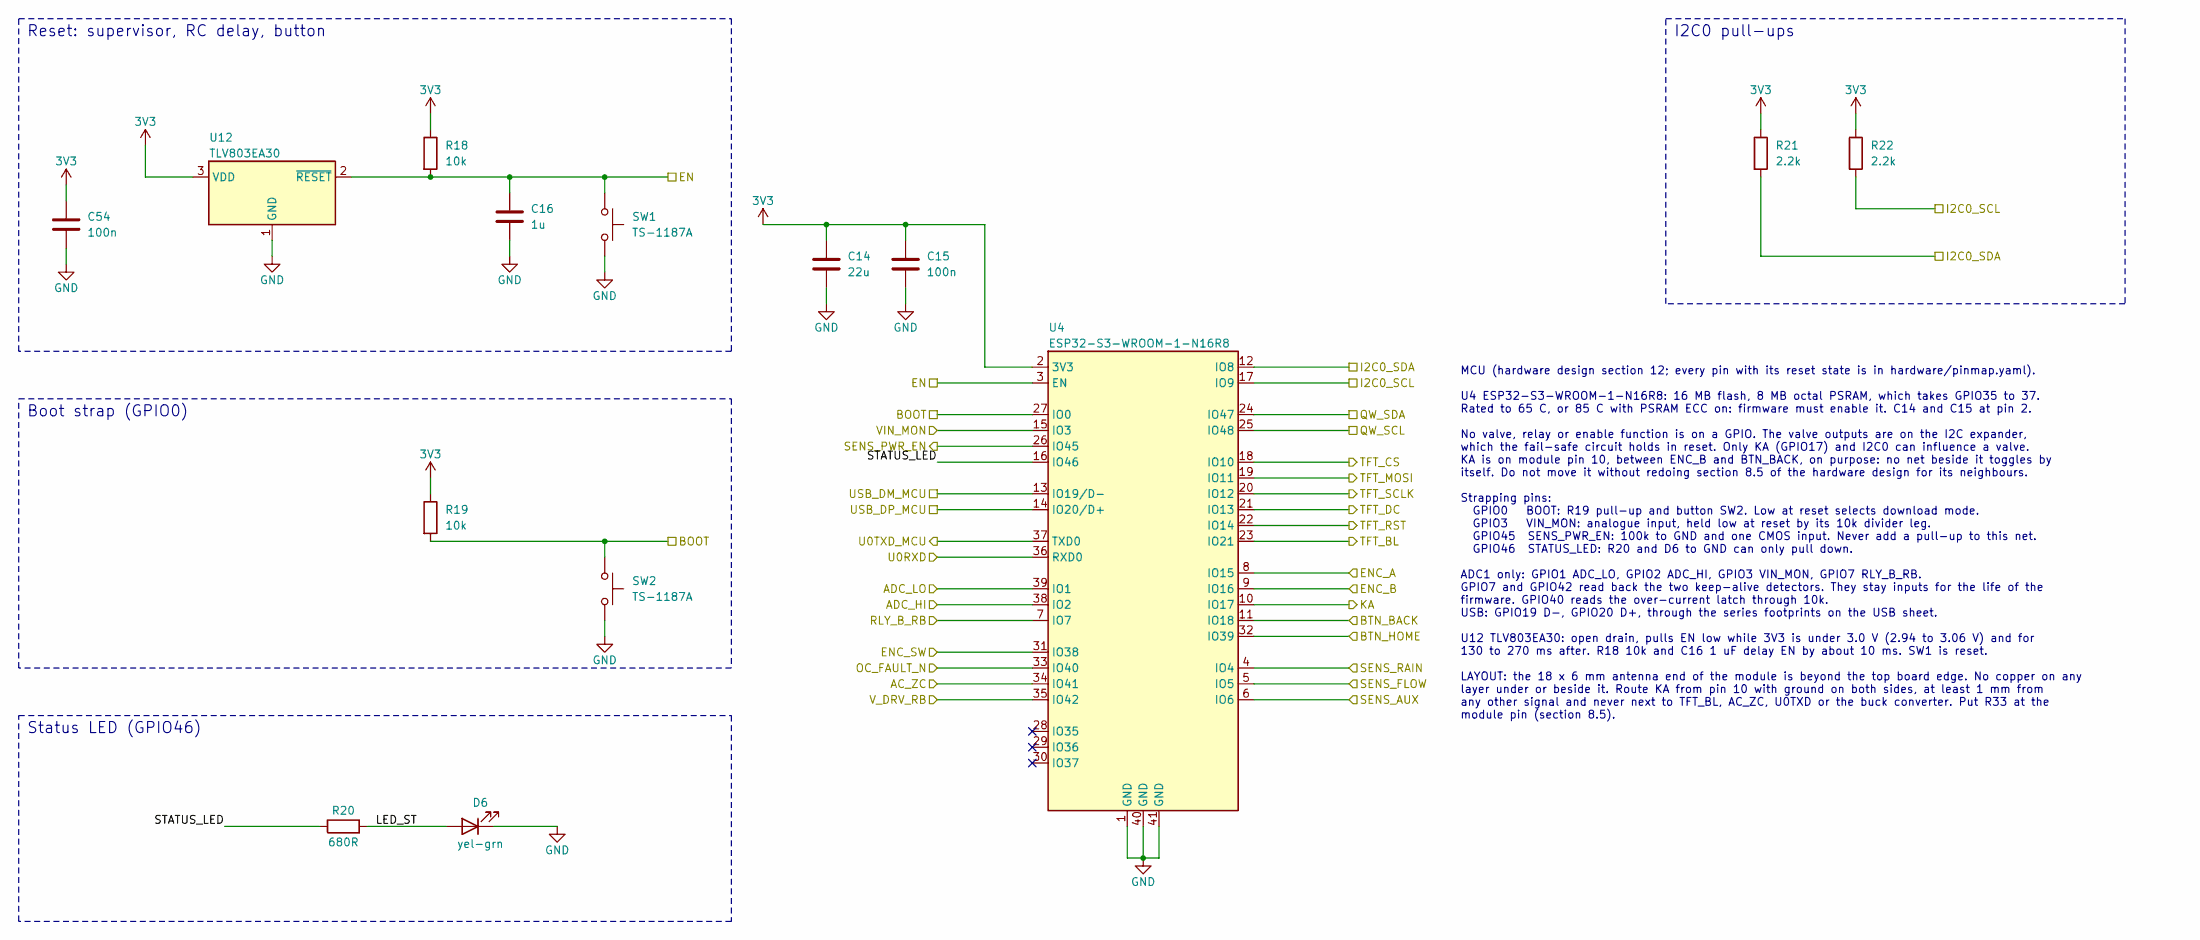
[picture p283: schematic mcu.kicad_sch, MCU: ESP32-S3 module, reset, boot, status]

Parts:
C14: 22u; C_1206_3216Metric; MPN CL31A226KAHNNNE; LCSC C12891
C15, C54: 100n; C_0603_1608Metric; MPN CC0603KRX7R9BB104; LCSC C14663
C16: 1u; C_0603_1608Metric; MPN CL10A105KB8NNNC; LCSC C15849
D6: yel-grn; LED_0603_1608Metric; MPN LTST-C190KGKT; LCSC C125094
R18, R19: 10k; R_0603_1608Metric; MPN 0603WAF1002T5E; LCSC C25804
R20: 680R; R_0603_1608Metric; MPN 0603WAF6800T5E; LCSC C23228
R21, R22: 2.2k; R_0603_1608Metric; MPN 0603WAF2201T5E; LCSC C4190
SW1, SW2: TS-1187A; SW_Push_1P1T_XKB_TS-1187A; MPN TS-1187A-B-A-B; LCSC C318884
U4: ESP32-S3-WROOM-1-N16R8; ESP32-S3-WROOM-1; MPN ESP32-S3-WROOM-1-N16R8; LCSC C2913202
U12: TLV803EA30; SOT-23; MPN TLV803EA30DBZR; LCSC C5218924

Connections:
3V3: C14.1, C15.1, C54.1, R18.1, R19.1, R21.1, R22.1, U4.2 (3V3), U12.3 (VDD); also elsewhere on the board
/AC_ZC: U4.34 (IO41); also elsewhere on the board
/ADC_HI: U4.38 (IO2); also elsewhere on the board
/ADC_LO: U4.39 (IO1); also elsewhere on the board
/BOOT: R19.2, SW2.1, U4.27 (IO0); also elsewhere on the board
/BTN_BACK: U4.11 (IO18); also elsewhere on the board
/BTN_HOME: U4.32 (IO39); also elsewhere on the board
/EN: C16.1, R18.2, SW1.1, U4.3 (EN), U12.2 (~RESET); also elsewhere on the board
/ENC_A: U4.8 (IO15); also elsewhere on the board
/ENC_B: U4.9 (IO16); also elsewhere on the board
/ENC_SW: U4.31 (IO38); also elsewhere on the board
/I2C0_SCL: R22.2, U4.17 (IO9); also elsewhere on the board
/I2C0_SDA: R21.2, U4.12 (IO8); also elsewhere on the board
/KA: U4.10 (IO17); also elsewhere on the board
/MCU/LED_ST: D6.2 (A), R20.2
/MCU/STATUS_LED: R20.1, U4.16 (IO46)
/OC_FAULT_N: U4.33 (IO40); also elsewhere on the board
/QW_SCL: U4.25 (IO48); also elsewhere on the board
/QW_SDA: U4.24 (IO47); also elsewhere on the board
/RLY_B_RB: U4.7 (IO7); also elsewhere on the board
/SENS_AUX: U4.6 (IO6); also elsewhere on the board
/SENS_FLOW: U4.5 (IO5); also elsewhere on the board
/SENS_PWR_EN: U4.26 (IO45); also elsewhere on the board
/SENS_RAIN: U4.4 (IO4); also elsewhere on the board
/TFT_BL: U4.23 (IO21); also elsewhere on the board
/TFT_CS: U4.18 (IO10); also elsewhere on the board
/TFT_DC: U4.21 (IO13); also elsewhere on the board
/TFT_MOSI: U4.19 (IO11); also elsewhere on the board
/TFT_RST: U4.22 (IO14); also elsewhere on the board
/TFT_SCLK: U4.20 (IO12); also elsewhere on the board
/U0RXD: U4.36 (RXD0); also elsewhere on the board
/U0TXD_MCU: U4.37 (TXD0); also elsewhere on the board
/USB_DM_MCU: U4.13 (IO19/D-); also elsewhere on the board
/USB_DP_MCU: U4.14 (IO20/D+); also elsewhere on the board
/VIN_MON: U4.15 (IO3); also elsewhere on the board
/V_DRV_RB: U4.35 (IO42); also elsewhere on the board
GND: C14.2, C15.2, C16.2, C54.2, D6.1 (K), SW1.2, SW2.2, U4.1 (GND), U4.40 (GND), U4.41 (GND), U12.1 (GND); also elsewhere on the board

Notes on the sheet:
Reset: supervisor, RC delay, button
Boot strap (GPIO0)
Status LED (GPIO46)
I2C0 pull-ups
MCU (hardware design section 12; every pin with its reset state is in hardware/pinmap.yaml). U4 ESP32-S3-WROOM-1-N16R8: 16 MB flash, 8 MB octal PSRAM, which takes GPIO35 to 37. Rated to 65 C, or 85 C with PSRAM ECC on: firmware must enable it. C14 and C15 at pin 2. No valve, relay or enable functio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

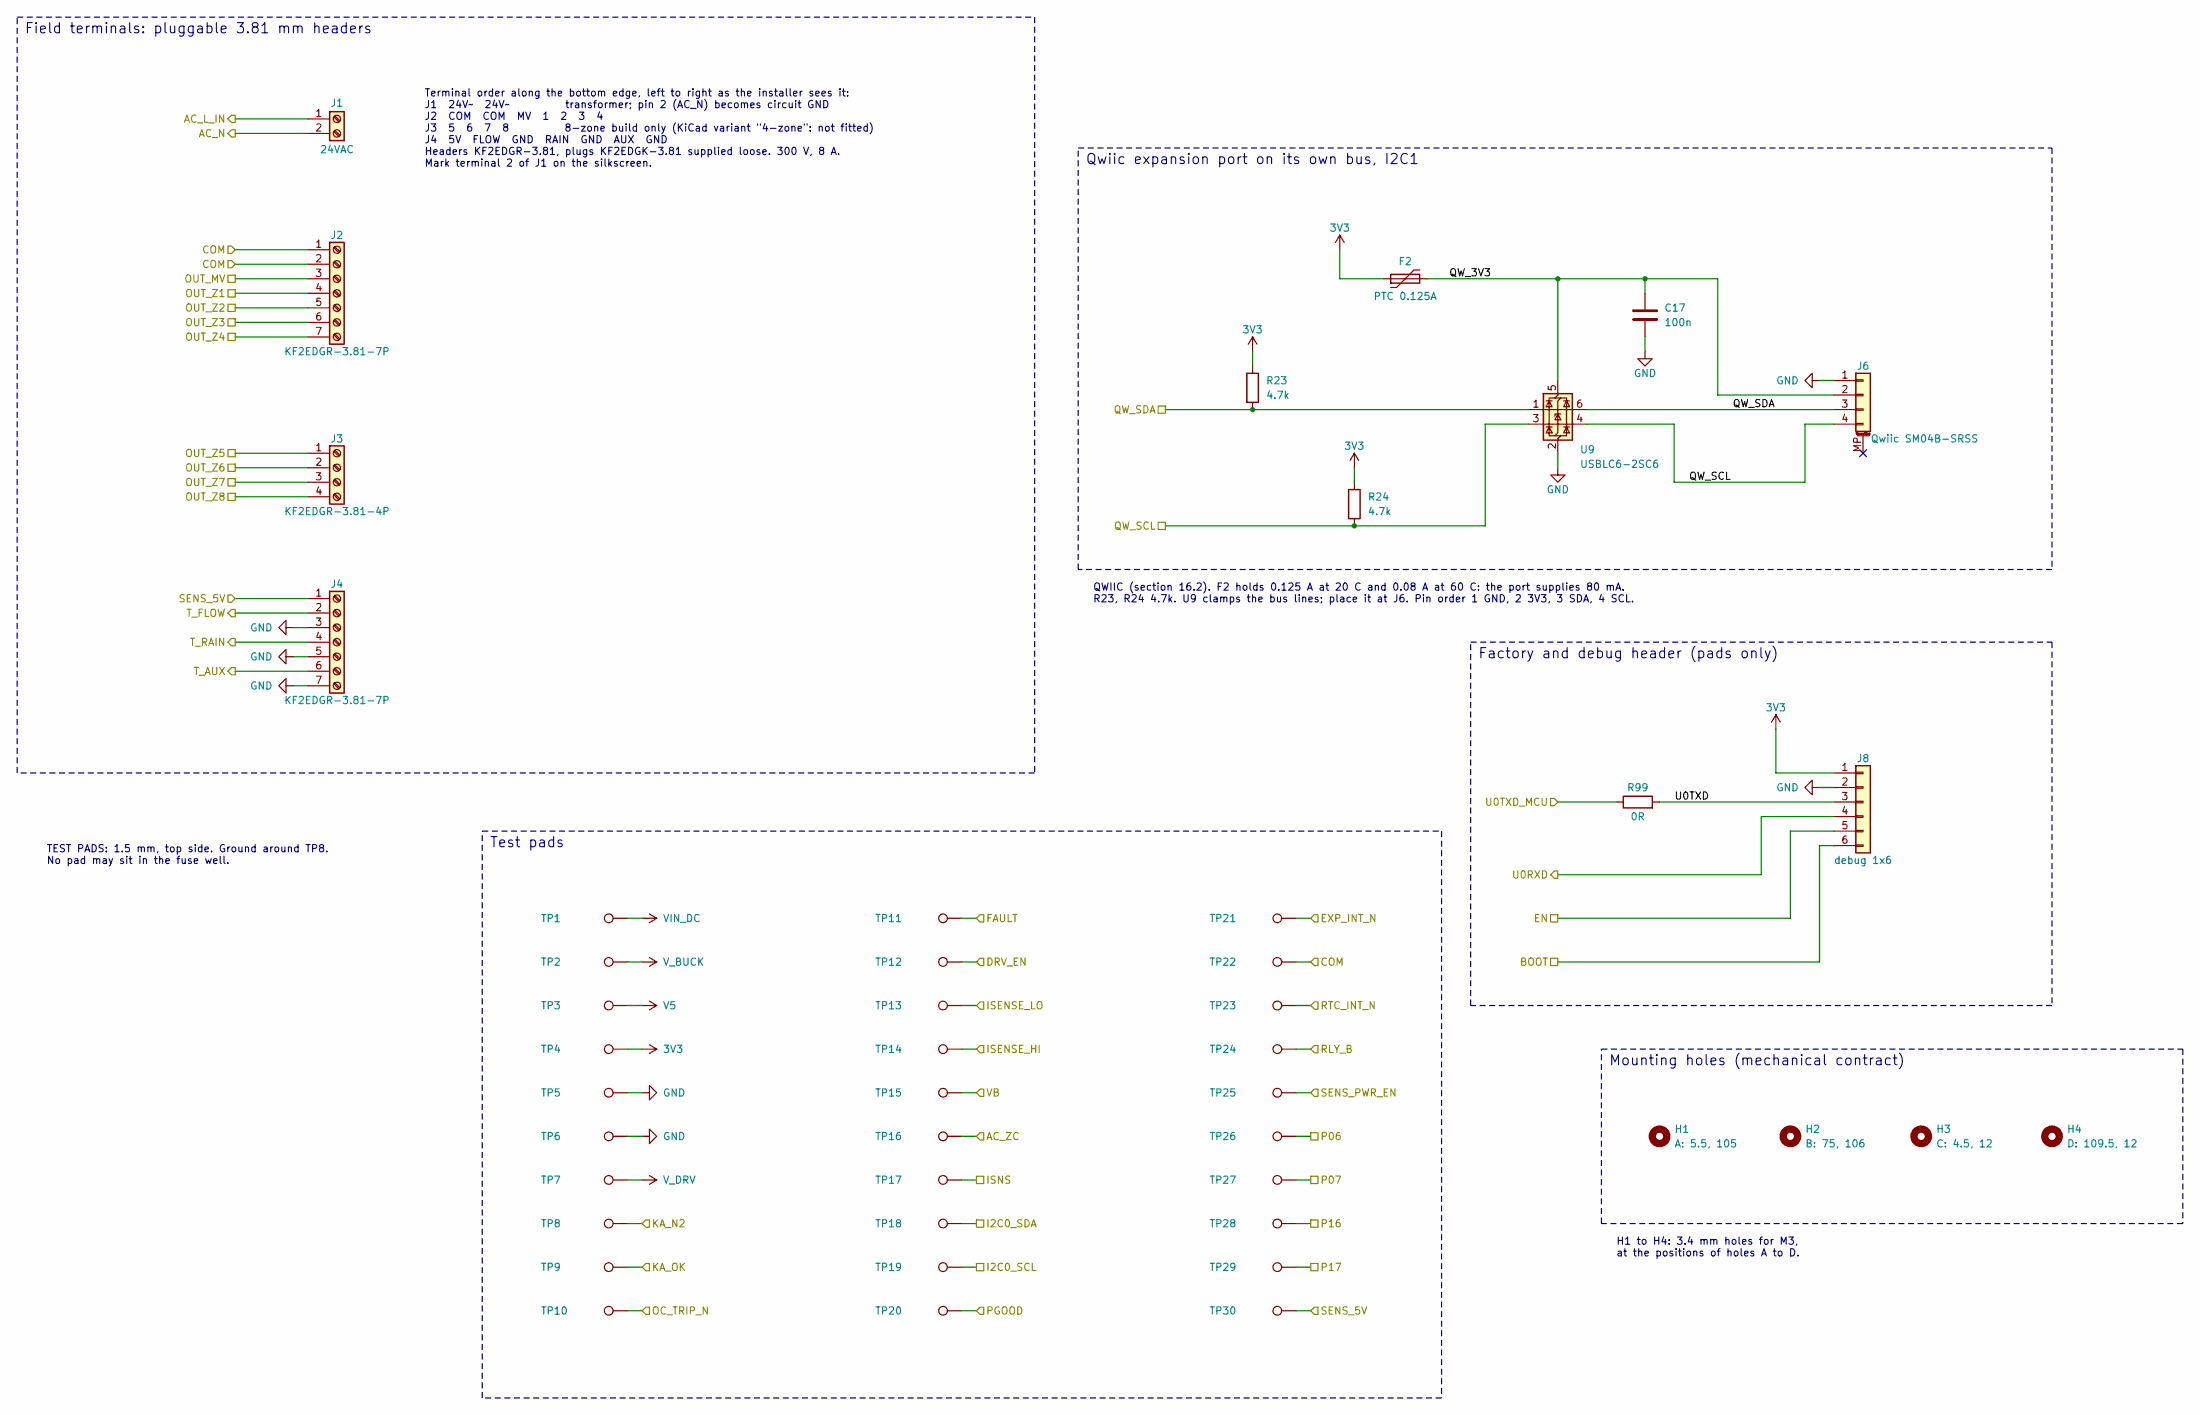
[picture p284: schematic connectors.kicad_sch, Connectors, test pads and mounting holes]

Parts:
C17: 100n; C_0603_1608Metric; MPN CC0603KRX7R9BB104; LCSC C14663
F2: PTC 0.125A; Fuse_1206_3216Metric; MPN 1206L012WR; LCSC C151160
H1: A: 5.5, 105; MountingHole_3.4mm_M3_Keepout9mm
H2: B: 75, 106; MountingHole_3.4mm_M3_Keepout9mm
H3: C: 4.5, 12; MountingHole_3.4mm_M3_Keepout7mm
H4: D: 109.5, 12; MountingHole_3.4mm_M3_Keepout7mm
J1: 24VAC; KF2EDGR-3.81-2P; MPN KF2EDGR-3.81-2P; LCSC C441182
J2, J4: KF2EDGR-3.81-7P; MPN KF2EDGR-3.81-7P; LCSC C441187
J3: KF2EDGR-3.81-4P; MPN KF2EDGR-3.81-4P; LCSC C441184
J6: Qwiic SM04B-SRSS; JST_SH_SM04B-SRSS-TB_1x04-1MP_P1.00mm_Horizontal; MPN SM04B-SRSS-TB(LF)(SN); LCSC C160404
J8: debug 1x6; PinHeader_1x06_P2.54mm_Vertical
R23, R24: 4.7k; R_0603_1608Metric; MPN 0603WAF4701T5E; LCSC C23162
R99: 0R; R_0603_1608Metric; MPN 0603WAF0000T5E; LCSC C21189
TP1, TP2, TP3, TP4, TP5, TP6, TP7, TP8, TP9, TP10, TP11, TP12, TP13, TP14, TP15, TP16, TP17, TP18, TP19, TP20, TP21, TP22, TP23, TP24, TP25, TP26, TP27, TP28, TP29, TP30: TP; TestPoint_Pad_D1.5mm
U9: USBLC6-2SC6; SOT-23-6; MPN USBLC6-2SC6; LCSC C7519

Connections:
3V3: F2.1, J8.1, R23.1, R24.1, TP4.1; also elsewhere on the board
/AC_L_IN: J1.1; also elsewhere on the board
/AC_N: J1.2; also elsewhere on the board
/AC_ZC: TP16.1; also elsewhere on the board
/BOOT: J8.6; also elsewhere on the board
/COM: J2.1, J2.2, TP22.1; also elsewhere on the board
/Connectors/QW_3V3: C17.1, F2.2, J6.2, U9.5 (VBUS)
/Connectors/U0TXD: J8.3, R99.2
/DRV_EN: TP12.1; also elsewhere on the board
/EN: J8.5; also elsewhere on the board
/EXP_INT_N: TP21.1; also elsewhere on the board
/FAULT: TP11.1; also elsewhere on the board
/I2C0_SCL: TP19.1; also elsewhere on the board
/I2C0_SDA: TP18.1; also elsewhere on the board
/ISENSE_HI: TP14.1; also elsewhere on the board
/ISENSE_LO: TP13.1; also elsewhere on the board
/ISNS: TP17.1; also elsewhere on the board
/KA_N2: TP8.1; also elsewhere on the board
/KA_OK: TP9.1; also elsewhere on the board
/OC_TRIP_N: TP10.1; also elsewhere on the board
/OUT_MV: J2.3; also elsewhere on the board
/OUT_Z1: J2.4; also elsewhere on the board
/OUT_Z2: J2.5; also elsewhere on the board
/OUT_Z3: J2.6; also elsewhere on the board
/OUT_Z4: J2.7; also elsewhere on the board
/OUT_Z5: J3.1; also elsewhere on the board
/OUT_Z6: J3.2; also elsewhere on the board
/OUT_Z7: J3.3; also elsewhere on the board
/OUT_Z8: J3.4; also elsewhere on the board
/P06: TP26.1; also elsewhere on the board
/P07: TP27.1; also elsewhere on the board
/P16: TP28.1; also elsewhere on the board
/P17: TP29.1; also elsewhere on the board
/PGOOD: TP20.1; also elsewhere on the board
/QW_SCL: J6.4, R24.2, U9.3 (I/O2), U9.4 (I/O2); also elsewhere on the board
/QW_SDA: J6.3, R23.2, U9.1 (I/O1), U9.6 (I/O1); also elsewhere on the board
/RLY_B: TP24.1; also elsewhere on the board
/RTC_INT_N: TP23.1; also elsewhere on the board
/SENS_5V: J4.1, TP30.1; also elsewhere on the board
/SENS_PWR_EN: TP25.1; also elsewhere on the board
/T_AUX: J4.6; also elsewhere on the board
/T_FLOW: J4.2; also elsewhere on the board
/T_RAIN: J4.4; also elsewhere on the board
/U0RXD: J8.4; also elsewhere on the board
/U0TXD_MCU: R99.1; also elsewhere on the board
/VB: TP15.1; also elsewhere on the board
GND: C17.2, J4.3, J4.5, J4.7, J6.1, J8.2, TP5.1, TP6.1, U9.2 (GND); also elsewhere on the board
V5: TP3.1; also elsewhere on the board
VIN_DC: TP1.1; also elsewhere on the board
V_BUCK: TP2.1; also elsewhere on the board
V_DRV: TP7.1; also elsewhere on the board

Notes on the sheet:
Qwiic expansion port on its own bus, I2C1
Terminal order along the bottom edge, left to right as the installer sees it: J1 24V~ 24V~ transformer; pin 2 (AC_N) becomes circuit GND J2 COM COM MV 1 2 3 4 J3 5 6 7 8 8-zone build only (KiCad variant "4-zone": not fitted) J4 5V FLOW GND RAIN GND AUX GND Headers KF2EDGR-3.81, plugs KF2EDGK-3.81 s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
TEST PADS: 1.5 mm, top side. Ground around TP8. No pad may sit in the fuse well.
Factory and debug header (pads only)
Mounting holes (mechanical contract)
H1 to H4: 3.4 mm holes for M3, at the positions of holes A to D.
Test pads
Field terminals: pluggable 3.81 mm headers
QWIIC (section 16.2). F2 holds 0.125 A at 20 C and 0.08 A at 60 C: the port supplies 80 mA. R23, R24 4.7k. U9 clamps the bus lines; place it at J6. Pin order 1 GND, 2 3V3, 3 SDA, 4 SCL.

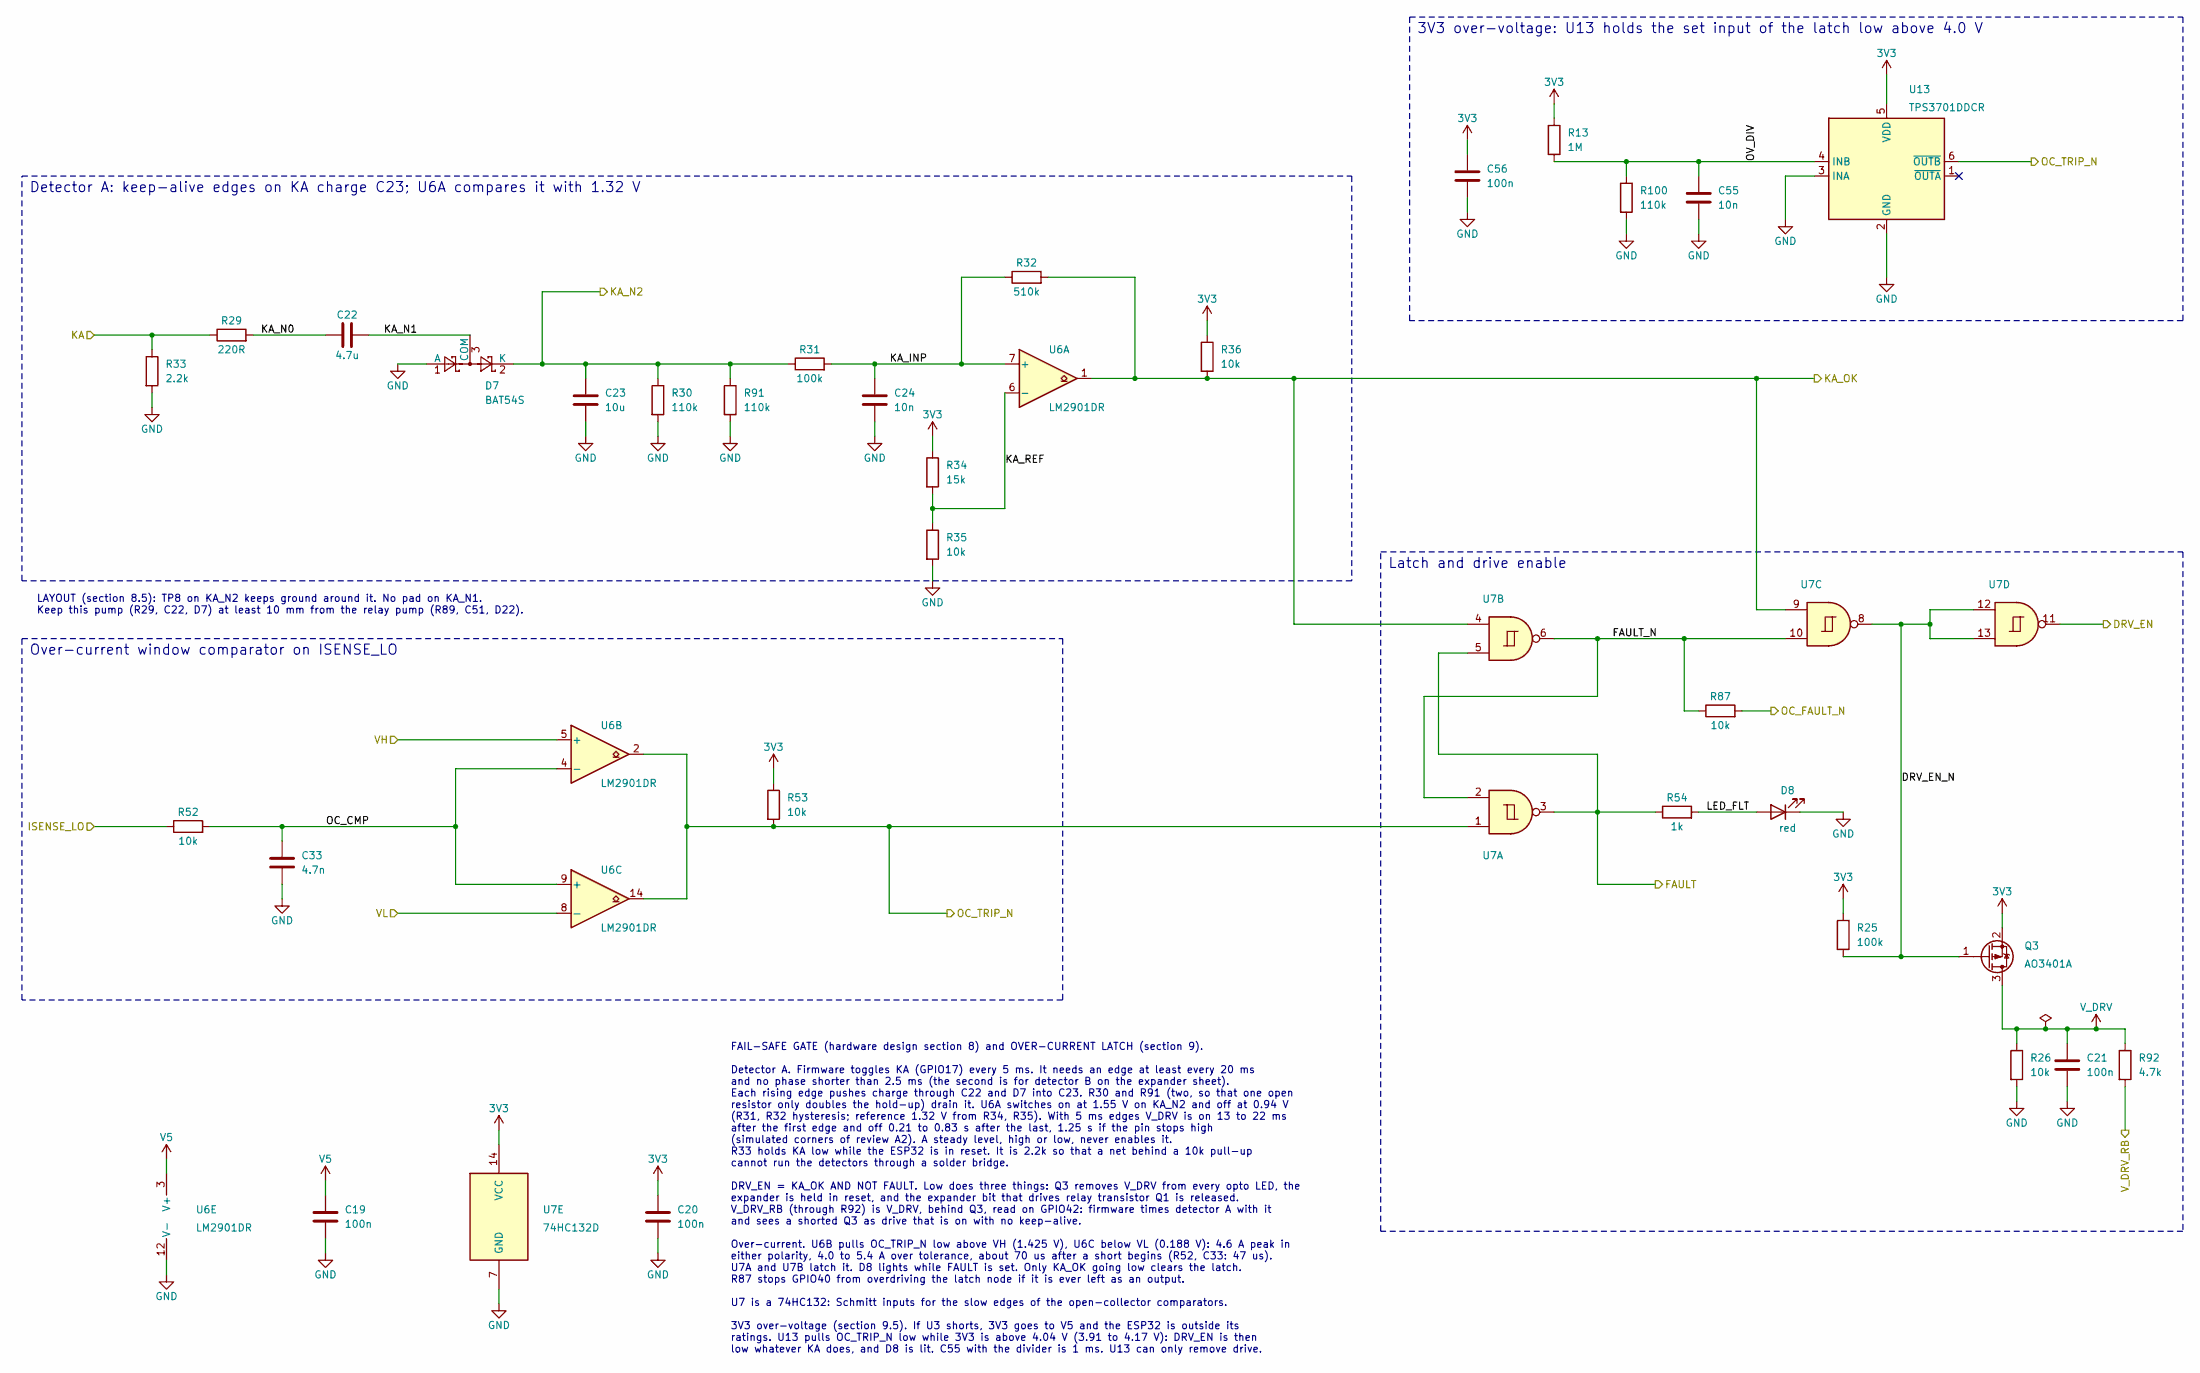
[picture p285: schematic failsafe.kicad_sch, Fail-safe gate and over-current latch]

Parts:
C19, C20, C21, C56: 100n; C_0603_1608Metric; MPN CC0603KRX7R9BB104; LCSC C14663
C22: 4.7u; C_0805_2012Metric; MPN CL21A475KAQNNNE; LCSC C1779
C23: 10u; C_0805_2012Metric; MPN CL21A106KAYNNNE; LCSC C15850
C24, C55: 10n; C_0603_1608Metric; MPN 0603B103K500NT; LCSC C57112
C33: 4.7n; C_0603_1608Metric; MPN 0603B472K500NT; LCSC C53987
D7: BAT54S; SOT-23; MPN BAT54S; LCSC C7420333
D8: red; LED_0603_1608Metric; MPN KT-0603R; LCSC C2286
Q3: AO3401A; SOT-23; MPN AO3401A; LCSC C15127
R13: 1M; R_0603_1608Metric; MPN 0603WAF1004T5E; LCSC C22935
R25, R31: 100k; R_0603_1608Metric; MPN 0603WAF1003T5E; LCSC C25803
R26, R35, R36, R52, R53, R87: 10k; R_0603_1608Metric; MPN 0603WAF1002T5E; LCSC C25804
R29: 220R; R_0603_1608Metric; MPN 0603WAF2200T5E; LCSC C22962
R30, R91, R100: 110k; R_0603_1608Metric; MPN 0603WAF1103T5E; LCSC C25805
R32: 510k; R_0603_1608Metric; MPN 0603WAF5103T5E; LCSC C23192
R33: 2.2k; R_0603_1608Metric; MPN 0603WAF2201T5E; LCSC C4190
R34: 15k; R_0603_1608Metric; MPN 0603WAF1502T5E; LCSC C22809
R54: 1k; R_0603_1608Metric; MPN 0603WAF1001T5E; LCSC C21190
R92: 4.7k; R_0603_1608Metric; MPN 0603WAF4701T5E; LCSC C23162
U6: LM2901DR; SOIC-14_3.9x8.7mm_P1.27mm; MPN LM2901DR; LCSC C7932
U7: 74HC132D; SOIC-14_3.9x8.7mm_P1.27mm; MPN 74HC132D,653; LCSC C5601
U13: TPS3701DDCR; TSOT-23-6; MPN TPS3701DDCR; LCSC C132788

Connections:
3V3: C20.1, C56.1, Q3.2 (S), R13.1, R25.1, R34.1, R36.1, R53.1, U7.14 (VCC), U13.5 (VDD); also elsewhere on the board
/DRV_EN: U7.11; also elsewhere on the board
/FAULT: R54.1, U7.3, U7.5; also elsewhere on the board
/Failsafe/DRV_EN_N: Q3.1 (G), R25.2, U7.8, U7.12, U7.13
/Failsafe/FAULT_N: R87.1, U7.2, U7.6, U7.10
/Failsafe/KA_INP: C24.1, R31.2, R32.1, U6.7 (+)
/Failsafe/KA_N0: C22.1, R29.2
/Failsafe/KA_N1: C22.2, D7.3 (COM)
/Failsafe/KA_REF: R34.2, R35.1, U6.6 (-)
/Failsafe/LED_FLT: D8.2 (A), R54.2
/Failsafe/OC_CMP: C33.1, R52.2, U6.4 (-), U6.9 (+)
/Failsafe/OV_DIV: C55.1, R13.2, R100.1, U13.4 (INB)
/ISENSE_LO: R52.1; also elsewhere on the board
/KA: R29.1, R33.1; also elsewhere on the board
/KA_N2: C23.1, D7.2 (K), R30.1, R31.1, R91.1; also elsewhere on the board
/KA_OK: R32.2, R36.2, U6.1, U7.4, U7.9; also elsewhere on the board
/OC_FAULT_N: R87.2; also elsewhere on the board
/OC_TRIP_N: R53.2, U6.2, U6.14, U7.1, U13.6 (~OUTB); also elsewhere on the board
/VH: U6.5 (+); also elsewhere on the board
/VL: U6.8 (-); also elsewhere on the board
/V_DRV_RB: R92.2; also elsewhere on the board
GND: C19.2, C20.2, C21.2, C23.2, C24.2, C33.2, C55.2, C56.2, D7.1 (A), D8.1 (K), R26.2, R30.2, R33.2, R35.2, R91.2, R100.2, U6.12 (V-), U7.7 (GND), U13.2 (GND), U13.3 (INA); also elsewhere on the board
V5: C19.1, U6.3 (V+); also elsewhere on the board
V_DRV: C21.1, Q3.3 (D), R26.1, R92.1; also elsewhere on the board

Notes on the sheet:
LAYOUT (section 8.5): TP8 on KA_N2 keeps ground around it. No pad on KA_N1. Keep this pump (R29, C22, D7) at least 10 mm from the relay pump (R89, C51, D22).
Over-current window comparator on ISENSE_LO
FAIL-SAFE GATE (hardware design section 8) and OVER-CURRENT LATCH (section 9). Detector A. Firmware toggles KA (GPIO17) every 5 ms. It needs an edge at least every 20 ms and no phase shorter than 2.5 ms (the second is for detector B on the expander sheet). Each rising edge pushes charge through C22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
Latch and drive enable
Detector A: keep-alive edges on KA charge C23; U6A compares it with 1.32 V
3V3 over-voltage: U13 holds the set input of the latch low above 4.0 V
