syntroniks/zoneflow/hardware/zoneflow-a/zoneflow-a.kicad_pcb

## KiCad design hardware/zoneflow-a/zoneflow-a.kicad_pcb (continued)

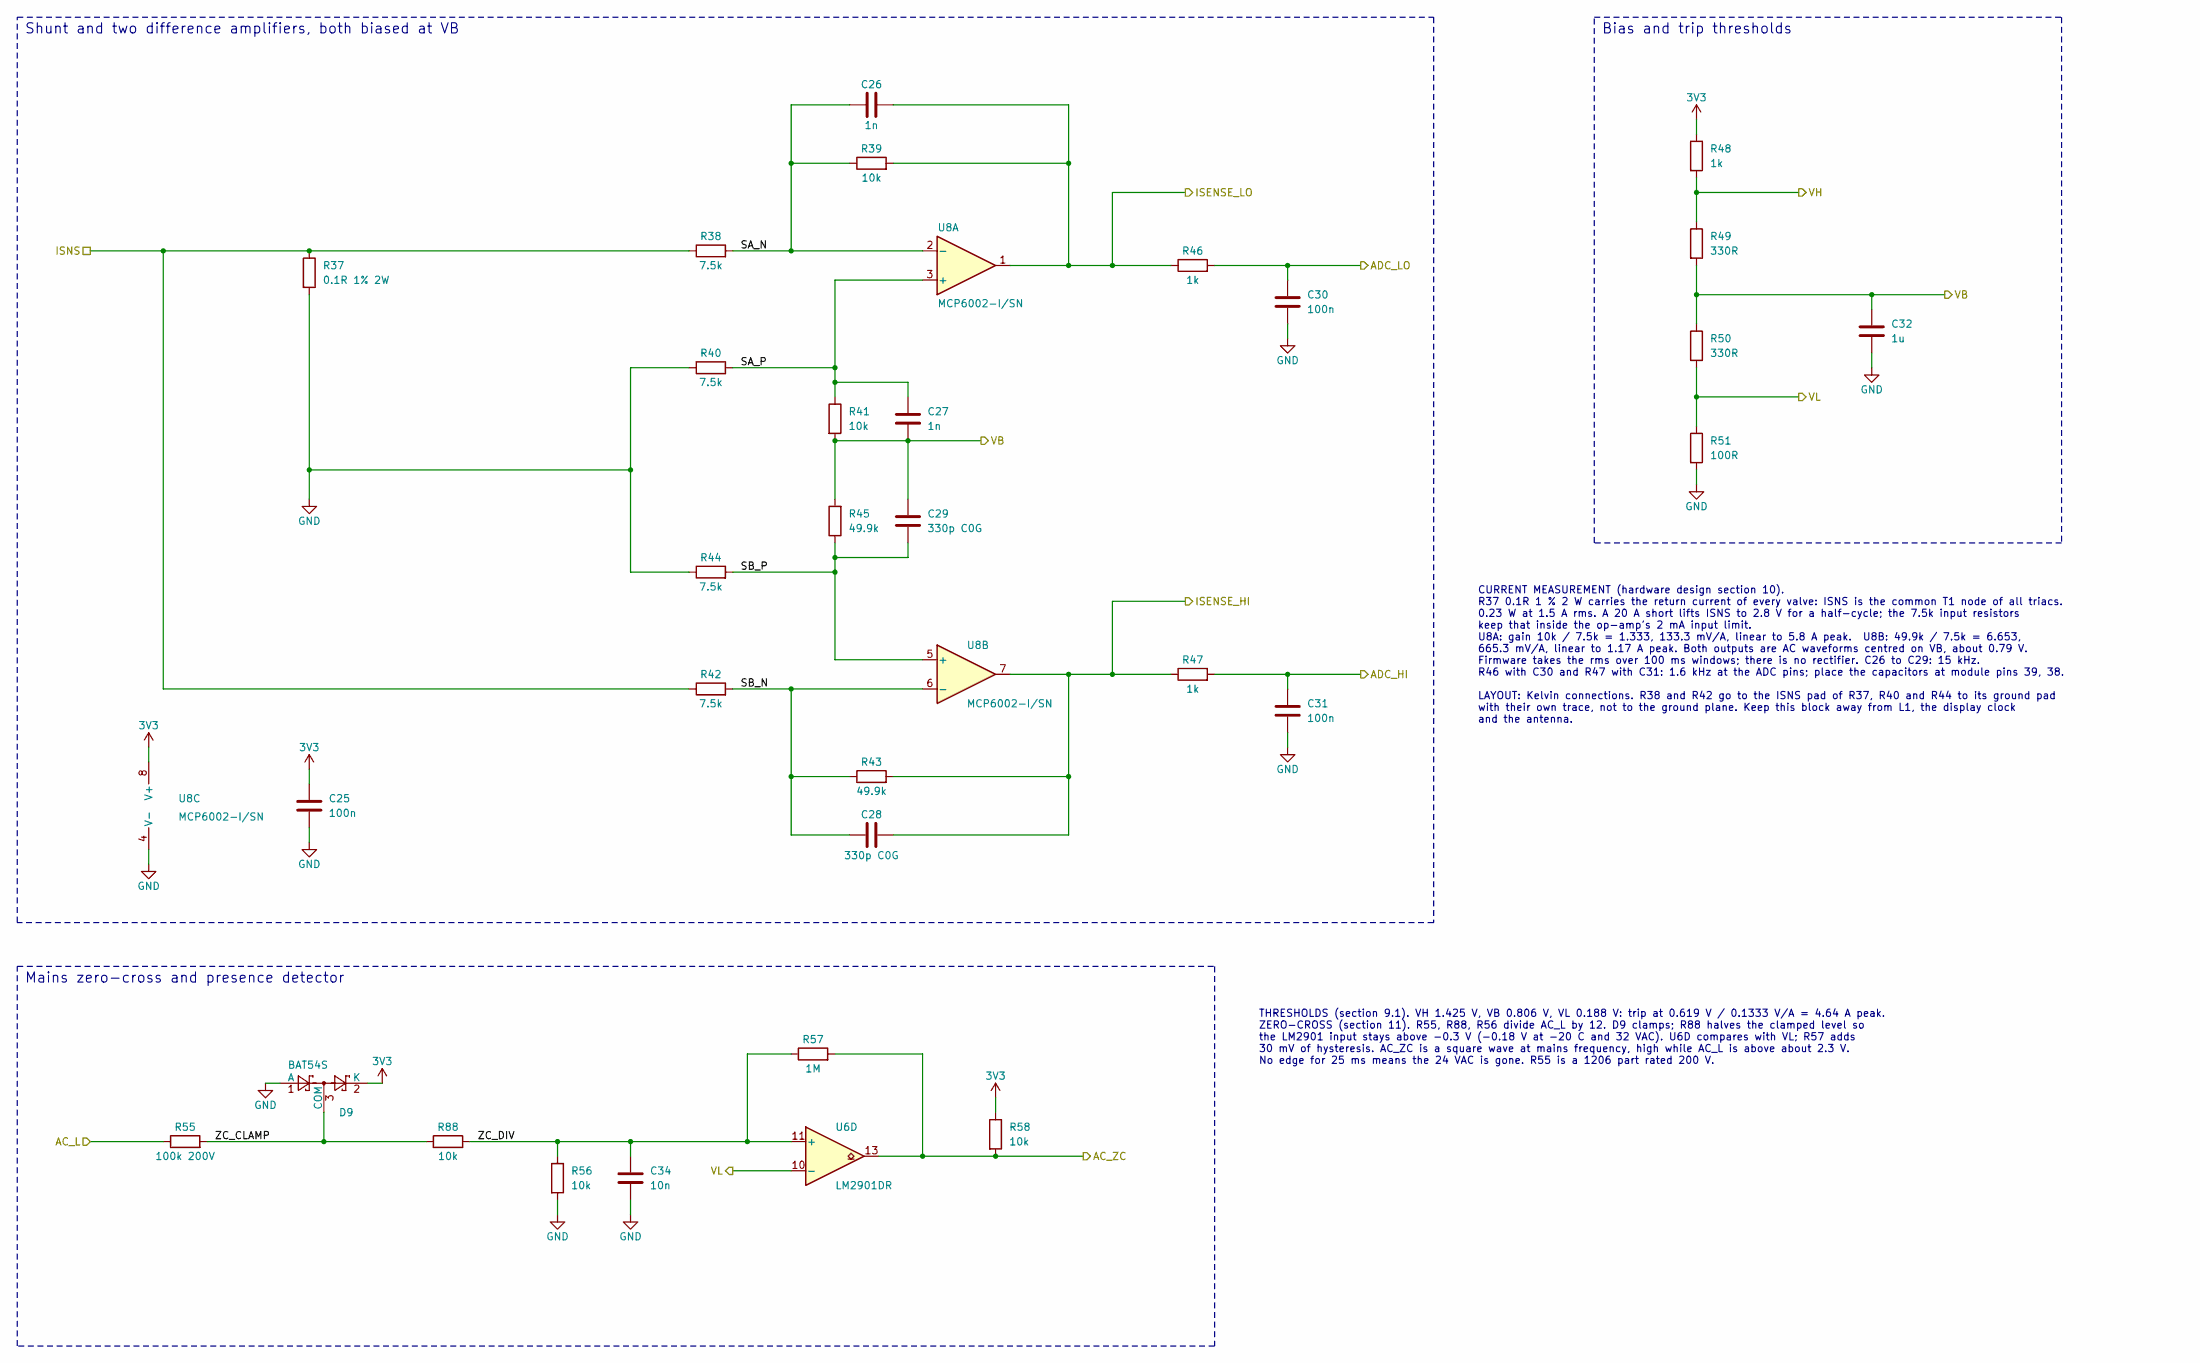
[picture p286: schematic isense.kicad_sch, Current sense and zero-cross]

Parts:
C25, C30, C31: 100n; C_0603_1608Metric; MPN CC0603KRX7R9BB104; LCSC C14663
C26, C27: 1n; C_0603_1608Metric; MPN CL10B102KB8NNNC; LCSC C1588
C28, C29: 330p C0G; C_0603_1608Metric; MPN CL10C331JB8NNNC; LCSC C1664
C32: 1u; C_0603_1608Metric; MPN CL10A105KB8NNNC; LCSC C15849
C34: 10n; C_0603_1608Metric; MPN 0603B103K500NT; LCSC C57112
D9: BAT54S; SOT-23; MPN BAT54S; LCSC C7420333
R37: 0.1R 1% 2W; R_2512_6332Metric; MPN RLP25FEER100; LCSC C160587
R38, R40, R42, R44: 7.5k; R_0603_1608Metric; MPN 0603WAF7501T5E; LCSC C23234
R39, R41, R56, R58, R88: 10k; R_0603_1608Metric; MPN 0603WAF1002T5E; LCSC C25804
R43, R45: 49.9k; R_0603_1608Metric; MPN 0603WAF4992T5E; LCSC C23184
R46, R47, R48: 1k; R_0603_1608Metric; MPN 0603WAF1001T5E; LCSC C21190
R49, R50: 330R; R_0603_1608Metric; MPN 0603WAF3300T5E; LCSC C23138
R51: 100R; R_0603_1608Metric; MPN 0603WAF1000T5E; LCSC C22775
R55: 100k 200V; R_1206_3216Metric; MPN 1206W4F1003T5E; LCSC C17900
R57: 1M; R_0603_1608Metric; MPN 0603WAF1004T5E; LCSC C22935
U6: LM2901DR; SOIC-14_3.9x8.7mm_P1.27mm; MPN LM2901DR; LCSC C7932
U8: MCP6002-I/SN; SOIC-8_3.9x4.9mm_P1.27mm; MPN MCP6002T-I/SN; LCSC C7377

Connections:
3V3: C25.1, D9.2 (K), R48.1, R58.1, U8.8 (V+); also elsewhere on the board
/AC_L: R55.1; also elsewhere on the board
/AC_ZC: R57.2, R58.2, U6.13; also elsewhere on the board
/ADC_HI: C31.1, R47.2; also elsewhere on the board
/ADC_LO: C30.1, R46.2; also elsewhere on the board
/CurrentSense/SA_N: C26.1, R38.2, R39.1, U8.2 (-)
/CurrentSense/SA_P: C27.1, R40.2, R41.1, U8.3 (+)
/CurrentSense/SB_N: C28.1, R42.2, R43.1, U8.6 (-)
/CurrentSense/SB_P: C29.1, R44.2, R45.1, U8.5 (+)
/CurrentSense/ZC_CLAMP: D9.3 (COM), R55.2, R88.1
/CurrentSense/ZC_DIV: C34.1, R56.1, R57.1, R88.2, U6.11 (+)
/ISENSE_HI: C28.2, R43.2, R47.1, U8.7; also elsewhere on the board
/ISENSE_LO: C26.2, R39.2, R46.1, U8.1; also elsewhere on the board
/ISNS: R37.1, R38.1, R42.1; also elsewhere on the board
/VB: C27.2, C29.2, C32.1, R41.2, R45.2, R49.2, R50.1; also elsewhere on the board
/VH: R48.2, R49.1; also elsewhere on the board
/VL: R50.2, R51.1, U6.10 (-); also elsewhere on the board
GND: C25.2, C30.2, C31.2, C32.2, C34.2, D9.1 (A), R37.2, R40.1, R44.1, R51.2, R56.2, U8.4 (V-); also elsewhere on the board

Notes on the sheet:
Bias and trip thresholds
Mains zero-cross and presence detector
CURRENT MEASUREMENT (hardware design section 10). R37 0.1R 1 % 2 W carries the return current of every valve: ISNS is the common T1 node of all triacs. 0.23 W at 1.5 A rms. A 20 A short lifts ISNS to 2.8 V for a half-cycle; the 7.5k input resistors keep that inside the op-amp's 2 mA input limit. U8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
THRESHOLDS (section 9.1). VH 1.425 V, VB 0.806 V, VL 0.188 V: trip at 0.619 V / 0.1333 V/A = 4.64 A peak. ZERO-CROSS (section 11). R55, R88, R56 divide AC_L by 12. D9 clamps; R88 halves the clamped level so the LM2901 input stays above -0.3 V (-0.18 V at -20 C and 32 VAC). U6D compares with VL; R57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
Shunt and two difference amplifiers, both biased at VB

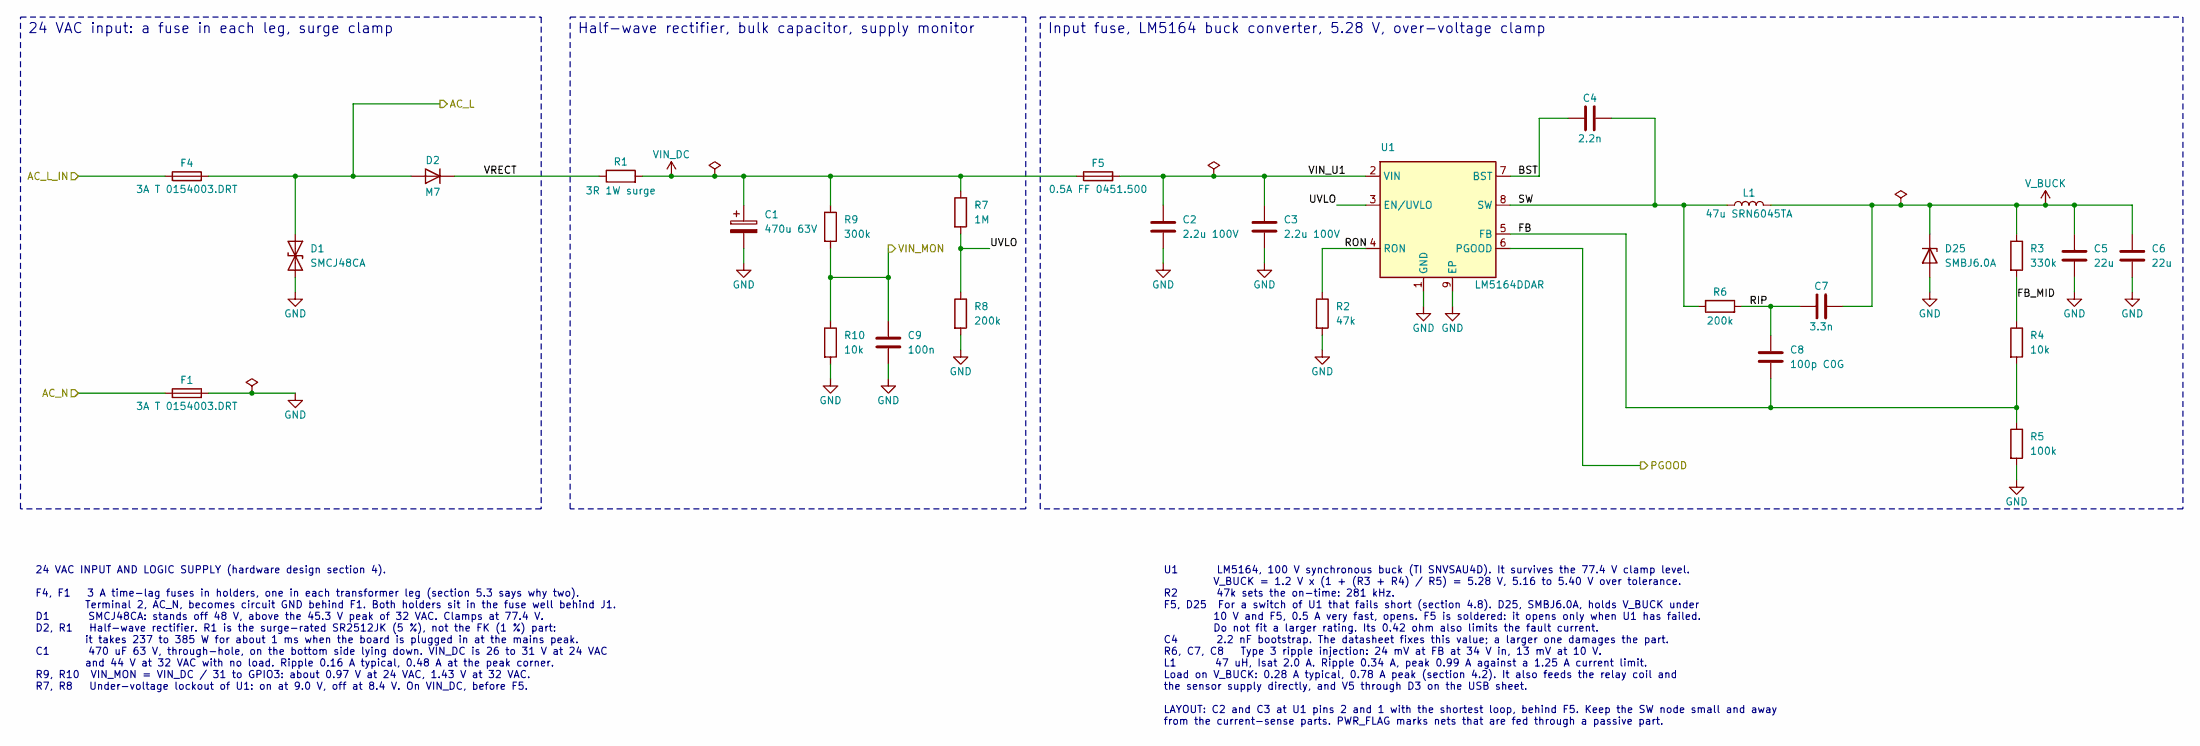
[picture p287: schematic power.kicad_sch, 24 VAC input and logic supply]

Parts:
C1: 470u 63V; CP_Radial_D12.5mm_L20mm_P5.00mm_LyingDown; MPN 63ZLJ470M12.5X20; LCSC C2940725
C2, C3: 2.2u 100V; C_1210_3225Metric; MPN CL32B225KCJSNNE; LCSC C55151
C4: 2.2n; C_0603_1608Metric; MPN 0603B222K500NT; LCSC C1604
C5, C6: 22u; C_1206_3216Metric; MPN CL31A226KAHNNNE; LCSC C12891
C7: 3.3n; C_0603_1608Metric; MPN CL10B332KB8NNNC; LCSC C1613
C8: 100p C0G; C_0603_1608Metric; MPN CL10C101JB8NNNC; LCSC C14858
C9: 100n; C_0603_1608Metric; MPN CC0603KRX7R9BB104; LCSC C14663
D1: SMCJ48CA; D_SMC; MPN SMCJ48CA; LCSC C151287
D2: M7; D_SMA; MPN M7; LCSC C95872
D25: SMBJ6.0A; D_SMB; MPN SMBJ6.0A; LCSC C83270
F1, F4: 3A T 0154003.DRT; Fuseholder_Littelfuse_Nano2_154x; MPN 0154003.DRT; LCSC C206913
F5: 0.5A FF 0451.500; Fuse_Littelfuse-NANO2-451_453; MPN 0451.500MRL; LCSC C142836
L1: 47u SRN6045TA; L_Bourns_SRN6045TA; MPN SRN6045TA-470M; LCSC C5151734
R1: 3R 1W surge; R_2512_6332Metric; MPN SR2512JK-073RL; LCSC C2936639
R2: 47k; R_0603_1608Metric; MPN 0603WAF4702T5E; LCSC C25819
R3: 330k; R_0603_1608Metric; MPN 0603WAF3303T5E; LCSC C23137
R4, R10: 10k; R_0603_1608Metric; MPN 0603WAF1002T5E; LCSC C25804
R5: 100k; R_0603_1608Metric; MPN 0603WAF1003T5E; LCSC C25803
R6, R8: 200k; R_0603_1608Metric; MPN 0603WAF2003T5E; LCSC C25811
R7: 1M; R_0603_1608Metric; MPN 0603WAF1004T5E; LCSC C22935
R9: 300k; R_0603_1608Metric; MPN 0603WAF3003T5E; LCSC C23024
U1: LM5164DDAR; TI_SO-PowerPAD-8; MPN LM5164DDAR; LCSC C477928

Connections:
/AC_L: D1.1 (A1), D2.2 (A), F4.2; also elsewhere on the board
/AC_L_IN: F4.1; also elsewhere on the board
/AC_N: F1.1; also elsewhere on the board
/PGOOD: U1.6 (PGOOD); also elsewhere on the board
/Power/BST: C4.1, U1.7 (BST)
/Power/FB: C8.2, R4.2, R5.1, U1.5 (FB)
/Power/FB_MID: R3.2, R4.1
/Power/RIP: C7.1, C8.1, R6.2
/Power/RON: R2.1, U1.4 (RON)
/Power/SW: C4.2, L1.1, R6.1, U1.8 (SW)
/Power/UVLO: R7.2, R8.1, U1.3 (EN/UVLO)
/Power/VIN_U1: C2.1, C3.1, F5.2, U1.2 (VIN)
/Power/VRECT: D2.1 (K), R1.1
/VIN_MON: C9.1, R9.2, R10.1; also elsewhere on the board
GND: C1.2, C2.2, C3.2, C5.2, C6.2, C9.2, D1.2 (A2), D25.2 (A), F1.2, R2.2, R5.2, R8.2, R10.2, U1.1 (GND), U1.9 (EP); also elsewhere on the board
VIN_DC: C1.1, F5.1, R1.2, R7.1, R9.1; also elsewhere on the board
V_BUCK: C5.1, C6.1, C7.2, D25.1 (K), L1.2, R3.1; also elsewhere on the board

Notes on the sheet:
Half-wave rectifier, bulk capacitor, supply monitor
U1 LM5164, 100 V synchronous buck (TI SNVSAU4D). It survives the 77.4 V clamp level. V_BUCK = 1.2 V x (1 + (R3 + R4) / R5) = 5.28 V, 5.16 to 5.40 V over tolerance. R2 47k sets the on-time: 281 kHz. F5, D25 For a switch of U1 that fails short (section 4.8). D25, SMBJ6.0A, holds V_BUCK under 10 V and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
Input fuse, LM5164 buck converter, 5.28 V, over-voltage clamp
24 VAC INPUT AND LOGIC SUPPLY (hardware design section 4). F4, F1 3 A time-lag fuses in holders, one in each transformer leg (section 5.3 says why two). Terminal 2, AC_N, becomes circuit GND behind F1. Both holders sit in the fuse well behind J1. D1 SMCJ48CA: stands off 48 V, above the 45.3 V peak 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
24 VAC input: a fuse in each leg, surge clamp

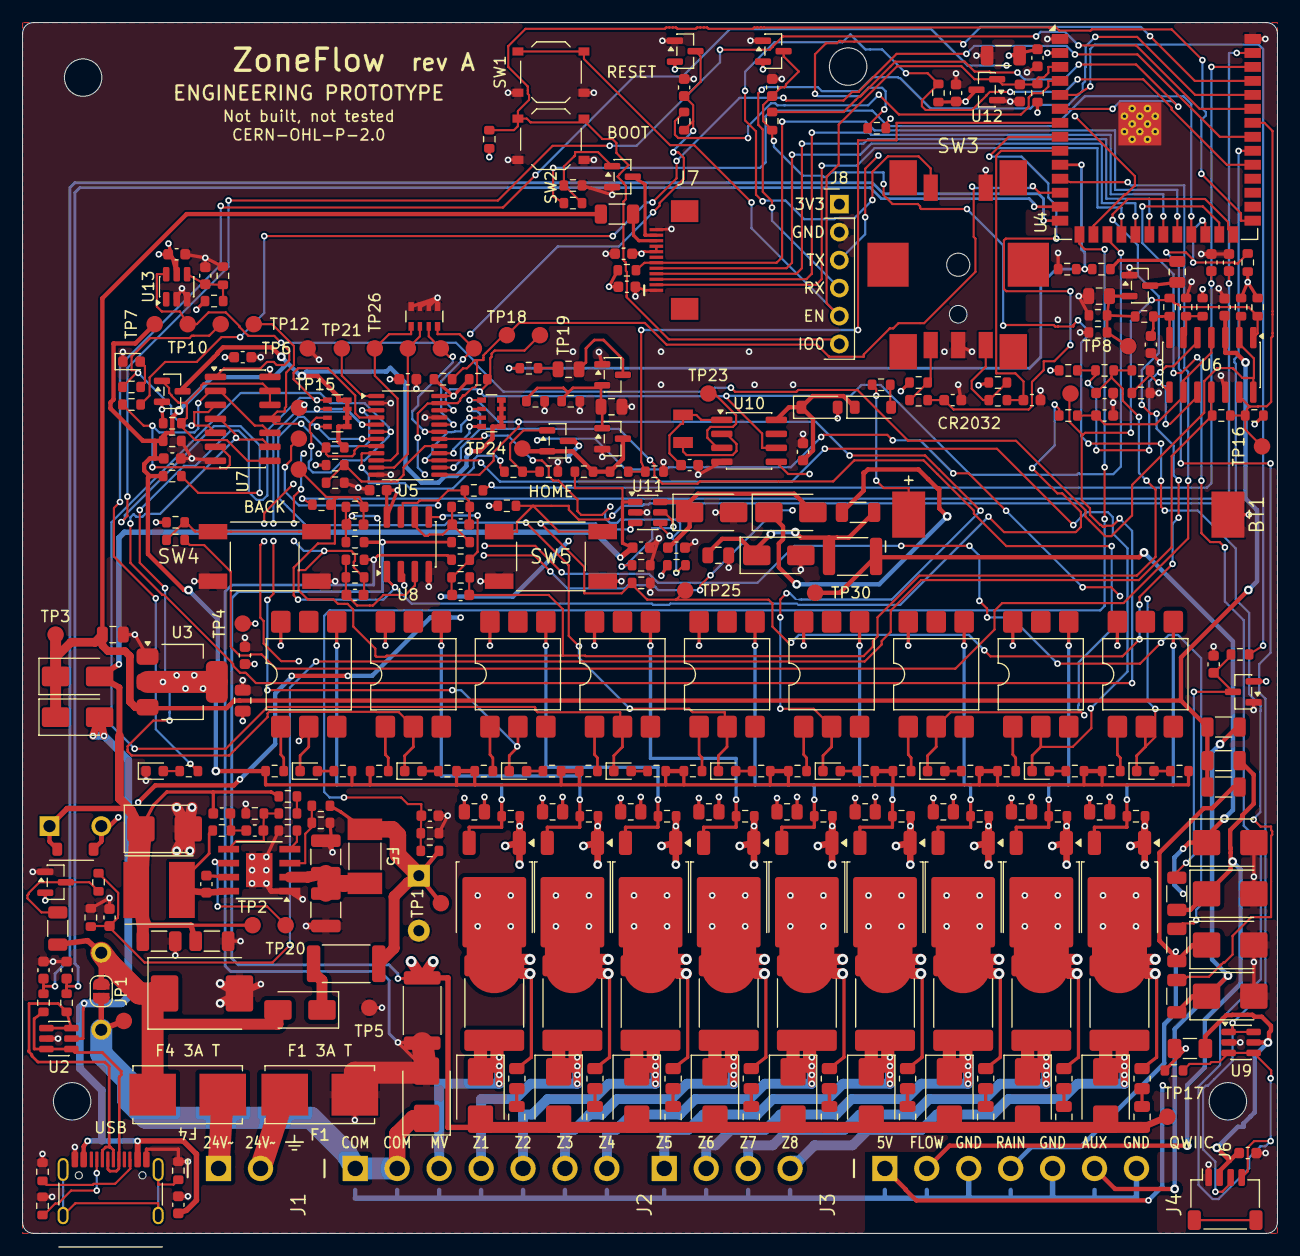
[picture p288: board zoneflow-a.kicad_pcb from above]

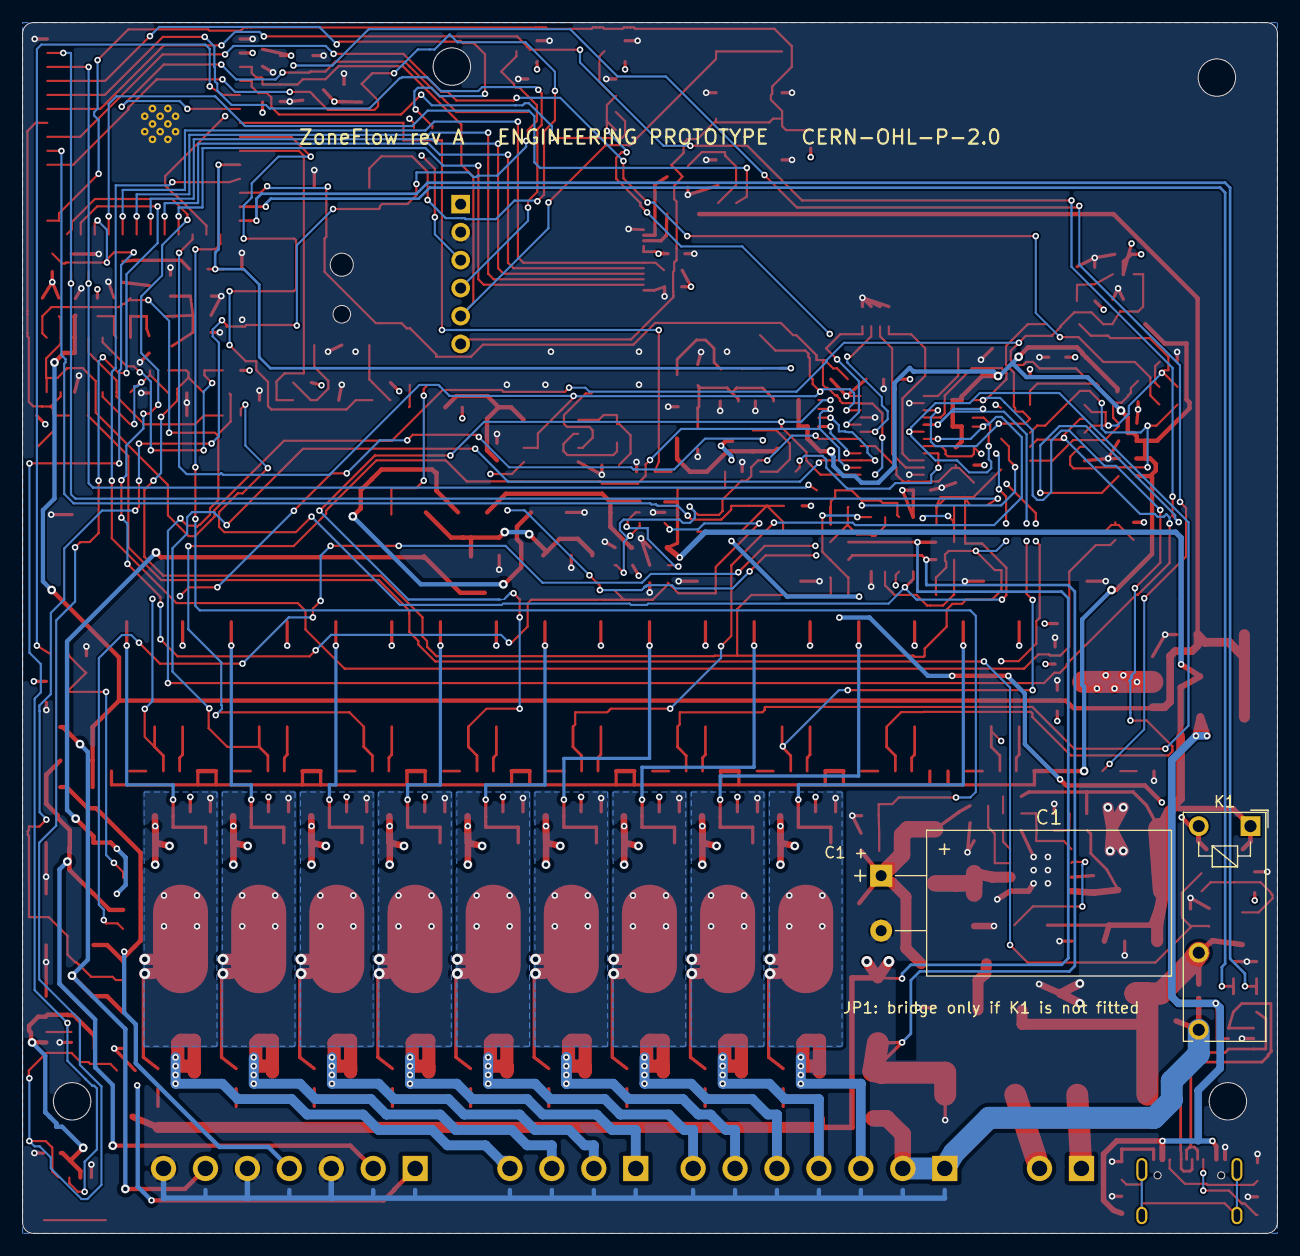
[picture p289: board zoneflow-a.kicad_pcb from below]

Board: 4 copper layers, 114.0 x 110.0 mm, 351 parts (2 on the bottom side), 198 nets.
