syntroniks/zoneflow/hardware/toolchain-test/toolchain_test.kicad_pcb

## KiCad design hardware/toolchain-test/toolchain_test.kicad_pcb (2026-11-11)

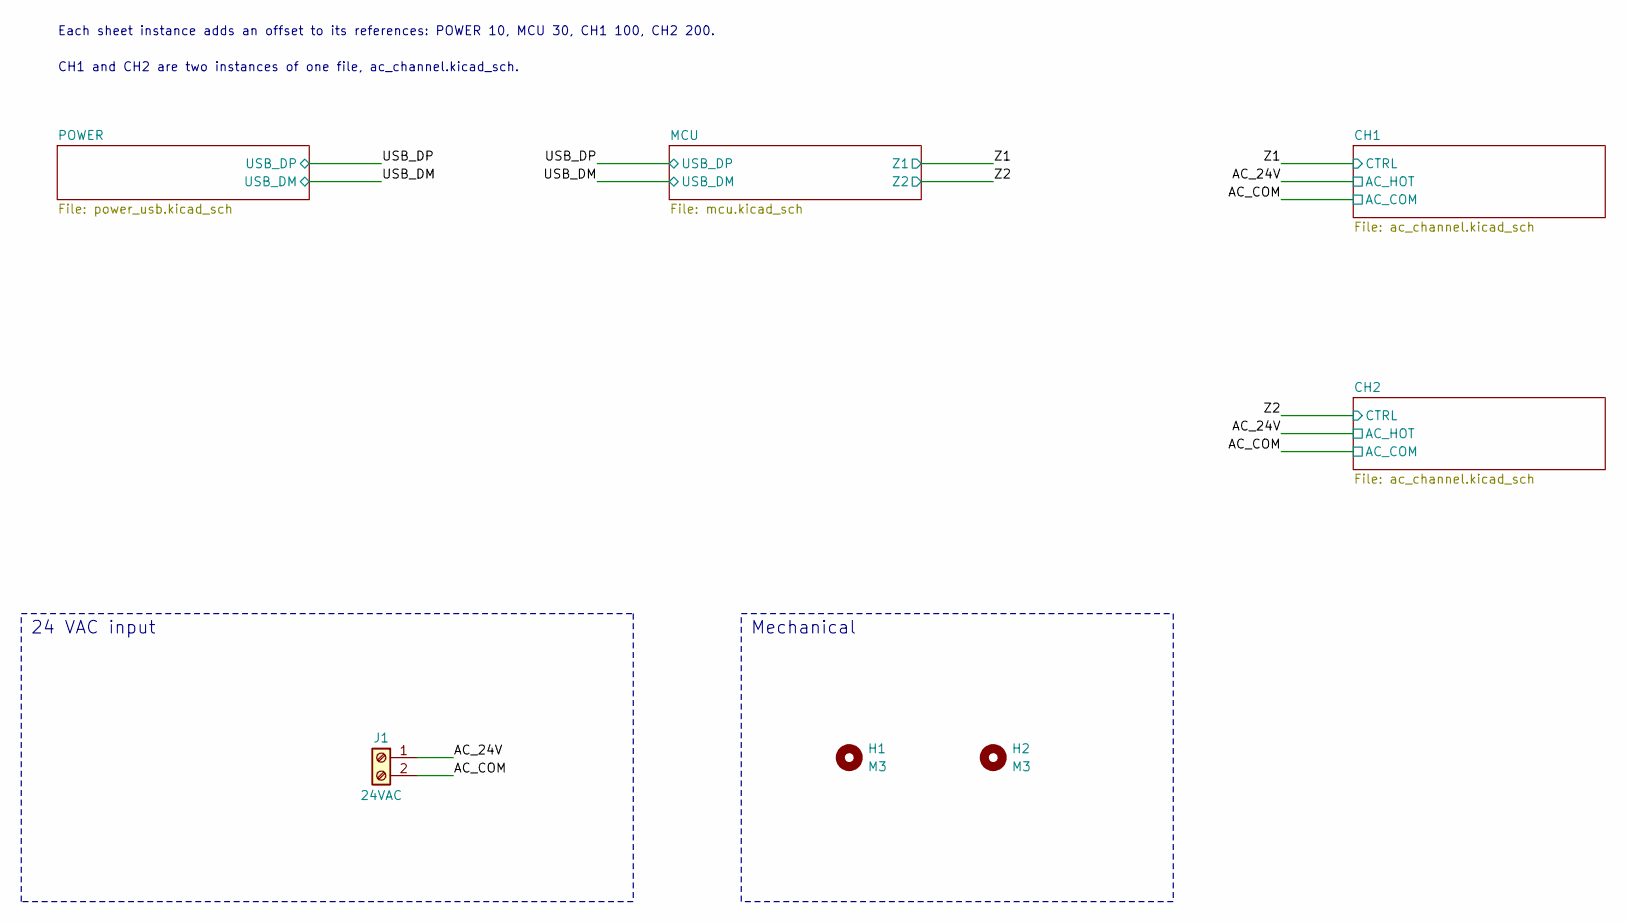
[picture p290: schematic toolchain_test.kicad_sch, ZoneFlow hardware toolchain test]

Parts:
H1, H2: M3; MountingHole_3.2mm_M3
J1: 24VAC; TerminalBlock_Phoenix_MKDS-1,5-2-5.08_1x02_P5.08mm_Horizont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; LCSC C474952

Connections:
/AC_24V: J1.1; also elsewhere on the board
/AC_COM: J1.2; also elsewhere on the board

Notes on the sheet:
24 VAC input
Each sheet instance adds an offset to its references: POWER 10, MCU 30, CH1 100, CH2 200.
Mechanical
CH1 and CH2 are two instances of one file, ac_channel.kicad_sch.

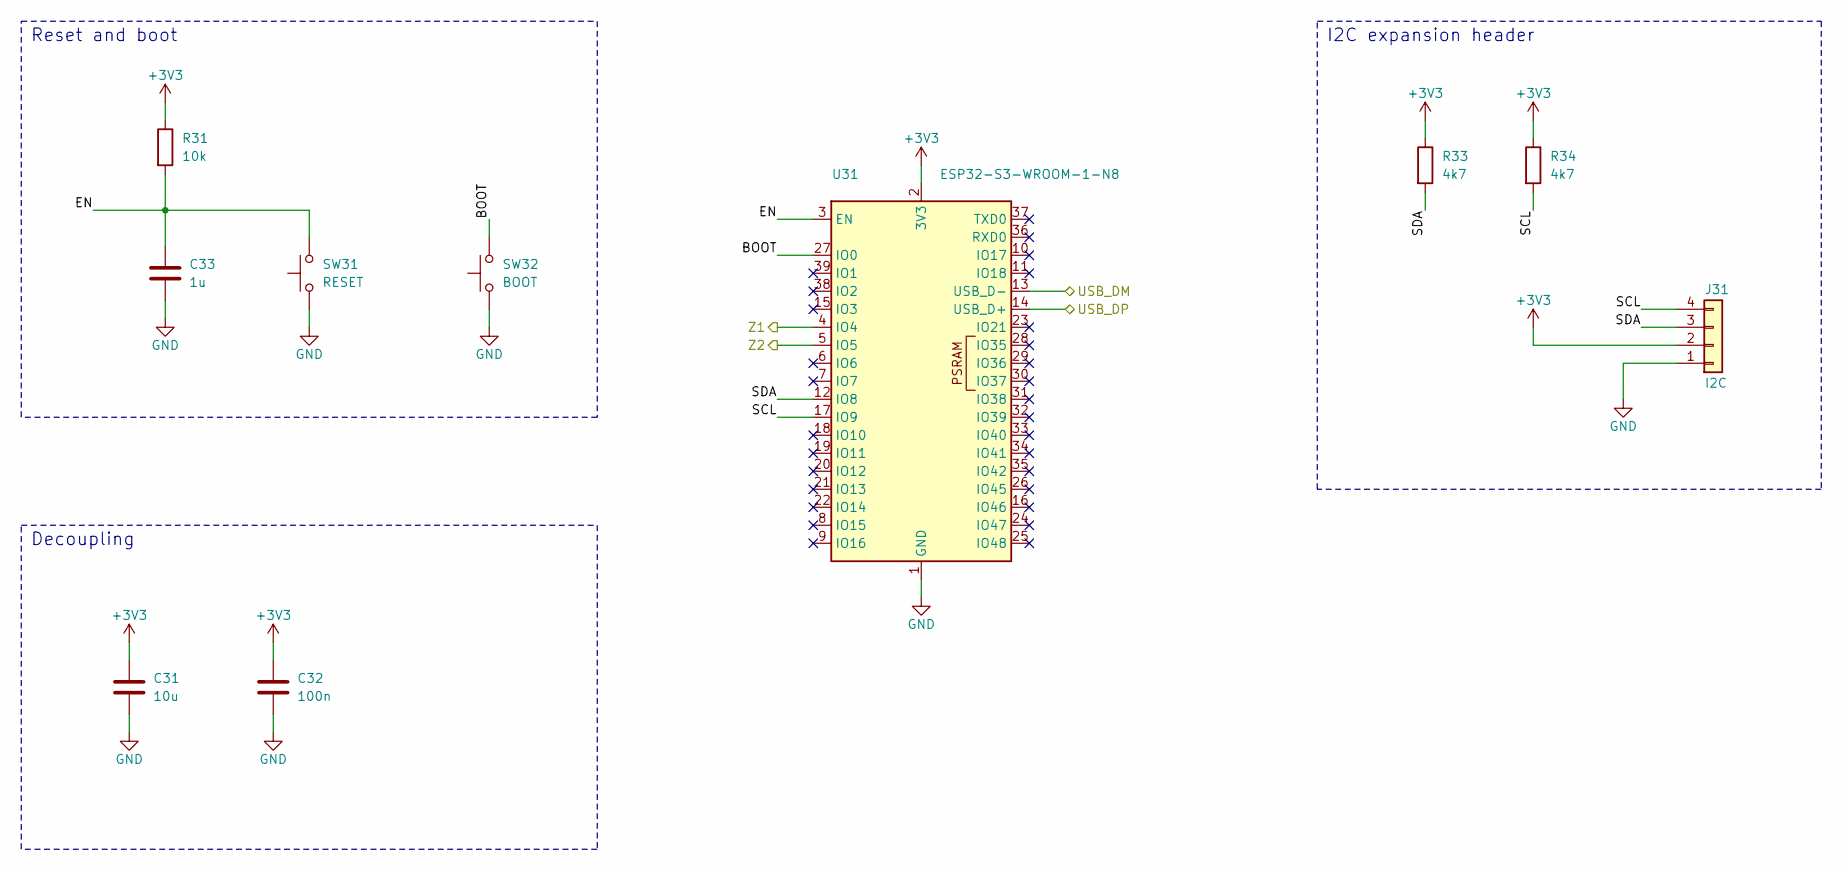
[picture p291: schematic mcu.kicad_sch, ESP32-S3 module, reset, boot, I2C]

Parts:
C31: 10u; C_0805_2012Metric; LCSC C15850
C32: 100n; C_0603_1608Metric; LCSC C14663
C33: 1u; C_0603_1608Metric; LCSC C15849
J31: I2C; PinHeader_1x04_P2.54mm_Vertical; LCSC C2905435
R31: 10k; R_0603_1608Metric; LCSC C25804
R33, R34: 4k7; R_0603_1608Metric; LCSC C23162
SW31: RESET; SW_SPST_TL3342; LCSC C2886898
SW32: BOOT; SW_SPST_TL3342; LCSC C2886898
U31: ESP32-S3-WROOM-1-N8; ESP32-S3-WROOM-1; LCSC C2913198

Connections:
+3V3: C31.1, C32.1, J31.2, R31.1, R33.1, R34.1, U31.2 (3V3); also elsewhere on the board
/MCU/BOOT: SW32.2, U31.27 (IO0)
/MCU/EN: C33.1, R31.2, SW31.2, U31.3 (EN)
/MCU/SCL: J31.4, R34.2, U31.17 (IO9)
/MCU/SDA: J31.3, R33.2, U31.12 (IO8)
/USB_DM: U31.13 (USB_D-); also elsewhere on the board
/USB_DP: U31.14 (USB_D+); also elsewhere on the board
/Z1: U31.4 (IO4); also elsewhere on the board
/Z2: U31.5 (IO5); also elsewhere on the board
GND: C31.2, C32.2, C33.2, J31.1, SW31.1, SW32.1, U31.1 (GND), U31.40 (GND), U31.41 (GND); also elsewhere on the board

Notes on the sheet:
Reset and boot
I2C expansion header
Decoupling

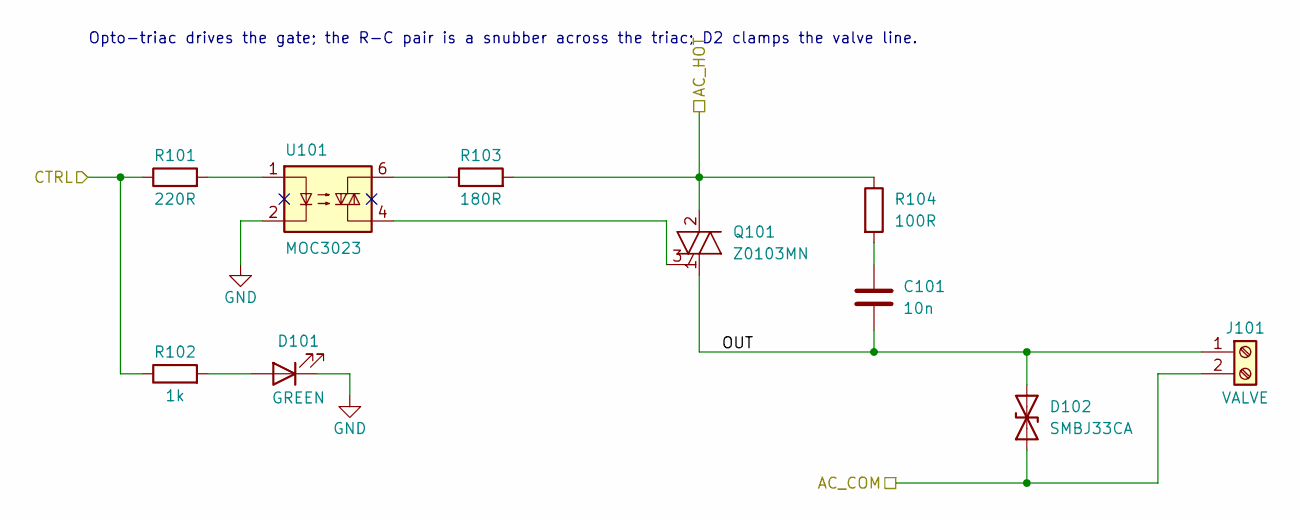
[picture p292: schematic ac_channel.kicad_sch, Isolated 24 VAC output channel]

Parts:
C101: 10n; C_0805_2012Metric; LCSC C1710
D101: GREEN; LED_0603_1608Metric; LCSC C72043
D102: SMBJ33CA; D_SMB; LCSC C78420
J101: VALVE; TerminalBlock_Phoenix_MKDS-1,5-2-5.08_1x02_P5.08mm_Horizont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; LCSC C474952
Q101: Z0103MN; SOT-223; LCSC C163595
R101: 220R; R_0603_1608Metric; LCSC C22962
R102: 1k; R_0603_1608Metric; LCSC C21190
R103: 180R; R_0603_1608Metric; LCSC C22828
R104: 100R; R_1206_3216Metric; LCSC C17901
U101: MOC3023; SMDIP-6_W9.53mm; LCSC C115469

Connections:
/AC_24V: Q101.2 (A2), Q101.4 (A4), R103.2, R104.1; also elsewhere on the board
/AC_COM: D102.1 (A1), J101.2; also elsewhere on the board
/CH1/OUT: C101.2, D102.2 (A2), J101.1, Q101.1 (A1)
/Z1: R101.1, R102.1; also elsewhere on the board
GND: D101.1 (K), U101.2; also elsewhere on the board
unnamed: C101.1, R104.2
unnamed: D101.2 (A), R102.2
unnamed: Q101.3 (G), U101.4
unnamed: R101.2, U101.1
unnamed: R103.1, U101.6

Parts of its further copies:
C201: 10n; C_0805_2012Metric; LCSC C1710
D201: GREEN; LED_0603_1608Metric; LCSC C72043
D202: SMBJ33CA; D_SMB; LCSC C78420
J201: VALVE; TerminalBlock_Phoenix_MKDS-1,5-2-5.08_1x02_P5.08mm_Horizont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; LCSC C474952
Q201: Z0103MN; SOT-223; LCSC C163595
R201: 220R; R_0603_1608Metric; LCSC C22962
R202: 1k; R_0603_1608Metric; LCSC C21190
R203: 180R; R_0603_1608Metric; LCSC C22828
R204: 100R; R_1206_3216Metric; LCSC C17901
U201: MOC3023; SMDIP-6_W9.53mm; LCSC C115469

Connections of its further copies:
/AC_24V: Q201.2 (A2), Q201.4 (A4), R203.2, R204.1; also elsewhere on the board
/AC_COM: D202.1 (A1), J201.2; also elsewhere on the board
/CH2/OUT: C201.2, D202.2 (A2), J201.1, Q201.1 (A1)
/Z2: R201.1, R202.1; also elsewhere on the board
GND: D201.1 (K), U201.2; also elsewhere on the board
unnamed: C201.1, R204.2
unnamed: D201.2 (A), R202.2
unnamed: Q201.3 (G), U201.4
unnamed: R201.2, U201.1
unnamed: R203.1, U201.6

Notes on the sheet:
Opto-triac drives the gate; the R-C pair is a snubber across the triac; D2 clamps the valve line.

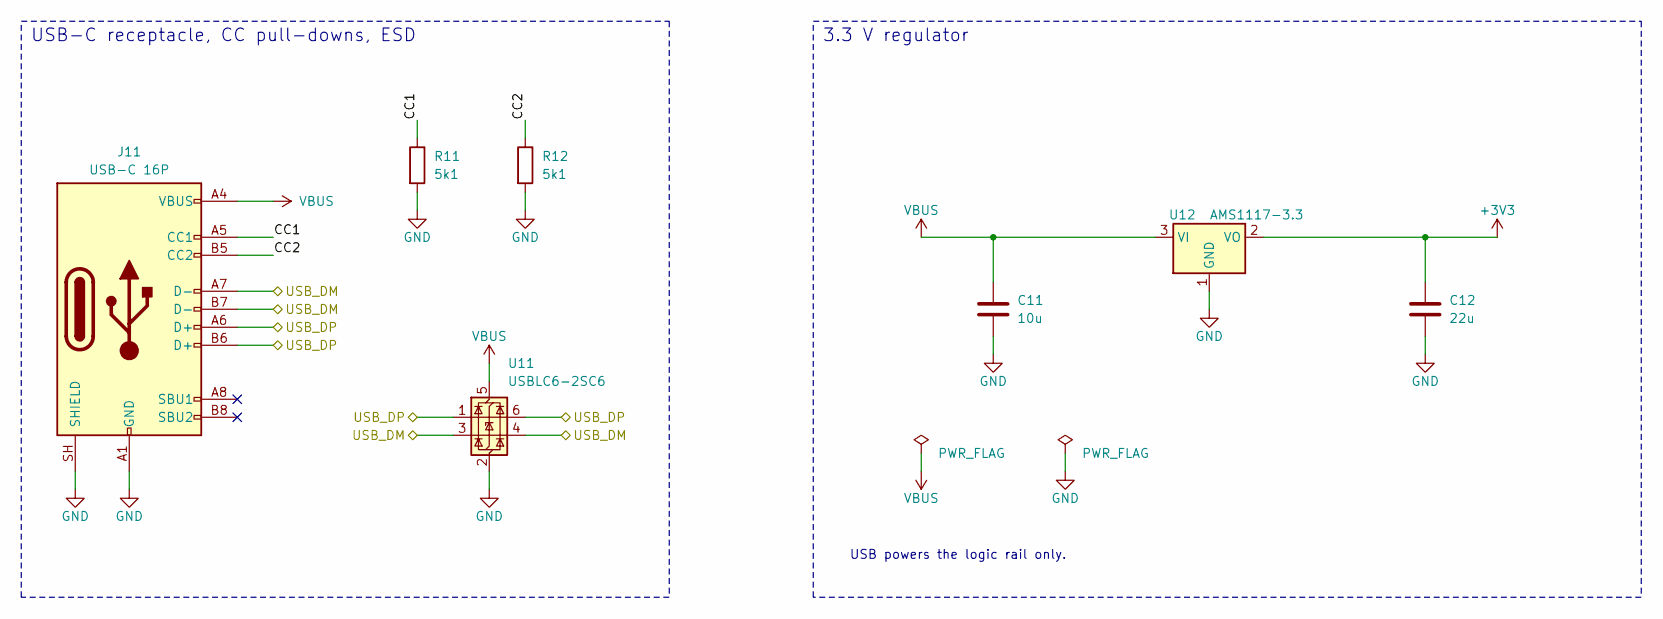
[picture p293: schematic power_usb.kicad_sch, USB-C input and 3.3 V regulator]

Parts:
C11: 10u; C_0805_2012Metric; LCSC C15850
C12: 22u; C_0805_2012Metric; LCSC C45783
J11: USB-C 16P; USB_C_Receptacle_HRO_TYPE-C-31-M-12; LCSC C165948
R11, R12: 5k1; R_0603_1608Metric; LCSC C23186
U11: USBLC6-2SC6; SOT-23-6; LCSC C7519
U12: AMS1117-3.3; SOT-223-3_TabPin2; LCSC C6186

Connections:
+3V3: C12.1, U12.2 (VO); also elsewhere on the board
/POWER/CC1: J11.A5 (CC1), R11.1
/POWER/CC2: J11.B5 (CC2), R12.1
/USB_DM: J11.A7 (D-), J11.B7 (D-), U11.3 (I/O2), U11.4 (I/O2); also elsewhere on the board
/USB_DP: J11.A6 (D+), J11.B6 (D+), U11.1 (I/O1), U11.6 (I/O1); also elsewhere on the board
GND: C11.2, C12.2, J11.A1 (GND), J11.A12 (GND), J11.B1 (GND), J11.B12 (GND), J11.SH (SHIELD), R11.2, R12.2, U11.2 (GND), U12.1 (GND); also elsewhere on the board
VBUS: C11.1, J11.A4 (VBUS), J11.A9 (VBUS), J11.B4 (VBUS), J11.B9 (VBUS), U11.5 (VBUS), U12.3 (VI)

Notes on the sheet:
USB-C receptacle, CC pull-downs, ESD
3.3 V regulator
USB powers the logic rail only.

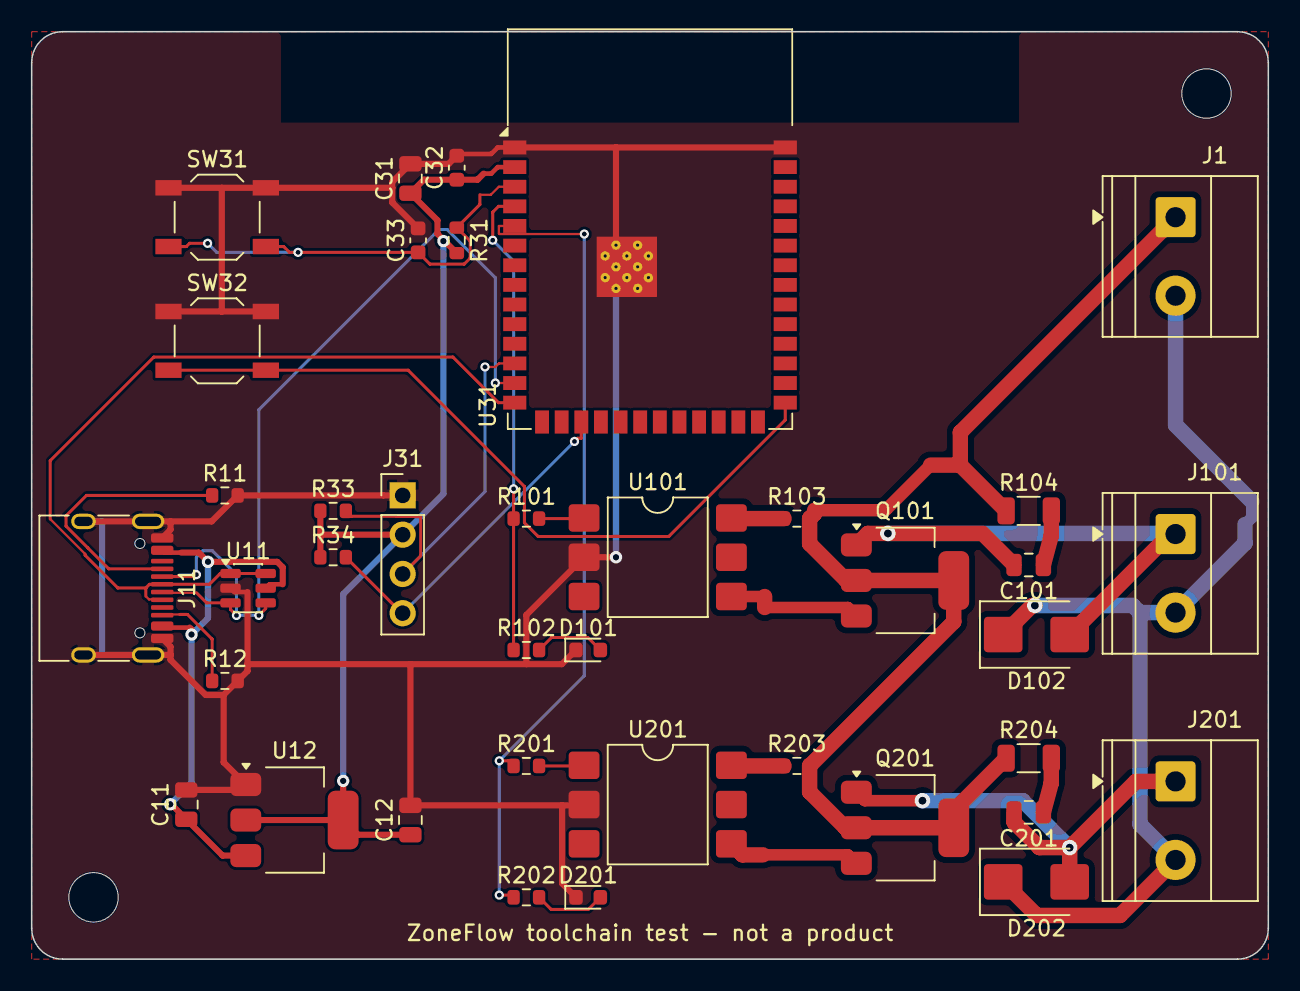
[picture p294: board toolchain_test.kicad_pcb from above]

Board: 2 copper layers, 80.0 x 60.0 mm, 40 parts (0 on the bottom side), 27 nets.
