syntroniks/zoneflow/hardware/zoneflow-a/design/layout.py

# SPDX-License-Identifier: CERN-OHL-P-2.0
"""Writes design/board.toml for ZoneFlow rev A: placement, hand-routed copper, zones, silkscreen.

Run by ``make`` before anything reads board.toml. The board description of this board is not
typed by hand, because most of it repeats or is computed: nine output columns, nine LED cells,
the fan-out lanes of the valve outputs, eighteen gate lines, a bus with eighteen stubs. This
script is the source; ``board.toml`` is what it writes and what the board builder reads, and is
committed so that a reviewer can read the numbers without running anything.

    python design/layout.py <board directory>

Board coordinates are those of the mechanical contract, hardware/mechanical.yaml: origin at the
bottom-left corner seen from the component side, x right, y up. The reasons for every choice here
are in docs/design/hardware-layout.md.

Only the standard library is used.
"""

import math
import sys
from pathlib import Path

HEAD = '''# Board description for ZoneFlow rev A. Lengths in millimetres.
#
# WRITTEN BY design/layout.py. Do not edit: change layout.py and run make.
#
# Board coordinates are those of the mechanical contract, hardware/mechanical.yaml:
# origin at the bottom-left corner of the outline seen from the component side,
# x to the right along the terminal edge, y up towards the antenna. Rotation is
# counter-clockwise seen from the top side.
#
# The reasons for the placement, the widths and the routing are in
# docs/design/hardware-layout.md. No board has been made.

# Net classes, in order of priority. circuit.py assigns nets to them (NETCLASS).
[netclass.Default]
track_width = 0.2
clearance = 0.2
via_diameter = 0.6
via_drill = 0.3

# 24 VAC paths that carry valve or supply current. Trunks are wider; see [[track]].
[netclass.AC24]
track_width = 1.0
clearance = 0.5
via_diameter = 1.0
via_drill = 0.5

# The shunt node. It carries the valve current back and is within 3 V of ground, so it may come
# closer to ground than a 24 VAC net may. Against a 24 VAC net the larger clearance applies.
[netclass.Shunt]
track_width = 1.0
clearance = 0.25
via_diameter = 1.0
via_drill = 0.5

# At 24 VAC potential, milliamps: gates, opto outputs, snubber mid-points.
[netclass.AC24S]
track_width = 0.3
clearance = 0.5
via_diameter = 0.6
via_drill = 0.3

# Rectified input, up to 45 V, and the buck converter's switch node.
[netclass.HVDC]
track_width = 0.5
clearance = 0.4
via_diameter = 0.8
via_drill = 0.4

# Sensor terminals and the sensor supply output.
[netclass.Field]
track_width = 0.4
clearance = 0.5
via_diameter = 0.8
via_drill = 0.4

[netclass.Power]
track_width = 0.4
clearance = 0.2
via_diameter = 0.8
via_drill = 0.4

[netclass.USB]
track_width = 0.25
clearance = 0.2
via_diameter = 0.6
via_drill = 0.3

# The high-impedance nodes of the two keep-alive detectors. Nothing is routed within 0.6 mm of
# them; design/rules.kicad_dru lets their own pads sit at the usual distance.
[netclass.HiZ]
track_width = 0.25
clearance = 0.6
via_diameter = 0.6
via_drill = 0.3

[board]
origin = [90.0, 50.0]    # where the outline's top-left corner sits on the KiCad page
size = [114.0, 110.0]    # mechanical contract, board.outline
y_up = true
corner_radius = 1.0      # the contract allows up to 1.5
layers = 4
thickness = 1.6
'''

place: dict[str, tuple] = {}
notes: list[tuple[str, list[str]]] = []   # (comment, refs) in output order
_cur: list[str] = []


def block(title):
    """Start a group of placements with a comment that goes into board.toml above them."""
    global _cur
    _cur = []
    notes.append((title, _cur))


def at(ref, x, y, rot=0, side="F"):
    if ref in place:
        raise SystemExit(f"{ref} placed twice")
    place[ref] = (round(x, 3), round(y, 3), rot, side)
    _cur.append(ref)


def row(refs, x, y, dx=3.1, rot=0, dy=0.0):
    for i, r in enumerate(refs.split()):
        at(r, x + i * dx, y + i * dy, rot)


def col(refs, x, y, dy=-1.6, rot=0):
    for i, r in enumerate(refs.split()):
        at(r, x, y + i * dy, rot)


# =============================================================================================
# Placement
# =============================================================================================
# ---- fixed by the mechanical contract ------------------------------------------------------
block("Fixed by hardware/mechanical.yaml, revision 2. The mechanical check compares these.")
at("J5", 8.0, 2.675, 0)
at("J1", 17.805, 5.9, 0)
at("J2", 30.225, 5.9, 0)
at("J3", 58.295, 5.9, 0)
at("J4", 78.335, 5.9, 0)
at("J6", 109.25, 3.08, 0)      # 1.0 mm further in than contract revision 2: see hardware-layout.md
at("F4", 15.0, 12.6, 180)      # pad 1, AC_L_IN, towards J1 pin 1
at("F1", 27.0, 12.6, 0)        # pad 1, AC_N, towards J1 pin 2
at("D6", 12.0, 42.0, 0)
at("SW4", 22.0, 61.5, 0)
at("SW5", 48.0, 61.5, 0)
at("SW3", 85.0, 88.0, 0)
at("J7", 60.44, 88.43, 0)
at("U4", 103.0, 103.25, 0)
at("C1", 36.0, 30.0, 180, "B")    # can towards -x; pad 1 (+) at y = 32.5
at("H1", 5.5, 105.0, 0)
at("H2", 75.0, 106.0, 0)
at("H3", 4.5, 12.0, 0)
at("H4", 109.5, 12.0, 0)
block("Free by the contract, positions chosen here.\nBT1: 1.3 mm above the reserved position, to clear the opto row, turned so that + is at the left.\nK1: under the left edge, long axis along y, contacts at the bottom, coil at the top.")
at("BT1", 95.0, 65.3, 180)
at("K1", 2.45, 37.0, 270, "B")

# ---- left edge: USB, relay pads, zero-cross clamp. Low parts only near the relay pins --------
block("USB-C: CC pull-downs beside the receptacle, VBUS capacitor and shield resistor on its right.")
at("R15", 1.81, 2.5, 90)
at("R16", 1.81, 5.6, 90)
at("C13", 14.15, 2.6, 90)
at("R17", 14.15, 5.7, 90)
at("U2", 3.3, 17.7, 0)         # 0.3 mm left of where it was: room for the VBUS stub beside pins 4 to 6
block("USB series resistors and the pads of the unfitted filter capacitors, above the ESD array.\nFrom their upper ends the pair runs on the bottom side to the module.")
at("R97", 1.9, 20.95, 90)      # D+
at("C52", 1.9, 23.92, 90)
at("R98", 4.0, 20.95, 90)      # D-
at("C53", 4.0, 23.92, 90)
block("Around the relay pins (K1 is on the bottom side): solder jumper across the contacts,\ncoil diode, and the zero-cross clamp fed from AC_L. Nothing here is taller than 1.5 mm.")
at("JP1", 7.15, 22.0, 270)
at("TP22", 9.2, 19.3, 0)
at("R55", 3.2, 27.7, 90)
at("R56", 6.2, 28.7, 90)
at("C34", 7.9, 28.7, 90)
at("D9", 3.0, 31.9, 0)
at("R88", 6.9, 31.9, 90)
at("D5", 4.8, 34.9, 0)

# ---- power entry, above the fuse well ---------------------------------------------------------
block("Power entry: surge clamp, rectifier, surge resistor. C1 is under this area, on the bottom.")
at("D1", 16.3, 21.8, 0)
at("D2", 25.2, 20.3, 180)
at("R1", 29.4, 24.5, 0)
block("Buck converter. From the right: C1 (bottom side), the fuse F5 on end, the input capacitors C2 and C3\nat pins 1 and 2, U1, the bootstrap capacitor at pins 7 and 8, the inductor. F5 is 3.5 mm from the\npads of C1, which are soldered from this side.")
at("F5", 31.1, 34.255, 270)    # pad 1, VIN_DC, at the top; pad 2, VIN_U1, level with the capacitor pads
at("C2", 27.55, 29.4, 270)
at("C3", 27.55, 34.2, 90)
at("U1", 21.5, 33.0, 180)
at("C4", 16.7, 31.73, 270)
at("L1", 12.4, 31.2, 180)
block("Buck output: C6 under the output pad of L1, C5 beside it, and the clamp D25 above the pad.")
at("C6", 12.4, 26.55, 0)
at("C5", 17.2, 26.55, 0)
at("D25", 12.9, 36.75, 0)      # cathode, V_BUCK, above the output pad of L1
block("Feedback and ripple network above U1, at the FB pin. R2 at the RON pin. Under-voltage divider\nR7, R8 beside F5: it stays on VIN_DC, before the fuse.")
at("R6", 18.1, 36.6, 0)
at("C8", 21.1, 36.6, 0)
at("R2", 24.1, 36.6, 180)
at("C7", 18.1, 38.15, 180)
at("R5", 21.1, 38.15, 180)
at("R4", 24.1, 38.15, 180)
at("R3", 24.1, 39.7, 0)
at("R8", 27.1, 37.3, 0)
at("R7", 27.1, 38.85, 180)
at("TP20", 23.9, 28.0, 0)
at("TP2", 20.9, 28.0, 0)
block("Between the fuse well and the channel columns: valve-common TVS, shunt, and the input monitor\ndivider around the pads of C1. Only low parts within 2.5 mm of those pads.")
at("D23", 36.7, 12.6, 90)
at("R37", 36.3, 20.25, 270)
at("TP17", 104.0, 10.6, 0)     # ISNS, at the far end of the strip
at("TP1", 38.0, 30.0, 0)
at("R9", 37.0, 34.75, 180)     # the tap at the left, in line with R10 and C9
at("R10", 37.0, 36.35, 0)
at("C9", 37.0, 37.95, 0)

# ---- right edge ---------------------------------------------------------------------------------
block("Qwiic: ESD array and PTC at the connector.")
at("C17", 111.3, 7.3, 0)
at("F2", 106.05, 16.8, 0)
at("R24", 104.6, 14.8, 0)       # Qwiic pull-up; the other one, R23, is at the module
at("U9", 110.7, 17.35, 0)
block("Sensor terminals: TVS and series resistor of each input, sensor supply TVS, pull-ups.")
at("R81", 104.86, 21.55, 90)
at("D14", 109.71, 21.55, 0)
at("R75", 104.86, 26.2, 90)
at("D12", 109.71, 26.2, 0)
at("R78", 104.86, 30.85, 90)
at("D13", 109.71, 30.85, 0)
at("D18", 109.71, 35.5, 0)
at("R74", 109.1, 40.55, 0)
at("R77", 109.1, 42.95, 0)
at("R80", 109.1, 46.0, 0)

# ---- band above the LED row, left: USB power and 3.3 V regulator -------------------------------
block("5 V OR-ing diodes and the 3.3 V regulator.")
at("D4", 5.0, 46.9, 0)
at("D3", 5.0, 50.6, 0)
at("C10", 8.2, 54.4, 0)
at("U3", 14.5, 50.1, 0)
at("C11", 20.0, 48.4, 90)
at("C12", 20.2, 52.5, 90)
at("TP3", 3.0, 54.4, 0)
at("TP4", 20.0, 55.4, 0)

# ---- current-sense amplifier, between the two buttons ------------------------------------------
block("Current-sense amplifier. Channel A (low range) on the left, channel B on the right.")
at("U8", 35.0, 62.6, 90)
at("C25", 32.3, 67.52, 180)    # above pin 8 of U8, its 3.3 V pad 1.0 mm from the pin's (layout review, L3)
col("R39 C26", 30.2, 66.0, -1.6)
at("R46", 27.15, 66.2, 180)    # ADC series resistor of the low range: it gave its place above pin 8 to C25
at("R47", 41.0, 67.5, 0)        # and the one of the high range, at its amplifier output
at("R38", 30.2, 62.8, 180)     # shunt side towards the amplifier: Kelvin tracks end here
at("R40", 30.2, 61.2, 180)
col("R41 C27", 30.2, 59.6, -1.6)
col("R43 C28 R42 R44 R45 C29", 39.8, 66.0, -1.6)

# ---- sensor supply, right of the Home button ----------------------------------------------------
block("Sensor supply switch, its protection and the PTC.")
at("U11", 56.8, 65.5, 0)
at("D24", 62.6, 65.5, 0)
at("D19", 69.8, 65.5, 0)
at("R84", 75.9, 65.5, 0)
at("F3", 75.4, 61.5, 0)
at("D20", 68.7, 61.6, 0)
at("C48", 63.2, 61.6, 0)
col("C47 R83 R86", 56.2, 62.3, -1.6)
col("C49 R85", 59.4, 62.3, -1.6)
at("TP25", 60.2, 58.4, 0)
at("TP30", 72.0, 58.2, 0)

# ---- under the module ----------------------------------------------------------------------------
block("Keep-alive detector A, under the module (hardware design, section 8.5). KA comes down on the\nbottom side from module pin 10 to the via between R33 and R29, at the corner of the module.\nPump: R29, C22, D7. Reservoir KA_N2: C23, R30, R91, TP8, in one column with ground around it.\nComparator input KA_INP: R31, C24, R32, at pin 7 of U6.")
at("R33", 94.9, 87.6, 180)
at("R29", 98.0, 87.6, 0)
at("D7", 101.5, 86.1, 0)
at("C22", 104.9, 87.35, 270)
at("C23", 97.8, 85.15, 180)
at("R30", 97.7, 83.4, 180)
at("R91", 97.7, 81.85, 180)
at("TP8", 100.45, 80.6, 0)
at("R31", 101.9, 83.3, 0)
at("C24", 102.5, 80.75, 270)
at("R32", 104.2, 84.15, 90)
block("Comparators. U6 is turned so that the keep-alive input is at the pump and the zero-cross output,\nAC_ZC, is at the far corner, 12 mm from any keep-alive copper.")
at("U6", 108.0, 78.9, 270)
at("R35", 105.7, 84.15, 90)
at("R34", 107.2, 84.15, 270)
at("C19", 109.2, 84.15, 90)
at("R53", 110.7, 84.15, 270)
at("R36", 112.2, 84.15, 270)
row("R48 R49 R50", 95.0, 78.4, 3.3)      # 3.3 V end at the left, away from the reservoir test pad
at("C32", 98.3, 76.35, 0)
at("R51", 101.6, 76.35, 0)
row("R52 C33", 95.0, 74.3, 3.3)
at("R57", 108.9, 74.3, 0)
at("R58", 111.9, 74.3, 180)
at("TP9", 95.2, 76.3, 0)
at("TP16", 112.6, 71.5, 0)     # AC_ZC: at the far side from the keep-alive
block("ADC filter capacitors. The two ADC lines come up under them on the bottom side on their way\nto module pins 38 and 39, 18 mm further on: there is no room beside those pins.")
at("C31", 108.0, 88.2, 90)
at("C30", 109.6, 88.2, 90)
at("R23", 111.3, 88.2, 90)

# ---- left of the module, top edge ---------------------------------------------------------------
block("Left of the module, at the top edge: 3.3 V bulk and decoupling at pin 2, reset network and\nsupervisor at pin 3, ADC filters, encoder switch pull-up. Everything here is under 3.5 mm. The\ndisplay bus passes under the lower edge of this block on the bottom side.")
at("C15", 92.2, 106.8, 270)
at("C14", 89.1, 107.0, 180)
at("R18", 92.2, 103.6, 90)
at("C16", 90.6, 103.6, 270)
at("U12", 87.6, 103.9, 180)
at("C54", 84.8, 103.6, 90)
at("R66", 83.2, 103.6, 90)

# ---- encoder ------------------------------------------------------------------------------------
block("Encoder pull-ups and filters, below the encoder.")
row("R64 R65", 81.4, 77.3, 7.2)
row("R69 C39", 81.4, 75.7, 3.1)
row("R70 C40", 88.6, 75.7, 3.1)
block("Debug header pads, between the display cable and the encoder.")
at("J8", 74.2, 93.5, 0)

# ---- real-time clock ----------------------------------------------------------------------------
block("Real-time clock, next to the positive contact of the cell holder.")
at("U10", 66.0, 72.0, 0)
at("Y1", 60.0, 73.1, 90)
at("C36", 60.6, 69.8, 0)
at("C35", 70.9, 71.0, 90)
at("D10", 72.4, 75.05, 0)
at("D11", 77.25, 75.05, 0)
at("R59", 78.0, 77.1, 0)
at("TP23", 62.3, 76.3, 0)

# ---- sensor input clamps ------------------------------------------------------------------------
block("Sensor input clamps and filters, above the display cable.")
at("D15", 60.2, 107.4, 0)
at("D17", 68.2, 107.4, 0)
at("C44", 60.1, 104.1, 90)
at("C46", 68.1, 104.1, 90)
at("R76", 60.1, 101.05, 90)
at("R82", 68.1, 101.05, 90)
block("Flow input clamp and filter, at the right edge. The flow signal is one of the nets that may not\ncome near the keep-alive: from here it goes up the right edge on the bottom side.")
at("D16", 110.9, 49.2, 180)
at("C45", 108.2, 51.7, 90)
at("R79", 110.6, 52.6, 0)

# ---- under the display --------------------------------------------------------------------------
block("I/O expander with its pull-up and pull-down networks.")
at("U5", 35.0, 72.5, 0)
at("RN1", 28.6, 74.5, 0)
at("RN2", 42.6, 74.5, 0)
at("RN3", 36.5, 83.3, 90)      # the spare pins: beside their test pads, out of the way of the others
at("R96", 28.4, 71.4, 0)
at("R27", 28.4, 69.8, 0)
at("R28", 28.4, 68.2, 0)
at("C18", 35.0, 77.6, 0)
row("TP21 TP26 TP27 TP28 TP29", 29.0, 80.4, 3.0)
block("Fail-safe gate, drive-enable switch and fault LED.")
at("U7", 20.0, 74.0, 0)
at("C20", 20.0, 79.6, 0)
at("Q3", 13.6, 76.5, 0)
col("R25 R26 C21 R92", 13.6, 73.6, -1.6)
col("R54 R87", 9.9, 76.9, -1.6)
at("D8", 9.9, 79.2, 0)
row("TP7 TP10 TP11 TP12", 12.0, 82.6, 3.0)
block("Over-voltage detector on 3.3 V (hardware design, section 9.5). U13 is above the test pad of\nOC_TRIP_N, the net its output pulls low, 8 mm from pin 1 of U7. The divider R13, R100 and its\ncapacitor C55 are at pin 4, C56 at pin 5.")
at("U13", 14.0, 86.0, 90)      # pins 6, 5, 4 at the top, from the left; 1, 2, 3 at the bottom
at("C56", 14.0, 88.95, 0)      # 3.3 V pad above pin 5
at("C55", 16.6, 87.0, 90)      # OV_DIV pads of C55 and R100 level with pin 4
at("R100", 18.2, 87.0, 90)
at("R13", 17.4, 84.7, 0)       # OV_DIV pad under that of R100
block("Keep-alive detector B and the relay driver. More than 10 mm from detector A.")
at("R89", 46.0, 78.6, 0)
at("C51", 49.6, 78.5, 0)
at("D22", 53.6, 78.0, 0)
at("C50", 53.5, 75.1, 0)
row("R14 R90", 46.6, 75.6, 3.2)
at("Q2", 53.6, 72.2, 0)
at("Q1", 48.6, 72.0, 0)
row("R11 R12", 44.6, 69.2, 3.2)
row("R93 R94 R95", 51.0, 69.2, 3.2)
at("TP24", 45.4, 71.3, 0)
block("Display connector: decoupling, reset pull-up and the backlight switch. The bus reaches the\npins from under the connector; these parts are on the open side.")
at("C37", 54.9, 86.0, 0)
at("R63", 54.9, 87.5, 0)
at("C38", 54.6, 89.0, 180)
at("R60", 54.0, 92.6, 0)
at("Q4", 54.5, 96.0, 0)
row("R61 R62", 50.0, 93.6, 0, dy=1.6)
block("Reset and boot buttons, boot pull-up, serial resistor, I2C and Qwiic pull-ups.")
at("SW1", 48.0, 105.5, 0)
at("SW2", 48.0, 99.4, 0)
at("R19", 42.4, 99.4, 90)
at("R99", 77.6, 100.4, 0)       # boot-log series resistor, on the way to the debug pads
row("R21 R22", 38.2, 77.6, 3.2)
block("Status LED resistor, in the light-pipe strip beside the LED.")
at("R20", 15.1, 42.0, 180)
block("Button pull-ups, and the series resistor of Back, whose pin is beside the keep-alive pin.")
col("R67 R72", 13.9, 64.6, -1.6)
at("R68", 44.0, 66.1, 0)
block("Remaining test pads.")
at("TP5", 31.5, 20.5, 0)
at("TP6", 25.9, 80.4, 0)
col("TP13 TP14 TP15", 25.1, 69.4, 2.8)
row("TP18 TP19", 44.0, 81.6, 3.0)

# =============================================================================================
# Groups: the two halves of an output channel
# =============================================================================================
GROUPS = '''
# The nine output channels are nine instances of one sheet. Two groups place them, because the
# two halves of a channel are on different pitches.
#
# channel_power: PTC, TVS, triac and snubber, in a column 7.1 mm wide above the terminals.
# The origin of an instance is the centre line of its column at y = 0.
[group.channel_power]
sheet = "channel"

[group.channel_power.at]
"/MV/" = [42.85, 0]
"/Z1/" = [49.95, 0]
"/Z2/" = [57.05, 0]
"/Z3/" = [64.15, 0]
"/Z4/" = [71.25, 0]
"/Z5/" = [78.35, 0]
"/Z6/" = [85.45, 0]
"/Z7/" = [92.55, 0]
"/Z8/" = [99.65, 0]

[group.channel_power.parts]
D1 = [-1.25, 12.53, 270]   # TVS, pad 1 (OUT) up. The strip below, y = 7.5 to 9, is for the terminal labels
C1 = [2.05, 10.58, 270]    # snubber capacitor, ISNS end down
R5 = [2.05, 14.06, 270]    # snubber resistor, T2 end up
F1 = [0, 20.93, 90]        # PTC, pad 1 (OUT) down
Q1 = [0, 30.44, 270]       # triac, tab down, leads up: A1 right, gate left
R4 = [1.5, 37.9, 0]        # gate to A1
R3 = [-1.8, 38.3, 0]       # T2 to the opto output

# channel_logic: the LED, its resistor, the opto LED resistor and the opto-triac. The origin of
# an instance is its LED, whose position the mechanical contract fixes (y = 42, pitch 9.5).
[group.channel_logic]
sheet = "channel"

[group.channel_logic.at]
"/MV/" = [26.0, 42.0]
"/Z1/" = [35.5, 42.0]
"/Z2/" = [45.0, 42.0]
"/Z3/" = [54.5, 42.0]
"/Z4/" = [64.0, 42.0]
"/Z5/" = [73.5, 42.0]
"/Z6/" = [83.0, 42.0]
"/Z7/" = [92.5, 42.0]
"/Z8/" = [102.0, 42.0]

[group.channel_logic.parts]
D2 = [0, 0, 0]             # LED, cathode left
R1 = [-3.1, 0, 0]          # opto LED resistor
R2 = [3.1, 0, 180]         # LED resistor
U1 = [0, 8.8, 90]          # opto-triac: LED side down, pin 1 left; pin 4 (gate) top right
'''

# =============================================================================================
# Copper
# =============================================================================================

# Every terminal of J1 to J4: x of its pin, and the label behind it.
TERMINALS = [
    (17.805, "24V~"), (21.615, "24V~"),
    (30.225, "COM"), (34.035, "COM"), (37.845, "MV"), (41.655, "Z1"), (45.465, "Z2"), (49.275, "Z3"), (53.085, "Z4"),
    (58.295, "Z5"), (62.105, "Z6"), (65.915, "Z7"), (69.725, "Z8"),
    (78.335, "5V"), (82.145, "FLOW"), (85.955, "GND"), (89.765, "RAIN"), (93.575, "GND"), (97.385, "AUX"), (101.195, "GND"),
]

COLS = {name: 42.85 + 7.1 * k for k, name in enumerate(["MV", "Z1", "Z2", "Z3", "Z4", "Z5", "Z6", "Z7", "Z8"])}
PINS = {"MV": "J2.3", "Z1": "J2.4", "Z2": "J2.5", "Z3": "J2.6", "Z4": "J2.7",
        "Z5": "J3.1", "Z6": "J3.2", "Z7": "J3.3", "Z8": "J3.4"}
PIN_X = {"MV": 37.845, "Z1": 41.655, "Z2": 45.465, "Z3": 49.275, "Z4": 53.085,
         "Z5": 58.295, "Z6": 62.105, "Z7": 65.915, "Z8": 69.725}

def toml_points(pts):
    out = []
    for p in pts:
        if isinstance(p, str):
            out.append(f'"{p}"')
        elif isinstance(p, dict):
            out.append("{via = [%g, %g]}" % tuple(round(v, 3) for v in p["via"]))
        else:
            out.append("[%g, %g]" % (round(p[0], 3), round(p[1], 3)))
    return "[" + ", ".join(out) + "]"

def track(pts, layer="F.Cu", width=None, via=None, table="track", comment=None, stay=False, via_to=None):
    s = []
    if comment:
        s += [f"# {c}" for c in comment.split("\n")]
    s.append(f"[[{table}]]")
    s.append(f'layer = "{layer}"')
    if width is not None:
        s.append(f"width = {width:g}")
    if via is not None:
        s.append(f"via = [{via[0]:g}, {via[1]:g}]")
    if stay:
        s.append("stay = true")
    if via_to:
        s.append(f'via_to = "{via_to}"')
    s.append(f"points = {toml_points(pts)}")
    return "\n".join(s) + "\n"

# ---- one channel column, relative to its centre line -------------------------------------------
LEDX = {"MV": 26.0, "Z1": 35.5, "Z2": 45.0, "Z3": 54.5, "Z4": 64.0, "Z5": 73.5, "Z6": 83.0, "Z7": 92.5, "Z8": 102.0}
NUM = {"MV": 9, "Z1": 1, "Z2": 2, "Z3": 3, "Z4": 4, "Z5": 5, "Z6": 6, "Z7": 7, "Z8": 8}
G = "group.channel_power.track"
group_tracks = [
    "# Copper of one channel column, repeated nine times. Offsets from the column centre at y = 0.",
    track(["C1.1", "R5.2"], width=0.3, table=G, comment="Snubber mid-point."),
    track(["D1.1", [-1.25, 17.54], "F1.1"], width=1.2, table=G, comment="Output: TVS to the PTC."),
    track(["D1.1", [-1.25, 15.2], [0.25, 15.2], [0.25, 17.3], "F1.1"], width=1.2, table=G,
          comment="Output: from the two vias of the fan-out lane up into the PTC pad, 1.2 mm wide."),
    track(["F1.1", [0.45, 16.9], {"via": [0.45, 16.0]}, {"via": [0.45, 15.2]}, {"via": [0.45, 14.4]},
           {"via": [0.45, 13.6]}], width=0.7, via=(0.6, 0.3), table=G, stay=True,
          comment="Four vias, 0.8 mm apart, on the last 2.4 mm of the fan-out lane: see hardware-layout.md, section 6."),
    track(["F1.2", "Q1.2"], width=5.0, table=G, comment="T2: PTC to the triac tab, and vias to the island on B.Cu."),
    track(["F1.2", [2.6, 23.6], {"via": [3.25, 23.6]}], width=1.0, table=G),
    track(["F1.2", [2.6, 24.9], {"via": [3.25, 24.9]}], width=1.0, table=G),
]
for vx, vy in ((-1.5, 27.9), (1.5, 27.9), (-1.5, 30.7), (1.5, 30.7)):
    group_tracks.append(track(["Q1.2", {"via": [vx, vy]}], width=0.6, via=(0.6, 0.3), table=G))
group_tracks += [
    track(["R5.1", [3.375, 16.0], [3.375, 23.4], [3.25, 23.6]], width=0.3, table=G,
          comment="T2 for the snubber resistor: up the gap between this PTC and the next, on F.Cu."),
    track(["Q1.1", "R4.2"], width=0.6, table=G, comment="A1: to the gate resistor, and vias to the ISNS plane on In2.Cu."),
    track(["Q1.1", {"via": [2.3, 37.0]}], width=0.6, via=(0.6, 0.3), table=G),
    track(["Q1.1", {"via": [2.3, 33.5]}], width=0.6, via=(0.8, 0.4), table=G),
    track(["Q1.1", {"via": [1.0, 35.2]}], width=0.6, via=(0.8, 0.4), table=G),
    track(["Q1.3", [-2.28, 36.9], [0.675, 36.9], "R4.1"], width=0.3, table=G, comment="Gate."),
    track(["R4.1", {"via": [0.675, 39.4]}], width=0.3, via=(0.6, 0.3), table=G),
    track(["R3.1", {"via": [-2.71, 39.55]}], width=0.3, via=(0.6, 0.3), table=G, comment="T2 and the opto output."),
    track(["R3.2", {"via": [-0.89, 39.65]}], width=0.3, via=(0.6, 0.3), table=G),
]

# ---- fan-out lanes on B.Cu, with a copy on In2.Cu -----------------------------------------------
# 0.9 mm tracks 0.5 mm apart: the 24 VAC clearance, kept on an outer layer too.
PITCH = 1.4
LANES = [13.6, 12.2, 10.8, 9.4, 8.0, 6.6]
# The sixth lane, y = 6.6, is level with the terminal pins. Only the last output uses it, for the
# few millimetres right of its own pin where no other pin is: LOW_LANE_END checks that.
LOW_LANE_END = 76.2                # the next terminal pad, J4 pin 1, begins at x = 77.2
JOG, STEP = PITCH, 0.05
VIA_DX, RISE_Y = 0.45, 16.0        # the two vias of an output are at x = centre + 0.45, y = 15.2 and 16.0
order = list(COLS)
via_x = {n: round(COLS[n] + VIA_DX, 3) for n in order}
pts = {n: [] for n in order}
active = []        # names, in index order
st = {}            # name -> dict(lane, from_lane, jog_start, jog_end)
last_end = -99.0
x = 37.0
while x <= 101.5:
    for n in list(active):
        if abs(x - via_x[n]) < STEP / 2:
            assert st[n]["lane"] == 0 and x >= st[n]["jog_end"], (n, st[n], x)
            pts[n] += [(via_x[n], LANES[0]), (via_x[n], RISE_Y)]
            active.remove(n)
            last_end = x
    for n in order:
        if abs(x - PIN_X[n]) < STEP / 2:
            occ = [max(st[t]["lane"], st[t]["from_lane"]) if x < st[t]["jog_end"] + PITCH / 2 else st[t]["lane"] for t in active]
            lane = (max(occ) + 1) if occ else 0
            assert lane < len(LANES), (n, lane)
            st[n] = {"lane": lane, "from_lane": lane, "jog_start": -99, "jog_end": -99}
            pts[n] = [PINS[n], (PIN_X[n], LANES[lane])]
            active.append(n)
    for n in active:
        s_ = st[n]
        L_ = s_["lane"]
        if L_ == 0 or x < s_["jog_end"] + 0.3 or abs(x - PIN_X[n]) < 0.8:
            continue
        busy = False
        for t in active:
            if t == n:
                continue
            u = st[t]
            if x < u["jog_end"]:
                if u["lane"] == L_ - 1 or (u["from_lane"] == L_ - 1 and x < u["jog_start"] + PITCH / 2):
                    busy = True
            elif u["lane"] == L_ - 1:
                busy = True
        if busy or (L_ - 1 == 0 and x < last_end + PITCH + 0.05) or x + JOG > via_x[n] - 0.3:
            continue
        pts[n] += [(round(x, 3), LANES[L_]), (round(x + JOG, 3), LANES[L_ - 1])]
        s_.update(from_lane=L_, lane=L_ - 1, jog_start=x, jog_end=x + JOG)
    x = round(x + STEP, 3)
assert not active, active

def seg_dist(a, b, c, d):
    def pt_seg(p, q, r):
        vx, vy = r[0] - q[0], r[1] - q[1]
        n2 = vx * vx + vy * vy
        t = 0 if n2 == 0 else max(0, min(1, ((p[0] - q[0]) * vx + (p[1] - q[1]) * vy) / n2))
        return math.hypot(p[0] - q[0] - t * vx, p[1] - q[1] - t * vy)
    def side(p, q, r):
        return (q[0] - p[0]) * (r[1] - p[1]) - (q[1] - p[1]) * (r[0] - p[0])
    if side(a, b, c) * side(a, b, d) < 0 and side(c, d, a) * side(c, d, b) < 0:
        return 0.0      # the two segments cross
    return min(pt_seg(a, c, d), pt_seg(b, c, d), pt_seg(c, a, b), pt_seg(d, a, b))

polys = {n: [(PIN_X[n], 5.9)] + pts[n][1:] for n in order}
for n in order:
    low = [q for q in polys[n][1:] if q[1] < LANES[4] - 0.01]
    assert all(PIN_X[n] <= q[0] <= LOW_LANE_END and n == order[-1] for q in low), (n, low)
worst = 9.0
for i, a in enumerate(order):
    for b in order[i + 1:]:
        for p, q in zip(polys[a], polys[a][1:]):
            for r, s2 in zip(polys[b], polys[b][1:]):
                worst = min(worst, seg_dist(p, q, r, s2))
print(f"fan-out lanes: the closest two come is {worst:.3f} mm centre to centre (need {PITCH})")
assert worst >= PITCH - 0.01, worst

lane_tracks = ["# Valve outputs, from each terminal pin to the two vias under its column. On B.Cu, which is\n"
               "# 1 oz copper, 0.9 mm wide and 0.5 mm apart, and the same again on In2.Cu: the terminal pin and\n"
               "# the two vias join the two. Later outputs start lower and step up as earlier ones end, so no\n"
               "# two cross. The current calculation is in docs/design/hardware-layout.md."]
for n in order:
    lane_tracks.append(track(pts[n], layer="B.Cu", width=0.9))
    lane_tracks.append(track(pts[n], layer="In2.Cu", width=0.9))

# ---- zones ---------------------------------------------------------------------------------------
def zone(net, layers, rect=None, **kw):
    s = ["[[zone]]", f'net = "{net}"', "layers = [" + ", ".join(f'"{l}"' for l in layers) + "]"]
    if rect:
        x0, y0, x1, y1 = rect
        s.append(f"outline = [[{x0:g}, {y0:g}], [{x1:g}, {y0:g}], [{x1:g}, {y1:g}], [{x0:g}, {y1:g}]]")
    for k, v in kw.items():
        s.append(f"{k} = {v}" if not isinstance(v, str) else f'{k} = "{v}"')
    return "\n".join(s) + "\n"

zones = ["# Ground: all of In1.Cu, and pours on both outer layers.",
         zone("GND", ["In1.Cu"], clearance=0.3, min_width=0.25, connect="solid", priority=0),
         zone("GND", ["F.Cu", "B.Cu"], clearance=0.3, min_width=0.25, connect="thermal", thermal_gap=0.3,
              thermal_width=0.4, priority=0),
         "# 3.3 V: In2.Cu above the LED row, and down both edges to the parts that need it there. It is a\n"
         "# plane: the autorouter is kept off this layer ([[route.plane]] below), so nothing cuts it but the\n"
         "# nine opto-output lines written out further down and the clearance holes of the vias.",
         "[[zone]]\nnet = \"3V3\"\nlayers = [\"In2.Cu\"]\n"
         "outline = [[0.5, 109.5], [113.5, 109.5], [113.5, 5.0], [103.9, 5.0], [103.9, 45.3], [9.5, 45.3], "
         "[9.5, 16.0], [0.5, 16.0]]\nclearance = 0.3\nmin_width = 0.25\nconnect = \"solid\"\npriority = 1\n",
         "# Shunt return: In2.Cu under the triacs. Every A1 terminal drops into it through two vias.",
         zone("/ISNS", ["In2.Cu"], rect=(34.6, 18.6, 103.3, 40.1), clearance=0.5, min_width=0.3, connect="solid",
              priority=2),
         "# One island per triac tab on B.Cu, 6.6 x 23.1 mm, above the fan-out lanes, joined to the tab by six vias."]
for n in order:
    zones.append(zone(f"/{n}/T2", ["B.Cu"], rect=(COLS[n] - 3.3, 17.0, COLS[n] + 3.3, 40.1), clearance=0.5,
                      min_width=0.3, connect="solid", priority=3))

# ---- 24 VAC entry and other hand tracks ----------------------------------------------------------
hand = [
    "# 24 VAC entry. 2.0 mm: 3 A, the fuse rating, gives about 6 K rise in 1 oz outer copper.",
    track(["J1.1", "F4.1"], width=2.0),
    track(["J1.2", "F1.1"], width=2.0),
    track(["F4.2", [11.815, 21.8], "D1.1"], width=2.0, comment="AC_L: fuse to the surge clamp, the rectifier and the relay contact."),
    track(["F4.2", [11.815, 19.0], [23.2, 19.0], "D2.2"], width=1.0),
    track(["D1.1", [10.6, 21.8], [7.9, 24.5], "K1.13"], width=2.0),
    track(["D1.2", {"via": [17.95, 20.9]}], width=0.8, via=(0.8, 0.4),
          comment="Ground of the surge clamp D1: three vias into the plane, where the builder gave it one of 0.3 mm."),
    track(["D1.2", {"via": [17.95, 22.7]}], width=0.8, via=(0.8, 0.4)),
    track(["D1.2", {"via": [21.65, 22.65]}], width=0.6, via=(0.6, 0.3)),
    track(["K1.13", "JP1.1"], width=0.5),
    track(["K1.13", [5.9, 26.6], "R55.1"], width=0.5),
    track(["K1.14", [7.15, 16.3], [9.6, 13.85], [9.6, 12.1], [11.2, 10.5], [26.2, 10.5], [29.4, 7.3], "J2.1"], layer="B.Cu",
          width=2.0, comment="COM: relay contact to the two COM terminals, on B.Cu under the fuse well."),
    track(["J2.1", "J2.2"], layer="B.Cu", width=2.0),
    track(["J2.2", [34.035, 9.0], [35.5, 10.45], "D23.1"], width=1.5),
    track(["K1.14", "JP1.2"], width=0.5),
    track(["K1.14", "TP22.1"], width=0.5),
    track(["F1.2", [30.185, 14.6], [36.0, 14.6], "D23.2"], width=2.0,
          comment="Return: shunt and valve-common TVS to the fuse in the AC_N leg."),
    track(["D23.2", "R37.2"], width=2.0),
    track(["D2.1", [27.2, 23.0], [26.5, 23.6], "R1.1"], width=1.0, comment="Rectifier to the surge resistor."),
    track(["R1.2", [33.75, 25.9], [33.75, 30.6], [35.0, 31.85], "C1.1"], width=1.0, comment="VIN_DC: surge resistor to C1, C1 to the fuse F5."),
    track(["C1.1", [34.1, 34.4], [34.1, 36.2], [33.6, 36.71], "F5.1"], width=1.5),
    track(["F5.1", [28.9, 38.3], "R7.1"], width=0.3),
    track(["F5.2", [29.2, 31.8], [27.55, 31.8]], width=1.5, comment="VIN_U1, behind the fuse: F5 to the input capacitors and pin 2 of U1."),
    track(["C3.1", "C2.1"], width=1.5),
    track(["C3.1", [25.9, 32.365], "U1.2"], width=1.0),
    track(["U1.3", [25.68, 33.635], [25.68, 36.3], [26.275, 36.9], "R8.1"], width=0.2,
          comment="UVLO: up the slot between the pins of U1 and the input capacitors to its divider."),
    track(["R8.1", "R7.2"], width=0.2),
    track(["U1.8", "C4.2"], width=0.6, comment="Switch node: pin 8, the bootstrap capacitor, the inductor. Kept small."),
    track(["C4.2", "L1.1"], width=0.6),
    track(["U1.7", "C4.1"], width=0.3),
    track(["L1.1", [15.5, 33.05], [16.95, 34.5], [16.95, 36.3], "R6.1"], width=0.25,
          comment="Switch node to the ripple resistor R6, which is at the feedback pin."),
    track(["U1.5", [19.4, 35.65], [21.925, 35.65], "C8.2"], width=0.2,
          comment="Feedback node, ripple network and the RON resistor: short, and written out."),
    track(["C8.2", "R5.1"], width=0.2),
    track(["R5.1", "R4.2"], width=0.2),
    track(["R6.2", "C7.1"], width=0.2),
    track(["R6.2", "C8.1"], width=0.2),
    track(["R4.1", "R3.2"], width=0.2),
    track(["U1.4", [24.925, 35.6], "R2.1"], width=0.2),
    track(["U1.1", [22.6, 31.095], [22.15, 31.8]], width=0.5,
          comment="Ground of U1 (LM5164 data sheet, 7.4.1, items 4 and 10): the GND pin tied to the exposed pad on the top\n"
                  "layer, six vias under the pad (the [[via]] list), a second via at the pin and at the input capacitor C2."),
    track(["U1.1", {"via": [25.45, 30.35]}], width=0.5, via=(0.6, 0.3)),
    track(["C2.2", {"via": [25.75, 27.925]}], width=0.6, via=(0.6, 0.3)),
    track(["L1.2", "D25.1"], width=2.0, comment="V_BUCK: the output pad of L1 to the clamp D25 and to C6 and C5."),
    track(["L1.2", [10.925, 28.0], "C6.1"], width=1.1),
    track(["L1.2", [11.5, 28.0], [15.3, 28.0], "C5.1"], width=0.5),
    track(["D25.2", {"via": [14.0, 38.7]}], width=1.0, via=(0.8, 0.4), comment="D25 anode to the ground plane: four vias."),
    track(["D25.2", {"via": [15.4, 38.7]}], width=1.0, via=(0.8, 0.4)),
    track(["D25.2", {"via": [14.0, 34.75]}], width=1.0, via=(0.8, 0.4)),
    track(["D25.2", {"via": [15.2, 34.75]}], width=1.0, via=(0.8, 0.4)),
    "# The 5 V chain, by hand on the outer layers (layout review, L4). Widths: hardware-layout.md, section 6.\n"
    "# Feedback: the top of the divider (R3) and the ripple capacitor (C7) sense at the pad of D25, on\n"
    "# their own track, and nothing else is on it.",
    track(["D25.1", [11.9, 38.9], [13.1, 40.1], [22.6, 40.1], "R3.1"], width=0.3),
    track(["C7.2", [17.325, 40.1]], width=0.3),
    "# V_BUCK to the OR-ing diode D3: up the 2.1 mm gap between the anode of D4 and the pins of U3,\n"
    "# which it shares with V5.",
    track(["D25.1", [9.9, 38.4], [8.8, 39.5], [8.8, 45.2]], width=0.8),
    track([[8.8, 45.2], [8.8, 49.6], "D3.2"], width=0.55),
    "# V_BUCK to the relay coil and its diode.",
    track(["D25.1", [9.3, 38.6], [4.05, 38.6], "K1.A1"], width=0.5),
    track(["D5.1", [2.45, 35.6], "K1.A1"], width=0.4),
    track(["TP2.1", [15.3, 28.0]], width=0.3),
    "# V_BUCK to the sensor supply switch U11 and the read-back divider: a via at D3, B.Cu north past the\n"
    "# end of the Kelvin pair, east along y = 63.7, and up beside the Home button.",
    track(["D3.2", {"via": [8.75, 51.7]}, [8.75, 63.2], [9.25, 63.7], [52.0, 63.7], [54.3, 61.4]], width=0.5, via=(0.6, 0.3)),
    track(["C47.1", {"via": [54.3, 61.4]}], width=0.5, via=(0.6, 0.3)),
    track(["C47.1", [54.5, 62.7], [54.5, 66.45], "U11.1"], width=0.3),
    track(["U11.1", [54.5, 66.45], [54.5, 67.7], [50.175, 67.7], "R93.1"], width=0.2),
    "# The current-sense amplifier's capacitor C25: 3.3 V straight up from pin 8 of U8, its own ground via.\n"
    "# The amplifier output of the low range goes over the top of R39 to its series resistor R46.",
    track(["U8.8", "C25.1"], width=0.3),
    track(["C25.2", {"via": [30.5, 67.75]}], width=0.3, via=(0.6, 0.3)),
    track(["R39.2", [30.6, 66.9], [28.4, 66.9], "R46.1"], width=0.2),
    track(["U2.2", {"via": [3.225, 17.7]}], width=0.3, via=(0.6, 0.3), comment="Ground of the USB ESD array: a via under it."),
    "# Over-voltage detector U13 (hardware design, section 9.5). OV_DIV, the tap of its divider, is 5 mm\n"
    "# of track between four pads. 3.3 V goes from pin 5 straight to C56. The two ground pins share a via\n"
    "# under the package. The output goes round the package to TP10, the test pad of OC_TRIP_N; the\n"
    "# autorouter takes that net on from there.",
    track(["U13.4", "C55.1"], width=0.2),
    track(["C55.1", "R100.1"], width=0.2),
    track(["R100.1", "R13.2"], width=0.2),
    track(["U13.5", [14.0, 88.3], "C56.1"], width=0.3),
    track(["U13.2", {"via": [14.475, 85.85]}], width=0.3, via=(0.6, 0.3)),
    track(["U13.3", [14.475, 85.85]], width=0.3),
    track(["U13.6", [12.2, 87.14], [12.2, 84.2], [12.65, 83.75], [14.3, 83.75], "TP10.1"], width=0.2),
    "# V5: the two cathodes, the test pad, the input capacitor C10 and pin 3 of U3.",
    track(["D4.1", "D3.1", [3.0, 52.6], "TP3.1"], width=1.0),
    track(["D3.1", [3.0, 52.3], [4.4, 53.7], [6.6, 53.7], "C10.1"], width=0.8),
    track(["C10.1", [7.25, 53.4], [7.75, 52.9], [9.3, 52.9], [9.75, 52.45], [9.75, 48.3], [10.25, 47.8], "U3.3"], width=0.7),
    track(["U3.2", [17.65, 50.1]], width=2.0,
          comment="3V3 at the regulator: pin 2 and the tab are one net. A bar under the body joins them, and five vias\n"
                  "(the [[via]] list) take it into the 3.3 V plane: the whole 3.3 V load and the heat of U3 go this way.\n"
                  "The plane-via placer had given pin 2 one via and joined the tab to the via of C12, 3.8 mm away,\n"
                  "by a 0.3 mm stub: it uses a via of the same net again when one is within reach."),
    "# VBUS: the two pads of the USB connector joined on B.Cu under it, the capacitor C13, and on B.Cu\n"
    "# round the mounting hole, past the relay pins and up at x = 9.6 to two vias below the anode of D4.\n"
    "# The ESD array U2 takes it from a via on the way.",
    track(["J5.A9", {"via": [10.45, 8.4]}, [7.2, 8.4], [5.9, 8.4]], width=0.5, via=(0.6, 0.3)),
    track(["J5.A4", [5.55, 7.9], {"via": [5.9, 8.4]}], width=0.4, via=(0.6, 0.3)),
    track(["J5.A9", [10.45, 8.4], [14.6, 8.4], [15.8, 7.2], [15.8, 3.0], [14.9, 2.1], "C13.1"], width=0.5),
    track(["U2.5", [5.5, 17.7], [5.5, 20.3], {"via": [5.6, 20.9]}], width=0.25, via=(0.6, 0.3)),
    track(["D4.2", {"via": [7.4, 45.2]}, [9.6, 43.0], [9.6, 21.5], [9.0, 20.9], [5.6, 20.9], [5.2, 20.5], [5.2, 15.0],
           [7.2, 13.0], [7.2, 8.4]], width=0.7, via=(0.6, 0.3)),
    track(["D4.2", {"via": [6.4, 45.2]}, [7.4, 45.2]], width=0.7, via=(0.6, 0.3)),
    "# VIN_MON, the tap of the input-voltage divider, to module pin 15 (layout review, L5). Its 100 nF\n"
    "# capacitor C9 is at the divider, so the line is a low impedance all the way. On B.Cu: across the\n"
    "# strip of the gate lines left of the first one, east under the opto-triacs, a hop on F.Cu over the\n"
    "# two ADC lines under the cell holder, north under detector A. Four vias.",
    track(["C9.1", "R10.1"], width=0.2),
    track(["R9.2", "R10.1"], width=0.2),
    track(["C9.1", [36.225, 39.0], [35.0, 39.0], [34.4, 39.6], {"via": [29.2, 39.6]}, [27.9, 39.6], [27.4, 40.1], [27.4, 56.1],
           [27.9, 56.6], [97.9, 56.6], [98.3, 57.0], {"via": [98.3, 64.9]}, {"via": [98.3, 69.6]}, [98.3, 89.4]],
          width=0.2, via=(0.6, 0.3)),
    track(["U4.15", [96.015, 89.9], [96.5, 89.4], {"via": [98.3, 89.4]}], width=0.2, via=(0.6, 0.3)),
    "# RLY_B_RB, the relay read-back, from its divider to module pin 7: 50 kohm behind it, so it is\n"
    "# written out. It crosses the keep-alive once, at right angles on F.Cu, west of detector B's guard.",
    track(["R94.2", "R95.1"], width=0.2),
    track(["R95.1", [56.2, 70.1], {"via": [56.2, 82.07]}, {"via": [75.9, 82.07]}, [75.9, 99.3], [79.4, 99.3], [79.4, 100.89],
           "U4.7"], width=0.2, via=(0.6, 0.3)),
    track(["C1.1", "R9.1"], width=0.4),
    track(["C1.1", "TP1.1"], width=0.4),
    "# ISNS: a strip through the lower pads of every TVS and snubber capacitor, then up to the\n"
    "# shunt. It carries surge and snubber current only. The triac currents take the In2.Cu plane.",
    track(["D901.2", [41.6, 9.63], [101.7, 9.63], "C801.2"], width=1.0),
    track(["D901.2", [41.6, 9.63], [38.65, 9.63], [38.65, 23.213], "R37.1"], width=0.5),
    track(["R37.1", {"via": [37.3, 24.7]}], width=1.0),
    track(["R37.1", {"via": [35.3, 24.7]}], width=1.0),
    track(["C801.2", "TP17.1"], width=0.6),
]

# Kelvin sense of the shunt (hardware design, section 10.2): one track from each pad of R37 to the
# amplifier input resistors, on B.Cu, kept out of every pour.
kelvin = [
    "# Kelvin sense of the shunt R37. Each track leaves from its own via at the left end of a shunt\n"
    "# pad, and runs on B.Cu: left under C1, up at x = 18.4 and 19.0, where no gate line crosses, then\n"
    "# right to the amplifier. Rule areas keep the ground pours away from both, so that the ground\n"
    "# sense has no second path.",
    track(["R37.1", {"via": [34.1, 23.15]}, [34.1, 23.6], [33.3, 24.4], [19.6, 24.4], [19.0, 25.0], [19.0, 57.7],
           [19.6, 58.3], [32.7, 58.3], [32.7, 62.8]], width=0.25, via=(0.6, 0.3)),
    track(["R38.1", {"via": [32.7, 62.8]}], width=0.25, via=(0.6, 0.3)),
    track(["R38.1", [32.7, 62.8], "R42.1"], width=0.25),
    track(["R37.2", {"via": [34.1, 17.35]}, [33.3, 18.15], [33.3, 23.0], [32.5, 23.8], [18.9, 23.8], [18.4, 24.3],
           [18.4, 58.3], [19.0, 58.9], [31.9, 58.9], [31.9, 61.2]], width=0.25, via=(0.6, 0.3)),
    track(["R40.1", {"via": [31.9, 61.2]}], width=0.25, via=(0.6, 0.3)),
    track(["R40.1", [31.9, 61.2], [32.3, 61.6], [38.6, 61.6], "R44.1"], width=0.25),
    "[[rule_area]]\nname = \"Kelvin sense: no pour\"\nlayers = [\"B.Cu\"]\nno_pour = true\n"
    "outline = [[32.7, 15.6], [34.8, 15.6], [34.8, 24.9], [19.5, 24.9], [19.5, 57.8], [33.2, 57.8], [33.2, 63.3], "
    "[31.4, 63.3], [31.4, 59.4], [17.9, 59.4], [17.9, 23.3], [32.7, 23.3]]\n",
    "[[rule_area]]\nname = \"Kelvin sense: no pour\"\nlayers = [\"F.Cu\"]\nno_pour = true\nrect = [30.5, 60.95, 39.5, 63.4]\n",
    "# Under the sensor terminal block the ground pour on F.Cu would be three scraps, each hanging on\n"
    "# one ground pin by its thermal spokes. The pins have the plane and the rail on B.Cu: no pour here.",
    "[[rule_area]]\nname = \"J4: no pour scraps\"\nlayers = [\"F.Cu\"]\nno_pour = true\nrect = [76.4, 0.3, 103.2, 7.5]\n",
    "[[rule_area]]\nname = \"Kelvin sense: ground via not tied to the plane here\"\nlayers = [\"In1.Cu\"]\nno_pour = true\n"
    "rect = [31.2, 60.5, 32.6, 61.9]\n",
]

# Keep-alive, USB and the opto LED supply.
more = [
    "# Keep-alive (hardware design, section 8.5, rule 1). From module pin 10 a 2.3 mm stub under the module\n"
    "# to a via, then on B.Cu down to the via between R33 and R29, on under the right edge of the\n"
    "# encoder and left along y = 78.6 to R89 at detector B. The [[guard]] below keeps every other\n"
    "# track and via 1 mm away; [[keepaway]] checks the nets that toggle by themselves on every layer.",
    track(["U4.10", {"via": [96.2, 97.08]}, [96.2, 89.4], [96.5, 89.1], [96.5, 87.6]], width=0.25, via=(0.6, 0.3)),
    track(["R33.1", {"via": [96.5, 87.6]}, [93.9, 87.6], [92.5, 86.2], [92.5, 79.6], [91.5, 78.6], [44.2, 78.6]],
          width=0.25, via=(0.6, 0.3)),
    track(["R29.1", [96.5, 87.6]], width=0.25),
    track(["R89.1", {"via": [44.2, 78.6]}], width=0.25, via=(0.6, 0.3)),
    "# The two neighbours of the keep-alive pin on the module edge. ENC_B (pin 9) comes up under the\n"
    "# encoder, through the 0.6 mm gaps between its lands, and reaches its pin from the left. BTN_BACK\n"
    "# (pin 11) leaves under the module to a via; the autorouter takes it on from there. Both stay\n"
    "# 1 mm from the keep-alive stub and its via.",
    track(["R70.2", "C40.1"], width=0.2),
    track(["C40.1", [90.93, 77.4], [90.2, 78.13], [88.45, 78.13], [88.45, 97.9], [88.9, 98.35], "U4.9"], width=0.2),
    track(["U4.11", [95.2, 95.5], {"via": [100.4, 95.5]}], width=0.2, via=(0.6, 0.3)),
    "# Detector A: pump, reservoir and comparator input, by hand so that each node stays short.",
    "@U5@",
    track(["R35.2", [105.95, 85.7], {"via": [106.2, 86.45]}], width=0.25, via=(0.6, 0.3),
          comment="Ground for R35: the builder finds no place for a via beside the pad, and the top pour reached it\n"
                  "with one spoke in a trial routing. A via of its own, between the pump capacitor C22 and the\n"
                  "3.3 V via of R34, 0.28 mm from the first and 0.6 mm from the second."),
    track(["R29.2", [99.6, 88.4], [103.9, 88.4], "C22.1"], width=0.3),
    track(["C22.2", "D7.3"], width=0.3),
    track(["D7.2", "C23.1"], width=0.3),
    track(["C23.1", "R30.1"], width=0.25),
    track(["R30.1", "R91.1"], width=0.25),
    track(["R91.1", "TP8.1"], width=0.25),
    track(["R30.1", "R31.1"], width=0.25),
    track(["R31.2", [103.5, 83.3], "R32.1"], width=0.25),
    track(["R32.1", "U6.7"], width=0.25),
    track(["R31.2", [102.725, 82.2], "C24.1"], width=0.25),
    "# USB D+ and D-: from the series resistors at the ESD array, side by side on B.Cu up the left edge\n"
    "# between the pins of K1, across under the display at y = 95, one step down past the debug header,\n"
    "# to a via at each module pin. 0.25 mm tracks, 0.2 mm apart. Full speed only: not impedance controlled.",
    track(["U2.3", [1.05, 16.75], [1.05, 19.5], "R97.1"], width=0.25),
    track(["U2.6", "R98.1"], width=0.25),
    track(["R97.2", "C52.1"], width=0.25),
    track(["R98.2", "C53.1"], width=0.25),
    track(["R97.2", [1.9, 22.45], {"via": [2.95, 22.45]}, [2.95, 23.6], [4.3, 24.95], [4.3, 95.0], [4.75, 95.45],
           [77.2, 95.45], [78.2, 94.45], [92.3, 94.45], [92.75, 94.0], [92.75, 92.0]], width=0.25, via=(0.6, 0.3)),
    track(["U4.14", {"via": [92.75, 92.0]}], width=0.25, via=(0.6, 0.3)),
    track(["R98.2", [4.0, 22.45], {"via": [5.05, 22.45]}, [5.05, 24.2], [4.75, 24.5], [4.75, 94.55], [5.2, 95.0],
           [77.01, 95.0], [78.01, 94.0], [91.45, 94.0], [91.9, 93.55], [91.9, 93.27]], width=0.25, via=(0.6, 0.3)),
    track(["U4.13", {"via": [91.9, 93.27]}], width=0.25, via=(0.6, 0.3)),
]

# Display bus (hardware design, section 15.3). It may not come near the keep-alive net on any layer,
# and the keep-alive now lies between the module pins and the connector. So the bus goes round the
# top of module pin 10: a via above each pin, B.Cu under the module and under the parts left of it,
# then F.Cu down the strip the display cable lies over, and under the connector to its pins.
BUS = ["TFT_CS", "TFT_MOSI", "TFT_SCLK", "TFT_DC", "TFT_RST", "TFT_BL"]       # module pins 18 to 23
BUS_PIN = {n: 18 + i for i, n in enumerate(BUS)}
BUS_VIA_X = {n: 99.825 + 1.27 * i for i, n in enumerate(BUS)}
SPREAD = {"TFT_CS": 97.0, "TFT_MOSI": 98.0, "TFT_SCLK": 99.0, "TFT_DC": 100.0, "TFT_RST": 101.0}   # lane y at the vias
DROP = {"TFT_CS": (72.6, 2, 86.18), "TFT_DC": (71.7, 3, 86.68), "TFT_SCLK": (70.8, 4, 87.18),
        "TFT_MOSI": (69.9, 5, 87.68), "TFT_RST": (69.0, 6, 88.18)}             # F.Cu x, connector pin, pin y
bus = ["# Display bus: module pins 18 to 22 to J7, and the backlight line to R61. See the comment in layout.py."]
for i, n in enumerate(BUS):
    vx = BUS_VIA_X[n]
    if n == "TFT_BL":
        # The backlight line goes round the far side of the module's ground pad and its thermal vias:
        # between the keep-alive guard and those vias there is room for five lanes, not six. It
        # joins the others as the top lane left of the module, runs on at y = 102, turns down west
        # of the bus vias and passes under the buttons to R61.
        pts = [f"U4.{BUS_PIN[n]}", {"via": [vx, 92.4]}, [vx, 102.6], [vx - 0.7, 103.3], [96.5, 103.3], [93.8, 100.6],
               [78.6, 100.6], [77.2, 102.0], [68.0, 102.0], [67.5, 101.5], [67.5, 97.3], [67.0, 96.8], [48.2, 96.8]]
        bus.append(track(pts, width=0.2, via=(0.6, 0.3)))
        bus.append(track(["R61.1", [48.2, 94.2], {"via": [48.2, 96.8]}], width=0.2, via=(0.6, 0.3)))
        continue
    # Under the module the five lanes are 0.4 mm apart, 1 mm clear of the keep-alive via on one side
    # and 0.5 mm of the ground pad's thermal vias on the other.
    y1, x1, y2 = 93.2 + 0.4 * i, 97.65 + 0.4 * i, 98.6 + 0.4 * i
    pts = [f"U4.{BUS_PIN[n]}", {"via": [vx, 92.4]}, [vx, y1], [x1, y1], [x1, y2]]
    ys = SPREAD[n]
    fx, pin, py = DROP[n]
    # where this lane leaves the 0.4 mm pitch for the 1.0 mm pitch of the vias: the outer lanes first
    x0 = 77.4 - 0.3 * (i if ys < y2 else 4 - i)
    pts += [[x0, y2], [x0 - abs(y2 - ys), ys]]
    pts.append([fx, ys])
    bus.append(track(pts, width=0.2, via=(0.6, 0.3)))
    bus.append(track([f"J7.{pin}", [fx - 0.5, py], [fx, py + 0.5], {"via": [fx, ys]}], width=0.2, via=(0.6, 0.3)))
# The I/O expander has 24 pins 0.65 mm apart. Left to itself the autorouter puts its vias at the
# ends of some pins and so shuts in their neighbours. Every pin gets its via here: alternately
# outside the pin row and under the package, 1.3 mm apart in each column. The two pull-up arrays
# get a via at each line pad as well.
U5 = ["# I/O expander: a stub and a via for every pin, alternately outside the row and under the package."]
for pin in range(1, 25):
    left = pin <= 12
    y = round(72.5 + 3.575 - 0.65 * (pin - 1), 3) if left else round(72.5 - 3.575 + 0.65 * (pin - 13), 3)
    outward = (pin % 2 == 1) if left else (pin % 2 == 0)
    x = (30.85 if outward else 33.45) if left else (39.15 if outward else 36.55)
    U5.append(track([f"U5.{pin}", {"via": [x, y]}], width=0.2, via=(0.6, 0.3)))
for k in range(4):
    U5.append(track([f"RN1.{k + 1}", {"via": [26.75, 75.7 - 0.8 * k]}], width=0.2, via=(0.6, 0.3)))
    U5.append(track([f"RN2.{k + 1}", {"via": [40.6, 75.7 - 0.8 * k]}], width=0.2, via=(0.6, 0.3)))
more = [m if m != "@U5@" else "\n".join(U5) for m in more]
more += bus
# Flash-over points at the field terminals (system specification, section 4; hardware design, 13.4).
# A ground rail on B.Cu below the terminal row, and from it a tooth towards the pad of every
# terminal that is not ground, ending 0.6 mm from the pad: the smallest gap that still keeps the
# 0.5 mm clearance of the 24 VAC nets. The solder mask is opened over each tooth.
GAP_PINS = [x for x, name in TERMINALS[2:] if name != "GND"]          # J2, J3 and J4; not the 24 VAC input
GAP_RAIL_Y, GAP_TIP_Y = 3.2, 3.95                                      # pad edge at y = 4.75; tooth 0.4 wide
more += ["# Flash-over points at the field terminals: ground rail and teeth on B.Cu. See layout.py.",
         track(["J4.3", [85.955, GAP_RAIL_Y], [30.225, GAP_RAIL_Y]], layer="B.Cu", width=0.5),
         track(["J4.7", [101.195, GAP_RAIL_Y], [85.955, GAP_RAIL_Y]], layer="B.Cu", width=0.5),
         track(["J4.5", [93.575, GAP_RAIL_Y]], layer="B.Cu", width=0.5)]
for gx in GAP_PINS:
    more.append('[[track]]\nlayer = "B.Cu"\nwidth = 0.4\nnet = "GND"\n'
                f"points = [[{gx:g}, {GAP_RAIL_Y:g}], [{gx:g}, {GAP_TIP_Y:g}]]\n")
    more.append('[[line]]\nlayer = "B.Mask"\nwidth = 0.6\n'
                f"points = [[{gx:g}, {GAP_TIP_Y - 0.25:g}], [{gx:g}, {GAP_TIP_Y:g}]]\n")
more += [
    "# ADC lines (hardware design, section 8.5: the current waveform may not come near the keep-alive).\n"
    "# From the series resistors at the amplifier on B.Cu, east along y = 67, south of everything the\n"
    "# keep-alive touches, north under the comparator block and the module to pins 39 and 38. The\n"
    "# filter capacitors C30 and C31 sit on the way.",
    track(["R46.2", {"via": [25.4, 66.75]}, [109.2, 66.75], [109.6, 67.15], [109.6, 107.24], [110.3, 107.24]],
          width=0.2, via=(0.6, 0.3)),
    track(["U4.39", {"via": [110.3, 107.24]}], width=0.2, via=(0.6, 0.3)),
    track(["C30.1", {"via": [109.6, 86.3]}], width=0.2, via=(0.6, 0.3)),
    track(["R47.2", {"via": [42.6, 68.0]}, [42.85, 67.75], [107.6, 67.75], [108.0, 68.15], [108.0, 105.97]],
          width=0.2, via=(0.6, 0.3)),
    track(["U4.38", {"via": [108.0, 105.97]}], width=0.2, via=(0.6, 0.3)),
    track(["C31.1", {"via": [108.0, 86.3]}], width=0.2, via=(0.6, 0.3)),
    "# Flow input: from R79 up the right edge on B.Cu, round the top of the ADC lines under the module,\n"
    "# and down to module pin 5.",
    track(["R79.2", {"via": [112.7, 53.4]}, [112.7, 107.6], [112.3, 108.0], [97.4, 108.0], [97.0, 107.6], [97.0, 104.2]],
          width=0.2, via=(0.6, 0.3)),
    track(["U4.5", [95.8, 103.43], {"via": [97.0, 104.2]}], width=0.2, via=(0.6, 0.3)),
    "# Display connector, open side: ground, 3.3 V, the backlight anode and cathode.",
    track(["J7.1", [56.6, 85.68], "C37.2"], width=0.25),
    track(["J7.12", {"via": [58.95, 91.25]}], width=0.25, via=(0.6, 0.3)),
    track(["J7.9", "J7.8"], width=0.25),
    track(["J7.8", [56.5, 89.18], "C38.1"], width=0.25),
    track(["J7.6", [56.5, 88.18], "R63.2"], width=0.2),
    track(["J7.10", [56.0, 90.18], [55.5, 90.68], [55.5, 91.6], "R60.2"], width=0.3),
    track(["J7.11", [56.55, 90.68], [56.55, 95.3], "Q4.3"], width=0.3),
    "# V_DRV, the opto LED supply: one bus under the LED row, a stub to each resistor.",
    track(["R901.1", [22.075, 40.75], [105.925, 40.75], "R802.1"], width=0.3),
]
for n in order:
    k, x0 = NUM[n], LEDX[n]
    if n != "MV":
        more.append(track([f"R{k}01.1", [x0 - 3.925, 40.75]], width=0.3))
    if n != "Z8":
        more.append(track([f"R{k}02.1", [x0 + 3.925, 40.75]], width=0.3))
more += [
    "# Ground for a pad where the fan-out finds no place by itself.",
    track(["J5.A12", [11.25, 7.65], [14.15, 7.65], "R17.2"], width=0.3),
]

GL = "group.channel_logic.track"
logic_tracks = [
    "# Copper of one LED cell: resistor to LED, LED cathode to the opto LED cathode, resistor to the\n"
    "# opto LED anode. Offsets from the LED.",
    track(["R2.2", "D2.2"], width=0.25, table=GL),
    track(["D2.1", [-0.7875, 1.4], [0.0, 2.2], "U1.2"], width=0.25, table=GL),
    track(["R1.2", [-2.275, 1.2], [-2.54, 1.5], "U1.1"], width=0.25, table=GL),
]

# Gate and opto-output lines: from the two vias at the top of each column, sideways in the strip
# under the LED row, then up under the opto-triac to a via beside its pin. The opto-output lines
# take In2.Cu and the gate lines B.Cu: on one layer the eighteen would need more lanes than fit.
GATE_LANES = [40.75 + 0.8 * i for i in range(6)]

def lanes_for(jobs, what):
    done = []
    for xs, ys, xd, pad in sorted(jobs):
        for lane in GATE_LANES:
            poly = [(xs, ys), (xs, lane), (xd, lane), (xd, 53.4)]
            if all(seg_dist(a, b, c, d) >= 0.79 for other, _ in done
                   for a, b in zip(poly, poly[1:]) for c, d in zip(other, other[1:])):
                done.append((poly, pad))
                break
        else:
            raise SystemExit(f"no lane for the {what} line to {pad}")
    print(f"{what} lines: {len(done)} routed, highest lane y = {max(q[0][1][1] for q in done):.2f}")
    return done

ogt = lanes_for([(COLS[n] - 0.89, 39.65, LEDX[n] - 2.54, f"U{NUM[n]}01.6") for n in order], "opto-output")
gate = lanes_for([(COLS[n] + 0.675, 39.4, LEDX[n] + 2.54, f"U{NUM[n]}01.4") for n in order], "gate")
gate_tracks = ["# Opto-output lines of the nine channels on In2.Cu, gate lines on B.Cu: sideways in the strip\n"
               "# under the LED row, then under each opto-triac to a via beside its pin. 0.3 mm, 0.5 mm apart."]
for jobs, layer in ((ogt, "In2.Cu"), (gate, "B.Cu")):
    for poly, pad in jobs:
        (xs, ys), (_, lane), (xd, _), _ = poly
        gate_tracks.append(track([pad, {"via": [xd, 53.4]}, [xd, lane], [xs, lane], [xs, ys]], width=0.3,
                                 via=(0.6, 0.3), via_to=layer))
COPPER = "\n".join(group_tracks) + "\n" + "\n".join(lane_tracks) + "\n" + "\n".join(zones) + "\n" + "\n".join(hand) + "\n" + "\n".join(kelvin) + "\n" + "\n".join(more) + "\n" + "\n".join(logic_tracks) + "\n" + "\n".join(gate_tracks)

# =============================================================================================
# Silkscreen labels
# =============================================================================================
def text(t, x, y, size=1.0, thickness=0.15, layer="F.SilkS", **kw):
    s_ = ["[[text]]", f'text = "{t}"', f'layer = "{layer}"', f"at = [{x:g}, {y:g}]", f"size = {size:g}",
          f"thickness = {thickness:g}"]
    for k, v in kw.items():
        s_.append(f"{k} = {str(v).lower()}" if isinstance(v, bool) else f'{k} = "{v}"' if isinstance(v, str) else f"{k} = {v:g}")
    return "\n".join(s_) + "\n"

LABEL_Y = 8.25      # the strip behind the terminal headers, kept free of pads: y = 7.6 to 8.9
labels = ["# Terminal labels, one behind each terminal, as the installer reads them with the plugs in.\n"
          "# The names are those of the wiring page of the manual."]
# Letters 0.8 mm wide and 1.0 mm high: at 1.0 mm wide "FLOW" and "GND" stood 0.1 mm apart on the
# 3.81 mm pitch and read as one word (layout review, L12).
labels += [text(t, x, LABEL_Y, width=0.8) for x, t in TERMINALS]
labels += [
    "# Terminal 2 of the 24 VAC block is the board's ground (hardware design, section 16.1): a ground\n"
    "# symbol right of its label, and the word.",
    "[[line]]\nlayer = \"F.SilkS\"\nwidth = 0.15\npoints = [[24.7, 8.9], [24.7, 8.3]]\n",
    "[[line]]\nlayer = \"F.SilkS\"\nwidth = 0.15\npoints = [[23.9, 8.3], [25.5, 8.3]]\n",
    "[[line]]\nlayer = \"F.SilkS\"\nwidth = 0.15\npoints = [[24.2, 7.95], [25.2, 7.95]]\n",
    "[[line]]\nlayer = \"F.SilkS\"\nwidth = 0.15\npoints = [[24.5, 7.6], [24.9, 7.6]]\n",
    "# Fuse ratings.",
    text("F4 3A T", 15.0, 16.6),
    text("F1 3A T", 27.0, 16.6),
    text("F5 0.5A FF", 31.1, 39.0, optional=True),
    "# Board name, revision, licence and status, in the open area under the display.",
    text("ZoneFlow", 26.0, 106.6, size=2.0, thickness=0.3),
    text("rev A", 38.2, 106.4, size=1.5, thickness=0.25),
    text("ENGINEERING PROTOTYPE", 26.0, 103.6, size=1.3, thickness=0.2),
    text("Not built, not tested", 26.0, 101.5),
    text("CERN-OHL-P-2.0", 26.0, 99.8),
    "# Connectors, buttons and the debug pads.",
    text("USB", 8.0, 9.6, optional=True),            # where the designator of J5 was: that is hidden
    text("QWIIC", 106.2, 8.25, optional=True),
    text("RESET", 55.3, 105.5, optional=True),
    text("BOOT", 55.0, 100.0, optional=True),
    text("BACK", 22.0, 66.0, optional=True),
    text("HOME", 48.0, 67.4, optional=True),
    "# The cell: its name above the holder, and a plus above the positive land, which is at the left.",
    text("CR2032", 86.0, 73.6, optional=True),
    text("+", 80.5, 68.5, optional=True),
]
for name, y in (("3V3", 93.5), ("GND", 90.96), ("TX", 88.42), ("RX", 85.88), ("EN", 83.34), ("IO0", 80.8)):
    labels.append(text(name, 73.0, y, justify="right", optional=True))
labels += [
    "# Bottom side.",
    text("ZoneFlow rev A   ENGINEERING PROTOTYPE   CERN-OHL-P-2.0", 57.0, 99.6, size=1.3, thickness=0.2, layer="B.SilkS"),
    text("JP1: bridge only if K1 is not fitted", 26.0, 20.5, layer="B.SilkS"),
    text("C1 +", 39.2, 34.6, layer="B.SilkS", optional=True),
]
LABELS = "\n".join(labels)

# =============================================================================================
# Route settings, silkscreen, and the file itself
# =============================================================================================
TAIL = '''
# ---- copper ---------------------------------------------------------------------------------------
# Layer use: F.Cu parts and signals, In1.Cu ground, In2.Cu supply planes and the valve fan-out,
# B.Cu signals, the triac heat islands and ground.
[route]
layers = ["F.Cu", "B.Cu"]             # In1.Cu is the ground plane and In2.Cu the 3.3 V plane: see [[route.plane]]
plane_layers = ["In2.Cu"]             # for the routing report: a track here is a slot in a pour
clearance_margin = 0.01               # the autorouter works to 0.01 mm more than DRC checks
prune = true                          # after routing, take away the escape vias that were not used
widen = true                          # and give the autorouter's tracks their class width where there is room
# Nets the autorouter must leave alone: they connect through planes, pours or hand-routed copper.
exclude = ["GND", "3V3", "V_BUCK", "VBUS", "/VIN_MON", "/RLY_B_RB", "/ISNS", "/OUT_*", "/*/T2", "/*/SNB", "/AC_L_IN", "/AC_N", "/AC_L", "/COM",
           "/Power/VRECT", "VIN_DC", "/Power/VIN_U1", "/Power/UVLO", "/Power/SW", "/Power/BST", "/KA",
           "/Failsafe/KA_N0", "/Failsafe/KA_N1", "/KA_N2", "/Failsafe/KA_INP", "/Failsafe/OV_DIV",
           "/TFT_CS", "/TFT_MOSI", "/TFT_SCLK", "/TFT_DC", "/TFT_RST", "/TFT_BL", "/Display/TFT_LEDA",
           "/Display/TFT_LEDK", "/USB_DP_MCU", "/USB_DM_MCU", "/ADC_LO", "/ADC_HI", "/SENS_FLOW", "/ENC_B",
           "/Power/FB", "/Power/RIP", "/Power/FB_MID", "/Power/RON", "/*/G", "/*/OGT", "/*/OLA", "/*/LEDA"]

# The patch router closes what the autorouter leaves open on F.Cu and B.Cu. Where a connection has
# no path on those two, it may tunnel under the obstacle on In2.Cu. Such a track is a slot in the
# 3.3 V plane, so a millimetre there costs six elsewhere, and it stays out of these rectangles: the
# Kelvin sense pair of the shunt, which runs on B.Cu right under that layer. The [[route.keepout]]
# rectangles that name In2.Cu, round the keep-alive net and over the valve block, close it too.
# This table is not part of what the stored routing was made from.
[route.patch_last_resort]
layer = "In2.Cu"
cost = 6
keepout = [[17.8, 23.2, 19.6, 59.5], [17.8, 23.2, 34.7, 25.0], [32.7, 16.7, 34.7, 25.0],
           [17.8, 57.7, 33.3, 59.5], [31.3, 57.7, 33.3, 63.4],
           # 3 mm either side of the keep-alive net, which is on B.Cu, the layer next to In2.Cu. The
           # hardware design asks for 1 mm. A first set of patches kept that and ran the rain input
           # for 17 mm within 2 mm of the keep-alive on In2.Cu: more than a reviewer signs.
           [41.2, 75.6, 95.5, 81.6], [89.5, 75.6, 95.5, 90.6], [89.5, 84.6, 99.5, 100.1]]

# In1.Cu is the ground plane. Freerouting is told so in the Specctra file, as a power layer with a
# plane: the "routable" flag of its settings is not obeyed. The build fails if a track is on it.
[[route.plane]]
layer = "In1.Cu"
net = "GND"

# In2.Cu is the 3.3 V plane over the logic area, with the shunt return plane and the copy of the valve
# fan-out beside it. The autorouter gets no track on it: what it laid there in the first routing cut
# the 3.3 V pour into 21 pieces (layout review, L3).
[[route.plane]]
layer = "In2.Cu"
net = "3V3"

# Under the heads of the two pan-head board screws (mounting holes C and D, 5.6 mm heads): no track
# and no via on F.Cu. The first routing had a USB data line under one and two Qwiic nets under the
# other (layout review, L7).
[[route.keepout]]
layers = ["F.Cu"]
rect = [1.5, 9.0, 7.5, 15.0]

[[route.keepout]]
layers = ["F.Cu"]
rect = [106.5, 9.0, 112.5, 15.0]

# Where the autorouter may put neither track nor via: the valve block on B.Cu (heat islands) and
# on In2.Cu (shunt plane and fan-out lanes), which it cannot see because they are added afterwards.
# "stands_for_copper": the patch router reads the finished board, sees that copper itself and
# needs no fence here. Every other rectangle of this list closes the area to it as well.
[[route.keepout]]
layers = ["B.Cu", "In2.Cu"]
rect = [39.4, 7.3, 103.3, 38.9]
stands_for_copper = true

[[route.keepout]]
layers = ["In2.Cu"]
rect = [34.6, 18.6, 39.4, 40.1]
stands_for_copper = true

# The keep-alive net runs on B.Cu. Nothing is routed there within 1.1 mm of it, nor on In2.Cu, the
# layer next to it with no plane between. The pours stay. The [[guard]] strips say the same to DRC
# for the long segments; these rectangles also cover the vias and the corners.
[[route.keepout]]
layers = ["In2.Cu", "B.Cu"]
rect = [95.1, 88.9, 97.3, 98.2]

[[route.keepout]]
layers = ["In2.Cu", "B.Cu"]
rect = [92.8, 86.5, 97.6, 88.9]

[[route.keepout]]
layers = ["In2.Cu", "B.Cu"]
rect = [91.4, 78.6, 93.6, 87.6]

[[route.keepout]]
layers = ["In2.Cu", "B.Cu"]
rect = [43.1, 77.5, 92.6, 79.7]

# The three short pieces of the keep-alive on F.Cu: at the module pin, at R33 and R29, at R89.
# A track of 0.2 mm that leaves a neighbouring module pin straight stays just outside.
[[route.keepout]]
layers = ["F.Cu"]
rect = [93.2, 95.96, 97.45, 98.2]

[[route.keepout]]
layers = ["F.Cu"]
rect = [94.6, 86.45, 98.3, 88.75]

[[route.keepout]]
layers = ["F.Cu"]
rect = [43.0, 77.45, 46.3, 79.75]

# Between detector B and the encoder no net has a reason to cross the keep-alive: closed on F.Cu too.
[[route.keepout]]
layers = ["F.Cu"]
rect = [56.6, 78.05, 80.4, 79.15]

# A via beside every surface-mount pad of a plane net.
[[plane]]
net = "GND"
skip = ["U4.41", "U1.9", "R40.1", "R44.1", "J7.1", "J7.12", "J5.A12", "J5.B1", "U5.2", "U5.12", "U5.21", "C25.2", "U2.2", "U13.2", "U13.3", "R35.2"]   # exposed pads: vias by hand. R40, R44: Kelvin, see below

[[plane]]
net = "3V3"
skip = ["J7.8", "J7.9", "U5.24", "U3.2"]     # J7: joined to C38 by a track. U5: its own via. U3: five vias by hand
# where the 3.3 V pour on In2.Cu is
within = [[0.9, 45.7, 113.1, 109.1], [104.4, 5.4, 113.1, 45.7], [0.9, 16.4, 9.1, 45.7]]

@COPPER@

# Five vias in the bar between pin 2 and the tab of U3, into the 3.3 V plane. Staggered, 1.4 mm apart,
# so that their clearance holes leave the ground plane whole. Clear of the Kelvin pair at x = 18.4 on B.Cu.
[[via]]
net = "3V3"
at = [12.75, 50.1]
size = [0.6, 0.3]

[[via]]
net = "3V3"
at = [14.0, 50.7]
size = [0.6, 0.3]

[[via]]
net = "3V3"
at = [14.8, 49.5]
size = [0.6, 0.3]

[[via]]
net = "3V3"
at = [15.6, 50.7]
size = [0.6, 0.3]

[[via]]
net = "3V3"
at = [16.4, 49.5]
size = [0.6, 0.3]

# Six vias under the exposed pad of U1, 1.3 x 1.2 mm apart, into the ground plane and the ground
# pour on B.Cu (LM5164 data sheet, 7.4.1, item 10; TI's example has six of 0.33 mm).
[[via]]
net = "GND"
at = [20.85, 31.8]
size = [0.6, 0.3]

[[via]]
net = "GND"
at = [22.15, 31.8]
size = [0.6, 0.3]

[[via]]
net = "GND"
at = [20.85, 33.0]
size = [0.6, 0.3]

[[via]]
net = "GND"
at = [22.15, 33.0]
size = [0.6, 0.3]

[[via]]
net = "GND"
at = [20.85, 34.2]
size = [0.6, 0.3]

[[via]]
net = "GND"
at = [22.15, 34.2]
size = [0.6, 0.3]

# Ground vias along the keep-alive corridor, 1.5 mm from the track: they tie the ground pour that
# runs on both sides of it on B.Cu to the ground plane.
[[via]]
net = "GND"
at = [50, 80.1]
size = [0.6, 0.3]

[[via]]
net = "GND"
at = [58, 80.1]
size = [0.6, 0.3]

[[via]]
net = "GND"
at = [66, 80.1]
size = [0.6, 0.3]

[[via]]
net = "GND"
at = [83.75, 80.1]
size = [0.6, 0.3]

[[via]]
net = "GND"
at = [86.25, 80.1]
size = [0.6, 0.3]

[[via]]
net = "GND"
at = [58, 77.1]
size = [0.6, 0.3]

[[via]]
net = "GND"
at = [66.5, 77.1]
size = [0.6, 0.3]

[[via]]
net = "GND"
at = [70, 77.1]
size = [0.6, 0.3]

[[via]]
net = "GND"
at = [85, 77.1]
size = [0.6, 0.3]

[[via]]
net = "GND"
at = [94.05, 83]
size = [0.6, 0.3]

# No other track or via within 1 mm of the keep-alive net (hardware design, section 8.5).
[[guard]]
net = "/KA"
distance = 1.0

# ---- layout rules of the fail-safe analysis, checked by hwflow.layoutrules after DRC ----------------
# Hardware design, section 8.5, "Layout rules that follow". docs/design/hardware-layout.md, section 9,
# goes through them one by one.
#
# Rule 1, second half: the nets that toggle with no control loop behind them stay 1 mm from the
# keep-alive net in plan view, on whatever layer. Not even a crossing on another layer passes.
[[keepaway]]
net = "/KA"
from = ["unconnected-(U4-IO3[567]-Pad*",                       # the PSRAM lines of the module
        "/TFT_BL", "/Display/BL_G", "/Display/TFT_LEDK",        # backlight PWM, and what it switches
        "/Connectors/U0TXD", "/U0TXD_MCU",                      # boot log
        "/AC_ZC",                                               # zero-cross signal
        "/SENS_FLOW", "/Sensors/N_FLOW", "/T_FLOW",             # flow meter pulses
        "/ADC_LO", "/ADC_HI", "/ISENSE_LO", "/ISENSE_HI",       # the current waveform
        "/USB/USB_D[PM]", "/USB_D[PM]_MCU",                     # USB data
        "/TFT_SCLK", "/TFT_MOSI",                               # display clock and data
        "/Power/SW"]                                            # buck switch node
distance = 1.0
scope = "plan"

# The same for the node behind the 220 ohm series resistor R29, which is the keep-alive net to a bridge.
[[keepaway]]
net = "/Failsafe/KA_N0"
from = ["unconnected-(U4-IO3[567]-Pad*", "/TFT_BL", "/Display/BL_G", "/Display/TFT_LEDK", "/Connectors/U0TXD",
        "/U0TXD_MCU", "/AC_ZC", "/SENS_FLOW", "/Sensors/N_FLOW", "/T_FLOW", "/ADC_LO", "/ADC_HI", "/ISENSE_LO",
        "/ISENSE_HI", "/USB/USB_D[PM]", "/USB_D[PM]_MCU", "/TFT_SCLK", "/TFT_MOSI", "/Power/SW"]
distance = 1.0
scope = "plan"

# Rule 1, first half: 1 mm to the tracks and vias of any other signal on the same layer. Ground is
# what is wanted on both sides. Pads are left out: at the module pin and at R33, R29 and R89 the
# neighbouring pads are closer than that by the pitch of the parts.
[[keepaway]]
net = "/KA"
from = ["*"]
except = ["GND"]
distance = 1.0
scope = "layer"
kinds = ["track", "via"]
own_kinds = ["track", "via"]

# Rules 2 and 3: no supply rail within 1 mm of the nodes where a leak holds a detector on, pads included.
[[keepaway]]
net = "/Expander/RLY_G2"
from = ["3V3", "V5", "V_BUCK", "VBUS", "V_DRV"]
distance = 1.0
scope = "layer"

[[keepaway]]
net = "/Expander/KB_N1"
from = ["3V3", "V5", "V_BUCK", "VBUS", "V_DRV"]
distance = 1.0
scope = "layer"

[[keepaway]]
net = "/Failsafe/KA_N1"
from = ["3V3", "V5", "V_BUCK", "VBUS", "V_DRV"]
distance = 1.0
scope = "layer"

[[keepaway]]
net = "/KA_N2"
from = ["3V3", "V5", "V_BUCK", "VBUS", "V_DRV"]
distance = 1.0
scope = "layer"

[[keepaway]]
net = "/Failsafe/KA_INP"
from = ["3V3", "V5", "V_BUCK", "VBUS", "V_DRV"]
distance = 1.0
scope = "layer"

# The tap of the over-voltage divider, 100 kohm behind it: the hardware design asks for it short and
# away from the switch node, the keep-alive and the display lines (hardware-answers-a2.md, section 6).
[[keepaway]]
net = "/Failsafe/OV_DIV"
from = ["/Power/SW", "/KA", "/TFT_SCLK", "/TFT_MOSI", "/TFT_CS", "/TFT_DC", "/TFT_RST", "/TFT_BL"]
distance = 10.0
scope = "plan"

# Rule 2: no test pad on these nets. TP8 on KA_N2 is allowed by the rule and is covered above.
[[no_pad]]
nets = ["/Expander/RLY_G2", "/Expander/KB_N1", "/Expander/KB_N0", "/Failsafe/KA_N1"]
refs = "TP*"

# Rule 4: the two pumps at least 10 mm apart, their capacitors at right angles.
[[apart]]
a = ["R29", "C22", "D7"]
b = ["R89", "C51", "D22"]
distance = 10.0

[[perpendicular]]
parts = ["C22", "C51"]

# ---- silkscreen -----------------------------------------------------------------------------------
# 349 of the 351 footprints are on one side: the designators of the small parts do not fit between them. They are left
# off the silkscreen and are on the assembly drawing (F.Fab) instead. Connectors, ICs, switches,
# fuses, test pads and the bottom-side parts keep theirs. "clean" lets the builder take away what
# DRC then still finds wrong: an outline over a neighbour's pad, a designator with no free place.
[silk]
clean = true
hide = ["R*", "C[2-9]", "C[1-9][0-9]", "C[1-9][0-9][0-9]", "D*", "F[23]", "F[1-9]0[0-9]", "Q*", "L*", "Y*",
        "H*", "U[1-9]0[0-9]", "J5"]

@LABELS@

# The builder takes strokes off the silkscreen outline of a footprint where DRC finds them over a
# neighbour's pad (see [silk]). Such a footprint no longer equals its library copy, and DRC would
# say so for each one. Nothing else in a footprint can differ: the board is built from the
# libraries on every run and no board file is edited by hand.
[drc_severity]
lib_footprint_mismatch = "ignore"
'''

def main(board_dir: Path) -> int:
    out = [HEAD.rstrip(), ""]
    out.append("# Placement: reference = [x, y, rotation, side]. x, y is the footprint anchor.")
    out.append("[place]")
    for title, refs in notes:
        if not refs:
            continue
        out.append("")
        for line in title.split("\n"):
            out.append(f"# {line}")
        for r in refs:
            x, y, rot, side = place[r]
            tail = f', "{side}"' if side != "F" else ""
            out.append(f"{r} = [{x:g}, {y:g}, {rot}{tail}]")
    out.append("")
    out.append(GROUPS.strip())
    out.append("")
    out.append(TAIL.replace("@COPPER@", COPPER).replace("@LABELS@", LABELS).strip())
    # What closes the connections the autorouter left open: written by hwflow.patchroute for one
    # stored routing (`make patches`), kept beside this file and passed on as it is.
    patches = board_dir / "design" / "patches.toml"
    if patches.exists():
        out += ["", patches.read_text(encoding="utf-8").strip()]
        # What the patch router could not close, closed by hand for the same stored routing.
        by_hand = board_dir / "design" / "patches-hand.toml"
        if by_hand.exists():
            out += ["", by_hand.read_text(encoding="utf-8").strip()]
    dest = board_dir / "design" / "board.toml"
    text = "\n".join(out) + "\n"
    if not dest.exists() or dest.read_text(encoding="utf-8") != text:
        dest.write_text(text, encoding="utf-8")
    print(f"layout: {len(place)} placements and {len(COLS)} channel instances -> {dest}")
    return 0


if __name__ == "__main__":
    raise SystemExit(main(Path(sys.argv[1]) if len(sys.argv) > 1 else Path(__file__).resolve().parents[1]))
