syntroniks/zoneflow/firmware/zoneflow-fw/components/zf_core/include/zf/diag/current_monitor.hpp

// SPDX-License-Identifier: Apache-2.0
// Valve current evaluation. The board measures one total current for all
// outputs (spec section 3.1), so the expected value is the sum of the
// windows of every output that is on, and a fault is attributed to the
// output that switched on most recently.
#pragma once

#include <array>
#include <cstdint>

#include "zf/types.hpp"

namespace zf {

// Default threshold for current with every output off (an output stuck on).
// Hardware design 19.2: 30 mA rms as the starting value; the smallest load
// is 50 mA, and a shorted output passes a valve's full current. Set the
// final value from the noise floor measured at bring-up. The standalone
// configuration (diagnostics.idle_max_ma) and the ESPHome component
// (current_sense.idle_threshold) both default to this.
inline constexpr uint16_t kDefaultIdleMaxMa = 30;

struct CurrentWindow {
    uint16_t minMa = 0;
    uint16_t maxMa = 0;
};

struct CurrentMonitorConfig {
    bool enabled = true;
    // Ignore window comparisons this long after any output change (inrush,
    // spec: 1.5 A for 100 ms, plus filter settling in the front end).
    uint32_t settleMs = 500;
    // Above this with every output off: an output is stuck on.
    uint16_t idleMaxMa = kDefaultIdleMaxMa;
    // Above this at any time, settled or not: short circuit.
    uint16_t shortCircuitMa = 3000;
    // Consecutive samples needed before a fault is declared.
    uint8_t confirmSamples = 3;
    // Current that rises while no output switches (a failed-short output
    // device adding its valve, firmware architecture section 22 gap 2): the
    // run's level is the mean of the first kRiseBaselineSamples settled
    // samples after the last output change; a sample above it by more than
    // riseMinMa and riseFraction of it counts. 0 disables.
    uint16_t riseMinMa = 40;
    float riseFraction = 0.2f;
    std::array<CurrentWindow, kMaxZones> zone{};
    CurrentWindow master{};
};

enum class CurrentFault : uint8_t {
    None,
    OpenCircuit,      // below the expected window: valve or wiring open
    OverCurrent,      // above the expected window: shorted coil, wrong valve
    ShortCircuit,     // above the absolute limit
    CurrentWhileIdle, // current with every output off: output stuck on
    CurrentRose,      // current rose with no output switched: another output may have failed short
};

const char *toString(CurrentFault f);

struct CurrentVerdict {
    CurrentFault fault = CurrentFault::None;
    uint8_t outputBit = 0xFF; // bit as in ZoneDriver::outputMask(); 0xFF = unknown
};

class CurrentMonitor {
public:
    static constexpr uint8_t kMasterBit = kMaxZones;
    static constexpr uint8_t kRiseBaselineSamples = 2;

    void configure(const CurrentMonitorConfig &cfg);

    // Lets a condition that is still present be reported again (after the
    // user cleared the faults).
    void rearm();

    // outputMask: bit z = zone z on, bit kMasterBit = master on.
    // Returns a fault once, when it is confirmed; later samples of the same
    // condition return None until the output mask changes or rearm(). A
    // short circuit is reported even after a milder condition was reported
    // for the same mask.
    // Over-current and short-circuit samples count towards one confirmation.
    CurrentVerdict evaluate(int32_t measuredMa, uint16_t outputMask, uint8_t lastOpenedBit, MonoMs lastChangeMs,
                            MonoMs now);

    // Mean current observed with only this output on (plus master, with the
    // master's own share removed). 0 if never observed. Basis for per-zone
    // learned current in a later phase.
    uint16_t observedMa(uint8_t bit) const { return bit <= kMasterBit ? observed_[bit] : 0; }

    // Per-run measurement: beginRun() when the output opens, runMeanMa()
    // when it closes. Mean of the samples learn() could attribute to this
    // output alone in between; 0 if there were none.
    void beginRun(uint8_t bit)
    {
        if (bit <= kMasterBit) {
            runSum_[bit] = 0;
            runCount_[bit] = 0;
        }
    }
    uint16_t runMeanMa(uint8_t bit) const
    {
        return bit <= kMasterBit && runCount_[bit] > 0 ? static_cast<uint16_t>(runSum_[bit] / runCount_[bit]) : 0;
    }

private:
    void learn(int32_t measuredMa, uint16_t mask);

    CurrentMonitorConfig cfg_{};
    uint16_t lastMask_ = 0xFFFF;
    CurrentFault pending_ = CurrentFault::None;
    uint8_t count_ = 0;
    CurrentFault reported_ = CurrentFault::None; // condition reported for lastMask_
    // The run's level since the last output change (CurrentRose).
    uint32_t baseSum_ = 0;
    uint8_t baseCount_ = 0;
    std::array<uint16_t, kMaxZones + 1> observed_{};
    std::array<uint32_t, kMaxZones + 1> runSum_{};
    std::array<uint32_t, kMaxZones + 1> runCount_{};
};

} // namespace zf
