syntroniks/zoneflow/firmware/zoneflow-fw/components/zf_core/include/zf/sched/scheduler.hpp

// SPDX-License-Identifier: Apache-2.0
// Scheduler engine: turns programs into a run queue and feeds the queue to
// the zone driver one entry at a time. Pure C++, no ESP-IDF.
//
// Time handling (details in docs/design/firmware-architecture.md):
//  - Start times are local wall-clock minutes, evaluated with TimeZone.
//    A start in a DST gap runs at the end of the gap; a start in a repeated
//    hour runs once, at the first occurrence.
//  - Every second the scheduler looks at the window (last evaluation, now].
//    A start in the window runs if it is no older than the missed-start grace
//    period; older starts are reported as missed. Only the newest start of a
//    program runs; earlier ones in the same window count as missed.
//  - Each program remembers the last start it consumed as a (local day,
//    minute) key, so a start never runs twice, even if the clock is set back
//    or the device reboots. The keys are persisted.
//  - A program with no stored key (never ran, or runtime state lost) gets
//    no catch-up: its key starts at the current minute.
//  - No scheduled start runs while the wall clock is not valid.
//
// Threads: control task only.
#pragma once

#include <array>
#include <cstddef>
#include <cstdint>

#include "zf/sched/program.hpp"
#include "zf/time/clock.hpp"
#include "zf/time/time_zone.hpp"
#include "zf/zone/zone_types.hpp"

namespace zf {

enum class RunSource : uint8_t { Schedule, ManualProgram, ManualZone };

enum class QueueState : uint8_t { Idle, Running, Paused };

enum class SkipReason : uint8_t {
    RainDelay,
    SensorInhibit,
    NoAc,
    Maintenance,
    AlreadyQueued,
    QueueFull,
    NothingToRun,
    MasterLockedOut,
    HardwareFault, // the output stage has a fault a person must acknowledge
};

enum class RunError : uint8_t {
    Ok,
    InvalidZone,
    UnknownProgram,
    ZeroDuration,
    QueueFull,
    AlreadyQueued,
    Inhibited,
    NothingToRun,
    LockedOut,   // zone locked out by a latched fault (RunZone)
    ZoneResting, // zone reached its maximum run time and is resting (RunZone)
    MasterLockedOut,
    HardwareFault, // the output stage has a fault a person must acknowledge
};

// Inhibit flags (bitmask).
enum InhibitFlag : uint8_t {
    kInhibitSensor = 1u << 0,        // rain/spare sensor active: scheduled runs only
    kInhibitNoAc = 1u << 1,          // no 24 VAC: everything
    kInhibitMaintenance = 1u << 2,   // OTA or service mode: everything
    kInhibitMasterLockout = 1u << 3, // master valve locked out: everything
    kInhibitHardware = 1u << 4,      // output-stage fault (hardware design 19.7): everything
};

const char *toString(RunSource s);
const char *toString(QueueState s);
const char *toString(SkipReason r);
const char *toString(RunError e);

struct RunEntry {
    uint32_t id = 0;
    ZoneIndex zone = kNoZone;
    uint32_t durationSec = 0; // as queued (after seasonal adjustment)
    uint32_t remainingMs = 0; // updated on pause
    RunSource source = RunSource::ManualZone;
    uint16_t programId = 0; // 0 for manual zone runs
};

struct SchedulerConfig {
    ScheduleConfig schedule;
    uint8_t zoneCount = kMaxZones;
    std::array<bool, kMaxZones> zoneEnabled{};
};

// Persisted across reboots.
struct SchedulerPersist {
    struct Fired {
        uint16_t programId = 0;
        int64_t key = 0; // localDay * 1440 + minute of the last consumed start
    };
    UtcSeconds rainDelayUntil = 0;
    uint8_t count = 0;
    std::array<Fired, kMaxPrograms> fired{};
};
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
