syntroniks/zoneflow/(commit log)

2026-11-10 docs: add system specification and repository skeleton
    Establish the spec that hardware, firmware, enclosure and docs work
    is checked against, plus licences and contributor rules.
2026-11-10 docs: add mkdocs site, safety and contributing pages (#12)
    * docs: add mkdocs site, safety and contributing pages
    Set up MkDocs Material with pinned uv dependencies in a root docs group, a landing page with an early-design status banner, navigation skeleton from spec section 6, and a GitHub Pages workflow (build on pull requests, deploy on main). Refs #10.
    * ci: pin setup-uv to v10.3.3
    The action has no floating v10 tag, so the major-only reference does not resolve.
    ---------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
2026-11-10 docs: add prior-art survey and revise spec to v0.2 (#13)
    The survey shows a decade of field use behind the OpenSprinkler triac
    topology and names the failures to design against: blown triacs from
    shorted wiring, 45 V regulators on unloaded transformers, boot
    glitches and crashes that leave valves on. Adopt that topology with a
    60 V supply, per-output fault limiting and a hardware keep-alive gate.
    Closes #2
2026-11-10 feat(hw): add scripted kicad toolchain and test board (#15)
    * feat(tools): add hwflow text-to-kicad generator
    The board will be designed by agents with no GUI. hwflow turns a
    circuit written as Python into KiCad 10 schematic sheets, then drives
    kicad-cli and the pcbnew module to build, route and check the board.
    After writing the sheets it asks KiCad for the netlist and compares it
    pin by pin with the netlist the description means, so a bad drawing
    fails the build before ERC runs.
    Refs #3
    * feat(hw): add shared board build rules and jlcpcb limits
    flow.mk is the one-command build every board directory includes. I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
    [ac_channel.kicad_sch, mcu.kicad_sch, power_usb.kicad_sch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]
2026-11-10 docs: specify colour tft display in spec v0.3 (#16)
    * docs: specify colour tft display in spec v0.3
    The project owner wants a clearly better local interface than the
    small screens on existing controllers. Replace the 128x64 OLED with a
    2.0-2.4 inch 320x240 IPS panel without touch, and add a second button.
    * docs: update site pages for the colour display
    ---------
2026-11-10 feat(fw): firmware phase 1: core, safety, scheduler, tests, CI (#14)
    * feat(fw): add host-testable core library
    zf_core holds every firmware decision in plain C++ with no ESP-IDF
    headers, so the same code runs on the device and in host tests:
    - zone driver: all-off at init and on faults, hard per-zone maximum
    run time, concurrency limit, master pre-open/post-close, inter-zone
    delay, emergency off from any context
    - output-enable guard: decides when the OE keep-alive may drive OE
    (demand, control-loop heartbeat, trip latch); toggle or static mode
    - scheduler: programs, day rules, seasonal adjust, rain delay, sensor
    inhibit, manual runs, run queue with pause/resume/skip/stop, POSIX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
    [partitions.csv]
2026-11-10 feat(fw): phase 2 core hardening (#18)
    * fix(fw): reject newer-schema config sent through the api
    updateFromJson accepted a document from newer firmware and wrote it
    back as schema 1, dropping the fields this firmware does not know. A
    stored newer config is already kept intact; the API path now refuses
    such a document with path "schema".
    Test ConfigStore.NewerSchemaThroughApiIsRejected failed before the fix.
    * fix(fw): report a short circuit after an idle-current fault
    With every output off, current_while_idle was reported once per output
    mask. A current that then rose past short_circuit_ma was not reported
    until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
    [partitions.csv]
2026-11-10 feat(fw): add network, rest api and ota modules (phase 2) (#19)
    * feat(fw): add network, rest api and ota modules
    Implement the phase 2 stubs zf_net, zf_web and zf_ota on top of
    AppServices only; zf_core and zf_platform are unchanged.
    - zf_net: station with jittered backoff and no BSSID/channel lock,
    BLE provisioning with Security 2 and a per-device setup code,
    WPA2 SoftAP fallback with captive DNS, hostname and mDNS,
    re-provision request and factory reset.
    - zf_web: /api/v1 REST API driven by one route table, admin password
    (PBKDF2-SHA-256), sessions, login rate limiting, CSRF token, Host
    and Origin checks, body caps before parsing, SSE event stream,
    static files from LittleFS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
    [api.cpp, auth.cpp, command_watch.cpp, crypto.cpp]
2026-11-10 feat(fw): add display interface, simulator and screenshots (#21)
    * feat(fw): add display interface for the 320x240 tft
    Replace the OLED stub in zf_display with the local interface of spec
    v0.3: home, manual run, zones, programs with on-device editing, rain
    delay, sensors, faults, setup and a first-boot wizard, on an
    ST7789-class panel with a rotary encoder and two buttons.
    The component has three layers so that most of it runs without
    hardware. src/ui is the logic: it turns the core's snapshot and the
    user's inputs into a Frame of plain strings, icons and tones, and has
    no LVGL or ESP-IDF in it. src/view draws a Frame with LVGL 9.6.
    src/port is the ESP-IDF side: esp_lcd over SPI with DMA a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
    [app_main.cpp, display.cpp, display_ports.hpp, faults.hpp, format.hpp]
2026-11-10 fix(fw): security review of the network layer (phase 3) (#23)
    * fix(fw): serve provisioning routes only to setup ap clients
    SoftAP provisioning keeps running for about 30 s after the station has
    joined the home network (provisioning manager auto-stop). In that
    window the unauthenticated provisioning routes answered LAN clients
    too, so any device on the home network could set the admin password
    through POST /provision/wifi when the owner left it empty, start WiFi
    scans, and get the plain-HTTP exemption and captive redirect.
    The glue now marks a request as coming from the setup access point by
    the socket's local address, and admit() refuses provisioning routes
    without it (403 setup_ap_only).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
    [api.cpp, auth.cpp, crypto.cpp, crypto_test.cpp, json_map.cpp]
2026-11-10 feat(fw): add mqtt client with home assistant discovery (#22)
    * feat(fw): add mqtt client with home assistant discovery
    Implement zf_mqtt on top of AppServices only. Settings are a new mqtt
    object in the core configuration (schema 2, migrated from schema 1);
    the password and a custom CA live in NVS and are write-only through
    the new GET/PUT /api/v1/mqtt routes.
    Retained and empty messages are never commands, commands are rate
    limited and validated against the core's limits, and rejections come
    from the core's CommandRejected event. State is tracked as dirty bits so
    memory stays bounded while the broker is away. Home Assistant device
    discovery follows the 2026.11.1 documentation.
    Host test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
    [api.cpp, config.cpp, config.hpp, config_json.cpp, config_test.cpp]
2026-11-10 feat(hw): rev a circuit design, pin map, netlist and bom (#20)
    * feat(hw): add rev a circuit design, pin map, netlist and bom
    Paper design for the rev A board, written so that schematic capture is
    a translation job. No board exists and nothing here is measured.
    - docs/design/hardware-design.md: every block with part numbers,
    calculations from datasheet figures, single-fault analysis of the
    fail-safe gate, risk register and bring-up plan.
    - hardware/pinmap.yaml: every GPIO, I2C address and expander bit, for
    the firmware board header.
    - hardware/netlist.yaml: every component with the net on every pin.
    - hardware/bom-preliminary.csv: LCSC numbers, stock and prices checked
    against the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
    [bom-preliminary.csv]
2026-11-10 feat(fw): web ui for the standalone firmware (phase 3) (#25)
    * test(fw): check the scheduler against shared schedule vectors
    The web UI previews the next seven days of runs in the browser. These
    vectors (DST gaps and repeats in three hemispheres, interval, odd/even,
    leap day, seasonal rounding, disabled zones, rain delay) are run through
    the real Scheduler here and through the UI preview there, so the two
    cannot drift apart unnoticed.
    * feat(fw): add the web ui, mock controller and its tests
    Preact and TypeScript UI served from the www partition: first-run setup,
    dashboard with live state and an always-reachable s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
    [api.cpp, app_main.cpp, controller.cpp, controller.hpp, current_monitor.cpp, current_monitor.hpp, event.hpp]
2026-11-10 feat(enclosure): add enclosure concept and mechanical contract (#24)
    agains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
    [board_params.scad, params.scad, zoneflow-base.3mf, zoneflow-base.stl, zoneflow-bridge.3mf, zoneflow-bridge.stl, zoneflow-button-back.3mf, zoneflow-button-back.stl]
2026-11-10 feat(fw): align the firmware with the rev a board (#28)
    * feat(fw): drive the rev a output stage and its self-test
    Adapt the firmware to the reviewed rev A hardware (hardware design
    section 19, hardware/pinmap.yaml).
    - Board header generated from hardware/pinmap.yaml at every build by
    tools/gen_board_header.py; the provisional map and the ZF_DISPLAY
    shared-pin option are gone: one build, display included.
    - OutputStage: TCA9539 register sequence with read-back after every
    write and a scrub every tick, at most three valve bits low, bounded
    I2C with bus recovery, the self-test of 19.7 at start-up and around
    every run, relay sequencing, weld and shorted-output checks, the
    19.6 pol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
    [api.cpp, app_main.cpp, command.hpp, controller.cpp, controller.hpp, controller_test.cpp]
2026-11-10 feat(hw): capture the rev a schematic from the design netlist (#29)
    * feat(tools): add netlist-driven capture and parity check to hwflow
    The rev A circuit is already defined pin by pin in hardware/netlist.yaml.
    Retyping 346 components into a circuit description would add a second
    source that can drift. hwflow.capture draws from the netlist instead: a
    sheet function places symbols and wires, and the part, value, LCSC number
    and the net on every pin come from the netlist and a part table.
    hwflow.parity then compares KiCad's exported netlist and BOM with the
    design netlist and fails the build on any difference.
    To make that usable for the product board this also adds multi-unit
    symbols, KiCad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
    [bom-preliminary.csv, channel.kicad_sch, connectors.kicad_sch, display.kicad_sch, expander.kicad_sch, failsafe.kicad_sch, isense.kicad_sch, mcu.kicad_sch]
2026-11-10 feat(esphome): esphome package for the rev a board (#30)
    * feat(esphome): add the rev a esphome package and components
    The zoneflow component wraps zf_core's output stage, zone driver and
    current checks, built from their one copy in the standalone tree as an
    ESP-IDF component, so both firmwares run the same safety code. A 1 ms
    IRAM timer makes the keep-alive edges from the main loop's heartbeat
    and samples AC_ZC. The zoneflow_schedule component runs programs from
    template entities on the device, with the standalone firmware's
    missed-start rules.
    The package maps every output, sensor, display and control of rev A
    on top of the sprinkler component. Pins come from a substitutions
    file generat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
    [base.yaml, board_io.cpp, board_io.h, display.yaml]
2026-11-11 docs(docs): write the user manual and front door from the design (#32)
    * build(tools): publish drill template and bom table with the site
    The manual links the drilling template and the JLCPCB BOMs and shows the
    preliminary BOM as a table. A hook publishes the generated files from
    their output directories and renders the table from the committed CSV, so
    the site cannot drift from them.
    * ci(ci): check internal links and images of the built site
    mkdocs --strict checks Markdown links only. The new check reads the
    built HTML and fails on a relative href or src that does not resolve,
    or an anchor that does not exist, i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
2026-11-11 feat(fw): resolve firmware, ui and manual contradictions (#34)
    * feat(fw): one fault-text table and a 30 ma idle default in zf_core
    zf/fault_text.hpp is the one table of fault code to user text. The
    display, the web UI and the ESPHome package are tested against it.
    faultCodeFor(HwCheck) moves out of the controller so ESPHome can use it.
    The idle-current default is now kDefaultIdleMaxMa = 30 mA (hardware
    design 19.2), as pull request 28 said; the code still had 60.
    A host test pins what re-provisioning does to watering: the restart
    stops a running zone and its program is not resumed or caught up;
    scheduled starts run on the backup clock while provisioning waits, and
    nothing is scheduled wi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
    [base.yaml, config.hpp, controller.cpp, controller_test.cpp, current_monitor.hpp, display.yaml, display_ports.hpp, fault_text.hpp]
2026-11-11 fix(hw): apply review a2 of the fail-safe circuits (#36)
    * fix(hw): apply review a2 of the fail-safe circuits
    Second independent review of the keep-alive detectors, the logic
    behind them, the relay drive, the regulator over-voltage question and
    the output stage. The report is docs/design/hardware-review-a2.md.
    Circuit changes:
    - KA moves from GPIO38 to GPIO17 and ENC_SW takes GPIO38. Module pin
    31 sits next to GPIO37, the data strobe of the octal PSRAM, and a
    bridge between the two held both detectors on.
    - R33 from 10 kohm to 2.2 kohm, so that a net behind a 10 kohm
    pull-up cannot run the detectors through a bridge.
    - R92 reads V_DRV behind Q3 in place of DRV_EN and is 4.7 kohm. A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
    [asfound-bridges.csv, asfound.csv, bom-preliminary.csv, bridges.csv, channel.kicad_sch, connectors.kicad_sch, corners-grid.csv, corners-mc.csv]
2026-11-11 feat(fw): run the firmware in a browser as a live demo (#35)
    * refactor(fw): share the simulator's control decoding
    The SDL window sampled the encoder and buttons inline. Move that into
    sim::Controls so that the browser build of the simulator feeds the same
    ButtonDecoder, EncoderDecoder and Accelerator path.
    * feat(fw): run the firmware in a browser as a live demo
    Compile the controller core, the display and the REST API to one
    WebAssembly module and put a page around it: the controller with its
    display and knob, a garden on the simulated rev A output stage, and the
    web interface as built for the device, answered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
2026-11-11 feat(fw): follow the self-test of hardware review a2 (#37)
    * feat(fw): run the self-test of hardware review a2
    Section 19 of the hardware design changed with review A2. The shared
    output stage now runs the float test (step 2b), the gate bleed check
    (step 5b), reads V_DRV on GPIO42 and the analogue level of GPIO7 in
    step 1, and judges step 9 against the new absolute limits and a band
    around release times the board learns at commissioning and keeps in
    non-volatile storage. Every stop test follows at least 1 s of
    toggling, step 0 waits 2.5 s, and no limit assumes the one second of
    the specification. The keep-alive guard gains a float request and the
    phase rule of 19.4.
    Steps are strings now (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
2026-11-11 docs(docs): publish the landed-cost estimate per controller (#40)
    * feat(tools): add a landed-cost model with dated price snapshots
    tools/cost prices a finished controller for any quantity and both
    builds: JLCPCB parts with minimum and attrition quantities, the board
    from the online quote, Economic and Standard assembly fees, US freight
    and duty, the cell and the printed enclosure. Sourced facts, each with
    source and date, are kept apart from named, adjustable assumptions.
    CI runs its tests and checks that the cost page matches the data.
    * docs(docs): publish the landed-cost estimate per controller
    New page docs/h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
    [jlcpcb-parts.csv]
2026-11-11 feat(hw): answer the firmware's questions on section 19 and settle M5 (#42)
    * test(hw): simulate commissioning, corner self-test and a shorted ldo
    The firmware asked nine questions on section 19 of the hardware design
    (#38). Four of them need numbers that no deck gave.
    - commission: 264 boards, healthy and with one bleed resistor open, at
    seven temperatures. Gives the learning limits and the band of step 9,
    and shows that a ratio of the two release times does not separate.
    - sequence: the self-test on a healthy board at the 96 corners. Step 2
    with 1.0 s of hold fails two of them, so the sequence now holds 2.0 s.
    - ldo: U3 shorted, with and without the over-voltage detector U13.
    - flo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
    [bom-preliminary.csv, channel.kicad_sch, commission.csv, connectors.kicad_sch, display.kicad_sch, expander.kicad_sch, failsafe.kicad_sch, faults.csv]
2026-11-11 test(fw): system soak simulation, and the seven defects it found (#43)
    * fix(fw): keep consumed starts when a wrong clock is put right
    A clock set back by more than a day clamps the scheduler's keys so that
    a clock that was wrong in the future does not silence the schedule. When
    the earlier time was the right one (the clock was set back by mistake
    and SNTP put it right), the clamp made the scheduler report the day's
    starts as missed and run the newest one again inside the grace period.
    Keep the keys from before such a jump in RAM. If the clock later jumps
    forward to within a day of where it was, restore them; if it passes
    that time at its own pace, drop them. Found by the system soak
    simul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
    [alloc_count.cpp, alloc_count.hpp, controller.cpp, controller.hpp, controller_test.cpp, esphome.cpp, fake_board.hpp, main.cpp]
2026-11-11 feat(hw): lay out, route and export the rev a board (#39)
    * chore(hw): save work in progress on the rev a layout
    Placement of all 349 footprints, the hand-routed copper, the mechanical
    contract check and contract revision 3 with the enclosure rebuilt, and
    the board builder features they need. The autorouter leaves 11
    connections open on this state, so the board is not finished. Saved so
    that nothing is lost before main is merged in.
    * chore(hw): place the fuse and clamp of review a2 in the buck block
    F5 stands on end between the pads of C1 and the input capacitors, D25
    sits at the output pad of L1. The buck moves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
    [board_params.scad, channel.kicad_sch, toolchain_test.kicad_pcb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]
2026-11-11 feat(hw): replace five extended part types by basic or preferred ones (#47)
    * feat(tools): reuse the stored routing when only part values change
    KiCad writes the value text of every placed part into the Specctra
    file, and the routing cache hashed all of it. Changing a capacitor from
    220 pF to 330 pF in the same footprint therefore made the stored
    session "not from these sources" and asked for a two-hour routing run
    that would not give the same copper.
    hwflow.route now keeps a second hash, of the same file without the
    value text of the placements, and reuses the session when either hash
    matches. A part added, moved, turned or given another footprint, a net
    or a rule still changes both. The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
    [bom-preliminary.csv, corners-grid.csv, corners-mc.csv, corners-noedge.csv, expander.kicad_sch, failsafe.kicad_sch, isense.kicad_sch, jlcpcb-parts.csv]
2026-11-11 feat(fw): follow the hardware answers on section 19 and close the soak gaps (#46)
    * feat(fw): follow the hardware answers on section 19
    Step 2 holds 2.0 s, step 2b runs before every run, step 9 uses the
    band of 0.40 to 1.70 and the new learning limits, commissioning only
    at a die temperature of 25 to 50 C and retried every 10 minutes, step
    0 reads VIN_MON, step 1 judges the rest levels (rules 18 and 19), a
    trip with no valve bit low is retried once and then reported as a held
    latch input (U13). New fault codes for each. The simulated board
    models VIN_MON, the rest levels, U13 and the single-edge pulse of Q2.
    The zone fault policy of both firmwares now comes from one shared
    table, and a cur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
2026-11-12 feat(enclosure): printable test-fit kit generated from the board file (#48)
    * feat(enclosure): add a printable test-fit kit made from the board file
    The owner wants to print the enclosure and a stand-in for the board
    and check the fit by hand before a board is ordered. The contract's
    placeholder board was never meant to be printed, and it was not made
    from the layout.
    The kit is generated from zoneflow-a.kicad_pcb: the board at its true
    outline and thickness, a block for each of the 90 parts at least
    1.5 mm tall where the board file puts it, C1 and K1 as pieces that
    fit slots in the underside, plug pieces and a display panel. The
    build stops if the board and contract revision 3 differ by m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
    [testfit.scad, testfit_params.scad, zoneflow-a-board-detailed-view-only.3mf, zoneflow-a-board-detailed-view-only.stl, zoneflow-base.3mf, zoneflow-base.stl, zoneflow-bridge.3mf, zoneflow-bridge.stl]
2026-11-12 feat(docs): add a guided pre-order review of the rev a board (#49)
    * feat(tools): draw pictures of the rev a board for a guided review
    The owner has to check the rev A board by hand before a prototype
    order, and has not opened it in KiCad. tools/reviewwalk holds the
    content of a guided review and draws its pictures from the board file.
    - docs/hardware/review/data/*.toml: 47 steps in five groups, the 30
    findings of the layout review as cards, and a description of every
    picture: a crop in board coordinates, the layers, the nets and parts
    to mark, the labels.
    - render.py turns pads, tracks, vias, zone fills, drawings and text
    into outlines with KiCad's own conversion and writes SVG. I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
2026-11-12 docs(docs): audit the whole repository and correct what was stale (#50)
    * chore(tools): remove leftover .gitkeep files
    firmware/esphome/ and tools/ have long had files of their own.
    * ci(ci): let runs on main finish in three workflows
    firmware, esphome and web-ui cancelled a running job on every new push,
    on main too, so a commit on main could be left with no result: the
    firmware run of d028325 ended that way. They now cancel only on pull
    requests, as the other four workflows do.
    * fix(hw): correct two stale comments in the board sources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
    [layout.py]
2026-11-12 feat(hw): debounce the three push contacts in firmware (#55)
    * feat(tools): reuse a stored routing after parts leave the board
    A part taken off a routed board changes the Specctra file, so the
    route step called the stored session foreign and would have routed
    the whole board again. The copper routed round a removed part is
    still good copper, and it is the copper the layout review read.
    route/<name>.dsn.delta lists what the file of the board as it is has
    less and more than the routed one. The route step takes those lines
    back and reuses the session only if the result has the stored hash,
    so the delta is exact and a reviewer reads in it everything the
    autorouter saw differently. --write-delt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
    [back-without-r72.csv, bom-preliminary.csv, channel.kicad_sch, click-chatter-14ms.csv, click-chatter-3ms.csv, connectors.kicad_sch, display.kicad_sch, double-click.csv]
2026-11-12 docs(docs): study a reduced fail-safe and what the proposal does (#56)
    * docs(docs): study a reduced fail-safe and what the proposal does
    The owner asked for a review of a proposal to tie the expander's reset
    to the processor's reset and rely on the chip's own watchdogs.
    The study finds that the proposal as quoted keeps a valve on through a
    crash, a restart loop and a reflash, because no internal reset of the
    ESP32-S3 pulls EN and a restart in ESP-IDF resets the cores only. It
    compares the watchdog parts JLCPCB stocks, costs four variants with the
    cost model and simulates the recommended one, a one-chip missing-pulse
    detector, in hardware/sim/study-failsafe-reduction.
    Nothing in the speci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
    [bridges.csv, brownout.csv, faults.csv, footprints.csv, new-parts.csv, overvoltage.csv, rates.csv, release-summary.csv]
2026-11-13 docs(docs): review the fail-safe reduction study (#57)
    * test(hw): inject faults into the reduced fail-safe variants
    The study of a reduced fail-safe ran eleven faults of the parts it adds
    and said that a wider injection was still owed. faults_wide.py does it
    on the study's own deck in the manner of review A2, for V2 and for V1:
    components open and shorted, the pins of the one-shot stuck, open and
    bridged, nets shorted to a rail, leaks, and bridges onto the keep-alive
    net. It also runs the over-current comparator on the clear input of the
    one-shot, an option the study does not have.
    review_options.py prices V1 with one thing put back at a time, with
    the study's cost.py and variants.py unch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
    [faults-wide-v1.csv, faults-wide-v2.csv, review-options.csv, trip-via-clear.csv]
