syntroniks/zoneflow/(notices)

Notices in the files:
docs/design/hardware-layout.md:
`ENGINEERING PROTOTYPE`, `Not built, not tested`, `CERN-OHL-P-2.0`, in the
